SteveGuo1726/coralnpu-gesture/gesture_project/docs/artifacts/zcu104_viewer_rotate180_inverted_2026-09-12.png

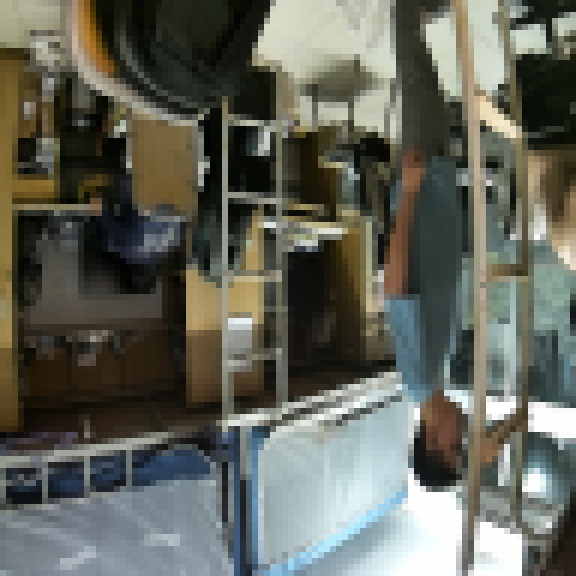
gesture_project/docs/artifacts/zcu104_viewer_rotate180_inverted_2026-09-12.png
