SteveGuo1726/coralnpu-gesture/gesture_project/reports/mobilenet_v2_a050_96_imagenet_frozen_finetune_hagrid6_sample_hotspots.md

# 硬件热点摘要

- 模型：`/home/steveguo/coralnpu-gesture/gesture_project/models/mobilenet_v2_a050_96_imagenet_frozen_finetune_hagrid6_sample/model_int8.tflite`
- 统计层数：`52`
- 总 MAC：`17,605,440`
- 估算 reference cycles：`513,626,762`
- 估算 optimized cycles：`195,936,724`
- 模型级估算加速：`2.62x`

## 按算子类别汇总

| 类别 | 层数 | 总 MAC | MAC 占比 | 优化后周期 | 周期占比 | 估算加速 |
| --- | ---: | ---: | ---: | ---: | ---: | ---: |
| conv2d_1x1 | 34 | 14,552,064 | 82.66% | 191,648,905 | 97.81% | 2.06x |
| depthwise_conv2d | 17 | 2,058,048 | 11.69% | 3,709,522 | 1.89% | 28.89x |
| conv2d_3x3 | 1 | 995,328 | 5.65% | 578,297 | 0.30% | 21.41x |

## 优化后周期热点层

| 排名 | 层 index | 类别 | 形状 | MAC 占比 | 优化后周期占比 | 估算加速 |
| --- | ---: | --- | --- | ---: | ---: | ---: |
| 1 | 67 | conv2d_1x1 | `1x3x3x160 -> 1x1 -> 1x3x3x1280` | 10.47% | 12.39% | 2.06x |
| 2 | 5 | conv2d_1x1 | `1x48x48x8 -> 1x1 -> 1x48x48x48` | 5.03% | 5.95% | 2.06x |
| 3 | 9 | conv2d_1x1 | `1x24x24x16 -> 1x1 -> 1x24x24x96` | 5.03% | 5.95% | 2.06x |
| 4 | 11 | conv2d_1x1 | `1x24x24x96 -> 1x1 -> 1x24x24x16` | 5.03% | 5.95% | 2.06x |
| 5 | 13 | conv2d_1x1 | `1x24x24x16 -> 1x1 -> 1x24x24x96` | 5.03% | 5.95% | 2.06x |
| 6 | 66 | conv2d_1x1 | `1x3x3x480 -> 1x1 -> 1x3x3x160` | 3.93% | 4.65% | 2.06x |
| 7 | 44 | conv2d_1x1 | `1x6x6x48 -> 1x1 -> 1x6x6x288` | 2.83% | 3.35% | 2.06x |
| 8 | 46 | conv2d_1x1 | `1x6x6x288 -> 1x1 -> 1x6x6x48` | 2.83% | 3.35% | 2.06x |
| 9 | 48 | conv2d_1x1 | `1x6x6x48 -> 1x1 -> 1x6x6x288` | 2.83% | 3.35% | 2.06x |
| 10 | 50 | conv2d_1x1 | `1x6x6x288 -> 1x1 -> 1x6x6x48` | 2.83% | 3.35% | 2.06x |
