SteveGuo1726/coralnpu-gesture/gesture_project/reports/static_cnn_regularized_3x3_i96_e70_hagrid6_sample_hotspots.md

# 硬件热点摘要

- 模型：`/home/steveguo/coralnpu-gesture/gesture_project/models/static_cnn_regularized_3x3_i96_e70_hagrid6_sample/model_int8.tflite`
- 统计层数：`7`
- 总 MAC：`89,800,704`
- 估算 reference cycles：`1,130,091,475`
- 估算 optimized cycles：`63,313,052`
- 模型级估算加速：`17.85x`

## 按算子类别汇总

| 类别 | 层数 | 总 MAC | MAC 占比 | 优化后周期 | 周期占比 | 估算加速 |
| --- | ---: | ---: | ---: | ---: | ---: | ---: |
| conv2d_3x3 | 6 | 88,915,968 | 99.01% | 51,661,187 | 81.60% | 21.41x |
| conv2d_1x1 | 1 | 884,736 | 0.99% | 11,651,865 | 18.40% | 2.06x |

## 优化后周期热点层

| 排名 | 层 index | 类别 | 形状 | MAC 占比 | 优化后周期占比 | 估算加速 |
| --- | ---: | --- | --- | ---: | ---: | ---: |
| 1 | 1 | conv2d_3x3 | `1x96x96x16 -> 3x3 -> 1x96x96x16` | 23.65% | 19.49% | 21.41x |
| 2 | 4 | conv2d_3x3 | `1x48x48x32 -> 3x3 -> 1x48x48x32` | 23.65% | 19.49% | 21.41x |
| 3 | 7 | conv2d_3x3 | `1x24x24x64 -> 3x3 -> 1x24x24x64` | 23.65% | 19.49% | 21.41x |
| 4 | 9 | conv2d_1x1 | `1x12x12x64 -> 1x1 -> 1x12x12x96` | 0.99% | 18.40% | 2.06x |
| 5 | 3 | conv2d_3x3 | `1x48x48x16 -> 3x3 -> 1x48x48x32` | 11.82% | 9.74% | 21.41x |
| 6 | 6 | conv2d_3x3 | `1x24x24x32 -> 3x3 -> 1x24x24x64` | 11.82% | 9.74% | 21.41x |
| 7 | 0 | conv2d_3x3 | `1x96x96x3 -> 3x3 -> 1x96x96x16` | 4.43% | 3.65% | 21.41x |
