SteveGuo1726/coralnpu-gesture/gesture_project/docs/会话交接_最高优先级_2026-07-11.md

# 会话交接 最高优先级 2026-07-11

## 编号与阅读规则

本文中所有带日期的一级章节均为历史交接记录，按时间倒序排列：最新记录在最前面且编号最大，最早记录在最下面且编号为 1。当前共有 156 条带日期记录，因此记录编号严格为第 156 号至第 1 号。文档规则、当前结论和执行入口等非时间章节不参与这组编号。阅读时先看最前面的最大编号记录，再按需要向下追溯。

## 156 2026-09-12 全局重规划；阶段 A 用数据推翻两个假设：**模型是被"训练几何"毁掉的**，类目不需要合并

**用户要求**：先不连板子，重新规划全局，重点推进模型与硬件。列出四个致命问题
（手必须占满画面 / 类间区分度低 / 没有无手势与置信度 / CPU 解码拖慢帧率），并给出三条硬约束
（往 3×3 深度卷积试但以上板为准；硬件要针对 ZCU104 重构并冲顶刊、改动必须有数据；
数据集必须重选；**≥3 min 的硬件仿真不允许**）。

**产出**：`docs/全局重规划_2026-09-12.md`（决策文档）+ 阶段 A 的实测数据 + 新评测工具。

### 1. ★ 新工具：`algorithms/static_cnn/eval_int8_deployment.py`

一个工具两种模式，刻意让 PC 侧预处理与板上**同约定**（输入按 `q = u - 128` 构造，
与 `gestureflow_hp0_rgb_loader.sv` 一致；输入张量就是 int8[1,96,96,3]，导出时确认过）：

- `crops` —— 在训练分布（手部裁剪 test 划分）上评，得到可与论文对账的数字；
- `frames` —— **在一帧里取窗口，窗口大小使"手占模型输入 h"**，模拟部署几何。

环境：`~/gfeval/venv`。**坑**：tflite-runtime 2.14 与 numpy 2.x 不兼容（`_ARRAY_API not found`），
必须钉 `numpy<2`。

### 2. ★ A2：训练分布基线 = **99.00%**（test 200/类，n=3600，12 秒跑完）

与模型自称的 98.88% 一致 ⇒ **说明工具链和板上那份是同一个模型**，后面的数字可信。
混淆矩阵很干净：最大的非对角项只有 8/50（palm→four），镜像对
（peace/peace_inverted、stop/stop_inverted、two_up/two_up_inverted）**没有突出**。

### 3. ★★ A3：几何扫描 —— 这是本轮最重要的结果

| 手占模型输入 h | top-1 |
|---|---|
| 1.00（贴紧手） | **93.44%** |
| 0.50 | **46.67%** |
| 0.25 | **6.78%** |
| 0.12 | 7.56% |
| 0.06 | 7.44% |

而从 36,000 个标注统计出：**HaGRID 全帧里"手长边/图像短边"中位数 = 15%**（p5=7%, p95=34%）。
⇒ **HaGRID 真实工作点就是整帧（手占 15%），而我们的模型只见过"手占 100%"的输入。**
在部署几何上它低于瞎猜（5.6%）。

**失败方向是"塌向 call"**：h=0.25 时 `call` 独占 56%、h=0.06 时 68%，
peace/peace_inverted/rock/stop/three/four 全 0%。**用户在相机上看到的"没手势也报 call"，
根因就是几何**，不是缺 no_gesture 类。

**注意一个测量陷阱**：384p 帧只有 384×512、手约 100 px，h≤0.25 时所需窗口已超过整帧，
所以 0.25/0.12/0.06 三档其实测的是同一个"整帧"几何，**不要当成三条独立数据**。
要测更小的 h 必须用 1080p 原帧（未下载）。

### 4. 两个被数据推翻/修订的判断（写下来免得再犯）

1. **P2"合并镜像对类目"——否定。** 训练几何下镜像对不是主要误差来源。
   "分不清"是几何退化的一部分，合并类目救不了。**不改类目。**
2. **"提高输入分辨率让手占更多像素"——上一轮我说错了。** 缩放到固定输入尺寸后，
   手占多少像素只取决于手占画面的比例，与源分辨率无关。分辨率只在"先裁 ROI 再缩放"时才吃红利。
   ★但**输入尺寸本身是独立自由度**：手占 15% 时，96² 输入里手只有 14 px，可能不足以区分
   `three`/`three2`。所以阶段 B 要搜 {96,128,160,192}——这是**由数据倒推出来的**搜索空间。

### 5. 现行模型的算力现状（用于选新骨干）

现行是纯 4×4 稠密栈：`16/16/32/32/48/48/64(1x1) + GAP + FC18`，**约 1.11×10⁸ MAC/帧**
（4×4 核、没有 3×3、没有深度卷积）。MobileNetV3-Small@96² 约 1.1×10⁷（**便宜 10×**）。
⇒ 换骨干是本轮最大的一根杠杆；但 **DW 是带宽受限不是 MAC 受限**，
所以"权重常驻 + 层间融合"（原 H1/H3）从锦上添花变成必须做。

### 6. 已提交的新工具与报告

- 工具：`gesture_project/algorithms/static_cnn/eval_int8_deployment.py`
- 报告：`gesture_project/reports/2026-09-12_A2_crops_test200/`、
  `2026-09-12_A3_geometry_h{1.00,0.50,0.25,0.12,0.06}/`（各含 `confusion.csv`、
  `predictions.csv`、`summary.json`，predictions 里带 `p_max/margin/entropy`，供 A4 扫阈值）

### 7. 下一轮入口

按 `docs/全局重规划_2026-09-12.md` §5 执行：**B2 先跑 96² 的 MobileNet 两个点，
验证"改训练几何能把 6.78% 拉回 90%+"**；同时并行 A4（挖 no_gesture + 拒识基线）
与 C0（周期级代价模型，先于 RTL）。

## 155 2026-09-12 导出 HaGRID-18 参照图（每类一张，供人工对照测试）

**用户要求**：给出 18 类里每类一张数据集图片，用来参照着测板子。

**做法（可复现）**：
- 源 = `datasets/processed/hagrid_v1_500k_384p_targethand_subject_split_20260815/test/<class>/`，
  每类取**文件最大**的一张（先按 `sort | head -1` 取到过 53×55 的缩略图，
  改成 `ls -S | head -1` 后每张都是 134×237 ~ 384×486，做参照才有意义）。
- 原始整帧从 `datasets/raw/hagrid_v1_500k_384p/hagrid-sample-500k-384p.zip` 里按**同一个 UUID**
  取出（裁剪文件保留了原 UUID，所以能一一对应）。
- **用 test 划分**：模型训练时没见过，既能当参照也能当一次诚实的小样本检验。
- 产物放在**仓库外**（`.workbuddy/samples/`，避免把数据集图片提交进公开仓库）：
  `crop/`（裁剪原图）、`input96/`（96×96，**训练同款预处理**）、`display/`（放大到 640 便于屏幕展示）、
  `scene/`（原始整帧）、两张带标签总览图、`labels.txt`、`README.md`。

**两个顺带确认的事实**（以后别再猜）：
1. **模型真正训练的输入是手部裁剪，不是整帧**：`dataset_info.json` 里
   `image_mode = target_hand_crop`、`crop_context = 0.25`。这正是"取景是精度最大杠杆"的根据
   （#153）：真实相机要复现的就是这种"手占满画面"的构图。
2. **类序已在 `models/…_student_4x4_rvv_distill_20260827/labels.txt` 与
   `dataset_info.json` 双重确认**，与板上 `gf_npu_class_name()` 完全一致（1..18 = call …
   two_up_inverted）。
3. `input96/` 逐像素校验过 = `crop → resize((96,96), BILINEAR)`（Pillow 12.3），
   与训练脚本一致；板上的面积平均是它的近似。

**下一步可选（未做）**：给一块"离线分类"入口（读一张 96×96 文件 → 直接出类别），
可以**把模型与相机/光照/构图解耦**地验证一遍 18 类，比对着屏幕拍更干净。

## 154 2026-09-12 监视器颜色错（蓝衣变橙）——根因是 BMP 的通道序，而测试与提取工具犯了同一个错

**用户反馈**：网页上实时显示的画面对不上——**蓝色的衣服被显示成黄色**；
但我从板上单张提取的图像没问题。⇒ 同一份数据、两个消费者、结论相反。

### 1. 复现（先复现再改代码）

把抓回来的那帧**交换 R 与 B** 后重新渲染：**蓝色球衣正好变成橙黄**，木柜变蓝、
皮肤变灰白。与用户描述完全一致 ⇒ 确诊是 **R/B 对调**，不是白平衡、不是 ISP、
不是"颜色偏差"，而是一个确定性的格式错误。这也是为什么之前测的颜色均值看不出问题：
**通道均值在 R↔B 对调下几乎不变**（蓝衣 (50,80,190)→(190,80,50)，均值只挪几个数）。

### 2. 根因

**BMP 24bpp `BI_RGB` 规定像素字节序是 `B,G,R`**（小端 `0x00RRGGBB` 的低字节是蓝），
而管线里是 `R,G,B`。`gf_view.c` 的 `send_bmp_body()` 直接把 RGB 字节写出去了 ⇒
**任何按规范实现的读图器（也就是所有真浏览器）都会把红蓝对调**。

### 3. 为什么整整一轮都没发现（这是本轮最值得记的部分）

三条同时成立，缺一条都不会漏这么久：

1. **传输测试和被测代码用了同一个错误假设。** `t_view.c` 用自己发布的图样逐字节比对
   响应 —— 那是对**传输完整性**的真实断言，但它**无论按哪种约定发出都会通过**，
   因为比较的两端都按同一个约定。**"字节有没有原样到达" ≠ "这些字节按这个格式读有没有意义"。**
2. **我的提取工具犯了与写端同样的错。** 那个用来把帧抓下来肉眼检查的 BMP 读取器
   **把文件当 RGB 读**（`r[i],r[i+1],r[i+2] → R,G,B`），于是每一次"我看过画面了、
   颜色正常"都是**无效证据** —— 它复核的是自己的假设。
3. **唯一会暴露它的消费者一直没被打开过。** 只有真浏览器按规范读；之前那轮明确记着
   "真机浏览器从未打开过"（#152 §7）。用户第一次打开，问题立刻现形。

### 4. 修法

1. `serve_bmp()` 在**自己那份私有拷贝**上原地交换通道（`bgr_swap_in_place()`），
   再交给 `send_bmp_body()` ⇒ 已发布的缓冲和采集路径一行没动。
2. `t_view.c` 新增 **`check_colour_order()`**：发布纯红/绿/蓝/白四色，断言存下来必须是
   `00 00 FF` / `00 FF 00` / `FF 00 00` / `FF FF FF`。**这条断言在坏的版本上必然失败** ——
   它测的是**约定**而不是一致性。
3. `check_bmp()` 改成"期望值按 R,G,B 写、比对时按 B,G,R 读"，两个序在代码里都点名，
   免得后人"顺手简化"回去。

### 5. 验证

- `tests/run.sh`：`t_geom` PASS、`t_view` PASS **0 failures**、`-Wall -Wextra` 无警告；
  新增四色断言全部 OK，原有 BMP 逐像素比对改为 BGR 比对后仍然全对。
- `06_install_app.sh` 全量重编 → `05_verify_image.sh` **RESULT: PASS**；
  `11_net_put.sh` 投放 gf_camera + view.html，两侧 md5 一致；板上重启后重新抓帧核对。

### 6. 可推广的规矩

**凡是把数据交给某种格式，就要显式断言那个格式的约定，不能拿"我们的字节没坏"
顶替"我们的字节按这个格式读是对的"。** 同族的坑：`#12`（数 `b'\r'` 不等于数 CR 字节）、
`#8`（死分支里的探针字符串不是探针）。详见 `plnx/PITFALLS.md #25`。

## 153 2026-09-12 监视器三问：去掉表决、查清"没手势→call"、查清"颜色偏差"；发现数码变焦=居中裁剪（取景才是精度的最大杠杆）

**用户提问（三条，逐条查证）**：① 没手势时为什么识别成 call；② 怎么能用"统计帧数量"
决定当前手势，我只要当前帧的结果；③ 颜色偏差很大，是不是广角视角的问题。

三条里 **②是设计错误（我错）、①是模型能力边界（要解释清楚）、③查证后不是我们的问题
（但查出了取景这个真问题）**。

### 1. ② 多数表决：错在设计，不是因为"不好看"

`gf_camera.c` 原来对最近 5 帧做**多数表决**，页面大字显示的是表决结果（`smooth`），
单帧结果只在小字里。已**整段删除**（含 `-m` 选项、`history[]`、`MAX_VOTE_WINDOW`）：

- **它把要测的东西藏起来了。** 监视器的职责是显示模型行为，不是让它好看。
  "模型 80% 对、在这几种情形下错"经过表决会变成一个小一点的数字，而**错在哪**被抹掉。
- **它让画面和标签对不上。** 表决结果最多滞后手势 4 帧，屏幕上的人和旁边的类别不是同一时刻的。
- **逐帧抖动是测量结果，不是噪声。** 帧间翻转本身就是"这一帧判错了"的直接证据。

现在：`gf_camera` 每帧打印本帧类别；`gf_view` 的 `gf_view_frame` 只剩 `cls`（无
`smooth/votes/window`）；页面大字就是本帧类别，真值对照只有**逐帧准确率**一个口径
（点一个手势当真实值，从下一帧起每帧计一次分）。`t_view.c` 里加了一条**反向断言**：
`/stats` 里再出现 `votes` 或 `smooth` 就算失败 —— 防止它被改回来。

### 2. ① "没手势 → call"：**闭集 + 取景**，不是链路故障

两个独立原因，都不是 bug：

1. **18 类闭集分类器没有"无手势"这一类。** 没有手时它**仍然必须**输出一个 argmax。
   落在 `call` 上是因为该类训练样本最杂（各种"手靠近头/耳"的场景），特征流形最宽，
   最容易被外来输入命中。要压制它只能：加"无手势"类重训 / 前置手部检测 /
   **把输入做成模型见过的样子**（见第 4 条）。
2. **当前取景里根本没有手。** 抓了一帧原图看（`scene.bmp` → PNG），画面内容**是
   三米外的室友坐在书桌前**，整个视野里没有手。实测 10 秒通道均值只漂 ±5/255，
   AWB 没有乱跑。**"没手势"在这个机位上字面上就是"画面里没有手"。**

`gf_npu` 的硬件只暴露 `GF_POST_CLASS_REG` 的 **argmax（5 bit）**，FC 输出张量不落 DDR
（`run_gap_fc()` 里 `GF_STORE_CONTROL = 0`），**所以拿不到任何置信度/softmax**。
⇒ 现在**不可能**做"低置信 → 显示无手势"的软门限；要么改 RTL 把 FC 输出存出来，
要么加检测前置。页面上如实写了这条边界，没有假装有置信度。

### 3. ③ 颜色：**我们的链路是对的，可以证伪**

用户说"颜色偏差很大"，所以先证伪自己的解码链路，再看相机：

- **BMP 通道序正确**：`jpeg_to_rgb()` 用 `JCS_RGB`，`send_bmp_body()` 原样按
  `R,G,B` 写 24bpp `BI_RGB`；我用自己的 BMP 解析器读回来渲染，**肤色/木色/灰衣都正常**，
  不是 `BGR` 交换（交换会让肤色变蓝，肉眼一眼可辨）。
- **96×96 与全景同源**：页面里"模型输入"和"全景"是同一个 `rgb_frame` 的两次采样，
  两张图的通道均值一致（R 104.5 / G 104.2 / B 95.8 vs R 105.1 / G 104.9 / B 96.5）。
- **相机侧逐项实测**（`v4l2-ctl -c` 改一项、抓一帧、比通道均值）：
  | 设置 | R | G | B | R−B |
  |---|---|---|---|---|
  | 默认（AWB 开, saturation 16） | 109.5 | 110.8 | 100.9 | +8.6 |
  | saturation=30 | 108.6 | 110.8 | 92.9 | +15.7 |
  | AWB off, 6500K | 111.2 | 111.6 | 78.4 | +32.8 |
  | AWB off, 3000K | 48.3 | 112.9 | 121.8 | −73.4 |
  ⇒ **默认 AWB 是所有设置里最平衡的**（R−B 只有 +8.6），手动 WB 两个方向都会更糟。
  控件全部等于出厂默认值（brightness 0/contrast 10/saturation 16/gamma 220/sharpness 16）。
  10 秒内通道均值漂移 ≤5/255 ⇒ **不是 AWB 乱跑**。
- **结论**：偏色来自相机 ISP 在室内混合光下的固有表现（广角镜头还有色阴影），
  **不是软件引入的**；而且**只有 8 个可调控件，没有色彩矩阵可动**。
  真要改观只能换光照/换镜头，或在软件里做白平衡——后者属于给模型喂"训练分布外"的颜色，
  需要单独验证，不要顺手加。

### 4. ★ 数码变焦 = 居中裁剪（实测）；**取景是这里精度的最大杠杆**

顺着"是不是广角视角的问题"查下去，查到了真问题：**摄像头是 See3CAM_CU30，1x 时视野
覆盖整个宿舍，手在画面里只有几个百分点**；而 HaGRID（以及这个模型的训练集）里
**手就是主体、占满画面**。缩到 96×96 后，手只有约 15×15 像素 —— 模型没见过这种输入。

该相机暴露 `zoom_absolute`（100..800，即 1x..8x）。**实测它是真正的居中裁剪**：

- 同机位、静止画面（固定配置连续两帧 MAD 只有 1.79，说明画面确实静止），
  把 zoom=400 的帧与 zoom=100 帧的各种"中心裁剪"比对，**最佳匹配恰好是 f=4.0**；
- 再做二维搜索找裁剪原点，**最佳原点 (238,180)，理论中心是 (240,180)** ⇒ 就是居中；
- 残差偏大（MAD≈40）是因为**AE/AWB 会重新测光**：做逐通道 gain+offset 最小二乘拟合后，
  gain=1.31/1.40/1.50、offset≈+27，残差从 ~51 降到 ~20/255（剩下的是 JPEG 重编码与插值）。
  这也顺带说明**变焦后颜色/亮度会变**，这正是"颜色看起来不一样"的另一半原因。

⇒ 所以**不要**用"把 640×480 的中间挖出来再放大"来替代变焦（软件裁剪丢细节，
还要多花 CPU）；相机 ISP 是**先裁传感器再缩放**，同一块区域拿到的 JPEG 比特多得多，
而且测光对象变成手本身。证据图：`zoom_proof.png`（左 1x / 中 4x / 右 = 1x 的中心 1/4，中≈右）。

### 5. 代码：`--zoom` 与 `--crop`

- `--zoom N`（100..800）：`VIDIOC_S_CTRL` 设 `V4L2_CID_ZOOM_ABSOLUTE`，设完**读回**再报；
  相机不支持时**明确警告并继续**（静默不设会让"模型看到的取景"悄悄变掉）。
- `--crop F`（F≥1）：软件居中裁剪，与 `--zoom` 叠加。`crop_window()` 负责算中心窗口并
  **钳位**（窗口不小于 96×96，且不越出帧）；放在**下采样之前**（事后裁 96×96 没有意义）。
- `resize_rgb96()` 签名改为 `(src, sw, dst, rot, crop_x, crop_y, crop_w, crop_h)`
  —— 去掉了不再使用的 `sh`（窗口的行数由 `crop_y+crop_h` 决定），否则 `-Wextra` 报警。
- **场景流改为发布"裁剪后的窗口"**（`gf_view_publish(..., scene_stride)`），
  于是页面上"模型看到的范围"**永远等于**NPU 实际吃的那块区域，不可能与 96×96 漂移。
  行是带 stride 的（窗口是大帧里的一片），`publish_chan()` 按行拷。
- 启动时打印一行说明当前取景；窗口小于 2 倍模型输入时**主动提示会变软**。

### 6. 测试同步（都跑过了，`tests/run.sh` PASS 0 failures）

- `t_geom.c`：调用点全部改到新签名；**新增 crop 覆盖** —— 用"源图编码自身坐标"的 192×192，
  验证 2x 居中窗口读出来正好是 `R=48+ox, G=48+oy`（**裁剪原点取成左上角就会失败**）；
  另加 `crop_window()` 的 1.0/2.0/4.0 中心偏移与两处钳位（32x 与 64×64 源）。
- `t_view.c`：`gf_view_frame` 去掉 vote 字段；场景流改为**真的用 stride 发布**
  （640×480 帧里取 (160,120) 起 320×240 的窗口），BMP 逐像素 76800 个全对；
  `/stats` 断言换成 `cls/cls_name/zoom/crop/hist`，并**反断言** `votes|smooth` 不存在。
- 无警告通过（`-Wall -Wextra`）。

### 7. 现场注意（会误导后来人）

- **用 `v4l2-ctl -c` 改相机控件，在别人 streaming 时也生效，而且会一直留着。**
  本轮为了做对照把 `zoom_absolute` 改到 400，**必须记得改回 100**，否则下一轮会以为
  "取景本来就是这样的"。排查取景问题时先 `v4l2-ctl -d /dev/video0 -l` 看一遍当前值。
- 相机全部控件都还是出厂默认；`zoom_absolute` 当前 = **100**。

### 8. 下一轮

1. **把相机对准自己，把手放在画面中央，用 `--zoom 300`~`400` 跑一轮真值标注**，
   拿到第一份**有真值的逐帧准确率**（这是判断模型好坏的唯一依据）。
2. 拿同一批帧在 PC 侧跑一次前向，**核对 PC 与板子的类别是否一致** ——
   这是"输入无误"的最后一环（目前只证明了 PL 对参考图 bit-exact）。
3. 固化进镜像（已改源码；`06_install_app.sh` → `04_make_sd.sh`）。
4. 大创口径：无手势类 / 手部检测前置、≤5ms 差距、功耗数据。

## 152 2026-09-12 相机朝向修正（倒装 → 已转正）；新增浏览器实时监视器（含"不拖慢识别"的契约与验证）

**用户要求**：确认相机朝向，并做一个"能实时回传画面 + 模型结果 + 状态 + 指标"的
软件或网页，**但不能占用识别处理的时间，以免成绩被拖慢**。

### 1. 相机朝向 → `--rotate D`（运行期参数）；**当前 = 0**

过程值得记：先按用户确认"是反的"实现了 `--rotate 180`，取回画面验证**确实正了**；
随后**用户把相机物理转正了**，于是 180 又把画面转反 —— 改成不加 `--rotate` 后取回画面
确认朝上（天花板灯在上、地面物件在下）。

**结论：加不加取决于当前物理安装，不要照抄历史命令行。** 它是运行期参数，
改它不需要重编、不需要写卡；文档里已改成"当前留空"并写清如何自查
（`--save-ppm` 存一帧回来看）。

模型在正立手势图上训练，倒过来的手对它是**另一个手势**，所以必须**在喂给 NPU 之前**转正
（只转预览没用）。实现在 `resize_rgb96(src, sw, sh, dst, rot)` 的**采样循环内部**：
旋转是 96×96 输出格的一个置换，每个输出格仍然平均同一个源盒，只是写到别处 ——
**精确、且不增加任何额外遍历**。`rot_cell()` 的期望值在测试里是**独立推导**的
（"顺时针转 D 度把输入 (x,y) 送到输出 (h-1-y,x)"），不是复述实现。

### 2. 监视器：`gf_camera --view 8080`

新增 `linux/gf_view.c` / `gf_view.h`（HTTP + BMP + 兴趣门控）与 `linux/view.html`（页面）。
浏览器里能看到：**NPU 实际吃的那张 96×96**、可选的原分辨率全景、当前类别（平滑 + 单帧 + 票数）、
**耗时分解（解码/缩放/NPU）**、18 类累计分布、错误计数、滚动日志，以及
**真值标注 → 实测准确率**（点一个手势当真值，从下一帧开始计分，分"稳定帧"与"全部帧"两个口径）。

### 3. 不拖慢识别的三条硬约束（这是本轮的重点）

1. **没人问就不拷贝。** 每个流记录"最后一次被请求的时刻"；超过 2 秒没人请求，
   `gf_view_publish()` 直接返回 —— **没有浏览器连着时，每帧只做一次 64 位读 + 两次比较。**
2. **socket 全在后台线程。** 采集线程一行网络代码都没有 ⇒ 客户端卡住/链路饱和/笔记本睡眠，
   最坏只是**预览掉帧**，不可能给流水线加一毫秒。
3. **旋转交给浏览器**（全景用 CSS `rotate()`）—— 只有 96×96 必须由板子转。

**主机实测**（`linux/tests/run.sh`，x86）：无人关注 **37 ns/帧**（一帧 27.3 ms 的 0.00014%）、
有人在看预览 **553 ns**（0.0020%）、同时拷全景 **78 µs 但限速 5 次/秒**。
"无人关注 = 37 ns"是**确定性**验证的，不是估的：让窗口过期 → 发布一个不同的图样 →
读回流，必须仍是旧图样（说明那次发布被丢弃）。

### 4. 新增主机侧测试 `linux/tests/`（约 5 秒，不需要板子/PL/权重头）

- **`t_geom.c`**：把真的 `gf_camera.c` 拉进来（`#define main` 改名让位），
  验四种旋转 × **全部 9216 个输出像素**、`rot180` = 纯反转、`rot90+rot270` = 恒等、640×480 几何。
- **`t_view.c`**：HTTP 端到端 —— 路由、首帧前的 503、**两个流 BMP 逐像素精确**（含自下而上行序）、
  `/stats` 字段、以及上面那条兴趣门控。

**测试当场抓出三个真问题**：`Connection: close` 只写在头上而没真的关连接；
`serve_stats` 一个未用变量；以及最值得记的一条 —— **是测试自己错了**：
它用有符号 `char` 解码小端字段，把 640 读成 −128。**字节转储显示服务端完全正确**
（`80 02 00 00`），是读的一方错了。见 `PITFALLS.md #20`。

### 5. 网络：硬件是好的，只缺一根网线

`macb ff0e0000.ethernet` + `PHY [TI DP83867]` 都正常，`eth0` 只报 `NO-CARRIER`。
接路由器就走 `ip link set eth0 up; udhcpc -i eth0`；网线直连笔记本就两端配静态地址
（板 `192.168.77.2/24`，PC `192.168.77.1/24`）。**没有网线时页面用不了**，
此时仍可用 stdout 指标 + `--save-ppm` 按需取图（见 `docs/ZCU104_实时监视器_2026-09-12.md` §6）。

### 6. 工具链改动

- `10_push_app.sh` 改为清单驱动，**新增 `page` 目标**：只推 `view.html`（14 KB，**约 2 秒**）。
  改 UI 不再需要重编 —— 页面在文件系统上（`/usr/share/gf/view.html`），不编进二进制。
- `05_verify_image.sh`：`[4]` 加 3 条 `gf_view.c`/`gf_camera.c` 旋转文案的探针；
  `[2b]` 加 `/usr/share/gf/view.html` 存在性；`[5]` 反向命中率加 `gf_camera:gf_view.c` 一组。
- `gf-npu_1.0.bb`：`SRC_URI` 加 `gf_view.c`/`gf_view.h`/`view.html`，
  `GF_CFLAGS` 加 **`-pthread`**，`do_install` 装页面到 `${datadir}/gf/`，`FILES` 加 `${datadir}/gf`。
- `Makefile`：加 `gf_view.o` 与 `-pthread`。

### 7. 状态与入口

- 源码、recipe、脚本、测试、文档已改完；`06_install_app.sh` 全量重编**进行中**（后台）。
- **待验证**：板上 aarch64 的实际编译/运行、板上三遍对照（有/无 `--view`、有人在看）的增量开销、
  真机浏览器打开一次。前两项的判据见 `docs/ZCU104_实时监视器_2026-09-12.md` §4.3。
- 页面侧已知的良性行为：每个流**第一次**请求返回 503（那次请求就是"登记兴趣"），
  第二次拿到帧；页面的 `onerror` 重试覆盖了这半秒。

---

## 151 2026-09-12 把内存映射问题从"试"变成"证"：内核源码级定论 + 驱动改到与映射无关 + 打通免拔卡迭代

**用户明确要求：不要再"写卡→发现 bug→再写卡"，先把资料查清、代码验对，再谈写卡。
本轮就是照这个做的。核心成果是三条：**

1. **映射属性不再是猜测，是从内核源码推出来的定论**（`arch/arm64/mm/mmu.c`）。
2. **驱动改成对两种映射都成立** —— 于是**当前这张卡（挖洞版 DTB）就能跑通**，
   不需要为了它搬 10 MB 的 `image.ub`、更不需要重写卡。
3. **打通免拔卡迭代通道**：改一行驱动 → 1 分钟上板验证（`09`/`10`）。

### 1. 内核源码级定论（`PITFALLS.md #14b`）

`arch/arm64/mm/mmu.c::phys_mem_access_prot()` 的真实实现（本工程 6.1.30 实测读取）：

```c
if (!pfn_is_map_memory(pfn))        return pgprot_noncached(vma_prot);    /* MT_DEVICE_nGnRnE */
else if (file->f_flags & O_SYNC)    return pgprot_writecombine(vma_prot); /* MT_NORMAL_NC     */
return vma_prot;                                                          /* Normal, CACHED   */
```

`pfn_is_map_memory()` → `memblock_is_map_memory()` → **范围必须在 memory 节点里且不带
`MEMBLOCK_NOMAP`**。于是三种 DTS 写法各有确定后果：

| DTS 写法 | `pfn_is_map_memory` | `/dev/mem` 给出的属性 | 驱动的 memset/memcpy |
|---|---|---|---|
| `no-map`（初版） | false | Device-nGnRnE | **崩** |
| memory 挖洞（#150 的修法） | false | Device-nGnRnE | **崩** |
| **纯 `reserved-memory`，无 no-map（现在）** | true | **MT_NORMAL_NC** | ok（仍需屏障） |

**#150 的"挖洞"只是换了一个坑**：单字 `devmem` 能过，驱动的 128-bit STP / `DC ZVA`
一上去就 fault。这条链条现在有源码依据，不再是推断。

### 2. 两个真实缺陷（都在写卡前修掉）

- **`PITFALLS.md #16`：驱动一个内存屏障都没有。** MT_NORMAL_NC 是**弱序**的，
  CPU 可以把"写缓冲区"重排到"写 `GF_CONTROL` 门铃"之后 —— PL 就会读到半写好的数据，
  **表现为结果错而不是崩**。已在 3 个门铃前 + `wait_layer_done()` 成功路径加 `dsb sy`。
  对照取证：裸机那份唯一一条 `dsb sy` 在 `store_probe()` 里，**不在握手上**；它没出事是
  因为它把缓冲区映射成了 Device（顺序规则更强）。**"裸机能跑"不能推 Linux。**
- **`PITFALLS.md #15`：不让正确性依赖内存属性。** 把 scratch 区域的 `memset`/`memcpy`/
  `memcmp` 换成 32 位 `volatile` 访问的 `gf_zero`/`gf_copy`/`gf_diff`。
  32 位访问在两种映射下都合法（Device 只限制"最大宽度"，字节访问本来就合法）。
  代价每帧几微秒。**收益：驱动不再依赖设备树对不对。**

顺带修了 `gf_camera.c` 两个越界：`-m` 未夹取会踩穿 `history[32]`；MJPEG 解码缓冲区按
"请求尺寸"分配而按"JPEG 实际尺寸"写入（堆溢出）。另外 `v4l2_grab` 原来 DQBUF 后立刻
QBUF，缓冲区会在我们读它的时候被驱动覆写（撕裂帧），已改为处理完再归还。

### 3. 新增的离线防线：`05_verify_image.sh [7]`

rootfs 校验只能证明"二进制是这份源码"，**不能**证明"软件与设备树说的是同一件事"。
新增 `[7]` 段按上面那条判定链逐条核对：memory 覆盖、无 no-map、DT 节点 == `gf_npu.h`
常量、`gf_npu.c` 带 `O_SYNC`、`image.ub` 内嵌 DTB == `system.dtb`。
**这五条里任意一条不过，都不用上板 —— 板上表现为没有内核日志的 SIGBUS。**

同时修掉 `06_install_app.sh` 结尾的 cwd 缺陷（`cd $PLNX` 之后 `dirname $0` 变成 `.`，
校验脚本报 "No such file or directory"）。

### 4. 免拔卡迭代通道（`PITFALLS.md #17`）

板子在跑 Linux、rootfs 可写、`python3` 有 `base64/zlib/hashlib/struct`。所以：

- **`09_board_put.sh`**：base64 走串口 → 板上 `python3` 解码 → **两侧 md5 + 长度双向核对**，
  失败重试 3 次。实测 200 KB 随机数据**逐字节一致**，速率 **11.3 KiB/s**（正好 115200 线速，
  说明无损；tty 发送缓冲天然充当流控，不需要 sleep 调速）。
- **`10_push_app.sh`**：debugfs 从 `rootfs.ext4` 取出二进制 → 先跑 `05` 确认"镜像==源码"
  → 串口送进 `/tmp` → 板上 `install` 到 `/usr/bin` → 双向核对 md5。

**526 KB ≈ 1 分钟。** 需要写卡的只剩 rootfs 之外的东西（设备树/内核/`boot.scr`/`BOOT.BIN`），
以及最终固化一版交差用的完整镜像。

### 5. 本轮踩到并记录的新坑

- **`grep -q` + `pipefail`**：`grep -q` 命中即退出，写管道的一端可能吃 `SIGPIPE`，
  于是**传输明明成功也被判成失败**；而那次失败还把回显丢进了 `/dev/null`，完全无法诊断。
  结论：捕获到变量再匹配，别用 `| grep -q` 判成功。
- **串口传输前必须 `stty -echo`**，否则板子回显每个字节，既慢又可能把两侧缓冲堵死。

### 6. 当前状态与入口

- 源码已改：`gf_npu.c`（屏障 + mapping-agnostic + `GF_DBG`）、`gf_npu.h`（把说错机制的
  注释换成内核源码依据）、`gf_camera.c`（三处越界/撕裂）、`05`/`06`/新增 `09`/`10`。
- `petalinux-build` 全量重建，`RESULT: PASS` 且新增的 `[7]` 段 **5/5 OK**。

### 7. ★ 实测结果：**NPU 在板上跑通了**（`gf_npu_probe` → `RESULT: PASS`）

用 `10_push_app.sh` 把两个二进制送进正在运行的板子（**没碰 SD 卡**，两侧 md5 双向核对
一致），然后在**当前这张卡**上跑：

```
gf_npu: PL id ok (MAGIC 0x47464E50, VERSION 0x00050001); scratch 0x70000000 + 16 MiB
gf_npu: staged weights + activations, 599040 bytes used of 16 MiB
class = 1 (dislike), expected 1
  --- golden content checks (bit-exact memcmp) ---
    conv0 MATCH / pool1 MATCH / conv2 MATCH / pool2 MATCH / conv4 MATCH / pool3 MATCH
    6/6 matched
  --- hardware FNV registers ---
    hw FNV conv0 87061606 (= 0x05307466 ✅)   hw FNV pool1 2116512891 (= 0x7E276C7B ✅)
    gap FNV 4043941806 (= 0xF109A7AE ✅)      fc FNV 585444829 (= 0x22E52DDD ✅)
  PL compute  17.03 ms        CPU overhead  1.99 ms   (裸机 10.04 ms)
RESULT: PASS
```

**注意这是在"挖洞版 DTB / Device-nGnRnE 映射"下跑通的** —— 直接证明"让驱动与映射解耦"
（§16）是对的：`gf_zero(16777216)` 的 32 位访问全程没崩，`[8]→[9]` 标记完整。

**顺带解释了历史悬案**：CPU 开销从裸机的 10.04 ms 降到 1.99 ms，因为 `run_frame` 里
每帧不再清零中间张量（原先的 memset 才是那 8 ms 的来源）。

### 8. ⚠️ 摄像头一开就暴露的老 bug：golden 检查被无条件套用在任意输入上

`gf_camera -s 640x480` 正常协商到 **MJPEG 640x480 / 4 buffers / streaming**，但第一帧就报：

```
gf_npu: FAIL stage 0x4103 observed 0x9AD0E9B4
```

`0x9AD0E9B4` 是散列样貌 —— 是 **FNV 值**，不是状态位域。审计整条 `run_frame` 后找到
**三处同类问题**（一次性审完，不是一个个试）：

| 位置 | 检查 | 为什么在摄像头帧上必然假失败 |
|---|---|---|
| `0x4103` | `hash != GF_FULL_OUTPUT_FNV1A` | 它是**参考图**产生的 FNV，不是网络的属性 |
| `0x4105` | `hash != GF_BODY2_OUTPUT_FNV1A` | 同上 |
| `0x4133` | `gap_fnv`/`fc_fnv`/`post_class` 对比 `GF_POST_*_EXPECTED_*` | 同属输入相关量 |

**修法**：这三类**输入相关**的 golden 比较全部改为只在 `stats != NULL`（= 参考图验证路径）
时执行 —— 与既有约定一致（`verify_tensor` 本来就是这么做的）。**输入无关**的检查保留为
无条件：fault 位、DMA/store 字节数，外加**一条新的、对任意输入都成立的检查**：
类别必须落在 `0..GF_POST_FC_OUTPUTS-1`。这样实时路径依然在自我验证，而不是"什么都不查"。

同时修 `gf_npu_selftest(NULL)`：它按定义跑的就是参考图，所以现在**总是自带一个 stats**，
否则 `gf_camera --selftest` 会静默跳过整条 FNV 链。契约已写进 `gf_npu.h`。

**为什么直到今天才暴露**：裸机从来没有摄像头。这正是"没在真实路径上跑过 = 没跑通"
的又一例 —— 而且这次是**功能性 bug**（假失败），不是崩溃，光看代码不容易起疑。

### 9. ★ 摄像头闭环也已跑通（150 帧无失败，类别随场景变化）

修掉 §8 的 golden 检查后重跑，`gf_camera -s 640x480 -n 150 --save-ppm`：

```
gf_camera: using MJPEG 640x480 (bytesperline 0, sizeimage 614400)
gf_camera: streaming, 4 buffers
frame   0  call       frame  20  mute      frame  60  dislike     frame 149  dislike
单帧 raw 分布: {call:50, mute:9, three:3, peace:3, dislike:80, like:5}
每帧 26.7–29.8 ms（均值 29.3）=> 34.1 fps 上限
```

**类别确实随场景在变** —— 模型在响应输入，不是恒输出一个常数。

**libjpeg 修复当场生效**（`PITFALLS #19`）——同一次运行里出现了坏帧，但程序**跳过并继续**：

```
Premature end of JPEG file
gf_camera: JPEG decode error: Not a JPEG file: starts with 0x3d 0x3d
gf_camera: JPEG decode failed, skipping frame
... 继续跑完 150 帧
```

**取回了喂给模型的那一帧**（`--save-ppm` 现在存自动曝光稳定后的最后一帧，见 `PITFALLS #19`）：

```
亮度 min=1 max=254 mean=96.8   非零像素 96.9%   R=100.8 G=98.1 B=83.7
gz 20703 → raw 27661 字节，两侧 md5 MATCH
```

曝光正常、动态范围用满、不是黑屏也不是垃圾。图已存为
`gesture_project/docs/artifacts/zcu104_camera_96x96_settled_2026-09-12.png`
（6 倍放大便于肉眼查看）+ 原始 `.ppm`。

**⇒ 待用户确认的一件事**：那张 96×96 里能看到人、手臂、背景和上方光源，
但**画面方向看起来是倒的**（人脸像是上下颠倒）。模型是在**正向**手势图上训练的，
若相机是倒装的，等价于把输入上下翻转 ⇒ 类别会乱。**请确认相机朝向**；
若确实倒装，物理转正，或给 `gf_camera` 加一个 `--rotate 180`（几行代码 + 一轮免拔卡投放）。

### 10. 本轮最终状态

- 代码：`gf_npu.c`（屏障 + mapping-agnostic + golden 检查 gating）、`gf_camera.c`
  （越界/撕裂 + libjpeg setjmp + save-ppm 取稳定帧）、`gf_npu.h`（机制注释 + 契约）、
  `05`（`[7]` DT 一致性）、`06`（cwd 修复）、新增 `09_board_put.sh` / `10_push_app.sh`。
- **板上已验证**：`gf_npu_probe` → `RESULT: PASS`（6/6 bit-exact + 4 个 FNV 全对）；
  `gf_camera` 150 帧闭环无失败、类别随场景变化。
- **SD 卡一次都没动**（这一版二进制只在板上，镜像里仍是旧版 —— 要固化需跑
  `06` + `04`）。
- 待办：
  1. 确认相机朝向，必要时加 `--rotate`；
  2. 做**有意识的手势**（如张开手掌/握拳/比耶）测真实准确率；
  3. 把这一版**固化进镜像**（写卡）；
  4. 闭环数据补进大创验收材料。

---

## 150 2026-09-12 🎯 首次 Linux 上板：板子起来了，但 `no-map` 内存 bug 拦在最后一道门

**这是核心叙事「ZCU104 实时摄像头手势识别」第一次真正在 Linux 下上板。结果：大半程通过，卡在 NPU scratch 缓冲区的 `no-map` 设备树 bug 上。**

### 1. 打通了什么（都是首次、真实硬件）

| 环节 | 结果 |
|---|---|
| SD 卡启动 Linux | ✅ `Linux gflinux 6.1.30-xilinx-v2023.2 aarch64`，登录 `root` 无密码 |
| 串口控制台 | ✅ FT4232H 经 usbipd 透传，**控制台在 `/dev/ttyUSB1`**（不是 ttyUSB0），`08_console.sh` 可用 |
| USB3 摄像头 | ✅ `ID 2560:c130 e-con Systems See3CAM_CU30`，`/dev/video0`/`video1` 已枚举 |
| NPU 二进制 | ✅ `gf_npu_probe`/`gf_camera`/`v4l2-ctl` 在位，大小与 `05` 校验一致 |
| **NPU PL** | ✅ `busybox devmem 0xa0000000` = `0x47464E50` **"GFNP"** —— PL 已配置、NPU 在响应 |
| **NPU scratch** | ❌ `devmem 0x70000000` **挂死 CPU**（rcu stall）；`gf_npu_probe` SIGBUS |

### 2. 根因（已定位，`PITFALLS.md #14`）

`system-user.dtsi` 用 **`no-map` reserved-memory** 预留 0x70000000。注释声称
"no-map == memblock_remove ⇒ 不再是 RAM"，**这是误解**。实际 `no-map` 调
`memblock_mark_nomap()`：这段**仍是 RAM**（`pfn_valid` 为真），只是从**线性映射**里摘掉。
于是 `/dev/mem` 按可缓存 RAM 映射它，却没有线性映射兜底 → 一访问就挂死/SIGBUS。

裸机（JTAG）没踩到是因为扁平映射没有 no-map 这回事。**Linux 这条路径此前从未真跑过。**

### 3. 修复（已写入并开始重建）

把 `no-map` 换成 **memory 节点挖洞**（0x70000000 不再属于系统 RAM ⇒ `/dev/mem`
按 `pgprot_noncached` 非缓存映射 —— 正好符合 HP0 非相干"两侧都不用 flush"的原意）：

```dts
memory@0 {
    device_type = "memory";
    reg = <0x0 0x00000000 0x0 0x70000000>,
          <0x0 0x71000000 0x0 0x0EF00000>;
};
```

状态：`plnx/system-user.dtsi` 已改、已部署到工程、`petalinux-build` 后台重建中（task 7ySlml）。

### 4. 深一层的教训

- 之前所有"Linux 侧已就绪"的结论，都建立在**裸机 JTAG 结果**（36.96 FPS）上，不是 SD 启动的 Linux 路径。第一次真跑 `gf_npu_probe` 就崩。
- 文档里 `no-map` 的注释**主动断言了错误机制**，不实跑发现不了。
- **"没在真实目标、真实启动方式下跑过" = "没跑通"。** 一切以实板为准。

### 5. 下一步（重建完成后）

1. `petalinux-build` 完成 → 验证新 `system.dtb` 有挖洞（两段 memory、无 no-map）
2. 重新打包 + 写卡（板子当前因 devmem 挂死，需**断电重启**；SD 卡要插回读卡器）
3. 重跑 `sudo gf_npu_probe`（应 `RESULT: PASS`）→ `sudo gf_camera -s 640x480`

---

## 149 2026-09-12 SD 卡接入打通（usbipd）；修掉 `sudo` 重置 `$HOME` 导致的四脚本缺陷

**状态：写卡条件已全部就绪，只等用户执行一条 `sudo` 命令。卡已在 WSL 里可见为 `/dev/sde`。**

### 1. SD 通路：结论与事实

`wsl --mount` **走不通**（微软文档明写不支持 USB/闪存盘/读卡器；报
`Wsl/Service/AttachDisk/MountDisk/0x8007000f` = Win32 `ERROR_INVALID_DRIVE`，
脱机后错误变为 `.../HCS/0x8007000f`，仍失败）。改走 **usbipd USB 透传**，成功。

| 项 | 值 |
|---|---|
| 卡 | **Disk 2**，`Generic MassStorageClass`，**28.9 GB**，USB，**可移动** |
| 官方套装 16 GB 卡 | 卷标 `PYNQ`，FAT32 引导分区约 120 MB（其余是 Windows 读不了的 ext4，**卡没坏**）—— 保留不动 |
| 本次使用 | 另一张 **32 GB U1**（U1 ≥10 MB/s，写 431 MB ≈ 45 s，够用且富余） |
| WSL 内核 | 6.18.33.2，`vhci-hcd.ko`/`usbip-core.ko`/`usb-storage.ko`/`uas.ko` **全部存在** |
| 透传后在 WSL | `sde 28.9G disk` + `sde1 28.8G part vfat`（现存的 FAT32 分区，**未挂载**） |
| 卡上分区表指纹（写前基线） | `PARTUUID f52e5d69-01` |

**透传步骤**（已在用户机器上实测成功）：
`sudo modprobe vhci-hcd` → `sudo modprobe usb-storage` → `lsblk` 出现 `sde`。

### 2. ⚠️ 本轮修掉的真实缺陷：`sudo` 把 `$HOME` 重置为 `/root`

**症状**：`sudo bash 04_make_sd.sh /dev/sde` → `ERROR: missing /root/gf_linux_ws/.../BOOT.BIN`。
镜像一直都在 `~/gf_linux_ws/...`，脚本却去 `/root` 找。

**根因**：这些脚本需要 root（parted/mkfs/dd/mount），但工程树在**调用者**家目录下，
而 `04_make_sd.sh` 第 30 行是 `PROJ="${PROJ:-$HOME/gf_linux_ws/gf_linux}"`。

**同一根因有四个实例**，且最危险的不是 `04`：

| 脚本 | 受影响路径 | 失败时表现为 |
|---|---|---|
| `04_make_sd.sh` | `$HOME/gf_linux_ws/gf_linux` | `missing /root/.../BOOT.BIN` |
| `05_verify_image.sh` | `$HOME/coralnpu-gesture`、`$HOME/gf_linux_ws/...` | **`RESULT: FAIL`** —— 会伪装成"镜像过期" |
| `06_install_app.sh` | `$HOME/coralnpu-gesture`、`$HOME/petalinux/2023.2` | `找不到源码目录` |
| `07_make_sd_image.sh` | `$HOME/gf_linux_ws/gf_linux` | `缺少 /root/.../BOOT.BIN` |

**为什么 `05` 最危险**：`04` 的 **GATE 0 会调用它**。在 sudo 下门禁自身失效，
而且报的是**内容**失败 —— 读起来像"你的镜像旧了"，而不是"我找错目录了"。
**这类误报会把人引向完全错误的方向（重编镜像）。**

**次生危害（同一根因，更隐蔽）**：`05` 的临时目录原是 `$HOME/gf_linux_ws/_imgverify`。
被 `04` 以 root 调用时，root 会在用户家目录里建该目录并拥有解出来的 ELF；
之后**非 sudo** 运行就写不进去 → `debugfs dump` 失败 → **所有探针报 FAIL**，
一个彻底虚假的失败，成因只是文件属主。

**修复（同一次提交）**：
1. 四个脚本都在前导段之后解析调用者的家目录，并 `export HOME`
   （顺序：`$GF_HOME` 显式覆盖 → `SUDO_USER` 的家目录 → `$HOME`）。
2. `05` 的临时目录改为 `TMP="$(mktemp -d)"` + `trap 'rm -rf "$TMP"' EXIT` ——
   无论谁跑都不留残留。
3. `04` 定位姊妹脚本从 `dirname "$0"` 改为
   `HERE="$(cd "$(dirname "$0")" && pwd)"`（`$0` 无目录成分时会失效；`07` 本来就是这么写的）。
4. `04`/`07` 的"镜像缺失"报错补上可执行提示（含 `GF_HOME=` / `PROJ=` 用法）。
5. 清理了历史遗留的 `~/gf_linux_ws/_imgverify`。

全套记录在 **`plnx/PITFALLS.md` #11**。

### 3. 这次是怎么验证的（方法本身值得复用）

**不需要提权就能复现 sudo 环境**：

```bash
env HOME=/root SUDO_USER=steveguo bash 04_make_sd.sh <device>
```

伪造 `HOME` + `SUDO_USER` 就足以走完整条解析路径。本轮实测结果：
- 解析块 → `HOME -> /home/steveguo`（不是 `/root`）✅
- `05` 在该环境下跑 → **`RESULT: PASS`**，指纹不变 ✅
- **反证**：把解析块删掉 → 精确重现 `ERROR: missing /root/gf_linux_ws/.../BOOT.BIN` ✅
  （不做反证就等于没证明修复起了作用）
- `04` 全流程（root 检查打桩、喂 `ABORT`）→ 走到擦盘警告后正确中止，退出码 2，
  **前后分区表指纹 `f52e5d69-01` 完全一致 ⇒ 卡未被触碰** ✅

**四个脚本**：CRLF=0、loneCR=0、`bash -n` 全过。
**写卡所需工具全部在位**：`parted` / `partprobe` / `wipefs` / `mkfs.vfat` / `mkfs.ext4` /
`e2fsck` / `resize2fs` / `dd` / `mount` / `blkid` / `losetup` / `truncate`（以及 `05` 用的
`debugfs` / `file` / `strings` / `readelf`）。
**卡未被挂载**（`/proc/mounts` 里那次 `sde` 命中是 `nsdelegate`，误报）。

### 4. 两个假警报（记下来免得下次又当成故障）

- **`CR bytes = 1`**：不是真的裸 CR。f-string 里的 `b'\\r'` 是**反斜杠+r 两个可打印字符**，
  数到的是 `06` 里那个**故意写的** `$'\r'` 门禁文本。真实检查用
  `d.count(b'\r\n')` 与 `d.count(b'\r')-d.count(b'\r\n')`。详见 `PITFALLS.md` #12。
- **`grep sde /proc/mounts` 命中 1 次**：匹配到 `nsdelegate`，与卡无关。

### 5. ✅ 写卡成功（2026-09-12 13:01）

```bash
sudo bash ~/coralnpu-gesture/gesture_project/innovation_npu/board_zcu104/plnx/04_make_sd.sh /dev/sde
```

| 项 | 结果 |
|---|---|
| GATE 0 | `pre-flight OK: the image matches the current sources` |
| manifest | `gf-npu` / `libjpeg62` / `usbutils` / `v4l-utils` 全在 |
| p1 FAT32 1 GiB | `BOOT.BIN` 21.07 M、`image.ub` 9.97 M、`boot.scr`、`system.bit` 19.31 M、`system.dtb` |
| p2 ext4 27.8 GiB | `dd` 431 MB @ **17.9 MB/s**（24.1 s）→ `resize2fs` 至 29 200 384 个 1K 块 |
| **md5 对账** | `gf_npu_probe` **2ed2ef05ab52e145**…、`gf_camera` **bb04ced68ea693e9**… **与 `05` 的 `[6]` 段一致** ✅ |

**卡上跑的就是校验过的二进制。可以上板。**

### 6. 写卡输出里的两条疑点，均已查实（一条是我代码的误报）

**(a) `MISS /usr/bin/lsusb` —— 误报，卡没问题。**
`lsusb` 是 **绝对符号链接**：`/usr/bin/lsusb -> /usr/bin/lsusb.usbutils`
（Yocto `update-alternatives` 的标准布局；真身 301 312 B，inode 1608）。
`04_make_sd.sh` 用 `[ -e "$ROOTMNT/usr/bin/lsusb" ]` 判断，而 `test -e` 会**跟随**这个链接、
并按**宿主机**的 `/` 去解析目标 ⇒ 永远 MISS。
已修成"在挂载树内部解析目标"（区分绝对/相对；且**悬空链接必须判 MISS**，
所以不能简单换成 `[ -L ]`）。四种情形都做了单测。
`05_verify_image.sh` 不受影响（它查 `debugfs` inode，不跟随链接）。
**已顺带补上 `05` 的 `[2b]` 段**：写卡前就确认上板操作卡里的每个命令
（`gf_npu_probe`/`gf_camera`/`v4l2-ctl`/`lsusb`/`usb-devices` + `/lib/modules`）确实存在。
记入 `PITFALLS.md #13`。

**(b) `system.bit` 单独放在 p1 —— PL 其实由 `BOOT.BIN` 里的 bitstream 配置。**
打包命令是 `petalinux-package --boot --fsbl ... --fpga images/linux/system.bit --u-boot ...`，
**bitstream 已烘进 `BOOT.BIN`**，由 FSBL 上电配置 PL。
**`boot.scr` 里没有 `fpga load`** —— 它只 `fatload image.ub` 然后 `bootm`。
证据：`BOOT.BIN` 21 073 168 = `system.bit` 19 311 211 + 1 761 957（FSBL/PMUFW/ATF/U-Boot）；
抽 6 段 `system.bit` 的 64 字节窗口，有 3 段**原样**出现在 `BOOT.BIN` 中。
⇒ **若哪天把 `--fpga` 从打包命令里去掉，板子仍会正常启动 Linux，但 PL 从未被配置**，
NPU 寄存器全死、`gf_npu_probe` 失败且原因不明显。已记入 `PITFALLS.md #7`。

### 7. 上板（下一步，用户执行）

```powershell
usbipd detach --busid <BUSID>      # 先把卡还给 Windows，再拔卡插到板子 J100
```
1. 卡插 **J100**，**SW6 [4:1] = OFF, OFF, OFF, ON**（SD1；⚠️ **ON=0**）
2. 串口 FT4232H **ch0 @ 115200 8N1**
3. 上电，按计划 P3–P5：

```bash
lsusb                        # 摄像头枚举了吗
v4l2-ctl --list-devices
sudo gf_npu_probe            # ★ 必须 RESULT: PASS —— 这是整条链路的门禁
sudo gf_camera -s 640x480
```

**在 `gf_npu_probe` PASS 之前，`gf_camera` 报的任何类别都不算数。**
**放弃线：P5 两小时内不 PASS 就停**，不要在 NPU 未验证时去调摄像头。

---

## 148 2026-09-12 ZCU104 上板推进计划（含离线预检）；`.workbuddy/` 移出仓库

**阅读顺序：本节是"可以动手写卡了"的入口。执行照 `docs/ZCU104_上板推进计划_2026-09-12.md`（以那份为准），本文只记结论与两条纠正。**

### 1. 本轮完成的事

**(a) `.workbuddy/` 移出仓库。** 用户指出这是**本机**的工作区状态（agent 记忆/续接缓存），
不该两端互相同步。已：`.gitignore` 加 `.workbuddy/` → `git rm -r --cached` → 提交推送。
**磁盘文件两端都保留了**（提交前先备份到仓库外，合并后再恢复，并逐个 md5 校验）。
**项目正式日志就是本文档**（编号章节，倒序，每轮在顶部追加）。

**(b) 完成一次**离线**上板预检，把能提前查的全查完。**

**(c) 产出 `docs/ZCU104_上板推进计划_2026-09-12.md`** —— 分步、带判据、带失败分支、
带时间盒与放弃线。它取代速查卡成为执行依据。

### 2. 预检结果（**全部为本次实测**）

| 检查 | 结果 |
|---|---|
| 镜像产物 | `BOOT.BIN` 21.1 M(01:18) / `image.ub` 9.97 M(00:46) / `rootfs.ext4` 431 M(01:18) / **`boot.scr` 存在**(3474 B) |
| 内容校验 | `05_verify_image.sh` = **`RESULT: PASS`**；指纹 `gf_npu_probe md5=2ed2ef05ab52e145`、`gf_camera md5=bb04ced68ea693e9` |
| **设备树（新增检查）** | 用 `dumpimage` 从 **`image.ub`(FIT)** 里提取内嵌 DTB，与 `system.dtb` **md5 完全一致**：`3a15a61b5e8a4e15fd9e38f4ce039ccb` |
| `npu-buffers@70000000` | 存在，16 MB，**`no-map`** ✅ |
| `bootargs` | 含 **`clk_ignore_unused`** ✅，`root=/dev/mmcblk0p2` |
| NPU 控制口 | `gestureflow_layer_chain_dmp_hp0_axil@a0000000`（1 MB，clk `0x47`）✅ |
| USB | `usb@ff9d0000`→`usb@fe200000`，**`dr_mode="host"`、`maximum-speed="super-speed"`** ✅ |
| 板级 | `compatible = xlnx,zynqmp-zcu104-revC` ✅（`MACHINE_NAME` 生效） |

**为什么要查 `image.ub` 内嵌 DTB**：`system.dtb` 在 `BOOT.BIN` 里，但内核实际是**用 `image.ub`
里那份 DTB 启动的**。两者不一致时板子会带着没被检查过的 DTB 启动，而这个问题在串口上极难看出来。

### 3. 两条必须纠正的记录

**(a) ⚠️ 板上命令缺 `sudo`。** `gf_npu_probe` / `gf_camera` 都要 `open("/dev/mem", O_RDWR)`
（`gf_npu.c`），不带 `sudo` 直接报 `open /dev/mem failed ... (needs root)`。
速查卡与计划里已全部补上。

**(b) ⚠️ `BUILD_RC=0` ≠ 镜像被重新生成。** 我此前记的"10:15 重编、镜像 ~10:17 重新生成"
**是错的**。实测：`06_install_app.sh` 确实 10:15:55 跑、10:17:39 结束、`BUILD_RC=0`，
但构建摘要是 **`Attempted 4854 tasks of which 4835 didn't need to be rerun`**，
且 `BOOT.BIN`/`rootfs.ext4` 时间戳**仍是 01:18**。
**这不是故障**：源码自 01:15 未变，重编产物逐字节相同 ⇒ 下游镜像任务被 bitbake 正确跳过。
⇒ **判据永远是 `05_verify_image.sh` 的 `RESULT: PASS`，不是构建返回码。**（对应 `IDENTITY.md` D6）

### 4. 程序接口（从源码确认）

```
gf_npu_probe [--bench N] [--ppm out.ppm]
gf_camera    [--list] [-s WxH] [-n N] [--save-ppm P]      ← 都要 sudo
```

### 5. 下一步（唯一路径）

```
P1  你：lsblk 找卡 → sudo 04_make_sd.sh /dev/sdX     （脚本内置 GATE 0，不 PASS 拒绝写卡）
P2  你：插 J100、SW6[4:1]=OFF,OFF,OFF,ON（ON=0!）、串口 FT4232H ch0 @115200 8N1、上电
P3  你：uname -a / lsusb / ls /dev/video* / dmesg|grep -i usb      → V1
P4  你：v4l2-ctl --list-formats-ext                                → V2
P5  你：sudo gf_npu_probe        ★ 必须 RESULT: PASS ← 整条链路的门禁   → V3
P6  你：sudo gf_npu_probe --bench 200   → PL 与 CPU 侧开销，对比裸机 17.02/10.04 ms → V4
P7  你：sudo gf_camera -s 640x480 [-n 100] [--save-ppm ...]        → V5（第一次真正闭环）
P8  我：归档 + 定下一轮优先级
```

**放弃线**：**P5 两小时内不 PASS 就停**。不要在 P5 未通过时去调摄像头 ——
那样得到的类别数字无意义，且会把一个问题变成两个纠缠的问题。

**恢复手段**：板子不会坏。SW6 拨回 QSPI32（`ON,ON,OFF,ON`）能起出厂镜像，
可用于区分"板子问题"与"卡/镜像问题"。

### 6. 上板之后的优先级（已重排）

1. **DMP A/B 对照**（同 DSP 预算下 DMP vs 朴素 INT8）——项目自己的创新性门禁要求，
   现在只有单元对账，**不足以支撑论文主张**
2. **功耗数据**（申请书要求 ≤100 mW，当前**零数据**）
3. 去 CPU 侧开销（若 P6 确认仍在 10 ms 量级）
4. PL 提频 ~137 MHz（`WNS +2.751 ns @100 MHz` 有余量）
5. 官方 CoralNPU 模拟器上的同模型 baseline（申请书 §5.3.3 要求对比原生；硬件对照不可行）

### 7. ⚠️ 计划初稿的一处真实漏洞：WSL 看不到 SD 卡（已修正）

初版 P1 直接让用户 `lsblk` 找卡 —— **这是错的**。
**实测：WSL2 默认不透传 USB/块设备。** WSL 内 `lsblk` 只有虚拟盘：
`sda 356.9M` / `sdb 159.4M` / `sdc 3G (swap)` / `sdd 1T (/mnt/wslg/distro)`，**没有 SD 卡**。

**⚠️⚠️ 后续实测推翻了"可以用 `wsl --mount`"这个判断 —— 它对读卡器根本不可用。**

**微软官方文档原文**（`learn.microsoft.com/windows/wsl/wsl2-mount-disk`）：
> *The `wsl --mount` command does **not** currently support USB/flash drives/SD card readers.*

**实测吻合**：管理员权限下执行 `wsl --mount \\.\PHYSICALDRIVE2 --bare` **两次都失败**：
```
Wsl/Service/AttachDisk/MountDisk/0x8007000f            ← 第一次
Wsl/Service/AttachDisk/MountDisk/HCS/0x8007000f        ← 脱机后重试
```
`0x8007000f` = Win32 **ERROR_INVALID_DRIVE**（"系统找不到指定的驱动器"）。
社区报告一致：**配读卡器是长期未修的已知问题**，不是操作错。
（还确认了另一件事：`wsl --mount` **必须管理员** —— 非提权会报
`WSL_E_ELEVATION_NEEDED_TO_MOUNT_DISK`。）

**⇒ 正确路径改为 USB 透传（usbipd）**，这也是微软文档在 `--mount` 不适用时指向的方案。
**本机条件已核实具备**：`winget` 可用；WSL 内核 6.18.33.2 里
**`vhci-hcd.ko` / `usbip-core.ko` / `usb-storage.ko` / `uas.ko` 全部存在**
（`.../kernel/drivers/usb/{usbip,storage}/`）。
流程：`winget install -e --id dorssel.usbipd-win` → `usbipd list` 取 BUSID →
`usbipd bind/attach --wsl --busid X` → WSL 里 `sudo modprobe vhci-hcd usb-storage`
→ `lsblk` 应出现约 28.9 G 的盘 → `04_make_sd.sh /dev/sdX` → `usbipd detach`。
**注意**：`attach` 后卡会从 Windows 资源管理器消失，这是正常的。

**⚠️ 必须管理员权限**：从非提权会话跑会直接报
```
WSL2: Error: 0x80040315
      Wsl/Service/AttachDisk/MountDisk/WSL_E_ELEVATION_NEEDED_TO_MOUNT_DISK
```
（这一条已实测，所以是确定结论，不是推测。）

**当前盘位**：用户实机 `Get-Disk` 显示
`0 WD PC SN560 953.9GB NVMe` / `1 Samsung 990 EVO Plus 931.5GB NVMe` /
**`2 Generic MassStorageClass 28.9GB USB`** ⇒ **卡 = `\\.\PHYSICALDRIVE2`**。

**备选方案 B —— `07_make_sd_image.sh` 已写好**（WSL 里造 `.img`，Windows 用 Rufus/Etcher 写卡）。
**设计上刻意不重写分区逻辑**：造稀疏文件 → `losetup -Pf` → **直接调 `04_make_sd.sh`**，
两条路共用同一段代码。
**已离线验证**（无 root 实测）：`truncate` 稀疏文件 ✅；**`04` 那三条 `parted` 命令在文件上
产出完全符合设计的分区表** ✅（p1 `1G` Id`c` FAT32-LBA，p2 `1020M` Id`83` Linux）；
`mke2fs -E offset` ✅（261120 个 4K 块，`dumpe2fs` 回读 clean）；loop 命名分支
`/dev/loop0 → loop0p1/p2` ✅。
**未验证（诚实说明）**：`losetup -Pf` 全流程需 root，我无法执行，**没有端到端跑过**。
另有一条实测小坑：`mkfs.vfat --offset` 的**单位是扇区不是字节**（07 用 loop 设备，不受影响）。

### 8. SD 卡的事实核对（实测）

- **官方套装 16 GB 卡**：Windows 里是 `G:`、可移动、卷标 **`PYNQ`**、FAT32，
  内容 `BOOT.BIN`(1.7 MB)/`image.ub`(23 MB)/`boot.py`/`boot.scr`/`REVISION`。
  **"只显示 ~120 MB"是正常的** —— 那是 FAT32 引导分区；剩下 ~15 GB 是 **ext4 根分区，
  Windows 读不了所以不显示**。
  **好消息**：这张卡能跑 PYNQ ⇒ **卡、读卡器、板子 SD 通路三者都正常**。
- **32 GB U1 卡**：**完全够**。U1 = 持续写 ≥10 MB/s，431 MB rootfs ≈ 45 秒写完；
  Linux 启动对 U1 无压力。容量远超需求。
- **决定：用 32 GB 那张**；PYNQ 卡留着不动（保留可用 PYNQ 环境 + 作为链路对照物）。
- **备选环境备注（不进本次关键路径）**：PYNQ 有 Python/Jupyter，且 `pynq.Overlay`
  可**运行时下载 bitstream**，迭代很香；但它的 DTB 是通用板级 ——
  **无 `npu-buffers` 预留段、无 `clk_ignore_unused`**，`CONFIG_DEVMEM` 也不确定，
  换过去等于把已校验的环境变量全部重开。**本次不换。**

---

## 147 2026-09-12 项目审计与再评估：对齐大创申请书的验收物，并修掉上一轮引入的缺陷

**阅读顺序：本节是一次"停下来重新校准"的记录，不是新的功能推进。先读本节的 §2（申请书 vs 实际交付的差距表）与 §4（优先级重排），再回到 146 号看 Linux 侧已做到哪一步。配套文档：`docs/项目审计与再评估_2026-09-12.md`。**

### 1. 为什么要停下来

用户指出上一轮工作的**方法论和细节把控有问题**，要求停止推进、做彻底的自我审计。
审计中发现的最重要一件事：**我此前从未读过本项目的《大学生创新训练项目申请书》**
（`24348025_面向手势识别的RISC-V+NPU设计.pdf`），而它定义了全部验收指标与 deadline。
因此我之前的"计划"（烧 SD 卡上板）根本没有对准验收物。

### 2. 申请书承诺 vs 实际交付（**本节最该看的一张表**）

| 申请书承诺 | 实际 | 判定 |
|---|---|---|
| 基于 Coral NPU 开源 IP **二次开发** | 完全独立自研 RTL；`coralnpu/` 只读、仅思想借鉴 | ❌ 路线不一致 |
| 3×3 卷积并行 MAC 阵列（16/32 路） | DMP MAC 阵列（16 out × 8 in），但主线是 **4×4** | ⚠️ 部分 |
| **LSTM 专用处理子模块** | **完全未做** | ❌ |
| **动态手势 ≥92%** | **完全未做** | ❌ |
| 静态手势 ≥95% | **98.88%**（HaGRID-18，85311 张测试） | ✅ |
| **单帧延迟 ≤5 ms** | 27.06 ms（ZCU104，含 CPU 侧 10.04 ms） | ❌ 差 5.4× |
| **功耗 ≤100 mW** | **无任何数据** | ❌ |
| Zynq-7020 上板 | 已跑通（`0x600D600D`，41.9 FPS），另做了 ZCU104 | ✅ |
| 72 小时稳定性 | 未做 | ❌ |
| 静态 5 万帧 / 动态 1000 组 | 静态 85311 张够；动态 0 组 | ⚠️ 半 |
| **学术论文初稿** | **未写** | ❌ |
| 时序分析报告 / 功能仿真报告 / 架构说明书 | 素材齐备，**未成文** | ⚠️ |

**申请书进度表**：上板测试阶段 = **2026 年 10 月前**；成果凝练（论文/报告）= 2026 年 11 月前。

### 3. 当前最要命的一条

**项目自己的核心叙事「ZCU104 上实时摄像头手势识别」，在硬件上一次都没跑过。**
`gf_npu_probe` / `gf_camera` 已在 rootfs 内并通过静态校验（`05_verify_image.sh` = `RESULT: PASS`），
但从未在板上执行。**没有上板实测，上面任何缺口都补不上，论文也没有数据。**
好消息：它不依赖任何研发，只差写卡（sudo）+ 板子时间 + 上板调试。

### 4. 优先级重排（到 2026-10）

- **P0 上板打通**：写卡 → SW6=SD1 → `gf_npu_probe`（必须 PASS）→ `--bench 200`（拿 Linux 侧 CPU 开销）
  → `gf_camera`（项目第一次真正闭环）。**在 probe PASS 之前，camera 的类别一律不算数。**
- **P1 论文地基（当前完全缺失）**：
  ① **DMP A/B 对照**（同 DSP 预算下 DMP vs 朴素 INT8）——项目自己的创新性门禁要求
  "同硬件/同模型/同精度/同输入的可复现实测对照"，现在只有单元对账，**不足以支撑论文主张**；
  ② **官方 CoralNPU 模拟器上的同模型 baseline**（硬件对照不可行，见 2026-08-04 可行性评估；
  模拟器对照可行且已有先例）。
- **P2 成本可控的指标缺口**：功耗（Vivado `report_power` 估算 + 板级实测，**唯一零成本高价值项**）、
  PL 提频 100→~137 MHz（`WNS +2.751 ns` 有余量）、去除 CPU 侧 10 ms（上板即得）。
- **P3 待拍板**：动态手势 / LSTM —— 做最小演示（PS 侧时序融合 + 已有
  `gestureflow_temporal_accumulator.sv`）还是向导师申请变更 scope。
- **P4**：72h 稳定性挂机（要提前启动）、三份报告成文、论文初稿。

**关于 ≤5 ms 的诚实结论**：去掉 CPU 侧 10 ms（≈18 ms）+ 提频到 137 MHz（≈13.4 ms）后仍 >5 ms。
**在"单帧串行 + 16-lane"的当前架构下 5 ms 达不到**，需要加宽阵列 + 真实重叠。
⇒ 应如实报告差距并给出路径，**不要改口径或改测法去凑指标**。

### 5. 本轮修掉的缺陷（上一轮我自己引入、且已推送到公开仓库）

| 缺陷 | 真相 | 修法 |
|---|---|---|
| 04/05/06 里三个 "CRLF 自愈守卫" | **含裸控制字节；且 04/05 里先 `tr -d` 删光 CR 再匹配 CR ⇒ 恒不触发，是死代码**；06 的行为还和前两个不一致 | **整体删除**；3 个脚本复验 **CRLF=0 / loneCR=0** |
| 换行没有策略 | `core.autocrlf=false` 且**无 `.gitattributes`** ⇒ 换行取决于谁用什么工具写的；而仓库在 git 层面本来就是 **1181/1181 全 LF** | 新增仓库根 **`.gitattributes`**，把会被执行的文本钉成 LF（**根因修复**，不引发大面积重归一化） |
| 投放缺少换行门禁 | 潜规则：混进 CR 后症状离原因很远 | `06_install_app.sh` 增加**投放前 CR 检查**（拦截，不自愈） |
| `sync_repo.sh status` 误导 | 它硬编码 `/mnt/c/...` 与 `/home/...`，**只能在 WSL 内运行**；从 Windows 侧跑会把两端都报成"(不是 git 仓库)"，而我当时没去查 $R/$W 就绕开它手敲 git | 增加前置检查：跑错侧立刻退出并打印正确用法 |

**回归验证**：删除守卫后重跑 `05_verify_image.sh` 仍 `RESULT: PASS`
（`gf_npu_probe md5=2ed2ef05ab52e145` / `gf_camera md5=bb04ced68ea693e9` / `gf_npu.c md5=65976d8f94d320d3`）
⇒ 反证守卫确实从未起作用。

### 6. 本轮确立的作业纪律

已写入 `~/.workbuddy/IDENTITY.md`（持久身份文件，本轮首次建立并告知用户）：
身份为"本项目硬件负责人"，含 D1–D11 十一条**来自真实失败**的纪律，
其中最关键的四条：
**D1 先取证后动手**（判断前必须跑过能推翻它的检查）；
**D2 断言必须被工件支持**（说"已修复"要附字节级证据）；
**D3 修根因不打补丁**；**D4 先读定义性文档再执行计划**。

### 7. 下一步

**P0 只差一次 sudo 写卡 + 板子时间**（写卡命令见 146 号 §5）。
其余按 §4 的 P1→P4 推进，但 **P3（动态手势/LSTM）需要用户与导师拍板**，
`≤5 ms` 与论文投递目标的口径也需要拍板。

---

## 146 2026-09-12 PetaLinux 构建打通（含完整可烧录镜像）；Linux 用户态 NPU 驱动与 USB3 摄像头链路落地

**阅读顺序：先读本节拿到「Linux 侧已经做到哪一步」与「上板第一步做什么」；第 145 号仍是对 ZCU104 现状与 PetaLinux 环境坑最完整的记录，本节的 §2 是它的补充与更正。**

### 1. 本轮真正完成的是什么

**（a）PetaLinux 2023.2 构建首次成功，产出完整可烧录镜像。**

`BUILD_RC=0`，`images/linux/` 下：

| 文件 | 大小 | 说明 |
|---|---|---|
| `BOOT.BIN` | 21.1 MB | FSBL + PMUFW + ATF + `system.bit` + `system.dtb` + U-Boot |
| `image.ub` | 9.97 MB | kernel + DTB + rootfs（FIT） |
| `rootfs.ext4` | 430 MB | ext4 rootfs（已含下列组件） |
| `system.dtb` | 45 KB | 含 `reserved-memory` 与 USB host 配置 |
| `rootfs.tar.gz` | 71 MB | 备用 |

rootfs 内已确认包含：**`gf-npu 1.0`（本轮新增）**、`v4l-utils 1.23.0`（`v4l2-ctl`）、
`usbutils 014`（`lsusb`）、`libjpeg62 2.1.5.1`（MJPEG 解码）、`libv4l 1.23.0`。

**（b）Linux 用户态 NPU 驱动 + USB3 摄像头链路，全部代码就位并已过静态校验。**

新增 `board_zcu104/linux/`：
- `gf_npu.{h,c}` —— 裸机驱动的用户态移植。寄存器协议、权重灌入、21 tile 调度、逐层校验**全部照搬**，
  只换访存方式（`/dev/mem` mmap）与计时源。
- `gf_npu_probe.c` —— **移植验证的唯一判据**：参考图自检 + benchmark。
- `gf_camera.c` —— V4L2 抓帧 → RGB → 面积平均缩放到 96×96 → 送 NPU → 类别（含多数投票平滑）。
- `Makefile` —— SDK 或显式 `CROSS_COMPILE` 交叉编译。

新增 `board_zcu104/yocto/gf-npu/gf-npu_1.0.bb`：把两个二进制**直接打进 rootfs**，
板上 `/usr/bin/gf_npu_probe`、`/usr/bin/gf_camera` 开箱可用，**不需要装 SDK**。
18 个权重头文件从 `board_7020/software/` 原样拷入 recipe 的 `files/`，量化模型保持**单一真源**。

**（c）设备树新增 NPU 缓冲区预留段。**

`plnx/system-user.dtsi` → `reserved-memory { npu-buffers@70000000 { reg = <0x0 0x70000000 0x0 0x1000000>; no-map; } }`

### 2. 关键发现（每条都注明了取证方式）

- **【纠正 145 号的空白】DWC3 必须留在 DUAL_ROLE，host-only 会让 vmlinux 链接失败。**
  这是本轮构建唯一一次真失败，且是配置写错：
  ```
  drivers/usb/dwc3/core.o: undefined reference to `dwc3_gadget_exit_hibernation'
  ```
  Xilinx 内核 `core.c:2104`（`dwc3_remove`）与 `core.c:2399`（`dwc3_suspend`）**无守卫**地调用 gadget
  专有函数（两处都在 `#ifdef CONFIG_PM_SLEEP` 内），而定义在 gadget 专有文件
  `drivers/usb/dwc3/gadget_hibernation.c:399`。host-only 时该文件不编译 → 符号未定义。
  `Kconfig` 里 `USB_DWC3_HOST` 的 help 本身就写着 *"the gadget feature will be regressed"*。
  **正解：保持 defconfig 默认 `CONFIG_USB_DWC3_DUAL_ROLE=y`，host 行为由设备树给。**

- **【把 145 号的推断变成实测铁证】USB3 Host 确实来自官方板级 DTSI。**
  反编译 `system.dtb` 后可直接看到源头：
  ```dts
  /* zcu104-revc.dtsi:458 —— 随 MACHINE_NAME=zcu104-revc 自动引入 */
  &dwc3_0 { dr_mode = "host"; snps,usb3_lpm_capable; maximum-speed = "super-speed"; };
  &usb0   { phys = <&psgtr 2 PHY_TYPE_USB3 0 2>; };   /* PS-GTR Lane2, ref clk2 */
  ```

- **【必须记住的正确性细节】输入的 −128 重定心是 PL 做的，驱动只写原始 uint8。**
  `rtl/gestureflow_hp0_rgb_loader.sv:5,58-60`：
  ```verilog
  // pixels. RGB is recentered to q=u-128 before it reaches the convolution.
  assign pixel_rgb[0] = {~byte_fifo[7], byte_fifo[6:0]};   // = XOR 0x80 = u-128
  ```
  ⇒ **软件绝不能自己减 128**。这一条搞错会导致整网结果全错，而且在板上表现为「能跑但类别乱」。

- **【预处理链的精确形态】** `algorithms/static_cnn/train_static_cnn.py:1041` 是
  `Image.open(p).convert("RGB").resize((96,96), Image.BILINEAR)` —— **直接拉伸、不裁剪、不保长宽比**；
  且 PIL 的 BILINEAR 缩小是**抗锯齿**的（滤波器 support 按抽取比放大）。
  ⇒ 驱动用**面积平均**（box）近似，比朴素双线性/最近邻都更贴近。最近邻会造成严重混叠。

- **访存方案与缓存一致性**：寄存器 `0xA0000000`（1 MB）+ 缓冲区 `0x70000000`（16 MB）都走 `/dev/mem`。
  `no-map` 是关键：不加就还是 System RAM、`devmem_is_allowed()` 会拦掉；加了则被 `memblock_remove`
  摘出 RAM 映射 → 可 map 且内核不会占用。两段都是**非缓存** ⇒
  **整条 HP0 非相干链路上不需要任何 cache flush/invalidate**。

- **【省下一次 25 分钟重编的教训】kernel config fragment 是按内容校验和的，连只加注释都会触发内核重编。**
  已实测的事实因此写进 `plnx/PITFALLS.md` 而**不写进 `kernel_uvc.cfg`**：
  `CONFIG_DEVMEM=y` 已开、`# CONFIG_STRICT_DEVMEM is not set`、`CONFIG_UIO_PDRV_GENIRQ=m` 可用、
  `clk_ignore_unused` 已在 bootargs、`root=/dev/mmcblk0p2` 已是默认、`v4l2-ctl`/`lsusb` 已在 rootfs。
  **这些都不需要"修"。**

- **【方法论教训，第 2/3/4 次同类失误】** 本轮 4 次构建失败里有 **3 次是我按直觉或照抄教程写配置**、
  没先查生成逻辑或符号归属：`CONFIG_YOCTO_PARALLEL_MAKE` 填 `-j8`（要纯数字 `8`）、
  `package-management` 当包启用（实为 Image Feature）、`CONFIG_USB_DWC3_HOST=y`（应保持 DUAL_ROLE）。
  以后动任何 Kconfig 符号前：① grep 生成逻辑或源码消费点；② 确认它是 recipe / image feature /
  kernel config 中的哪一类。

### 3. 已通过的验证（上板前的静态门禁）

- **V0 设备树**：`npu-buffers@70000000` 存在且 `no-map`；`bootargs` 含 `clk_ignore_unused` 且末尾 `rw`；
  `dr_mode="host"` 回归无损；`memory@0` 为 `0x0–0x7FF00000`，与预留段无冲突。
- **V0b 代码**：用 WSL 本机 gcc 做**真实编译+链接**，三个 `.c` 无错误无警告，两个二进制无未定义符号。
- **V0c rootfs**：用 `debugfs` 从 `rootfs.ext4` 里取出二进制 ——
  `ELF 64-bit LSB pie executable, ARM aarch64`；`NEEDED` 为 `libjpeg.so.62` / `libc.so.6` /
  `ld-linux-aarch64.so.1`，**三者都在 rootfs 里存在**。

### 4. 仍未证明的事（诚实清单，不要当成已完成）

- **V1–V6 全部未上板验证**（本轮作业时板子已关机）。
- 摄像头具体支持哪些格式/分辨率未知，需 `gf_camera --list` 或 `v4l2-ctl` 实测。
- `/dev/mem` 是否真被拦、PL 时钟（`clk_pl_0`）是否真被内核关掉，只有上板才知道。
- **中间阶段的校验强度已经补强（比裸机版更强）**：裸机驱动只在 conv0、conv1/pool1、GAP/FC
  三处做内容比对，中间 6 个阶段**只查 DMA 写入字节数**。
  本轮发现**每个阶段的 golden 张量都在头文件里导出了**，于是用户态版本改为
  **逐字节 `memcmp`**，并用程序实证确定了 golden 与阶段的对应关系（计算每个数组的 FNV1A 去匹配宏）：
  ```
  conv0  147456  gf_body2_layer_input   05307466 = GF_FULL_OUTPUT_FNV1A
  pool1   36864  gf_pool_output         33B1A130 = GF_POOL_OUTPUT_FNV1A
  conv2   73728  gf_conv2b_layer_input  90D6DF2F = GF_CONV2A_OUTPUT_FNV1A
  pool2   18432  gf_pool2_output        8439E9C9 = GF_POOL2_OUTPUT_FNV1A
  conv4   27648  gf_conv3b_layer_input  591D321E = GF_CONV3A_OUTPUT_FNV1A
  pool3    6912  gf_pool3_output        D10D7766 = GF_POOL3_OUTPUT_FNV1A
  ```
  顺带纠正一个易误读点：**融合池化的层，硬件 `GF_OUTPUT_FNV1A` 报的不是存进 DDR 的池化张量**。
  conv1 跑完后它读 `GF_BODY2_OUTPUT_FNV1A = GF_POOL_INPUT_FNV1A = 0x7E276C7B`，
  是**池化前**卷积输出的 FNV；而 `gf_pool_output` 是 `0x33B1A130`。
  ⇒ 裸机版那处检查实际在查 MAC 输出流；**池化结果由新的 memcmp 负责验证**。

  content 校验**只在 `stats != NULL` 时执行**（`gf_npu_probe`），
  实时摄像头循环走快速路径 —— 否则每帧对非缓存内存做 ~0.6 MB 的 memcmp+FNV1A
  会反过来污染 V4 要测的 CPU 侧开销。校验耗时单独记入 `cpu_checks_ms` 并从报告里扣除，
  保证与裸机 10.04 ms 同口径。目前**唯一没有 golden 的是 head1x1 的 12×12×64 输出**，
  那里只留软件 FNV 基线。

### 5. 下一步（按顺序，不跳步）

1. **写 SD 卡**（需 sudo，让用户执行）：
   ```bash
   lsblk -o NAME,SIZE,RM,TYPE,MOUNTPOINT,MODEL
   sudo bash ~/coralnpu-gesture/gesture_project/innovation_npu/board_zcu104/plnx/04_make_sd.sh /dev/sdX
   ```
   脚本会先校验 rootfs 的 manifest 里有 `gf-npu`（否则拒绝烧录）、分区、写 rootfs、**`resize2fs` 撑满分区**
   （不做这一步 430 MB 之外全废）、写后 `debugfs` 复核 `/usr/bin/gf_npu_probe`。
2. **SW6 [4:1] = OFF, OFF, OFF, ON**（SD1；UG1267 Table 2-4，注意 **ON=0 / OFF=1**），插卡，上电。
   串口 = FT4232H channel 0，115200 8N1。
3. 板上依次执行：
   ```
   lsusb                          # 摄像头枚举了吗
   v4l2-ctl --list-devices
   gf_npu_probe                   # 必须 RESULT: PASS —— 在此之前摄像头结果一律不算数
   gf_npu_probe --bench 200       # 报 PL cycles 与 CPU 侧新开销，与裸机 17.02/10.04 ms 对比
   gf_camera -s 640x480
   ```
4. 之后才是优化：双缓冲流水（预留段已按 16 MB 留足）、PL 提频（WNS +2.751 ns @100 MHz
   ⇒ 理论 ≥137 MHz）。

### 6. 相关文档

- `docs/ZCU104_Linux侧NPU与摄像头_设计与实施_2026-09-12.md` —— 地址映射、寄存器协议、
  预处理链、验证阶梯、未决问题的完整设计文档。
- `board_zcu104/plnx/PITFALLS.md` —— 7 个实际踩到的 PetaLinux 坑（症状/原因/修复），
  以及"本来就对、不要修"的清单。
- `board_zcu104/plnx/04_make_sd.sh` —— SD 卡制作（含写后校验）。
- 提交：`8da4f64`（10 文件 / 2585 行）。

---

## 145 2026-09-12 ZCU104 平台打通：整网实板 36.96 FPS；PetaLinux 走 ZCU104 原生流程；两端仓库同步建立

**阅读顺序：先读本节获得 ZCU104 现状与 PetaLinux 侧的关键坑；再读第 144 号确认 7020 稳定基线（41.9 FPS）依旧是不可回退的金标准；ZCU104 的移植取证与风险清单见 `ZCU104_上板前审查与修订方案_2026-09-11.md`。**

### 1. 本轮真正完成的是什么

- **ZCU104 整网跑通**：`FINAL_RESULT = 0x600D600D`，`GESTUREFLOW_HAGRID18_DMP_ZCU104_BOARD_PASS`，
  `PROBE[10..26]` 非零说明各层 FNV 校验都实际执行。RTL 语义与 7020 完全一致（原样移植）。
- **实测性能**（`PROBE[130]`/`[133]`）：整帧 `2,705,924 ticks @100MHz = 27.06 ms → 36.96 FPS`；
  PL 纯计算 `1,702,205 cyc @100MHz = 17.02 ms`；**CPU 侧开销 10.04 ms（占 37%）**；权重装载 0.49 ms。
- **软件可移植性修复**：`gestureflow_hagrid18_dmp_main.c` 里注册的
  `XIL_EXCEPTION_ID_DATA_ABORT_INT` / `_PREFETCH_ABORT_INT` 只存在于 standalone `xil_exception.h`
  的 **AArch32 分支**，A53 编译直接报未声明。已用 `#if defined(__aarch64__)` 换成
  `XIL_EXCEPTION_ID_SYNC_INT` + `SERROR_ABORT_INT`，**7020 路径语义不变**（同一份源码两端都用）。
- **PetaLinux 2023.2 从零建到可构建**：走 **ZCU104 原生流程**（见 §2），主机依赖全绿，
  工程 `~/gf_linux_ws/gf_linux` 配置完成，`petalinux-build` 已启动。
- **两端仓库同步链路建立**：Windows 工作区成为同一仓库的克隆；`sync_repo.sh` 固化双向流程。

### 2. 根因定位 / 关键发现

- **ZCU104 的 USB3 摄像头不需要手改设备树**。依据 AMD 官方 ZCU104 教程
  （`Vitis-Tutorials → Vitis_Platform_Creation/Getting_Started/02-Edge-AI-ZCU104/step2.md`），
  只要 `petalinux-config` 里 `DTG Settings → MACHINE_NAME = zcu104-revc`，就会引入官方板级 DTS
  `zynqmp-zcu104-revC.dts`，其中已经是 `&dwc3_0 { dr_mode = "host"; maximum-speed = "super-speed"; }`
  和 `&usb0 { phys = <&psgtr 2 PHY_TYPE_USB3 0 2>; }`（与板卡预设的 `GT Lane2` 一致）。
  已在本机验证生效：生成的 machine conf 里 `YAML_DT_BOARD_FLAGS = "{BOARD zcu104-revc}"`。
- **`en_US.UTF-8` locale 是 PetaLinux 的硬性要求，不是可选优化**。PetaLinux 在
  `tools/xsct/bin/rdiArgs.sh:37` **硬编码** `export LC_ALL="en_US.UTF-8"`。缺失连锁引发两个致命故障：
  ① XSCT 的 C++ 工具 `locale::facet::_S_create_c_locale name not valid` + `Aborted (core dumped)`
  → `gen-machineconf` 挂 → 工程配置失败；② `/bin/sh` 的 setlocale 警告写进 stderr，而 BitBake
  用 `stderr=STDOUT` 合并后**只解析第一行**（`poky/meta/lib/oe/utils.py:430`），于是报
  `ERROR: Can't get compiler version from gcc  --version output` 并秒退——**极易误判成 gcc 有问题**。
- **`CONFIG_YOCTO_PARALLEL_MAKE` 要填纯数字**。`gen_plnx_machine.py` 自己会拼 `"-j %s"`，
  填 `-j8` 会生成 `PARALLEL_MAKE = "-j -j8"`，Poky 解析时 `int("-j8")` 直接抛
  `ValueError`。Kconfig 提示里显示的 `[-j8]` 只是回显当前值，**不是格式要求**。
- **`package-management` 是 Image Feature，不是 recipe**。AMD 教程那份清单把 image features 和
  真实包混在一起；写进 `meta-user/conf/user-rootfsconfig` 会被当包塞进 `IMAGE_INSTALL`，
  构建报 `ERROR: Nothing RPROVIDES 'package-management'`。正确符号是
  `CONFIG_imagefeature-package-management`，且**不能**放进 `user-rootfsconfig`。
- **ZynqMP 上 `psu_init` 之后必须补 `rst -processor`**。否则 A53 的 L2 仍被 PMU 按在复位，
  `dow` 直接报 `APU L2 cache is held in reset`。**Zynq-7000 没有这一步**，所以 7020 流程不含它。
- **Vitis 的 `app build` 在 xsct 批处理里会无限挂起**（无输出、无进程、无报错）。
  改走 7020 验证过的做法：直接 `aarch64-none-elf-gcc` 编译，配合 `app create` 生成的 `lscript.ld`
  （aarch64 不需要 `Xilinx.spec`）。

### 3. 已经实际跑通的验证

- 综合/实现/bitstream（日志落 Windows 侧）：
  `synth_design completed successfully` → `write_bitstream completed successfully`
  → `ZCU104_GF_BITSTREAM_PASS`；ZCU104 时序 **WNS +2.751ns / WHS +0.009ns @100MHz，0 失败端点**。
- 裸机 ELF 编译通过（`aarch64-none-elf-gcc`，text 214077 / data 2176 / bss 469959）。
- 实板：`GESTUREFLOW_HAGRID18_DMP_RST_PROCESSOR=ok`、
  `GESTUREFLOW_HAGRID18_DMP_FINAL_RESULT = 0x600D600D`、
  `GESTUREFLOW_HAGRID18_DMP_ZCU104_BOARD_PASS`。
- PetaLinux 主机环境检查全绿（`/bin/sh→bash`、i386、UG1144 依赖包、`en_US.UTF-8`）。

### 4. 资源 / 时序对比（ZCU104 Routed，含 PS + 2×SmartConnect + reset）

| 项 | ZCU104 用量 | 可用 | 占比 | 对比 7020 |
|---|---|---|---|---|
| LUT | 31,921 | 230,400 | **13.85%** | 7020 用 32,879/53,200（61.8%） |
| FF | 50,681 | 460,800 | 11.0% | 7020 50,566/106,400（47.5%） |
| DSP | 134 | 1,728 | 7.75% | 7020 **139/220（63.2%）** |
| RAMB36 | 95 | 624 | 15.2% | 7020 95/140（67.9%） |
| **URAM** | **0** | **96** | **0%** | 7020 没有 URAM |

- **纯 GestureFlow IP 单看只用 LUT 7.49%**（`gf_ooc_util.rpt`）。
- 结论：**约 90% 逻辑、92% DSP、100% URAM 空闲**，第 3 章 §4 的"加宽阵列/加 reduce 后端/
  真正 relay 驻留"在 ZCU104 上有充分余量。
- 时序：`WNS +2.751ns @100MHz`，10ns 周期下理论 **≥137 MHz 仍可收敛**，是阶段 1 提频的直接依据。

### 5. 关键坑 / 注意事项

- **ZCU104 端到端 36.96 FPS 暂时低于 7020 的 41.9 FPS，瓶颈不在 PL**：
  PL 部分 17.02ms @100MHz（7020 换算约 20.85ms，ZCU104 更快），
  但 **CPU 侧 10.04ms** 拖累整体。**根因高度指向 `main.c` 里的
  `Xil_SetTlbAttributes(<buf>, DEVICE_MEMORY)`**：它把全部工作缓冲设成 Device 内存
  （非缓存 + 强序），A53 每次访问都走最慢路径。
  ⇒ **改成 Normal cacheable + 精确 flush/invalidate 是下一步最大的性能杠杆**，
  优先级高于提频。注意 7020 上是 A9，同一写法代价不同，不能直接照搬结论。
- **口径纪律（沿用第 144 号）**：36.96 FPS 同样是 **DDR 模拟帧**口径，不是真实摄像头帧率。
- **WSL 上跑 PetaLinux 务必把工程与大数据放在 ext4**：`/mnt/c`、`/mnt/e` 是 9p，
  实测仅约 30 MB/s，且安装程序会把 3 GB 包反复读好几遍。
- **Windows 端无法推送**（无 SSH 密钥、无 credential helper），只能 HTTPS 拉取；
  推送必须走 Ubuntu/WSL（SSH 可用）。remote 因此故意分开 fetch/push URL。

### 6. 下一步操作入口

1. **等 `petalinux-build` 完成** → `petalinux-package --boot` 出 BOOT.BIN / image.ub / rootfs.ext4。
2. 写 SD 卡（`board_zcu104/plnx/04_make_sd.sh`，会先要求确认设备名），
   SW6 拨 **SD1 = `OFF, OFF, OFF, ON`**（UG1267 极性：`ON=0`、`OFF=1`），上电。
3. Linux 起来后先验 USB3 摄像头出 `/dev/video0`（`lsusb` + `v4l2-ctl --list-formats-ext`）。
4. 用户态 NPU 驱动：`/dev/mem` 映射 `0xA0000000`；**HP0 非相干** ⇒ 缓冲需 non-cacheable
   （设备树 `reserved-memory` + UIO 映射）或显式 cache 维护。
5. 之后再回到提频与吞吐扩展：先消掉那 10 ms CPU 开销，再按《推进计划》阶段 1 提频。

---

## 144 2026-09-02 80MHz 稳定代：requant 时间复用 1→4，实板 41.9 FPS；权重 DMA 重叠实验已隔离回退

**阅读顺序：先读本节；再读第 143 号 80MHz 基线；再读 `innovation_npu/rtl/gestureflow_layer_chain_dmp_hp0_axil.sv` 中 `REQUANT_PARALLEL_LANES`。**

### 1. 本轮真正完成的是什么

- 将 `gestureflow_layer_chain_dmp_hp0_axil.sv` 的 `REQUANT_PARALLEL_LANES` 从 `1` 提升为 `4`：每 16 路输出向量的重定标尾端从串行 16 拍缩到 4 拍，只增加少量 DSP，避免把 16 路变量移位 fanout 全部压到 80MHz 关键路径上。
- 修复 DMP 顶层回归脚本 `run_gestureflow_layer_chain_dmp_body2_axil.sh` 缺少 `gestureflow_stream_pool2x2.sv` 的编译清单问题，回归可直接复现。
- Vivado 2023.2 重新生成 bitstream/XSA 并实板验证：`FINAL_RESULT=0x600D600D`，所有层 FNV 与 TFLite golden 一致。

### 2. 根因定位/关键发现

- requant 1→4 后，DMP body2 顶层 Verilator 回归通过：`quant_fnv1a=7e276c7b cycles=371479`，数值位精确。
- 实板端到端：`frame_ticks=0x007965C6`（约 41.90 FPS），`weight_ticks=0x000302E2`，`pl_cycles=0x001972D6`（1,667,798 cycles @80MHz ≈ 20.85ms）。
- 尝试把“下一 tile 权重 DMA + bias/requant 参数 bank 写入”与当前层 store 尾段重叠，以消除串行权重装载；但遇到上一层的 `done`/`STORE_STATUS` 残留导致提前进入 proof 的竞态。为不破坏稳定代，软件主程序已回退到原同步调度，重叠实验的 RTL 能力保留但暂不接入主线。

### 3. 已经实际跑通的回归

- `bash innovation_npu/tests/run_gestureflow_layer_chain_dmp_body2_axil.sh` → `GESTUREFLOW_LAYER_CHAIN_DMP_BODY2_AXIL_PASS quant_fnv1a=7e276c7b cycles=371479`
- Vivado 80MHz 构建：`GESTUREFLOW_HAGRID18_DMP_7020_BITSTREAM_PASS`，时序 `WNS=+0.365ns / WHS=+0.022ns`，0 failed endpoints。
- 实板：`GESTUREFLOW_HAGRID18_DMP_BOARD_PASS`，`PROBE[130]=0x007965C6`、`PROBE[133]=0x001972D6`。

### 4. 资源/时序变化

- 对比上一稳定版：DSP `127→139`，LUT `30927→32879`，FF `50284→50566`，BRAM `95 RAMB36 + 7 RAMB18` 基本不变。
- 80MHz 时序仍收敛，`WNS +0.365ns`，不临违例。

### 5. 关键坑/注意事项

- requant 并行度不是越大越好：4 lane 是 80MHz 下的工程折中；若改 8/16 必须重新综合看 `wdata/requant_multiplier` 高扇出与 DSP 输入流水。
- 软件权重重叠的下一次入口：先修“启动后先确认 `running` 已置位、再等 `done`”，并把 `STORE_STATUS` 的 busy/done 一起纳入完成条件，避免旧层状态残留。

### 6. 下一步操作入口

- 需要更高 FPS 时，优先继续做“权重 DMA + param bank 的尾部重叠”，但必须先过 Verilator 顶层回归并新增一个软件状态机回归；再综合、再实板。

## 143 2026-09-02 多窗口流水二次尝试（含 busy 计数器修复）仍遇行边界偏差，已回退；保 80MHz 基线

**阅读顺序：先读本节获得多窗口第二次尝试的新发现；再读第 142 号第一次根因；再读第 141 号逐层画像。**

### 1. 本轮真正完成的是什么

- 第二次实现多窗口流水，并在第 142 号两个根因基础上补上第三个确定性根因：**单 `busy` 标志会被上一窗口 retire 提前清零**，改为 2bit `windows_active` 计数器（start+1、result 写出-1，`busy = windows_active != 0`），并去掉与“hold-valid 直到 ready”握手冲突的 protocol_error 检查。
- 修完三处后，pointwise 与 spatial full-layer 均在**第一行最后一列**（pointwise y=0 x=11、spatial y=0 x=95）出现 probe 偏差，其余列正确；说明仍有一个与“行边界/窗口切换”相关的第四处根因未定位。
- 为保住已验证的 80MHz 上板状态，本轮改动再次 `git checkout` 回退，工作树干净。

### 2. 根因定位/关键发现

- debug dump 显示 `retire_id` 正确交替、`accum[0]/accum[1]` 与 `activation_sum[0]/[1]` 双缓冲值在重叠期间符合预期，MAC tile 侧基本正确；问题高度怀疑在 conv 引擎 `held_window/held_row/held_column` 与行缓冲 `window_valid/window_ready` 在行边界处的交互。
- 第四处根因排查入口：把 `spatial_window_ready` 是否还需要保留 `!output_valid` 单独做对比实验；并重点 dump 行边界处 `held_row/held_column` 与实际 `output_row/output_column` 是否错位。

### 3. 已经实际跑通的回归

- 回退后 `run_gestureflow_conv4x4_cin_same_stream_dmp_full_layer.sh` → `PASS outputs=9216 raw_fnv1a=8f1602ce cycles=387375`，80MHz 基线无损。

### 4. 资源/时序变化

- 无（已回退）。

### 5. 关键坑/注意事项

- 多窗口流水必须把 `busy` 改成 active-window 计数，不能用单标志；`retire_id` 在 result 挂起时会被下一窗口覆盖的问题仅在 requant 慢于 MAC 时暴露，仿真里 `result_ready=1` 不覆盖该场景，需专门构造慢 requant 测试。

### 6. 下一步操作入口

1. 用最小点积 testbench，把 `spatial_window_ready` 分别按“去掉 !busy、保留 !output_valid”与“两者都去掉”做 A/B，定位第四处根因。
2. 行边界处逐拍 dump `window_valid / spatial_window_ready / held_row / held_column / output_row / output_column`，确认是否错位。
3. 多窗口一旦修通，预期 conv full-layer 387K → ~300K 以下，端到端约 +10~13%。

## 142 2026-09-02 多窗口流水尝试（已回退）：定位到 held_window 覆盖 + retire 竞态两个根因

## 142 2026-09-02 多窗口流水尝试（已回退）：定位到 held_window 覆盖 + retire 竞态两个根因

**阅读顺序：先读本节了解多窗口流水为何暂回退及下一步怎么改对；再读第 141 号逐层画像；再读第 140 号 80MHz 上板基线。**

### 1. 本轮真正完成的是什么

- 尝试把 MAC tile 改成“多窗口流水”：`accum/activation_sum/active_output_lanes` 双缓冲，1bit window-id 随流水传播，放宽 `start_ready/mac_ready` 以消除每窗口约 8 cycle 的 drain。
- 定位到两个确定性根因并修复后仍有一个未收敛的 hang/mismatch，为保住已验证的 80MHz 上板状态，本轮改动已 `git checkout` 回退，工作树干净，80MHz 位流/软件仍可复现。

### 2. 根因定位/关键发现

- **根因 1（已修）**：conv 引擎的 `held_window` 是单缓冲。放宽 `spatial_window_ready` 后，下一窗口会在 `mac_active==1` 时就把 `held_window` 覆盖，而当前窗口的 tap/ic_group 还在从 `held_window` 取激活，直接算错。修法是让 hold 仍要求 `!mac_active`，只把 `busy/output_valid` 从 ready 中拿掉。
- **根因 2（已修）**：retire 输出必须门控 `!result_valid`，否则两窗口背靠背 retire 时，慢 requant 会覆盖尚未消费的 `result_psum`；同时 retire_valid 不能无条件下清，要在结果真正写出的那一拍清。
- **剩余问题（未收敛）**：out32 全层仿真出现 probe 巨大偏差、full-layer 仿真疑似握手死锁（watchdog 超时）。尚未定位到第三处根因。

### 3. 已经实际跑通的回归

- 回退后 `run_gestureflow_conv4x4_cin_same_stream_dmp_full_layer.sh` → `PASS outputs=9216 raw_fnv1a=8f1602ce cycles=387375`，确认 80MHz 基线功能无损。

### 4. 资源/时序变化

- 无（已回退）。

### 5. 关键坑/注意事项

- 多窗口流水的正确改法不是“放宽所有 ready”，而是：conv 引擎侧 hold 受 `!mac_active` 约束（保护 held_window/held_pixel），MAC 侧 retire 输出用 `!result_valid` 门控并正确保持 retire_valid。两者缺一不可。
- 下一步重新做时，建议先用一个“每窗口只有 1 个 group 的点积 tile”做最小复现，逐拍追 window-id/retire_id 与 accum 双缓冲的时序，再上 spatial 全层。

### 6. 下一步操作入口

1. 以最小点积 testbench 复现多窗口死锁，逐拍 dump window-id、retire_valid、result_valid、accum 两路的值定位第三处根因。
2. 修好后先过 conv full-layer（387K cycles 应显著降到 ~300K 以下）再上板。
3. 若多窗口风险仍高，退而做低风险的 `REQUANT_PARALLEL_LANES 1→4`（修 head 658% 开销，约 1%）。

## 141 2026-09-02 80MHz 逐层 PL cycle 实测：总开销 1.6x，定位 drain/requant/head 三个优化点

## 141 2026-09-02 80MHz 逐层 PL cycle 实测：总开销 1.6x，定位 drain/requant/head 三个优化点

**阅读顺序：先读本节获得逐层性能画像与下一轮优化目标；再读第 140 号确认 80MHz 上板基线。**

### 1. 本轮真正完成的是什么

- 给 16-lane DMP board driver 增加逐层 PL cycle 遥测，写入 `PROBE[10..26]`（提交 `0ffd71f`），80MHz 实板逐层实测如下（`PROBE[133]` 总和 1,858,032）：
  - conv0=304,693；conv1+pool1=459,594；conv2a=155,451+155,450；conv2b+pool2=189,438+189,475；conv3a=57,607+57,604+57,607；conv3b+pool3=66,352+66,354+66,362；head1x1=6,548×4；gap_fc=5,853。

### 2. 根因定位/关键发现

- 以 8 输入 lane 引擎的 group-walk 为理想基线（taps×groups×windows），总理想约 1,164,672 cycles，实测 1,858,032，**总开销约 1.6 倍**。
- 逐层相对开销：head 658%（requant 时间复用 PARALLEL_LANES=1 导致点积层 16 cycle/result 成为瓶颈）；conv0 107%、conv2a 111%、conv1 56%、conv3a 56%；conv2b/conv3b 仅 20~28%。
- 规律：每组窗口 MAC group 数越少（conv0 16、conv2a/conv1 32），固定开销占比越高；大层（conv2b 64、conv3b 96）被摊薄。固定开销主要是 MAC tile 每窗口 drain（约 8 级流水）+ 窗口握手 + 输入 loader/line-window 建立。
- 全网络约 31,680 个窗口，按每窗口 drain 8 cycle 估算，纯 drain 约 253K cycles（13.6%）。

### 3. 已经实际跑通的回归与板级验证

- `build_software_hagrid18_dmp_from_wsl.sh` → ELF 通过；`run_board_hagrid18_dmp_from_wsl.sh` → 80MHz `BOARD_PASS`、`FINAL_RESULT=0x600D600D`、`PROBE[133]=0x001C55F0`。

### 4. 性能换算

- 80MHz 端到端 38.1 FPS（record 140）；PL 纯计算 1,858,032 cycles @80MHz ≈ 23.23ms。

### 5. 关键坑/注意事项

- 逐层 cycle 遥测的 PROBE 索引为 10..26，不要与既有 0..3/130..133 冲突。

### 6. 下一步操作入口（按收益排序）

1. **多窗口流水（最大头，约 13%）**：给 MAC tile 的 accumulator/activation_sum 做双缓冲（ping-pong），允许上一窗口尾段 retire 的同时下一窗口的 s0/s1 进入，消除每窗口 8 cycle drain。
2. **requant 并行度 1→4（低风险）**：把 `REQUANT_PARALLEL_LANES` 从 1 提到 4，点积 head 从 658% 开销拉回接近理想，多约 3 个 DSP。
3. 复查 conv2a（111%）为何比同 group 数的 conv1（56%）高：怀疑 2-tile 输入重复读 + 更小窗口数摊薄了 line-buffer 建立开销。

## 140 2026-09-01 80MHz 实板上板通过：端到端 38.1 FPS，比 60MHz 基线 +27%

## 140 2026-09-01 80MHz 实板上板通过：端到端 38.1 FPS，比 60MHz 基线 +27%

**阅读顺序：先读本节获得 80MHz 实板结论；再读第 138/139 号了解 80MHz 时序收敛与布线拥塞；再读第 136 号确认 60MHz 上板基线。**

### 1. 本轮真正完成的是什么

- 80MHz 实板整网单图 `GESTUREFLOW_HAGRID18_DMP_BOARD_PASS`，`FINAL_RESULT = 0x600D600D`，所有层 FNV/class 校验通过。
- 板级探针：`PROBE[130]=0x008568F3`（frame ticks 8,747,251）、`PROBE[133]=0x001C560F`（PL cycles 1,857,039）、`PROBE[131/132]=0x0002FD2A`（权重 DMA ticks）。

### 2. 根因定位/关键发现（本轮最重要）

- 之前 70/80MHz 首次上板 `0xBAD0BAD0 / 0x4D01 / WEIGHT_DMA_STATUS=0x4` 不是时序问题，而是**软硬件 lane 宽度不匹配**：构建回退到 `OUT_LANES=16`，但 `gestureflow_hagrid18_dmp_main.c` 仍是 32-lane 版调度，对 conv2a/conv2b/conv3a/conv3b/head 以 `tile_lanes=32` 发起权重 DMA，而 DMP 权重 loader 的 `MAX_OUTPUT_LANES=16`，触发 `cfg_outputs > MAX_OUTPUT_LANES` 的配置 fault。
- 修复：把 board driver 恢复为 6c189e8 的 16-lane 调度（`git checkout 6c189e8 -- .../gestureflow_hagrid18_dmp_main.c`，提交 `36f776e`）。

### 3. 已经实际跑通的回归与板级验证

- `run_build_gestureflow_hagrid18_dmp_7020_from_wsl.sh` → 80MHz `BITSTREAM_PASS`，WNS=+0.249 / WHS=+0.045、0 failed nets。
- `run_board_hagrid18_dmp_from_wsl.sh` → `BOARD_PASS`，`FINAL_RESULT=0x600D600D`。

### 4. 性能换算（GTC=333MHz，record 136 同口径）

- 60MHz 基线：frame 11,155,189 ticks ≈ 33.5ms ≈ 29.9 FPS；PL cycles 1,803,429。
- 70MHz：frame 10,342,110 ticks ≈ 31.0ms ≈ 32.2 FPS；PL cycles 1,844,752。
- **80MHz：frame 8,747,251 ticks ≈ 26.24ms ≈ 38.1 FPS；PL cycles 1,857,039 @80MHz ≈ 23.21ms。**
- 结论：80MHz 相对 60MHz 基线端到端 +27%，相对 70MHz +18%。

### 5. 关键坑/注意事项

- 构建频率与 board driver 的 lane 宽度必须严格一致：改 `CONFIG.OUT_LANES` 时，必须同步切换对应的 16-lane / 32-lane `main.c`，否则权重 DMA 会在 `0x4D01` fault，且该 fault 与频率无关、极容易误判成时序问题。
- 80MHz 已实板稳定 PASS（WNS=+0.249 / WHS=+0.045），保留 `gestureflow_hagrid18_dmp_7020_70MHz_boardpass.bit` 作为 70MHz 备份。

### 6. 下一步操作入口

1. 若继续冲更高频率，按第 139 号做 pblock 地板规划，整体降跨芯片布线后再试 90/100MHz。
2. 端到端仍有约 3ms 非 PL 开销（权重 DMA 同步装载 + PS 配置 + 输入搬运），恢复权重 DMA/计算乒乓重叠可再压掉这部分。
3. 已具备“一张测试图模拟摄像头输入”的完整单图链路，接下来可接摄像头做连续帧率/功耗实测。

## 139 2026-09-01 80MHz 再收敛并做 fanout 治理：确认频率墙是布线拥塞，不是逻辑深度

## 139 2026-09-01 80MHz 再收敛并做 fanout 治理：确认频率墙是布线拥塞，不是逻辑深度

**阅读顺序：先读本节了解 80MHz 布线拥塞结论；再读第 138 号确认 80MHz 首次收敛；再读第 137 号了解 layer_mode 根因。**

### 1. 本轮真正完成的是什么

- 对 AXI-Lite 配置寄存器 `awaddr/wdata/wstrb`、MAC tile 流水 valid 信号（`s0/s1/product/pair/quad/oct/retire_valid`）、line-window `stage_valid/input_accept` 统一加 `(* max_fanout = 32 *)`，让综合按物理区域复制这些高 fanout 控制寄存器，缩短控制网布线。
- 80MHz 下两轮再综合/布线均 `BITSTREAM_PASS`，最终 WNS=+0.249ns、WHS=+0.045ns、0 失败端点、0 未布线 net（hold 从首次 80MHz 的 +0.023ns 提升到 +0.045ns）。

### 2. 根因定位/关键发现

- 连续三轮 80MHz 的最差 setup 路径分别是：`wdata_reg[8]→bias_bank`、`product_valid→pair_sum/CE`、`tensor32_loader.bytes_remaining[6]→next_addr/CE`。三者共同特征：数据路径 11.8ns 左右、**96%+ 都是布线、0 级逻辑**。
- 结论：80MHz 的瓶颈是整片布线拥塞/高 fanout 控制网，不是加法器或 DSP 逻辑深度。继续单点 `max_fanout` 只是“打地鼠”，修一条冒一条；真正往 90/100MHz 冲需要从结构上减布线，而不是继续逐个复制寄存器。

### 3. 已经实际跑通的回归与构建

- `run_gestureflow_layer_chain_hp0_postprocess_hagrid18.sh` → `PASS bursts=72 cycles=4101`（max_fanout 为综合属性，功能不变）。
- `run_build_gestureflow_hagrid18_dmp_7020_from_wsl.sh` → 80MHz `BITSTREAM_PASS`，WNS=0.249 / WHS=0.045。

### 4. 资源/时序变化

- 80MHz（fanout 治理后）：WNS=+0.249ns、WHS=+0.045ns；对比首次 80MHz WNS=+0.347/WHS=+0.023。hold 更稳，setup 略收窄但仍正裕量。

### 5. 关键坑/注意事项

- `max_fanout` 会复制寄存器（增加少量 FF），对路由拥塞是双刃剑：它能缩短单条高 fanout 网，但复制出的 FF 也要占 slice。80MHz 下净效果是 hold 变好、setup 略变差。
- 不要再逐条追 max_fanout。下一步要么上板确认 80MHz 实际可用，要么做 floorplan/pblock 或精简 loader 数量来整体降布线。

### 6. 下一步操作入口

1. 板子接上后先烧 80MHz 实板（`run_board_hagrid18_dmp_from_wsl.sh`），读 `PROBE[130]/[133]` 拿真实 FPS。
2. 冲更高频率优先做 **pblock 地板规划**（把 MAC tile 的 128 个 DSP 锁在一个 DSP 柱区域、line window 锁在 BRAM 柱、5 个 AXI loader 集中到 HP0 侧），整体减跨芯片布线。
3. 或评估把 rgb/tensor/tensor32/tensor48 四个 loader 统一成一个参数化 loader，减少 AXI master 数量以降低 SmartConnect 侧拥塞。

## 138 2026-09-01 OUT_LANES=16 升 80MHz 时序收敛（WNS=0.347 / WHS=0.023），bit/xsa/platform/elf 已重建

## 138 2026-09-01 OUT_LANES=16 升 80MHz 时序收敛（WNS=0.347 / WHS=0.023），bit/xsa/platform/elf 已重建

**阅读顺序：先读本节了解 80MHz 收敛结论；再读第 137 号了解 layer_mode 关键路径根因；再读第 136 号确认 60MHz 上板基线。**

### 1. 本轮真正完成的是什么

- 把 DMP 整网从 60MHz 升到 80MHz 并一次性综合/布线/出位流成功：`GESTUREFLOW_HAGRID18_DMP_7020_BITSTREAM_PASS`。
- 关键手段：新增 [`gestureflow_hagrid18_dmp_7020_timing.xdc`](../innovation_npu/board_7020/gestureflow_hagrid18_dmp_7020_timing.xdc)，对 `layer_mode` 这个准静态 AXI-Lite 配置寄存器 `set_false_path`（第 137 号已定位：它是 60MHz 最差 setup 路径，15 级组合逻辑、83% 布线）。
- 同时把整网配置从失败的 32 输出流式版回退到已验证的 `OUT_LANES=16 / ENABLE_STREAM_STORE=0`，并把 `PCW_FPGA0_PERIPHERAL_FREQMHZ` 从 60 改到 80。
- 重建了 bit、XSA、Vitis 平台、ARM ELF（四件套均为 20:10–20:12 产物）。

### 2. 根因定位/关键发现

- 去掉 layer_mode 后，80MHz 的新最差 setup 路径变成 `wdata_reg[8]/C`：数据路径 11.817ns，其中 **96.8% 是布线、0 级逻辑**。`wdata_reg` 同样是 AXI-Lite 写数据寄存器，属于准静态配置寄存器，说明 7020 上限制升频的是一族“配置寄存器长线 fanout”路径，而不是 MAC/requant 计算路径。
- 本轮 80MHz 已正裕量：WNS=+0.347ns、WHS=+0.023ns、0 条失败端点、0 条未布线 net。对比 60MHz 的 WNS=+2.063/WHS=+0.022。

### 3. 已经实际跑通的回归与构建

- `bash innovation_npu/board_7020/run_build_gestureflow_hagrid18_dmp_7020_from_wsl.sh` → `BITSTREAM_PASS`（80MHz，WNS=0.347/WHS=0.023）。
- `bash innovation_npu/board_7020/run_create_hagrid18_dmp_platform_from_wsl.sh` → `PLATFORM_PASS`。
- `bash innovation_npu/board_7020/build_software_hagrid18_dmp_from_wsl.sh` → ELF `gestureflow_hagrid18_dmp.elf`（text/data/bss 679661）。

### 4. 资源/时序变化

- 80MHz：WNS=+0.347ns、WHS=+0.023ns；未重测资源（本设计为 16 输出，预期与 60MHz 版同量级：DSP 127、RAMB36 95）。
- 预期性能：PL 总周期仍约 1.80M，@80MHz ≈ 22.5ms，PL 侧约 44 FPS；端到端约 35–40 FPS（仍需实板探针确认 frame_ticks）。

### 5. 关键坑/注意事项

- 之前多次 Vivado 构建残留了 4 个孤儿 `vivado.exe` 进程（共约 6GB 内存），会把旧 32 输出的 congestion 日志污染到新构建日志里。重新构建前必须 `taskkill /F /IM vivado.exe` 清理干净再启动，否则无法判断是旧进程还是新进程的输出。
- 80MHz 裕量偏紧（尤其 WHS=0.023ns），上板若出现偶发错帧，优先怀疑 hold，可回退 70/75MHz 验证。

### 6. 下一步操作入口

1. 实板烧录：`bash innovation_npu/board_7020/run_board_hagrid18_dmp_from_wsl.sh`（本轮 hw_server 3121 未通，板上未跑）。
2. 实板通过后，用 `PROBE[130]`（frame ticks）与 `PROBE[133]`（PL cycles）换算真实端到端 FPS。
3. 若 80MHz 实板不稳，降 70/75MHz；若稳，再考虑对 `wdata_reg` 等其余准静态配置寄存器一并 false-path 继续冲更高频率。

## 137 2026-09-01 对标 MDPI DMP 论文后的定位：OUT_LANES=32 超 7020 容量；MAC retire 拆流水已提交

## 137 2026-09-01 对标 MDPI DMP 论文后的定位：OUT_LANES=32 超 7020 容量；MAC retire 拆流水已提交

**阅读顺序：先读本节获得本轮对论文、资源瓶颈与关键路径的重新定位；再读第 136 号确认当前可上板基线；再读第 133 号非 DMP 整网基线。**

### 1. 本轮真正完成的是什么

- 通读并对照了用户指定的 MDPI 论文《An Energy-Efficient FPGA-Based CNN Accelerator with Dual-Multiply Packing and Ping-Pong Buffering for Real-Time Object Detection》（Electronics 2026, 15(11), 2442，DOI 10.3390/electronics15112442）。
- 提交 `48eb1a5 perf(dmp): split 3-term retire into 2 pipelined 32-bit adds; truncate product to 32 bits`，改动 [`gestureflow_mac_tile_dmp.sv`](../innovation_npu/rtl/gestureflow_mac_tile_dmp.sv)：
  - 原 retire 一次性计算 `accum + oct_contrib - activation_sum<<7` 的三项 32bit 加法，拆成 stage6 `accum += oct_contrib` 与 stage7 `result = accum - activation_sum<<7` 两级两项加法；stage6 同时去掉了按 output-lane 的 clock-enable 保护（`oct_contrib_ext` 已对无效 lane 清零，因此等价），减少控制集数量。
  - 把 `product_comb/product_pipe` 从 43bit 截断到真正有用的 32bit（两个 16bit DMP 部分积），缩短 DSP 输出到加法树的最宽布线。
- 提交 `6ec0207 fix: add gestureflow_stream_pool2x2 to DMP full-net package_ip sources`，补齐 `build_gestureflow_hagrid18_dmp_7020.tcl` 里缺失的流式池化源文件（否则当前 HEAD 综合会报缺模块）。

### 2. 根因定位/关键发现

#### 2.1 论文到底给了什么、没给什么

- 论文 DMP 本质就是子字打包：一个 DSP48E1 的 A 端口放 `{A, 8'b0, B}`（两个权重中间隔 8 个 0），B 端口放一个共享激活，一个 25×18 乘法同时得到 `A*C`（高 16bit）与 `B*C`（低 16bit）。这与本项目 DMP 完全同构；本项目用 `w+128 / a+128` 的无符号偏移把有符号 INT8 变成无符号子字，比论文的裸 `{A,0,B}` 对 signed weight 更稳。
- 论文另外两个卖点：多级流水加法树 + 全局 ping-pong 缓冲把权重/特征 DMA 与计算重叠；以及 MQDA（在 Add/Cat 节点对齐不同量化域）。我们的 MAC 加法树已流水，软件也已做权重乒乓预取，MQDA 只对 YOLO 的残差/拼接有意义，我们的固定小 CNN 用不到。
- 关键差异：论文跑在 Zynq-7100 @200MHz，752 个 DSP 只占 37%，资源余量巨大；我们是 Zynq-7020（220 DSP、53K LUT），不能照搬其规模，只能借鉴其“流水加法树 + 搬运/计算重叠”思路。

#### 2.2 OUT_LANES=32 整网为何布不通（本轮最硬的结论）

- 实测 OUT_LANES=32 + 流式池化的整网综合/布局结果：DSP 211/220（95.91%）、Slice 13192/13300（99.19%）、LUT 71.10%、FF 55.72%、RAMB36 91。route 阶段 congestion 导致 `Failed Nets=94812`，WHS=-0.215，无法出位流。
- 通过 60MHz OUT_LANES=16 的 DRC 日志确认：`pair_sum_low/high_pipe_reg` 被 Vivado 自动映射成 DSP48E1（用 post-adder 做 17bit 加法）。OUT_LANES=32 时 pair_sum 两级共吃掉 64 个 DSP，加上 128 个 product DSP 即 192，再加 requant/GAP-FC/FNV 等约 19 个 = 211。
- 但把 pair_sum 从 DSP 挪回 LUT carry-chain 并不救得了 32 输出：会新增约 272 个 CARRY4 slice，而当前 slice 只剩约 108 个空位，直接溢出。因此 **OUT_LANES=32 整网 DMP 在 7020 上是硬超容，不是改一两个关键路径能救回的**，后续不要再盲目重试 32 输出整网。

#### 2.3 真正的频率瓶颈（纠正第 136 号的关键路径判断）

- OUT_LANES=16 @60MHz 已上板 PASS，WNS=+2.063ns。但其最差 setup 路径**不是 MAC/requant/GAP-FC**，而是 `layer_mode_reg[2] → ... → axi_smc/.../cmd_fifo/mesg_reg/CE`：15 级组合逻辑、13.86ns 中 11.56ns（83%）是布线延时。`layer_mode`（3bit，每层只写一次）在顶层做模式选择 mux，fanout=67，一直组合连通到 loader 的 `m_axi_rready` 再进 SmartConnect。
- 因此升频 80MHz 的首要对象是这条“准静态 layer_mode → AXI 握手”的控制路径：要么把模式选择输出打寄存器，要么对这条路径加 multicycle/false-path（layer_mode 在一次 layer 执行期间不变）。

### 3. 已经实际跑通的回归

- `run_gestureflow_conv4x4_cin_same_stream_dmp_out32.sh` → `PASS outputs=2304 raw_fnv1a=07e1a22d`。
- `run_gestureflow_conv4x4_cin_same_stream_dmp_pointwise_out32.sh` → `PASS outputs=144 raw_fnv1a=32ebe166`。
- `run_gestureflow_layer_chain_hp0_postprocess_hagrid18_out32.sh` → `PASS bursts=72 cycles=4101 gap=64 fc=18 class=0`。
- `run_gestureflow_layer_chain_hp0_postprocess_hagrid18.sh`（OUT_LANES=16）→ `PASS bursts=72 cycles=4101`。
- `run_gestureflow_conv4x4_cin_same_stream_dmp_full_layer.sh` → `PASS outputs=9216 raw_fnv1a=8f1602ce cycles=387375`。

### 4. 资源/时序变化

- 本轮仅改 RTL，未重新综合（避免空耗 Vivado 时间）。retire 拆流水在功能上等价、理论上把 retire 关键路径从三项加法降到两项加法，并减少 32 个 per-lane clock-enable 控制集。

### 5. 关键坑/注意事项

- 当前 HEAD 的 TCL 若不补 `gestureflow_stream_pool2x2.sv` 会直接综合失败（缺模块），已由 `6ec0207` 修复。
- 不要用第 136 号的“6.13 倍”去推算 FPS 突破：那是拿旧的非 DMP（10.96M cycles）对比，真实非 DMP@80MHz 约 2.27M cycles，与 DMP OUT_LANES=16@60MHz（1.80M cycles）基本打平，DMP 的价值是资源（DSP 127 vs 191、BRAM 95 vs 127）而不是自动翻倍。

### 6. 下一步操作入口

1. 突破点在 **OUT_LANES=16 升 80MHz**：先解决 `layer_mode → AXI` 控制路径（打寄存器或 multicycle/false-path），预期 1.80M cycles / 80MHz ≈ 22.5ms，端到端约 35-44 FPS。
2. 恢复权重 DMA 与计算乒乓重叠（软件已有 `preload_*`，但 conv0 首载与 GAP/FC 装载仍是串行）。
3. OUT_LANES=24 可作为折中研究点，但 16/48 层不是 24 的倍数，16 输出对 16/32/48/64 通道网络反而零浪费，不建议轻易切换。

## 136 2026-09-01 DMP 8-lane 整网集成上板通过：40/60MHz 均 PASS，60MHz 约 30 FPS

**阅读顺序：先读本节了解 DMP 整网最终结论；再读第 135 号了解 DMP 权重 DMA loader；再读第 133 号了解非 DMP 整网基线。**

### 1. 本轮真正完成的是什么

- 新增整网 DMP 顶层 [`gestureflow_layer_chain_dmp_hp0_axil.sv`](../innovation_npu/rtl/gestureflow_layer_chain_dmp_hp0_axil.sv)：在复用 RGB/DDR loader、output bank、requant、GAP/FC 尾链的前提下，把卷积引擎换成 8 输入 lane 的 DMP 引擎。
- 关键架构决策：DMP 整网物理输出宽取 `OUT_LANES=16`（8 个输出 pair），而不是照搬非 DMP 的 `OUT_LANES=32`。
  - 同一时钟每周期仍退役 128 个 INT8 乘积（16 输出 × 8 输入），与非 DMP 的 32×4 等价。
  - 但 DSP 从 128 降到 64，且 output bank 宽度从 256bit 降到 128bit，整网 RAMB36 从 127 降到 95。
- 新增 DMP 权重导出 [`export_hagrid18_all_layers_dmp.sh`](../innovation_npu/tools/export_hagrid18_all_layers_dmp.sh) 与 7 层 DMP C 头；修正 [`export_dmp_conv_layer.py`](../innovation_npu/tools/export_dmp_conv_layer.py) 两个关键点：pointwise 只导出 1 tap，权重数组加 64 字节对齐。
- 新增 DMP 整网软件 [`gestureflow_hagrid18_dmp_main.c`](../innovation_npu/board_7020/software/gestureflow_hagrid18_dmp_main.c) 与完整构建/平台/烧板脚本（`build_gestureflow_hagrid18_dmp_7020.tcl`、`run_build_*`、`run_create_*`、`build_software_*`、`run_board_*`）。

### 2. 根因定位/关键发现

- 先前 4-lane DMP 兼容替换的资源阻塞根因不是 DMP 本身，而是把 `OUT_LANES` 留在 32 导致 weight bank 宽度 192bit 且 output bank 宽度 256bit 同时膨胀。改用 16 输出后：weight bank 8×3=24 个 RAMB36，output bank 减半到 56 个 RAMB36，整网 BRAM 反而大幅下降。
- DMP 权重 DMA loader 要求源地址 8 字节对齐。第一版 DMP C 头只保证 4 字节对齐，实板在 conv0 权重装载处报 `0x4D01` fault；给权重数组加 `__attribute__((aligned(64)))` 后解决。
- 顶层 aclk 的 `FREQ_HZ 80000000` 与 40MHz PS 时钟在 `validate_bd_design` 冲突；整网首版统一回到无 FREQ_HZ 的 40MHz 基线。

### 3. 已经实际跑通的回归与板级验证

- `bash innovation_npu/tests/run_gestureflow_conv4x4_cin_same_stream_dmp_out32.sh` → `PASS outputs=2304 raw_fnv1a=07e1a22d`（32 输出空间卷积引擎）。
- `bash innovation_npu/tests/run_gestureflow_conv4x4_cin_same_stream_dmp_pointwise_out32.sh` → `PASS outputs=144 raw_fnv1a=32ebe166`（48→32 点积 tile）。
- `bash innovation_npu/tests/run_gestureflow_layer_chain_dmp_body2_axil.sh` → `PASS quant_fnv1a=7e276c7b cycles=417565`（16 输出整网 body2 顶层）。
- Vivado 综合/布线/位流：40MHz 与 60MHz 均 `GESTUREFLOW_HAGRID18_DMP_7020_BITSTREAM_PASS`，DRC 0 error。
  - 40MHz：WNS=+9.187ns。
  - 60MHz：WNS=+2.063ns、WHS=+0.022ns，所有用户时序约束满足。
- 实板整网单图：40MHz 与 60MHz 均 `GESTUREFLOW_HAGRID18_DMP_FINAL_RESULT = 0x600D600D`，`BOARD_PASS`。
- 板级探针（60MHz）：`PROBE[130]=0x00AA36F5`（frame ticks 11,155,189）、`PROBE[131/132]=0x0003BE12`（权重 DMA ticks）、`PROBE[133]=0x001B8CA5`（PL 总周期 1,803,429）。

### 4. 资源/时序变化

- 资源（DMP 整网，xc7z020）：LUT 29,608；FF 48,828；RAMB36 95；RAMB18 7；DSP 127。
- 对照非 DMP 整网（第 133 号）：LUT 36,562；FF 53,808；RAMB36 127；RAMB18 26；DSP 191。
- PL 总周期 1,787,620 对照非 DMP 10,961,334，约 6.13 倍减少。
- 60MHz 下 WNS=+2.063ns，说明关键路径约 14.6ns，仍有少量升频余量（80MHz 需继续缩短关键路径）。

### 5. 关键坑/注意事项

- DMP 整网用 `OUT_LANES=16` 而非 32，这是决定能否放进 7020 的架构关键；后续不要随意改回 32。
- 软件 tile 调度随 16 输出改变：conv2a/conv2b 各 2 tile，conv3a/conv3b 各 3 tile，head 1x1 共 4 tile。
- 本轮为“同步装载权重 + 计算”的保守调度，权重 DMA 约 1ms，未与计算重叠；下一步可恢复权重预取重叠继续压端到端时间。
- DMP 权重 C 头必须保留 `__attribute__((aligned(64)))`，否则权重 DMA loader 报 fault。

### 6. 下一步操作入口

1. 端到端换算（GTC=333MHz）：40MHz 约 48.7ms / 20.5 FPS；60MHz 约 33.5ms / 29.9 FPS。当前 60MHz 单图整网基线约 30 FPS。
2. 优先恢复权重 DMA 与计算的乒乓重叠，消除同步装载的串行开销。
3. 升频到 50/60MHz 再综合（当前 WNS 有裕度），目标继续提高 FPS。
4. 若继续冲 80MHz，重点缩短 requant/GAP-FC/line-window 关键路径。

## 135 2026-09-01 DMP 权重 DMA loader 完成并通过独立回归

**阅读顺序：先读本节了解整网 DMP 集成新增的关键模块；再读第 134 号了解 4-lane compat 资源阻塞；再读第 132 号了解 DMP 80MHz 单层。**

### 1. 本轮真正完成的是什么

- 新增 [`gestureflow_hp0_weight_dma_loader_dmp.sv`](../innovation_npu/rtl/gestureflow_hp0_weight_dma_loader_dmp.sv)：从 DDR 连续读取 6 个 32bit word，组装成 DMP 需要的 192bit weight-bank word。
- 坐标输出从 `weight_write_oc` 改为 `weight_write_pair`，自动按 `OUT_LANES/2` 计算 pair 数。
- 新增回归 [`tb_gestureflow_hp0_weight_dma_loader_dmp.sv`](../innovation_npu/tests/tb_gestureflow_hp0_weight_dma_loader_dmp.sv) 与 [`run_gestureflow_hp0_weight_dma_loader_dmp.sh`](../innovation_npu/tests/run_gestureflow_hp0_weight_dma_loader_dmp.sh)。

### 2. 根因定位/关键发现

- 原 4-lane loader 是“每 32bit word 一次 bank 写”；DMP loader 必须“每 6 个 32bit word 才提交一次 192bit bank 写”。
- 需要区分 `word_fire`（消费 DDR word）和 `pack_write_valid`（提交 DMP pack），坐标只在 pack 提交时推进。
- 内部 `byte_count/4` 期望值改为 `pairs * taps * groups * 6`。

### 3. 已经实际跑通的回归

- `bash innovation_npu/tests/run_gestureflow_hp0_weight_dma_loader_dmp.sh`
- 输出：`GESTUREFLOW_WEIGHT_DMA_LOADER_PASS writes=64 bytes=1536`

### 4. 资源/时序变化

- 本轮仅 Verilator 行为验证，未做综合/布线。
- 新增模块使用类似原 loader 的 FIFO/控制结构，主要增量是 192bit pack accumulator 和 3bit pack counter。

### 5. 关键坑/注意事项

- DMP loader 的 `outputs_per_tile` 仍然表示输出 lane 数；硬件内部右移一位得到 pair 数。
- `byte_count` 必须与 6-word pack 格式匹配，否则 VALIDATE 会报 fault。

### 6. 下一步操作入口

1. 把 DMP loader 接入 DMP body2 顶层或新整网 DMP layer_chain。
2. 替换现有 `gestureflow_hp0_weight_dma_loader` 实例和软件 DMA 权重数组。
3. 生成全部 7 层 DMP 权重 C 头，继续整网集成。

## 134 2026-09-01 整网 4-lane DMP 兼容替换尝试：资源阻塞定位，主链已回退

**阅读顺序：先读本节了解为什么整网 DMP 还没有完成；再读第 133 号确认非 DMP 整网板级基线；再读第 132 号确认 DMP 80MHz 单层已上板。**

### 1. 本轮真正完成的是什么

- 尝试实现“兼容旧 4-lane 权重接口”的 DMP MAC tile，目的是不改 HaGRID18 软件就把整网所有卷积换成 DMP 硬件。
- 先通过 Verilator 验证：用该兼容 DMP tile 替换 `gestureflow_conv4x4_cin_same_stream` 后，原有 body2 full-layer 回归通过，`quant_fnv1a=893afa60`。
- 尝试重建 HaGRID18 整网位流，但在 placement 阶段失败，根因是 slice 容量不足。

### 2. 根因定位/关键发现

- 整网 4-lane DMP 兼容实现会新增双 bank 权重和、product_count、DMP 乘积/加树寄存器和相关控制集。
- Vivado placement 报告：
  - `unplaced instances require 9635 slices`
  - `available slices 9040`
  - `Flip flops: 57748`
  - `Control sets: 1133`
- 兼容 DMP 比现有非 DMP 整网多了约 5000 个 FF 和更多控制集，导致 7020 无法在 `OUT_LANES=32` 的 HaGRID18 主链中直接放下。
- 把 product 寄存器从 43bit 缩到 32bit、权重和标为 distributed RAM 后，资源报告仍没有本质改善，说明瓶颈不在单点位宽，而是整网 32 输出 DMP 的寄存器总量。

### 3. 已经实际跑通的回归

- `bash innovation_npu/tests/run_gestureflow_conv4x4_cin_full_layer.sh` 在临时兼容 DMP 替换下通过。
- 该临时替换已回退，当前工作区干净，主链保持原非 DMP 状态。

### 4. 资源/时序变化

- 临时兼容 DMP 的 placement 失败，未生成最终位流；没有可用资源/时序签核。
- 已确认直接 4-lane 兼容替换不是正确的整网集成路线。

### 5. 关键坑/注意事项

- 不要继续在 `OUT_LANES=32` 整网上强行塞 4-lane DMP compat；必须从软件/权重格式一起改，走 8-lane DMP 或降低物理输出并行度。
- 兼容 DMP 虽然功能正确，但资源代价不成立，不要作为论文路线。

### 6. 下一步操作入口

1. 走真正的 8-lane DMP 整网集成，而不是 4-lane compat。
2. 修改 `gestureflow_layer_chain_hp0_axil` 的 conv 数据通路和权重 DMA loader，配套更新 `gestureflow_hagrid18_main.c` 与权重导出工具。
3. 先在 Verilator 中完成全部 7 层 DMP 整网 FNV 对账。
4. 再重建 HaGRID18 DMP 位流和 ELF，烧板比较整网周期/FPS。

## 133 2026-09-01 HaGRID18 整网单图实板复验通过：FINAL_RESULT=0x600D600D

**阅读顺序：先读本节确认整网板级结果；再读第 132 号了解 DMP 80MHz 单层；再读第 131 号了解 DMP 首板。**

### 1. 本轮真正完成的是什么

- 直接运行现有 HaGRID18 整网板级入口 [`run_board_hagrid18_from_wsl.sh`](../innovation_npu/board_7020/run_board_hagrid18_from_wsl.sh)，用单张模拟摄像头 RGB 图驱动完整静态手势识别算法。
- 推理链覆盖：`RGB(96×96×3) → conv0 → body conv → pool → conv2a/2b → pool2 → conv3a/3b → pool3 → head1x1 → GAP → FC(18) → class`。
- 每层输出均有 FNV 校验，最终 `FINAL_RESULT=0x600D600D`，分类和 FC 结果一致。

### 2. 根因定位/关键发现

- 现有 HaGRID18 软件已经是“单张输入图、自动跑完整网络”的板级形态；从板测角度看不需要用户逐层调度，PS 侧按 descriptor/doorbell 顺序下发，PL 侧完成逐层计算和 DDR 数据搬运。
- 实板探针 `PROBE[130]=0x00A741B6`、`PROBE[133]=0x0022B033` 提供整网耗时/周期观测；后续做 DMP 整网替换时应以这两个探针为基线比较。

### 3. 已经实际跑通的板级验证

- `bash innovation_npu/board_7020/run_board_hagrid18_from_wsl.sh`
- 输出：
  - `GESTUREFLOW_HAGRID18_FINAL_RESULT = 0x600D600D`
  - `GESTUREFLOW_HAGRID18_PROBE[00] = 0x600D600D`
  - `GESTUREFLOW_HAGRID18_PROBE[130] = 0x00A741B6`
  - `GESTUREFLOW_HAGRID18_PROBE[131] = 0x0001F7EE`
  - `GESTUREFLOW_HAGRID18_PROBE[132] = 0x0001F7EE`
  - `GESTUREFLOW_HAGRID18_PROBE[133] = 0x0022B033`
  - `GESTUREFLOW_HAGRID18_BOARD_PASS`

### 4. 资源/时序变化

- 本轮未修改 RTL/软件，未重新综合布线；直接使用当前 HaGRID18 板级产物。
- 当前整网主线仍是非 DMP MAC 主链；DMP 80MHz 独立 body2 层已在第 132 号记录验证通过。

### 5. 关键坑/注意事项

- 整网板测和 DMP 独立层板测是两个不同工程：
  - HaGRID18 整网：`gestureflow_hagrid18_7020_v1`
  - DMP body2 独立：`gestureflow_body2_dmp_7020_v1`
- 下一步若替换整网 MAC，必须同步更新权重导出格式和 PS 软件，不能只换 RTL。

### 6. 下一步操作入口

1. 以当前 HaGRID18 整网 `PROBE[130]/[133]` 为基线，建立整网 FPS 比较表。
2. 把 DMP 8-lane 引擎接入 `gestureflow_layer_chain_hp0_axil`，先替换 body 层，再做全链 Verilator FNV 对账。
3. 全链仿真通过后，重建 HaGRID18 DMP 位流和 ELF，烧板复验 `FINAL_RESULT=0x600D600D`，并比较整网周期。
4. 最终目标：单张图输入、整网 DMP 自动跑完，实板周期和 FPS 明显优于当前非 DMP 基线。

## 132 2026-09-01 DMP body2 升频 80MHz：时序闭合 + 实板再次通过

**阅读顺序：先读本节确认 80MHz DMP 已经上板通过；再读第 131 号了解 25MHz 首板结果；再读 [DMP 设计文档](GestureFlow_DMP双乘打包_质的飞跃_2026-09-01.md)。**

### 1. 本轮真正完成的是什么

- 把独立 DMP body2 工程从 25MHz 升到 **80MHz**。
- 修改 [`gestureflow_mac_tile_dmp.sv`](../innovation_npu/rtl/gestureflow_mac_tile_dmp.sv)：把共享激活修正项 `activation_sum` 从“当拍 8 输入加法 + 32 bit 累加”拆成一级流水——先寄存 8-lane 激活分组和，再更新 32 bit 累加器，切断 `held_window → activation_sum` 的 23 级 carry-chain 关键路径。
- 修改 DMP 顶层 `FREQ_HZ` 为 80MHz，构建脚本默认 FCLK=80MHz，并支持 `GESTUREFLOW_BODY2_DMP_FCLK_MHZ` 覆盖。
- 80MHz 时序闭合后，用新位流和新 XSA 再次烧板，结果仍为 `0x600D600D`。

### 2. 根因定位/关键发现

- 第一次 80MHz 布线时序 `WNS=-0.040ns、3 个 setup 违例`，最差路径是 `held_window_reg[8][12][1]/C → mac_tile/activation_sum_reg[24]/D`，Data Path Delay 12.390ns，23 级 logic。
- 根因是 DMP 的共享修正项 `activation_sum` 在同一拍完成“8 个有符号激活求和 + 32 bit 累加”，与窗口寄存器直接组合，形成长 carry chain。
- 把 `activation_group_sum` 后移一级并寄存后，功能不变；80MHz 时序从 `-0.040ns` 改善到 **`+0.844ns`**，0 setup 违例、0 hold 违例。
- Verilator 回归证明该流水改动没有破坏数值：DMP MAC、out16、full-layer 全部通过。

### 3. 已经实际跑通的回归

- `bash innovation_npu/tests/run_gestureflow_mac_tile_dmp.sh` 通过。
- `bash innovation_npu/tests/run_gestureflow_mac_tile_dmp_out16.sh` 通过。
- `bash innovation_npu/tests/run_gestureflow_conv4x4_cin_same_stream_dmp_full_layer.sh` 通过，`raw_fnv1a=8f1602ce`。
- 80MHz Vivado 构建：`GESTUREFLOW_BODY2_DMP_7020_BITSTREAM_PASS`
  - 时序：`All user specified timing constraints are met.`
  - Setup: 0 failing endpoints，Worst Slack **+0.844ns**
  - Hold: 0 failing endpoints，Worst Slack **+0.060ns**
- 80MHz 实板：`GESTUREFLOW_BODY2_DMP_BOARD_PASS`
  - `FINAL_RESULT=0x600D600D`
  - `PROBE[08]=0x7E276C7B`
  - `PROBE[05]=0x0005C92D`（约 379,? cycles，具体为 0x5C92D）

### 4. 资源/时序变化

- 时序：25MHz 时 setup slack 20.672ns；80MHz 优化后 setup slack **+0.844ns**。
- 资源变化：增加少量 `activation_group_sum` 流水寄存器，没有增加 DSP/BRAM 类别。
- 仍有 Vivado `MREG=0` 的 DSP 流水化建议警告，当前不影响 80MHz 闭合，但更高频率或全链集成前需要继续处理。

### 5. 关键坑/注意事项

- DMP 的 `activation_sum` 不能为了省一拍而和窗口选择逻辑直接组合，否则在 80MHz 会成为第一关键路径。
- 流水化 `activation_sum` 后，累加更新相对 mac 组晚一拍，但最终结果退休前仍包含所有组；不要误以为必须与 mac_valid 同拍累加。
- 烧板时 XSA/bit 与 ELF 必须来自同一工程；80MHz 位流使用新的 `ps7_init.tcl`，不能用旧的 25MHz XSA。

### 6. 下一步操作入口

1. 在 80MHz DMP 独立层链基础上，继续测量纯 PL 周期和端到端墙钟，做单层吞吐对比。
2. 处理 DSP `MREG/PREG` 流水化警告，为 100MHz 或全链集成创造更大裕度。
3. 导出并上板验证 conv2a/conv2b/conv3a/conv3b/head1x1 DMP 层。
4. 覆盖 conv0 的 3→16 输入补零路径。
5. 接入主 `gestureflow_layer_chain_hp0_axil`，完成整网 DMP 上板。

## 131 2026-09-01 DMP body2 实板验证通过：FINAL_RESULT=0x600D600D，hash=0x7E276C7B

**阅读顺序：先读本节确认 DMP 已经真实上板；再读第 130 号了解整层行为验证；再读 [DMP 设计文档](GestureFlow_DMP双乘打包_质的飞跃_2026-09-01.md)。**

### 1. 本轮真正完成的是什么

- 新增独立板级 DMP 层链 [`gestureflow_body2_dmp_hp0_axil.sv`](../innovation_npu/rtl/gestureflow_body2_dmp_hp0_axil.sv)：把 DMP 8-lane 流引擎接到 HP0 DDR 读取和 requant 输出，AXI-Lite 负责 6×32 bit DMP 权重字装配。
- 新增软件 [`gestureflow_body2_dmp_main.c`](../innovation_npu/board_7020/software/gestureflow_body2_dmp_main.c)：从 `gestureflow_chain_body_data.h` 取真实 body2 输入/requant/FNV，从 `gestureflow_dmp_body2_layer.h` 取 DMP 打包权重与折叠 bias。
- 新增 DMP 专用 Vivado 构建、软件编译和 XSCT 烧板脚本，形成可复现的独立板级验证链。
- **实板验证通过**：`FINAL_RESULT=0x600D600D`，`PROBE[08]=0x7E276C7B`，`PROBE[05]=0x0005C87F`（约 379007 cycles）。

### 2. 根因定位/关键发现

- 第一次上板失败（`FINAL_RESULT=0xBAD0BAD0`，hash 错误）不是 RTL 或 Vivado 时序问题，而是软件错误地 include 了旧 body2 头文件 `gestureflow_real_conv4x4_body2_layer.h`。该头文件 FNV 为 `0x893AFA60`，与当前 DMP body2 golden 的 `0x7E276C7B` 不是同一层数据。
- 当前 body2 正确头文件是 [`gestureflow_chain_body_data.h`](../innovation_npu/board_7020/software/gestureflow_chain_body_data.h)，其 `GF_BODY2_RAW_FNV1A=0x8F1602CE`、`GF_BODY2_OUTPUT_FNV1A=0x7E276C7B`，与 DMP full-layer golden 完全一致。
- 另一次失败来自 DMP 权重 C 头文件用了旧 `int8_unsigned` 二补码实现；重新用修正后的 `export_dmp_conv_layer.py` 导出后才正确。

### 3. 已经实际跑通的板级/构建验证

- Vivado 构建：`GESTUREFLOW_BODY2_DMP_7020_BITSTREAM_PASS`
  - 项目：`E:\coralnpu_vivado\projects\gestureflow_body2_dmp_7020_v1`
  - 位流：`logs/gestureflow_body2_dmp_7020.bit`
  - XSA：`logs/gestureflow_body2_dmp_7020.xsa`
- 时序：25 MHz，`All user specified timing constraints are met.`
  - Setup: 0 failing endpoints，Worst Slack **20.672 ns**
  - Hold: 0 failing endpoints，Worst Slack **0.039 ns**
- 软件 ELF：`vitis/axi_gpio/Debug/gestureflow_body2_dmp.elf`
- 实板：`GESTUREFLOW_BODY2_DMP_BOARD_PASS`
  - `FINAL_RESULT=0x600D600D`
  - `PROBE[08]=0x7E276C7B`
  - `PROBE[05]=0x0005C87F`

### 4. 资源/时序变化

- 本轮为独立 DMP body2 单层工程，仅使用 25 MHz 先保证功能正确。DMP 合成成功，DSP 乘法器报告大量 `MREG=0` 建议流水化警告，但不影响当前功能。
- 后续要上 80 MHz 时，必须优先处理 DSP `MREG`/`PREG` 流水化警告，并把 DMP 加树和权重 bank 读口作为关键路径评估。

### 5. 关键坑/注意事项

- 板级软件不能混用旧 `gestureflow_real_conv4x4_body2_layer.h` 和当前 `gestureflow_chain_body_data.h`；两者虽然都是 body 层，但对应不同导出批次，FNV 不同。
- DMP 权重 C 头文件必须使用修复后的 `export_dmp_conv_layer.py` 重新生成，否则 `int8_unsigned` 错误会导致实板 hash 全错。
- 烧板脚本用 hw_server 端口 `3121`，不是旧脚本里的 `3334`。

### 6. 下一步操作入口

1. 在 DMP body2 独立工程上逐步升频，先补 DSP `MREG/PREG` 流水，再试 40/50/80 MHz。
2. 导出 conv2a/conv2b/conv3a/conv3b/head1x1 的 DMP C 头，并逐步做独立层实板对账。
3. 覆盖 conv0 3→16 的输入通道补零路径。
4. 把 DMP 引擎接入主 layer_chain，替换当前非 DMP MAC tile，完成整网上板。

## 130 2026-09-01 DMP 真实 body2 整层对账通过：96×96×16 全向量 FNV + 探针匹配

**阅读顺序：先读本节确认 DMP 已通过真实模型整层行为验证；再读第 129 号了解 DMP 软件导出工具；再读 [DMP 设计文档](GestureFlow_DMP双乘打包_质的飞跃_2026-09-01.md)。**

### 1. 本轮真正完成的是什么

- 新增 [`export_dmp_conv_golden.py`](../innovation_npu/tools/export_dmp_conv_golden.py)：从真实 TFLite 层导出 DMP 整层 golden，包括真实 layer input、DMP-packed weights、folded bias、raw FNV 和 7 个探针向量。
- 生成 [`generated_gestureflow_dmp_body2_golden.svh`](../innovation_npu/tests/generated_gestureflow_dmp_body2_golden.svh)：真实 body2 层 `16×96×96 → 16×96×96`。
- 新增 DMP 全层回归 [`tb_gestureflow_conv4x4_cin_same_stream_dmp_full_layer.sv`](../innovation_npu/tests/tb_gestureflow_conv4x4_cin_same_stream_dmp_full_layer.sv) 与 [`run_gestureflow_conv4x4_cin_same_stream_dmp_full_layer.sh`](../innovation_npu/tests/run_gestureflow_conv4x4_cin_same_stream_dmp_full_layer.sh)。
- 补齐两个针对性回归：16 输出 lane DMP MAC（`out16`）和 16 输入通道、4×4、两 group 的小尺寸流引擎（`k4_c16`），用于隔离宽输出/双 group 问题。

### 2. 根因定位/关键发现

- 第一版全层 DMP 失败，`output(0,0,oc0)=got -50390 expected 2090`。逐层定位后确认**不是 RTL 错误**，而是 Python 导出工具的符号偏移写错：`int8_unsigned` 原先用 `np.uint8(np.int8(value))` 做二补码重解释，但 RTL 实际执行的是 `w + 128`（即 `w XOR 0x80` 的数值语义）。例如 `-6` 应为 `122(0x7A)`，旧工具却输出 `250(0xFA)`。
- 修复工具后，DMP 权重 product 与 TFLite raw 完全一致，说明硬件端 DMP 打包、高低 16 bit 分离、三级加树、激活共享修正和 bias 折叠均已正确。
- 新增的 `k4_c16` 小尺寸回归证明 `INPUT_GROUPS=2`、`KERNEL_SIZE=4` 不是失败根因；`out16` 回归证明 `OUT_LANES=16` 的 pair 寻址也正确。

### 3. 已经实际跑通的回归

- `bash innovation_npu/tests/run_gestureflow_conv4x4_cin_same_stream_dmp_full_layer.sh`
- 输出：
  - `GESTUREFLOW_CONV4X4_CIN_SAME_STREAM_DMP_FULL_LAYER_PASS outputs=9216 probes=7 raw_fnv1a=8f1602ce`
  - `GESTUREFLOW_CONV4X4_CIN_SAME_STREAM_DMP_FULL_LAYER_CYCLES=378159`
- `bash innovation_npu/tests/run_gestureflow_mac_tile_dmp_out16.sh` 通过。
- `bash innovation_npu/tests/run_gestureflow_conv4x4_cin_same_stream_dmp_k4_c16.sh` 通过。
- `python3 innovation_npu/tools/export_dmp_conv_golden.py ... --conv-index 1 --tag body2 ...` 生成成功，`raw_fnv=0x8F1602CE`。

### 4. 资源/时序变化

- 本轮只做 Verilator 行为验证和 Python golden 生成，**尚未做 Vivado 综合、OOC 或整网布线**。
- 行为级周期数：DMP body2 单层 `378159 cycles`；与现有非 DMP 引擎相比，DMP 8 lane 路径的输入通道时间步减半，后续可进一步对比 OOC/布线后的实际周期。

### 5. 关键坑/注意事项

- 任何“INT8 无符号偏移”实现都必须统一为数值 `value + 128`，不能用 `np.uint8(np.int8(value))` 做二补码重解释；RTL 的 `activation ^ 8'h80` 与 Python 的 `value + 128` 才是同一语义。
- `export_dmp_conv_golden.py` 目前只支持真实输入通道能被 8 整除的层；conv0（3 通道）还需先补零到 8 通道并屏蔽高位 lane。
- 生成文件 `generated_gestureflow_dmp_body2_golden.svh` 较大（约 1.5 MB），必须随仓库提交，否则 DMP 全层回归无法复现。

### 6. 下一步操作入口

1. 把 conv0 的 3→16 层补零到 8 输入 lane，生成 DMP golden 并做首层全层对账。
2. 导出 conv2a/conv2b/conv3a/conv3b/head1x1 的 DMP golden，逐步覆盖整网 7 层。
3. 新增 DMP 专用 weight DMA loader，把 6×32 bit 打包字写进 192 bit weight bank。
4. 在完整层链中替换 DMP 引擎前，先对 DMP weight bank 与流引擎做 OOC 综合/时序评估。

## 129 2026-09-01 DMP 软件数据链路闭环：权重导出/bias 折叠工具 + pointwise 路径回归

**阅读顺序：先读本节确认 DMP 已具备可复现的软件数据链路；再读第 128 号了解 8-lane 空间流引擎；再读 [DMP 设计文档](GestureFlow_DMP双乘打包_质的飞跃_2026-09-01.md)。**

### 1. 本轮真正完成的是什么

- 新增 DMP 权重导出与 bias 折叠工具 [`export_dmp_conv_layer.py`](../innovation_npu/tools/export_dmp_conv_layer.py)。
- 工具从 TFLite `CONV_2D` 提取权重/bias，自动把真实输入通道补到 8 的倍数，按“两个输出通道一组”打包为 24 bit DSP A 操作数，并把 `-(input_zp + 128)*sum(w) - 16384*N` 折叠进 INT32 bias。
- 输出 C 头文件和 SVH 头文件，分别给出 `gf_dmp_*_weights_dma` 与 `gf_dmp_*_folded_bias`，可直接供后续 DMP 层链软件/DMA 使用。
- 新增 pointwise 回归 [`tb_gestureflow_conv4x4_cin_same_stream_dmp_pointwise.sv`](../innovation_npu/tests/tb_gestureflow_conv4x4_cin_same_stream_dmp_pointwise.sv) 与 [`run_gestureflow_conv4x4_cin_same_stream_dmp_pointwise.sh`](../innovation_npu/tests/run_gestureflow_conv4x4_cin_same_stream_dmp_pointwise.sh)：4×4×8 输入、4 输出通道、1×1 路径，对全部 16 个输出位置做逐点比较。

### 2. 根因定位/关键发现

- 现网卷积引擎的数据输入是量化值 `q`，不是 `q - input_zp`。因此 DMP 的 bias 折叠不能只扣 `128*sum(w)`，必须扣 `(input_zp + 128)*sum(w)`；工具内部用随机数据显式证明该恒等式后才会写文件。
- DMP 权重 bank 是 192 bit 字，导出工具把 8 个 24 bit 分量按连续 bit 打包进 6 个 32 bit DMA word；这里必须处理 24 bit 跨 32 bit 字边界，否则后续 DMA 写口会错位。
- 1×1 pointwise 在 DMP 流引擎中仍使用 `tap=0`，而不是旧主链中心 tap=5；导出工具和引擎已统一为 `tap=0`，后续接层链时必须保持这个约定。
- conv0 真实输入只有 3 通道，工具会补到 8 通道；DMP 引擎的 `input_lane_enable` 低 3 bit 有效，新增的 padding 权重为零，因此不改变数学结果。

### 3. 已经实际跑通的回归

- `bash innovation_npu/tests/run_gestureflow_conv4x4_cin_same_stream_dmp_pointwise.sh`
- 输出：`GESTUREFLOW_CONV4X4_CIN_SAME_STREAM_DMP_POINTWISE_PASS outputs=16`
- 工具在真实 18 类学生模型 conv0 上运行：
  - `DMP export PASS conv_index=0 oc=16 taps=16 cin=3 padded_cin=8 pairs=8 words=768 input_zp=-128`
  - C/SVH 生成成功，随机数据 DMP 恒等式校验通过。

### 4. 资源/时序变化

- 本轮只做 Verilator 行为验证和 Python 数据生成，**尚未做 Vivado 综合、OOC 或整网布线**。
- 导出工具不改变 RTL 资源；DMP 权重 bank 的 192 bit 字宽已在第 128 号记录中说明，仍需后续 OOC 单独评估。

### 5. 关键坑/注意事项

- `export_dmp_conv_layer.py` 只负责权重/bias 数据链，不会自动替换当前主链；主链软件仍使用旧的 4-lane 权重格式。
- 后续接入层链时，`weight_write_data` 的 6 个 32 bit word 顺序必须与工具输出的低地址在前顺序完全一致，否则权重 bank 内容会整体错位。
- 当前 DMP 引擎参数要求 `INPUT_CHANNELS` 为 8 的倍数、`OUT_LANES` 为偶数；conv0 等非 8 通道层必须由工具补零并通过 `input_lane_enable` 屏蔽。

### 6. 下一步操作入口

1. 用工具导出 7 个卷积层的 DMP 权重/bias，检查每个层的 `N` 与 bias 折叠范围。
2. 把 DMP 权重 bank 读写口接到现有 `gestureflow_hp0_weight_dma_loader.sv` 或新增 DMP 专用 DMA loader，先做 Verilator 单层对账。
3. 对 DMP 流引擎 + 192 bit 权重 bank 做独立 OOC 综合/时序评估。
4. 再决定是否把 DMP 引擎替换进 `gestureflow_layer_chain_hp0_axil.sv` 并整网布线/上板。

## 128 2026-09-01 DMP 8 输入 lane 流式卷积引擎落地：完整 SAME 卷积逐点对账

**阅读顺序：先读本节确认 DMP 已从独立 MAC 推进到流式卷积；再读第 127 号了解 DMP 打包数学与核心验证；再读 [DMP 设计文档](GestureFlow_DMP双乘打包_质的飞跃_2026-09-01.md)。**

### 1. 本轮真正完成的是什么

- 新增 [`gestureflow_conv4x4_cin_same_stream_dmp.sv`](../innovation_npu/rtl/gestureflow_conv4x4_cin_same_stream_dmp.sv)：8 输入 lane 的 `4x4 SAME` 流式卷积引擎，复用现有行缓存/滑窗，但 MAC 后端换成 DMP tile，`ic_group` 步长从 4 改为 8。
- 该引擎同时保留 `pointwise_mode` 的 1×1 路径，因此后续可同时服务空间卷积与 pointwise 卷积。
- 新增 [`tb_gestureflow_conv4x4_cin_same_stream_dmp.sv`](../innovation_npu/tests/tb_gestureflow_conv4x4_cin_same_stream_dmp.sv) 与 [`run_gestureflow_conv4x4_cin_same_stream_dmp.sh`](../innovation_npu/tests/run_gestureflow_conv4x4_cin_same_stream_dmp.sh)：使用 5×5×8 输入、4 输出通道、3×3 SAME 卷积，对全部 25 个输出位置的全部 4 个通道做逐点比较。

### 2. 根因定位/关键发现

- DMP 集成到流式卷积时不需要改变行缓存/滑窗时序，只改变 `tile_activation` 的 8 lane 取数索引和 `ic_group` 的 8 通道步长。
- 当前 `gestureflow_mac_tile_dmp.sv` 的加树固定按 8 输入 lane 设计（`8→4→2→1`），因此 DMP 流引擎必须使用 8 输入 lane；4 lane 变体不能直接复用当前 DMP tile。
- 参考模型直接计算 `window_value * weight + bias`，而 DUT 使用折叠后的 `bias'` 和共享激活修正，最终对账通过说明“打包乘积 + bias 折叠 + 激活修正”这一整条数学链在流式场景中仍保持位精确。

### 3. 已经实际跑通的回归

- `bash innovation_npu/tests/run_gestureflow_conv4x4_cin_same_stream_dmp.sh`
- 输出：`GESTUREFLOW_CONV4X4_CIN_SAME_STREAM_DMP_PASS outputs=25`
- `output_count=25`，`frame_input_done_seen=1`，`protocol_error=0`，全部输出向量无逐点差异。

### 4. 资源/时序变化

- 本轮只做 Verilator 行为验证，**尚未做 Vivado 综合、OOC 或整网布线**。
- 预期吞吐收益：同等 DSP 数量下，输入通道时间步减半；`32 输出 × 8 输入` 每拍 256 个逻辑乘积，比 `32 输出 × 4 输入` 的 128 个逻辑乘积翻倍。
- 新增 BRAM 字宽：DMP 权重 bank 每个 pair/tap/ic_group 存 `8×24 bit`，相比原 `4×8 bit` 更宽；需要在整网集成前单独评估 BRAM 资源占用与布局压力。

### 5. 关键坑/注意事项

- `gestureflow_conv4x4_cin_same_stream_dmp.sv` 是独立研究模块，**尚未接入主链**，不影响当前 80MHz 实板主线。
- DMP 权重格式与现有主链不同：一个写端口写的是两个输出通道在 8 个输入 lane 上的 24 bit 打包字；必须配套修改导出工具。
- `INPUT_CHANNELS` 必须能被 8 整除，`OUT_LANES` 必须为偶数；当前 DMP tile 只针对 8 输入 lane 实现。

### 6. 下一步操作入口

1. 给 DMP 流引擎增加 pointwise 小尺寸回归，证明 1×1 路径在 8 lane 下同样对账。
2. 修改权重导出工具，输出 DMP 打包字与折叠后的 `bias'`，并生成 8-lane golden。
3. 对 DMP 流引擎做独立 OOC 综合/时序评估，重点看 192 bit 权重 bank 读口与 25×18 DSP 路径在 80MHz 下的时序。
4. 只有 OOC 时序干净后，才把 DMP 引擎替换进 `gestureflow_layer_chain_hp0_axil.sv` 并做整网布线/上板。
5. 继续叠加激活稀疏门控/事件驱动，形成“双乘 + 稀疏”的复合创新点。

## 127 2026-09-01 DMP 双乘打包 MAC 核心落地：每个 DSP48E1 每拍完成两个 INT8 乘积

**阅读顺序：先读本节确认 DMP 核心已完成位精确验证；再读 [DMP 设计文档](GestureFlow_DMP双乘打包_质的飞跃_2026-09-01.md) 理解数学与架构收益；再读第 126 号了解 80MHz/100MHz 频率边界。**

### 1. 本轮真正完成的是什么

- 新增独立 DMP 计算核心 [`gestureflow_mac_tile_dmp.sv`](../innovation_npu/rtl/gestureflow_mac_tile_dmp.sv)：两个输出通道的偏移权重按 **16 bit 间距**打包进 DSP48E1 的 25 bit A 端口，一个偏移激活放入 18 bit B 端口，单拍得到一个低 16 bit 乘积和一个高 16 bit 乘积。
- 硬件内部完成：`a' = a XOR 0x80`、`w' = w + 128` 的符号偏移；高低 16 bit 分离；`8→4→2→1` 三级注册加树；每输出通道独立 INT32 累加；结果退休时统一减去共享修正项 `128 * sum(a)`。
- 每通道权重修正 `-128*sum(w)` 和常数项 `-16384*N` 被设计为在导出工具中折叠进 `bias'`，因此 DMP 路径不会增加每输出通道的独立修正硬件。
- 新增回归 [`tb_gestureflow_mac_tile_dmp.sv`](../innovation_npu/tests/tb_gestureflow_mac_tile_dmp.sv) 与 [`run_gestureflow_mac_tile_dmp.sh`](../innovation_npu/tests/run_gestureflow_mac_tile_dmp.sh)：用 64 bit 朴素有符号 INT8 参考模型证明 4 输出通道、8 输入 lane、3 tap、2 ic group 全组合下 DMP 硬件结果**位精确一致**。

### 2. 根因定位/关键发现

- DMP 打包的关键不是 8 bit 间距，而是 **16 bit 间距**：无符号 8×8 乘积最大为 `0xFE01`，恰好小于 `2^16`，所以两个积在 32 bit 结果中不会发生进位串扰。若用 8 bit 间距会必然串扰。
- 有符号卷积展开后出现三个修正项，其中两个只依赖权重、可折叠进 `bias'`；只剩 `-128*sum(a)` 是所有输出通道共享的单一值，只需一个额外 INT32 累加器，不会随输出并行度增加而放大。
- 资源收益不是“增加 DSP”，而是**同数量 DSP 的 MAC 吞吐翻倍**：同样 128 个 DSP 可从 `32 输出×4 输入`（128 乘积/拍）升级为 `32 输出×8 输入`（256 乘积/拍）；或在同样吞吐下把 MAC DSP 减半。
- 关键实现坑：`activation_sum` 不能在一个 `for` 循环里用多个 nonblocking 对同一寄存器累加，否则只剩最后一次赋值；改为先组合逻辑求 `activation_group_sum`，再在每个被接受组做一次寄存器累加。
- 关键实现坑：最终组到达累加级时，`accum` 的 nonblocking 更新和 `result_psum` 计算发生在同一拍，`result_psum` 必须显式加当前组的 `oct_contrib_ext`，不能只读旧 `accum`。

### 3. 已经实际跑通的回归

- `bash innovation_npu/tests/run_gestureflow_mac_tile_dmp.sh`
- 输出：`GESTUREFLOW_MAC_TILE_DMP_PASS psum=223,-590,178,16`
- 参考模型与 DUT 四个输出通道全部一致，`result_lane_enable=1111`，`protocol_error=0`。

### 4. 资源/时序变化

- 本轮只做 Verilator 行为验证，**尚未做 Vivado 综合、OOC 或整网布线**。
- 预期 DSP 效率：每个 25×18 DSP 槽位由 1 个 INT8 乘积提升为 2 个；MAC 阵列 DSP 需求在同等输出/输入通道吞吐下减半。
- 下一步整网集成前必须先对 DMP 核心单独做 OOC 时序评估，确认 25×18 打包乘加和三级加树在 80MHz 下不产生新关键路径。

### 5. 关键坑/注意事项

- 权重存储格式发生变化：每个 `weight_write_data` 是 `INPUT_LANES×24` bit 的打包字，其中每个 24 bit 分量为 `{w_odd_offset[7:0], 8'b0, w_even_offset[7:0]}`；这不是当前 `gestureflow_mac_tile.sv` 的 `INPUT_LANES×8` 逐 lane 格式。
- 导出工具必须同时生成：打包权重、折叠后的 `bias'`；否则硬件结果与 TFLite golden 不对齐。
- `gestureflow_mac_tile_dmp.sv` 是独立研究核心，尚未替换主链中的 `gestureflow_mac_tile.sv`，当前主线上板链路不受影响。

### 6. 下一步操作入口

1. 对 DMP 核心做独立 OOC 综合/时序评估，确认 `25×18` 打包乘 + 三级加树在 80MHz 目标下无违例。
2. 修改权重导出工具：按“两个输出通道一组”输出 DMP 打包字，并生成折叠后的 `bias'`。
3. 新建 `gestureflow_conv4x4_cin_same_stream_dmp.sv`：输入 lane 从 4 扩到 8，`ic_group` 步长 4→8，替换 `gestureflow_mac_tile.sv` 为 DMP 版本。
4. 先跑 DMP 卷积整层 FNV/golden 对账，再考虑顶层 `layer_chain` 替换与整网布线。
5. 后续把 DMP 与激活稀疏门控、事件驱动组合，形成“稀疏 + 双乘”的复合论文创新点。

## 126 2026-08-31 参数 bank 乒乓（bias/requant 配置与计算重叠）+ 100MHz 可行性结论

**阅读顺序：先读本节了解参数乒乓与频率上限结论；再读第 125 号了解时序收敛；再读第 124 号了解权重乒乓。**

### 1. 本轮真正完成的是什么

- 实现**参数 bank 乒乓**：把 bias/requant 的 AXI-Lite 配置写也重叠到上一层的计算期间，与权重乒乓形成完整的"权重+参数"预载。
- 硬件 [`gestureflow_layer_chain_hp0_axil.sv`](../innovation_npu/rtl/gestureflow_layer_chain_hp0_axil.sv)：BDATA/RQMULT/RQSHIFT 改为只写 `bias_bank/requant_*_bank[param_bank_select]`（不再写 active 寄存器），CONTROL 启动时把 active `bias/requant_multiplier/requant_right_shift` 从该 bank 一次性装载；放开 BIDX/BDATA/RQIDX/RQMULT/RQSHIFT/PARAM_BANK_SELECT 的 `running` 门控。
- 软件 [`gestureflow_hagrid18_main.c`](../innovation_npu/board_7020/software/gestureflow_hagrid18_main.c)：把 tile 配置拆成 `config_tile_control`（LAYER_MODE/QCFG/OUTPUT_LANE_MASK，launch 前串行，未 banked）和 `config_tile_params`（bias/requant，上一 tile 计算期间写 bank）。
- 实板验证：`FINAL_RESULT=0x600D600D`，`PROBE[130]=0x00A139C4`（约 31.70ms / 31.55 FPS）。

### 2. 根因定位/关键发现

- 第一次参数乒乓板测失败（STATUS=0x06，仅 `fault` 无 protocol/quant）：我把 `config_conv_tile` 整体移到计算期间，但它内部写 `LAYER_MODE/QCFG/OUTPUT_LANE_MASK` 仍被 `!running` 门控，触发非法写。修复：**未 banked 的全局控制字（mode/零点/掩码）必须 idle 时写，只有已 banked 的 bias/requant 才能重叠**。
- **100MHz 不可行**：OOC 快速综合（周期 10.0ns）结果 `WNS=-0.987ns、55 个违例端点、TNS=-40.3ns`，最差路径为 `dma_pixels_reg → store/FSM_onehot_state_reg/CE`（控制路径）。综合 WNS 已为负，布线后只会更差，故 80MHz 是本设计的实际频率上限。90MHz 也需把关键路径缩短约 1.3ns，属于结构性大改。
- 参数乒乓的端到端增益较小：bias/requant 配置约 160 次 AXI-Lite 写/ tile，重叠后省约 0.3~0.7ms，但单次 `frame_ticks` 波动约 ±0.8ms，增益被波动掩盖。

### 3. 已经实际跑通的回归

- `bash innovation_npu/tests/run_gestureflow_layer_chain_hp0_postprocess_hagrid18_out32.sh` 通过（mode-4 回归，`gap=64 fc=18 class=0`）。
- `bash innovation_npu/board_7020/build_software_hagrid18_from_wsl.sh` 编译通过。
- 80MHz 整网布线时序签核：`Setup 0 Failing, WNS +0.132ns`；`Hold 0 Failing, +0.011ns`。
- 实板：`FINAL_RESULT=0x600D600D`。

### 4. 资源/时序变化

- 时序：WNS +0.069ns → **+0.132ns**（本版布线略好，仍收敛）。Hold +0.011ns。
- 资源：active bias/requant 在 CONTROL 启动时的一次性装载是 32 个 2 选 1 mux + 寄存器，无 DSP/BRAM 增量。

### 5. 关键坑/注意事项

- 参数乒乓只重叠 **bias/requant 的 banked 写**；`LAYER_MODE/QCFG/OUTPUT_LANE_MASK` 未 banked、受 `!running` 门控，必须 launch 前串行写。
- `PARAM_BANK_SELECT` 现可在 running 期间写；`load_gap_fc_descriptor` 的 FC bias/requant 仍走同一 banked 路径，靠 CONTROL 启动时的装载读回，功能正确。
- 100MHz 不要继续硬冲；若要升频，需先对控制路径（`dma_pixels → store FSM`）和其余 54 个违例端点做结构化拆分，成本远高于收益。

### 6. 下一步操作入口

- 频率已到 80MHz 实际上限，FPS 提升改从两条路走：
  1. **减少 PL 周期**：尾部 relay（去层间 DDR 往返）、8 输入 lane MAC（需先释放 DSP）。
  2. **减少软件开销**：把 bias/requant 也改成 DMA 搬运（把 160 次 AXI-Lite 写降为 1 次 DMA），或把多组描述符预写进 descriptor 队列一次 doorbell 下发。
- 长期突破：事件驱动推理 / 渐进推理（帧间差值门控跳过静止帧），这是论文级的大增益方向。

## 125 2026-08-31 修复合两条临界时序路径，80MHz 完全收敛（WNS +0.069ns）

**阅读顺序：先读本节确认 80MHz 时序已彻底收敛；再读第 124 号了解 -0.004ns 违例；再读第 121 号 5.6 节了解频率路线。**

### 1. 本轮真正完成的是什么

- 修复第 124 号遗留的时序违例，把 80MHz 从 WNS -0.004ns 拉到 **+0.069ns、0 违例端点**。
- 改动一：`gestureflow_requant_relu.sv` 把 `round_saturate` 拆成两级流水——先寄存 `rounding_divide_by_pot` 结果（stage 3a），下一拍再做"加零点 + 饱和"（stage 3b）。原路径 `right_shift → case 移位 → +零点 → 饱和 → out_data` 被切成两段。
- 改动二：`gestureflow_hp0_gap_fc.sv` 把 FC 乘法拆成"选通寄存 + 乘法"——新增 `FC_MUL3` 状态，先在 FC_MUL 寄存 `fc_sum[fc_index]`/`fc_multiplier[fc_index]` 选通结果，FC_MUL2 做 32×32 DSP 乘法，FC_MUL3 做 high_mul。把 18 选 1 的 `fc_index` 多路选择器移出乘法 setup 路径。

### 2. 根因定位/关键发现

- 拆完 requant 后，时序报告里新的最差路径变成 postprocess 的 `fc_index_reg → fc_product_reg`（gap_fc 的 FC requant 乘法，-0.032ns）。说明 80MHz 下不止一条近临界路径，逐条优化是"修一条冒一条"。
- 两条路径的共性：都是"索引选通（mux）→ 32×32 乘法/移位"的长组合链。修法是同一种：**把选通结果先寄存一拍，让 mux 的扇出/选择逻辑不再与 DSP/移位级联在同一条 setup 路径上**。

### 3. 已经实际跑通的回归

- `bash innovation_npu/tests/run_gestureflow_conv4x4_cin_full_layer_hagrid18.sh` 通过：`quant_fnv1a=7e276c7b`（requant 拆流水后 FNV 不变）。
- `bash innovation_npu/tests/run_gestureflow_hp0_gap_fc_hagrid18_real.sh` 通过：`gap=f109a7ae fc=22e52ddd class=1`（gap_fc 拆流水后 FNV 不变）。
- 80MHz 整网重新综合布线成功，时序签核：`Setup: 0 Failing, Worst Slack +0.069ns`；`Hold: 0 Failing, Worst Slack +0.008ns`。
- 实板：`bash innovation_npu/board_7020/run_board_hagrid18_from_wsl.sh` 通过，`FINAL_RESULT=0x600D600D`。

### 4. 资源/时序变化

- 时序：WNS **-0.004ns → +0.069ns**，完全收敛（较第 120 号 +0.063ns 还略好）。Hold 裕度 +0.008ns（正，但偏小，后续留意）。
- 资源：requant 增加约 141 个 FF（shifted 值 + 控制位），gap_fc 增加两个 32 位寄存 + 一个状态，DSP/BRAM 不变。
- 性能：`PROBE[130]=0x009CF98B`（10,283,403 tick，约 30.85ms / **32.4 FPS**），`PROBE[133]=0x0022B056`（2,267,222 cycles）。较第 124 号 31.57 FPS 略有提升，含单次测量波动；时序修复本身不改变计算量，FPS 提升主要仍是 ping-pong 的收益。

### 5. 关键坑/注意事项

- 80MHz 下近临界路径不止一条，且布线摆幅可达 ±0.1ns。后续冲 90~100MHz 前，务必先用 OOC 综合看裕度，不要直接整网布线硬冲。
- Hold 裕度 +0.008ns 偏小（正常应 >0.02ns），当前收敛但靠近边界；升频或改布局后要重点复查 hold。
- 拆流水会让 PL 周期数略增（本轮 +37 cycles），换来的是可收敛的 setup 裕度，属于正确取舍。

### 6. 下一步操作入口

- 80MHz 已完全收敛，可把精力转回性能/结构：按第 121 号继续做"参数 bank 乒乓"（PARAM_BANK_SELECT）把 bias/requant 写也重叠掉，进一步压端到端。
- 若继续冲频，先用 OOC 估 90/100MHz 的 WNS，针对新的最差路径做结构优化后再整网布线。
- 之后推进：尾部 relay、输出 bank 瘦身、双模 MAC、8 lane、事件驱动/渐进推理。

## 124 2026-08-31 权重 ping-pong 软件调度完成并真实上板，30.59→31.57 FPS

**阅读顺序：先读本节确认 ping-pong 已端到端跑通并有真实 FPS 提升；再读第 123 号了解层链门控放开；再读第 122 号了解 MAC 双 bank 使能。**

### 1. 本轮真正完成的是什么

- 完成 [`innovation_npu/board_7020/software/gestureflow_hagrid18_main.c`](../innovation_npu/board_7020/software/gestureflow_hagrid18_main.c) 的权重 ping-pong 软件调度：把 `load_conv_tile/run_layer` 拆成"配置-only + 权重 DMA + launch + 等待"，逐层交替 `WEIGHT_BANK_SELECT`/`WEIGHT_READ_BANK_SELECT`，在每层计算期间预载下一层权重到相反 bank（尾部重叠）。
- 80MHz 整网重新综合布线并真实上板验证：`FINAL_RESULT=0x600D600D`，全网络逐层 FNV 通过。
- 实板性能：`PROBE[130]=0x00A1122D`（10,556,973 tick，约 31.67ms / **31.57 FPS**），对比第 120 号基线 30.59 FPS，提升约 **3.2%**。`PROBE[133]=0x00228AF3`（2,263,283 cycles），PL 纯计算基本不变，说明提升全部来自权重装载与计算重叠。

### 2. 根因定位/关键发现（本轮踩了两个坑）

- **坑 1：写 bank 竞态**。最初在层运行期间（`running=1`）写 `WEIGHT_BANK_SELECT`，但该寄存器仍被 `running` 门控，导致写被拒绝、`weight_bank_select` 停留在 0，下一层权重 DMA 错误写进"正在读的 bank 0"，触发 MAC `protocol_error`（板测 STATUS=0x46）。修复：把"切写 bank"提前到 `launch` 之前（空闲时），不改 RTL、无需重新综合。
- **坑 2：输入读完竞态**。最初 `wait_input_loaded()` 用 `!dma_busy`，`launch` 后输入 loader 的 busy 尚未拉高前，第一拍轮询会误判"已读完"，导致权重 DMA 提前抢 AR。修复：改等 `dma_done`（reset 后为 0、输入读完才拉高），消除竞态。

### 3. 已经实际跑通的回归

- `bash innovation_npu/board_7020/build_software_hagrid18_from_wsl.sh` 通过（ELF 630797 字节，仅未使用函数/变量警告）。
- 80MHz 整网：`GESTUREFLOW_HAGRID18_FCLK_MHZ=80 bash innovation_npu/board_7020/run_build_gestureflow_hagrid18_hf_7020_from_wsl.sh` 成功生成 bit/XSA。
- 实板：`bash innovation_npu/board_7020/run_board_hagrid18_from_wsl.sh` 通过，`GESTUREFLOW_HAGRID18_FINAL_RESULT = 0x600D600D`。

### 4. 资源/时序变化

- 资源（gestureflow_0 实例）：LUT≈29,026（Logic）+ 5,148（LUTRAM）、FF≈？、DSP 与上一版基本一致（本次 MAC/层链改动不在数据通路上，资源无实质变化）。
- **时序出现 1 条临界 setup 违例**：`WNS=-0.004ns`，失败路径在 `requant/result_right_shift_chunk_reg → out_data_reg`（即 `rounding_divide_by_pot` 显式 case 选择 + 饱和）。该路径与本次改动无关，是第 120 号 +0.063ns 同一路径的布线波动（0.067ns 摆幅）。**实板仍通过**（-4ps 属临界、实际正常），但严格讲未收敛。

### 5. 关键坑/注意事项

- ping-pong 只重叠了**权重 DMA**；bias/requant 的 AXI-Lite 写仍串行（BDATA/RQMULT/RQSHIFT 被 `!running` 门控，且 requant 参数是每输出向量捕获，不能中途覆盖）。若要再省，需做参数 bank 乒乓 + requant 参数改"层开始一次性捕获"。
- 切 `WEIGHT_BANK_SELECT` 必须空闲时做（或被门控拒绝）；`WEIGHT_READ_BANK_SELECT` 始终在 launch 前（空闲）写，安全。
- 时序 -0.004ns 需在下一轮处理，不能长期留在临界违例状态。

### 6. 下一步操作入口

- 先处理时序裕度：优化 requant 的 `rounding_divide_by_pot` 关键路径（进一步拆流水或优化 case 选择），目标把 80MHz WNS 拉回 >+0.1ns，为后续 90~100MHz 留裕度。
- 再做参数 bank 乒乓（PARAM_BANK_SELECT），把 bias/requant 写也重叠掉，进一步压缩端到端。
- 之后按第 121 号继续：尾部 relay、输出 bank 瘦身、双模 MAC、8 lane、再上频、事件驱动/渐进推理。

## 123 2026-08-31 层链权重 DMA 门控放开（尾部重叠使能，硬件侧完成）

**阅读顺序：先读本节确认端到端 ping-pong 的硬件使能已全部完成；再读第 122 号了解 MAC 层 ping-pong 使能；再读第 121 号 5.1 节了解整体路线。**

### 1. 本轮真正完成的是什么

- 修改 [`innovation_npu/rtl/gestureflow_layer_chain_hp0_axil.sv`](../innovation_npu/rtl/gestureflow_layer_chain_hp0_axil.sv) 的权重 DMA 寄存器门控，使下一层权重描述符可以在当前层运行期间预写、并在"输入读完"后立即启动权重 DMA（尾部重叠）。
- 本轮只改层链门控，**未改软件 main.c / 未整网布线 / 未上板**；现有 80MHz 位流行为不变。

### 2. 根因定位/关键发现

- 原先 `WEIGHT_DMA_SOURCE/BYTES/CFG/CONTROL` 都被 `running || dma_busy || weight_dma_busy || store_busy || hash_active` 门控，导致权重装载只能在本层完全结束后串行进行。
- 修正语义：
  - 描述符寄存器（SOURCE/BYTES/CFG）只在 `weight_dma_busy` 时禁止写（避免改动正在搬运的描述符），其余时刻可随时预写。
  - 启动位（CONTROL 写 2）只在 `dma_busy || weight_dma_busy` 时禁止：**输入 loader 仍占用 AR 通道时不许启动（`dma_busy`），输入读完即可启动**，即使输出 store 仍在写、层仍 `running`、hash 仍在算。
- 关键依据：权重 DMA 用 AXI 的 AR/R（读）通道，输出 store 用 AW/W/B（写）通道，互不冲突；`hash_active` 是输出 FNV 计算，与权重写无关。所以尾部重叠窗口（输入已读完、输出仍在写回）里，权重 DMA 与 store 可并发。

### 3. 已经实际跑通的回归

- `bash innovation_npu/tests/run_gestureflow_layer_chain_hp0_postprocess_hagrid18_out32.sh` 通过：`GESTUREFLOW_LAYER_CHAIN_HP0_POSTPROCESS_HAGRID18_PASS bursts=72 cycles=4083 gap=64 fc=18 class=0`，确认门控放松向后兼容。

### 4. 资源/时序变化

- 无综合。本轮只改 AXI-Lite 寄存器写使能的条件（去掉了几个 fault 判断项），不引入新数据通路，无资源/时序影响。

### 5. 关键坑/注意事项

- 至此 ping-pong 的**硬件使能已完整**：第 122 号解锁了 MAC 双 bank 并发写，本轮解锁了层链尾部重叠启动。但**软件仍是串行调度**，所以端到端 ping-pong 尚未激活，FPS 尚未变化。
- 软件激活时必须同时处理三件事（缺一不可）：
  1. **权重 bank 乒乓**：`WEIGHT_BANK_SELECT(0x0fc)` 与 `WEIGHT_READ_BANK_SELECT(0x15c)` 逐层交替；
  2. **参数 bank 乒乓**：bias/requant 的 `PARAM_BANK_SELECT(0x150)` 也要交替——requant 参数是"每输出向量"被捕获的，不能在计算中途覆盖，必须双 buffer；
  3. **尾部重叠时序**：本层 `run_layer` 启动后不等待，立即预写下一层描述符并启动其权重 DMA，再等本层 done，最后切 bank 启动下一层。
- 软件改动需要整网布线 + 实板验证（`FINAL_RESULT=0x600D600D` 且 FPS 提升），不能只看编译通过。

### 6. 下一步操作入口

1. 改 `innovation_npu/board_7020/software/gestureflow_hagrid18_main.c`：把 `load_conv_tile/weight_dma_load/run_layer` 拆成"预写描述符 + 启动 DMA"与"启动层 + 等待"，实现逐层 bank 乒乓与尾部重叠。
2. 整网布线 + 编译软件 + 实板测 FPS（预期较 30.59 FPS 有 10%~15% 级提升，抵消权重串行装载）。
3. 之后按第 121 号继续：尾部 relay、输出 bank 瘦身、双模 MAC、8 lane、再上频、事件驱动/渐进推理。

## 122 2026-08-31 MAC 权重 ping-pong 预载能力解锁（硬件使能 + Verilator 验证）

**阅读顺序：先读本节确认权重 ping-pong 的 MAC 层硬件使能已完成并验证；再读第 121 号的静态/动态统一架构规划（其 5.1 节是 ping-pong 的完整路线）；再读第 120 号入门指南。**

### 1. 本轮真正完成的是什么

- 修改 [`innovation_npu/rtl/gestureflow_mac_tile.sv`](../innovation_npu/rtl/gestureflow_mac_tile.sv)：解锁权重 bank 的 ping-pong 预载——计算时允许向"非当前读 bank"写权重，仍禁止写"正在读的 bank"。
- 新增回归 [`innovation_npu/tests/tb_gestureflow_mac_tile_pingpong.sv`](../innovation_npu/tests/tb_gestureflow_mac_tile_pingpong.sv) 与 [`run_gestureflow_mac_tile_pingpong.sh`](../innovation_npu/tests/run_gestureflow_mac_tile_pingpong.sh)。
- 本轮只改 MAC tile + 新增测试，**未改层链/软件/bitstream**，80MHz 上板基线不受影响。

### 2. 根因定位/关键发现

- MAC tile 原先有两个"计算时禁写权重"的硬约束：(a) 权重 bank 的 `write_enable = weight_write_valid && !busy && (oc==..)`；(b) 顶层 `if (weight_write_valid && busy) protocol_error<=1`。这两处把"计算期间写权重"一律判非法。
- 本轮的语义修正：**只有当写目标 bank 等于当前读 bank 时才禁止**。即
  `write_enable = weight_write_valid && (oc==..) && (!busy || (weight_bank_select != read_bank_select))`，协议违例同理只针对 `weight_bank_select == read_bank_select`。
- 权重 bank 物理上就是双 bank（地址最高位 `weight_bank_select`/`read_bank_select` 选 bank），每 bank 是独立写口 + 读口的简单双口 BRAM，因此"写 B bank + 读 A bank"可同一拍进行，互不干扰。
- 验证坑：ping-pong 测试最初 FAIL 是 **testbench 权重值超出 signed int8 范围被截断**（`w_b` 里 `oc*200+..` 对 oc=1 达 224，`[7:0]` 截成 -32 等），不是硬件错。修正权重到 int8 范围后通过。硬件行为（bank A 结果不被并发写污染、bank B 新权重可被后续任务读回）均正确。

### 3. 已经实际跑通的回归

- `bash innovation_npu/tests/run_gestureflow_mac_tile_pingpong.sh` 通过：`GESTUREFLOW_MAC_TILE_PINGPONG_PASS`。覆盖"计算读 bank A 的同时写 bank B"、bank A 结果不变、随后读 bank B 得到新权重。
- `bash innovation_npu/tests/run_gestureflow_mac_tile.sh` 仍通过：`GESTUREFLOW_MAC_TILE_PASS psum=72,95,118,141`，确认 MAC 改动向后兼容（weight_bank_select == read_bank_select 时行为不变）。

### 4. 资源/时序变化

- 无综合。write_enable 只新增 1 位 XOR 比较（`weight_bank_select != read_bank_select`）+ 若干 LUT，不在乘法/加法数据通路上，对 80MHz 关键路径无实质影响。具体待接入整网时以 OOC 为准。

### 5. 关键坑/注意事项

- 本轮只解锁了 **MAC 层** ping-pong；层链仍以 `running` 门控 `weight_dma_start`，所以端到端预载尚未激活。
- 激活端到端 ping-pong 的剩余两块，务必一起做，缺一不可：
  1. 层链放开 `WEIGHT_DMA_SOURCE/BYTES/CFG/CONTROL` 对 `running` 的门控；
  2. **修复 M_AXI AR 通道仲裁**：当前 AR 优先级是 `weight_dma_busy > 输入 loader`，且各输入 loader 的 `arready` 直接接 `m_axi_arready`（未按 weight_dma_busy 门控）。若直接放开门控，weight DMA 抢走 AR 时输入 loader 会误判"请求已受理"，导致输入读取丢拍。必须给输入 loader 的 arready 加上"weight_dma 不占用 AR 时才有效"的门控，或引入真正的 AR 仲裁器。
  3. 软件调度采用"尾部重叠"：本层输入读完、输出仍在写回 DDR 时启动下一层权重预载（此时 AR 空闲）。

### 6. 下一步操作入口

- 按第 121 号 5.1 节继续：先做"层链 AR 仲裁修复 + weight_dma 门控放开"，用 Verilator 层链回归验证 AR 不会被抢占丢拍；再做软件尾部重叠调度；最后整网布线 + 实板测 FPS。
- 之后依次推进：尾部 relay、输出 bank 瘦身、双模 MAC 释放 DSP、8 lane、再上频、事件驱动/渐进推理。

## 121 2026-08-31 静态/动态统一架构规划 + 时序积累引擎落地

**阅读顺序：先读本节了解本轮"静态+动态兼容架构"的决策与新增硬件；再读新规划文档 [GestureFlow_静态动态统一硬件架构_2026-08-31.md](./GestureFlow_静态动态统一硬件架构_2026-08-31.md)；再读第 120 号确认上一轮的入门指南与 80MHz 现状。**

### 1. 本轮真正完成的是什么

- 新增规划文档 [`docs/GestureFlow_静态动态统一硬件架构_2026-08-31.md`](./GestureFlow_静态动态统一硬件架构_2026-08-31.md)，回答：静态算法是什么、时序积累放 PS 还是 PL、静态+动态兼容架构、极致性能路线。
- 新增 RTL [`innovation_npu/rtl/gestureflow_temporal_accumulator.sv`](../innovation_npu/rtl/gestureflow_temporal_accumulator.sv)：零 MAC 的片上时序规约引擎，累计 `sum / max / 首帧 / 末帧`，序列结束输出 `[sum, max, delta]` 与 `frame_count`。
- 新增回归 [`innovation_npu/tests/tb_gestureflow_temporal_accumulator.sv`](../innovation_npu/tests/tb_gestureflow_temporal_accumulator.sv) 与 [`run_gestureflow_temporal_accumulator.sh`](../innovation_npu/tests/run_gestureflow_temporal_accumulator.sh)。
- 本轮只新增文件，**未改动既有 RTL/软件/bitstream**，80MHz 上板基线不受影响。

### 2. 根因定位/关键发现

- 动态模型（`algorithms/temporal_cnn/gesture_temporal_model.py`）的真实结构是：逐帧空间骨干（3×3/4×4/4×4 + 1×1 嵌入）→ 逐帧 GAP → `temporal_shift`（零 MAC 跨帧搬通道）→ `temporal_summary(mean/max/delta)` → 1×1 融合 → FC。**时序部分是零 MAC 规约 + 极小稠密（约 3 万 MAC/序列、几百字节/序列）**，比单帧空间 CNN 小 3~4 个数量级。
- **决策：时序积累默认放 PS(ARM)**（数据仅 8×96=768 字节、算量 3 万 MAC，ARM 微秒级完成；灵活易改）。PL 侧另备时序积累引擎，用于极高帧率或避免逐帧唤醒 PS。
- 静态算法确认：18 类 HaGRID 蒸馏学生模型，`4×4/4×4/4×4(通道 16/32/48) + 1×1 head(48→64) + GAP + FC`，int8 98.88%。
- 时序积累引擎的 mean 不在此模块做除法（`÷帧数`），而是折叠进下游 fusion 的 requant multiplier，与静态 GAP 的整数 Mean 缩放同一技巧，避免硬件除法器。

### 3. 已经实际跑通的回归

- `bash innovation_npu/tests/run_gestureflow_temporal_accumulator.sh` 通过：`TEMPORAL_ACCUMULATOR_PASS frames=4`，`sum/max/delta/frame_count` 全对。测试数据 4 帧 × 4 通道，覆盖正/负 int8、max 跨帧、delta 为负的情况。

### 4. 资源/时序变化

- 无综合。时序积累引擎是纯寄存器 + 比较器 + 加法器：CHANNELS=96 时约数千寄存器（FF 用量个位数百分比），**0 DSP、0 BRAM**，不在关键路径上，不影响 80MHz 收敛。具体资源待接入整网时以 OOC/综合为准。

### 5. 关键坑/注意事项

- 时序积累引擎的 `out_sum/out_max/out_delta` 必须在 `done` 脉冲同拍读取；`done` 只持续一拍。
- 均值 `÷帧数` 折叠进 fusion multiplier，而不是在累加器里做除法；若帧数非 2 的幂，multiplier 里要含精确的倒数缩放。
- `temporal_shift`（跨帧搬通道组）尚未在本引擎实现，规划默认由 PS 在送入 summary 前完成，或后续在 PL 加一个 3 帧环形缓冲。
- 新模块与静态 gap_fc 并行，不共用权重 bank；接入动态时需在顶层增加"尾部二选一"（静态 FC/argmax vs 动态时序积累）。

### 6. 下一步操作入口

- 静态极致性能（优先）：按规划文档第 5.1 节做"权重 ping-pong 预载"——先放开 MAC 权重写使能（`!busy || weight_bank_select != read_bank_select`），再解决 M_AXI AR 通道在 `running` 时的仲裁（优先"尾部重叠"：卷积算完、写回仍进行时启动下一层权重预载）。
- 其次：尾部链路 relay、输出 bank 瘦身、双模 MAC 释放 DSP、8 lane、再上频。
- 动态接入：先拿 IPN/EgoGesture 训练时序模型，再把空间骨干与静态对齐、导出 int8，逐帧调用现有加速器 + 本时序引擎或 PS 时序融合。

## 120 2026-08-31 编写《从零入门完全指南》并收口 80MHz 实板现状

**阅读顺序：先读本节确认"面向零基础接手的教学文档"已经落盘，并核对当前 80MHz 真实状态；再读本文档顶部第 119 号确认三十二路宽输出的上板基线；教学文档是 [GestureFlow-NPU_从零入门完全指南_2026-08-31.md](./GestureFlow-NPU_从零入门完全指南_2026-08-31.md)。**

### 1. 本轮真正完成的是什么

- 新增教学文档 [`docs/GestureFlow-NPU_从零入门完全指南_2026-08-31.md`](./GestureFlow-NPU_从零入门完全指南_2026-08-31.md)，共 1355 行、9 章，目标是让**完全零基础的大一学生**从零读懂并接管整个项目。它覆盖：零基础名词（FPGA/时钟/流水线/DSP/BRAM/AXI/量化）、项目全景、18 类手势算法详解（训练/蒸馏/量化/零点折叠/权重打包）、硬件逐模块逐行讲解（MAC 阵列 5 级流水、requant 3 级流水、GAP/FC、权重 DMA、顶层寄存器映射与 layer_mode）、软件驱动逐函数讲解、完整运行流程、如何修改、创新突破路线图、术语与命令速查。
- 在交接文档顶部新增本节（第 120 号），并把记录总数从 119 更新为 120。
- 本轮是**文档与现状收口**，没有改动 RTL、软件或 bitstream；核心代码与第 119 号及之前记录的 80MHz 状态一致。

### 2. 根因定位/关键发现

- 重新核对当前**真实算法结构**：当前部署主线不是早期 6 类 hybrid344（3×3/4×4/4×4/1×1, 通道 16/48/80），而是 **18 类 HaGRID 蒸馏学生模型**：`models/hagrid_v1_500k_384p_targethand_student_4x4_rvv_distill_20260827/`，INT8 测试准确率 **98.88%**（85,311 张测试图，`tflite_eval.json`）。
- 该学生模型真实结构（`train_static_cnn.py` 的 `regularized_plain` + `body_kernel_schedule=4,4,4` + `stage_channels=16,32,48` + `head_kernel_size=1` + `head_channels=64`）为：输入 96×96×3 → 3 个 stage（每 stage 两个 4×4 卷积 + BN + ReLU + 2×2 MaxPool）→ 1×1 head(48→64)+ReLU → GAP(64) → FC(18)。即 **7 卷积（6 个 4×4 + 1 个 1×1）+ 3 MaxPool + GAP + FC**。
- 硬件 `gestureflow_hp0_gap_fc.sv` 在 18 类构建里实例化为 `CHANNELS=64, CLASSES=18, ELEMENTS=144, FC_GROUPS=16`；layer_mode 映射为 mode0=RGB(3)、mode1=16ch、mode2=32ch、mode3=48ch、mode5=48ch pointwise、mode4=GAP/FC。
- 核对 QCFG 寄存器 `0x00038080`：`input_zero_point=0x80(-128)`、`output_zero_point=0x80(-128)`、`requant_enable[16]=1`、`relu_enable[17]=1`，确认本项目是对称 int8（零点 -128）。

### 3. 已经实际跑通的回归

- 本轮只做文档，未重跑 Verilator/Vivado。当前 80MHz 状态以实板时序报告为准（见第 4 节），功能正确性沿用第 119 号及之前的 `FINAL_RESULT=0x600D600D` 闭环。
- 常用回归入口（教学文档 5.3 节有完整列表）：`bash innovation_npu/tests/run_gestureflow_hp0_gap_fc_hagrid18_real.sh`、`bash innovation_npu/tests/run_gestureflow_conv4x4_cin_full_layer_hagrid18.sh`、`bash innovation_npu/tests/run_gestureflow_layer_chain_hp0_postprocess_hagrid18_out32.sh`、`bash innovation_npu/tests/run_gestureflow_hp0_weight_dma_loader_32.sh`。

### 4. 资源/时序变化

- 本轮无综合，资源/时序无变化。当前 80MHz 实板状态（从最新报告核对）：
  - 时序：`WNS=+0.063ns`、`WHS=+0.020ns`，0 违例端点（`axi_gpio.runs/impl_1/system_wrapper_timing_summary_routed.rpt`）。
  - 资源（`logs/gestureflow_hagrid18_7020_utilization_impl.rpt`，gestureflow_0 实例）：LUT=34,627、FF=51,477、RAMB36=127、RAMB18=26、DSP=191。其中 stream(MAC)=160 DSP、postprocess(gap_fc)=17 DSP、output_bank=112 RAMB36 是三大占用源。
  - 性能（第 119 号后的 80MHz 上板）：端到端约 32.69ms / 30.59 FPS，PL 纯计算 2,263,828 cycles @80MHz ≈ 28.30ms。

### 5. 关键坑/注意事项

- 教学文档里 `innovation_npu/README.md` 部分内容偏旧（仍描述 16 输出通道/25MHz/6 类旧主线），本文已明确"以教学文档和交接记录为准"，后续接手时优先看新教学文档。
- 文档中"30.59 FPS"是**整网测试图片基准**（内置确定性测试图），不是摄像头实时帧率；摄像头未采购，不能写成摄像头帧率。
- `coralnpu/` 只读红线、WSL 调 Windows 工具必须先 `cd /mnt/e`、权重 DMA 前必须 `Xil_DCacheFlushRange` 等固定规则，教学文档第 5.8 节已集中列出。

### 6. 下一步操作入口

- 新手入门：先读 [`GestureFlow-NPU_从零入门完全指南_2026-08-31.md`](./GestureFlow-NPU_从零入门完全指南_2026-08-31.md) 第 0~2 章建立概念，再读第 3~4 章对应代码，最后按第 5 章跑一遍完整流程。
- 继续创新突破：按教学文档第 7.3 节，优先做"权重 ping-pong 预载（软件调度，利用已加的 `WEIGHT_READ_BANK_SELECT`）"和"层间激活 relay 扩展"，不要继续无脑整网布线冲 100MHz（DSP 只剩 29 个，先用 OOC 估时序）。

## 119 2026-08-30 三十二路宽输出完成协议修复并真实整网上板，16.576 FPS

**阅读顺序：先读本节确认三十二路已经完成新硬件、新软件和实板闭环；再读第 118 号了解此前三十二路为什么不能上板；再读第 115 号对照十六路 13.23 FPS 基线。**

### 1. 本轮真正解决的问题

- 发现 [`innovation_npu/rtl/gestureflow_hp0_weight_dma_loader.sv`](../innovation_npu/rtl/gestureflow_hp0_weight_dma_loader.sv) 的输出通道计数原来固定为四位，并且完成字节数校验固定按十六路计算。三十二路权重搬运即使描述符传入更宽字节数，也会把输出通道坐标截断到 `0..15`。
- 将权重搬运器的输出通道计数、输出端口宽度和计数回卷改为参数化，并新增运行时 `outputs_per_tile`。现在同一个宽硬件同时支持十六路兼容 tile 和三十二路完整 tile；字节数校验按实际 tile 宽度计算，不需要用无效权重填充。
- [`innovation_npu/rtl/gestureflow_layer_chain_hp0_axil.sv`](../innovation_npu/rtl/gestureflow_layer_chain_hp0_axil.sv) 同步扩大权重搬运输出坐标，新增 `WEIGHT_DMA_CFG[21:16]` 作为本次 tile 的输出通道数，并保持 AXI-Lite 直接写权重的旧回退路径。
- [`innovation_npu/board_7020/software/gestureflow_hagrid18_main.c`](../innovation_npu/board_7020/software/gestureflow_hagrid18_main.c) 已从十六路分块切换为真实三十二路调度：`32->32` 层由两个 tile 合并为一个，`48->48` 层由三个 tile 减为两个，`48->64` 头部由四个 tile 减为两个；最后一个非整三十二路 tile 使用实际有效字节和通道掩码。
- 修复 [`innovation_npu/board_7020/run_create_hagrid18_platform_from_wsl.sh`](../innovation_npu/board_7020/run_create_hagrid18_platform_from_wsl.sh) 和 [`innovation_npu/board_7020/run_board_hagrid18_from_wsl.sh`](../innovation_npu/board_7020/run_board_hagrid18_from_wsl.sh)：调用 Windows 工具前先切换到 `/mnt/e`，避免 `cmd.exe` 继承 WSL UNC 当前目录而产生误导性警告。

### 2. 行为级验证

- `bash innovation_npu/tests/run_gestureflow_hp0_weight_dma_loader.sh` 通过：十六路运行时宽度，`writes=128 bytes=512`。
- `bash innovation_npu/tests/run_gestureflow_hp0_weight_dma_loader_32.sh` 通过：三十二路运行时宽度，`writes=256 bytes=1024`，完整输出通道坐标逐字匹配；新增回归脚本为 [`innovation_npu/tests/run_gestureflow_hp0_weight_dma_loader_32.sh`](../innovation_npu/tests/run_gestureflow_hp0_weight_dma_loader_32.sh)。
- `bash innovation_npu/tests/run_gestureflow_layer_chain_hp0_postprocess_hagrid18_out32.sh` 通过：`bursts=72 cycles=2880 gap=64 fc=18 class=0`。
- `bash innovation_npu/tests/run_gestureflow_conv4x4_cin_full_layer_hagrid18.sh` 通过：`outputs=9216 probes=7 quant_fnv1a=7e276c7b cycles=663861`。
- Windows 端软件重新编译通过，三十二路程序 `gestureflow_hagrid18.elf` 大小为 `630397` 字节。编译器仍报告若干历史未使用统计变量警告，但没有错误，未用 `-Wno-error` 掩盖任何错误。

### 3. 新版 Vivado 实现签核

- 工程：`E:\coralnpu_vivado\projects\gestureflow_hagrid18_7020_v1`，目标器件 `xc7z020clg400-2`，时钟 `40MHz`。
- 本轮由新的 `system_gestureflow_0_21` 重新综合、布局布线，未复用旧的宽核位流。路由完成后未布线网络为 `0`，比特流生成成功，硬件平台生成成功。
- 最终实现报告 [`gestureflow_hagrid18_7020_timing_impl.rpt`](../../mnt/e/coralnpu_vivado/projects/gestureflow_hagrid18_7020_v1/logs/gestureflow_hagrid18_7020_timing_impl.rpt) 的签核值：`WNS=+4.820ns`、`TNS=0`、`WHS=+0.064ns`、`THS=0`，报告明确写明所有用户约束满足。
- 最终实现资源：`LUT=35764`、`FF=53472`、`RAMB36=127`、`RAMB18=26`、`DSP=191`。资源报告位于 `E:\coralnpu_vivado\projects\gestureflow_hagrid18_7020_v1\logs\gestureflow_hagrid18_7020_utilization_impl.rpt`。
- 新比特流：`E:\coralnpu_vivado\projects\gestureflow_hagrid18_7020_v1\logs\gestureflow_hagrid18_7020.bit`，约 `3.86 MiB`；新硬件平台：同目录下的 `gestureflow_hagrid18_7020.xsa`，约 `1.62 MiB`。平台和比特流均由本轮实现生成。

### 4. 三十二路真实实板结果

- 严格使用本轮新生成的 `gestureflow_hagrid18_7020.bit`、新 `gestureflow_hagrid18_7020.xsa`、新编译 `gestureflow_hagrid18.elf`，通过 `bash innovation_npu/board_7020/run_board_hagrid18_from_wsl.sh` 烧录并运行。
- 实板结果：`GESTUREFLOW_HAGRID18_FINAL_RESULT = 0x600D600D`、`GESTUREFLOW_HAGRID18_BOARD_PASS`；GAP FNV、FC FNV、分类结果均通过，分类类别为 `1`。
- `PROBE[130]=0x0132D86B`，即 `20,109,419` 个三分之一纳秒计时刻度，约 `60.328ms/frame`，端到端 `16.576 FPS`。
- `PROBE[131]=0x0007AE06`，权重配置和权重 DMA 合计约 `1.510ms`；`PROBE[132]=0x000379EF`，纯 WEIGHT_DMA busy 约 `0.683ms`。
- `PROBE[133]=0x0021DE3F`，即 `2,219,583` 个 `40MHz` 时钟周期，PL 纯计算约 `55.490ms`。
- 对比第 115 号十六路真实基线 `13.23 FPS / 75.57ms / PL 69.20ms`，本轮三十二路实际整网达到约 `16.576 FPS / 60.328ms / PL 55.490ms`；端到端提升约 `25.3%`，PL 计算时间减少约 `19.7%`。这不是仿真估算，而是同一开发板的真实运行数据。

### 5. 本轮边界和后续注意事项

- 当前三十二路已经是可综合、可布局布线、可烧录、可运行的真实版本，但 `DSP=191/220`，只剩 `29` 个 DSP，不应继续盲目增加乘法阵列；下一步应优先降低 `RAMB36=127` 的输出 bank 代价、重叠下一层权重搬运、减少 DDR 往返。
- 当前实板输入仍是程序内置的确定性测试图片，不是摄像头实时帧；因此 `16.576 FPS` 是整网测试图片基准，不应表述为摄像头帧率。
- 当前 `gestureflow_hagrid18_main.c` 仍在一次运行中保留多组历史周期数组，部分数组只是兼容诊断用途；修改统计代码前必须先保持板级协议和 FNV 对账不变。
- 下一次做三十二路或更宽版本时，`WEIGHT_DMA_CFG` 必须同时下发 `taps`、`groups` 和 `outputs_per_tile`；权重源地址必须八字节对齐，导出数组必须保持至少六十四字节对齐，WEIGHT_DMA 发起前必须刷新数据缓存。
- Vivado/Vitis/XSCT 必须在 Windows 本地 `E:` 路径执行，不能从 `\\wsl.localhost\Ubuntu-22.04\...` UNC 路径启动。WSL 调用前先执行 `cd /mnt/e`，再用 `cmd.exe /d /s /c "pushd E:\\... && call E:\\Xilinx\\..."`。
- 本轮的三十二路新硬件和软件已验证，但尚未提交 Git；收口时只提交本轮相关 RTL、测试、板级脚本、软件和本节交接记录，不要把其他历史未跟踪目录整体加入。

## 118 2026-08-30 现状审计收口，三十二路仍是实验分支，未启动新的综合

**阅读顺序：先读本节确认本轮真实边界；再读第 117 号了解三十二字节写回协议；再读第 115 号确认唯一可信的十八类实板十三点二三帧每秒基线。**

### 1. 本轮没有改变主线硬件

- 本轮先核对了项目提交历史、工作区差异、核心 RTL 和官方仓库状态，没有把工作区的三十二路实验误当成新的板级版本。
- `/home/steveguo/coralnpu-gesture/coralnpu` 仍是 Google CoralNPU 官方只读参考仓库，`git status --short` 为空。本项目自研硬件仍只位于 `innovation_npu/rtl/`，不得把它表述为官方 RTL。
- 工作区存在大量历史未提交修改，不能整体清理或回退。当前主线判断以已提交的 `a4b3bf0`（十八类、十六输出通道、四十兆赫兹、十三点二三帧每秒实板版本）为板级基线；三十二路相关文件仍属于未完成实验改动。

### 2. 当前硬件的真实结构

当前 `innovation_npu/rtl/gestureflow_layer_chain_hp0_axil.sv` 是项目自研分层加速器顶层，不是 CoralNPU 完整处理器。数据流为：

```text
Zynq PS
  ├─ AXI-Lite：层尺寸、地址、量化参数、权重装载、启动与状态
  └─ AXI HP0：从 DDR 读取输入/权重，并写回量化后的输出
        ↓
  RGB 或多通道张量加载器
        ↓
  gestureflow_same4x4_cin_window
        ├─ 每通道行延迟存储
        ├─ KERNEL_SIZE=3/4 的滑动窗口
        └─ 边界由输入零点填充
        ↓
  gestureflow_mac_tile
        ├─ OUT_LANES 个输出通道的独立权重 bank
        ├─ 每拍四个输入通道 INT8 乘法
        ├─ 乘积寄存、两级加法树
        ├─ INT32 部分和在 tile 内驻留到全部输入组完成
        └─ 一次输出一个完整输出通道向量
        ↓
  gestureflow_requant_relu
        ├─ INT32×INT32 定点高位乘法
        ├─ TFLite 舍入右移
        ├─ 输出零点、ReLU、INT8 饱和
        └─ 当前默认使用窄通道时间复用，避免宽变量移位网络
        ↓
  输出 bank / 池化 / relay（按层模式选择）
        ↓
  tensor writer 或 GAP/FC 尾部
        ├─ GAP(64)
        ├─ FC(18)
        └─ 片上 FNV、最大类别和状态回报
```

### 3. 已验证与未验证必须分开

**可以依赖的板级结果：**

- 十八类 HaGRID 学生模型已经在 Zynq-7020 实板运行：整帧约 `75.57 ms`，`13.23 FPS`，PL 计算约 `69.20 ms`，权重装载约 `1.459 ms`，最终结果 `FINAL_RESULT=0x600D600D`，各层 FNV/GAP/FC 与 TFLite golden 一致。
- 该板级版本是十六路输出、四十兆赫兹版本；它不是三十二路实验版本。

**当前工作区三十二路实验结果：**

- `OUT_LANES=32` 的 MAC/卷积路径已经有行为级证据：`GESTUREFLOW_CONV4X4_CIN32_ALL32_REAL_PASS`，输出 `2304` 个，哈希 `2015d083`。
- 十八类完整四乘四卷积层行为回归通过：`quant_fnv1a=7e276c7b`，`663861` 周期。它不是布局布线结果，也不是新比特流或板级帧率。
- 三十二字节写回和三十二路顶层后处理行为回归通过：`bursts=72`、`cycles=2880`、`gap=64`、`fc=18`。
- 当前已知三十二路 OOC 结果为 `LUT=35984`、`FF=51035`、`RAMB36=127`、`RAMB18=26`、`DSP=191`，目标 `80 MHz` 时 `WNS=-0.814 ns`、`TNS=-208.308 ns`。因此它不能进入完整综合、布局布线或上板流程。
- 本轮再次运行旧六类 `run_gestureflow_head1x1_gap_fc_real.sh` 时得到 `class=3` 而非该旧测试期望值；这是当前脏工作区的兼容测试失败，不能用它覆盖十八类主线的通过记录。恢复旧测试必须先统一其输入、参数、golden 与当前工作区生成文件。

### 4. 本轮改动尝试及明确结论

- 曾尝试把量化器的运行时变量右移改写成显式移位选择。它在卷积回归中不暴露问题，但在头部到 GAP/FC 的分类回归中产生 `class=3`，因此已经撤回，不得当作已完成优化。
- 曾尝试给 MAC 最终结果增加一拍提交级。数值回归通过，但完整卷积层从此前 `663861` 周期增加到 `673077` 周期，属于性能倒退，已经撤回。
- 当前没有接受任何新的高频结论，没有新的 Vivado 综合、布局布线、比特流、XSA 或板测结果。

### 5. 下一步固定入口

1. 不再继续扩大三十二路阵列。先以 `requant` 的真实实现报告和三十二路 OOC 违例路径为依据，设计不改变输出协议、且不增加尾部周期的流水切分。
2. 量化器改动必须先通过独立边界/随机定点对账，再通过十八类头部、完整卷积层、GAP/FC 和顶层后处理回归；旧六类兼容测试需另行修复或隔离。
3. 只有上述行为回归全绿后，才运行一次三十二路 OOC 综合；只有 OOC `WNS>0` 才启动完整 Vivado 综合、布局布线和位流生成。
4. 未获得新的布局布线和实板结果前，继续使用十六路 `13.23 FPS` 作为唯一可靠性能数字；三十二路只能称为“行为级实验分支”。

## 117 2026-08-30 写回协议边界验证完成，主线回归通过，旧链路回归仍需隔离

**阅读顺序：先读本节；再读第 116 号了解三十二路写回器的结构改动；再读第 115 号了解当前十八类实板基线。**

1. **新增边界修复。**
   - [`innovation_npu/rtl/gestureflow_hp0_tensor_writer.sv`](../innovation_npu/rtl/gestureflow_hp0_tensor_writer.sv) 的 `valid_vector_bytes` 已从五位扩为六位，支持明确下发 `32`，不再依赖零值代表完整三十二字节向量。
   - [`innovation_npu/rtl/gestureflow_layer_chain_hp0_axil.sv`](../innovation_npu/rtl/gestureflow_layer_chain_hp0_axil.sv) 的写回寄存器、描述符寄存器及读回扩展同步为六位；旧十六路软件写入的 `8`、`16` 语义保持不变。

2. **本轮真实验证结论。**
   - 十六字节写回、边界突发、带步长写回、池化带步长写回均通过。
   - 三十二字节写回使用显式 `valid_vector_bytes=32`，3 个向量按 12 个六十四位数据拍写出，全部 32 个通道逐拍匹配，通过：`GESTUREFLOW_HP0_TENSOR_WRITER_32B_PASS vectors=3 beats=12`。
   - 三十二路顶层后处理无位宽截断警告并通过：`bursts=72 cycles=2880 gap=64 fc=18`。
   - 十八类整层仍通过：`quant_fnv1a=7e276c7b cycles=663861`；头部片上中继通过：`pixels=144`；十八类 GAP/FC 通过：`gap=f109a7ae fc=22e52ddd class=1`。

3. **必须区分的失败项。**
   - 历史测试 [`innovation_npu/tests/tb_gestureflow_layer_chain_hp0_axil.sv`](../innovation_npu/tests/tb_gestureflow_layer_chain_hp0_axil.sv) 重新运行时在第一层旧哈希检查失败，实际为 `1b5f5092`，期望为 `05307466`。失败发生在片外写回核对之前，不能归因于本轮三十二字节写回改动；该测试仍混用旧链路生成数据和当前工作区数据，暂不列入十八类主线绿灯。
   - 这项失败不能被 `-Wno-fatal` 或“编译成功”掩盖。后续若恢复它，必须先统一测试台输入、权重、量化参数和当前生成文件，再重新做逐层对账。

4. **版本与官方仓库状态。**
   - 本轮代码检查点为 `dfd193e`，只提交了本轮明确验证的 RTL、测试台和交接记录；其余历史工作区改动仍未被覆盖。
   - `/home/steveguo/coralnpu-gesture/coralnpu` 当前仍为官方只读参考仓库，`git status --short` 为空；任何后续 CoralNPU 工具链操作必须在独立工作树执行。

5. **下一步固定入口。**
   - 先建立当前十八类模型的三十二路完整输出描述符回归，覆盖 `Cout=32` 的完整张量地址布局和三十二字节写回，不直接改板级软件。
   - 随后再把 `gestureflow_hagrid18_main.c` 的输出 tile 调度参数化为十六/三十二路两种模式，并用 Python golden 对每层结果核对。
   - 只有软件、描述符、写回和旧十六路回退都稳定后，才启动一次三十二路 OOC 综合和时序评估；当前仍没有三十二路新比特流或板级 FPS 结果。

## 116 2026-08-30 三十二路输出写回参数化完成，快速行为回归全通过，尚未综合上板

**阅读顺序：先读本节；再读第 115 号了解当前十八类板级基线和权重装载优化；需要了解三十二路计算改动时再读第 114 号以下相关记录。**

1. **本次实际修改。**
   - 修改 [`innovation_npu/rtl/gestureflow_hp0_tensor_writer.sv`](../innovation_npu/rtl/gestureflow_hp0_tensor_writer.sv)：写回器不再把向量拍数固定为两个，而是由 `VECTOR_BYTES` 推导每向量的六十四位数据拍数。十六字节向量仍为两拍，三十二字节向量为四拍；突发长度、读缓存索引、地址步长、`WLAST` 和尾部字节使能均按参数计算。
   - 修改 [`innovation_npu/rtl/gestureflow_layer_chain_hp0_axil.sv`](../innovation_npu/rtl/gestureflow_layer_chain_hp0_axil.sv)：写回器使用 `VECTOR_BYTES=OUT_LANES`，写回读取数据保持 `OUT_LANES*8` 位；片上中继和哈希兼容路径仍显式取低十六路，避免把两种接口混为一谈。
   - 修复四个核心测试台的 `read_bank_select` 未连接问题，并将旧的十八类头部输入分组从错误的二十组改为四十八通道对应的十二组：`tb_gestureflow_conv1x1_cin_stream.sv`、`tb_gestureflow_conv3x3_cin_same_stream.sv`、`tb_gestureflow_head1x1_tile_real.sv`、`tb_gestureflow_head1x1_gap_fc_real.sv`。
   - 新增 [`innovation_npu/tests/tb_gestureflow_hp0_tensor_writer_32b.sv`](../innovation_npu/tests/tb_gestureflow_hp0_tensor_writer_32b.sv) 和对应运行脚本，逐拍核对三十二通道向量的全部数据。

2. **已实际运行的验证。**
   - `run_gestureflow_conv1x1_cin_stream.sh`：四个输出通过。
   - `run_gestureflow_conv3x3_cin_same_stream.sh`：四个输出通过。
   - `run_gestureflow_head1x1_tile_hagrid18_real.sh`：144 个空间输出、7 个探针通过，`hash=a47fe7f7`。
   - `run_gestureflow_conv4x4_cin32_all32_real.sh`：2304 个输出、7 个探针通过，`hash=2015d083`。
   - `run_gestureflow_hp0_tensor_writer.sh`：十六字节兼容写回通过，5 个向量、1 个突发、80 字节。
   - `run_gestureflow_hp0_tensor_writer_32b.sh`：三十二字节写回通过，3 个向量、12 个六十四位数据拍。
   - `run_gestureflow_layer_chain_hp0_postprocess_hagrid18_out32.sh`：三十二路顶层无位宽截断警告并通过，`bursts=72 cycles=2880 gap=64 fc=18`。
   - `run_gestureflow_conv4x4_cin_full_layer_hagrid18.sh`：十八类整层仍通过，`quant_fnv1a=7e276c7b cycles=663861`。
   - `run_gestureflow_head1x1_gap_relay_real.sh`：头部到片上 GAP 中继通过，`pixels=144`。
   - `run_gestureflow_hp0_gap_fc_hagrid18_real.sh`：后处理仍通过，`gap=f109a7ae fc=22e52ddd class=1`。

3. **当前结论和边界。**
   - 三十二路计算结果到三十二字节 AXI 写回的 RTL 接口已经有行为级证据，不再存在原先的隐式低十六路截断。
   - 现有 [`gestureflow_hagrid18_main.c`](../innovation_npu/board_7020/software/gestureflow_hagrid18_main.c) 仍按十六路输出 tile、十六字节有效写回和旧的逐 tile 地址布局运行；因此三十二路尚未接入完整十八类软件调度，也没有新的综合、布局布线、比特流或板级 FPS 结果。
   - 三十二路写回器的测试不是三十二路整网性能证明。进入 Vivado 前必须先明确三十二路输出张量的存储布局、剩余输出通道的写回地址、`STORE_BYTES`/`STORE_VALID_BYTES` 和池化路径协议，再做软件与 RTL 的联合回归。

4. **下一步固定入口。**
   - 先增加一个短的三十二路描述符/写回联合回归，验证一层 `Cout=32` 的整块输出不丢通道，并与 Python 导出的逐字节 golden 对账。
   - 再将软件的 `first_oc += 16` 分支改为参数化的十六/三十二路两种调度，保持十六路板级回退路径不变；改动后必须重新跑整网快速回归。
   - 只有上述协议稳定后，才做一次 `OUT_LANES=32` 的有目标 OOC 综合/时序评估，再决定是否生成新比特流。不得把第 115 号的旧 `13.23 FPS` 或旧时序结果当作本轮结果。

## 115 2026-08-29 权重装载改为导出期打包 + WEIGHT_DMA 直读 .rodata，实板 13.23 FPS（较 release 基线再提速 17.5%）

**阅读顺序：先读本节；再读第 114 号了解 release 模式 11.26 FPS 基线。**

1. **这次真正完成的是什么。**
   - 根因：release 基线中 `weight_ticks=14.82 ms`，但 RTL `WEIGHT_DMA_STATUS` 实测 busy 仅约 0.69 ms；其余约 13.9 ms 是 ARM 在 uncached DDR 上逐 word 打包 23757 次权重。
   - 将权重打包从运行时移到导出期：`export_real_conv4x4_full_layer.py` 生成 `gf_*_weights_dma`（`oc -> tap -> 4-lane group`，每 word 为 4 个 int8 little-endian），所有数组加 `__attribute__((aligned(64)))` 以满足 HP0 8-byte 对齐要求。
   - `gestureflow_hagrid18_main.c` 删除 `gf_weight_dma_buf` 运行时打包循环，`weight_dma_load(src, words, taps, groups)` 直接以 packed .rodata 指针发起 WEIGHT_DMA，并在发起前 `Xil_DCacheFlushRange`。
   - 1×1 head 特殊处理：RTL pointwise 后端只读 tap 0，因此导出工具把 1×1 嵌入中心 tap 坍缩到 tap 0，C 驱动仍用 `taps=1, groups=12` 的单 tap descriptor，保持与原基线完全一致。

2. **实板成绩（release 模式，`FINAL_RESULT=0x600D600D`）。**
   - `PROBE[130] frame_ticks = 25,188,412`，按 XTime 1/3 ns tick 折算 `75.57 ms / 13.23 FPS`。
   - `PROBE[131] weight_ticks = 486,480`（含 bias/requant 寄存器配置与 DMA 等待）= `1.459 ms`。
   - `PROBE[132] weight_dma_ticks = 229,275`（纯 WEIGHT_DMA busy）= `0.688 ms`。
   - `PROBE[133] pl_cycles = 2,767,871`，@40MHz = `69.20 ms`；PS 侧剩余软件开销约 `6.37 ms`。
   - 对比第 114 号 release 11.26 FPS：`+17.5%`（1.175×），权重装载 14.82 ms → 1.459 ms。

3. **修改文件与已跑通的命令。**
   - `innovation_npu/tools/export_real_conv4x4_full_layer.py`：新增 `c_array_aligned`；所有 `gf_*_weights_dma` 对齐 64；pointwise 输出 center-tap-only。
   - `innovation_npu/board_7020/software/gestureflow_hagrid18_main.c`：`weight_dma_load` 化，删 `gf_weight_dma_buf`，首层/head/中间层全部直读 packed dma。
   - `innovation_npu/board_7020/software/gestureflow_real_*.h`、`gestureflow_chain_body_data.h`：重新导出，含 aligned `gf_*_weights_dma`。
   - 命令：`bash innovation_npu/tools/export_hagrid18_all_layers.sh` → `HAGRID18_ALL_LAYERS_EXPORT_PASS`；`bash innovation_npu/board_7020/build_software_hagrid18_from_wsl.sh` → ELF `a51b9`；`timeout 240s bash innovation_npu/board_7020/run_board_hagrid18_from_wsl.sh` → `GESTUREFLOW_HAGRID18_BOARD_PASS`。

4. **关键坑/注意事项（务必记住）。**
   - `static const uint32_t` 数组默认只 4-byte 对齐，HP0 AXI 会因地址非 8-byte 对齐报 WEIGHT_DMA fault（`STATUS=0x4`）。必须给导出的 packed 数组加 `aligned(64)`。
   - 1×1 head 的 dma 数组不能按 16-tap 传给 `load_conv_tile`：RTL pointwise_mode 把 `mac_tap` 固定为 0，16-tap 写法会让 tap 0 全零、GAP/FC FNV 错（`POST_FC_FNV` 偏离 golden）。必须坍缩 center tap 到 tap 0 并用 `taps=1`。
   - `.rodata` 可能被 D-cache 缓存；PL 发起 WEIGHT_DMA 前必须 `Xil_DCacheFlushRange(src, bytes)`，否则可能读到旧 cache 内容。

5. **下一步操作入口（固定顺序）。**
   - 单层权重驻留 + 双 bank ping-pong 预载（RTL，隐藏剩余 0.688 ms 纯 DMA busy，并为摄像头多帧场景去除重复装载）。
   - 接 OV5640 摄像头（DVP + VDMA + SCCB），把 `gf_rgb` 从固定 golden 改为实时帧。
   - 若先做时钟 40MHz→更高，需重跑 Vivado 时序并确认 WNS>0。

## 114 2026-08-28 18 类算法加 release 模式实板 11.26 FPS（跳过 proof 的 DDR 逐字节回读校验，提速 21%）

**阅读顺序：先读本节；再读第 113 号了解 18 类整网上板的 9.32 FPS 基线。**

1. **这次真正完成的是什么。**
   - `gestureflow_hagrid18_main.c` 加 `GF_FAST_RELEASE` 宏：release 模式下 `verify_full_tensor` 直接返回 1，跳过 proof 模式的 DDR 逐字节回读 + 软件 FNV 校验（PL 内部 `GF_OUTPUT_FNV1A` 寄存器校验保留，正确性仍逐层闭环）。
   - `build_software_hagrid18_from_wsl.sh` 加 `-DGF_FAST_RELEASE=1`。

2. **实板成绩（对比第 113 号）。**
   - proof 版：frame 107.34 ms / 9.32 FPS（PS 软件开销约 23.3 ms）。
   - release 版：frame 88.81 ms / **11.26 FPS**，`FINAL_RESULT=0x600D600D` 复现。PS 软件开销降到 4.79 ms，权重装载 14.82 ms、PL 纯计算 69.20 ms 不变。
   - 提速 1.21×。DDR 逐字节回读校验（约 320 KB 输出张量遍历）在 ARM 上确实占了约 18 ms，是 proof 模式的隐性开销。

3. **关键坑/注意事项。**
   - release 模式只跳过"软件 DDR 回读校验"，不能跳过 PL 内部 `GF_OUTPUT_FNV1A` 寄存器的逐层校验，否则失去逐层数值闭环。
   - 权重装载 14.82 ms（13.8%）和 PL 纯计算 69.20 ms（64.5%）仍是两大头；下一步优先做单层权重驻留 + 双 bank ping-pong 预载（隐藏 14.82 ms）。

4. **下一步操作入口。**
   - 单层权重驻留 + 双 bank ping-pong 预载（权重装载与计算重叠，预期 11.26 → 12+ FPS）。
   - 接 OV5640 摄像头（DVP 接口，需新增 VDMA + DVP 采集 + SCCB 初始化，工程量大，是"实时摄像头识别"的最后一步）。
   - 结果已提交 git；确认 `git -C coralnpu status --short` 干净。

## 113 2026-08-28 18 类手势识别算法实板跑通：FINAL_RESULT=0x600D600D，端到端 9.32 FPS（较 6 类提速 3.5 倍）

**阅读顺序：先读本节；再读第 112 号了解尾部参数化；再读 [GestureFlow 18类学生模型硬件契合度与创新方向 2026-08-28](GestureFlow_18类学生模型硬件契合度与创新方向_2026-08-28.md)。**

1. **这次真正完成的是什么（18 类整网上板，里程碑）。**
   - RTL 顶层：wide loader 从 40/80 改为 32/48（`tensor32_loader`/`tensor48_loader`），`MAX_INPUT_CHANNELS=48`，`input_group_count` 12/8/4/1；FC 参数 bank 从 16 扩到 18 宽，WCTRL 字段布局改为 oc=[4:0]/tap=[8:5]/ic_group=[13:9]（18 类 class 需 5 bit）；`hp0_gap_fc` 实例化 `CHANNELS=64, CLASSES=18, FC_GROUPS=16`。
   - 软件：`gestureflow_hagrid18_main.c` 完整驱动 18 类 7 卷积 + 3 pool + GAP(64) + FC(18)，逐层 FNV 对账；`export_hagrid18_all_layers.sh` 导出全部 golden。
   - Vivado：`build_gestureflow_hagrid18_7020.tcl`（MAX_INPUT_CHANNELS=48 + postprocess），40MHz，WNS=+1.175ns、WHS=+0.023ns、0 违例。

2. **实板最终成绩（真实运行，不是仿真）。**
   - `GESTUREFLOW_HAGRID18_FINAL_RESULT = 0x600D600D`，`GESTUREFLOW_HAGRID18_BOARD_PASS`。所有层 FNV 与 TFLite golden 全匹配（含 GAP=0xF109A7AE、FC=0x22E52DDD、class=1）。
   - 性能：端到端 **9.32 FPS**（frame 35,781,379 ticks ≈ 107.34 ms），PL 纯计算 2,767,875 cycles ≈ 69.20 ms @40MHz，权重装载 4,944,604 ticks ≈ 14.83 ms（占 13.8%）。
   - 对比 6 类 hybrid344 基线（2.62 FPS、权重 91.74ms）：**提速 3.5 倍**，权重装载降 84%。

3. **资源（18 类 NPU IP，`gestureflow_0`）。**
   - LUT 25,931（Logic 25,359）、FF 42,994、RAMB36 71、RAMB18 23、DSP 123。
   - 对比 6 类 wide80（LUT≈32K、RAMB36≈99、DSP 125）：RAMB36 省 28 个（48<80 通道的直接收益）。

4. **关键坑/注意事项（务必记住）。**
   - **pool 融合写回的 store_bytes 必须是 pool 后的 tile 字节**（pool2=24×24×16=9216，pool3=12×12×16=2304），不是卷积输出 tile 字节。写错会触发 `store_fault`（writer 的 `byte_count != pooled_vector_count * valid_bytes` 检查）。
   - `PROBE_BASE` 必须用 `0xFFFF0000`（不是 0x43C40000），与 XSCT 读取地址一致。
   - 顶层 FC 参数 bank 从 16 扩到 18 后，stream 引擎连接必须显式 `bias[15:0]`/`weight_write_oc[3:0]`（conv 只 16 lane），FC 用全 18 宽。
   - 实板诊断优先读 `STORE_STATUS`/`WEIGHT_DMA_STATUS`/`STATUS`（bit7=protocol_error||quant_fault, bit6=frame_input_done），不要只盯着 LAYER_MODE 残留值。

5. **下一步操作入口。**
   - 已达成"18 类算法上板真实运行"的目标，FPS 9.32 且权重装载占比仅 13.8%。
   - 后续创新方向（见契合度文档）：单层权重驻留 + 双 bank ping-pong 预载（进一步压权重装载 14.83ms）；摄像头实时数据流入；事件驱动推理。
   - 结果已提交 git；确认 `git -C coralnpu status --short` 干净。

## 112 2026-08-28 把硬件尾部参数化到 N 类：FC 分类器与 GAP/FC 后处理从 6 类/112 通道固化解耦，18 类 head/FC/GAP 全部 Verilator 回归通过

**阅读顺序：先读本节；再读第 111 号了解 18 类学生验收；再读 [GestureFlow 18类学生模型硬件契合度与创新方向 2026-08-28](GestureFlow_18类学生模型硬件契合度与创新方向_2026-08-28.md)。**

1. **这次真正完成的是什么（RTL 参数化 + 导出工具参数化 + 三组新回归）。**
   - `gestureflow_fc_classifier.sv`：`GAP_LANES`/`CLASSES`/`FC_GROUPS` 已是参数，`argmax6` 改为参数化 `argmax_n`，所有 class/group/index 位宽从硬编码 `[2:0]`/`[4:0]`/`[6:0]` 改为 `$clog2(...)`。
   - `gestureflow_hp0_gap_fc.sv`：新增 `CHANNELS`/`CLASSES`/`ELEMENTS`/`FC_GROUPS` 参数（原硬编码 112→6），`argmax6`→`argmax_n`，`gap_values_done`/`fc_values_done` 位宽改为 `$clog2(N+1)`。
   - `export_real_gap_fc.py`：GAP 通道数、FC 类别数、GAP elements 全部从模型 tensor 自动推断，不再硬编码 112/6/144；`GF_POST_*` 宏也参数化。

2. **已经实际跑通的回归（全绿，含向后兼容）。**
   - 6 类旧回归不变：`fc_classifier_real`（fc=dde32561 class=0）、`hp0_gap_fc_real`（gap=abbc5831 fc=dde32561 class=0）、`head1x1_gap_fc_real`（fc=dde32561 class=0）、`head1x1_tile_real`。
   - 新增 18 类回归：
     - `fc_classifier_hagrid18_real`：64→18 FC，`fc=22e52ddd class=1`。
     - `hp0_gap_fc_hagrid18_real`：12×12×64 → GAP(64) → FC(18)，`gap=f109a7ae fc=22e52ddd class=1`，cycles=1898（6 类 112 通道是 2906，减少 35%）。
     - `head1x1_tile_hagrid18_real`：48→64 head 第一个 16-lane tile，outputs=144 probes=7 hash=a47fe7f7。

3. **关键坑/注意事项（务必记住）。**
   - SystemVerilog 对 packed 数组 `[17:0][31:0]` 的聚合赋值 `'{a,b,...}` 会把第一个字面量赋给最高索引，导致 class 顺序整体反转；必须逐元素赋值 `fc_bias[0]=...; fc_bias[1]=...;`。
   - `$clog2(N)'(N)` 在 N 是 2 的幂时溢出（`$clog2(64)=6`，6 bit 表示不了 64），"已完成计数"输出要用 `$clog2(N+1)` 位宽；边界比较用 `int'(x) < N` 最稳。
   - 18 类模型 head 是 48 输入通道 = 12 组，`conv1x1_cin_stream` 的 `input_group_count` 必须传 12，不能沿用 6 类 head 的 20。
   - 导出工具用系统 `python3`（有 `tflite_runtime`），不是 venv（venv 只有 tensorflow，没有 tflite_runtime）。

4. **下一步操作入口。**
   - 剩余两个大工程（见契合度文档第 5 节）：输入通道宽度 32/48 参数化（当前 loader 只有 16/40/80），以及全模型权重驻留（92.9 KiB → 片上 BRAM，消除 91.74ms 权重装载）。
   - 先做输入通道 32/48：18 类模型 conv3/4/5 需要 32/48 输入通道，这是整网上板的前提；再验证 18 类整网逐层 FNV 与 TFLite golden 全匹配。
   - 之后做权重驻留，量化消除 91.74ms 装载的实际收益。

## 111 2026-08-28 18 类蒸馏学生训练完成并通过验收：浮点 98.88% / INT8 98.88%（84,354/85,311），全面超越 6 类主线

**阅读顺序：先读本节；再读第 110 号了解教师与学生启动；再读第 109 号了解方向纠正；配套硬件契合度见 [GestureFlow 18类学生模型硬件契合度与创新方向 2026-08-28](GestureFlow_18类学生模型硬件契合度与创新方向_2026-08-28.md)。**

1. **这次真正完成的是什么。**
   - 18 类 HaGRID 蒸馏学生训练完成（`regularized_plain`，4×4/4×4/4×4 通道 16/32/48 + 1×1 head 64，蒸馏自 MobileNetV3Large 教师 α=0.35 温度 3.0）。
   - 产物目录 `models/hagrid_v1_500k_384p_targethand_student_4x4_rvv_distill_20260827/`：`model.keras`（490,275 B）、`model_int8.tflite`（109,552 B）、`history.csv`、`labels.txt`、`keras_eval.json`、`tflite_eval.json`。

2. **最终验收结果（独立测试，唯一判定依据）。**
   - **浮点独立测试 84,356/85,311 = 98.8806%**；**全 INT8 独立测试 84,354/85,311 = 98.8782%**（`builtin_ref` 与 `builtin` 两种 resolver 一致，量化掉点仅 2 张）。
   - 训练最佳验证第 99 轮 `98.6583%`，末轮（第 114 轮）训练/验证 `97.3433% / 98.6342%`。验证 > 训练正是蒸馏 + MixUp + 标签平滑的正常现象。
   - 逐类准确率全部 ≥ 97.6%（最低 `peace` 97.71%、`three` 97.66%），无塌陷类。最易混淆对 `call→like` 66 张、`three→four` 46 张，符合手势语义相近的预期。
   - 对比：6 类原图主线 hybrid344 为 INT8 87.82%（1976/2250），18 类学生 INT8 98.88% 在更难的 18 类任务上大幅领先，且 MAC 少 41%、权重少 61%。

3. **训练中断的事实与处置。**
   - 训练进程以 EXIT_CODE=137（SIGKILL）结束，`dmesg` 确认是 OOM killer 杀死（python anon-rss 约 7.2GB，系统 11GB + 3GB swap）。不是正常早停，缺 `training_summary.json`。
   - 但 `ModelCheckpoint(save_best_only=True)` 已保存第 99 轮最佳权重到 `model.keras`（时间戳 15:25，早于 history.csv 末轮 17:23），验收用的是该 best checkpoint，结果有效。

4. **关键坑/注意事项。**
   - 学生模型 `model.keras` 含训练期 `RandomTranslation/RandomRotation/RandomZoom/RandomContrast` 增强层和 BN 层，量化脚本 `quantize_tflite.py` 能直接产出全 INT8 模型（109,552 B），但后续板端导出前仍需确认 BN 已折进卷积、增强层已剥离（这是下一轮导 golden 的入口）。
   - `builtin_ref` 逐张推理 85,311 张约需 38 分钟以上，必须用 `builtin` + `--batch_size 64` 重跑（约 73 秒）；不要再用默认 `builtin_ref` 评估大测试集。

5. **下一步操作入口（固定顺序）。**
   - 把 18 类模型逐层导出成板端 golden（`export_real_conv4x4_full_layer.py --model`、`export_real_gap_fc.py --model`），先 Verilator 回归确认 4×4/1×1/GAP/FC 四条路径都对。
   - 做 RTL 三处参数化（不碰 coralnpu）：输入通道宽度补 32/48、FC 6→18 类、GAP 112→64 通道。
   - 再做全模型权重驻留（92.9 KiB → 片上 BRAM），量化消除 91.74 ms 权重装载的实际收益。
   - 结果写记录并提交 git；确认 `git -C coralnpu status --short` 干净。

## 110 2026-08-28 教师训练完成（浮点独立测试 99.48%），18 类蒸馏学生训练已启动并持续运行

**阅读顺序：先读本节；再读第 109 号了解方向纠正与脚本；再读第 36/35 号了解 18 类训练原始参数。**

1. **教师训练已完成并安全落盘（不在 /tmp）。**
   - 教师模型目录：`models/hagrid_v1_500k_384p_targethand_mnv3large_teacher_20260827/`（持久目录，非 /tmp，不会被系统清理）。
   - `model.keras` SHA-256 = `9bc7bcc3addff0f1d2eae4b5da1a8c74d7f850d849643d3a7f0245cfb197bb15`；`labels.txt` = `6794f4b5f4094b98c301b82abe18634a6b29151dabf54f8103613f7bd40a453b`；`training_summary.json` = `df6ba575fa686f80e99b80f877e810278a9dfb0e96d4fe48d1ec58c34e280438`。
   - 18 类顺序：`call, dislike, fist, four, like, mute, ok, one, palm, peace, peace_inverted, rock, stop, stop_inverted, three, three2, two_up, two_up_inverted`。
   - **浮点独立测试 84,871/85,311 = 99.4842%**（`test_inference.accuracy`），`test_metrics.compile_metrics = 99.4854%`；最佳验证第 12 轮 `99.4597%`，末轮训练/验证 `98.6437% / 99.4597%`，实际跑了 16 轮（早停/最佳权重恢复）。精度远超"90% 以上"这一目标。

2. **学生蒸馏训练已启动并持续运行。**
   - tmux 会话 `hagrid18_student`，日志 `/tmp/train_hagrid18_student.log`。
   - 输出目录：`models/hagrid_v1_500k_384p_targethand_student_4x4_rvv_distill_20260827/`（持久目录）。
   - 已确认：数据 357,740 / 66,261 / 85,311（18 类）；教师加载成功（`temperature=3.0 alpha=0.35`）；进入 Epoch 1/120，5590 steps/epoch、约 80 ms/step（单 epoch 约 7.5 分钟 + 验证），`distill_loss`/`supervised_loss` 均下降。
   - 学生结构（已验证）：`conv1_4x4_a/b(16) → conv2_4x4_a/b(32) → conv3_4x4_a/b(48) → conv_head_1x1(64) → GAP → FC(18)`，总参数 95,954。

3. **下一步操作入口（训练结束后）。**
   - 用 `models/hagrid_v1_500k_384p_targethand_student_4x4_rvv_distill_20260827/training_summary.json` 与 `history.csv` 核对训练结果（关注独立测试准确率，而非仅验证准确率）。
   - 折叠部署（`export_repvgg_deploy.py`，本次学生是 `regularized_plain` 非 RepVGG，需先确认折叠脚本是否适用；若不适用直接量化原模型）、INT8 量化、全 INT8 独立测试评估。
   - 判定门槛以独立测试准确率为准；结果写记录 111 并提交 git；确认 `git -C coralnpu status --short` 干净。

## 109 2026-08-27 纠正上一轮方向错误：真正"训练一半没训完、蒸馏、教师 90%+"的是 18 类 HaGRID 蒸馏学生，已重建教师并启动恢复训练

**阅读顺序：先读本节；再读第 36/35 号确认 18 类训练原始参数；再读第 38 号确认"第 22 轮中断"的事实；第 108 号关于"主线是 hybrid344 蒸馏训练"的表述已被本节纠正。**

1. **上一轮方向错了，必须纠正。**
   - 上一轮把"当前主线"写成 6 类 `repvgg_hybrid344_..._noidentity_..._hagrid6_20260812` 并启动了一个 6 类 identity 训练（数据 `hagrid_sample_static_6cls`，10,500/2,250/2,250），这与用户记忆的模型完全不符。
   - 用户明确指认的模型特征是：**18 类、蒸馏训练、训练到一半没训完、教师精度 90% 以上、验证集准确率高于训练集**。这些特征精确对应第 36/35 号记录里的 18 类 HaGRID 目标手裁切蒸馏学生，而不是 6 类 hybrid344。
   - 第 108 号里"主线是 hybrid344 蒸馏训练（3×3 teacher）"这一句是错的：6 类 hybrid344 主线是原图六类（`hagrid_sample_static_6cls`），且第 29 号已记录其蒸馏候选 `distill3x3a35t2` 为 87.64%、低于主线 87.82% 被淘汰，因此主线本身不是蒸馏得到的。真正"蒸馏、训练一半"的对象是 18 类学生。

2. **真实目标模型（第 35/36/38 号）。**
   - 数据集：`datasets/processed/hagrid_v1_500k_384p_targethand_subject_split_20260815`，18 类目标手裁切、按 `user_id` 隔离，train 357,740 / val 66,261 / test 85,311（数据完好，仍在磁盘）。
   - 教师：ImageNet 预训练 MobileNetV3Large，浮点独立测试 **84,940/85,311 = 99.5651%**（远超 90%）。
   - 学生：96×96、18 类、普通卷积 4x4/4x4/4x4、通道 16/32/48、1×1 head 64，AdamW、lr 8e-4、余弦调度、MixUp 0.1/0.5、标签平滑 0.05、中等增强、蒸馏 α=0.35、温度 3.0、不缓存验证图。**训练在第 22 轮被人工中断**。
   - "验证集准确率高于训练集"是蒸馏 + MixUp + 标签平滑的正常现象：训练标签被 MixUp 混合、被标签平滑软化，训练集 acc 被压低；验证集用干净 one-hot，故验证 acc 可高于训练 acc。这不是数据不健康。

3. **资产丢失与恢复决策。**
   - 教师模型 `/tmp/hagrid_v1_500k_384p_targethand_mnv3large_teacher_20260815/model.keras` 与学生 checkpoint `/tmp/hagrid_v1_500k_384p_targethand_student_4x4_rvv_distill_20260815_nocache/` 均已因 `/tmp` 清理而丢失；已全盘搜索 `/tmp`、`/home`、`/mnt` 与 git 历史，无备份。
   - 恢复路径唯一：**重新训练教师 → 重新训练蒸馏学生**。数据、教师脚本、学生脚本均完好。

4. **已固化的可复现脚本。**
   - `algorithms/scripts/run_train_hagrid18_teacher.sh`：重建 18 类 MobileNetV3Large 教师（96×96、batch 128、冻结 3 轮 + 全骨干微调 20 轮、AdamW、wd 3e-4、标签平滑 0.05、中等增强、MixUp），输出 `models/hagrid_v1_500k_384p_targethand_mnv3large_teacher_20260827/`。
   - `algorithms/scripts/run_train_hagrid18_student_distill.sh`：重建 18 类蒸馏学生（`regularized_plain`、`body_kernel_schedule=4,4,4`、`stage_channels=16,32,48`、`head_channels=64`、`head_kernel_size=1`、lr 8e-4、MixUp 0.1/0.5、标签平滑 0.05、中等增强、蒸馏 α=0.35 温度 3.0），输出 `models/hagrid_v1_500k_384p_targethand_student_4x4_rvv_distill_20260827/`，依赖教师 `model.keras` 与 `labels.txt`。

5. **本轮已实际执行。**
   - 停止上一轮错误的 6 类 identity 训练进程（PID 66080/66081）。
   - 验证 GPU 可用（RTX 4060 Laptop，8GB）、ImageNet MobileNetV3Large 权重可下载、18 类数据集 357,740/66,261/85,311 完好。
   - 教师训练单步实测约 35 ms/step（batch 128），约 2 分钟/epoch，冻结 3 + 微调 20 共 23 轮约 45 分钟 + 验证。
   - 已用 `tmux` 会话 `hagrid18_teacher` 后台启动教师训练，日志 `/tmp/train_hagrid18_teacher.log`。

6. **下一步操作入口（固定顺序）。**
   - 监控教师训练至完成（`model.keras` + `labels.txt` 落盘，`training_summary.json` 记录 test accuracy）。
   - 教师完成后运行 `algorithms/scripts/run_train_hagrid18_student_distill.sh`（`tmux` 后台，日志 `/tmp/train_hagrid18_student.log`）。
   - 学生完成后做折叠部署、INT8 量化、全 INT8 独立测试评估，以独立测试准确率为唯一判定依据。
   - 结果写记录并提交 git；确认 `git -C coralnpu status --short` 干净。

## 108 2026-08-27 重新核对真实算法结构并单独归纳全景文档：静态主线是 hybrid344(3x3/4x4/4x4/1x1) 蒸馏训练，1×1 点积是最该补的硬件路径

**阅读顺序：先读本节；再读独立全景文档 [GestureFlow 算法与软硬件协同全景 2026-08-27](/home/steveguo/coralnpu-gesture/gesture_project/docs/GestureFlow_算法与软硬件协同全景_2026-08-27.md)；再按需回看第 97/104/106/107 号。**

1. **纠正一次错位。**
   - 之前把"当前板端 headers 的 golden 来源"（`static_cnn_4x4_w125`，全 4×4，INT8 83.47%，conv0 FNV=0xF49B1B48 与板端 `GF_FULL_OUTPUT_FNV1A` 一致）误当成了算法主线。
   - 真实静态硬件协同图像主线是 `repvgg_hybrid344_c16_48_80_h112_noidentity_pairedseed20260811_hagrid6_20260812`，部署结构 **3×3/4×4/4×4/1×1**，通道 16/48/80/112，**蒸馏训练**（3×3 teacher），**INT8 87.82%（1976/2250）**，训练在第 108 轮被人工停止（best 在第 82 轮），即"精度高但未训练完"的模型。
   - 更高精度图像参考线仍是 `repvgg_3x3_i96_hagrid6_tuned_20260731`，浮点 89.47%、INT8 89.02%（全 3×3，16/32/64/96）。

2. **动态算法确认。**
   - `algorithms/temporal_cnn/gesture_temporal_model.py`：`spatial 3x3/4x4 + spatial_embedding 1x1(96) + temporal_shift(零MAC) + per_frame GAP + summary(mean/max/delta)×3 + temporal_fusion 1x1(288→96) + Dense(96→14)`。时序靠 shift+summary，无大卷积堆叠、无循环状态。

3. **结论：最值得补的是稳定的 1×1 点积硬件路径，而非继续发散空间卷积核。**
   - 静态主线尾部 `conv6 1×1 80→112` 与动态 `embedding 1×1`、`fusion 1×1`、FC 都是点积。
   - 当前 1×1 复用 4×4 空间引擎的 `pointwise_mode`，1-tap 跑在 16-tap 窗口上，浪费 15/16 周期。
   - 方向：统一"空间 + 点积/归约"双模后端，独立 1×1 点积 tile（output_lane × input_group 直接 INT8 MAC 累加，不做滑窗/行缓存），与 `fc_classifier`/`hp0_gap_fc` 的 4-lane 归约统一。

4. **全景文档已落地并给出链接。**
   - 新增 `docs/GestureFlow_算法与软硬件协同全景_2026-08-27.md`：含算法结构、逐层 FNV golden、数据集分层、算法↔硬件映射表、1×1 缺口、论文级协同命题、下一步入口。

5. **下一步操作入口。**
   - 把主线 hybrid344 逐层导出成板端 golden（换 `export_real_conv4x4_full_layer.py --model`，先 Verilator 回归）。
   - `gestureflow_mac_tile` 加 3×3/4×4 tap 稀疏跳过，量化 3×3 层周期收益。
   - 立项独立 1×1 点积 tile + 统一归约后端，先 RTL 后综合看 DSP/BRAM 预算。

## 107 2026-08-27 GAP_MUL 再拆一级（零点和减法与 DSP48 分离），FCLK 32.727→40MHz，实板 FAST 约 4.83 FPS

**阅读顺序：先读本节；再读第 106 号理解主 requant 流水化；再读 `E:\coralnpu_vivado\projects\gestureflow_wide80_7020_v1\logs\gestureflow_wide80_7020_timing_impl.rpt`。** 这轮把 32.727MHz 下的最差路径（GAP 的 `gap_sum - zp*144` 减法与 high_mul 级联）再拆一级，把 FCLK 推到 40MHz 并实板复现。

1. **这次真正完成的是什么。**
   - RTL：`gestureflow_hp0_gap_fc.sv` 新增 `GAP_ADJ` 状态，把 `gap_sum[gap_index] - zp*144`（32 位减法）与 `high_mul`（DSP48 级联）拆成两级；`LOAD→GAP_ADJ→GAP_MUL→GAP_QUANT`。
   - 构建：FCLK `32.727272→40`（PS7 量化到精确 40MHz），RTL `FREQ_HZ 40000000`。

2. **资源/时序变化（40MHz，wide80+postprocess，全量 place/route）。**
   - 时序：WNS=+1.557ns、WHS=+0.021ns、0 违例；最差路径回到 `requant` 的 `chunk_mul_comb`（high_mul 的 64-bit `product+nudge` 加法，39 逻辑级，23.1ns），上限约 43MHz。
   - 资源与第 106 号持平（LUT≈32K、RAMB36≈99、DSP 125）。

3. **已经实际跑通的回归（全绿）。**
   - `axil_microkernel`、`conv4x4_cin_full_layer`、`layer_chain_hp0_axil/relay/postprocess`、`hp0_gap_fc_real`、`head1x1_gap_fc_real`、`fc_classifier_real`、`weight_residency`、`elab_no_relay` 全部 PASS。

4. **实板结果（最终成绩）。**
   - `GESTUREFLOW_LAYER_CHAIN_HP0_FINAL_RESULT = 0x600D600D`；FNV golden 匹配。
   - PROOF 模式：frame `0x06B1725F≈112.3M` ticks（32.727MHz 时 124.5M）。
   - 部署 FAST 模式：frame `0x041D8216≈69.0M` ticks（约 4.83 FPS，32.727MHz 时 76.8M/4.34 FPS）；weight `0x00534962≈5.46M`。

5. **关键坑/注意事项。**
   - 40MHz 下最差路径已回到 requant 的 high_mul（64-bit `product+nudge` 在 CARRY4 而非 DSP48 后加器），继续提频需把该 64-bit 加法也流水化或强制映射到 DSP48 后加器。
   - 改 FCLK 后必须同步改 `FREQ_HZ` 为 PS7 实际量化值（`{40}` 恰好精确 40MHz）。

6. **下一步操作入口。**
   - 频率已接近 43MHz 上限，单靠提频边际收益变小；下一步主攻 record 104 的 output_bank ring 化（K 行片上接力），消中间层 DDR 往返并给权重 SRAM 扩容铺路。
   - 板级软件改 `-DGF_FAST_RELEASE=1` 出部署 bit/ELF，实测部署端到端 FPS。

## 106 2026-08-27 主 requant 两级流水化：关键路径 29.7ns→24.4ns，FCLK 30→32.727MHz，实板复现 PASS，FAST 约 4.34 FPS

**阅读顺序：先读本节；再读第 105 号理解 30MHz 基线；再读 `E:\coralnpu_vivado\projects\gestureflow_wide80_7020_v1\logs\gestureflow_wide80_7020_timing_impl.rpt`。** 这轮把 30MHz 下真正的最差路径（主 requant 的 32x32 requantize）拆成两级流水，把 FCLK 再推到 32.727MHz 并实板复现。

1. **这次真正完成的是什么。**
   - RTL：重写 `gestureflow_requant_relu.sv`，把每 lane 的 requantize 拆成两级：stage1 寄存 `saturating_rounding_doubling_high_mul`（DSP48 级联），stage2 做 `rounding_divide_by_pot`+zero-point+saturate（CARRY4）。
   - 关键坑（已钉死）：把 high_mul 放进 `always_ff` 的 for 循环里按 `chunk_mul_result[lane_off]<=func(...)` 写 packed 数组，Verilator 会把 lane0 误编译成 0，导致 -128 饱和（正是 record 95 提过的"packed 数组变量索引写回"陷阱）。修复方式是让 high_mul 全部在 `always_comb`（`chunk_mul_comb`）里算好再寄存，避免 always_ff 内的 packed 元素函数写回。
   - 构建：FCLK `25→30→33`（PS7 实际量化到 32.727272MHz），RTL `FREQ_HZ 32727272`。

2. **资源/时序变化（32.727MHz，wide80+postprocess，全量 place/route）。**
   - 时序：WNS=+6.140ns、WHS=+0.025ns、0 违例；最差路径 24.4ns（原 29.7ns），逻辑级 56→39，上限约 41MHz。
   - 资源与第 105 号基本持平：LUT≈32K、RAMB36≈99、DSP 125（requant 仍 4-lane 时间复用，不新增 DSP 阵列）。

3. **已经实际跑通的回归（全绿）。**
   - `axil_microkernel`、`conv4x4_cin_full_layer`、`conv4x4_rgb_full_layer`、`layer_chain_hp0_axil/relay/pool_relay/postprocess/descriptor`、`hp0_gap_fc_real`、`head1x1_gap_fc_real`、`fc_classifier_real`、`weight_residency`、`elab_no_relay` 全部 PASS。

4. **实板结果（最终成绩）。**
   - `GESTUREFLOW_LAYER_CHAIN_HP0_FINAL_RESULT = 0x600D600D`；FNV golden 匹配。
   - PROOF 模式：frame `0x076C6F2B≈124.5M` ticks（30MHz 时 133.5M）；weight `0x00A7C758≈11.0M`。
   - 部署 FAST 模式：frame `0x049288E1≈76.8M` ticks（约 4.34 FPS，30MHz 时 81.5M/4.09 FPS）；weight `0x005D2876≈6.1M`。

5. **关键坑/注意事项。**
   - `always_ff` 内不要对 packed 数组元素做带变量的函数写回；requant 的 high_mul 必须在 always_comb 完成。
   - 改 `PCW_FPGA0_PERIPHERAL_FREQMHZ` 后 FCLK 会被 PS7 量化（33→32.727272），`FREQ_HZ` 必须写实际值，否则 BD validate 报 FREQ_HZ 不匹配。
   - requant 两级流水每向量多 1 拍（约 +1 cycle/vector），换来 ~9% 提频，净收益为正。

6. **下一步操作入口。**
   - 若再提频，先看 routed 最差路径是否仍是 requant 的 stage2（28 CARRY4 的 rounding_divide_by_pot），可再拆一级；否则把 output_bank ring 化（第 104 号）给权重 SRAM 扩容铺路。
   - 板级软件改 `-DGF_FAST_RELEASE=1` 出部署 bit/ELF，实测部署端到端 FPS。

## 105 2026-08-27 place/route 重新打通并实板验证：单 output_bank 释放 BRAM→权重 bank 回 BRAM，30MHz + FC 流水化 + 权重 DMA，端到端提速约 28.5%

**阅读顺序：先读本节；再读第 104 号理解资源总闸；再读 `E:\coralnpu_vivado\projects\gestureflow_wide80_7020_v1\logs\gestureflow_wide80_7020_timing_impl.rpt` 与 `gestureflow_wide80_7020_utilization_impl.rpt`。** 这一轮把第 104 号钉死的总闸真正落地，重新生成 bit/XSA/ELF 并下板，`FINAL_RESULT=0x600D600D` 复现通过，且端到端提速约 28.5%。

1. **这次真正完成的是什么（RTL + 板级软件 + 实板）。**
   - RTL：`gestureflow_layer_chain_hp0_axil.sv` 新增 `ENABLE_RELAY` 参数并参数化 relay/pool-relay 与第二输出 bank；板级构建 `ENABLE_RELAY=0` 时只实例化单个 2 端口 output_bank（56 RAMB36，而非 112）。
   - RTL：`gestureflow_hp0_gap_fc.sv` 把 FC requantize 拆成 `FC_MUL`（high_mul 寄存）+ `FC_QUANT`（round_div_pot/saturate），与 GAP 拆分对齐，砍掉 56 级组合链。
   - RTL 修复（record 102 遗留的 stale 接口）：`gestureflow_axil_microkernel.sv`、`gestureflow_conv4x4_rgb_same_layer.sv`、`gestureflow_body2_hp0_axil.sv` 恢复 2 端口 output_bank 接口/位宽。
   - 板级软件：`gestureflow_layer_chain_hp0_main.c` 把逐字 AXI-Lite 权重写改为 `WEIGHT_DMA` PL 突发装载（约 52K 字 → 26 次 DMA），并把已证伪的权重内容指纹改为唯一 doorbell key，消掉 DDR 逐字节 FNV 扫描。
   - 构建：`build_*.tcl` / `ooc_*.tcl` 加 `ENABLE_RELAY=0`、FCLK 25→30MHz、RTL `FREQ_HZ 30000000`。

2. **资源/时序变化（30MHz，wide80+postprocess）。**
   - 综合层次化：总 LUT `57385→32021`（<53200，60.2%），RAMB36 `130→99`（<140），DSP 125，FF 54188。
   - 根因验证：`output_weight_banks[0..15].weight_bank` 从 LUTRAM 11264（LUT-RAM 退化）回到 16 个 RAMB36；`mac_tile` LUT 17766→4543；`same_window.line_delay[0]` 1280 LUTRAM → BRAM。
   - place 成功（此前 `9403 slice required, 7452 available` 失败）；route 成功；WNS=+2.996ns、WHS=+0.043ns（30MHz，0 违例）。

3. **已经实际跑通的回归（全绿）。**
   - 全部 relay/store/descriptor/postprocess/head/gap/fc 主线回归 PASS；新增 `run_gestureflow_elab_no_relay.sh`（`GESTUREFLOW_ELAB_NO_RELAY_PASS`）覆盖 ENABLE_RELAY=0 单 bank 构建。

4. **实板结果（最终成绩）。**
   - `GESTUREFLOW_LAYER_CHAIN_HP0_FINAL_RESULT = 0x600D600D`；head/GAP/FC FNV `0x53C6484E/0xABBC5831/0xDDE32561` golden 匹配。
   - PROBE 计时（XTime，CPU 666.67MHz 全局定时器 1/2）：frame `0x07F44C77≈133.5M` ticks；weight `0x00BA1B39≈12.2M` ticks；pl_cycles `0x0043B487≈4.43M`。
   - 相对第 99 号基线（25MHz，frame≈186.56M，weight≈38.08M）：frame 提速约 28.5%，weight 约 68%。
   - 部署路径（`-DGF_FAST_RELEASE=1`，跳过 proof 层的 conv1_b/conv2b/conv3b 对比）同样 `FINAL_RESULT=0x600D600D`：frame `0x04DB4E50≈81.5M` ticks（约 4.1 FPS），weight `0x005D9B32≈6.1M` ticks。

5. **关键坑/注意事项。**
   - 改 FCLK 后必须同步改顶层 `FREQ_HZ`，否则 `validate_bd_design` 报 `FREQ_HZ does not match`。
   - `weight_dma_loader` 要求 `byte_count>>2 == 16*taps*groups`，且 source 8 字节对齐；部分 oc tile（如 conv2a/2b 末 tile 8 通道）必须补零到 16 oc，RGB 3 通道必须补第 4 通道为 0。
   - FC_MUL/FC_QUANT 拆分后 FC_QUANT 非末拍必须 `state<=FC_MUL`，否则只算 class0、其余复用 stale `fc_mul_result`。
   - `weight_fingerprint_tile` 内容 FNV 是每帧纯开销（驻留容量不可行），已改为唯一 domain key；不能退化为常量 key，否则同 key 连续 tile 会假命中跳权重。

6. **下一步操作入口。**
   - 短期：板级软件改用 `-DGF_FAST_RELEASE=1` 部署路径再测端到端 FPS（跳过 proof 层的 conv1_b/conv2b/conv3b 对比）。
   - 中期：把 output_bank 进一步 ring 化（第 104 号），释放更多 BRAM 给权重 SRAM 扩容，为真正跨帧常驻铺路。
   - 中期：FC_QUANT 的 38 级 CARRY4（round_div_pot）可再拆流水，把 30MHz 继续推向 33MHz。

## 104 2026-08-27 用层次化综合报告钉死最终资源账：output_bank 全帧 114 RAMB36 是总闸，ring 化可同时释放 BRAM 和 LUT-RAM

**阅读顺序：先读本节；再读 `E:\coralnpu_vivado\projects\gestureflow_wide80_7020_v1\logs\gestureflow_hier_util2.rpt`；再读第 103 号。** 这轮把每个模块的 LUT/BRAM/LUTRAM 精确到实例，找到了唯一的总闸。

1. **精确资源账（gestureflow IP，depth 8 层次化）。**
   - `output_bank`：`bank0` RAMB36=56、`bank1` RAMB36=56，合计约 112 RAMB36（2×16384×128bit 全帧）。
   - `stream.mac_tile`：`LUTRAM=11264`（16 个权重 bank，每个 1024×32bit=4KB，因 BRAM 已满被退化成分布式 RAM）。
   - `same_window.line_window.line_delay[0]`：`LUTRAM=1280`（首行缓存）；`line_delay[1/2]` 各 RAMB36=9。
   - `postprocess` 合计 13715 LUT（含 `hp0_tensor_loader` 3544 LUT，是第二大户）。
   - `tensor80_loader` LUTRAM=440、`tensor40_loader` LUTRAM=220。

2. **唯一总闸（真正的突破点）。**
   - `output_bank` 的全帧双 bank（约 112 RAMB36）吃掉了 130/140 的绝大部分 BRAM，把 16 个权重 bank 挤成 LUT-RAM（11264 LUT），又把总 LUT 顶到 57385。
   - 因此它不是“改小某个数”能解决，而是必须把 `output_bank` 从全帧双 bank 改成 **K 行 ring**：
     - output_bank：约 112 RAMB36 → 约 6 RAMB36（释放约 106）。
     - 权重 bank：0 BRAM → 约 16 RAMB36（释放 11264 LUT-RAM）。
     - 净效果：`BRAM 130 - 106 + 16 ≈ 40`，`LUT 57385 - 11264 ≈ 46121 < 53200`，place 通过。

3. **为什么之前会误判。**
   - 第 103 号曾把 13336 LUT-RAM 主因归于 80 通道行缓存，实际层次化报告显示主因是 `mac_tile` 的权重 bank（11264），行缓存只占 1280。这是本轮用 depth 8 报告纠正的关键点。

4. **下一步操作入口（唯一主线）。**
   - 把 `output_bank` 从“全帧写完后读”改成“生产者写行、消费者读窗”的 K 行 ring，producer/consumer 背压握手；`writer`、`relay_loader`、`pool_relay_loader` 都要改成流式消费。
   - 这是约 2~3 个模块的数据通路重写，完成后再把权重 bank 的 `ram_style="block"` 真正生效（BRAM 有余量后会自动映射）。

## 103 2026-08-27 已读综合报告：BRAM 已达标，LUT 超用来自 13336 LUT-RAM（RAMD64E 为主）和 809 控制集

## 103 2026-08-27 已读综合报告：BRAM 已达标，LUT 超用来自 13336 LUT-RAM（RAMD64E 为主）和 809 控制集

**阅读顺序：先读本节；再读第 102 号理解 2 端口改造；再读 `E:\coralnpu_vivado\projects\gestureflow_wide80_7020_v1\axi_gpio.runs\system_gestureflow_0_18_synth_1\system_gestureflow_0_18_utilization_synth.rpt`。** 这轮读了最新综合报告，把 LUT 超用的来源量化出来。

1. **资源现状（gestureflow IP 单独综合）。**
   - `RAMB36 = 130/140`（BRAM 已达标，第 102 号改造生效）。
   - `Slice LUTs = 47587/53200`（89.45%），其中 `LUT as Memory = 13336`（分布式 RAM）。
   - `Slice Registers = 53931`。
   - `DSP = 125/220`。

2. **LUT 超用的真实来源。**
   - 分布式 RAM 原语：`RAMD64E = 11264`，`RAMS64E = 1280`，合计约 12544 个，正好对应 13336 LUT-RAM。
   - 顶层全系统总 LUT 约 `57385`（IP 47587 + 系统 BD/smartconnect 约 10K），超过 53200。
   - place 报 `809` 个控制集，导致 FF 无法在 slice 里密集打包（需 9403 slice，仅 7452 可用）。注意“combined LUT 50721”其实已低于 53200，真正卡的是控制集导致的 slice 打包效率。

3. **关键判断。**
   - 13336 LUT-RAM 大概率来自 80 通道行缓存/窗口缓存：浅而宽（约 128 深 x 640 位）的内存即使标了 `ram_style="block"`，Vivado 也会退化为分布式 RAM（RAMD64E），这是 wide80 主路径 LUT 超用的主因。
   - relay 特性（双 bank + relay/pool loader）叠加 wide80 + postprocess，是 7020 资源紧张的结构性原因；第 102 号只解决了 BRAM，LUT 还需继续收。

4. **下一步操作入口（按收益排序）。**
   - 先降控制集（809）：统一复位/使能，把大量小状态机的 CE/复位合并，这能直接减少 slice 数量，比纯砍 LUT 更有效。
   - 再降 LUT-RAM：把 80 通道行缓存从“宽 640 位”改为“按通道拆成 80 个窄 BRAM”或更深的存储布局，使 Vivado 真正推断 BRAM，释放约 13K LUT；代价是可能多占 BRAM，需与 130/140 的余量一起权衡。

## 102 2026-08-26 output_bank 三端口改双端口已完成并全回归通过，BRAM 超用解除，但暴露出 LUT/控制集超用

## 102 2026-08-26 output_bank 三端口改双端口已完成并全回归通过，BRAM 超用解除，但暴露出 LUT/控制集超用

**阅读顺序：先读本节；再读第 101 号理解方案；再读第 100 号理解原始超用。** 这次把第 101 号的降资源方案真正落地了，功能全绿，资源从 BRAM 超用转为 LUT 超用。

1. **这次真正完成的是什么。**
   - `gestureflow_output_bank.sv` 改为单 bank 双端口（1 写 1 读），并保留 slice 分段（4 个 4096 深 slice）以兼容 Vivado。
   - `gestureflow_output_bank_pool_relay_loader.sv` 从“两个同时读口读左右两列”改为“单读口顺序读 4 个像素”（READ_TL/TR/BL/BR/PUSH）。
   - 顶层 `gestureflow_layer_chain_hp0_axil.sv` 实例化两个双端口 `bank0/bank1`，按 `output_write_bank_select` 与 `relay_read_bank_select` 路由读写。

2. **已经实际跑通的回归（全绿）。**
   - `run_gestureflow_layer_chain_relay_axil.sh`：`RELAY_AXIL_PASS layer0=f49b1b48 layer1=893afa60 pixels=9216`
   - `run_gestureflow_layer_chain_pool_relay_conv2a_axil.sh`：`POOL_RELAY_CONV2A_AXIL_PASS body=893afa60 conv2a_tile0=db73532c pixels=2304`
   - `run_gestureflow_layer_chain_hp0_postprocess.sh`、`layer_chain_descriptor_axil`、`layer_chain_hp0_axil`、`hp0_tensor_writer` 均 PASS。
   - 修复过程中发现顺序读池化第一版把 `pending_output_data` 与 FIFO 写同拍非阻塞，导致 hash 错；改为直接把 `max4_vectors(...)` 写入 FIFO 后通过。

3. **资源变化（全量 place）。**
   - `RAMB36` 超用已解除（不再报 224>140）。
   - 新阻塞：`LUTs 50721(combined) 57385(total) > 53200`，且 `809` 个控制集导致 slice 打包失败（需 9403 slice，仅 7452 可用）。FF 56238 未超，但控制集过多无法打包满 slice。

4. **关键坑/注意事项。**
   - 三端口 RAM 是 BRAM 超用主因，已确认；但 wide80+postprocess 配置本身 LUT 与控制集仍然超，这是下一步要收的资源项，不再被 BRAM 掩盖。

5. **下一步操作入口。**
   - 优先降控制集：减少低扇出使能/复位组合、合并小状态机、把组合 mux 收敛到寄存边界。
   - 若 LUT 仍超，考虑 80 通道 loader/行缓存的时间复用或分 bank，以及 postprocess 与主后端的资源共享。

## 101 2026-08-26 已精确定位 output_bank 的 3 端口 RAM 是 BRAM/LUT 超用根因，并给出精确降资源方案

**阅读顺序：先读本节；再读第 100 号理解资源超用；再读 `docs/权重驻留的架构真相_2026-08-26.md`。** 这次没盲目改，先把超用的精确机制和最小改动边界钉死。

1. **根因（已从 RTL 钉死）。**
   - 第 95 号把 `gestureflow_output_bank.sv` 改成“每个 slice 同时有 write + read + relay_read 三个端口”。Vivado 对 3 端口 RAM 无法直接推断为 block RAM，导致要么复制 BRAM、要么膨胀为 LUT-RAM，这就是 224 RAMB36 和 54515 LUT 同时超用的直接原因。
   - 真正需要 2 个同时读口的只有 `gestureflow_output_bank_pool_relay_loader`：它读 2×2 池化窗口的左右两列（ISSUE_TOP/CAPTURE_BOTTOM 各同时读 `addr` 与 `addr+1`）。

2. **最小降资源方案（下一步直接照做）。**
   - `gestureflow_output_bank` 改成单 bank、双端口（1 写 + 1 读），并保留 slice 分段以满足 Vivado（这是 git HEAD 的原始 25 行版 + 分段版合并）。
   - 顶层 `gestureflow_layer_chain_hp0_axil.sv` 实例化两个 `gestureflow_output_bank`（bank0/bank1），按 `output_write_bank_select` 和 `relay_read_bank_select` 路由读写；去掉 `.BANKS/.read_bank/.relay_read_*`。
   - `gestureflow_output_bank_pool_relay_loader` 从“两个同时读口读左右两列”改为“单读口顺序读 4 个像素”（top-left/top-right/bottom-left/bottom-right 各一拍），用 4 个寄存器缓存后做 max4。池化只占极小数据量，多几拍不影响吞吐。

3. **为什么这样做能达标。**
   - 把 3 端口 slice 换成 2 端口后，RAM 恢复为真实 BRAM 模板，RAMB36 会从 224 明显下降；同时消除 3 端口 LUT-RAM 膨胀，LUT 从 54515 下降。
   - 与第 100 号的 GAP requant 流水化叠加，才能在不超资源前提下重跑 place/route，量化 WNS 收益并尝试提频。

4. **本次未完成的原因（诚实记录）。**
   - 我已把 2 端口分段 `output_bank` 写出来，但顶层 2 bank 路由和 pool loader 顺序化会牵动 relay/pool relay 两条已验证链，剩余上下文不足以安全完成并逐条回归，故先把树恢复到可编译的 3 端口版，未留下半成品。

5. **下一步操作入口。**
   - 按上面第 2 条三处修改执行，先跑 `run_gestureflow_layer_chain_relay_axil.sh` 和 `run_gestureflow_layer_chain_pool_relay_conv2a_axil.sh` 确认 relay/pool relay 仍 golden，再跑全量实现看 RAMB36/LUT 是否降到 140/53200 以内。

## 100 2026-08-26 关键时序已定位并流水化 GAP requant，但全量实现被 BRAM/LUT 超用卡死

**阅读顺序：先读本节；再读第 95 号理解 `output_bank` 分段化；再读 `docs/权重驻留的架构真相_2026-08-26.md`。** 这次做了一处能提频的流水化，并暴露出一个会让后续任何新 bitstream 都下不了板的资源超用问题。

1. **这次真正完成的是什么。**
   - 修改 `gesture_project/innovation_npu/rtl/gestureflow_hp0_gap_fc.sv`：把 GAP requant 拆成 `GAP_MUL`（`high_mul` 寄存）和 `GAP_QUANT`（`round_div_pot + saturate` 寄存）两级，砍掉 38 个 CARRY4 加 4 个 DSP48 的长组合链。
   - 功能回归通过，golden 不变：
     - `GESTUREFLOW_HP0_GAP_FC_REAL_PASS cycles=2788 gap=abbc5831 fc=dde32561 class=0`
     - `GESTUREFLOW_LAYER_CHAIN_HP0_POSTPROCESS_PASS bursts=126 cycles=2788 progress=00001b81`

2. **根因定位/关键发现（阻塞项）。**
   - 跑全量 `build_gestureflow_wide80_7020.tcl` 时，在 `place_design` 前 DRC 直接失败：
     - `RAMB36/FIFO`：需要 224，器件只有 140（超 84）。
     - `RAMB18+RAMB36/FIFO`：需要 464，只有 280。
     - `Slice LUTs`：需要 54515，只有 53200（超 1315）。
   - 说明当前 RTL（第 95 号把 `output_bank` 改成双读口分段 BRAM 后）在 7020 上**根本放不下**，现有板上的 bit 是分段之前的旧版本，不是当前源码能复现的。

3. **已经实际跑通的回归。**
   - 见第 1 条两条 golden 回归；时序收益无法通过本次全量实现量化，因为资源超用先于 place 报错。

4. **资源/时序变化。**
   - 功能上 `cycles` 从 2676 增到 2788（+112 周期，正好是 112 通道各多一拍 GAP_MUL），25MHz 下仅约 +4.5us，换取关键路径拆分，方向正确。

5. **关键坑/注意事项。**
   - `output_bank` 全帧双 bank + 双读口是当前 BRAM 超用的主因，必须按架构路线 B2 改成 K 行 ring，否则任何后续实现都无法 place。
   - 第 95 号“OOC 综合通过”只代表 synthesis 过，不代表 place/route 过；DRC 资源门禁在 place 前就会拦下。

6. **下一步操作入口（最高优先级）。**
   - 先把 `output_bank` 从 `2x16384x128bit 双读口` 降为短生命周期 ring/line-buffer，把 RAMB36 压到 140 以内、LUT 压到 53200 以内。
   - 资源达标后再重新全量实现，才能量化 GAP requant 流水化带来的 WNS 提升，并尝试把 25MHz 提到 30-33MHz。

## 99 2026-08-26 板测流程已实跑通过（修复 hw_server 端口），并定位到“权重驻留不可行”的架构真相

**阅读顺序：先读本节；再读 `docs/板测流程复现与修复日志_2026-08-26.md` 看实板结果；再读 `docs/权重驻留的架构真相_2026-08-26.md` 看被文档带偏的 B1 判断。** 这次把“从 WSL 探板 -> 烧 bit -> 下载 ELF -> 轮询结果”整条链路真跑了一遍，并纠正了一个关键架构误判。

1. **这次真正完成的是什么。**
   - 修复 `gesture_project/innovation_npu/board_7020/run_board_wide80_postprocess_from_wsl.sh`：发现 `hw_server` 实际监听 `TCP:127.0.0.1:3121`，而脚本默认连 `3334`，已显式传入 `GESTUREFLOW_HW_SERVER_URL=tcp:127.0.0.1:3121`。
   - 新增只读探板脚本 `gesture_project/innovation_npu/board_7020/board_status.sh` 和 `scripts/probe_hw_targets.tcl`。
   - 新增 `docs/板测流程复现与修复日志_2026-08-26.md` 和 `docs/权重驻留的架构真相_2026-08-26.md`。

2. **实板结果。**
   - `FINAL_RESULT = 0x600D600D`，head/GAP/FC FNV 分别 `0x53C6484E/0xABBC5831/0xDDE32561`，`FULL_NETWORK_BOARD_PASS`。
   - 性能计数器：整帧约 186.56M ticks（约 560ms），权重/量化装载约 38.08M ticks（约 114ms），PL 周期 4,452,959。

3. **根因定位/关键发现（重要，纠正 B1）。**
   - 16×4 MAC tile 的权重 SRAM 只有 `2 bank x 16KB = 32KB`；整网有效权重约 200KB，最大单层 conv3b 约 100KB。因此“权重跨帧常驻”在当前硬件容量下根本不可能，原 B1 的 `2.62→3.42 FPS` 判断被文档带偏。
   - 当前板级软件的 `weight_prepare/commit` 指纹驻留实际是空转：硬件 `weight_resident_key` 只有单槽位，且软件未使用双 weight bank，导致每层必 miss，从未命中。

4. **纠正后的下一步操作入口。**
   - 短期：把板级权重装载从 `Xil_Out32(WCTRL/WDATA)` 逐字写改成 `WEIGHT_DMA` PL 突发装载，先消掉约 114ms 的 AXI-Lite 开销。
   - 中期：把 relay/output bank 从全帧 bank 改成 K 行 ring 释放 BRAM，再把 BRAM 还给权重 SRAM 扩容，才具备真正跨帧常驻的前提。

## 98 2026-08-26 补上权重驻留协议的硬门禁回归，并固化为架构级突破路线文档

**阅读顺序：先读本节；再读 `docs/GestureFlow架构级突破路线_2026-08-26.md` 理解 B1/B2/B3 三条主线和 WRSF 统一命题；再读第 97 号理解尾部融合后端。** 这次不是加功能，而是把最大单点瓶颈（每帧 91.74ms 权重重装）对应的硬件门禁用一条独立回归钉死。

1. **这次真正完成的是什么。**
   - 新增 `gesture_project/innovation_npu/tests/tb_gestureflow_weight_residency.sv` 与 `run_gestureflow_weight_residency.sh`：验证 `WEIGHT_KEY -> cold miss -> WEIGHT_COMMIT -> warm hit -> 命中后 WDATA 被拒绝` 的驻留协议。
   - 新增 `gesture_project/docs/GestureFlow架构级突破路线_2026-08-26.md`：把当前架构的三个真瓶颈（B1 权重重装、B2 全帧 bank/层间 DDR、B3 尾部割裂）固化为统一架构命题 WRSF（权重常驻 + 行缓存接力 + 融合尾部），并给出物理摆放岛、资源预算、落地顺序和板上验收链。

2. **根因定位/关键发现。**
   - 当前硬件其实已有 `weight_keyed_mode/weight_resident_valid/weight_key_hit` 和 `WEIGHT_KEY/HIT/MISS/BYTES/COMMIT`，但缺一条独立回归证明“命中后权重写被拒绝、命中计数只增一、未命中计数不再增加”。
   - 这次回归确认：cold miss 后 `miss_count=1`，commit 后 `resident_valid=1` 且 resident key 正确，再次写同 key 后 `hit_count=1`、`miss_count` 仍为 1，且命中后写 `WDATA` 会触发 fault。这正对应 B1 的硬件门禁。

3. **已经实际跑通的回归。**
   - `bash gesture_project/innovation_npu/tests/run_gestureflow_weight_residency.sh`
     - `GESTUREFLOW_WEIGHT_RESIDENCY_PASS miss=1 hit=1 resident=cafe1234`

4. **资源/时序变化。**
   - 本次只新增 testbench 和文档，未改 RTL，无综合，无板级资源/时序变化。

5. **关键坑/注意事项。**
   - 用小尺寸实例（`OUTPUT_ADDR_W=3`）复用顶层时，顶层 14 位内部 bank 连线会在小实例边界截断，产生 `WIDTHTRUNC/WIDTHEXPAND` 告警；与第 82 号 descriptor 回归一致，需用 `-Wno-WIDTHTRUNC -Wno-WIDTHEXPAND` 局部屏蔽，生产 96x96 实例不屏蔽。

6. **下一步操作入口。**
   - 把权重驻留从“寄存器协议回归”推进到“连续两帧整网回归”：cold frame 经 `WEIGHT_DMA` 装权重并 commit，warm frame 只写 key 不写权重，断言第二帧 `weight_write_count` 增量 0、两帧 FNV 相同。
   - 然后按架构文档顺序落地：顶层 `mode6` 融合尾部 -> relay ring 化 -> 生成 bitstream/XSA/ELF -> 7020 实板连续帧验收。

## 97 2026-08-26 归约/分类后端打通：新增可复用 `fc_classifier`，并完成真实 7 tile 的 `head1x1 -> GAP -> FC` 全片上尾部链

**阅读顺序：先读本节；再读第 96 号理解 `head_tile_gap_accumulator` 修正；再读 `docs/7020阶段_GestureFlow设计复盘与突破路线_2026-08-25.md` 第 7.6/7.7 节归约/分类后端路线；最后看 `gesture_project/innovation_npu/tests/run_gestureflow_head1x1_gap_fc_real.sh`。** 这次不是继续加 MAC，而是把 `head1x1 -> GAP -> FC` 这条最值钱的尾部链从"每层回 DDR"推进为"全片上、逐 tile GAP、最终 FC"，并用真实 golden 整链验收。

1. **这次真正完成的是什么。**
   - 新增 `gesture_project/innovation_npu/rtl/gestureflow_fc_classifier.sv`：可复用 112→6 INT8 全连接分类器。它把 `gestureflow_hp0_gap_fc.sv` 里已经 golden 验证过的 FC 部分抽成独立后端：folded bias + 4-lane 时间复用 MAC + LiteRT requantize + FNV + argmax，输入改为小写口（gap value write port），不再依赖 DDR loader。
   - 新增 `gesture_project/innovation_npu/tests/tb_gestureflow_fc_classifier_real.sv` 与 `run_gestureflow_fc_classifier_real.sh`：用真实 112 维 GAP golden + `fc.mem` 权重验证分类器，`fc=0xDDE32561 class=0`。
   - 新增 `gesture_project/innovation_npu/tests/tb_gestureflow_head1x1_gap_fc_real.sv` 与 `run_gestureflow_head1x1_gap_fc_real.sh`：真实整链回归。7 个 head_1x1 tile 由 `conv1x1_cin_stream` 产生、`requant_relu` 量化、`head_tile_gap_accumulator` 逐 tile 累加成 112 维 GAP，再喂给 `fc_classifier`，全程不写 12x12x112 中间张量回 DDR，最终 `fc=0xDDE32561 class=0`。

2. **根因定位/关键发现。**
   - `fc_classifier` 初版在 reset 里用 for 循环对 unpacked 数组做非阻塞清零，触发 Verilator `BLKLOOPINIT` 错误；同时若干参数宽度比较触发 `WIDTHEXPAND` 被当作 error。修法是去掉对 `gap_value`/`fc_weight` 存储数组的 reset 清零（它们使用前必被写口显式填满，与 `gestureflow_hp0_gap_fc.sv` 对 `fc_weight` 的处理一致），并对所有 `CLASSES/FC_GROUPS/GAP_LANES` 比较加显式位宽 cast。
   - 逐 tile 重放 `conv1x1_cin_stream` 时，`frame_start` 会正确复位内部 active/pending/mac_active/行列指针，因此 7 个 tile 可以在同一实例上顺序重放，无需额外复位。
   - `head_tile_gap_accumulator` 的 `gap_valid/gap_data` 已改为 sticky 寄存器输出，跨 tile 复用安全；每次 `start` 会复位累加器状态，逐个 tile 累加后写入 `fc_classifier` 的 gap buffer。

3. **已经实际跑通的回归。**
   - `bash gesture_project/innovation_npu/tests/run_gestureflow_fc_classifier_real.sh`
     - `GESTUREFLOW_FC_CLASSIFIER_REAL_PASS fc=dde32561 class=0`
   - `bash gesture_project/innovation_npu/tests/run_gestureflow_head1x1_gap_fc_real.sh`
     - `GESTUREFLOW_HEAD1X1_GAP_FC_REAL_PASS fc=dde32561 class=0`
   - 第 96 号记录中的两条回归仍为绿：
     - `GESTUREFLOW_HEAD_TILE_GAP_ACCUMULATOR_PASS pixels=4`
     - `GESTUREFLOW_HEAD1X1_GAP_RELAY_REAL_PASS pixels=144`

4. **资源/时序变化。**
   - 本次新增 `gestureflow_fc_classifier.sv` 和两个 testbench，未改顶层 `gestureflow_layer_chain_hp0_axil.sv`，未做 Vivado 综合，因此无板级资源/时序变化。
   - `fc_classifier` 复用现有 4-lane 时间复用 MAC 思路：FC 累加仅需少量乘法/加法，无新增大 DSP 阵列；112 个 GAP 值和 672 个 FC 权重为 FF/BRAM 级存储成本。

5. **关键坑/注意事项。**
   - Verilator 对 unpacked 数组在 for 循环里的非阻塞清零不支持（`BLKLOOPINIT`）；这类存储数组要么不改写，要么用 packed 数组，要么用显式逐项寄存器。
   - 参数宽度比较要显式 cast（`3'(CLASSES)`、`5'(FC_GROUPS)`、`7'(GAP_LANES)`），否则 `WIDTHEXPAND` 会被当作 error 中断。
   - `gf_head1x1_weights` 已包含完整 112 输出通道（`[112][16][80]`），不是只有首 tile；完整尾部链可直接用该 svh 跑 7 tile。

6. **下一步操作入口。**
   - 把 `gestureflow_head_tile_gap_accumulator` + `gestureflow_fc_classifier` 接入顶层 `gestureflow_layer_chain_hp0_axil.sv`，新增 `layer_mode=6`：`head1x1 -> GAP -> FC` 片上尾部链。顶层复用一个 `conv1x1_cin_stream` 主后端跑 7 tile，逐 tile 累加 GAP，最后调用 `fc_classifier`；PS 不再为尾部写回/回读 12x12x112 中间张量。
   - 之后再向前延伸到 `pool3 -> head1x1` relay，即可把 `pool3 -> head1x1 -> GAP -> FC` 整条尾部全部片上化，直接服务第 95 号记录里"最值钱"的 relay 目标。

## 96 2026-08-26 `head_tile_gap_accumulator` 完成并修正，`head1x1 -> GAP` 片上接力已用真实 golden 打通首个 tile

**阅读顺序：先读本节；再读第 95 号理解 `output_bank` 的 BRAM 压力和 relay 方向；再读 `docs/7020阶段_GestureFlow设计复盘与突破路线_2026-08-25.md` 第 7.6/7.7 节理解归约/分类后端路线；最后看 `gesture_project/innovation_npu/tests/run_gestureflow_head1x1_gap_relay_real.sh`。** 这次不是改卷积主后端，而是把已经在做的"tile 级 GAP 累加器"从半成品修到可用，并用真实 head1x1 首 tile 数据打通 `head1x1 -> GAP` 的片上接力证明。

1. **这次真正完成的是什么。**
   - 修复并完成 `gesture_project/innovation_npu/rtl/gestureflow_head_tile_gap_accumulator.sv`：tile 级 16-lane GAP 累加器，直接消费量化后的 head_1x1 tile 流，片上输出 16 个 GAP 值，不写 12x12x16 中间张量回 DDR。
   - 修复 `gesture_project/innovation_npu/tests/tb_gestureflow_head_tile_gap_accumulator.sv` 的两处 Verilator WIDTHTRUNC 宽度告警（`pixel_count`、`pixel_data` 赋值显式定宽）。
   - 新增 `gesture_project/innovation_npu/tests/run_gestureflow_head_tile_gap_accumulator.sh`。
   - 新增 `gesture_project/innovation_npu/tests/tb_gestureflow_head1x1_gap_relay_real.sv` 与 `gesture_project/innovation_npu/tests/run_gestureflow_head1x1_gap_relay_real.sh`：真实 head1x1 首 tile 的 `conv1x1_cin_stream -> requant_relu -> head_tile_gap_accumulator` 片上链式回归。

2. **根因定位/关键发现。**
   - 原 `gestureflow_head_tile_gap_accumulator.sv` 的 `gap_valid`/`gap_data` 是组合输出，只在 `EMIT` 一拍有效；而 `done` 是寄存器脉冲，比 `gap_valid` 晚一拍。因此出现"done 已置位但 gap_valid 已掉、gap_data 已清零"的接口错位，链式下游无法在 done 后稳定采样结果。
   - 修法：把 `gap_valid`/`gap_data` 改为寄存器输出，在 `EMIT` 一拍与 `done` 对齐打出并保持稳定（sticky），直到下一次 start/clear；`always_comb` 只保留 `gap_bias_correction`。
   - GAP 数值公式与已经 golden 验证的 `gestureflow_hp0_gap_fc.sv` 完全一致：`requantize(sum - input_zp * 144, mult, shift, output_zp)`。首 tile 16 个 GAP 值与 `export_real_gap_fc.py` 生成的 `gf_post_gap_golden[0:15]` 精确匹配。

3. **已经实际跑通的回归。**
   - `bash gesture_project/innovation_npu/tests/run_gestureflow_head_tile_gap_accumulator.sh`
     - `GESTUREFLOW_HEAD_TILE_GAP_ACCUMULATOR_PASS pixels=4`
   - `bash gesture_project/innovation_npu/tests/run_gestureflow_head1x1_gap_relay_real.sh`
     - `GESTUREFLOW_HEAD1X1_GAP_RELAY_REAL_PASS pixels=144`
   - 已重跑确认既有主线未被打坏：`run_gestureflow_layer_chain_relay_axil.sh`、`run_gestureflow_layer_chain_pool_relay_conv2a_axil.sh`、`run_gestureflow_head1x1_tile_real.sh`、`run_gestureflow_hp0_gap_fc_real.sh`、`run_gestureflow_axil_microkernel.sh`、`run_gestureflow_conv4x4_cin_full_layer.sh`、`run_gestureflow_conv3x3_cin_same_stream.sh`、`run_gestureflow_layer_chain_hp0_postprocess.sh`、`run_gestureflow_layer_chain_hp0_axil.sh`、`run_gestureflow_layer_chain_descriptor_axil.sh`、`run_gestureflow_layer_chain_head1x1_axil.sh` 均 PASS。

4. **资源/时序变化。**
   - 本次只新增独立 RTL 模块和 testbench，未改顶层 `gestureflow_layer_chain_hp0_axil.sv`，未做 Vivado 综合，因此无板级资源/时序变化。
   - `gestureflow_head_tile_gap_accumulator` 自身资源极小：16 个 INT32 累加 + 少量状态机控制，无新增 DSP 阵列；量化参数寄存器为 FF 级成本。

5. **关键坑/注意事项。**
   - `done` 与 `valid` 必须是同拍对齐的寄存器输出；不要把组合 `valid` 和寄存器 `done` 混用，否则下游在 `done` 后采样不到结果。
   - `head_tile_gap_accumulator` 的 `pixels_seen` 在累加完成时会把 `pixel_index` 归零，因此不能在 `done` 后用 `pixels_seen` 校验总数；应校验 `gap_valid` 和 `gap_data` 本身。

6. **下一步操作入口。**
   - 把 `head_tile_gap_accumulator` 接入顶层 `gestureflow_layer_chain_hp0_axil.sv`，新增 `layer_mode=6`：`head1x1 -> GAP -> FC` 片上尾部链，复用现有 `mode 5` pointwise 主后端 + 7 个 tile 的 GAP 累加，112 维 GAP 全部在片上累积后直接进入 FC，不再写 12x12x112 中间张量回 DDR。
   - 这一步落地后可把 `pool3 -> head1x1 -> GAP -> FC` 整条尾部做成 relay 链，直接服务第 95 号记录里"最值钱的 pool3 -> head1x1 接力"目标。

## 95 2026-08-26 `output_bank` 已改成可综合的分段 BRAM 结构，7020 OOC 综合重新打通，但 BRAM 成为下一阶段最高压力项

**阅读顺序：先读本节；再读第 94 号理解为什么要做 `body -> pool -> conv2a` 片上接力；再看 `E:\\coralnpu_vivado\\projects\\gestureflow_wide80_ooc_7020\\logs\\` 下这次新的 OOC 报告。** 这次不是新增算法功能，而是收掉一个会直接挡住后续综合/上板的真实硬件问题。

1. **根因不是新 pool relay 写错，而是旧 `output_bank` 的数组表达方式让 Vivado 直接拒绝综合。**  
   真实现象发生在：  
   - `bash gesture_project/innovation_npu/board_7020/run_ooc_gestureflow_wide80_synth_7020_from_wsl.sh`  
   第一次失败时，Vivado 在 `gesture_project/innovation_npu/rtl/gestureflow_output_bank.sv` 上报：  
   - `size of variable 'storage' is too large to handle`  
   也就是原来把整个 `2 bank x 16384 x 128bit` 当成一个大数组来描述，Verilator 可以跑，但 7020 的 Vivado OOC 综合不接受。

2. **这次已经实际修改的 RTL。**  
   修改文件：  
   - `gesture_project/innovation_npu/rtl/gestureflow_output_bank.sv`  
   新结构不是功能回退，而是把原来的大 bank 明确拆成：  
   - `gestureflow_output_bank_slice`  
   - 每个 slice 是 `4096 x 128bit`  
   - 顶层 `gestureflow_output_bank` 再按 `bank + slice` 做读写选择与返回数据 mux  
   这个改法的目的很明确：  
   - 保持现有双 bank、双读口语义不变；  
   - 让 Vivado 明确把它识别为 BRAM 模板，而不是超大变量。  
   这次 OOC 日志已经明确出现：  
   - `gestureflow_output_bank_slice:/storage_reg was recognized as a true dual port RAM template`

3. **改完后已经重新通过的行为回归。**  
   不是只改完就去跑综合，而是先重新验证功能：  
   - `bash gesture_project/innovation_npu/tests/run_gestureflow_layer_chain_pool_relay_conv2a_axil.sh`  
     - 输出：`GESTUREFLOW_LAYER_CHAIN_POOL_RELAY_CONV2A_AXIL_PASS body=893afa60 conv2a_tile0=db73532c pixels=2304`  
   - `bash gesture_project/innovation_npu/tests/run_gestureflow_layer_chain_relay_axil.sh`  
     - 输出：`GESTUREFLOW_LAYER_CHAIN_RELAY_AXIL_PASS layer0=f49b1b48 layer1=893afa60 pixels=9216`  
   所以这次分段 BRAM 化没有把：  
   - 原来的 `conv1 -> body` 直通打坏；  
   - 新的 `body -> pool -> conv2a(tile0)` 直通打坏。

4. **这次 7020 OOC 综合已经真正重新打通。**  
   实际重新执行：  
   - `bash gesture_project/innovation_npu/board_7020/run_ooc_gestureflow_wide80_synth_7020_from_wsl.sh`  
   最终输出：  
   - `GESTUREFLOW_WIDE80_OOC_PASS`  
   新报告产物路径：  
   - `E:\\coralnpu_vivado\\projects\\gestureflow_wide80_ooc_7020\\logs\\gestureflow_wide80_ooc_utilization.rpt`  
   - `E:\\coralnpu_vivado\\projects\\gestureflow_wide80_ooc_7020\\logs\\gestureflow_wide80_ooc_timing.rpt`  
   - `E:\\coralnpu_vivado\\projects\\gestureflow_wide80_ooc_7020\\logs\\gestureflow_wide80_ooc_drc.rpt`  
   - `E:\\coralnpu_vivado\\projects\\gestureflow_wide80_ooc_7020\\logs\\gestureflow_wide80_ooc_synth.dcp`

5. **这次必须记住的真实资源/时序结论。**  
   从这次新的 OOC 报告直接读取：  
   - 顶层 `gestureflow_layer_chain_hp0_axil`  
     - `Total LUTs = 39,585`  
     - `FFs = 43,808`  
     - `RAMB36 = 224`  
     - `RAMB18 = 16`  
     - `DSP Blocks = 107`  
   - 时序报告  
     - `Worst Setup Slack = 16.478ns @ 40ns period`  
     - `Worst Hold Slack = 0.206ns`  
   这说明两件事：  
   - **好消息**：分段 BRAM 化之后，OOC 综合和当前 `25MHz` 目标时序本身是站得住的；  
   - **坏消息**：当前这种“全帧双 bank + 双读口 + 128bit 全向量保存”会把 BRAM 压得非常高，已经成为继续做更深片上 relay 前的第一资源压力项。  
   也就是说，下一阶段最该反思的不是 DSP，而是 **如何降低 activation bank 的 BRAM 占用**。

6. **这次新增的操作注意事项。**  
   `run_ooc_gestureflow_wide80_synth_7020_from_wsl.sh` 这次虽然最终跑通，但开头仍会打印一段 Windows `UNC` 当前目录警告。  
   当前判断：  
   - 这是 `cmd.exe` 从 WSL 启动时的入口提示；  
   - 不影响后续 `pushd E:\\...` 之后真正进入 Windows 工程目录执行 Vivado；  
   - 但后续如果要继续减少这种干扰，优先考虑把 `cmd.exe /c` 外层调用改成更彻底的 Windows 侧固定起始目录方式，而不是忽略它。

7. **下一步的最优先判断。**  
   现在不该直接继续把 bank 做得更大、更宽。  
   当前最高优先级应该变成：  
   - 研究如何把 `output_bank` 从“全帧全保留”进一步缩成更短生命周期的 tile/ring 结构；  
   - 或者先把最值钱的 `pool3 -> head1x1` 接力做成更小工作集的 bank；  
   - 总之要在继续增加层间片上直通收益的同时，把 BRAM 占用从当前这种高水位压下来。  
   这一步的核心结论就是：**片上直通方向是对的，但 bank 组织必须继续进化，不能停留在粗粒度全帧缓存。**

## 94 2026-08-26 `body -> pool -> conv2a(tile0)` 片上输入接力已打通，池化后输入不再从 DDR 读回

**阅读顺序：先读本节；再读第 93 号理解第一版 `conv1 -> body` bank 直通；再读 `gesture_project/innovation_npu/tests/run_gestureflow_layer_chain_pool_relay_conv2a_axil.sh`。** 这次不是继续放大计算阵列，而是把现有 `2x2 maxpool` 直接嵌进 bank 读侧，让下一层卷积直接吃片上池化结果。

1. **这次新增的是“池化后输入接力”，不是把旧 writer 的 pooling 模式换个名字。**  
   新增 / 修改文件：  
   - `gesture_project/innovation_npu/rtl/gestureflow_output_bank_pool_relay_loader.sv`  
   - `gesture_project/innovation_npu/rtl/gestureflow_layer_chain_hp0_axil.sv`  
   - `gesture_project/innovation_npu/tests/tb_gestureflow_layer_chain_pool_relay_conv2a_axil.sv`  
   - `gesture_project/innovation_npu/tests/run_gestureflow_layer_chain_pool_relay_conv2a_axil.sh`  
   - 以及所有显式列出 RTL 源文件的已有回归 / 7020 构建脚本  
   `gestureflow_output_bank_pool_relay_loader.sv` 做的事情是：  
   - 从 `output_bank` 两个独立读口同时取 `2x2` 池化窗口的上排 / 下排；  
   - 在片上做 `16 lane INT8 maxpool`；  
   - 把池化后的 `48x48x16` 张量直接重放成下一层输入流。  
   顶层 `gestureflow_layer_chain_hp0_axil.sv` 新增了 `RELAY_CONTROL` 的 bit3：  
   - bit0：启用 relay 输入  
   - bit1：从哪个 bank 读  
   - bit2：当前层输出写到哪个 bank  
   - bit3：relay 输入阶段是否先做 `2x2 pooling`  
   也就是这次已经从“直接读 bank”推进到了“读 bank 后直接变成下一层需要的 pooled tensor”。

2. **这次最关键的设计细节是：pool relay 只在自己真正忙的时候占用 bank 读口。**  
   修改点在 `gesture_project/innovation_npu/rtl/gestureflow_layer_chain_hp0_axil.sv`：  
   - 新增 `relay_pool_bank_owner = relay_pool_busy`；  
   - 只有当 `relay_pool_loader` 正在工作时，`output_bank.read` / `output_bank.relay_read` 两个读口才切给它；  
   - `relay_pool_busy` 结束后，读口自动还给原来的 `store` 或普通 relay 路径。  
   这里必须记住：如果直接按 `relay_pool_mode` 常态占有读口，会把后面的写回阶段挡住，这个坑这次已经主动绕开。

3. **这次回归验证的不是“功能像是对了”，而是“conv2a 输入真的没再走 HP0”。**  
   新回归：  
   - `bash gesture_project/innovation_npu/tests/run_gestureflow_layer_chain_pool_relay_conv2a_axil.sh`  
   输出：`GESTUREFLOW_LAYER_CHAIN_POOL_RELAY_CONV2A_AXIL_PASS body=893afa60 conv2a_tile0=db73532c pixels=2304`  
   这条回归做了三段真实链路：  
   - `conv1`：只写 bank0，不写 DDR；  
   - `body`：从 bank0 读、写 bank1，不走 DDR；  
   - `conv2a tile0`：从 bank1 直接读取 pooled 输入，同时把自己的 tile0 结果正常写 DDR。  
   回归额外硬检查：  
   - 第三段 `conv2a tile0` 输入期间，如果出现任何 `m_axi_arvalid/m_axi_rvalid`，立即报错；  
   - 最终 `tile0` 的 FNV 哈希必须等于 `0xdb73532c`；  
   - 写回到 DDR 的 `48x48x16` tile0 每个字节都逐点对账 `generated_gestureflow_real_conv4x4_conv2a_layer.svh`。  
   这说明这次不是“池化先存 DDR 然后再装作 relay”，而是真正把输入回读砍掉了。

4. **这次同步确认没有把旧主线改坏。**  
   重新实际跑通：  
   - `bash gesture_project/innovation_npu/tests/run_gestureflow_layer_chain_relay_axil.sh`  
     - 输出：`GESTUREFLOW_LAYER_CHAIN_RELAY_AXIL_PASS layer0=f49b1b48 layer1=893afa60 pixels=9216`  
   - `bash gesture_project/innovation_npu/tests/run_gestureflow_layer_chain_descriptor_axil.sh`  
     - 输出：`GESTUREFLOW_TOP_DESCRIPTOR_CONTEXT_PASS issued=2 completed=2 write_beats=32`  
   - `bash gesture_project/innovation_npu/tests/run_gestureflow_layer_chain_hp0_axil.sh`  
     - 输出：`GESTUREFLOW_LAYER_CHAIN_HP0_CONV2B_AXIL_PASS layer0_cycles=260750 layer1_cycles=703247 pool_cycles=691727 conv2a=df95d5cf conv2b=94c745e4`  
   也就是说：  
   - 原有 `conv1 -> body` 直接 relay 还活着；  
   - 描述符门铃链没有被 `RELAY_CONTROL` 新 bit 搞坏；  
   - 原来的 DDR 写回 / pool 写回主线也仍然是绿的。

5. **这次的结构判断，后面不要忘。**  
   对当前 7020 主线，这一步比“继续加更多 MAC”更值钱，因为它第一次把“片上池化结果就是下一层输入”做成了真实运行态。  
   紧接着最值得接的两条线是：  
   - `pool3 -> head1x1`：把尾部 `1x1` 头部输入也改成 bank relay；  
   - `conv2a -> conv2b`：评估 40 通道链路是否值得做 bank 化或更细粒度 tile handoff。  
   当前最不该做的事仍然是：在还没把高频中间张量搬运压下去之前，就盲目继续放大主 MAC 阵列。

## 93 2026-08-25 片上 `relay bank` 第一版已打通，`conv1 -> body` 不再走中间 DDR 往返

**阅读顺序：先读本节；再读第 92 号理解为什么 writer/bank 先要稳；再读 `gesture_project/innovation_npu/tests/run_gestureflow_layer_chain_relay_axil.sh`。** 这次改动的核心不是继续加大 MAC，而是把第一层输出保存在片上的双 bank 里，让第二层直接从 bank 读，不再先写 DDR 再从 DDR 读回。

1. **这次真正新增的是 `relay bank` 的第一版运行态，而不是把旧 writer 改名。**  
   新增 / 修改文件：  
   - `gesture_project/innovation_npu/rtl/gestureflow_output_bank.sv`  
   - `gesture_project/innovation_npu/rtl/gestureflow_output_bank_relay_loader.sv`  
   - `gesture_project/innovation_npu/rtl/gestureflow_layer_chain_hp0_axil.sv`  
   - `gesture_project/innovation_npu/tests/tb_gestureflow_layer_chain_relay_axil.sv`  
   - `gesture_project/innovation_npu/tests/run_gestureflow_layer_chain_relay_axil.sh`  
   `output_bank` 现在支持双 bank，并增加了独立 `relay` 读口；`layer_chain` 里新增 `RELAY_CONTROL`，用于控制：  
   - bit0：是否启用 relay 模式  
   - bit1：第二层从哪个 bank 读  
   - bit2：当前层输出写到哪个 bank  
   这样第一层可以写 bank0，第二层可以读 bank0、写 bank1，避免中间激活被覆盖。

2. **这次回归验证的是“真直通”，不是只看 hash。**  
   新回归：  
   - `bash gesture_project/innovation_npu/tests/run_gestureflow_layer_chain_relay_axil.sh`  
   输出：`GESTUREFLOW_LAYER_CHAIN_RELAY_AXIL_PASS layer0=f49b1b48 layer1=893afa60 pixels=9216`  
   这条回归额外检查了：  
   - 第二层运行期间 `m_axi_arvalid / m_axi_rvalid / m_axi_awvalid / m_axi_wvalid / m_axi_bready` 都不能再冒出来；  
   - 也就是第二层确实没有再走 HP0 中间 DDR 往返。  
   这里要记住：relay 不是提前结束，真正完成仍然要等输出写回和哈希 drain 完成，所以前面一版把 `relay_done` 当整层结束信号是错的，已经收掉。

3. **这次的结构判断。**  
   这版 relay 的价值在于它已经把“层间搬运”从外部 DDR 转到片上 bank。对当前 7020 主线，下一步更有价值的是：  
   - 把 relay 继续扩成 `pool -> head1x1`、`conv -> pool` 这种高频链路；  
   - 再根据真实瓶颈决定是否把 bank 继续做成更细的局部接力，而不是盲目扩大 MAC。  
   这条线比继续做只增吞吐不减搬运的改动更符合当前阶段的收益。

## 92 2026-08-25 `HP0 writer` 连续写回突发从 4 向量扩大到 8 向量，主线快速回归与 40 通道 handoff 已重新通过

**阅读顺序：先读本节；再读第 91 号了解 `requant` 窄并行化为什么成立；再读 `gesture_project/docs/7020阶段_GestureFlow设计复盘与突破路线_2026-08-25.md` 新增的第 14 节。** 本节改动都在项目自研目录 `gesture_project/innovation_npu/`，不是 Google 官方只读仓库 `coralnpu/`。

1. **这轮收的是真实写回吞吐，不是单纯“改一点 testbench”。**  
   修改文件：  
   - `gesture_project/innovation_npu/rtl/gestureflow_hp0_tensor_writer.sv`  
   当前 `writer` 原来在连续 `16B vector` 写回模式下，固定一次只打 `4` 个向量，也就是 `8 beat` 一个 AXI burst。  
   这次把它改成参数化的：  
   - 新增 `MAX_BURST_VECTORS` 参数，默认从 `4` 提到 `8`；  
   - 连续写回模式下允许一次发 `8 vector = 16 beat`；  
   - 同时把 `burst_vectors / burst_beats / burst_read_index / burst_beat_index` 的位宽都改成按参数推导；  
   - 相关比较、索引和地址推进全部改成严格同宽写法，避免 Verilator 宽度告警和后续综合歧义。  
   这一步的目的很明确：减少 AW/B 往返和突发头开销，让“已经在片上的向量写回 DDR”更接近真实带宽上限。

2. **这次还顺手收掉了一个之前容易误导后续对话的测试不一致。**  
   修改文件：  
   - `gesture_project/innovation_npu/tests/tb_gestureflow_layer_chain_hp0_axil.sv`  
   这条“真实两层 HP0 handoff”回归本来要跑到 `conv2a/conv2b`，也就是实际 `40` 输入通道的链路；  
   但 testbench 实例此前仍按默认 `MAX_INPUT_CHANNELS=16`、`ENABLE_WIDE_MODES=0` 建顶层。  
   这会让 testbench 声称自己在测 `40` 通道链路，但实例配置却不是那条链。  
   现在已明确改成：  
   - `.MAX_INPUT_CHANNELS(40)`  
   - `.ENABLE_WIDE_MODES(1'b1)`  
   所以后续如果再看这条回归，要记住：它现在才真正对应 `conv2a/conv2b` 这条 40 通道 handoff 主线。

3. **这次同步修改并重新通过的回归。**  
   直接相关的 writer 回归：  
   - `bash gesture_project/innovation_npu/tests/run_gestureflow_hp0_tensor_writer.sh`  
     - 输出：`GESTUREFLOW_HP0_TENSOR_WRITER_PASS vectors=5 bytes=80 bursts=1`  
     - 对比原先 `5` 个向量需要 `2` 个 burst，现在已经收敛成 `1` 个 burst。  
   - `bash gesture_project/innovation_npu/tests/run_gestureflow_hp0_tensor_writer_boundary.sh`  
     - 输出：`GESTUREFLOW_HP0_TENSOR_WRITER_BOUNDARY_PASS bursts=2 beats=10`  
     - 说明这次扩大 burst 深度后，`4KB` 边界切分仍正确，没有越界拼成非法 AXI burst。  
   相关主线回归：  
   - `bash gesture_project/innovation_npu/tests/run_gestureflow_layer_chain_descriptor_axil.sh`  
     - 输出：`GESTUREFLOW_TOP_DESCRIPTOR_CONTEXT_PASS issued=2 completed=2 write_beats=32`  
   - `bash gesture_project/innovation_npu/tests/run_gestureflow_layer_chain_hp0_axil.sh`  
     - 输出：`GESTUREFLOW_LAYER_CHAIN_HP0_CONV2B_AXIL_PASS layer0_cycles=260750 layer1_cycles=703247 pool_cycles=691727 conv2a=df95d5cf conv2b=94c745e4`  
   - `bash gesture_project/innovation_npu/tests/run_gestureflow_layer_chain_head1x1_axil.sh`  
     - 输出：`GESTUREFLOW_LAYER_CHAIN_HEAD1X1_AXIL_PASS hash=00004802 tile_bytes=2304 full_stride=112`  
   - `bash gesture_project/innovation_npu/tests/run_gestureflow_layer_chain_hp0_postprocess.sh`  
     - 输出：`GESTUREFLOW_LAYER_CHAIN_HP0_POSTPROCESS_PASS bursts=126 cycles=2676 progress=00001b81`

4. **这轮新增的结构判断。**  
   `HP0 writer` 的这次改动之所以值得保留，不只是因为“小测试过了”，而是因为它符合当前 7020 主线的总体原则：  
   - 不增加主计算阵列；  
   - 不额外占大块 BRAM；  
   - 不把长组合逻辑塞回主 MAC 路径；  
   - 但能真实减少 layer handoff 时的外部写事务数量。  
   对当前项目，这比“再盲目加宽一条计算通路”更符合 CoralNPU 值得借鉴的地方：  
   **优先把系统级搬运和执行解耦做好，再把资源投向真正有复用收益的数据流结构。**

## 91 2026-08-25 `gestureflow_requant_relu.sv` 的 4 路时间复用版已修正，快速回归重新全绿

**阅读顺序：先读本节；再读第 90 号了解为什么先收 `postprocess` 真正关键路径；再读 `gesture_project/docs/7020阶段_GestureFlow设计复盘与突破路线_2026-08-25.md` 新增的第 13 节。** 本节所有动作都在项目自研目录 `gesture_project/innovation_npu/`，不是 Google 官方只读仓库 `coralnpu/`。

1. **这次真正收掉的阻塞点是什么。**  
   第 90 号记录之后，`gesture_project/innovation_npu/rtl/gestureflow_requant_relu.sv` 被改成了 `PARALLEL_LANES = 4` 的时间复用版，目的是把原来 `16 lane` 全并行的 `32x32 requant` 缩窄，好给 7020 后续更有价值的结构留出 DSP 和布线余量。  
   但第一版时间复用写法有行为错误，已经实测出现：  
   - `run_gestureflow_axil_microkernel.sh` 报 `requant lane 0 got=-128 expected=-123`  
   - `run_gestureflow_conv4x4_cin_full_layer.sh` 报 `got=-128 expected=-124`  
   - `run_gestureflow_head1x1_tile_real.sh` 报 `got=-128 expected=-115`  
   - `run_gestureflow_layer_chain_head1x1_axil.sh` 报 tile hash mismatch  
   当时的错误现象不是随机，而是大量落到 `-128` 饱和边界。

2. **根因已经通过隔离仿真钉死，不是顶层误接。**  
   这次先把 `gestureflow_requant_relu.sv` 单独拎出来喂真实 fixture，确认：  
   - 同一组输入下，模块内部 `requantize_lane()` 函数返回值本身是对的，`lane0` 应为 `-123`；  
   - 但旧时间复用实现写回 `out_data[lane_index]` 后，真实输出却变成了错值。  
   也就是说，问题不在 LiteRT 数值公式，不在 `multiplier/right_shift/zero_point` 本身，而在**时间复用实现里对 packed 数组做变量索引写回**这一层。这个坑如果不明确记住，后面继续做更深流水或更窄并行时还会重踩。

3. **已经实际修改的 RTL 与修法。**  
   修改文件：  
   - `gesture_project/innovation_npu/rtl/gestureflow_requant_relu.sv`  
   这次没有把 `4 lane` 时间复用直接回退掉，而是把有风险的写法换成更稳的结构：  
   - `pending_psum / pending_multiplier / pending_right_shift / pending_lane_enable` 从 packed 数组改成 unpacked 数组寄存；  
   - 先在 `chunk_data_comb` 里只计算当前 `4 lane chunk` 的结果；  
   - 再用**常量 lane 位置**回写 `out_data[lane]`，不再依赖旧的 packed 变量索引写法；  
   - `config_error` 仍保持 sticky 语义。  
   这一步保住了“4 路时间复用节省资源”的方向，同时把当前已证实会出错的写法清掉。

4. **这次已经实际跑通的快速回归。**  
   先做隔离模块校验：  
   - 自建单模块 Verilator 隔离用例输出：`isolated out0=-123 out1=-128 out2=-128 out3=-128`  
   再压项目主线回归：  
   - `bash gesture_project/innovation_npu/tests/run_gestureflow_axil_microkernel.sh`  
     - 输出：`GESTUREFLOW_AXIL_MICROKERNEL_DMA_PASS full_cycles=263 dma_cycles=263 rgb_cycles=23 carry_cycles=8 lane0=-2147483648 lane15=13263`  
   - `bash gesture_project/innovation_npu/tests/run_gestureflow_conv4x4_cin_full_layer.sh`  
     - 输出：`GESTUREFLOW_CONV4X4_CIN_FULL_LAYER_PASS outputs=9216 probes=7 quant_fnv1a=893afa60`  
     - 周期：`GESTUREFLOW_CONV4X4_CIN_FULL_LAYER_CYCLES=663860`  
   - `bash gesture_project/innovation_npu/tests/run_gestureflow_head1x1_tile_real.sh`  
     - 输出：`GESTUREFLOW_HEAD1X1_TILE_REAL_PASS outputs=144 probes=7 hash=02be4ffb`  
   - `bash gesture_project/innovation_npu/tests/run_gestureflow_layer_chain_head1x1_axil.sh`  
     - 输出：`GESTUREFLOW_LAYER_CHAIN_HEAD1X1_AXIL_PASS hash=00004802 tile_bytes=2304 full_stride=112`  
   - `bash gesture_project/innovation_npu/tests/run_gestureflow_layer_chain_hp0_postprocess.sh`  
     - 输出：`GESTUREFLOW_LAYER_CHAIN_HP0_POSTPROCESS_PASS bursts=126 cycles=2676 progress=00001b81`  
   - `bash gesture_project/innovation_npu/tests/run_gestureflow_conv3x3_cin_same_stream.sh`  
     - 输出：`GESTUREFLOW_CONV3X3_CIN_SAME_STREAM_PASS outputs=4`  
   - `bash gesture_project/innovation_npu/tests/run_gestureflow_hp0_gap_fc_real.sh`  
     - 输出：`GESTUREFLOW_HP0_GAP_FC_REAL_PASS cycles=2676 gap=abbc5831 fc=dde32561 class=0`

5. **这次最重要的新判断。**  
   `conv4x4` 全层周期从此前正确基线的 `663856` 变成 `663860`，只增加了 `4` 个周期。这个结果很关键：  
   - 说明 `requant` 改成 `4 lane` 时间复用后，并没有把整层主吞吐拉垮；  
   - 额外代价主要出现在向量尾部 drain，而不是每个输出都被 requant 卡住；  
   - 也就证明当前“先把非主瓶颈的后处理从盲目宽并行改成窄并行”这条方向是成立的。  
   后续如果继续做 `relay bank / 权重生命周期 / spatial + reduce 双模`，可以优先从这类**不压主吞吐、却能回收 DSP 和路由压力**的结构入手。

## 90 2026-08-25 基于全量 RTL 审计与 routed 报告确认关键路径后，先收掉 postprocess 哈希长路径

**阅读顺序：先读本节；再读第 89 号确认 `wide80 + postprocess` 当前板级 PASS 基线；再读 `gesture_project/docs/7020阶段_GestureFlow设计复盘与突破路线_2026-08-25.md` 中新增的“晚间全量审计”结论。** 本节所有改动都在项目自研目录 `gesture_project/innovation_npu/`，不是 Google 官方只读仓库 `coralnpu/`。

1. **这轮不是拍脑袋“继续修 requant”，而是先用真实实现报告把最差路径钉死。**  
   重新检查 `E:\\coralnpu_vivado\\projects\\gestureflow_wide80_7020_v1\\axi_gpio.runs\\impl_1\\system_wrapper_timing_summary_routed.rpt` 后，当前 routed `WNS = +0.564ns` 的最差 setup 路径不在主 `MAC tile`，而在：  
   - `system_i/gestureflow_0/inst/gen_postprocess.postprocess/gap_index_reg[*]`  
   - 到 `gap_hash_work_reg[*]` 的 `postprocess` GAP 哈希路径。  
   报告明确显示这条路径串了 `requantize + fnv_step`，逻辑层级高达 `62~64`，并跨过 `4` 个 `DSP48E1`。所以当前若还把精力放在“主卷积是不是唯一关键路径”上，就是判断失真。

2. **已经实际修改的 RTL。**  
   修改文件：  
   - `gesture_project/innovation_npu/rtl/gestureflow_hp0_gap_fc.sv`  
   这次做的是结构性拆分，不是表面语法修补：  
   - 把原来单状态 `GAP` 改成 `GAP_QUANT -> GAP_HASH` 两段；  
   - 量化结果先落到 `gap_quantized_pending` / `gap_value[]`，下一拍再做 `fnv_step`；  
   - `FC` 路径继续保留独立 `FC_QUANT -> FC_HASH` 两段，不再让量化和哈希混在同一拍。  
   目标很明确：先把当前真实最差路径上的“量化 + 乘法哈希”长组合链拆掉，再考虑下一批资源/时序重构。

3. **这轮已经实际重新跑通的两条回归。**  
   - `bash gesture_project/innovation_npu/tests/run_gestureflow_hp0_gap_fc_real.sh`  
     输出：`GESTUREFLOW_HP0_GAP_FC_REAL_PASS cycles=2676 gap=abbc5831 fc=dde32561 class=0`  
   - `bash gesture_project/innovation_npu/tests/run_gestureflow_layer_chain_hp0_postprocess.sh`  
     输出：`GESTUREFLOW_LAYER_CHAIN_HP0_POSTPROCESS_PASS bursts=126 cycles=2676 progress=00001b81`  
   说明这次结构拆分没有改坏：  
   - `GAP FNV = 0xABBC5831`  
   - `FC FNV = 0xDDE32561`  
   - 顶层 `postprocess` 流水和进度寄存器仍然闭环。  
   与第 89 号记录相比，`postprocess` 周期从 `2564` 增到 `2676`，正好对应这次为了收时序额外插入的状态拍数；这是可接受的结构换时序，不是性能意外退化。

4. **这轮全量审计后新增的高优先级判断，后面不要忘。**  
   - 当前 `7020` 主线真正最值得做的，不是继续无序扩 MAC，而是先把**浪费 DSP 但并不在吞吐瓶颈上的并行后处理**收紧。  
   - 特别是 `gestureflow_requant_relu.sv` 当前按 `16 lane` 全并行做 `32x32` requant，但主卷积后端对单个输出向量的产生间隔远大于 `1` 拍；这意味着后续很可能可以把 requant 改成更窄、更深流水的时间复用结构，用节省下来的 DSP/时序余量换真正有收益的 relay / prefetch / 双模计算改造。  
   - 下一批优先重构对象应按顺序考虑：  
     1. `gestureflow_requant_relu.sv` 的并行度与流水深度重构；  
     2. `gestureflow_layer_chain_hp0_axil.sv` 的顶层拆责；  
     3. relay bank / 层间直通；  
     4. `weight residency` 从 key 雏形升级到真实生命周期控制。

## 89 2026-08-25 `wide80 + postprocess` 新实现完成、平台与软件重建完成、7020 实板整网 PASS

**阅读顺序：先读本节；再读第 88 号确认共享 `1x1 pointwise` 已并回主后端；再读 `gesture_project/docs/7020阶段_GestureFlow设计复盘与突破路线_2026-08-25.md` 对照当前 7020 主线结构。** 本节所有工程动作都发生在项目自研目录 `gesture_project/innovation_npu/` 及 Windows 工程 `E:\\coralnpu_vivado\\projects\\gestureflow_wide80_7020_v1`，不是 Google 官方只读仓库 `coralnpu/`。

1. **这轮真实完成的不是“又一次构建尝试”，而是完整的新实现到实板闭环。**  
   先用 `gesture_project/innovation_npu/board_7020/run_build_gestureflow_wide80_7020_from_wsl.sh` 驱动 `wide80` 工程继续实现，再用项目侧状态探针脚本确认当前 Vivado 工程内真实状态：  
   - `impl_1` 先后经过 `place_design 50%`、`route_design 75%`，最终达到 `write_bitstream Complete!`；  
   - `system_gestureflow_0_16_synth_1`、`system_axi_smc_12_synth_1`、`synth_1` 全部 `PROGRESS=100%`；  
   - `report_ip_status` 明确显示当前工程里的 `system_gestureflow_0_16` 与 `system_axi_smc_12` 都是 `Up-to-date`。  
   这一步已经证明前面担心的“顶层没有真正吃到新 IP”在当前这轮实现里已经被收掉，不能再把早先 `impl_1/runme.log` 里混杂的旧 `0_14/10` 片段当成这轮失败结论。

2. **这轮必须记住的关键坑：`impl_1` 真跑成了，但默认日志命名没有自动跟上。**  
   当前 `gesture_project/innovation_npu/board_7020/build_gestureflow_wide80_7020.tcl` 是在 `build_gestureflow_layer_chain_hp0_7020.tcl` 基础上做字符串替换得到的，结果是：  
   - 新的 `axi_gpio.runs/impl_1/system_wrapper.bit`、`system_wrapper_routed.dcp` 确实更新到了 `2026-08-25 23:21`；  
   - 但 `logs/gestureflow_wide80_7020.bit`、`logs/gestureflow_wide80_postprocess_7020.bit` 等文件名不会自动跟着这次新 `impl_1` 时间戳刷新；  
   - 旧日志目录里保留的是本轮之前的旧版本时间戳，容易误判成“实现没有吃到新结果”。  
   这次是项目侧手动把以下新产物同步到正式命名后，后续链路才继续跑通：  
   - `axi_gpio.runs/impl_1/system_wrapper.bit -> logs/gestureflow_wide80_postprocess_7020.bit`  
   - `axi_gpio.runs/impl_1/system_wrapper_routed.dcp -> logs/gestureflow_wide80_postprocess_7020_routed.dcp`  
   - 再执行 `gesture_project/innovation_npu/board_7020/run_export_wide80_postprocess_xsa_from_wsl.sh` 导出新的 `logs/gestureflow_wide80_postprocess_7020.xsa`。  
   后续如果重新构建 `wide80`，不要只看 `logs/*.bit` 的旧时间戳；要先核对 `impl_1` 的真实状态和 `system_wrapper.bit/routed.dcp` 的时间戳。

3. **当前这版 7020 新实现的资源和时序边界已经落地。**  
   直接从 `E:\\coralnpu_vivado\\projects\\gestureflow_wide80_7020_v1\\axi_gpio.runs\\impl_1` 当前新报告读取：  
   - `system_wrapper_utilization_placed.rpt`：  
     - `Slice LUTs = 39,271 / 53,200 = 73.82%`  
     - `Slice Registers = 52,388 / 106,400 = 49.24%`  
     - `Block RAM Tile = 107 / 140 = 76.43%`  
     - `DSP48E1 = 180 / 220 = 81.82%`  
   - `system_wrapper_timing_summary_routed.rpt`：  
     - `Setup WNS = +0.564 ns, TNS = 0`  
     - `Hold WHS = +0.040 ns, THS = 0`  
   - `runme.log` 末尾：  
     - `DRC finished with 0 Errors, 340 Warnings`  
     - 主要告警类型是 `DRC DPOP-2`，指向 `requant` 和少量 loader/store 乘法路径没有打开更深 DSP 流水寄存。  
   当前结论很明确：这版已经能在 7020 上稳定过实现并上板，但资源已接近高水位，特别是 `DSP=81.82%`、`BRAM=76.43%`、`WNS=+0.564ns`，后续任何继续扩张硬件结构的动作都必须先考虑 DSP/BRAM 和时序余量，不能再默认“还有很多富余”。

4. **新的 `bit/xsa/elf` 已经成组生成并用于实板。**  
   本轮实际使用的三件产物是：  
   - `E:\\coralnpu_vivado\\projects\\gestureflow_wide80_7020_v1\\logs\\gestureflow_wide80_postprocess_7020.bit`  
     - 时间：`2026-08-25 23:22:40`  
     - `SHA-256 = 878d0d00a1cd0275f9e859cc3ddb3a926ff5b5612130c3a52c227c4ca81b44f6`  
   - `E:\\coralnpu_vivado\\projects\\gestureflow_wide80_7020_v1\\logs\\gestureflow_wide80_postprocess_7020.xsa`  
     - 时间：`2026-08-25 23:23:14`  
     - `SHA-256 = f5bcf386c513df7239b3af544ac6113b7e75304bb255f2e1e43b0021968cc5bf`  
   - `E:\\coralnpu_vivado\\projects\\gestureflow_wide80_7020_v1\\vitis\\axi_gpio_80cin_postprocess\\Debug\\gestureflow_layer_chain_hp0_80cin_postprocess.elf`  
     - 时间：`2026-08-25 23:24:15`  
     - `SHA-256 = 635071a023d0e43fb542ca4ac20bee495df353175e7f9e73b364a52935f08af5`  
     - `arm-none-eabi-size`：`text=902373 data=1144 bss=709264 dec=1612781 hex=189bed`

5. **平台、软件、实板三条链都已实际重新跑通。**  
   实际执行过：  
   - `bash gesture_project/innovation_npu/board_7020/run_create_wide80_postprocess_platform_from_wsl.sh`  
     - 输出：`GESTUREFLOW_WIDE80_POSTPROCESS_PLATFORM_PASS`  
   - `bash gesture_project/innovation_npu/board_7020/build_software_wide80_postprocess_from_wsl.sh`  
     - 重新生成当前 `80Cin + postprocess` ELF  
   - `bash gesture_project/innovation_npu/board_7020/run_board_wide80_postprocess_from_wsl.sh`  
     - 真实烧录新 `bit`、加载新 `xsa`、下载新 `elf` 到 7020 实板执行。  
   这次不是只做平台/软件编译，也不是只停留在 `impl_1` 完成。

6. **当前 7020 实板整网已经 PASS，并且探针链条是完整的。**  
   本轮板测最终输出：  
   - `GESTUREFLOW_LAYER_CHAIN_HP0_FINAL_RESULT = 0x600D600D`  
   - `GESTUREFLOW_LAYER_CHAIN_HP0_FULL_NETWORK_BOARD_PASS`  
   关键探针结果包括：  
   - `PROBE[08] = 0xF49B1B48`：`conv1_a` 完整输出 FNV  
   - `PROBE[22] = 0x6518BC59`：`pool1` 完整输出 FNV  
   - `PROBE[32] = 0xDF95D5CF`：`conv2_a` 完整输出 FNV  
   - `PROBE[42] = 0x94C745E4`：`conv2_b` 完整输出 FNV  
   - `PROBE[52] = 0x1770E9FB`：`pool2` 完整输出 FNV  
   - `PROBE[68] = 0x26B89256`：`conv3_a` 完整输出 FNV  
   - `PROBE[84] = 0xEA998550`：`conv3_b` 完整输出 FNV  
   - `PROBE[100] = 0x8EF3B2CB`：`pool3` 完整输出 FNV  
   - `PROBE[122] = 0x53C6484E`：`head_1x1` / 尾部整合后的关键输出 FNV  
   - `PROBE[124] = 0xABBC5831`：GAP FNV  
   - `PROBE[125] = 0xDDE32561`：FC FNV  
   - `PROBE[126] = 0x00001B80`、`PROBE[127] = 0x00001B81`：postprocess 进度  
   这说明当前 `shared 3x3/4x4/1x1 backend + 80Cin body + postprocess` 这条 7020 主线已经形成真实可复现板级闭环。

7. **下一次继续时的操作入口已经很明确。**  
   当前若只是复现这次通过结果，优先顺序应固定为：  
   - 先检查 `E:\\coralnpu_vivado\\projects\\gestureflow_wide80_7020_v1\\axi_gpio.runs\\impl_1` 是否已有新的 `system_wrapper.bit`、`system_wrapper_routed.dcp`；  
   - 若重新实现完成但 `logs/gestureflow_wide80_postprocess_7020.*` 没更新，先手动同步 `bit/routed.dcp`，再执行 `run_export_wide80_postprocess_xsa_from_wsl.sh`；  
   - 再执行 `run_create_wide80_postprocess_platform_from_wsl.sh`；  
   - 再执行 `build_software_wide80_postprocess_from_wsl.sh`；  
   - 最后执行 `run_board_wide80_postprocess_from_wsl.sh`。  
   当前不要再回到 40-Cin、旧 `wide80` 旧时间戳产物，或把 `logs/gestureflow_wide80_7020.*` 和 `logs/gestureflow_wide80_postprocess_7020.*` 混着用。

## 88 2026-08-25 共享空间后端已并入 `1x1 pointwise` 运行态，顶层 `head_1x1` 新模式和 ARM 软件编译一起打通

**阅读顺序：先读本节；再读第 87 号确认独立 `1x1` 原型与真实 tile 回归已通过；再读 `gesture_project/docs/7020阶段_GestureFlow设计复盘与突破路线_2026-08-25.md` 中关于“双模 MAC 主后端”的判断。** 本节全部变更都在项目自研目录 `gesture_project/innovation_npu/` 和 `gesture_project/innovation_npu/board_7020/software/`，不是 Google 官方 `coralnpu/`。

1. **这轮解决的不是“再加一个 `1x1` 模块”，而是把 `1x1` 真正并回共享主后端。**  
   修改 `gesture_project/innovation_npu/rtl/gestureflow_conv4x4_cin_same_stream.sv`，新增运行态 `pointwise_mode`：  
   - 空间 `3x3/4x4` 仍走原 `same_window` 行缓存/滑窗路径；  
   - `1x1` 时绕开滑窗，仅本地保持一个像素向量；  
   - 仍复用同一套 `gestureflow_mac_tile.sv`；  
   - `mac_tap` 固定为 `tap0`，只遍历 `Cin group`；  
   - INT32 部分和仍留在原共享 tile 内，没有复制第二套 MAC 阵列。  
   这一步的目标就是避免在 7020 上为了 `head_1x1` 再并一整套后端，造成 DSP/BRAM 资源和布局布线压力双重上升。

2. **顶层已经给 `head_1x1` 分出真实新模式。**  
   修改 `gesture_project/innovation_npu/rtl/gestureflow_layer_chain_hp0_axil.sv`：  
   - 新增 `wide80_mode = (layer_mode == 3 || layer_mode == 5)`；  
   - 新增 `pointwise_mode = (layer_mode == 5)`；  
   - `layer_mode == 5` 复用现有 `80` 通道 HP0 loader；  
   - 共享 stream 实例在 `mode 5` 下进入点积语义；  
   - `selected_pixel` 改成显式逐 lane 赋值，避免 80 通道版本再依赖 Verilator 的静默零扩展。  
   这样当前顶层的 `head_1x1` 已经不再伪装成旧 `mode 3` 空间卷积。

3. **真实 `head_1x1` 顶层回归已经通过。**  
   新增：  
   - `gesture_project/innovation_npu/tests/tb_gestureflow_layer_chain_head1x1_axil.sv`  
   - `gesture_project/innovation_npu/tests/run_gestureflow_layer_chain_head1x1_axil.sh`  
   实际执行：  
   - `bash gesture_project/innovation_npu/tests/run_gestureflow_layer_chain_head1x1_axil.sh`  
   输出：  
   - `GESTUREFLOW_LAYER_CHAIN_HEAD1X1_AXIL_PASS hash=00004802 tile_bytes=2304 full_stride=112`  
   这条回归验证的是：  
   - HP0 从真实 `pool3` 张量读入；  
   - 共享主后端以 `mode 5` 运行真实 `head_1x1`；  
   - writer 以 `stride=112`、`valid_bytes=16` 把 tile0 稀疏写回 DDR；  
   - 每个像素 `lane0..15` 与真实 golden 完全一致，`lane16..111` 没被误覆盖。  
   注意这里终端打印里的 `hash=00004802` 是脚本最后复用 `value` 变量打印了 `STORE_STATUS`，不是 `OUTPUT_FNV1A`；真正检查过的 `OUTPUT_FNV1A` 已与 testbench 内部计算的 tile FNV 一致。

4. **旧主线没有被这轮改坏，已重新压过四条回归。**  
   这轮在修改共享主后端和顶层后，重新实际跑过：  
   - `bash gesture_project/innovation_npu/tests/run_gestureflow_conv3x3_cin_same_stream.sh`  
     输出：`GESTUREFLOW_CONV3X3_CIN_SAME_STREAM_PASS outputs=4`  
   - `bash gesture_project/innovation_npu/tests/run_gestureflow_head1x1_tile_real.sh`  
     输出：`GESTUREFLOW_HEAD1X1_TILE_REAL_PASS outputs=144 probes=7 hash=02be4ffb`  
   - `bash gesture_project/innovation_npu/tests/run_gestureflow_conv4x4_cin_full_layer.sh`  
     输出：`GESTUREFLOW_CONV4X4_CIN_FULL_LAYER_PASS outputs=9216 probes=7 quant_fnv1a=893afa60`  
     并保持：`GESTUREFLOW_CONV4X4_CIN_FULL_LAYER_CYCLES=663856`  
   - `bash gesture_project/innovation_npu/tests/run_gestureflow_layer_chain_hp0_postprocess.sh`  
     输出：`GESTUREFLOW_LAYER_CHAIN_HP0_POSTPROCESS_PASS bursts=126 cycles=2564 progress=00001b81`  
   这说明当前共享 `3x3/4x4/1x1` 路线至少在行为级上已经形成稳定收敛，不是“新功能通了但老主线坏了”。

5. **板级 ARM 软件也已经按新语义编译通过。**  
   修改 `gesture_project/innovation_npu/board_7020/software/gestureflow_layer_chain_hp0_main.c`：  
   - `load_head1x1_tile()` 改为写 `GF_LAYER_MODE = 5`；  
   - 不再把 `head_1x1` 的 `112` 路权重按旧 `16 tap` 全部灌进去；  
   - 明确把旧导出数据里的“中心 tap” `GF_HEAD1X1_EMBEDDED_CENTER_TAP = 5` 映射到共享 `pointwise` 语义的 `tap0`；  
   - `run_layer()` 中 `head_1x1` 调用改成 `mode = 5`。  
   实际执行：  
   - `bash gesture_project/innovation_npu/board_7020/build_software_layer_chain_hp0_7020_from_wsl.sh`  
   编译成功，生成：  
   - `E:\coralnpu_vivado\projects\gestureflow_layer_chain_hp0_7020_v1\vitis\axi_gpio\Debug\gestureflow_layer_chain_hp0.elf`  
   `arm-none-eabi-size` 输出：  
   - `text=762321 data=1144 bss=709264 dec=1472729 hex=1678d9`  
   当前只出现两条旧的 `unused variable` warning（`conv2b_hash`、`conv3b_hash`），没有因为本轮 `mode 5` 和权重装载语义而编译失败。

6. **这轮必须记住的两个具体细节。**  
   - `STORE_STATUS[31:3]` 在当前 writer 语义里表示**字节数**，不是 beat 数；本轮第一次顶层回归就是因为把 `2304` 字节误按 `288` beat 去判断而假失败。  
   - 从 WSL 调 `cmd.exe` 编译 Windows 侧 Vitis 时，仍可能先出现 `UNC path` 警告；只要后续脚本已经切换到 `E:\...` 本地路径并继续完成 `arm-none-eabi-gcc`，这个警告当前可以视作非阻塞现象，但不能让 Vivado/Vitis/XSCT 直接以 `\\wsl.localhost\...` 为工作目录。

7. **当前阶段结论。**  
   现在 `GestureFlow-NPU` 在 7020 主线上已经不只是“有独立 `1x1` 原型”，而是：  
   - 共享空间主后端已支持运行态 `1x1 pointwise`；  
   - 顶层 `head_1x1` 已有真实新模式 `layer_mode = 5`；  
   - 软件权重装载语义已跟着切到新模式；  
   - 新旧主线回归和 ARM 交叉编译都已经实际通过。  
   所以下一步不该再回头复制第二套 `1x1` 后端，而应继续沿共享主后端推进：一是把 `mode 5` 接到真实 7020 bit/XSA/ELF 板测；二是评估是否把动态模型里的 `spatial_embedding_1x1` / `temporal_fusion_1x1` 也统一收编到这条共享点积路径。

## 87 2026-08-25 当前算法主线与动态路线对齐后，`1x1` 点积硬件路径已补出并通过真实层回归

**阅读顺序：先读本节；再读第 86 号确认 `3x3/4x4` 共形化已经通过；然后回看 `gesture_project/docs/7020阶段_GestureFlow设计复盘与突破路线_2026-08-25.md` 中关于“双模 MAC”和 temporal 后端的规划。**

1. **这轮不是盲目加模块，而是先重新核对了当前真实算法结构。** 静态硬件协同图像主线仍然是 `gesture_project/models/repvgg_hybrid344_c16_48_80_h112_noidentity_pairedseed20260811_hagrid6_20260812`，部署结构是 `3x3 / 4x4 / 4x4 / 1x1`；更高精度图像参考线仍是 `gesture_project/models/repvgg_3x3_i96_hagrid6_tuned_20260731`，`INT8=89.47%`。动态算法代码 `gesture_project/algorithms/temporal_cnn/gesture_temporal_model.py` 也已经确认：其时序混合主线不是大卷积堆叠，而是 `spatial 3x3/4x4 + spatial embedding 1x1 + temporal shift + summary(mean/max/delta) + temporal fusion 1x1`。因此下一步最有价值的硬件补齐不是再发散空间卷积核，而是补一条稳定的 `1x1` 点积硬件路径。

2. **本轮新增的项目自研 RTL。** 新增 `gesture_project/innovation_npu/rtl/gestureflow_conv1x1_cin_stream.sv`：  
   - 不用行缓存和滑窗；  
   - 每个像素向量本地保持；  
   - 复用现有 `gestureflow_mac_tile.sv`，固定 `mac_tap=0`；  
   - 按四通道组遍历 `Cin`，INT32 部分和仍留在 tile 内；  
   - 直接服务静态 `head_1x1`、动态 `spatial_embedding_1x1`、动态 `temporal_fusion_1x1` 这三类需求。

3. **本轮新增并通过的两条回归。**  
   - `bash gesture_project/innovation_npu/tests/run_gestureflow_conv1x1_cin_stream.sh`  
     输出：`GESTUREFLOW_CONV1X1_CIN_STREAM_PASS outputs=4`。  
     说明：基础 `1x1` 点积流的坐标、group 遍历、bias 累加和结果输出已经闭环。  
   - `bash gesture_project/innovation_npu/tests/run_gestureflow_head1x1_tile_real.sh`  
     输出：`GESTUREFLOW_HEAD1X1_TILE_REAL_PASS outputs=144 probes=7 hash=02be4ffb`。  
     说明：当前静态主线真实 `head_1x1` 的前 `16` 个输出通道已经能通过新 `1x1` 硬件路径逐点对账，不再只是合成 toy case。

4. **这轮踩过并已经收掉的两个具体坑。**  
   - 小回归第一次失败不是 RTL 主体坏，而是 testbench 的 `bias` 初始化写法不严，导致期望里把偏置算进去了、驱动里却没真正稳定装进去；现已修正。  
   - 真实 `head_1x1` 数据最初来自旧 `4x4` 物理形态：导出脚本把 `1x1` 权重嵌在 `4x4` 的中心 tap。新点积流天然只需要一组 tap，因此 testbench 里必须把真实权重从旧中心 tap 映射到新 `tap0` 语义，否则会把“旧物理布局”和“新点积路径”混成一件事。现已按板级软件 `load_head1x1_tile()` 的权重地址语义完成映射。

5. **当前阶段结论。** 现在 `GestureFlow-NPU` 的算子覆盖已经从“可验证的 `3x3/4x4` 空间卷积流”扩展到“可验证的 `1x1` 点积流”。这正好对应当前项目最重要的两条算法事实：  
   - 静态主线的最后一层不是可忽略细节，而是正式 `1x1` 头；  
   - 动态路线若继续按当前 `temporal_cnn` 方向推进，其新增硬件主需求不是再堆时序卷积，而是稳定复用这条 `1x1 + reduce/summary` 路径。  
   所以后续顶层硬件演化的优先级应明确改成：先让 `layer_chain` 能在真实网络里调用这条 `1x1` 硬件路径，再考虑把 temporal 的 summary/reduce 后端并进来。

## 86 2026-08-25 GestureFlow 空间卷积主后端已完成 `3x3/4x4` 共形化第一步并通过三条回归

**阅读顺序：先读本节；再读第 85 号确认这轮结构路线为什么这样收敛；再读 `gesture_project/docs/7020阶段_GestureFlow设计复盘与突破路线_2026-08-25.md` 对照当前模块级规划。** 本节全部改动均位于项目自研目录 `gesture_project/innovation_npu/`，不是 Google 官方 `coralnpu/`。

1. **这轮改动的真实目标。** 不是再做一条新的 `3x3` 小核，也不是复制第二套卷积后端，而是在保持当前 `7020` 物理 `16 tap` 滑窗、既有 BRAM 形态和 `gestureflow_mac_tile.sv` 不变的前提下，让当前空间卷积主体从“只支持 `4x4`”推进到“同一后端兼容 `3x3/4x4`”。这样后续才能真正承接当前图像主线 `3x3 / 4x4 / 4x4 / 1x1`，而不是继续被纯 `4x4` 结构绑死。

2. **本轮实际 RTL 变更。**  
   - `gesture_project/innovation_npu/rtl/gestureflow_same4x4_cin_window.sv`：新增 `KERNEL_SIZE` 参数，只允许 `3` 或 `4`；物理窗口总线仍固定为 `16 tap`，`3x3` 时只让 `tap[0..8]` 有效，`tap[9..15]` 由 padding 填充。  
   - `gesture_project/innovation_npu/rtl/gestureflow_conv4x4_cin_same_stream.sv`：新增 `KERNEL_SIZE` 参数和 `ACTIVE_TAPS`，`3x3` 只 issue `9 tap`，`4x4` 继续 issue `16 tap`，没有复制新的 MAC 阵列。  
   - `gesture_project/innovation_npu/tests/tb_gestureflow_conv3x3_cin_same_stream.sv` 与 `run_gestureflow_conv3x3_cin_same_stream.sh`：新增短回归，专门验证 `3x3` 模式不会错误消费物理 `tap[9..15]`。  
   - `gesture_project/innovation_npu/tests/tb_gestureflow_conv4x4_cin_full_layer.sv`：补齐 `image_width/image_height/weight_bank_select` 等新接口，确保老的真实二层回归继续代表当前主线。

3. **这轮实际跑过并通过的三条回归。**  
   - `bash gesture_project/innovation_npu/tests/run_gestureflow_conv3x3_cin_same_stream.sh`  
     输出：`GESTUREFLOW_CONV3X3_CIN_SAME_STREAM_PASS outputs=4`  
     说明：`3x3` 路径在固定 `16 tap` 物理形态下可以正确只消费前 `9 tap`。  
   - `bash gesture_project/innovation_npu/tests/run_gestureflow_conv4x4_cin_full_layer.sh`  
     输出：`GESTUREFLOW_CONV4X4_CIN_FULL_LAYER_PASS outputs=9216 probes=7 quant_fnv1a=893afa60`  
     并给出：`GESTUREFLOW_CONV4X4_CIN_FULL_LAYER_CYCLES=663856`  
     说明：这轮参数化没有破坏已有 `4x4` 真实二层基线。  
   - `bash gesture_project/innovation_npu/tests/run_gestureflow_layer_chain_hp0_postprocess.sh`  
     输出：`GESTUREFLOW_LAYER_CHAIN_HP0_POSTPROCESS_PASS bursts=126 cycles=2564 progress=00001b81`  
     说明：这轮改动继续没有破坏当前共享顶层 `HP0 + postprocess` 路径。

4. **两处本轮踩过的真实问题，后面不要重复。**  
   - 新增 `3x3` 测试第一次失败不是 RTL 主体坏了，而是测试自己把 `padding_value` 设成 0，却又期望每个位置输出 `36`；现已改为“边界也填 1”的裁剪验证形式，并显式毒化 `tap[9..15]` 的权重。  
   - `frame_input_done` 是脉冲，不是常高状态；短回归必须像真实层回归一样锁存 `*_done_seen`，不能在结尾直接读最终电平。

5. **当前结论。** 这一步已经把“统一 `3x3/4x4` 空间引擎”从路线文档里的规划推进成了真实通过回归的 RTL 基础。下一步不该回头再做零散小 patch，而应沿着第 85 号和路线文档继续推进两件事：  
   - 先把 `gestureflow_conv4x4_cin_same_stream.sv` 继续演化成 `3x3/4x4` 稳定共形的空间引擎，并补一条更接近真实主线的 `hybrid344` 模块级回归；  
   - 再把 `gestureflow_mac_tile.sv` 往“空间卷积 / `1x1` 点积双模”方向推进，使当前 `hybrid344` 的尾部 `1x1` 不再只能依赖后处理特化路径。

6. **一个本轮新暴露但暂不直接改的顶层告警。** 运行 `run_gestureflow_layer_chain_hp0_postprocess.sh` 时，Verilator 继续对 `gesture_project/innovation_npu/rtl/gestureflow_layer_chain_hp0_axil.sv` 第 `278/280` 行给出 `WIDTHEXPAND` 告警：`selected_pixel` 是 `MAX_INPUT_CHANNELS=80` 宽，而 `tensor_pixel`/`tensor40_pixel` 分别只有 `16/40` 通道。这次顶层回归已经通过，说明现有零扩展语义与当前功能一致；但后续如果继续拆顶层职责，优先把这里改成显式逐 lane 赋值，避免后面再把“静默零扩展”误当成新逻辑行为。

## 85 2026-08-25 CoralNPU 参照关系与 GestureFlow 下一阶段模块级路线已重写

**阅读顺序：先读本节；再读 `gesture_project/docs/7020阶段_GestureFlow设计复盘与突破路线_2026-08-25.md`；然后回看第 84 号确认当前已通过的 7020 板级基线。** 本节只记录本轮重新校正后的事实和后续执行边界。

1. **官方与项目侧边界再次固定。** `/home/steveguo/coralnpu-gesture/coralnpu` 是 Google 官方只读参考仓库，后续所有“官方”表述只能指向这里；`gesture_project/innovation_npu/` 是项目自研 `GestureFlow-NPU`，绝不能再把项目自研 RTL、脚本或实验分支误写成 Google 官方实现。

2. **这次重新核对后的官方 CoralNPU 准确判断。** 以只读源码 `coralnpu/hdl/chisel/src/coralnpu/Parameters.scala`、`coralnpu/hdl/verilog/rvv/inc/rvv_backend_define.svh`、`coralnpu/hdl/verilog/rvv/design/RvvCore.sv`、`coralnpu/hdl/verilog/rvv/design/Zvt/*.sv` 和 `coralnpu/sw/opt/litert-micro/{conv,depthwise_conv}.cc` 为准：当前公开代码的默认主链是 `RVV 128-bit + 32 个 VRF + 2 路向量 MUL/MAC`，不是现成完整矩阵 NPU；`ZVT/VME` 相关 RTL 确实存在，但 `RvvCore.sv` 里 `VME LSU interfaces` 仍被 tie-off，不能写成系统级已经完全打通。官方软件优化主链对标准卷积明显偏 `4x4`，对 `depthwise` 的成熟优化则偏 `3x3`。

3. **当前 7020 自研主线的真实结构重新归纳。** 目前板测通过的是项目自研 `GestureFlow-NPU`：`gestureflow_layer_chain_hp0_axil.sv` 负责顶层控制、descriptor 和 HP0 仲裁；`gestureflow_conv4x4_cin_same_stream.sv` 负责 same-padding 空间卷积滑窗；`gestureflow_mac_tile.sv` 是 `16 输出 x 4 输入` 的 INT8 乘加 tile，INT32 部分和留在片上；`gestureflow_hp0_gap_fc.sv` 负责板上 GAP/FC。它已经实板闭环到整网，但当前仍然主要是“空间卷积单主后端 + 尾部后处理器”，不是最终最优结构。

4. **新的下一阶段路线已经写入专门文档。** 本轮重写的 `gesture_project/docs/7020阶段_GestureFlow设计复盘与突破路线_2026-08-25.md` 把后续路线固定为五个模块级突破点：  
   - `gestureflow_mac_tile.sv` 升级为统一空间/点积双模计算集群；  
   - `gestureflow_conv4x4_cin_same_stream.sv` 演化为统一 `3x3/4x4` 空间引擎；  
   - `gestureflow_layer_chain_hp0_axil.sv` 中的 `weight key/hit/miss` 雏形升级为真正的权重生命周期管理器；  
   - writer/output bank 升级为 relay bank，减少尾部层间 DDR 往返；  
   - loader 侧引入 tile-valid/ROI 门控，并把 `gestureflow_hp0_gap_fc.sv` 演化成通用 reduce/FC/MLP/temporal 后端。  
   后续如果没有先读这份文档，就不要开始新一轮结构修改。

5. **算法与硬件的当前正式对应关系。** 当前最适合作为硬件协同图像主线的是 `gesture_project/models/repvgg_hybrid344_c16_48_80_h112_noidentity_pairedseed20260811_hagrid6_20260812`，其 `INT8` 完整测试为 `87.82%`，结构正好是 `3x3 / 4x4 / 4x4 / 1x1`；更高精度图像参考线仍是 `gesture_project/models/repvgg_3x3_i96_hagrid6_tuned_20260731`，`INT8 = 89.02%`，说明首层和整体空间表达不能简单被纯 `4x4` 替代。当前已完成蒸馏学生 `...distill3x3a35t2...` 为 `87.64%`，没有替代主线；交接文档里提过的 18 类 HaGRID 中断学生训练目录本轮在当前环境已不存在，后续不能假定 `/tmp/...distill...` 仍可直接恢复，必须以已保留脚本参数和正式模型目录为准。

## 84 2026-08-25 80-Cin `conv3_b` 到整网后处理完成新版本实板验收

**阅读顺序：先读本节；再读第 83 号了解 80-Cin 完整实现的资源门禁；再读第 82 号了解 40-Cin descriptor 版本的实板回退线。** 本节全部内容属于项目自研 `gesture_project/innovation_npu/` 和独立 Windows 工程，不是 Google 官方 CoralNPU RTL。`/home/steveguo/coralnpu-gesture/coralnpu` 本轮保持只读且工作区干净。

1. **确定性问题和 RTL 修复。** `gesture_project/innovation_npu/rtl/gestureflow_layer_chain_hp0_axil.sv` 原来的共享 HP0 读仲裁只转发 RGB、16-Cin、40-Cin 和 80-Cin 张量读取，没有转发 `layer_mode == 4` 的 GAP/FC 后处理读请求。后处理已经启动但读请求没有到达 HP0，因此状态停在 `LOAD`，`POST_PROGRESS=0x4`，`busy=1`，GAP/FC 完成数为 0。本轮在约 292 行加入项目自研的 mode4 仲裁分支，完整转发 `post_araddr/post_arid/post_arlen/post_arsize/post_arburst/post_arlock/post_arcache/post_arprot/post_arqos/post_arregion/post_arvalid/post_rready`，没有修改官方仓库。

2. **行为仿真实际通过。** 先运行独立真实模型回归：
   `timeout 180s bash gesture_project/innovation_npu/tests/run_gestureflow_hp0_gap_fc_real.sh`
   输出 `GESTUREFLOW_HP0_GAP_FC_REAL_PASS cycles=2564 gap=abbc5831 fc=dde32561 class=0`。再运行完整顶层共享 HP0 回归：
   `timeout 180s bash gesture_project/innovation_npu/tests/run_gestureflow_layer_chain_hp0_postprocess.sh`
   输出 `GESTUREFLOW_LAYER_CHAIN_HP0_POSTPROCESS_PASS bursts=126 cycles=2564 progress=00001b81`。后者覆盖真实顶层仲裁、144 个输入像素、112 个 GAP 通道和 6 个 FC 类别，不是只实例化后处理模块的孤立测试。

3. **新版本 Vivado 实现已经完成。** 独立 Windows 工程为 `E:\coralnpu_vivado\projects\gestureflow_wide80_7020_v1`，本轮确认的项目实例为 `system_gestureflow_0_15`，共享互连为 `system_axi_smc_11`；不得误用之前失败尝试中的 `system_gestureflow_0_14` 或 `system_axi_smc_10`。本轮 routed checkpoint 为 `E:\coralnpu_vivado\projects\gestureflow_wide80_7020_v1\logs\gestureflow_wide80_postprocess_7020_routed.dcp`。Vivado 2023.2 日志明确出现 `Bitgen Completed Successfully` 和 `write_bitstream completed successfully`，不是仅有文件名的假完成。

4. **资源、时序和 DRC 结果。** 报告路径为 `E:\coralnpu_vivado\projects\gestureflow_wide80_7020_v1\logs\gestureflow_wide80_postprocess_7020_{utilization_routed,timing_routed,drc}.rpt`。`xc7z020clg400-2` 实现资源为 `LUT=38,206`、`FF=51,679`、`RAMB36=107`、`RAMB18=0`、`DSP48E1=180`；25 MHz、40 ns 时钟下 `WNS=+0.165 ns`、`WHS=+0.036 ns`、TNS/THS 均为 0，报告明确写有 `All user specified timing constraints are met`。布线阶段 failed/unrouted/partially routed nets 均为 0，验证完成；DRC 为 0 errors，另有 340 条 DSP 输入/MREG/PREG 未完全流水化的建议性 warning。当前不要在没有实测收益证据前贸然重构这些 DSP 流水线。

5. **bit/XSA 成组关系已经核对。** 当前 bit 为 `E:\coralnpu_vivado\projects\gestureflow_wide80_7020_v1\logs\gestureflow_wide80_postprocess_7020.bit`，SHA-256 为 `a1222a12f6bb494218746e5d7ba27955d0f88ef6a0c4acd2cc5bb3e1929da563`；当前 XSA 为同目录下的 `gestureflow_wide80_postprocess_7020.xsa`，SHA-256 为 `ab99504703464a8e01aac34957a9af7d87ee0ddaf26c6bcde7dfc08eba601363`；XSA 内嵌 bit 的 SHA-256 与外部 bit 完全相同。当前 routed DCP 的 SHA-256 为 `8c3b407acb4f064ac80143b18c09999cbfa2b237f88630785e26d744d7ae0c71`。XSA 内含 `system.hwh` 和 `system_axi_smc_11.hwh`，时间均为本轮导出时间，确认不是旧硬件平台。

6. **软件平台和真实板测。** 已从最终 XSA 重新生成 standalone 平台，命令为 `timeout 180s bash gesture_project/innovation_npu/board_7020/run_create_wide80_postprocess_platform_from_wsl.sh`，输出 `GESTUREFLOW_WIDE80_POSTPROCESS_PLATFORM_PASS`。随后运行 `timeout 180s bash gesture_project/innovation_npu/board_7020/build_software_wide80_postprocess_from_wsl.sh`，编译参数明确为 `-DGF_FAST_RELEASE=0`，生成真实完整网络 ELF：
   `E:\coralnpu_vivado\projects\gestureflow_wide80_7020_v1\vitis\axi_gpio_80cin_postprocess\Debug\gestureflow_layer_chain_hp0_80cin_postprocess.elf`
   ELF SHA-256 为 `4f136451edc5f109b8f868bfd690c63e3703327192ffbebde33edb70f6bbd1dc`，`text=902413/data=1144/bss=709264`。通过 Windows `hw_server` 的 `tcp:127.0.0.1:3334`，使用 `run_board_wide80_postprocess_from_wsl.sh` 实际下载本节 bit、XSA 和 ELF 后，输出 `GESTUREFLOW_LAYER_CHAIN_HP0_FULL_NETWORK_BOARD_PASS`。

7. **本次整网板测金标准。** 实板关键结果为：`FINAL_RESULT=0x600D600D`；`conv3_b FNV=0xEA998550`；`pool3 FNV=0x8EF3B2CB`；`head FNV=0x53C6484E`；`GAP FNV=0xABBC5831`；`FC FNV=0xDDE32561`；类别为 0；`POST_PROGRESS=0x00001B81`（完成）；`POST_CYCLES=0x0000129E`；`DMA_STATUS=0x0001F802`，无 fault。完整原始板测日志为 `/tmp/gestureflow_wide80_postprocess_board_20260825.log`，编译日志为 `/tmp/gestureflow_wide80_postprocess_compile_20260825.log`。

8. **当前结论和下一步边界。** 现在可以正式称为“项目自研 GestureFlow-NPU 80-Cin 版本在 Zynq-7020 上完成整网静态模型板级闭环”，不能称为 Google 官方 CoralNPU RTL 在 7020 上运行，也不能把它描述成完整 CoralNPU 标量/RVV/VME 实现。下一步优先做两件事：第一，保留本节 bit/XSA/ELF/日志作为最新可回退组；第二，在不破坏本节功能基线的前提下，测量和优化权重 tile 边界、后处理路径及 DDR 读写开销。任何后续 RTL 改动都必须先跑顶层行为回归，再综合、布局布线、bit/XSA、重新编译软件并实板验收；没有实际运行结果不能只更新文档就结束。

9. **操作注意事项。** Vivado、Vitis、XSCT 只能使用 Windows 本地 `E:\Xilinx\...` 和 `E:\coralnpu_vivado\...` 路径；WSL 调用 Windows 工具时即使先出现 `UNC paths are not supported`，也必须确认脚本已经 `pushd E:\...` 后再判断结果。不得让 Windows 工具直接打开 `\\wsl.localhost\Ubuntu-22.04\...`。每次后续板测必须检查 bit/XSA/ELF 的时间戳和 SHA-256，确认使用同一版本；不得下载旧 `0_14`/`0_10` 或 40-Cin 回退版本来冒充本节结果。

## 83 2026-08-23 80-Cin `conv3_b` 资源门禁完成，完整布局暂未形成新 bitstream

**阅读顺序：先读本节，再读第 82 号的 `conv2_b -> pool2 -> conv3_a` 实板通过结论。** 本节新增脚本位于 `gesture_project/innovation_npu/board_7020/`，均为项目自研；官方只读目录 `coralnpu/` 没有修改。

1. **执行目的。** 当前 40-Cin `wide40_mode2fix` 位流已经实板跑到 `conv3_a`。为判断后续真实 `conv3_b (24x24x80 -> 24x24x80)` 是否能在 ZYNQ-7020 上继续，新增 `ooc_gestureflow_wide80_synth_7020.tcl` 和 `run_ooc_gestureflow_wide80_synth_7020_from_wsl.sh`，只对项目自研 `gestureflow_layer_chain_hp0_axil` 使用 `MAX_INPUT_CHANNELS=80` 做 Vivado 2023.2 OOC 综合、利用率、时序和 DRC 报告；当前 40-Cin 工程和已验收 bit/XSA 未被覆盖。

2. **OOC 实际结果。** Windows Vivado 实际完成并输出 `GESTUREFLOW_WIDE80_OOC_PASS`。报告目录为 `E:\coralnpu_vivado\projects\gestureflow_wide80_ooc_7020\logs`，资源为 `LUT=22,940`、`FF=37,971`、`RAMB36=107`、`RAMB18=0`、`DSP48E1=155`。25 MHz OOC 时序为 `WNS=+17.208 ns`、`WHS=+0.240 ns`、TNS/THS 均为 0；OOC DRC 为 262 条建议性 warning，0 error，主要是 DSP 输入/MREG/PREG 未完全流水化和 OOC PS7 提示，不可把 warning 数写成 DRC 失败。综合 checkpoint 为 `gestureflow_wide80_ooc_synth.dcp`。

3. **资源判断。** 7020 可用资源为 DSP=220、RAMB36=140，因此 80-Cin OOC 版本的 DSP 约占 70.5%，RAMB36 约占 76.4%，LUT 约占 24.0%，FF 约占 17.0%，资源上有机会进入整工程；但输出缓存自身占 `64 RAMB36`，三行 80-Cin 滑窗占 `27 RAMB36`，这是布局布线和 BRAM 余量的主要风险。当前只能说“可进入完整实现门禁”，不能说“80-Cin 已经能上板”。

4. **完整实现尝试及边界。** 新增 `build_gestureflow_wide80_7020.tcl` 和 `run_build_gestureflow_wide80_7020_from_wsl.sh`，复制到独立 Windows 工程 `E:\coralnpu_vivado\projects\gestureflow_wide80_7020_v1`，通过已审计的 BD/HP0 工程流程，仅把 `MAX_INPUT_CHANNELS` 改为 80。实际执行 180 秒有界构建：BD 生成成功，`system_gestureflow_0_13_synth_1`、`system_axi_smc_9_synth_1` 和顶层 `synth_1` 均成功，随后进入 `impl_1`；到边界没有新 `.bit/.xsa`、实现 utilization 或实现 timing 报告。WSL 超时后残留的 Vivado 进程已全部清理，当前不能记录为布局布线通过。主日志为 `/tmp/gestureflow_wide80_full_build_20260823.log`，顶层实现日志入口为 `E:\coralnpu_vivado\projects\gestureflow_wide80_7020_v1\axi_gpio.runs\impl_1\runme.log`。

5. **下一步执行门禁。** 不要直接将 OOC 设计烧板，也不要回退 40-Cin 已通过版本。下一次先检查 `gestureflow_wide80_7020_v1` 是否存在可恢复的 `impl_1` checkpoint，优先从综合 DCP 进入受控 placement/route，并设置单实例 Vivado 和明确时间界限；若布局失败，先根据 BRAM 资源和拥塞报告做“输出 bank 分片/80-Cin 两组 40 通道窗口复用”的结构化优化，再综合验证。只有新 80-Cin bit/XSA 生成后，才为 `conv3_b` 补真实权重、量化参数和 golden 对账，重新编译 ARM descriptor 程序并下板。

6. **环境纪律。** Windows 工具仍只能读 `E:\Xilinx\Vivado\2023.2`、`E:\Xilinx\Vitis\2023.2` 和本地 `E:\coralnpu_vivado\...`；WSL 不能把 `\\wsl.localhost\...` UNC 路径直接传给 Vivado/XSCT。每次长任务都必须保留 `/tmp` 日志并清理残留 Vivado；`hw_server` 可保留用于板测，但不能把后台 Vivado 留到下一轮。

## 82 2026-08-23 7020 descriptor 主线实板推进到 `conv2_b -> pool2 -> conv3_a`

**阅读顺序：必须先读本节，再读第 81 号了解 40 通道 AXI 分派修复，再读第 80 号了解 descriptor 独立工程和 bit/XSA 配套。** 本节所有新增内容均位于项目自研目录 `gesture_project/innovation_npu/`，不是 Google CoralNPU 官方实现；`/home/steveguo/coralnpu-gesture/coralnpu` 本轮没有修改，仍是只读参考仓库。

1. **当前设计目标已经固定。** 7020 主线不是把完整 CoralNPU 标量前端、RVV 前端或 VME 原样塞入 FPGA，也不是 ARM 逐像素卷积外设。目标是“PS 只在层/tile 边界提交描述符和装载一次权重，PL 通过 HP0 从 DDR 批量读取激活，片上 SAME 4x4 滑窗和行/窗口缓存驱动一个 16 输出 x 4 输入的 INT8 MAC tile，跨输入通道组在片上保持 INT32 部分和，完成 requant/ReLU 后以 AXI4 burst 写回 DDR”。当前实现是面向项目手势模型的 CoralNPU 思路裁剪版：保留可编程 descriptor、片上数据复用、权重驻留、整数 MAC 和统一 DDR 数据流；不把自研模块表述为 Google 官方 RTL。

2. **本轮实际扩展。** `gesture_project/innovation_npu/board_7020/software/gestureflow_descriptor_replay_main.c` 新增真实 `conv2_b -> pool2 -> conv3_a`：`conv2_b` 的 48x48x40 输出先由 PL writer 以 `store_control=3` 做 2x2 maxpool，生成 24x24x40 `pool2`；随后加载真实 `conv3_a` 的 80 输出通道权重，使用 5 个 16-lane tile 完成 24x24x40 -> 24x24x80。每个任务仍由 descriptor doorbell 启动，ARM 不执行乘加、不复制中间激活、不逐窗口发命令；当前因为 descriptor 权重元数据还未实现 DDR 自动装载，权重在 tile 边界通过兼容寄存器写入，这是当前性能优化的下一处明确瓶颈，不能把它说成最终零开销方案。

3. **真实板测结果。** 使用修复版 `mode2fix` bit/XSA 和新编译 ELF，在 ZYNQ-7020 实板重新烧录运行，输出 `GESTUREFLOW_DESCRIPTOR_REPLAY_FINAL_RESULT = 0x600D600D`、`GESTUREFLOW_DESCRIPTOR_REPLAY_BOARD_PASS`。全量结果为：`conv1_a FNV=0xF49B1B48`、`pool1 FNV=0x6518BC59`、`conv2_a FNV=0xDF95D5CF`、`conv2_b FNV=0x94C745E4`、`pool2 FNV=0x1770E9FB`、`conv3_a FNV=0x26B89256`。其中 `conv2_b` 与 `gf_pool2_input`、`pool2` 与 `gf_conv3a_layer_input`、`conv3_a` 与 `gf_conv3b_layer_input` 均做了完整逐字节对账，不是只比几个探针点。

4. **板级周期和故障证据。** 本次 `PROBE[31..39]` 是三个 `pool2` tile：周期分别 `0x6291A=403738`、`0x62911=403729`、`0x626DA=403066`，writer status 分别 `0x00012002`、`0x00012002`、`0x00009002`，对应 16、16、8 个输出通道且无 fault。`PROBE[40]=0x1770E9FB`。`PROBE[41..55]` 是五个 `conv3_a` tile：周期分别 `0x1AB78=109432`、`0x1AB7D=109437`、`0x1AB77=109431`、`0x1AB7F=109439`、`0x1AB7F=109439`，writer status 全部 `0x00012002`，`PROBE[56]=0x26B89256`。完整原始日志为 `/tmp/gestureflow_descriptor_conv3a_board_20260823.log`，交叉编译日志为 `/tmp/gestureflow_descriptor_conv3a_compile_20260823.log`。

5. **配套产物哈希。** 实际下板 bitstream 为 `E:\coralnpu_vivado\projects\gestureflow_layer_chain_descriptor_hp0_7020_v1\logs\gestureflow_layer_chain_descriptor_hp0_7020_wide40_mode2fix.bit`，SHA-256 为 `9ee99df28eaf00871aa112022afe02ba15a44f9b735ce7dfdb68421861a24d45`；XSA 为同目录下的 `gestureflow_layer_chain_descriptor_hp0_7020_wide40_mode2fix.xsa`，SHA-256 为 `0ae60126a014bef85f6ac8cca0a1bff4c39794b96d7edb206a3ba4ce8eaac35b`，XSA 内嵌 bit 与外部 bit 哈希一致；本轮 ELF `...\vitis\axi_gpio\Debug\gestureflow_descriptor_replay.elf` SHA-256 为 `fb8c5b919c3fce9dc09c2556588e2ba16a991a6b729f8bccf3351d99ef9e8adf`，大小 `1,043,036` 字节。

6. **当前硬件资源和边界。** 使用的 `wide40_mode2fix` 实现仍为 `DSP48E1=155`、`RAMB36E1=76`、`RAMB18E1=19`、`FDRE=23,401`，`WNS=+12.290 ns`、`WHS=+0.051 ns`、DRC=0，布线未完成网络为 0。当前 bitstream 的 `MAX_INPUT_CHANNELS=40`，因此已经覆盖到 `conv3_a`，但还不能声称支持后面的 80 输入通道 `conv3_b`。下一道硬门禁是：在不破坏当前 40 通道回退 bit 的前提下评估 80 通道输入缓存的 BRAM/时序代价；优先考虑 40+40 通道分段、片上 INT32 累加不写回的实现，只有综合和全量数值闭环后才采用，禁止回退为 ARM 分通道卷积。

7. **下一步执行顺序。** 先保留本节 bit/XSA/ELF 和板测日志作为回退组；然后针对 `conv3_b (24x24x80 -> 24x24x80)` 设计硬件可行的 80-Cin 数据路径，重点解决两组 40-Cin 的窗口缓存、跨组 INT32 累加、权重驻留和 HP0 读取，不先做无关的小测试。第一版候选必须完成 RTL 真实张量仿真、OOC/顶层资源与时序报告，再重新生成 bit/XSA、编译软件并实板验收 `GF_CONV3B_OUTPUT_FNV1A`；通过后继续 `pool3 -> conv_head_1x1 -> GAP -> class`，最终以整网类别、PL 周期、DDR 读写量和帧率作为结论。

8. **环境和操作硬门禁。** Vivado/Vitis/XSCT 只能使用 Windows 本地 `E:\Xilinx\Vivado\2023.2`、`E:\Xilinx\Vitis\2023.2` 和 `E:\coralnpu_vivado\...` 路径；不能把 `\\wsl.localhost\...` UNC 路径直接交给 Windows 工具。WSL 脚本必须先把 Tcl 复制到 `E:\coralnpu_vivado\...\project_local_gestureflow`，再调用 `E:\Xilinx\Vitis\2023.2\bin\xsct.bat`。每次硬件或软件修改后都必须实际编译并下板，Vivado 长任务设置有界时间并保留日志；下一次接手先检查本节记录、bit/XSA/ELF 哈希、`hw_server` 和 Windows 是否有残留 Vivado 进程。

## 81 2026-08-23 descriptor 主线实板推进到真实 conv1_a -> conv1_b -> pool1 -> conv2_a

**阅读顺序：必须首先阅读本节；再读第 80 号了解 descriptor 工程的 bit/XSA 配套关系；再读第 78 号了解 descriptor 如何接入真实 layer-chain 顶层。** 本节新增的软件、脚本和结果属于项目自研 `gesture_project/innovation_npu/`，不是 Google CoralNPU 官方 RTL。`/home/steveguo/coralnpu-gesture/coralnpu` 本轮没有修改，仍是只读官方参考仓库。

1. **本轮目标和实际完成范围。** 当前 7020 主线继续遵守“PS/ARM 只提交层级描述符，PL 自主读取 DDR、滑窗、MAC、量化、池化和写回”的设计目标，禁止退回 ARM 逐像素、逐窗口或逐权重控制。descriptor 软件已从真实 `conv1_a -> conv1_b` 扩展为：第一批一次 doorbell 完成 `RGB 96x96x3 -> conv1_a 96x96x16 -> conv1_b 96x96x16 -> pool1 48x48x16`；随后按输出通道 tile 提交三次 descriptor，完成真实 `conv2_a 48x48x16 -> 48x48x40`。PS 只在层/tile 边界装载权重、偏置、量化参数和地址，不参与卷积计算，也不复制中间激活。

2. **真实数据验收。** 输入和权重来自 `gesture_project/models/static_cnn_4x4_w125_h112_nomixup_hagrid6_20260811/model_int8.tflite` 导出的项目数据头文件。板上结果通过以下检查：`conv1_a` 完整输出 FNV 为 `0xF49B1B48`；`conv1_b -> pool1` 的完整输出 FNV 为 `0x6518BC59`，并与 `gestureflow_real_conv4x4_conv2a_layer.h` 中的 `gf_conv2a_layer_input` 逐字节一致；三组 `conv2_a` tile 全部写回后，完整 48x48x40 输出 FNV 为 `0xDF95D5CF`，并与 `gestureflow_real_conv4x4_conv2b_layer.h` 中的下一层输入逐字节一致。板测最终输出 `GESTUREFLOW_DESCRIPTOR_REPLAY_BOARD_PASS`，`FINAL_RESULT=0x600D600D`。

3. **板级周期和 fault 证据。** `conv1_a` descriptor cycles 为 `0x000493DB`；`pool1` descriptor cycles 为 `0x000B16A8`；`conv2_a` 三个 tile cycles 分别为 `214753`、`214753`、`212445`。对应探针为 `PROBE[11]=214753`、`PROBE[14]=214753`、`PROBE[17]=212445`，三组 writer status 分别为 `0x00048002`、`0x00048002`、`0x00024002`，均为 done 且 fault=0；最终完整 FNV 在 `PROBE[20]=0xDF95D5CF`。本轮重新实际烧录并运行，没有只停留在软件编译或仿真。

4. **本轮修改文件。** `gesture_project/innovation_npu/board_7020/software/gestureflow_descriptor_replay_main.c` 新增 pool1 descriptor、40 输出通道的三 tile 权重装载、NHWC stride-40 写回、完整 FNV/逐字节对账；`gesture_project/innovation_npu/board_7020/build_software_descriptor_replay_from_wsl.sh` 新增池化、conv2_a、conv2_b 数据头复制；`gesture_project/innovation_npu/board_7020/scripts/run_gestureflow_descriptor_replay_xsct.tcl` 将板级探针读取范围扩展到 `PROBE[20]`。本轮没有修改 RTL，因此继续使用上一轮已实现的 25 MHz 版本。

5. **配套产物和日志必须成组使用。** 实际板测使用的 bitstream 是 `E:\coralnpu_vivado\projects\gestureflow_layer_chain_descriptor_hp0_7020_v1\logs\gestureflow_layer_chain_descriptor_hp0_7020.bit`，SHA-256 `22d96c196d7180abe600a4c7b77c67fc102e8243eeb316bc77b9fa79ff625bac`；XSA 是同目录下的 `gestureflow_layer_chain_descriptor_hp0_7020.xsa`，SHA-256 `bb21f791b9d38416e935d3027eb947e2119c501421f94746e14782a005352234`；本轮 ELF 为 `...\vitis\axi_gpio\Debug\gestureflow_descriptor_replay.elf`，SHA-256 `bac4cd6a4824be755a400cc503bd11668f165577d194cc8df1f6ec0312259741`。编译日志为 `/tmp/gestureflow_descriptor_conv2a_compile_20260823.log`，最终板测日志为 `/tmp/gestureflow_descriptor_conv2a_board_verified_20260823.log`。记录 80 中不同的 bit/XSA 哈希字段属于过渡元数据，后续以本节实际成组哈希为准，禁止混用。

6. **资源和硬件边界。** 本轮没有重新综合，仍使用当前 descriptor 裁剪版实现资源：`LUT=19,855`、`FF=16,835`、`RAMB36=70`、`RAMB18=16`、`DSP=153`，25 MHz `WNS=+12.598 ns`、`WHS=+0.044 ns`，DRC=0。`conv2_a` 的 40 输出通道通过同一 16x4 INT8 MAC tile 分三次驻留权重完成，未复制 DSP，也没有把 INT32 部分和写回 DDR。当前 descriptor 版本的输入读取宽度仍为 16 通道，不能伪装支持 `conv2_b` 的 40 通道输入。

7. **下一步硬门禁。** 下一步不是再做重复回放，而是扩展 descriptor/后端以支持真实 `conv2_b 48x48x40 -> 48x48x40`：必须先解决 40 通道输入读取和 10 个四通道组在片上连续累加的问题，再决定是否把 `pool2` 融合到 writer；不能通过 ARM 预先复制或软件计算规避硬件限制。改 RTL 前先保存本节 bit/XSA/ELF 回退副本；改动后依次执行有界 RTL 回归、Vivado 完整综合/布局布线/DRC/bit/XSA、软件重新编译和真实板测，验收完整 `conv2_b` FNV、下一层输入逐字节一致、每 tile cycles、DDR bytes 和 fault 状态。Vivado/Vitis/XSCT 仍只能使用 `E:\...` Windows 本地路径，禁止把 `\\wsl.localhost\...` UNC 路径直接交给 Windows 工具。

## 80 2026-08-23 descriptor 独立工程完成新 XSA、descriptor ELF 编译并实板双任务 PASS

**阅读顺序：必须首先阅读本节；再读第 79 号理解 descriptor 实现为何使用 placed checkpoint；随后阅读第 78 号和第 77 号理解 descriptor doorbell 的 RTL 边界。** 本节的 bitstream、XSA、软件和板测脚本均属于项目自研 `gesture_project/innovation_npu/`，不是 Google CoralNPU 官方 RTL。`/home/steveguo/coralnpu-gesture/coralnpu` 仍是 Google 上游只读参考仓库，本轮没有修改它。

1. **新硬件平台已经真实导出。** 独立 Vivado 工程是 `E:\coralnpu_vivado\projects\gestureflow_layer_chain_descriptor_hp0_7020_v1`，不是旧的 `gestureflow_layer_chain_hp0_7020_v1` writer-burst 工程。当前 descriptor bitstream 为 `E:\coralnpu_vivado\projects\gestureflow_layer_chain_descriptor_hp0_7020_v1\logs\gestureflow_layer_chain_descriptor_hp0_7020.bit`，大小 `4,045,674` 字节，SHA-256 为 `7d169b416aaa40d76b7b42650bc8d92e2c58da22550fb42533411b5673d09d03`。当前 XSA 为 `E:\coralnpu_vivado\projects\gestureflow_layer_chain_descriptor_hp0_7020_v1\logs\gestureflow_layer_chain_descriptor_hp0_7020.xsa`，大小 `1,663,598` 字节，SHA-256 为 `41c1b6fabd76e4b6ac71c83549addaae7a13418599a692d46d57a0dd0d74385d`。XSA 内部包含 `gestureflow_layer_chain_descriptor_hp0_7020.bit`、当前 `system.hwh`、`system_axi_smc_3.hwh` 和 Zynq-7020 PS 初始化文件；XSA 内 `system.hwh` 的 SHA-256 为 `e3a60614ab205de990f9e2e1dec35ee0ae39983bc40da3e666246b0ddbd0f038`，与当前 descriptor 工程的 `axi_gpio.srcs\sources_1\bd\system\hw_handoff\system.hwh` 一致。

2. **XSA 导出过程和超时边界。** `gesture_project/innovation_npu/board_7020/export_layer_chain_hp0_xsa.tcl` 已固定工程根路径为 descriptor 工程，并在 `impl_1` stale 时回退到 `axi_gpio.runs\impl_1\system_wrapper_placed.dcp`；它不会读取旧工程 checkpoint。路由重试日志为 `/tmp/gestureflow_descriptor_xsa_export_20260823.log`：180 秒边界内曾停止在 route 的 `Phase 4.2`，之后由已完成的受控 route/bitstream 状态导出了 XSA，Vivado 日志在 `project_local_gestureflow\vivado.log` 明确记录 `Successfully created Hardware Platform`。不能将第一次 180 秒未完成 route 写成失败的硬件设计，也不能把后来的 XSA 误写成旧 writer-burst XSA。

3. **软件平台和实际编译结果。** 新增 `gesture_project/innovation_npu/board_7020/create_descriptor_platform_from_xsa.tcl`，目标平台目录为 `E:\coralnpu_vivado\projects\gestureflow_layer_chain_descriptor_hp0_7020_v1\vitis\gestureflow_descriptor_platform`，其硬件参数头文件中的 `XPAR_GESTUREFLOW_0_BASEADDR` 为 `0x43C00000`。Vitis 2023.2 在本机生成 standalone BSP 时，先出现缺少通用 standalone 头文件，补齐后 Windows `make` 又出现 `0xc0000005` 崩溃，因此不能称为“完整新 BSP 自动生成成功”。实际编译采用可审计的兼容路径：使用新 XSA 生成的 descriptor `xparameters.h` 和平台 include，链接同一 Zynq PS 配置下已存在的通用 `libxil.a`；descriptor 没有自定义 Vitis 驱动，只调用 `Xil_In32/Xil_Out32`、cache 和串口接口。`gesture_project/innovation_npu/board_7020/build_software_descriptor_replay_from_wsl.sh` 已固定该路径。重新编译日志为 `/tmp/gestureflow_descriptor_arm_compile_20260823.log`，ELF 为 `E:\coralnpu_vivado\projects\gestureflow_layer_chain_descriptor_hp0_7020_v1\vitis\axi_gpio\Debug\gestureflow_descriptor_replay.elf`，SHA-256 为 `c4dfec2135c20106117fd301f56153047b662b6833b6c9c6ed35228372a280a9`，大小统计为 `text=56,293 / data=1,144 / bss=345,168`。

4. **真实板测结果。** 新增 `gesture_project/innovation_npu/board_7020/run_board_descriptor_replay_from_wsl.sh`，固定把 `run_gestureflow_descriptor_replay_xsct.tcl` 复制到 descriptor 工程的 Windows 本地 `project_local_gestureflow`，再调用 `E:\Xilinx\Vitis\2023.2\bin\xsct.bat`。本轮先启动 `E:\Xilinx\Vivado\2023.2\bin\hw_server.bat`，确认 `hw_server.exe` 存在且 `127.0.0.1:3334` 可达；随后实际烧录当前 descriptor bitstream、加载当前 descriptor XSA 和新编译 ELF。板测日志为 `/tmp/gestureflow_descriptor_board_20260823.log`，在约 12 秒内通过：`GESTUREFLOW_DESCRIPTOR_REPLAY_FINAL_RESULT = 0x600D600D`、`PROBE[01]=2`（已发出两个 descriptor）、`PROBE[02]=2`（已完成两个 descriptor）、`PROBE[03]=0xF49B1B48`、`PROBE[04]=0xF49B1B48`（两份真实输出 FNV 完全一致）、`PROBE[05]=0x000493DB`（总 IP cycles）、`PROBE[06]=0x00036002`、`PROBE[07]=0x00120002`、`PROBE[08]=0x42`、`PROBE[09]=2`，最终打印 `GESTUREFLOW_DESCRIPTOR_REPLAY_BOARD_PASS`。这证明当前 descriptor doorbell、两次 HP0 读取、MAC、requant、DDR 写回以及完成计数在新 bit/XSA 配套下可实板运行；它仍是两任务 descriptor 回放基线，不能写成完整手势网络或摄像头帧率。

5. **下一步硬门禁。** 不要再回到旧 writer-burst 路径，也不要把“两次相同首层 descriptor”夸大成通用整网调度。下一步应在保持当前 bit/XSA/ELF 回退副本的前提下，将 descriptor 表扩展为真实 `conv1_a` 多 tile 或下一层真实 `conv1_b` 的批量任务，使用完整输出 FNV 和 `DESC_ISSUED/DESC_COMPLETED` 对账；每次扩展仍须先做有界 RTL 回归，再重新生成 descriptor bit/XSA、重新编译 ELF、实板验证，并记录每个 descriptor 的 cycles、DDR 地址、输出 FNV 和 fault 状态。Windows 工具必须继续使用 `E:\...` 本地路径，禁止让 Vivado/Vitis/XSCT 直接打开 `\\wsl.localhost\...` UNC 路径。

## 79 2026-08-21 descriptor 独立工程首次综合已启动，真实两任务板测 ELF 已就绪，但没有新 bitstream 或板测结论

**阅读顺序：必须先读本节；再读第 78 号了解 descriptor RTL 的接入和有界顶层回归；再读第 77 号确认 7020 不加入完整 CoralNPU 标量前端的硬门禁。** 本节所有修改仅位于 `gesture_project/innovation_npu/`，均为项目自研，不是 Google CoralNPU 官方 RTL。`/home/steveguo/coralnpu-gesture/coralnpu` 仍是只读 Google 参考目录，禁止修改、暂存或把下述工作表述为官方实现。

1. **隔离构建路径已经纠正。** 文件 `gesture_project/innovation_npu/board_7020/run_build_layer_chain_hp0_7020_from_wsl.sh` 原本虽然复制到了 `E:\coralnpu_vivado\projects\gestureflow_layer_chain_descriptor_hp0_7020_v1`，却错误地在旧 writer-burst 工程路径调用 Vivado；现已改为只在新目录的 `project_local_gestureflow` 执行。旧的已签核 writer-burst bit/XSA 未改动，也绝不能被用作 descriptor 版本的证据。
2. **一次有界实现已实际执行，但在 180 秒限制内没有生成新产物。** 运行命令为 `timeout 180s bash gesture_project/innovation_npu/board_7020/run_build_layer_chain_hp0_7020_from_wsl.sh > /tmp/gestureflow_descriptor_vivado_isolated_20260821.log 2>&1`。前段先物理复制模板，随后 `21:39:54` 在新目录启动 IP OOC 和顶层综合。`E:\coralnpu_vivado\projects\gestureflow_layer_chain_descriptor_hp0_7020_v1\axi_gpio.runs\system_gestureflow_0_3_synth_1\runme.log` 已确认是项目自研 GestureFlow IP 的本轮日志，显示 DSP 映射报告中存在 `gestureflow_mac_tile`，不是旧 Google 标量核；但在限时到达前尚未完成顶层 `synth_1`，更未创建 `impl_1/runme.log`、新的 `.bit`、新的 `.xsa`、新的 utilization/timing report。外层 WSL timeout 后发现两个 Windows `vivado.exe` 子进程未自动退出，已按精确 PID 与子树结束；继续前必须先确认没有 `vivado.exe` 残留，禁止并行重启 Vivado。
3. **本轮仿真证据已重新执行。** `bash gesture_project/innovation_npu/tests/run_gestureflow_descriptor_doorbell.sh` 输出 `GESTUREFLOW_DESCRIPTOR_DOORBELL_PASS issued=2 completed=2`；`bash gesture_project/innovation_npu/tests/run_gestureflow_layer_chain_descriptor_axil.sh` 输出 `GESTUREFLOW_TOP_DESCRIPTOR_PASS issued=2 completed=2 write_beats=32`。后者通过真实顶层的 AXI-Lite descriptor staging、HP0 RGB loader、既有 4x4 MAC/requant、output bank 和 HP0 burst writer；它是 4x2 有界控制/数据路径回归，不能代替 96x96 真模型板测。
4. **真实首层 descriptor 板测程序已新增并已交叉编译。** 新文件 `gesture_project/innovation_npu/board_7020/software/gestureflow_descriptor_replay_main.c` 以及 `build_software_descriptor_replay_from_wsl.sh`、`scripts/run_gestureflow_descriptor_replay_xsct.tcl` 均带项目自研标记。程序将真实 `gestureflow_real_conv4x4_full_layer.h` 中的 96x96 RGB 复制到显式 DDR 缓冲，兼容 ABI 一次性写入真实首层 16-lane 4x4 INT8 weight/bias/requant，然后提交两条完全相同的真实首层 descriptor 和一次 `DESC_CONTROL=2` doorbell。它不在运行期间写第二次 `CONTROL.start`；验收要求为 `DESC_ISSUED=2`、`DESC_COMPLETED=2`、无 DMA/store/fault、两块 DDR 输出均为真实 TFLite golden `GF_FULL_OUTPUT_FNV1A=0xF49B1B48`。ARM 编译日志为 `/tmp/gestureflow_descriptor_arm_compile_20260821.log`，已生成 `E:\coralnpu_vivado\projects\gestureflow_layer_chain_descriptor_hp0_7020_v1\vitis\axi_gpio\Debug\gestureflow_descriptor_replay.elf`，首轮规模 `text=56277, data=1144, bss=345168`；这只是 ELF 编译通过，不是下板结果。
5. **下一步不可跳过的操作顺序。** 首先等待或重新以单实例方式完成独立工程的 implementation，并只验收新目录 `logs/gestureflow_layer_chain_descriptor_hp0_7020.{bit,xsa,utilization_impl.rpt,timing_impl.rpt}` 的本轮时间戳、DRC=0、资源和 25 MHz WNS/WHS。然后用新 XSA 更新/确认 descriptor 项目的 standalone BSP，再重新编译第 4 条 ELF，最后复制 `run_gestureflow_descriptor_replay_xsct.tcl` 到 Windows 本地 E: 路径并运行。只有 XSCT 输出 `GESTUREFLOW_DESCRIPTOR_REPLAY_BOARD_PASS`、两个输出 FNV 和 descriptor counter 都通过后，才能把 descriptor 调度称为“实板通过”；下一阶段才是 `conv2_a` 的真实多 tile descriptor 和权重/量化元数据 DMA。

## 78 2026-08-21 descriptor 已接入真实 7020 layer-chain 顶层并通过两任务有界回归，Vivado 增量工程已隔离

**阅读顺序：必须先读本节；再读第 77 号了解 7020 不含标量前端的硬门禁；再读第 76 号了解权重 DMA 的模块级已验证范围。** 本节所有 RTL、测试和 Windows 工程改动均属于 `gesture_project/innovation_npu/` 项目自研，不是 Google CoralNPU 官方 RTL。`/home/steveguo/coralnpu-gesture/coralnpu` 保持只读、工作区干净，HEAD 为 `7318dfc2a94c0ac081bbe1787414391aa3cd5052`，不得修改。

1. **descriptor 已接入真实层链，而非仅独立玩具模块。** `gesture_project/innovation_npu/rtl/gestureflow_layer_chain_hp0_axil.sv` 新增 4-entry 项目自研 descriptor staging bank 和 `DESC_LOAD -> DESC_START -> DESC_WAIT` 状态机。PS 通过新增寄存器 `0x100..0x144` 写入 layer mode、宽高、输入 DMA 地址/字节/像素数、输出 writer 地址/字节/stride、量化配置、lane mask 和 descriptor count；仅写一次 `DESC_CONTROL.doorbell` 后，PL 将 descriptor 依次装入现有的 `layer_mode/DMA/store/QCFG` 锁存区，启动已有 reader/MAC/requant/writer 后端。它不会加入 RISC-V、官方标量前端、RVV 或 VME。
2. **完成判断已按真实后端门控。** descriptor 不会在“发射任务”时误报完成：它只能在实际 `store_done` 或 `post_done` 后将 `desc_completed` 加一并进入下一条；`protocol_error/quant_fault/dma_fault/store_fault` 会终止队列。普通卷积 descriptor 强制启用 store，避免无 writer completion event 时错误推进。旧 `CONTROL.start`/AXI-Lite 寄存器 ABI 仍保留为 debug 回退，但 descriptor active 时禁止旧 start 干扰。
3. **两条 descriptor 的真实顶层有界回归已 PASS。** 新增 `gesture_project/innovation_npu/tests/tb_gestureflow_layer_chain_descriptor_axil.sv` 和 `run_gestureflow_layer_chain_descriptor_axil.sh`。测试在真实 `gestureflow_layer_chain_hp0_axil` 顶层内配置已有权重 bank，写两条不同的输入/输出 descriptor，只写一次 doorbell，并由真实 HP0 RGB loader、4x4 MAC/requant、output bank 和 burst writer 完成两次任务。实际输出为 `GESTUREFLOW_TOP_DESCRIPTOR_PASS issued=2 completed=2 write_beats=32`，日志 `/tmp/gestureflow_top_descriptor_20260821.log`。这里的 32 个 64-bit writer beat 对应两条 8-vector job，各自采用既有 4-vector burst；验证重点是 PL 自动重放第二条，不是 toy counter。生产尺寸顶层 lint 也通过，日志 `/tmp/gestureflow_descriptor_top_lint_final_20260821.log`。
4. **未完成范围必须诚实保留。** 该回归使用 4x2 零权重的控制测试，不能替代真实 96x96 模型的 FNV/class golden；descriptor 当前也只接管输入/输出/层配置，不包含 bias/requant 元数据从 DDR 的自动搬运，且不会自动调用 weight DMA。权重 DMA 独立模块仍是第 76 号的 `writes=128 bytes=512` PASS；要形成真实连续帧路线，下一步需将模型导出器生成 per-tile weight/bias/requant descriptor，按模型切换一次由 PL DMA 载入，再运行真实多 tile 两帧。
5. **Vivado 状态和操作纪律。** 本轮实际启动 Windows Vivado，新的 descriptor IP synthesis run `system_gestureflow_0_5_synth_1` 已输出 `synth_design completed successfully`、`0 errors / 0 critical warnings`，日志为 `E:\coralnpu_vivado\projects\gestureflow_layer_chain_hp0_7020_v1\axi_gpio.runs\system_gestureflow_0_5_synth_1\runme.log`。但旧共享工程仍保留了此前脱离 WSL timeout 的 Vivado 子进程；重置 run 后出现 `*** Halting run - EA reset detected ***`，两次有界构建都没有形成可确认属于 descriptor RTL 的新 implementation report/XSA/bit。已按三分钟上限停止并终止残留 `vivado.exe` 进程；日志是 `/tmp/gestureflow_descriptor_vivado_build_20260821.log`、`/tmp/gestureflow_descriptor_vivado_build_retry_20260821.log` 和 `E:\...\axi_gpio.runs\impl_1\runme.log`。不得将旧 `writer_burst.bit` 或旧资源报告写成 descriptor 版本，更不得下载它做 descriptor 验证。
6. **隔离修复已完成，下一次构建入口已改变。** `gesture_project/innovation_npu/board_7020/run_build_layer_chain_hp0_7020_from_wsl.sh` 现在构建到新的 Windows 目录 `E:\coralnpu_vivado\projects\gestureflow_layer_chain_descriptor_hp0_7020_v1`，从已验证 HP0 工程模板复制，旧 `gestureflow_layer_chain_hp0_7020_v1` writer-burst 工程和 bit/XSA 不再被 reset。Tcl 也改为输出专用 `gestureflow_layer_chain_descriptor_hp0_7020_{utilization_impl,timing_impl}.rpt`、`.xsa` 和 `.bit`。Windows Vivado/Vitis/XSCT 必须在 `E:` 本地路径运行，绝不能 source `\\wsl.localhost`；构建一次最多 180 秒，若超时必须查看新目录的 `impl_1/runme.log`，不可重启平行构建。
7. **下一步固定顺序。** 先在全新的 descriptor 工程执行一次 Vivado implementation，验收：专用 report/XSA/bit 均为本次时间戳、DRC errors=0、25 MHz WNS/WHS 满足、资源仍低于 7020 门限。随后才修改 ARM 软件增加 descriptor 寄存器写入，先板测两条真实小任务，再导出真实 layer/tile descriptor 并用完整静态手势模型做多 tile/两帧 final FNV/class 对账。未满足这些条件前，不能烧录新 RTL，也不能宣称已减掉真实模型 PS 调度开销。

## 77 2026-08-21 固定 7020 不含标量前端边界，descriptor/doorbell 控制器模块级 PASS

**阅读顺序：必须先读本节；再读第 76 号了解权重 DDR 读取器的实际验证范围；再读《[CoralNPU与轻量NPU微架构协同优化要求_2026-08-21.md](CoralNPU与轻量NPU微架构协同优化要求_2026-08-21.md)》了解官方参考、7020 自研和未来平台三条路线的严格边界。** 本节所有新增 RTL 都属于 `gesture_project/innovation_npu/` 项目自研，不是 Google CoralNPU 官方 RTL；`/home/steveguo/coralnpu-gesture/coralnpu` 仍为只读的 Google 官方参考仓库，HEAD 为干净的 `7318dfc2a94c0ac081bbe1787414391aa3cd5052`，绝对不能修改。

1. **用户再次明确并已写成硬门禁。** Zynq-7020 资源不足以放入完整 CoralNPU 标量前端，更不能加入完整 `RVV + ROB/retire + VME` 前端。7020 唯一有效的架构是：`PS/ARM 写 layer/frame descriptor + doorbell -> PL 自主 descriptor queue/调度器 -> HP0 AXI + 本地权重/激活 bank -> 复用 16x4 INT8 MAC + INT32 部分和 -> 量化/池化/后处理`。PS 只能进行模型切换、帧缓冲、描述符提交、启动和结果读取，严禁回到逐窗口、逐像素、逐权重的 AXI-Lite 控制。现有 AXI-Lite 逐项配置只保留 debug/回退 ABI。
2. **完整研究要求已新增。** `gesture_project/docs/CoralNPU与轻量NPU微架构协同优化要求_2026-08-21.md` 已明确官方 `scalar/RVV/VRF/scoreboard/LSU/MAC/ZVT/TCM/AXI` 的真实模块入口、三条路线、7020 可借鉴和不可塞入的部分、轻量 NPU 对照、创新候选、验证闸门和自检清单。文档中的官方源码链接只供阅读，不能在官方目录修改文件；项目自研描述不得称为 Google 官方实现。
3. **新建最小 descriptor/doorbell 控制器。** `gesture_project/innovation_npu/rtl/gestureflow_descriptor_doorbell.sv` 是一个 4-entry、固定字段、AXI-Lite 可配置的项目自研控制器：PS 预写输入/输出/权重地址、空间尺寸、Cin/Cout 与 flags，写一次 `CONTROL.doorbell` 后，PL 连续发射 descriptor；每条 descriptor 被后端接收后，控制器必须等待 `backend_done/backend_fault`，才递增 completed 或开始下一条。它输出 `busy/done/fault/issued/completed`，有意不包含 RISC-V 指令、取指、解码、ROB、RVV 或 VME，是未来层链自主调度的最小控制骨架，不得误写为 CoralNPU 标量核心。
4. **真实有界模块级验证已通过。** 新增 `gesture_project/innovation_npu/tests/tb_gestureflow_descriptor_doorbell.sv` 和 `run_gestureflow_descriptor_doorbell.sh`；实际执行日志为 `/tmp/gestureflow_descriptor_doorbell_20260821.log`，包含 `GESTUREFLOW_DESCRIPTOR_DOORBELL_PASS issued=2 completed=2`。该测试先写两条不同 descriptor，再一次 doorbell，逐项输出两个 input/output/weight 地址，并对每条 descriptor 模拟延迟的 `backend_done`，证明连续发射、后端完成门控和完成计数；同时 `verilator --lint-only --timing --sv` 已通过。权重读取器回归也再次实际通过，日志 `/tmp/gestureflow_descriptor_stage_weight_dma_20260821.log`，输出 `GESTUREFLOW_WEIGHT_DMA_LOADER_PASS writes=128 bytes=512`。
5. **严格未完成项。** descriptor 控制器当前未接入 `gestureflow_layer_chain_hp0_axil.sv`，尚未与 `gestureflow_hp0_weight_dma_loader.sv` 或 MAC/backend handshake 联动，未进行顶层动态回归，未 Vivado 综合/布局布线，未生成 bit/XSA，也未下板。它不能用旧 writer-burst bit 验证，不能用本节模块级 PASS 宣称“PL 已完成整网自主调度”。在接入以前，旧实板 baseline 仍只有第 74 号 writer-burst bit/XSA 和 `FINAL_RESULT=0x600D600D`。
6. **下一步顺序不得跳过。** 先把该控制器作为独立子模块接入现有 layer-chain 顶层，但仅将 descriptor 的输入/输出/权重地址、尺寸和配置路由到已有寄存器锁存区；新增 `backend_start/backend_done/backend_fault` 握手，不改 MAC 算术和旧 debug ABI。然后写 30 秒以内的 top-level 定向 testbench，覆盖两描述符、权重 DMA 忙冲突、后端 fault、abort/reset 和连续两帧；动态通过后才更新 Windows Vivado Tcl 文件清单，运行有界综合并记录 LUT/BRAM/DSP/WNS。任何新 RTL 未完成这组闸门前不得烧录。

## 76 2026-08-21 完成权重 DDR 描述符读取器模块级 PASS，顶层接入完成 lint 但尚未完成全层仿真和上板

**阅读顺序：必须先读本节；再读第 75 号了解权重生命周期硬门禁和过渡 key 协议；再读第 74 号确认仍有效的旧 writer-burst 实板基线。** 本节所有 RTL 均是 `gesture_project/innovation_npu/` 下的项目自研实现，不是 Google CoralNPU 官方 RTL；`/home/steveguo/coralnpu-gesture/coralnpu` 仍保持只读，不能修改。

1. **新增模块。** `gesture_project/innovation_npu/rtl/gestureflow_hp0_weight_dma_loader.sv` 实现了第一版 descriptor-driven 权重读取器：从 DDR 连续 64-bit AXI 读突发进入 16-beat 环形缓存，再拆成 32-bit 权重字，以 `输出通道 -> 4x4 tap -> 4 输入通道组` 坐标逐周期输出到现有权重 bank 写协议。它支持 4 KB 边界限制、AXI 响应/ID/最后拍检查、读字节计数和本地写字计数，PS 不参与逐权重写入。
2. **模块级真实仿真。** `gesture_project/innovation_npu/tests/tb_gestureflow_hp0_weight_dma_loader.sv` 和 `run_gestureflow_hp0_weight_dma_loader.sh` 已实际运行通过，日志为 `/tmp/gestureflow_weight_dma_loader_20260821.log`，输出 `GESTUREFLOW_WEIGHT_DMA_LOADER_PASS writes=128 bytes=512`。测试逐字校验了 128 个权重字、字节数以及输出通道/tap/输入组坐标；这是当前新 DMA 路径的有效证据。
3. **顶层接入。** `gestureflow_layer_chain_hp0_axil.sv` 已接入该读取器，并在共享 HP0 读口上设置“权重 DMA 忙时独占读请求”的选择逻辑；DMA 写数据与旧 PS 写数据共用一个统一写口。新增寄存器为 `0x0e0 WEIGHT_DMA_SOURCE`、`0x0e4 WEIGHT_DMA_BYTES`、`0x0e8 WEIGHT_DMA_CFG`、`0x0ec WEIGHT_DMA_CONTROL`、`0x0f0 WEIGHT_DMA_STATUS`、`0x0f4 WEIGHT_DMA_BYTES_READ`、`0x0f8 WEIGHT_DMA_WRITE_COUNT`。旧 AXI-Lite 路径保持可用。
4. **顶层静态检查已完成。** 使用项目要求的 `VERILATOR_ROOT` 环境运行顶层自研 RTL lint，退出码为 0，日志为 `/tmp/gestureflow_weight_dma_top_lint_20260821.log`。Vivado Tcl 的源文件清单也已加入 `gestureflow_hp0_weight_dma_loader.sv`，后续重新生成 IP 时不会漏文件。
5. **顶层动态验证尚未完成。** 旧的 `tb_gestureflow_layer_chain_hp0_axil.sv` 已重新编译包含新模块，但首次编译在 150 秒窗口内只完成 C++ 构建；随后直接运行已生成二进制 90 秒仍无 PASS/FAIL，按门禁停止。日志分别为 `/tmp/gestureflow_weight_dma_top_regress_20260821.log` 和 `/tmp/gestureflow_weight_dma_top_sim_20260821.log`。不能把该顶层回归称为通过，也不能因为模块级 PASS 就宣称整网 DMA 已验证。
6. **当前功能边界。** 该第一版 DMA 目前只搬运权重数据，bias/requant 元数据的 DDR 描述符搬运、双 tile 预取、权重 DMA 与 MAC 计算的真正重叠、模型完整多 tile 连续帧以及顶层 AXI 读仲裁的动态覆盖仍未完成。当前也没有重新综合、布局布线、生成 bit/XSA 或下板；不得使用本版 RTL 生成物进行板测，不得覆盖第 74 号已签核 bit/XSA。
7. **下一步。** 不再重复运行无界全层 testbench；先写一个小型顶层 DMA descriptor testbench，只验证寄存器启动、HP0 读请求独占、权重写口坐标、完成/错误状态和旧路径隔离。之后加入 bias/requant 元数据描述符，再做 Vivado 有界综合，记录资源/WNS；只有综合和局部仿真通过后，才编译 ARM descriptor 程序并在 7020 上做单层多 tile 双帧，最后再接整网。性能主线仍是“模型加载一次、PL 自主 tile 调度、连续帧只提交 doorbell”，不是继续增加 PS 写寄存器次数。

## 75 2026-08-21 将“权重搬运不是事后补丁”固化为主线硬门禁，并完成驻留协议的 RTL/软件有界验证

**阅读顺序：必须先读本节；再读第 74 号了解已实板通过的 writer-burst 基线；再读《[7020帧率优化完整方案与可行性评估_2026-08-21.md](7020帧率优化完整方案与可行性评估_2026-08-21.md)》第 1.4、阶段 C 和阶段 D。** 本节新增的 RTL 和软件全部属于 `gesture_project/innovation_npu/` 下的项目自研实现，并保留 `PROJECT_LOCAL_SELF_RESEARCH_NOT_GOOGLE_OFFICIAL` 标记；`/home/steveguo/coralnpu-gesture/coralnpu` 仍为 Google 官方只读参考仓库，绝对不能修改。

1. **设计要求已重新收紧。** 不能再把“每帧由 PS 通过 AXI-Lite 逐项写权重、逐 tile 启动”当作最终软硬件协同方案。最终主线必须是：模型切换时将权重和量化元数据放入 DDR/本地权重存储一次；PS 只提交帧描述符和 doorbell；PL 自主读取描述符、按 tile 顺序突发搬入本地权重 bank、执行输入行缓存/卷积/累加/量化/池化，并通过 ping-pong 缓冲向下一层交接。连续帧必须证明权重不重装、没有旧 tile 污染，并分别报告 DDR 字节、AXI burst、MAC 空闲周期、片上命中率、PL 周期和端到端墙钟。
2. **本轮先落地可观测的过渡协议。** 在 `gesture_project/innovation_npu/rtl/gestureflow_layer_chain_hp0_axil.sv` 增加项目自研寄存器：`0x0c0 WEIGHT_KEY`、`0x0c4 WEIGHT_RESIDENT_KEY`、`0x0c8 WEIGHT_WRITE_COUNT`、`0x0cc WEIGHT_HIT_COUNT`、`0x0d0 WEIGHT_BYTES`、`0x0d4 WEIGHT_STATUS`、`0x0d8 WEIGHT_COMMIT`、`0x0dc WEIGHT_MISS_COUNT`。写入 key 后，相同 bank 内容命中时禁止再次写 `WCTRL/WDATA/BIDX/RQ*`；未命中时必须写完并 commit；运行期间写权重或在未 commit 状态启动会置 fault。旧软件从不写 `WEIGHT_KEY` 时仍保持旧 ABI 行为，便于回退。
3. **软件已接入，但不能夸大收益。** `gesture_project/innovation_npu/board_7020/software/gestureflow_layer_chain_hp0_main.c` 为每个输出 tile 形成包含权重、bias、requant、输出 tile 身份和 lane mask 的 FNV 指纹，并调用 `weight_prepare()`/`weight_commit()`。该指纹目前在 ARM 侧按 tile 计算，属于一致性和协议验证路径；7020 只有一个物理 16 输出 bank，因此它还不能缓存完整网络的所有 tile，也不能宣称已经完成跨帧完整模型权重驻留。真正的性能版本必须改成 DDR 中的权重描述符和 PL 自主 DMA，不能把运行时 FNV 扫描保留在摄像头发布路径。
4. **已执行的验证。** 按既有环境方式运行顶层自研 RTL `verilator --lint-only --timing --sv`，结果退出码为 0，日志为 `/tmp/gestureflow_weight_residency_lint_20260821.log`。Windows 侧 Vitis 交叉编译实际完成，日志为 `/tmp/gestureflow_weight_residency_software_build_20260821.log`，ELF 规模为 `text=762389, data=1144, bss=709264`。之前直接运行完整顶层 Verilator 回归在 45 秒有界窗口内只完成了 C++ 编译、未到仿真 PASS，日志为 `/tmp/gestureflow_weight_residency_axil_regress_20260821.log`，不得称为回归通过。第一次 lint 因未设置 `VERILATOR_ROOT` 找不到 `verilated_std.sv`，属于工具环境错误，修正环境变量后已通过。
5. **当前明确禁止的操作。** 本版 RTL 尚未在 Windows Vivado 中重新综合、尚未完成布局布线、尚未生成新 bit/XSA、尚未下板；不得使用本版软件配旧 bit 做“新协议板测”，也不得把第 74 号的旧 `FINAL_RESULT=0x600D600D` 归因到本轮。不得把单 bank 的 key 命中统计描述成完整网络的 cache hit；必须先实现 PL 权重 DMA/descriptor，至少完成一层多 tile 连续两帧，再扩展到整网。
6. **下一步唯一主线。** 新增权重 AXI 读通道/描述符：descriptor 给出权重 DDR 基址、字节数、输出 tile、模型版本和校验值；PL 以不跨 4 KB 边界的 AXI burst 读入本地 bank， bias/requant 同步进入本地元数据 bank；计算 tile N 时预取 N+1，保留 AXI-Lite 作为 debug 回退。先做单层 3 个 tile 的行为仿真和 DDR 字节/突发计数，再做 Vivado 有界综合与板级双帧，最后才接入整网和摄像头。任何阶段若没有最终 FNV、class、fault、weight write/hit/miss 和周期证据，不得标记为完成。

## 74 2026-08-21 writer burst 新 bit 已实板通过，并完成端到端性能计数

**阅读顺序：必须先读本节；再读第 73 号了解新 bit 的构建、逐层周期和收益归因；再读《[7020帧率优化完整方案与可行性评估_2026-08-21.md](7020帧率优化完整方案与可行性评估_2026-08-21.md)》了解后续路线。** 本节和第 73 号涉及的 RTL、软件与脚本都属于 `gesture_project/innovation_npu/` 项目自研内容，不是 Google CoralNPU 官方实现。`/home/steveguo/coralnpu-gesture/coralnpu` 仍为 Google 官方只读参考仓库，HEAD 为干净的 `7318dfc2a94c0ac081bbe1787414391aa3cd5052`，不得修改。

1. **端到端计数已实际下板。** 在不改变 RTL 和寄存器 ABI 的前提下，`gesture_project/innovation_npu/board_7020/software/gestureflow_layer_chain_hp0_main.c` 新增 `XTime` 计数：整帧、输入准备、权重/量化参数 AXI-Lite 装载和 PL 周期总和分别写入 `PROBE[130..133]`；XSCT 读取窗口已扩展到 134 项。重新编译日志为 `/tmp/gestureflow_timing_instrumented_software_build_20260821.log`，最终板测日志为 `/tmp/gestureflow_timing_probes_board_20260821.log`。
2. **性能计数结果。** 新 writer-burst bit/XSA 下再次输出 `FINAL_RESULT=0x600D600D`、三个 FNV 完全匹配、class=0、DMA/store 无 fault。`PROBE[130]=0x0793BA6F=127,122,031` global timer ticks（从启动到最终分类完成）；`PROBE[131]=0x0006B625=439,845` ticks 输入复制与 cache flush；`PROBE[132]=0x01D2A1F1=30,581,233` ticks 权重和量化参数装载；`PROBE[133]=0x0048975C=4,757,340` PL 周期总和。逐层 `PROBE` 之和为 `4,757,296`，差异为计数边界/寄存器读回的几十个时钟，属于正常测量开销。
3. **按当前约 333.333 MHz global timer 的折算。** 整帧约 `381.37 ms`，输入准备约 `1.32 ms`，权重装载约 `91.74 ms`，PL 计算约 `14.27 ms`（PL 自身为 25 MHz，纯 PL 链按 4,757,296 cycles 折算仍为 `190.29 ms`；两者不是同一个时钟域口径）。整帧墙钟明显高于 PL 周期，原因包括 PS 启动、AXI-Lite 权重写入、轮询、DDR hash 回读和软件校验；当前不能把 `5.255 FPS` 纯 PL 上限当成摄像头端到端 FPS。
4. **路线判断。** 权重装载约占 ARM global-timer 观测窗口的 `24.06%`，且每帧重复发生；因此下一步最高收益方向是“模型切换时一次装载、连续帧只写输入/描述符”，具体为权重跨帧驻留、descriptor/doorbell、自主 tile 顺序和 ping-pong activation。不能先复制第二个完整 MAC tile，因为当前资源为 `177/220 DSP`、`99/140 BRAM tile`，且放置后 slice site 已接近饱和。
5. **本轮文件和复现入口。** 性能计数代码位于 `gesture_project/innovation_npu/board_7020/software/gestureflow_layer_chain_hp0_main.c`；XSCT 读取扩展位于 `gesture_project/innovation_npu/board_7020/scripts/run_gestureflow_layer_chain_hp0_xsct.tcl`；writer-burst 固定产物入口是 `gesture_project/innovation_npu/board_7020/run_board_layer_chain_hp0_writer_burst_from_wsl.sh`。仍必须使用 `E:\coralnpu_vivado` 本地路径和 `pushd E:`，不得让 Vivado/Vitis/XSCT source WSL UNC 路径；超过约 3 分钟的命令使用 `timeout` 并保留日志。

## 73 2026-08-21 writer burst 新 bit 已实板通过，整网周期降至 4,757,296

**阅读顺序：必须先读本节；再读第 72 号了解 banked loader 的 Vivado 修复和构建过程；再读《[7020帧率优化完整方案与可行性评估_2026-08-21.md](7020帧率优化完整方案与可行性评估_2026-08-21.md)》了解优化边界。** 本节和第 72 号涉及的 RTL、软件与脚本都属于 `gesture_project/innovation_npu/` 项目自研内容，不是 Google CoralNPU 官方实现。`/home/steveguo/coralnpu-gesture/coralnpu` 仍为 Google 官方只读参考仓库，HEAD 为干净的 `7318dfc2a94c0ac081bbe1787414391aa3cd5052`，不得修改。

1. **新 bit/XSA 已完成真实构建并独立归档。** Windows Vivado 的 `impl_1` 后续完成了 `route_design` 和 `write_bitstream`，日志位于 `E:\coralnpu_vivado\projects\gestureflow_layer_chain_hp0_7020_v1\axi_gpio.runs\impl_1\runme.log`。新产物已归档为：`E:\coralnpu_vivado\projects\gestureflow_layer_chain_hp0_7020_v1\logs\gestureflow_layer_chain_hp0_7020_writer_burst.bit` 和 `E:\coralnpu_vivado\projects\gestureflow_layer_chain_hp0_7020_v1\logs\gestureflow_layer_chain_hp0_7020_writer_burst.xsa`。SHA-256 分别为 `47d42e3169169c8e11121f85c02a55ea8b328d59005112dbfebad413f307f984` 和 `8acd7e41efc72a6d5407e7b2d0cdad35cd9328b1f2806b615afab7c162ee8010`；旧回退 bit/XSA 未覆盖。
2. **实现后资源及时序。** `system_wrapper_utilization_placed.rpt` 显示 `34,584 Slice LUT (65.01%)`、`47,742 FF (44.87%)`、`99 BRAM tile`（`91 RAMB36E1 + 16 RAMB18E1`，`70.71%`）和 `177 DSP48E1 (80.45%)`。`system_wrapper_timing_summary_routed.rpt` 显示 25 MHz `WNS=+0.324 ns`、`WHS=+0.040 ns`，TNS/THS 均为 0，所有用户时序约束满足。DRC 为 0 error、0 critical warning；仍有 `DPOP-2 MREG=0` 的量化乘法器流水建议，后续需单独评估。
3. **新 bit 实板结果。** 使用新 bit、新 XSA 和重新编译的 ARM ELF，运行 `bash gesture_project/innovation_npu/board_7020/run_board_layer_chain_hp0_writer_burst_from_wsl.sh`，日志为 `/tmp/gestureflow_writer_burst_board_20260821.log`。输出 `GESTUREFLOW_LAYER_CHAIN_HP0_FULL_NETWORK_BOARD_PASS`，`FINAL_RESULT=0x600D600D`；`head FNV=0x53C6484E`、`GAP FNV=0xABBC5831`、`FC FNV=0xDDE32561`、`class=0`，各 DMA/store 状态均为 done 且无 fault。ARM 软件编译日志为 `/tmp/gestureflow_writer_burst_software_build_20260821.log`，ELF 为 `text=760825, data=1144, bss=709264`。
4. **逐层周期。** 新板测 `PROBE` 解析为：首层 `300010`；pool1 路径 `726700`；conv2_a 三块 `214751,214752,212447`，合计 `641950`；conv2_b+pool2 三块 `403749,403751,403176`，合计 `1210676`；conv3_a 五块 `109432,109433,109440,109433,109432`，合计 `547170`；conv3_b+pool3 五块 `193957,193956,193962,193956,193955`，合计 `969786`；head1x1 七块合计 `356233`；GAP+FC `4771`。纯 PL 总周期为 `4,757,296`，25 MHz 下 `190.29184 ms`，周期折算 `5.255 FPS`。旧回退 bit 实测为 `5,316,780 cycles / 212.6712 ms / 4.702 FPS`，本版下降 `559,484 cycles`、`10.523%`。
5. **收益归因必须分开。** 本版同时包含 RGB 首层由 4 组改为 1 组的确定性修复和 writer 连续 burst。首层从旧 `857578` 降到新 `300010`，主要收益来自消除 RGB 无效输入组；该修复理论节省 `442368 cycles`。writer burst 的 RTL 定向回归已通过，但当前没有同一 RTL、仅关闭 `contiguous_burst` 的对照 bit，因此不能把总周期下降全部归功于 burst，也不能把 AXI 事务减少直接等价为同等比例 FPS 提升。
6. **下一步。** 新版本可作为 writer burst 的实板验证基线，但资源已接近 7020 边界：`177/220 DSP`、`99/140 BRAM tile`，slice 占用 `65.01%` 且放置后的 slice site 接近饱和，不能复制完整 MAC tile。下一优先级是生成 burst 开关 A/B、统计 AXI AW/B 事务和各层周期；随后评估量化乘法器 MREG/PREG、权重跨帧驻留、descriptor/doorbell 和 `conv3_b -> pool3 -> head -> GAP` 片上行接力。每个新版本都必须重新编译、重新下板、读取完整 `PROBE` 和最终 FNV。
7. **操作细节。** Vivado/Vitis/XSCT 仍只能在 Windows 本地 `E:` 工程运行，脚本必须 `pushd E:`，不能让工具 source `\\wsl.localhost\...` UNC 路径。本轮新增 `gesture_project/innovation_npu/board_7020/run_board_layer_chain_hp0_writer_burst_from_wsl.sh`，显式选择归档的 writer-burst bit/XSA；通用脚本也支持 `GESTUREFLOW_BIT_PATH_WIN` 和 `GESTUREFLOW_XSA_PATH_WIN`。后续不能只看 `axi_gpio.runs\impl_1\system_wrapper.bit`，必须核对归档产物 SHA-256。超过约 3 分钟的 Vivado 命令继续使用 `timeout` 并保存 `/tmp/` 日志。

## 72 2026-08-21 writer 连续突发已完成有界验证，banked loader 已修复为 Vivado 可综合写法，但新 bit 尚未生成

**阅读顺序：必须先读本节；再读第 71 号记录了解 RGB 输入组修复和旧回退 bit；再读《[7020帧率优化完整方案与可行性评估_2026-08-21.md](7020帧率优化完整方案与可行性评估_2026-08-21.md)》了解阶段路线。** 本节全部 RTL 均是 `gesture_project/innovation_npu/` 下的项目自研内容，带有 `PROJECT_LOCAL_SELF_RESEARCH_NOT_GOOGLE_OFFICIAL` 标识；`/home/steveguo/coralnpu-gesture/coralnpu` 仍为 Google 官方只读参考仓库，HEAD 为干净的 `7318dfc2a94c0ac081bbe1787414391aa3cd5052`，绝对不能修改。

1. **writer 连续突发已经落地并通过定向回归。** `gesture_project/innovation_npu/rtl/gestureflow_hp0_tensor_writer.sv` 现在仅在非池化、`VECTOR_BYTES=16`、有效 stride 和有效字节均为 16 的连续输出模式下，将最多 4 个 16-byte 输出向量收集为一次 AXI burst；一个事务最多 8 个 64-bit beat。40/80 通道 tile 的跨像素 NHWC stride、8-byte 尾块和 2x2 pooling 继续使用原有逐向量事务，不会把不连续数据错误拼成长突发。一次 burst 结束后仍只等待一个 B response，`vectors_written` 和 `bytes_written` 按完整向量数和字节数累计。
2. **writer 验证证据。** `timeout 90s bash gesture_project/innovation_npu/tests/run_gestureflow_hp0_tensor_writer.sh` 输出 `GESTUREFLOW_HP0_TENSOR_WRITER_PASS vectors=5 bytes=80`；`run_gestureflow_hp0_tensor_writer_strided.sh` 输出 `GESTUREFLOW_HP0_TENSOR_WRITER_STRIDED_PASS vectors=5 stride=40 valid_bytes=8`；`run_gestureflow_hp0_tensor_writer_pool_strided.sh` 输出 `GESTUREFLOW_HP0_TENSOR_WRITER_POOL_STRIDED_PASS outputs=2 stride=40 tail_bytes=8`；新增 `run_gestureflow_hp0_tensor_writer_boundary.sh` 输出 `GESTUREFLOW_HP0_TENSOR_WRITER_BOUNDARY_PASS bursts=2 beats=10`，起始地址 `0x00100fe0` 时实际拆成 4 beat 与 6 beat，证明不跨 4 KB 边界。完整汇总日志为 `/tmp/gestureflow_writer_burst_regressions_final_20260821.log`，边界日志为 `/tmp/gestureflow_writer_boundary_20260821.log`。
3. **banked loader 已针对 Vivado 综合器修复。** `gesture_project/innovation_npu/rtl/gestureflow_hp0_tensor_loader_banked.sv` 原先的指针函数使用 `while` 环回，Vivado 2023.2 在 `system_gestureflow_0_3_synth_1` 中报 `loop condition does not converge after 2000 iterations`。由于 FIFO 深度约束为 2 的幂，现已改为定宽加法截断实现环回；生成块读取也改为常量 beat/byte 索引，避免 Vivado 无法解析动态函数索引。修复后 `run_gestureflow_hp0_tensor_loader_banked.sh` 的 16/40/80 通道验证全部通过，分别输出 48、120、240 bytes 的完整像素检查 PASS；日志为 `/tmp/gestureflow_hp0_tensor_loader_banked_after_vivado_fix_20260821.log`。
4. **RTL 门禁状态。** 顶层 Verilator lint 已通过，日志为 `/tmp/gestureflow_layer_chain_hp0_axil_lint_banked_20260821.log`；writer 四项定向回归通过。顶层多层行为回归曾因原测试仍期望旧版本 `0x00040003` 而没有完成；断言已同步到 RTL 当前版本 `0x00040004`，但该 testbench 包含大量全层周期和寄存器装载，当前没有把未输出最终 PASS 的运行称为成功，也没有继续无界等待。
5. **Vivado 真实结果。** 首次 writer 版本构建因为 banked loader 的 `while` 和动态索引在自研 IP 综合失败；修复后重新执行 `timeout 180s bash gesture_project/innovation_npu/board_7020/run_build_layer_chain_hp0_7020_from_wsl.sh`，日志为 `/tmp/gestureflow_layer_chain_hp0_7020_writer_burst_vivado_retry_20260821.log`。本次 `system_gestureflow_0_4_synth_1` 自研 IP 综合和顶层 `synth_1` 均成功，综合报告仍显示 `177 DSP48E1`、`91 RAMB36E1`、`16 RAMB18E1`，没有增加第二个 MAC tile；但 `impl_1` 在 180 秒窗口内没有完成 `route_design/write_bitstream`，没有新的 routed timing/utilization、bitstream 或 XSA。不得把这次综合成功写成上板版本，也不得使用它重新下板。
6. **当前有效回退产物和下一步。** 当前仍只能使用已签核旧 bit `E:\coralnpu_vivado\projects\gestureflow_layer_chain_hp0_7020_v1\logs\gestureflow_layer_chain_hp0_7020.bit`（SHA-256 `5ff1b01c9b5e0fa6aceb43e4088cb60855a644e60b5119808ac205122696f92a`）和旧 XSA（SHA-256 `b2e73debe537bab0cf14960231a69d9236bf64a4b08f73ac994fff6678e338b1`）。下一次先确认没有 Vivado 残留，再在 Windows 本地 `E:` 工程检查 `axi_gpio.runs/impl_1/runme.log` 和新的实现状态；若要取得 writer 优化实测，必须重新完成 implementation、bitgen、XSA、软件配套编译和实板 `FINAL_RESULT=0x600D600D`、FNV、各层 cycle 验收。所有 Vivado/XSCT 操作继续使用 `pushd E:`，不得直接 source WSL UNC 路径。

## 71 2026-08-21 帧率优化方案落地，首层修复已综合但新 bit 构建超过有界窗口

**阅读顺序：必须先读本节；再读 第 70 号记录了解快速发布模式实板 PASS 和首层修复；再读《[7020帧率优化完整方案与可行性评估_2026-08-21.md](7020帧率优化完整方案与可行性评估_2026-08-21.md)》了解完整优化路线。** 本节所有 RTL 修改仍在 `gesture_project/innovation_npu/`，属于项目自研；`/home/steveguo/coralnpu-gesture/coralnpu` 是 Google 官方只读参考，绝对不能修改。

1. **已形成详细帧率优化方案。** 新文档覆盖当前真实 7020 基线、确定性浪费、MAC/loader/writer/PS 控制瓶颈、阶段 A 至 E 的实施顺序、资源和时序预算、模型 A/B 规则、片上层间接力方向以及每次验证的闸门。核心路线是：先消除无效计算和重复证明，再改 banked loader FIFO、突发 writer、跨帧权重驻留、descriptor/doorbell 控制，最后做后层片上接力；不能在 `177/220 DSP` 和 `WNS=+0.140 ns` 基线上直接复制第二个完整 tile。
2. **首层无效输入组修复已在自研 RTL 中完成。** `gesture_project/innovation_npu/rtl/gestureflow_layer_chain_hp0_axil.sv` 现在对 RGB 使用 1 个四通道组，对 16/40/80 通道模式保持 4/10/20 组。理论节省为 `442,368 cycles`，但必须等待新 bit 实测，不得将 `5.129 FPS` 理论值写成板测结果。`gesture_project/innovation_npu/rtl/gestureflow_conv4x4_cin_stream.sv` 也加入了 `16'(IMAGE_WIDTH)` 显式端口转换。
3. **有界回归仍然通过。** `timeout 30s bash gesture_project/innovation_npu/tests/run_gestureflow_conv4x4_cin_stream.sh` 输出 `GESTUREFLOW_CONV4X4_CIN_STREAM_PASS psum=135`；MAC tile、pool writer、真实 GAP/FC 回归分别保持 `GESTUREFLOW_MAC_TILE_PASS`、`GESTUREFLOW_HP0_TENSOR_WRITER_POOL_STRIDED_PASS` 和 `GESTUREFLOW_HP0_GAP_FC_REAL_PASS cycles=2564 gap=abbc5831 fc=dde32561 class=0`。快速软件编译退出码为 0，日志 `/tmp/gestureflow_fast_release_compile_20260821.log`。
4. **Vivado 构建状态必须如实记录。** 使用 `timeout 180s bash gesture_project/innovation_npu/board_7020/run_build_layer_chain_hp0_7020_from_wsl.sh`，日志 `/tmp/gestureflow_layer_chain_hp0_7020_input_group1_vivado_20260821.log`。BD 重新生成成功，自研 IP `system_gestureflow_0_2_synth_1` 综合完成，`0 errors / 0 critical warnings`，综合资源初步为 `177 DSP / 91 RAMB36 / 16 RAMB18 / 45,843 FF`。顶层 `synth_1` 也完成，但 `impl_1` 在 180 秒窗口内未完成；随后已停止残留 Vivado 进程。Windows 详细日志位于 `E:\coralnpu_vivado\projects\gestureflow_layer_chain_hp0_7020_v1\axi_gpio.runs\impl_1\runme.log`。新 `impl_1/system_wrapper.bit`、新 routed XSA、布局布线时序报告均未生成；`reset_run impl_1` 删除了工作路径的旧 bit，但已核对的回退产物仍在 `logs\gestureflow_layer_chain_hp0_7020.bit`（SHA-256 `5ff1b01c9b5e0fa6aceb43e4088cb60855a644e60b5119808ac205122696f92a`）和 `logs\gestureflow_layer_chain_hp0_7020.xsa`（SHA-256 `b2e73debe537bab0cf14960231a69d9236bf64a4b08f73ac994fff6678e338b1`）。
5. **下一次恢复操作。** 先确认没有 Vivado 残留进程，再在 Windows 本地工程 `E:\coralnpu_vivado\projects\gestureflow_layer_chain_hp0_7020_v1` 检查 `impl_1/runme.log`、`.Vivado_Implementation.queue.rst` 和回退 bit 时间戳。不要重复启动多个 Vivado。XSCT 脚本 `gesture_project/innovation_npu/board_7020/scripts/run_gestureflow_layer_chain_hp0_xsct.tcl` 已加入回退逻辑：优先使用 `impl_1/system_wrapper.bit`，不存在时自动使用已核对的 `logs\gestureflow_layer_chain_hp0_7020.bit`，并打印实际选择路径。若重新构建，仍需用有界命令并把完整输出保存到新的 `/tmp/` 日志；只有新 bit/XSA 和 `route_design/write_bitstream` 完成后才重新编译 ELF、启动 `hw_server`、下板读取全部 `PROBE`。首要比较 `PROBE[5]` 是否由旧 `857,578` 下降，以及最终 `0x600D600D`、三个 FNV、class、DMA fault 是否全部保持。
6. **不可误读的边界。** 第 70 号记录中的 `4.702 FPS` 是快速发布旧 bit 的真实 PL 周期折算；本节首层组数修复的 `5.129 FPS` 只是周期模型。banked FIFO、long burst writer、descriptor、自主多层执行、片上后层接力、50 MHz 和摄像头实时链路当前都没有完成，不能提前写成已实现。

## 70 2026-08-21 快速发布模式实板通过，完成首层无效输入组定位并形成7020帧率优化路线

**阅读顺序：必须先读本节；再读 第 69 号记录了解完整 4×4 模型整网实板基线；随后阅读《[7020帧率优化完整方案与可行性评估_2026-08-21.md](7020帧率优化完整方案与可行性评估_2026-08-21.md)》了解瓶颈拆分、资源预算、阶段路线和验证闸门。** 本节新增修改全部位于 `gesture_project/innovation_npu/`，是项目自研 RTL/软件，不是 Google CoralNPU 官方代码。`/home/steveguo/coralnpu-gesture/coralnpu` 继续只读，绝对不能修改。

1. **快速发布模式已经真实上板通过。** 运行 `bash gesture_project/innovation_npu/board_7020/run_board_layer_chain_hp0_7020_from_wsl.sh`，Windows `hw_server` 监听 `tcp:127.0.0.1:3334` 后，7020 实板返回 `GESTUREFLOW_LAYER_CHAIN_HP0_FINAL_RESULT = 0x600D600D` 和 `GESTUREFLOW_LAYER_CHAIN_HP0_FULL_NETWORK_BOARD_PASS`。head/GAP/FC FNV 仍为 `0x53C6484E`、`0xABBC5831`、`0xDDE32561`，class 为 0。该结果证明跳过三次普通证明回放不会改变发布模型结果。
2. **快速发布路径的真实周期。** 实板 `PROBE` 记录为：`conv1_a=857,578`、`conv1_b+pool1=726,914`、`conv2_a=642,322`、`conv2_b+pool2=1,211,061`、`conv3_a=547,572`、`conv3_b+pool3=970,133`、`head1x1=356,435`、`GAP+FC=4,765`，总计 `5,316,780 cycles`。25 MHz 下为 `212.6712 ms`，纯 PL 周期理论上限为 `4.702 FPS`。这不是摄像头端到端 FPS，PS 控制、权重和输入搬运仍需独立测量。
3. **已修复一个确定的 RTL 浪费。** 在 `gesture_project/innovation_npu/rtl/gestureflow_layer_chain_hp0_axil.sv` 中，RGB 首层原来错误使用 4 个四通道输入组；RGB 实际只有 3 个有效通道，第四 lane 已由 `input_lane_enable=4'b0111` 屏蔽，因此已改为 1 组。16/40/80 通道模式保持 4/10/20 组。理论节省为 `(4-1)*16*9216=442,368 cycles`，修复后理论总周期约 `4,874,412`、25 MHz 约 `5.129 FPS`，尚未生成包含该修复的新 bit，不能把理论数称为实测数。
4. **已修复独立通道流回归的宽度告警。** `gesture_project/innovation_npu/rtl/gestureflow_conv4x4_cin_stream.sv` 将 `IMAGE_WIDTH` 显式转换为 16 位连接到 `frame_width`。`timeout 30s bash gesture_project/innovation_npu/tests/run_gestureflow_conv4x4_cin_stream.sh` 已输出 `GESTUREFLOW_CONV4X4_CIN_STREAM_PASS psum=135`。
5. **本轮有界回归和编译结果。** MAC tile 输出 `GESTUREFLOW_MAC_TILE_PASS psum=72,95,118,141`；pool writer 输出 `GESTUREFLOW_HP0_TENSOR_WRITER_POOL_STRIDED_PASS outputs=2 stride=40 tail_bytes=8`；真实 GAP/FC 输出 `GESTUREFLOW_HP0_GAP_FC_REAL_PASS cycles=2564 gap=abbc5831 fc=dde32561 class=0`；快速软件构建退出码为 0，ELF text/data/bss 为 `760825/1144/709264`。编译日志为 `/tmp/gestureflow_fast_release_compile_20260821.log`。
6. **当前硬件优化判断。** 当前实现资源是 `34,054 LUT / 48,236 FF / 91 RAMB36+16 RAMB18 / 177 DSP`，25 MHz `WNS=+0.140 ns`、`WHS=+0.011 ns`，不能在未优化时序和资源前提下直接复制第二个 16×4 tile。首要路线是 banked loader FIFO、突发 writer、权重跨帧驻留和 descriptor/doorbell 控制，随后做后层片上接力；详细方案见上一条引用文档。不得把多 outstanding AXI、长 burst、片上跨层接力、50 MHz 和摄像头实时链路写成已经完成。
7. **下一步精确动作。** 先使用 `gesture_project/innovation_npu/board_7020/run_build_layer_chain_hp0_7020_from_wsl.sh` 将当前 RTL 复制到 `E:\coralnpu_vivado\projects\gestureflow_layer_chain_hp0_7020_v1\gestureflow_src`，运行 Vivado 2023.2 构建，使用 `timeout 180s` 并保存构建日志；只有确认新 `route_design`、`write_bitstream`、XSA 和资源/时序报告都完成，才能重新编译 ELF 和下板。下一版板测必须重新比较 `PROBE[5]`、所有层周期、最终 FNV 和资源，不得用旧 bit 的周期证明首层修复收益。
8. **环境与安全规则。** WSL 到 Windows 盘当前可写，但 `cmd.exe` 会显示 UNC 当前目录警告；Vivado/XSCT 必须在脚本中 `pushd E:` 后使用本地 Windows 路径。板测需要先启动 `E:\Xilinx\Vivado\2023.2\bin\hw_server.bat -s tcp::3334 -lprotocol`，连接失败只能记录为服务阻塞，不能称为模型或硬件失败。所有超过约 3 分钟的命令必须有界停止并记录日志路径。

## 69 2026-08-20 7020 新 bit 实板整网 PASS，完成第一版真实性能基线

**阅读顺序：必须先读本节；再读 第 68 号记录 了解本次 argmax 修复前的定位过程和新 bit 生成证据；再读 第 67 号记录 了解首次整网失败；随后按 第 66 号记录、第 65 号记录 至 第 63 号记录 追溯真实模型后处理与卷积主链。** 本节全部结论来自正点原子 Zynq-7020 实板输出，不得把旧失败结果继续当作当前状态。`gesture_project/innovation_npu/` 是项目自研 RTL；`/home/steveguo/coralnpu-gesture/coralnpu` 仍是 Google 上游只读参考，绝不可修改。

1. **已完成真实整网板级验收。** 2026-08-20 使用本节对应的新 bitstream 在 `XC7Z020CLG400-2` 实板运行真实模型 `gesture_project/models/static_cnn_4x4_w125_h112_nomixup_hagrid6_20260811/model_int8.tflite`，完整路径为 `RGB -> conv1_a -> conv1_b -> pool1 -> conv2_a -> conv2_b -> pool2 -> conv3_a -> conv3_b -> pool3 -> conv_head_1x1 -> GAP -> FC -> class`。板测日志是 `/tmp/gestureflow_layer_chain_hp0_7020_full_network_board_20260820.log`，第二次重复运行也在约 15 秒内完成并返回 0。最终输出为 `GESTUREFLOW_LAYER_CHAIN_HP0_FINAL_RESULT = 0x600D600D` 和 `GESTUREFLOW_LAYER_CHAIN_HP0_FULL_NETWORK_BOARD_PASS`。
2. **整网正确性证据。** `PROBE[122]=0x53C6484E`（真实 head tensor27）、`PROBE[124]=0xABBC5831`（真实 GAP tensor28）、`PROBE[125]=0xDDE32561`（真实 FC tensor29）、`PROBE[126]` 的低三位为 `0`（类别 0），`PROBE[128]=0x00000002`（顶层 done，无 fault），`PROBE[129]=0x0001F802`（GAP/FC 读取 `0x3F00=16128` bytes 完成、无 DMA fault）。本次 `POST_DEBUG_GAP_SUM0=0xFFFFB800`、`POST_DEBUG_GAP_SUM6=0xFFFFB803`、`POST_DEBUG_FC0..5=[0,0,-11,-9,-5,-7]` 与真实模型导出及有界 Verilator 回归完全一致。
3. **根因修复记录。** 上一次新 bit 的 head/GAP/FC FNV 都正确，但 `POST_CLASS=4` 导致软件返回 `0xBAD0BAD0`。已在 `gesture_project/innovation_npu/rtl/gestureflow_hp0_gap_fc.sv` 的 `argmax6` 中把每次比较显式写成 `$signed(values[i]) > best_value`，并保持严格大于以保证相同最大值时选择最低类别索引；不能通过放宽软件验收条件掩盖该问题。修复后的真实后处理回归仍输出 `cycles=2564 gap=abbc5831 fc=dde32561 class=0`，随后新 RTL 完成综合、布局、布线、bitgen 和实板 PASS。
4. **当前正式 bit/XSA 与实现资源。** 当前 bit 为 `E:\\coralnpu_vivado\\projects\\gestureflow_layer_chain_hp0_7020_v1\\axi_gpio.runs\\impl_1\\system_wrapper.bit`，2026-08-20 15:46:06 生成，SHA-256 `5ff1b01c9b5e0fa6aceb43e4088cb60855a644e60b5119808ac205122696f92a`。当前 XSA 为 `logs\\gestureflow_layer_chain_hp0_7020.xsa`，15:46:48 生成，SHA-256 `b2e73debe537bab0cf14960231a69d9236bf64a4b08f73ac994fff6678e338b1`。实现资源为 `34,054 LUT`（`33,594 Logic LUT`）、`48,236 FF`、`91 RAMB36 + 16 RAMB18`、`177 DSP`；25 MHz routed timing 为 setup `WNS=+0.140 ns`、hold `WHS=+0.011 ns`，0 failing endpoint，Vivado 报告 `All user specified timing constraints are met`。新 bit 比 第 68 号记录 多少量 LUT/FF，属于显式 argmax 逻辑的代价，仍可稳定布局布线。
5. **实际 PL 周期基线。** 从板上 `PROBE` 的各 tile cycles 汇总，25 MHz 下每周期 40 ns：`conv1_a=857,580`（34.303 ms）、`conv1_b=858,240`（34.330 ms）、`pool1=726,916`（29.077 ms）、`conv2_a=642,316`（25.693 ms）、`conv2_b=1,307,814`（52.313 ms）、`pool2=1,211,055`（48.442 ms）、`conv3_a=547,562`（21.902 ms）、`conv3_b=1,011,169`（40.447 ms）、`pool3=970,129`（38.805 ms）、`conv_head_1x1=356,441`（14.258 ms）、`GAP+FC=4,768`（0.191 ms）。所有 PL start-to-done 周期总计 `8,493,990`，约 `339.760 ms`，按纯 IP 周期上限折算约 `2.943 FPS`；这不是端到端摄像头 FPS，尚未扣除或单独测量 PS 写描述符、装权重、层间软件控制和 cache 操作时间。后续性能优化必须先保留此逐层周期表，优化后逐项比较，不能只比较最终类别。
6. **下一步固定方向。** 第一版“真实模型整网可在 7020 PL 上运行”的基线已经完成。下一步不再继续重复烧录同一版，而是基于该 bit/ELF 做 PS 控制开销与 DDR 流量测量，优先消除每个 tile 的 AXI-Lite 权重下发和层间软件等待；随后再做不改变 FNV 的 PL 数据流优化。任何 RTL 修改必须重新进行有界真实模型回归、Vivado 综合/布局/布线/bitgen 和实板整网 PASS；任何优化都必须同时记录 LUT/FF/BRAM/DSP/WNS/WHS、各层 cycles、总 cycles、最终 q29 FNV 和 class。用户要求单次长任务超过约三分钟必须报告日志位置并停止无界等待。

## 68 2026-08-20 GAP/FC 诊断版已完成新 bitstream，当前 WSL 会话受 Windows 盘只读阻塞，待一次真实下板验收

**阅读顺序：必须先读本节；再读 第 67 号记录 了解上次实板失败及诊断设计的原因；再读 第 66 号记录 理解真实 TFLite GAP/FC 的精确量化规则；最后读 第 65 号记录 至 第 63 号记录 追溯已实板通过的全部卷积和 pooling 主链。** 本节及以下 `gesture_project/innovation_npu/` 文件均为项目自研，具有 `PROJECT_LOCAL_SELF_RESEARCH_NOT_GOOGLE_OFFICIAL` 标记；`/home/steveguo/coralnpu-gesture/coralnpu` 是 Google 上游只读参考，绝不可修改、提交或称作本项目 RTL。

1. **新实现已经实际完成，不得重复综合。** Windows 本地工程 `E:\\coralnpu_vivado\\projects\\gestureflow_layer_chain_hp0_7020_v1` 的 `impl_1` 已在 2026-08-20 10:33:54 完成 `write_bitstream completed successfully`，新 bit 为 `axi_gpio.runs\\impl_1\\system_wrapper.bit`，SHA-256 为 `ddd4156a6ce74322367657803b44694576c85d0bf4982316feb7c4af58b9d959`。对应 routed XSA 于 11:22:10 导出到 `logs\\gestureflow_layer_chain_hp0_7020.xsa`，SHA-256 为 `28cc26012d8c275e719b7732e959679db952d3ec6809b81ea179bf482eaa69eb`。这版包含 `gestureflow_hp0_gap_fc.sv` 的显式 INT8 乘积扩展和 mode 4 的 GAP/FC 调试寄存器，不能再下载 2026-08-19 的旧 bit。
2. **实现资源与时序证据。** `logs\\gestureflow_layer_chain_hp0_7020_utilization_impl.rpt` 报告 routed 全系统为 `33,293 LUT`（其中 `32,833 Logic LUT`）、`48,223 FF`、`91 RAMB36 + 16 RAMB18`、`177 DSP48E1`；器件为 `XC7Z020CLG400-2`。25 MHz（40 ns）下 setup `WNS=+0.520 ns`、hold `WHS=+0.020 ns`，0 failing endpoint，约束满足。最慢路径在 postprocess GAP sum 到 FNV hash，数据路径 `38.775 ns`、71 logic levels；此余量可以上板验收，但后续性能优化必须优先拆分该路径，不能直接提高时钟。
3. **软件配套关系已逐字节核对。** Windows 工程中 `vitis\\axi_gpio\\src\\gestureflow_layer_chain_hp0_main.c` 与工作区 `gesture_project/innovation_npu/board_7020/software/gestureflow_layer_chain_hp0_main.c` 的 SHA-256 均为 `0551a913ec822f2d7ba7bd8795b48020fcfdd3ba57fe8350223466e8c59ab8e4`；`gestureflow_real_gap_fc.h` 两端 SHA-256 均为 `a6193c3e4b93c8c62c79f5ad2e1b9fc2cd66e05efdce73f063753694beaa05a7`。现有 `vitis\\axi_gpio\\Debug\\gestureflow_layer_chain_hp0.elf` 时间为 10:19:12、大小 `1,317,180` bytes、SHA-256 `5ca1521e0e12c29aaeedd9c2da2cef4c06bbee6aad740124df147d52a888982d`，故它与当前软件源配套；新增诊断只在 XSCT 脚本中读取寄存器，不要求重编译 ELF。
4. **本轮真实功能回归。** 已重新执行 `timeout 180s bash gesture_project/innovation_npu/tests/run_gestureflow_hp0_gap_fc_real.sh`，5.2 秒内通过。测试从实际模型 `gesture_project/models/static_cnn_4x4_w125_h112_nomixup_hagrid6_20260811/model_int8.tflite` 导出真实 `12x12x112` head tensor，并覆盖 HP0 loader、144 个像素的 112-channel INT32 GAP 累加、精确 TFLite fixed-point mean、`6x112` FC、requant 和 argmax；输出 `GESTUREFLOW_HP0_GAP_FC_REAL_PASS cycles=2564 gap=abbc5831 fc=dde32561 class=0`。这不是整网 RTL 仿真，也不能替代下板，但证明新乘积位宽修复不会破坏模型计算。
5. **实板诊断基准与脚本。** `gesture_project/innovation_npu/board_7020/scripts/run_gestureflow_layer_chain_hp0_xsct.tcl` 现已在单次失败时自动输出 `GESTUREFLOW_POSTPROCESS_DIAGNOSTICS_BEGIN/END`，读取 DMA、GAP、FC、class、progress、两个 GAP sum 和六个 FC q29 寄存器。真实模型期望值为：`POST_DEBUG_GAP_SUM0=0xFFFFB800 (-18432)`、`POST_DEBUG_GAP_SUM6=0xFFFFB803 (-18429)`；GAP FNV `0xABBC5831`、FC FNV `0xDDE32561`，q29 为 `[0, 0, -11, -9, -5, -7]`，class `0`。这样若失败，可直接区分 HP0 tensor 数据/loader 问题、GAP 累加问题或 FC MAC 问题，禁止仅因 class 为 0 判 PASS。
6. **当前会话的唯一外部阻塞与恢复后精确动作。** 2026-08-20 当前 WSL 会话把 `C:`、`D:`、`E:` 都挂载为只读 `9p`（`/mnt/e` 为 `ro`），`touch /mnt/e/...` 和同步脚本均报 `Read-only file system`；同时 `cmd.exe` 报 `WSL ... UtilBindVsockAnyPort:309: socket failed 1`，所以当前会话无法调用 Windows Vivado/XSCT 或下载 JTAG。不是 RTL、ELF、bit 或板卡判失败，绝不可拿旧 bit/ELF伪造板测。Windows 盘恢复可写且 `cmd.exe` 可用后，只执行一次：`timeout 180s bash gesture_project/innovation_npu/board_7020/run_board_layer_chain_hp0_7020_from_wsl.sh`。该命令会复制最新 XSCT 脚本到 `E:` 本地路径，下载上述新 bit、加载已核对 ELF，并读取 `PROBE[0..129]`；只接受 `FINAL_RESULT=0x600D600D`、`PROBE[122]=0x53C6484E`、`PROBE[124]=0xABBC5831`、`PROBE[125]=0xDDE32561`、`PROBE[126]` low 3 bits 为 `0`、无 DMA fault。超过 180 秒必须停止并保留终端日志，不能无提示等待。

## 67 2026-08-19 整网首次实板验收已定位至 PL 后处理，诊断版实现进行中，禁止下载旧 bitstream

**阅读顺序：必须先读本节；再读 第 66 号记录 了解精确 GAP/FC 的设计、量化规则和原本验收条件；随后读 第 65 号记录 至 第 63 号记录 追溯已经实板通过的卷积主链。** 所有本节文件均属于 `gesture_project/innovation_npu/` 的项目自研 RTL，并带 `PROJECT_LOCAL_SELF_RESEARCH_NOT_GOOGLE_OFFICIAL` 标识。`/home/steveguo/coralnpu-gesture/coralnpu` 仍是 Google 上游只读参考，绝不可修改、纳入项目提交，或将本节工作称为官方 CoralNPU RTL。

1. **已完成且必须如实表述的实板结果。** 2026-08-19 以 routed/bitgen 成功的时分复用 FC 版本在 正点原子 Zynq-7020 实板实际下载、运行整条静态六类模型路径。实测只用约 15 秒完成，没有超时。`RGB -> conv1_a -> conv1_b -> pool1 -> conv2_a -> conv2_b -> pool2 -> conv3_a -> conv3_b -> pool3 -> head 1x1` 的既有全 tensor 结果仍全部通过：`PROBE[100]=0x8EF3B2CB`（pool3）、`PROBE[122]=0x53C6484E`（head q27）。但新 mode 4 的 PL GAP/FC 未通过，最终为 `0xBAD0BAD0`，失败码 `PROBE[2]=0x4133`；`POST_GAP_FNV=0x55EFA285` 而非期望 `0xABBC5831`，`POST_FC_FNV=0xA701CF6F` 而非期望 `0xDDE32561`。`POST_CLASS` 低三位仍为 class `0`，但这不能替代 q28/q29 精确对齐，**当前不得称为整网实板 PASS**。完整日志：`/tmp/gestureflow_layer_chain_hp0_gapfc_board_20260819.log`。
2. **排除项。** 失败后以非破坏性 XSCT 读取 `gesture_project/innovation_npu/board_7020/scripts/read_gestureflow_post_regs_xsct.tcl`：`DMA_SOURCE=0x001E00C0`、`DMA_BYTES=0x3F00=16128`、`POST_GAP_MULT=0x453A4BCE=1161448398`、`POST_GAP_SHIFT=1`、`POST_QCFG=0x00FA8080` 均与真实模型导出器一致；`DMA_STATUS=0x0001F802` 表示完整 16128-byte HP0 read 已完成且无 AXI fault。故不是 descriptor 未写入、DMA 长度错误、AXI fault 或此前卷积输出 FNV 错误。相同脚本还从 DDR `0x001E00C0` 抽读了 head 首向量，后续排查必须区分 XSCT/CPU 地址视图与 PL HP0 消费视图，不能仅凭一次 JTAG `mrd` 认定张量已损坏。
3. **本轮已提交前的 RTL 诊断与有界回归。** `gestureflow_hp0_gap_fc.sv` 的 GAP 零点修正已改为显式 `sign_extend_int8(gap_input_zero_point) * 32'sd144`，消除 packed signed 表达式在 FPGA 综合中的歧义；mode 4 新增只读寄存器 `0x0a0=POST_DEBUG_GAP_SUM0` 与 `0x0a4=POST_DEBUG_GAP_SUM6`，分别输出本地 32-bit 累加器 channel 0/6。`read_gestureflow_post_regs_xsct.tcl` 会在下次板测读出两者。真实行为回归 `timeout 180s bash gesture_project/innovation_npu/tests/run_gestureflow_hp0_gap_fc_real.sh` 已通过，结果仍是 `head=0x53C6484E gap=0xABBC5831 fc=0xDDE32561 class=0`，并新增了首个 112-byte loader vector 对真实 `head.mem[0..111]` 的逐字节断言。该断言通过，证明仿真没有通过内部数据旁路；但这仍不能代替新 bitstream 的实板读数。
4. **实现与等待纪律。** 本轮曾先从旧 routed DCP 成功导出本地报告/XSA，旧时分复用版资源为 `32,784 Logic LUT`、`48,235 FF`、`91 RAMB36 + 16 RAMB18`、`177 DSP`，25MHz 路由 `WNS=+0.825ns`、`WHS=+0.054ns`，无 critical warning/error。路径是 `E:\coralnpu_vivado\projects\gestureflow_layer_chain_hp0_7020_v1\logs\gestureflow_layer_chain_hp0_7020_{utilization_impl,timing_impl}.rpt`。新增脚本 `board_7020/export_routed_layer_chain_hp0_7020.tcl` 能从 routed DCP 导出对应报告和 XSA，必须先复制到 Windows `E:` 本地工程执行，绝不能让 Vivado source `\\wsl.localhost\...`。为实现本节诊断 RTL 已启动新的 `system_gestureflow_0_13` rebuild；总控日志为 `/tmp/gestureflow_layer_chain_hp0_7020_gapdebug_vivado_20260819.log`，详细 IP 日志为 `E:\coralnpu_vivado\projects\gestureflow_layer_chain_hp0_7020_v1\axi_gpio.runs\system_gestureflow_0_13_synth_1\runme.log`。用户要求超过约三分钟不得无提示等待，因此本轮已停止等待；该构建脚本会 `reset_run impl_1`，旧 `impl_1/system_wrapper.bit` 已被删除。**在确认新 `route_design completed successfully`、`write_bitstream completed successfully`、新 bitstream/XSA 时间戳后，才能重新下载；不得下载旧产物或重复启动 Vivado。**
5. **固定下一步。** 先检查上述新 run 是否完成；若已完成，执行新的 routed report/XSA 导出，重新编译 ELF（`build_software_layer_chain_hp0_7020_from_wsl.sh`），再运行 `run_board_layer_chain_hp0_7020_from_wsl.sh`，读取 `PROBE[123..129]` 与 `POST_DEBUG_GAP_SUM0/6`。若 q28 仍为全 `-128`，用这两个累加器与行为参考值比较后，只在已经证实的 loader/accumulator 边界修复；不能放宽 FNV 验收、把 GAP/FC 回退到 ARM，或因 predicted class 恰好为 0 就宣称成功。最终仅接受 `FINAL_RESULT=0x600D600D`、head `0x53C6484E`、GAP `0xABBC5831`、FC `0xDDE32561`、class `0`、无 fault，以及本节精确记录的 bitstream/ELF/资源/时序证据。

## 66 2026-08-19 真实 GAP 与 FC 已接入项目 RTL，待完成最终实现和实板整网验收

**阅读顺序：必须首先阅读本节；然后读 第 65 号记录，了解已实板通过至 head 1x1 的卷积主线。** 本节所有文件均位于 `gesture_project/innovation_npu/`，均是带 `PROJECT_LOCAL_SELF_RESEARCH_NOT_GOOGLE_OFFICIAL` 标记的项目自研设计。`/home/steveguo/coralnpu-gesture/coralnpu` 是固定于 `7318dfc2a94c0ac081bbe1787414391aa3cd5052` 的 Google 上游只读参考，未修改；不得将本节模块称作官方 CoralNPU RTL。

1. **当前准确完成范围。** 在已实板通过的 `RGB -> conv1_a -> conv1_b -> pool1 -> conv2_a -> conv2_b -> pool2 -> conv3_a -> conv3_b -> pool3 -> head 1x1` 后，项目新增了 `gesture_project/innovation_npu/rtl/gestureflow_hp0_gap_fc.sv`。该模块经 HP0 从 DDR 读取真实 head tensor27（`12x12x112` INT8），在 PL 内保留 112 个 INT32 和，不写 GAP/FC 部分和到 DDR；之后使用单个四路 INT8 MAC 依次完成 6 个输出类别的 112 元点积、真实 per-channel requant、FNV 与 argmax。ARM 仅写入 FC 权重、folded bias、定点 multiplier/shift 和启动描述符，**不计算 GAP、FC 或类别**。
2. **精确量化规则已根据实际 LiteRT 源码和当前模型验证。** 新导出器 `gesture_project/innovation_npu/tools/export_real_gap_fc.py` 从 `gesture_project/models/static_cnn_4x4_w125_h112_nomixup_hagrid6_20260811/model_int8.tflite` 提取 tensor27、tensor28、tensor29、FC 参数和量化信息。GAP 严格按 LiteRT `reference_ops::QuantizedMeanOrSum`：先对原 INT8 值累加 144 次，再减 `zero_point*144`，把 `input_scale/output_scale` 的 Q31 multiplier 以整数除法吸收 `1/144`，最后 `MultiplyByQuantizedMultiplier`、加 output zero point、饱和。当前常数是 gap multiplier `1161448398`、right shift `1`，不能替换为浮点平均或简单 round；此前浮点近似在 6 个通道上最大产生 6 级误差。导出自校验通过：head `FNV=0x53C6484E`、GAP q28 `FNV=0xABBC5831`、FC q29 `FNV=0xDDE32561`、argmax class `0`。
3. **有界真实 RTL 回归已通过。** `timeout 180s bash gesture_project/innovation_npu/tests/run_gestureflow_hp0_gap_fc_real.sh` 会实时导出当前模型的 q27/FC memory，再通过 AXI burst responder 喂入项目 RTL；最新输出是 `GESTUREFLOW_HP0_GAP_FC_REAL_PASS cycles=2564 gap=abbc5831 fc=dde32561 class=0`。该结果覆盖真实 `12x12x112` DDR 字节读取、144 次全通道累加、精确 GAP 量化、全部 672 个 FC 权重、6 个 q29 输出和 argmax。另一个 `run_gestureflow_hp0_gap_fc.sh` 覆盖零值边界与 AXI backpressure，输出 `GESTUREFLOW_HP0_GAP_FC_PASS cycles=2564`。两者均有 180 秒硬超时，未运行长时间全网 RTL 仿真。
4. **硬件接口与软件更新。** `gesture_project/innovation_npu/rtl/gestureflow_layer_chain_hp0_axil.sv` 已将 layer mode 扩展为 `4`（postprocess），新增 AXI-Lite 寄存器 `0x080..0x09c`：GAP multiplier/shift、三组 zero point、GAP FNV、FC FNV、class/progress、post cycles。IP version 更新为 `0x00040004`。`gesture_project/innovation_npu/board_7020/software/gestureflow_layer_chain_hp0_main.c` 在 head `FNV=0x53C6484E` 后装载 `gestureflow_real_gap_fc.h` 的 FC descriptor，发 mode 4 并验证 `q28/q29/class`。所有地址宏均使用 `*_REG`，golden 宏使用 `*_EXPECTED_*`，已修复一次二者重名导致寄存器地址可能被 header 宏覆盖的风险。Windows 同步清单位于 `board_7020/run_build_layer_chain_hp0_7020_from_wsl.sh`，已包含新 RTL；软件脚本已显式复制新 header。任何进一步改名都必须同时检查这两个路径。
5. **资源边界和当前未完成状态，严禁夸大。** 第一版并行 6 类 FC 的 synthesis 使用 `197/220 DSP=89.55%`、`36,037 LUT as Logic=67.74%`、`99/140 BRAM tiles=70.71%`，DSP 余量不足，已拒绝进入最终 bitstream。当前 RTL 已改为 FC 类别时分复用，真实功能回归仍是完全一致的 `q28/q29/class`，cycle 从 `2419` 增至 `2564`，额外 145 cycles 在该 postprocess 尾部可接受；该版本的最终 resource、placement、route、bitgen 和实板尚**未**完成，不能写成“整网实板 PASS”。两次完整 Vivado 调用均以外层 `timeout 180s` 限制，第一次在 `synth_design completed successfully` 后停止，记录的高 DSP 数字只属于旧并行版；第二次时分版在截止前尚未写出新的 utilization report。日志分别是 `/tmp/gestureflow_layer_chain_hp0_7020_gapfc_vivado_20260819.log` 与 `/tmp/gestureflow_layer_chain_hp0_7020_gapfc_tdm_vivado_20260819.log`。当前可用的已烧录 bitstream 仍只保证至 第 65 号记录 的 head 1x1，绝不可用旧 bitstream 下载新 ELF。
6. **下一次的固定操作顺序，不得跳步。** 先确认没有遗留 Windows Vivado 子进程，再允许一次足够完成的 `bash gesture_project/innovation_npu/board_7020/run_build_layer_chain_hp0_7020_from_wsl.sh`，只接受 `Bitgen Completed Successfully`、新的 XSA 和 25MHz 实现 utilization/timing；确认 DSP 显著低于旧 `197/220` 且 WNS/WHS 都为正后，运行 `bash gesture_project/innovation_npu/board_7020/build_software_layer_chain_hp0_7020_from_wsl.sh`，Windows 启动 `E:\Xilinx\Vivado\2023.2\bin\hw_server.bat -s tcp::3334 -lprotocol`，最后执行 `timeout 180s bash gesture_project/innovation_npu/board_7020/run_board_layer_chain_hp0_7020_from_wsl.sh`。只接受 `FINAL_RESULT=0x600D600D`、`PROBE[122]=0x53C6484E`、新 probe 的 GAP `0xABBC5831`、FC `0xDDE32561`、class `0` 与无 AXI fault；随后记录全网络各层周期和总 PL time。Vivado/Vitis/XSCT 必须只在 `E:` 本地路径运行，不能让其直接打开 `\\wsl.localhost\...`；`cmd.exe` 启动时的 UNC current-directory 提示无害，脚本中的 `pushd E:\...` 不能删。

## 65 2026-08-19 7020 实板完成真实 1x1 head 卷积闭环

**阅读顺序：必须首先阅读本节；再读 第 64 号记录 的 pool3 融合，随后读 第 63 号记录 的 80-channel mode 3 设计。任何更早章节只作历史追溯，不能覆盖本节。** 当前硬件主线是项目自研 `gesture_project/innovation_npu/` 的 GestureFlow-NPU；`/home/steveguo/coralnpu-gesture/coralnpu` 是 Google 上游只读参考仓库，HEAD 固定为干净的 `7318dfc2a94c0ac081bbe1787414391aa3cd5052`，绝不可修改或把以下项目成果称为官方 CoralNPU。

1. **本轮真实范围。** 已在 正点原子 Zynq-7020（`XC7Z020CLG400-2`）实板上将同一真实量化模型 `gesture_project/models/static_cnn_4x4_w125_h112_nomixup_hagrid6_20260811/model_int8.tflite` 推进至 `RGB -> conv1_a -> conv1_b -> pool1 -> conv2_a -> conv2_b -> pool2 -> conv3_a -> conv3_b -> pool3 -> head 1x1`。head 是模型最后一个卷积：真实 `12x12x80 -> 12x12x112`、INT8、TFLite tensor27；其 input quant 为 `(0.11632942408323288, -128)`，output quant 为 `(0.24601411819458008, -128)`。此项证明的是完整真实 head output tensor，不是局部 sample、CPU 卷积或预置数据。
2. **1x1 到现有硬件的精确映射。** 先通过实际 TFLite op metadata 复核：该层权重形状为 `112x1x1x80`，而项目当前 stream 是 SAME 4x4。在当前窗口生成器的真实时序下，tap `(1,1)` 恰为 output coordinate 的输入像素。`gesture_project/innovation_npu/tools/export_real_conv4x4_full_layer.py` 已扩展为仅对真实 1x1 层生成等价硬件权重：每个原 1x1 coefficient 放入 resident 4x4 bank 的 `(1,1)`，其余 15 tap 明确写零；folded-bias、INT32 raw accumulator 和 TFLite per-channel requant 都在导出阶段对整个 tensor 再计算并逐点匹配 TFLite，错误即中止导出。该映射没有更改 MAC RTL，也没有假设卷积对齐。
3. **实际硬件执行。** 导出命令使用 `--conv-index 6 --tag head1x1`，生成 `gesture_project/innovation_npu/board_7020/software/gestureflow_real_conv4x4_head1x1_layer.h` 和 `gesture_project/innovation_npu/tests/generated_gestureflow_real_conv4x4_head1x1_layer.svh`，其全 tensor golden FNV-1a 为 `0x53C6484E`。板端 `gestureflow_layer_chain_hp0_main.c` 在启动前将融合 pool3 DDR tensor 与真实 head input 完整逐字节比较；随后通过既有 mode 3 80-channel reader、20 个 Cin group 的 local INT32 accumulator 和同一 `16 output x 4 input` DSP tile，依次运行 7 个输出 tile（OC `0..15` 至 `96..111`），以 112-byte/pixel NHWC stride 写出 `12*12*112=16,128` bytes。ARM 只在 tile 边界装入权重/bias/requant，**不做 head 卷积或 INT32 外存合并**。
4. **2026-08-19 实板验收。** 最新日志为 `/tmp/gestureflow_layer_chain_hp0_7020_head1x1_board_20260819.log`。XSCT 输出 `GESTUREFLOW_LAYER_CHAIN_HP0_FINAL_RESULT = 0x600D600D` 与 `GESTUREFLOW_LAYER_CHAIN_HP0_HEAD1X1_BOARD_PASS`。`PROBE[100]=0x8EF3B2CB` 保持真实 pool3 FNV；**`PROBE[122]=0x53C6484E`** 精确等于真实 head TFLite golden。七个 tile 的 cycles/FNV/writer status 分别为：`[101]=50919, [102]=0x02BE4FFB, [103]=0x00004802`；`[104]=50926, [105]=0x7ABC287A, [106]=0x00004802`；`[107]=50926, [108]=0x4B2335C2, [109]=0x00004802`；`[110]=50919, [111]=0x7C373887, [112]=0x00004802`；`[113]=50926, [114]=0x4AFE54A5, [115]=0x00004802`；`[116]=50921, [117]=0x84C5F725, [118]=0x00004802`；`[119]=50919, [120]=0xAA85D3D6, [121]=0x00004802`。所有 tile 都完成、无 fault、各写 `2,304` bytes；总计 `356,456` IP cycles，约 `14.2582ms @25MHz`，对应 `1,290,240` 个真实 INT8 MAC。只能将此表述为该 head 层 IP start-to-done，不能宣传为端到端 FPS。
5. **当前未完成项与固定下一步。** 至此卷积和三处 pooling 均已由 PL 完成真实模型的全 tensor 验收，剩余实际模型计算是 `12x12x112 -> 112` 的 global average pool（TFLite tensor28）以及 `112 -> 6` fully connected/class（tensor29）。当前禁止将这两个算子静默放到 ARM 并称为 FPGA 整网部署。下一步应设计并验证项目本地的 postprocess datapath：对每个 16-channel head tile 在片内或 writer 端累计 144 个 INT8 值、按 TFLite 平均/量化规则产生 GAP vector，再在同一 DSP tile 或小型 dot-product mode 中做 6x112 INT8 FC、per-channel requant 和 argmax；必须先从 TFLite 导出 q28/q29 golden，定向仿真、完整实现（若 RTL 改）、实板 full q28/q29/class 对账后才可写“整网完成”。保持 `timeout 180s` 仿真上限、Windows `E:` 本地路径、每次改动后下板、更新文档并显式 Git 提交的纪律。

## 64 2026-08-19 7020 实板完成真实 `conv3_b + pool3` 融合闭环

**阅读顺序：必须首先阅读本节；再读第 63 号记录的 80 输入 `conv3_b` 硬件扩展；再读第 62 号和第 61 号记录追溯前层。更早章节不能覆盖本节。** 当前唯一硬件主线仍是项目自研 `gesture_project/innovation_npu/` 下的 GestureFlow-NPU；`/home/steveguo/coralnpu-gesture/coralnpu` 是固定干净 HEAD `7318dfc2a94c0ac081bbe1787414391aa3cd5052` 的 Google 上游只读参考，绝不可修改或将本节成果称为 Google 官方实现。

1. **本轮真实范围。** 已在 正点原子 Zynq-7020（`XC7Z020CLG400-2`）实板上将真实 INT8 模型 `gesture_project/models/static_cnn_4x4_w125_h112_nomixup_hagrid6_20260811/model_int8.tflite` 连续部署推进到：`RGB -> conv1_a -> conv1_b -> pool1 -> conv2_a -> conv2_b -> pool2 -> conv3_a -> conv3_b -> pool3`。`pool3` 是真实模型第三个 MAX_POOL_2D，规格 `24x24x80 -> 12x12x80`、NHWC INT8，输入输出量化同为 `(scale=0.11632942408323288, zero_point=-128)`；不是 ARM 池化或预装结果。
2. **真实融合数据流。** 先以普通 writer 完整运行 `conv3_b`，严格验证 `gf_conv3b` 的 `46,080` bytes 与由真实 TFLite 导出的 `gf_pool3_input` 逐字节相等。随后为建立部署路径，ARM 重载同一五个 16-output tile 的常驻参数并重启该层；80 输入通道的 20 组 INT32 MAC 累加仍停留在单一物理 `16x4` DSP tile 内，requant/ReLU 后的 16-byte vectors 不落地为 `conv3_b` DDR tensor，而是直接由 `gestureflow_hp0_tensor_writer.sv` 从 local output bank 四读 `2x2` vector、逐 lane signed INT8 max，再经 HP0 写入 `12x12x80` pool3 tensor。因而正式融合路径避免了中间 `46,080` bytes 的写回和下一层重读；前一次普通 conv3_b 仅为本次严谨的 layer-handoff 证明，不属于部署性能口径。
3. **真实模型数据与板端软件。** 使用 `gesture_project/innovation_npu/tools/export_real_maxpool2d.py --pool-index 2 --prefix GF_POOL3 --include-input` 导出 `gesture_project/innovation_npu/board_7020/software/gestureflow_real_maxpool2d_pool3.h` 和 `gesture_project/innovation_npu/tests/generated_gestureflow_real_maxpool2d_pool3.svh`。导出器已通过量化一致性检查，真实 input FNV-1a `0xEA998550` 与 conv3_b output 完全一致，真实 pool3 output FNV-1a 是 `0x8EF3B2CB`、总长度 `11,520` bytes。`gesture_project/innovation_npu/board_7020/software/gestureflow_layer_chain_hp0_main.c` 新增 layer handoff compare、五 tile 融合运行、DDR FNV 和 probe `85..100`；没有修改 RTL，所以使用 第 63 号记录 已完成 route/bitgen 的同一 bitstream。定向 writer 行为回归 `timeout 180s bash gesture_project/innovation_npu/tests/run_gestureflow_hp0_tensor_writer_pool_strided.sh` 已通过；重新编译后的 ELF 为 `text=742,213, data=1,144, bss=693,136, total=1,436,493` bytes。
4. **2026-08-19 实板验收。** 最新日志是 `/tmp/gestureflow_layer_chain_hp0_7020_pool3_board_20260819.log`。XSCT 输出 `GESTUREFLOW_LAYER_CHAIN_HP0_FINAL_RESULT = 0x600D600D` 和 `GESTUREFLOW_LAYER_CHAIN_HP0_POOL3_BOARD_PASS`；`PROBE[84]=0xEA998550` 保持 conv3_b full-tensor golden，**`PROBE[100]=0x8EF3B2CB`** 精确匹配 pool3 full-tensor golden。五个融合 tile 的 cycles/FNV/writer status 是：`[85]=194025, [86]=0xA6508984, [87]=0x00004802`；`[88]=194025, [89]=0x18DB514D, [90]=0x00004802`；`[91]=194028, [92]=0x080B5D5B, [93]=0x00004802`；`[94]=194025, [95]=0xDE45ED93, [96]=0x00004802`；`[97]=194028, [98]=0x5FE7FA11, [99]=0x00004802`。每个 writer 均 done、无 fault、写入 `2,304` bytes，五 tile 共 `11,520` bytes。总计 `970,131` IP cycles，约 `38.8052ms @25MHz`。该时间包含重算 conv3_b 并在 PL 内融合 pool3，但只覆盖此 IP start-to-done，不能写作整网帧率。
5. **下一步与操作纪律。** 本轮代码已不含 RTL 变更，故未重复无意义的 Vivado implementation；复用了 第 63 号记录 已签核的 routed bitstream（全系统 `21,118 LUT / 36,712 FF / 91 RAMB36 + 16 RAMB18 / 152 DSP`，25MHz `WNS=+12.620ns, WHS=+0.012ns`）。下一个真实模型算子是 `12x12x80 -> 12x12x112` 的 1x1 head convolution，然后是 GAP 与 class。不得将 1x1 错当 4x4；应先解析真实 tensor、明确当前 SAME-4x4 window 的中心 tap 对齐并用定向行为验证，再考虑在同一 16x4 tile 上把 1x1 权重零扩展到 4x4 resident bank，或实现专用 1x1 直通模式。两种方案均不得复制 MAC 阵列或写回 INT32 partial sum；一旦修改 RTL，必须按“定向 `timeout 180s` 回归 -> Windows 完整 Vivado implementation/bitgen/XSA -> 实板 full FNV -> 文档及显式 Git 提交”闭环。Windows 工具必须使用 `E:` 本地路径，不能将 UNC `\\wsl.localhost\...` 交给 Vivado/Vitis/XSCT。

## 63 2026-08-19 7020 实板完成真实 `conv3_b` 80 输入、80 输出闭环

**阅读顺序：必须首先阅读本节；再读第 62 号记录理解已验证的 `conv3_a` 40 输入路径；随后读第 61 号记录的 `conv2_b+pool2` 融合路径。更早章节仅供追溯，不能覆盖本节的范围与数据。** 当前唯一硬件主线是项目自研 `gesture_project/innovation_npu/` 下的 GestureFlow-NPU。`/home/steveguo/coralnpu-gesture/coralnpu` 仍是 Google 上游只读参考仓库，固定干净 HEAD `7318dfc2a94c0ac081bbe1787414391aa3cd5052`，本节中所有 RTL、软件、约束和板测结论均为本项目自研，绝不可称为 Google 官方 CoralNPU RTL。

1. **本轮真实完成范围。** 已在已连接的 正点原子 Zynq-7020（`XC7Z020CLG400-2`）上，将真实 INT8 模型 `gesture_project/models/static_cnn_4x4_w125_h112_nomixup_hagrid6_20260811/model_int8.tflite` 的连续路径扩展为：`RGB -> conv1_a -> conv1_b -> pool1 -> conv2_a -> conv2_b -> pool2 -> conv3_a -> conv3_b`。新完成的 `conv3_b` 是模型第六个卷积算子，规格为真实 `24x24x80 -> 24x24x80`、4x4 SAME、NHWC INT8，输入量化为 `(scale=0.04254094883799553, zero_point=-128)`，输出量化为 `(scale=0.11632942408323288, zero_point=-128)`。它不是预装中间张量、CPU 计算或局部 probe，而是从 PL 经 HP0 读取真实上一层 DDR 输出、计算并将全层结果写回 DDR。
2. **不可回退的数据流设计。** 物理计算阵列仍只有一个 `16 output lanes x 4 input lanes` 的 INT8 DSP MAC tile。`conv3_b` 的 80 个输入通道被该 tile 按 `20` 个四通道组逐组执行，全部 INT32 partial sum 始终留在同一片内 accumulator，直到第 20 组后才执行真实 TFLite per-channel requant/ReLU 并写出 INT8。因此本轮没有复制第二个 MAC tile，也没有将 80 通道拆为两段并在 DDR 合并 partial sum。新增的 `mode 3` 仅是 `80-byte` 原子 NHWC reader、640-bit 三行滚动窗口和 20 组 weight-bank 索引；五个 output-channel tile 依次覆盖 OC `0..15`、`16..31`、`32..47`、`48..63`、`64..79`，以 `80-byte/pixel` stride 写入同一 `46,080-byte` 结果 tensor。
3. **实现文件、准确改动与定向验证。** `gesture_project/innovation_npu/rtl/gestureflow_hp0_tensor_loader.sv` 将明确支持上限从 64 扩至 80 channel，仍只允许 8-byte 对齐；新增 `gesture_project/innovation_npu/tests/tb_gestureflow_hp0_tensor_loader_80.sv` 与 `run_gestureflow_hp0_tensor_loader_80.sh`，在 `timeout 180s` 内已通过 `GESTUREFLOW_HP0_TENSOR_LOADER_80_PASS bytes=240 pixels=3`，证明每个 80-byte pixel 经 10 个 AXI beat 完整收齐后才交给窗口。`gesture_project/innovation_npu/rtl/gestureflow_layer_chain_hp0_axil.sv` 新增 `mode 3`、80-channel reader/mux、`MAX_INPUT_CHANNELS=80`、20-group descriptor 和从 `WCTRL[11:8]` 扩到 `WCTRL[12:8]` 的 5-bit weight group index，并将 IP version 升为 `0x00040003`。完整顶层 Verilator lint 已无告警通过；没有运行无边界全网行为仿真。
4. **真实数据、PS 软件和严格验收。** 导出命令为 `python3 gesture_project/innovation_npu/tools/export_real_conv4x4_full_layer.py --model gesture_project/models/static_cnn_4x4_w125_h112_nomixup_hagrid6_20260811/model_int8.tflite --conv-index 5 --tag conv3b --c-out gesture_project/innovation_npu/board_7020/software/gestureflow_real_conv4x4_conv3b_layer.h --svh-out gesture_project/innovation_npu/tests/generated_gestureflow_real_conv4x4_conv3b_layer.svh`。导出器的真实 output FNV-1a 为 `0xEA998550`。`gesture_project/innovation_npu/board_7020/software/gestureflow_layer_chain_hp0_main.c` 先逐字节比较 `conv3_a` DDR output 与 `gf_conv3b_layer_input`，再对每个 tile 载入 16x16x20x4 常驻权重、bias、requant 参数，最后对整个 `24*24*80=46,080` byte buffer 计算独立 FNV。PS 仍只做层边界 descriptor/参数装入、层间 byte comparison 和 FNV，不做逐窗口卷积、pooling 或 partial-sum merge。
5. **2026-08-19 实板验收。** 最新可复现板测日志为 `/tmp/gestureflow_layer_chain_hp0_7020_conv3b_board_20260819.log`。同一 bitstream/ELF 已连续实跑两次，均输出 `GESTUREFLOW_LAYER_CHAIN_HP0_FINAL_RESULT = 0x600D600D` 与 `GESTUREFLOW_LAYER_CHAIN_HP0_CONV3B_BOARD_PASS`。关键全层证据为 `PROBE[68]=0x26B89256`（上一层 conv3_a golden）以及 **`PROBE[84]=0xEA998550`**（本层完整 DDR FNV，精确等于 TFLite golden）。五个 conv3_b tile 的 cycles/FNV/writer status 分别为：`[69]=202241, [70]=0xA6508984, [71]=0x00012002`；`[72]=202232, [73]=0x18DB514D, [74]=0x00012002`；`[75]=202232, [76]=0x080B5D5B, [77]=0x00012002`；`[78]=202232, [79]=0xDE45ED93, [80]=0x00012002`；`[81]=202236, [82]=0x5FE7FA11, [83]=0x00012002`。所有 writer status 都是 done、无 fault、写入 `9,216` bytes。五 tile 合计 `1,011,173` IP cycles，即约 `40.4469ms @25MHz`，对应 `58,982,400` 个真实 INT8 MAC。这个数字仅为此层 IP start-to-done，严禁写成整网 FPS、摄像头吞吐或端到端延迟。
6. **最终实现、资源和时序。** Windows Vivado 工程为 `E:\coralnpu_vivado\projects\gestureflow_layer_chain_hp0_7020_v1`。本轮完整执行了 package IP、synthesis、placement、route、DRC、bitgen 和 XSA export；bitstream 为 `axi_gpio.runs\impl_1\system_wrapper.bit`，时间戳 `2026-08-19 20:37:01`；匹配本轮硬件的 XSA 为 `logs\gestureflow_layer_chain_hp0_7020.xsa`，时间戳 `2026-08-19 20:37:34`。最终全系统 routed 利用率是 `21,118 Total LUTs`、`20,658 Logic LUTs`、`36,712 FFs`、`91 RAMB36E1 + 16 RAMB18E1`（约 `99/140` BRAM tiles）和 `152/220 DSP48E1`。25MHz 最终签核为 `WNS=+12.620ns, TNS=0, WHS=+0.012ns, THS=0`，`125,745` 个 setup/hold endpoints 无失败，所有用户时序约束满足。WHS 只有 0.012ns，后续改动必须重新完整实现；当前禁止仅为消除 DPOP/DPIP 建议在 MAC/requant 数据流中随意插寄存器，因为那会改变 valid/last 对齐并要求完整板级回归。
7. **固定操作与下一步边界。** Windows/WSL 的 UNC 提示仍可忽略，因为所有工具脚本会 `pushd E:` 到 Windows 本地路径。软件编译入口是 `timeout 180s bash gesture_project/innovation_npu/board_7020/build_software_layer_chain_hp0_7020_from_wsl.sh`；RTL 改动必须先做定向 `timeout 180s` 回归，再运行 `bash gesture_project/innovation_npu/board_7020/run_build_layer_chain_hp0_7020_from_wsl.sh`，等待 `Bitgen Completed Successfully` 和新的 XSA；实板入口是 `timeout 180s bash gesture_project/innovation_npu/board_7020/run_board_layer_chain_hp0_7020_from_wsl.sh`。下一层是 `pool3: 24x24x80 -> 12x12x80`，最短正确路径是从当前 local output bank 融合 2x2 max-pooling，避免先写出 46,080-byte conv3_b 再读回；但在宣称融合前，必须先完整运行普通 conv3_b、逐字节证明其输出等于真实 pool3 输入，然后进行融合 path 的 full FNV 板测。不得回到旧 3x3/7010 路线，不得复制 MAC、不得把 INT32 partial sum 写回 DDR，也不得修改或暂存 `coralnpu/`。

## 62 2026-08-19 7020 实板完成真实 `conv3_a` 40 输入、80 输出闭环

**阅读顺序：必须首先读本节；再读第 61 号记录的 `conv2_b+pool2` 融合路径；再读第 60 号和第 59 号记录。** 当前唯一推进主线是项目自研 `gesture_project/innovation_npu/` 的 GestureFlow-NPU。Google 上游参考限定在 `/home/steveguo/coralnpu-gesture/coralnpu`，其 HEAD 仍为干净的 `7318dfc2a94c0ac081bbe1787414391aa3cd5052`，绝不可修改，也不得将本节自研成果误称为官方 CoralNPU RTL。

1. **本轮真实范围。** 同一连接的 正点原子 Zynq-7020（`XC7Z020CLG400-2`）、同一个已在第 61 号记录完成 routed/bitgen 的 FPGA bitstream，已将真实模型 `gesture_project/models/static_cnn_4x4_w125_h112_nomixup_hagrid6_20260811/model_int8.tflite` 推进到 `RGB -> conv1_a -> conv1_b -> pool1 -> conv2_a -> conv2_b -> pool2 -> conv3_a`。`conv3_a` 为真实 4x4 SAME INT8 卷积，输入 `24x24x40`、输出 `24x24x80`，不是软件参考或预填结果。
2. **为什么本轮无需改变 FPGA RTL。** `conv3_a` 输入仍为 40 channel，当前已经实板验证的 `mode 2` HP0 tensor reader、40-wide vector rolling window 和 `10 x 4-lane` 跨 Cin local INT32 accumulator 可以原样复用。80 输出 channel 不复制 MAC：ARM 在层边界装入当前 16 个 output lane 的常驻 weights/bias/requant，PL 依次执行 OC `0..15`、`16..31`、`32..47`、`48..63`、`64..79` 五个 tile。每 tile 的 `24x24x16=9,216` bytes 用 `80-byte/pixel` NHWC stride 写入同一 `46,080`-byte DDR 输出；没有 ARM 逐窗口计算，也没有 DDR INT32 partial sum 合并。当前 output bank 只需保存 `24x24=576` 个 16-byte vector，容量充足。
3. **真实数据与完整层间检查。** 已以 `gesture_project/innovation_npu/tools/export_real_conv4x4_full_layer.py --conv-index 4 --tag conv3a` 导出真实数据到 `gesture_project/innovation_npu/board_7020/software/gestureflow_real_conv4x4_conv3a_layer.h` 和 `gesture_project/innovation_npu/tests/generated_gestureflow_real_conv4x4_conv3a_layer.svh`。导出器确认 input quant 为 `(0.04060335457324982, -128)`、output quant 为 `(0.04254094883799553, -128)`，并在导出时证明 folded-bias INT32 和 TFLite requant 逐点一致；真实 output FNV-1a 是 `0x26B89256`。板侧 `gestureflow_layer_chain_hp0_main.c` 在启动该层前对 `pool2` DDR buffer 与 `gf_conv3a_layer_input` 做完整 byte-by-byte 比较，再运行五个 tile，最后对完整 46,080 bytes 做独立 FNV，因此不是只看局部探针。
4. **实板验收。** 最新日志是 `/tmp/gestureflow_layer_chain_hp0_7020_conv3a_board_20260819.log`。XSCT 显示 `GESTUREFLOW_LAYER_CHAIN_HP0_FINAL_RESULT = 0x600D600D` 和 `GESTUREFLOW_LAYER_CHAIN_HP0_CONV3A_BOARD_PASS`。`PROBE[52]=0x1770E9FB` 仍精确保持 pool2 golden；`PROBE[68]=0x26B89256` 精确等于 conv3_a TFLite full-tensor golden。五个 tile 的 cycles/FNV/writer status 是：`[53]=109510, [54]=0xD22D1C73, [55]=0x00012002`；`[56]=109514, [57]=0x597D2B8F, [58]=0x00012002`；`[59]=109511, [60]=0x36733693, [61]=0x00012002`；`[62]=109510, [63]=0xBCAAF9FB, [64]=0x00012002`；`[65]=109510, [66]=0x10FE27C6, [67]=0x00012002`。每项 writer status 均为 done、无 fault、9,216 bytes。总计 `547,555` PL cycles，约 `21.902ms @25MHz`，对应真实 `24*24*40*80*16=29,491,200` 个 INT8 MAC；该时间仅为该层 IP start-to-done，不得描述为网络 FPS。
5. **本轮代码和可复现操作。** 主要更新是 `gesture_project/innovation_npu/board_7020/software/gestureflow_layer_chain_hp0_main.c` 的 `load_conv3a_tile()`、五 tile descriptor 和完整 FNV 验证；构建脚本 `gesture_project/innovation_npu/board_7020/build_software_layer_chain_hp0_7020_from_wsl.sh` 会将新的 header 复制到 Windows 本地 Vitis 工程；`scripts/run_gestureflow_layer_chain_hp0_xsct.tcl` 现在读取 `PROBE[0..68]`。本轮只改变 ARM 软件和真实模型资料，未改变 RTL，因此使用第 61 号记录已验证的 bitstream，重编译 ELF 后直接下板。最新 ELF 为 `text=545557, data=1144, bss=635536, total=1182237` bytes，仍能稳定由当前 DDR 裸机工程下载运行。
6. **下一硬边界，不能偷懒。** `conv3_b` 是 `24x24x80 -> 24x24x80`。它不同于 conv3_a：输入从 40 增至 80，现有 `MAX_INPUT_CHANNELS=40`、40-channel loader 和宽行缓存不能伪装支持。正确下一步是先导出真实 conv3_b golden，再评估将 reader/vector line buffer 从 40 扩到 80 是否仍满足 7020 BRAM 和时序，或采用每像素两段 40-channel gather 且在同一 20-group INT32 accumulator 里完成累加。不得直接复制 MAC tile、扩大到 80 宽 line BRAM 后不跑完整 Vivado，也不得把 80 channel 拆为 DDR partial sum。所有自研 RTL 仍须带 `PROJECT_LOCAL_SELF_RESEARCH_NOT_GOOGLE_OFFICIAL`，并按定向 `timeout 180s` 验证、完整实现、实板 full FNV 和显式 Git 提交收口。

## 61 2026-08-19 7020 实板完成真实 `conv2_b + pool2` 40 通道融合闭环

**阅读顺序：必须先读本节；再读第 60 号记录的 `conv2_b` 40 通道 HP0 基线；随后读第 59 号记录的向量化行缓存资源优化。更早章节仅用于追溯。** 主线仍是 `gesture_project/innovation_npu/` 下项目自研 GestureFlow-NPU。`/home/steveguo/coralnpu-gesture/coralnpu` 是 Google 上游只读参考，固定为干净提交 `7318dfc2a94c0ac081bbe1787414391aa3cd5052`；不得修改或将项目本地 RTL 称为官方实现。全部自研 RTL 保留 `PROJECT_LOCAL_SELF_RESEARCH_NOT_GOOGLE_OFFICIAL` 标识。

1. **本轮完成的真实模型范围。** 已在 正点原子 Zynq-7020（`XC7Z020CLG400-2`）实板上将同一 INT8 模型 `gesture_project/models/static_cnn_4x4_w125_h112_nomixup_hagrid6_20260811/model_int8.tflite` 推进至：`RGB -> conv1_a -> conv1_b -> pool1 -> conv2_a -> conv2_b -> pool2`。`pool2` 不是 ARM 软件池化，也不是先把中间特征搬回 CPU：同一 `16-output x 4-input-lane` DSP tile 再次执行真实 `conv2_b` 后，量化输出留在 local output bank，由 PL 的 writer 四读 `2x2` 窗口、逐 INT8 lane signed max、通过 HP0 写回 `24x24x40` NHWC tensor。PS 仍只做层边界描述符和常驻参数加载。
2. **先澄清正确的数据流。** 旧 writer 的池化输入是 local output bank，不能把 DDR 上的 `conv2_b` 直接假装成该接口。此次先完整运行普通 `conv2_b` 并把 `92,160` bytes 写入 DDR，ARM 逐字节比较该 DDR 数据与新导出的 TFLite `pool2` 输入 `gf_pool2_input`；确认整个 `conv2_b` 张量一致后，重新运行同一三个 output tile 并选择 writer pool mode。实际部署可只保留第二次的融合 `conv2_b+pool2`，省去普通 `conv2_b` 中间 DDR 写回；本轮前一次普通运行仅用于建立严格的层间正确性证据，不是最终性能路径。
3. **40 通道分片池化实现。** 修改 `gesture_project/innovation_npu/rtl/gestureflow_hp0_tensor_writer.sv`，解除旧版池化“必须连续 16-byte vector”限制。池化仍从 16-byte output bank vector 做四读，但可按运行时 `destination_stride_bytes=40` 写至更宽 NHWC tensor，并允许最后 tile 仅写 8 byte，依赖已有 AXI `WSTRB` 防止非有效 lane 覆盖。新增有界 testbench `gesture_project/innovation_npu/tests/tb_gestureflow_hp0_tensor_writer_pool_strided.sv` 及脚本 `run_gestureflow_hp0_tensor_writer_pool_strided.sh` 已通过：`GESTUREFLOW_HP0_TENSOR_WRITER_POOL_STRIDED_PASS outputs=2 stride=40 tail_bytes=8`。原连续 writer 与非池化 strided tail 回归也重新通过。这里没有新增 MAC、没有复制 line buffer、没有 DDR partial-sum merge。
4. **真实 TFLite 数据与软件。** `gesture_project/innovation_npu/tools/export_real_maxpool2d.py` 已泛化为可用 `--pool-index` 选择任意 `MAX_POOL_2D`，不会再把第一层池化错误套用到后续层。实际执行命令选择第 2 个池化（索引 1），导出 `gesture_project/innovation_npu/board_7020/software/gestureflow_real_maxpool2d_pool2.h` 和 `gesture_project/innovation_npu/tests/generated_gestureflow_real_maxpool2d_pool2.svh`：真实输入 `48x48x40`、输出 `24x24x40`、均为 INT8、量化 `(scale=0.04060335457324982, zero_point=-128)`，输入 FNV `0x94C745E4`，输出 FNV `0x1770E9FB`。板侧主程序 `gesture_project/innovation_npu/board_7020/software/gestureflow_layer_chain_hp0_main.c` 新增 pool2 DDR buffer、完整 byte-by-byte layer handoff 检查、三个 tile 运行和 probe `43..52`；构建脚本会复制新增 header 到 Windows 工程。最新 ELF 大小为 `text=469729, data=1144, bss=589456, total=1060329` bytes。
5. **2026-08-19 实板验收。** 最新日志 `/tmp/gestureflow_layer_chain_hp0_7020_pool2_board_20260819.log` 显示 `GESTUREFLOW_LAYER_CHAIN_HP0_FINAL_RESULT = 0x600D600D` 和 `GESTUREFLOW_LAYER_CHAIN_HP0_POOL2_BOARD_PASS`。普通 `conv2_b` 的完整 DDR FNV 仍是 `PROBE[42]=0x94C745E4`，通过随后的完整输入 byte comparison；融合 pool2 最终 `PROBE[52]=0x1770E9FB`，精确等于真实 TFLite golden。融合路径三个 tile 分别为：`PROBE[43]=403871 cycles, [44]=0x823B5281, [45]=0x00012002 (9,216 bytes)`；`[46]=403874, [47]=0x5E5BFA08, [48]=0x00012002 (9,216 bytes)`；`[49]=403299, [50]=0xF01FEA59, [51]=0x00009002 (4,608 bytes)`。writer 状态均 done、无 fault，完整输出长度为 `23,040` bytes。三个 tile 合计 `1,211,044` cycles，即约 `48.442ms @ 25MHz`。这只是 `conv2_b+pool2` IP start-to-done，不包含 descriptor/weight 配置、摄像头、后续层或整网帧率。
6. **本轮 Vivado 实现事实。** RTL 修改后已重新运行 Windows Vivado 2023.2 完整综合、placement、route、DRC、bitgen 和 XSA 导出，日志明确为 `0 Critical Warnings / 0 Errors`，bitstream 为 `E:\\coralnpu_vivado\\projects\\gestureflow_layer_chain_hp0_7020_v1\\axi_gpio.runs\\impl_1\\system_wrapper.bit`，XSA 为同工程 `logs\\gestureflow_layer_chain_hp0_7020.xsa`。最终 routed 全系统资源为 `17,956 Total LUTs`、`17,496 Logic LUTs`、`21,432 FFs`、`76 RAMB36E1 + 19 RAMB18E1`（约 `85.5/140` BRAM tiles）和 `151/220 DSP48E1`。25 MHz 时序为 `WNS=+12.303ns, TNS=0, WHS=+0.052ns, THS=0`，所有用户时序约束满足。DPOP/DPIP 仍是已知的 DSP pipeline 建议，不能在没有 valid/last/cycle 对齐设计和完整实板回归前仅为消告警插寄存器。
7. **下一步边界与操作纪律。** 后续真实 `conv3_a` 是 `24x24x40 -> 24x24x80` 的 4x4 SAME convolution，当前 IP 的最大输入 vector 为 40，故 reader 和滚动窗口可复用；但 80 个输出通道需五次复用同一 16-output tile，`24x24x80=46,080` bytes，仍必须先导出真实 golden、确认 weight bank/index 深度与 output-bank capacity，再改软件和 RTL。不要直接把 `MAX_INPUT_CHANNELS` 提到 80，因为该层输入是 40，不需要无意义增加 3 行缓存宽度；不要复制 MAC 阵列或回退 ARM 逐窗口。每次更改保持“定向 `timeout 180s` 行为回归 -> Windows 完整实现 -> 实板完整 DDR FNV -> 交接文档与显式 Git 提交”的顺序。

## 60 2026-08-19 7020 实板完成真实 `conv2_b` 40 通道 HP0 DDR 闭环

**阅读顺序：必须先读本节；再读 第 59 号记录 理解向量化行缓存如何释放 40 通道所需 BRAM；再读 第 58 号记录 的 `conv2_a` 基线。更早章节只用于追溯，不能覆盖本节的最新范围。** 当前主线是 `gesture_project/innovation_npu/` 内项目自研的 GestureFlow-NPU。`/home/steveguo/coralnpu-gesture/coralnpu` 是 Google 上游只读参考，已复核为干净的 `7318dfc2a94c0ac081bbe1787414391aa3cd5052`，绝不修改、暂存或将项目本地实现称为 Google 官方实现。全部自研 RTL 都必须保留 `PROJECT_LOCAL_SELF_RESEARCH_NOT_GOOGLE_OFFICIAL` 标识。

1. **本轮实际完成范围。** 已在已连接的 正点原子 Zynq-7020（`XC7Z020CLG400-2`）上，以同一个项目自研 bitstream 与同一个可复用 `16-output x 4-input-lane` INT8 DSP MAC tile，完成真实量化模型 `gesture_project/models/static_cnn_4x4_w125_h112_nomixup_hagrid6_20260811/model_int8.tflite` 的连续路径：`RGB -> conv1_a -> conv1_b -> pool1 -> conv2_a -> conv2_b`。这不是 toy 数据或预置中间张量：PL 通过 HP0 AXI 从 DDR 读取前层真实输出，使用 4x4 SAME 三行向量化滚动窗口、跨输入通道的片内 INT32 累加、TFLite per-channel requant/ReLU，并通过 HP0 AXI 写回下一层真实 INT8 张量。ARM PS 只在层边界配置 descriptor、权重、bias 和 requant 参数，**不执行逐窗口卷积，也不在 DDR 合并 partial sum**。
2. **`conv2_b` 的真实规格和硬件映射。** 输入与输出均为 `48 x 48 x 40` NHWC INT8，算子为 4x4 SAME convolution；该层输入/输出 zero-point 均为 `-128`。一像素 40 byte 由 `mode 2` 的 40-channel HP0 tensor loader 完整缓冲，并分为 `ceil(40/4)=10` 个四 lane MAC group，所有 group 的 INT32 部分和均留在同一物理 tile 内，只有第 10 组完成后才量化写回。40 个输出通道分三次复用同一 16 输出 tile：OC `0..15`、`16..31`、`32..39`，尾 tile 以 `OUTPUT_LANE_MASK=0x00ff` 写 8 个有效 byte；三次均以 40-byte/pixel NHWC stride 定位，故不存在第二 MAC 阵列和 tail 覆盖相邻像素。真实 TFLite golden 全张量 FNV-1a 为 `0x94C745E4`，输出总长度为 `92,160` bytes。
3. **代码、数据与有界验证。** 核心 RTL 为 `gesture_project/innovation_npu/rtl/gestureflow_layer_chain_hp0_axil.sv`、`gestureflow_hp0_tensor_loader.sv`、`gestureflow_conv4x4_cin_same_stream.sv`、`gestureflow_body2_hp0_axil.sv`；板侧软件为 `gesture_project/innovation_npu/board_7020/software/gestureflow_layer_chain_hp0_main.c`；真实层数据为 `gesture_project/innovation_npu/board_7020/software/gestureflow_real_conv4x4_conv2b_layer.h`，对应 SV 行为数据为 `gesture_project/innovation_npu/tests/generated_gestureflow_real_conv4x4_conv2b_layer.svh`。新增的 40-channel loader 定向回归 `timeout 180s bash gesture_project/innovation_npu/tests/run_gestureflow_hp0_tensor_loader_40.sh` 已通过：`GESTUREFLOW_HP0_TENSOR_LOADER_40_PASS bytes=120 pixels=3`。扩展后的全链 Verilator 回归因嵌入多层完整 golden 数组超过 180 秒上限，已按纪律停止，**不得声称该超长仿真通过**；本轮 `conv2_b` 的最终判据是完整 Vivado 实现和真实板的全 DDR FNV。
4. **实板验收结果。** 最新板测日志是 `/tmp/gestureflow_layer_chain_hp0_7020_board_20260819.log`，XSCT 最终输出 `GESTUREFLOW_LAYER_CHAIN_HP0_FINAL_RESULT = 0x600D600D` 与 `GESTUREFLOW_LAYER_CHAIN_HP0_CONV2B_BOARD_PASS`。前层 DDR FNV 分别为 conv1_a `0xF49B1B48`、conv1_b `0x893AFA60`、pool1 `0x6518BC59`、conv2_a `0xDF95D5CF`；`PROBE[42]=0x94C745E4` 精确等于 `conv2_b` 真实 golden。三个输出 tile 的 probe 分别是：`[33]=436704 cycles, [34]=0x823B5281, [35]=0x00048002 (36,864 bytes)`；`[36]=436711, [37]=0x5E5BFA08, [38]=0x00048002 (36,864 bytes)`；`[39]=434407, [40]=0xF01FEA59, [41]=0x00024002 (18,432 bytes)`。每个 writer 都是 done、无 fault，且字节计数与 16/16/8 输出通道 tile 一致。
5. **资源、时序和性能口径。** Windows Vivado 2023.2 工程 `E:\\coralnpu_vivado\\projects\\gestureflow_layer_chain_hp0_7020_v1` 已完成综合、placement、route、DRC 与 bitgen，均为 `0 errors / 0 critical warnings`。最终 bitstream 是 `axi_gpio.runs\\impl_1\\system_wrapper.bit`，导出的 XSA 为 `logs\\gestureflow_layer_chain_hp0_7020.xsa`。routed 全系统资源为 `17,975 LUT`（其中 logic LUT `17,515`）、`21,432 FF`、`76 RAMB36E1 + 19 RAMB18E1`，即约 `85.5/140` BRAM tiles、`151/220 DSP48E1`。25 MHz 下最终时序 `WNS=+11.659ns`、`TNS=0`、`WHS=+0.063ns`、`THS=0`。三个 `conv2_b` tile 合计 `1,307,822` 个 IP cycles，即约 `52.313ms`（分别约 `17.4682ms`、`17.4684ms`、`17.3763ms`）。该数只覆盖 IP start-to-done，**不包含**权重配置、PS descriptor、摄像头采集、后续层、分类或全帧 FPS，不能夸大为整网实时性能。
6. **可复现操作和 Windows/WSL 约束。** 软件编译入口为 `bash gesture_project/innovation_npu/board_7020/build_software_layer_chain_hp0_7020_from_wsl.sh`；板测入口为 `timeout 180s bash gesture_project/innovation_npu/board_7020/run_board_layer_chain_hp0_7020_from_wsl.sh`。若 RTL 有变动，先跑相应的定向、有 `timeout 180s` 的回归，再运行 `bash gesture_project/innovation_npu/board_7020/run_build_layer_chain_hp0_7020_from_wsl.sh`，等待 Windows `impl_1/runme.log` 明确出现 `Bitgen Completed Successfully`，之后才重新下板。Vivado/Vitis/XSCT 不接受 `\\wsl.localhost\\...` 路径，脚本必须先复制 Tcl、ELF 和源码到 `E:` 本地工程。`hw_server` 应在 Windows 侧运行 `E:\\Xilinx\\Vivado\\2023.2\\bin\\hw_server.bat -s tcp::3334 -lprotocol`，Windows XSCT 连 `tcp:127.0.0.1:3334`；WSL 不能探测该端口并不表示 JTAG 不可用，须以 Windows `tasklist` 或 XSCT 连接结果判断。
7. **下一步，不能夸大当前范围。** 目前尚未完成 `pool2 -> conv3_a -> conv3_b -> pool3 -> 1x1 head -> GAP -> class`、整网分类或摄像头实时接口。下一项直接复用现有 writer 的融合 `2x2` 池化模式，从同一 TFLite 模型导出 `pool2` 的 `24x24x40` 输入/输出 golden，先逐字节确认其输入就是 `conv2_b` 输出，再实际下板对完整 pool2 DDR FNV。随后再检查 `conv3_a` 的真实通道规格；若其输入通道超过 40，必须先做资源与架构评审，不能直接盲目增大 `MAX_INPUT_CHANNELS` 或复制阵列。

## 59 2026-08-17 7020 实板完成向量化行缓存的资源优化回归

**阅读顺序：必须先读本节，再读 第 58 号记录 的真实 `conv2_a` 板测基线。** 当前主线仍是 `gesture_project/innovation_npu/` 下项目自研 GestureFlow-NPU；`/home/steveguo/coralnpu-gesture/coralnpu` 是 Google 上游只读参考，本轮未修改。该优化不是改变模型、降低精度或复制 MAC，而是对已实板通过的空间数据复用硬件进行等价资源重构。

1. **发现的真实资源瓶颈。** 旧版 `gestureflow_same4x4_cin_window.sv` 为每一个输入通道例化一个 `gestureflow_line_window`，而每个 4x4 窗口又有三条独立 8-bit line-delay BRAM。综合层次报告证明，16 通道窗口前端单独消耗 `48 RAMB18`，这使直接扩展到模型 `conv2_b` 的 40 输入通道在 7020 上不可行。这里的瓶颈是按标量通道切分的存储组织，不是 16x4 INT8 DSP MAC tile。
2. **实施的等价优化。** 新增 `gesture_project/innovation_npu/rtl/gestureflow_line_delay_vector_bank.sv` 和 `gestureflow_line_window_vector.sv`。它们保持原先的同步 BRAM 一拍读时序、frame_start、滑窗背压和 4x4 产生顺序，但把同一个 NHWC 像素的所有通道打包为一个宽字，在每一条物理行缓存中存取一次。`gestureflow_same4x4_cin_window.sv` 现在只例化一个宽向量窗口，再按 `{tap, channel}` 位置无算术拆包给既有 MAC。因而三行滚动缓存、滑窗像素复用和 MAC 本地 INT32 累加语义完全不变，同时为 40 通道的下一层预留了 BRAM 空间。
3. **先行为、后实现、再实板的闭环。** 修改后先运行 `timeout 180s bash gesture_project/innovation_npu/tests/run_gestureflow_layer_chain_hp0_axil.sh`，得到 `GESTUREFLOW_LAYER_CHAIN_HP0_CONV2A_AXIL_PASS`，`layer0_cycles=719242`、`layer1_cycles=719559`、`pool_cycles=691911`、完整 conv2a FNV `df95d5cf`。随后重新执行 Windows Vivado 综合、布局、布线与 bitgen，结果为 `0 errors / 0 critical warnings`；最后以既有真实模型 ELF JTAG 下板，输出 `GESTUREFLOW_LAYER_CHAIN_HP0_FINAL_RESULT = 0x600D600D` 和 `GESTUREFLOW_LAYER_CHAIN_HP0_CONV2A_BOARD_PASS`。关键实板 hash 再次为 conv1_a `0xF49B1B48`、conv1_b `0x893AFA60`、pool1 `0x6518BC59`、完整 conv2_a `0xDF95D5CF`。这确认资源优化没有改变真实 TFLite 的任一已核对层。
4. **实现后真实资源和时序。** 2026-08-17 16:50 的 routed report（`E:\\coralnpu_vivado\\projects\\gestureflow_layer_chain_hp0_7020_v1\\logs\\gestureflow_layer_chain_hp0_7020_utilization_impl.rpt`）为 `15,578 Logic LUT`、`12,313 FF`、`70 RAMB36 + 16 RAMB18 = 78/140 BRAM tiles (55.71%)`、`150/220 DSP48E1 (68.18%)`。相对于 第 58 号记录 的 `96/140 (68.57%)`，在 DSP 不增加、功能和模型输出不变的条件下释放了 **18 BRAM tiles（12.86 个百分点）**。25 MHz routed 时序为 `WNS=+12.260ns`、`TNS=0`、`WHS=+0.033ns`、`THS=0`，仍完整闭合。该资源空间是后续支持 40-channel feature tensor 与跨通道累加的基础，不能再回退为每通道一个 line-window。
5. **下一步操作纪律。** `conv2_b` 的真实规格是 `48x48x40 -> 48x48x40`、4x4 SAME INT8。下一实现应将当前统一引擎的输入通道描述符、HP0 tensor reader、weight-bank 深度和 MAC group loop 扩展为最大 40 通道，保留 16-output x 4-input-lane tile 与跨 `ceil(40/4)=10` group 的片内 INT32 累加。不得通过三次 ARM 控制的窗口卷积或 DDR partial-sum 回写来伪造支持。完成后必须重新导出 `conv2_b` 真实 TFLite golden，执行有界行为回归、全实现与实板 hash 验证，并记录新增层的 HP0 字节数与周期。

## 58 2026-08-17 7020 实板完成真实 `conv1_a -> conv1_b -> pool1 -> conv2_a` HP0 DDR 基线

**阅读顺序：必须先读本节，再读 第 57 号记录 了解前三级已提交基线，再按编号向后阅读。** 当前板级唯一主线仍是 `gesture_project/innovation_npu/` 的项目自研 GestureFlow-NPU。`/home/steveguo/coralnpu-gesture/coralnpu` 是 Google 上游的只读参考仓库；本轮开始和结束均已核验其 HEAD 为 `7318dfc2a94c0ac081bbe1787414391aa3cd5052` 且工作树干净。不得修改、暂存、提交或将该目录与下述项目本地 RTL 混淆。所有新增或修改的自研文件均保留 `PROJECT_LOCAL_SELF_RESEARCH_NOT_GOOGLE_OFFICIAL` 标识。

1. **本轮实际完成的模型范围。** 已在已连接的正点原子 Zynq-7020（`XC7Z020CLG400-2`）上，以一个 bitstream、一个可复用 16-output x 4-input-lane INT8 DSP MAC tile，实际运行模型 `gesture_project/models/static_cnn_4x4_w125_h112_nomixup_hagrid6_20260811/model_int8.tflite` 的连续真实路径：`PS DDR RGB -> HP0 -> conv1_a (96x96x3 到 96x96x16) -> conv1_b (96x96x16 到 96x96x16) -> 片内融合 2x2 max pool (96x96x16 到 48x48x16) -> conv2_a (48x48x16 到 48x48x40) -> HP0 DDR`。ARM 只在层边界写入描述符、权重、bias 和 per-channel requant 参数；计算期间由 PL 自主取数、行缓存、INT32 跨输入通道累加、量化和写回，不是 ARM 逐窗口执行。
2. **`conv2_a` 的资源自适应执行。** 该层共有 40 个输出通道，同一物理 16-output MAC tile 依次执行 OC `0..15`、`16..31`、`32..39` 三次，不实例化第二套卷积阵列。前两次采用 16-byte vector 写回，第三次配置 `OUTPUT_LANE_MASK=0x00FF`、`STORE_VALID_BYTES=8`，只写有效的最后 8 个通道。三次写回共享 NHWC 每像素 `40-byte` stride，目的地址分别为 `conv2a_base+0`、`+16`、`+32`，因此不会覆盖相邻像素。运行时 AXI-Lite 层描述符新增：`0x068 JOB_WIDTH`、`0x06C JOB_HEIGHT`、`0x070 OUTPUT_LANE_MASK`、`0x074 STORE_STRIDE`、`0x078 STORE_VALID_BYTES`；IP 版本从 `0x00040001` 升至 `0x00040002`。动态 writer 使用行/列递增地址状态机，不引入运行时除法器。
3. **真实数据和两级正确性闭环。** `gesture_project/innovation_npu/tools/export_real_conv4x4_full_layer.py` 用 `Interpreter(..., experimental_preserve_all_tensors=True)` 导出 `conv2_a` 的真实输入、权重、bias、量化、golden 与 FNV，防止 TFLite tensor arena 复用覆盖中间数据。`conv2_a` 输入为 pool1 的 `48x48x16`（36,864 bytes，FNV `0x6518BC59`），输出为 `48x48x40`（92,160 bytes，FNV `0xDF95D5CF`），输入量化为 `scale=0.08830816298723221, zero_point=-128`，输出量化为 `scale=0.0736822858452797, zero_point=-128`。板上先独立确认 pool1 DDR 逐字节等于 `conv2_a` 导出的真实输入；随后三 tile 写入同一 `92,160`-byte DDR 张量后，ARM 在禁 DCache 情况下对完整张量计算 FNV，得到 `PROBE[32]=0xDF95D5CF`，精确等于 TFLite golden。它不是只比较 hash 的假输入路径，也不是只测最后八个 tail channel。
4. **有界行为回归先行。** 本轮 RTL 修改完成后已运行 `timeout 180s bash gesture_project/innovation_npu/tests/run_gestureflow_layer_chain_hp0_axil.sh`，输出 `GESTUREFLOW_LAYER_CHAIN_HP0_CONV2A_AXIL_PASS`，并逐字节验证 `conv1_a -> conv1_b -> pool1 -> conv2_a` 的完整 `92,160` bytes。回归统计为 `layer0_cycles=719242`、`layer1_cycles=719559`、`pool_cycles=691911`、`conv2a=df95d5cf`。writer 的连续 16-byte 模式与 40-byte-stride/8-byte-tail 模式也分别通过 `run_gestureflow_hp0_tensor_writer.sh` 和 `run_gestureflow_hp0_tensor_writer_strided.sh`。所有 RTL 仿真均须保留 `timeout 180s`，不得重启无上限全网周期级仿真。
5. **2026-08-17 实板验收结果。** Windows Vivado 2023.2 实现成功后，重新构建 DDR 裸机 ELF、JTAG 下载 bitstream 和 ELF，再由 XSCT 读取 33 个 probe。最终状态为 `GESTUREFLOW_LAYER_CHAIN_HP0_FINAL_RESULT = 0x600D600D`。前三级保持原正确性：conv1_a FNV `0xF49B1B48`、conv1_b FNV `0x893AFA60`、pool1 DDR FNV `0x6518BC59`。`conv2_a` tile0 探针为 cycles `PROBE[23]=0x00034758=214872`、PL hash `PROBE[24]=0xDB73532C`、writer status `PROBE[25]=0x00048002`；tile1 为 `PROBE[26]=0x00034756=214870`、`PROBE[27]=0x98AD5252`、`PROBE[28]=0x00048002`；tail tile 为 `PROBE[29]=0x00033E5C=212572`、`PROBE[30]=0x4EF650A1`、`PROBE[31]=0x00024002`。三个 writer 状态均为 done、无 fault，且写入字节数依次为 36,864、36,864、18,432。完整输出的独立 DDR FNV 为 `PROBE[32]=0xDF95D5CF`。板测脚本成功行已更正为 `GESTUREFLOW_LAYER_CHAIN_HP0_CONV2A_BOARD_PASS`。
6. **最新实现后资源、时序与性能口径。** Windows 工程 `E:\\coralnpu_vivado\\projects\\gestureflow_layer_chain_hp0_7020_v1` 在 `XC7Z020CLG400-2` 上完成综合、布局、布线、DRC 与 bitgen，均为 `0 errors / 0 critical warnings`，bitstream 为 `axi_gpio.runs\\impl_1\\system_wrapper.bit`。routed report（2026-08-17 16:36）为 `15,883 Logic LUT`（总 LUT 16,343）、`12,627 FF`、`64 RAMB36 + 64 RAMB18 = 96/140 BRAM tiles (68.57%)`、`150/220 DSP48E1 (68.18%)`。25 MHz (`40ns`) 下 routed `WNS=+11.950ns`、`TNS=0`、`WHS=+0.067ns`、`THS=0`。`conv2_a` 三 tile 合计 642,314 cycles，即 `25.693ms`；该层含 `48*48*16*16*40=23,592,960` 个真实 INT8 MAC，当前端到端 IP 周期口径约为 `36.73 MAC/cycle`、`918.3 MMAC/s`。这只表示该层从 start 到 done，不含 PS descriptor/weight 写入、摄像头、未来层和最终分类，不能写成整网 FPS。
7. **精确复现操作。** 先运行 `bash gesture_project/innovation_npu/board_7020/build_software_layer_chain_hp0_7020_from_wsl.sh`，再运行 `timeout 180s bash gesture_project/innovation_npu/board_7020/run_board_layer_chain_hp0_7020_from_wsl.sh`。若 RTL 被改动，先运行 `timeout 180s bash gesture_project/innovation_npu/tests/run_gestureflow_layer_chain_hp0_axil.sh`，再调用 `bash gesture_project/innovation_npu/board_7020/run_build_layer_chain_hp0_7020_from_wsl.sh`；不要在 `impl_1/runme.log` 未出现 `Bitgen Completed Successfully` 前重启 Vivado。Windows 工具仅接受 `E:` 本地路径，脚本会复制 Tcl/ELF 到 `E:\\coralnpu_vivado...`；不可把 `\\wsl.localhost\\...` 交给 Vivado/Vitis/XSCT。硬件服务器固定为 `E:\\Xilinx\\Vivado\\2023.2\\bin\\hw_server.bat -s tcp::3334 -lprotocol`，板测连接 `tcp:127.0.0.1:3334`。
8. **下一项明确边界。** `conv2_b` 是 `48x48x40 -> 48x48x40` 的真实 4x4 卷积，不能把现有固定 `CHANNELS=16` tensor loader 伪装成已支持 40 通道。下一步必须设计并验证以 16-channel group 顺序读取 NHWC 40-channel tensor、在同一输出 accumulator 中跨三个输入 group 累加的 reader/window 数据通路，然后接真实 `conv2_b` golden。保持一份物理 MAC tile、行缓存与 HP0 通路，不允许退回 ARM 逐窗口或预置中间输出。每步都必须先有界行为回归，再重新实现、烧板，并记录完整 DDR hash、cycle、读写字节、资源和时序。当前真实实板最高范围到 `conv2_a`，**尚未完成** `conv2_b`、pool2、conv3、head、GAP、FC/class、整网分类或摄像头实时接口。

## 57 2026-08-17 7020 实板完成真实 `conv1_a -> conv1_b -> pool1` HP0 DDR 基线

**阅读顺序：必须先读本节，再读 第 56 号记录 的两层卷积 DDR handoff 基线。** 当前唯一硬件主线是 `gesture_project/innovation_npu/` 中的项目自研 GestureFlow-NPU。`/home/steveguo/coralnpu-gesture/coralnpu` 仅为 Google 上游只读参考；本次再次核验其 HEAD 为 `7318dfc2a94c0ac081bbe1787414391aa3cd5052` 且工作树干净。不得修改、暂存、提交或将其与本项目 RTL 混淆。所有下述文件均为项目本地工作，带有 `PROJECT_LOCAL_SELF_RESEARCH_NOT_GOOGLE_OFFICIAL` 标识。

1. **本次实板闭环范围。** 已在连接的正点原子 Zynq-7020（`XC7Z020CLG400-2`）上，使用一个 bitstream、一个可复用 16-output x 4-input-lane INT8 MAC 核，实际运行模型 `gesture_project/models/static_cnn_4x4_w125_h112_nomixup_hagrid6_20260811/model_int8.tflite` 的连续真实路径：`PS DDR RGB -> HP0 read -> conv1_a (96x96x3 到 96x96x16) -> INT32 片内跨 Cin 累加 -> TFLite per-channel requant/ReLU -> output bank -> HP0 write activation_1 -> HP0 read activation_1 -> conv1_b (96x96x16 到 96x96x16) -> output bank -> HP0 write activation_2 -> writer 内融合的 2x2 stride-2 signed-INT8 max pool -> HP0 write pool1`。ARM 只在层边界配置描述符和常驻权重/量化参数；没有逐窗口控制、没有复制中间激活、没有并列复制第二个 MAC 核。
2. **真实池化正确性依据。** `gesture_project/innovation_npu/tools/export_real_maxpool2d.py` 使用 `experimental_preserve_all_tensors=True` 导出真实 TFLite 张量，已逐元素验证：输入为 `96x96x16`、`147456` bytes、FNV-1a `0x893AFA60`，输出为 `48x48x16`、`36864` bytes、FNV-1a `0x6518BC59`。输入输出量化均为 `(scale=0.08830816298723221, zero_point=-128)`，因此池化只可执行每个 INT8 lane 的 signed max，不能额外 requant。RTL 位于 `gesture_project/innovation_npu/rtl/gestureflow_hp0_tensor_writer.sv`：`STORE_CONTROL.bit0=store_enable`，`bit1=pool_2x2`；pool 模式针对每个输出 vector 读取 `(2r,2c)`、`(2r,2c+1)`、`(2r+1,2c)`、`(2r+1,2c+1)` 的四个片上 bank vector，逐 lane 求最大值后使用既有 AXI4 writer 写回。`gestureflow_layer_chain_hp0_axil.sv` 和 `gestureflow_full_layer_hp0_axil.sv` 将版本升级为 `0x00040001`。
3. **先仿真、后实板的有界验证。** 运行 `bash gesture_project/innovation_npu/tests/run_gestureflow_layer_chain_hp0_axil.sh` 已重新通过，输出 `GESTUREFLOW_LAYER_CHAIN_HP0_POOL_AXIL_PASS`，`layer0_cycles=719242`、`layer1_cycles=719559`、`pool_cycles=691911`、`hash0=f49b1b48`、`hash1=893afa60`、`pool=6518bc59`。该 Verilator 回归使用真实导出的权重、量化和 TFLite golden，脚本必须保留 `timeout 180s` 上限；不得以无上限全网 RTL 仿真替代它。
4. **2026-08-17 实板结果。** 重新编译 `gestureflow_layer_chain_hp0.elf`、JTAG 下载当前实现 bitstream 并通过 XSCT 实跑，得到 `GESTUREFLOW_LAYER_CHAIN_HP0_FINAL_RESULT = 0x600D600D` 和 `GESTUREFLOW_LAYER_CHAIN_HP0_POOL_BOARD_PASS`。关键探针：`[04]=0x00000002`、`[05]=0x000D15DB=857563`、`[08]=[11]=0xF49B1B48`，首层 HP0 读 `[09]=0x00036002`（27648 bytes）/写 `[10]=0x00120002`（147456 bytes）；第二层为 `[12]=0x000D1876=858230`、`[13]=[16]=0x893AFA60`、读 `[14]=0x00120002`、写 `[15]=0x00120002`；pool 为 `[19]=0x000B1779=726905`、输入 hash `[20]=0x893AFA60`、writer 状态 `[21]=0x00048002`（36864 bytes、done、无 fault）、ARM 对 pool1 DDR 的独立 FNV `[22]=0x6518BC59`。这证明实际 DDR byte layout 等于 TFLite pool1 golden，不是仅比较局部结果。
5. **本次真实故障与修复，必须记住。** 第一轮 pool 烧板时 `STORE_STATUS=0x4`，是 writer 的参数检查主动 fault，并非 RTL 算法或 AXI 故障。根因是 `gestureflow_layer_chain_hp0_main.c` 的 `run_layer()` 把同一个 `bytes` 同时写给 `GF_DMA_BYTES` 和 `GF_STORE_BYTES`；pool 读取 `147456` bytes 但应只写 `36864` bytes，导致非法配置。现已将接口改为独立 `bytes` 与 `store_bytes`，pool 调用明确为 `run_layer(1, activation_1, 147456, pool_1, 36864, 3)`。后续任何融合/缩放算子必须分别核对 DMA 输入字节数与 writer 输出字节数，不能复用单一参数。
6. **当前已实装资源和时序，不得沿用旧报告。** Windows Vivado 2023.2 工程 `E:\\coralnpu_vivado\\projects\\gestureflow_layer_chain_hp0_7020_v1` 的最新 placed/routed 报告为 `15670 LUT as Logic (29.45%)`、`12402 FF (11.66%)`、`64 RAMB36 + 64 RAMB18 = 96/140 BRAM tiles (68.57%)`、`151/220 DSP48E1 (68.64%)`。25MHz (`40ns`) 约束下，routed `WNS=+12.510ns`、`TNS=0`、`WHS=+0.036ns`、`THS=0`，所有用户约束满足。pool control 增加了 2 个 DSP 映射后的逻辑，但仍保有明确正时序裕量；当前硬边界仍优先是 BRAM 和 DSP，不能直接复制第二个完整核。
7. **当前性能口径。** 在 25MHz，实板 IP 内层周期为 conv1_a `34.303ms`、conv1_b `34.329ms`、pool1 writer `29.076ms`，合计 `2,442,698` cycles、约 `97.708ms`。前两层包含 `44,826,624` 个真实 INT8 MAC，但这个数值**不含**层配置、权重装载、未来后续层、摄像头采集及最终类别输出；pool1 周期也主要反映当前每 16-byte vector 的保守四读两拍写回实现。因此不得宣称它是完整网络 FPS、摄像头帧率、阵列峰值或最终性能。当前可用作后续 RTL 重构前后的真实、可复现 baseline。
8. **固定复现命令与 Windows/WSL 操作规则。** 软件构建：`bash gesture_project/innovation_npu/board_7020/build_software_layer_chain_hp0_7020_from_wsl.sh`；板测：`timeout 180s bash gesture_project/innovation_npu/board_7020/run_board_layer_chain_hp0_7020_from_wsl.sh`。如 XSCT 报 `connect` 失败，先在 Windows 本地启动 `E:\\Xilinx\\Vivado\\2023.2\\bin\\hw_server.bat -s tcp::3334 -lprotocol` 并确认 `netstat` 显示端口 `3334` listening，再运行板测。Vivado/Vitis/XSCT 不能执行 `\\wsl.localhost\\...` 路径，所有 Tcl/ELF 必须先复制到 `E:`；从 WSL 启动出现一次 UNC current-directory 警告是无害的。Tcl `format` 中带 `[]` 的文本必须使用花括号，例如 `{PROBE[%02d] = 0x%08X}`。
9. **下一项严格范围。** 已通过 `conv1_a -> conv1_b -> pool1`，尚未通过 `conv2_a (48x48x16 到 48x48x40)`、`conv2_b`、后续池化、head、GAP、class、整网分类或摄像头。下一步应保持现有两层加 pool hash 回归，在同一物理核上将 tensor loader、line-window、weight/parameter bank 从固定 `96x96/16-output` 改为 descriptor 驱动：支持 `48x48x16` 输入和 `40` 输出通道分 tile。必须先导出该真实层的权重、bias、per-channel requant 与 golden，再做有界行为回归、完整 Vivado 实现、实际烧板和 hash/字节数核验；不得回退为 ARM 逐窗口或把预制 activation 当成“整层已运行”。

## 56 2026-08-17 7020 实板完成单 bitstream 的真实两层 HP0 DDR 接续基线

**阅读顺序：必须先读本节；再读 第 55 号记录 了解首层单层写回基线，再读 第 54 号记录 了解第二层单层基线。更早的 7Z010、旧 3x3、RVV 和单窗口记录均不能指导当前实现。** 当前唯一板级主线是 `gesture_project/innovation_npu/` 内的项目自研 GestureFlow-NPU。`/home/steveguo/coralnpu-gesture/coralnpu` 是 Google 上游只读参考仓库，本次核验仍为提交 `7318dfc2a94c0ac081bbe1787414391aa3cd5052`、工作树干净；不得修改、暂存或提交该目录。下文所有新 RTL、软件、脚本均有 `PROJECT_LOCAL_SELF_RESEARCH_NOT_GOOGLE_OFFICIAL` 标识，不能表述为 Google 官方 RTL 或 Google 官方 FPGA 部署。

1. **本次完成的范围：同一个 bitstream、同一个物理 MAC 核完成两个真实 TFLite 卷积层的 PL-PL 接续。** 模型为 `gesture_project/models/static_cnn_4x4_w125_h112_nomixup_hagrid6_20260811/model_int8.tflite`。设备端一次运行的数据路径是 `PS DDR RGB -> HP0 AXI4 read -> layer-0 96x96x3 到 96x96x16 的真实 INT8 4x4 卷积 -> TFLite requant/ReLU -> PL writer 写入 activation_1 DDR -> 同一 IP 的 HP0 tensor loader 读取 activation_1 -> layer-1 96x96x16 到 96x96x16 的真实 INT8 4x4 卷积 -> TFLite requant/ReLU -> PL writer 写入 activation_2 DDR`。ARM 仅在两个层之间更换 layer descriptor、常驻权重、bias 与量化参数，**没有复制中间 activation**。这是 7020 上已完成的真实模型层间硬件 handoff，不是 toy MAC、不是 ARM 逐窗口外设控制、也不是并列复制两个完整加速器。
2. **统一可复用核心的实现。** `gesture_project/innovation_npu/rtl/gestureflow_layer_chain_hp0_axil.sv` 是新的项目本地 AXI-Lite/AXI4 顶层，寄存器 `0x064 LAYER_MODE` 选择输入路径：`0` 为 RGB 首层，启用 `input_lane_enable=4'b0111`；`1` 为 16-channel signed INT8 tensor 层，启用 `input_lane_enable=4'hf`。`gestureflow_conv4x4_cin_same_stream.sv` 因此新增输入 lane mask，保持一个 16-output x 4-input-lane DSP MAC tile，跨输入通道组的 INT32 partial sum 始终片内累加。首层输出 bank 写入 147456-byte DDR buffer 后即成为第二层的 source buffer，不实例化第二套 MAC、行缓存或输出 bank。`DMA_STATUS` 已固定为 `[31:3]=29-bit bytes_read, bit2=fault, bit1=done, bit0=busy`；最初的低 16-bit 截断已通过本次重新烧板修正。
3. **行为仿真先通过，且有界。** 运行 `bash gesture_project/innovation_npu/tests/run_gestureflow_layer_chain_hp0_axil.sh` 得到 `GESTUREFLOW_LAYER_CHAIN_HP0_AXIL_PASS`、`layer0_cycles=719242`、`layer1_cycles=719559`、`hash0=f49b1b48`、`hash1=893afa60`。该回归使用真实导出的首层和第二层权重/量化张量，逐字节确认 layer-0 writer 写入 `activation_1` DDR 的 147456 bytes 等于第二层 golden input，并限制为 `timeout 180s`；不得替换成无上限整网 RTL 仿真。
4. **2026-08-17 实板验收结果。** 更新了 `DMA_STATUS` 后，重新完成 Windows Vivado implementation、重新生成 bitstream、重新编译 ELF、JTAG 下载并实际运行。XSCT 输出 `GESTUREFLOW_LAYER_CHAIN_HP0_FINAL_RESULT = 0x600D600D` 和 `GESTUREFLOW_LAYER_CHAIN_HP0_BOARD_PASS`。关键 probes 为：`[04]=0x00000002`（layer-0 done/no-fault）、`[05]=0x000D15DC=857564` cycles、`[08]=0xF49B1B48`（layer-0 全量输出 hash）、`[09]=0x00036002`（layer-0 HP0 read 27648 bytes, done/no-fault）、`[10]=0x00120002`（layer-0 HP0 write 147456 bytes, done/no-fault）、`[11]=0xF49B1B48`（ARM 从 activation_1 DDR 独立计算的 hash）；`[12]=0x000D1879=858233` cycles、`[13]=0x893AFA60`（layer-1 输出 hash）、`[14]=0x00120002`（layer-1 HP0 read 147456 bytes）、`[15]=0x00120002`（layer-1 HP0 write 147456 bytes）、`[16]=0x893AFA60`（ARM 从 activation_2 DDR 独立 hash）。四个 DMA/write 状态均为 done、无 fault，两个 PL hash 与两个独立 DDR hash 均分别等于 TFLite golden。
5. **可报告的当前性能口径与限制。** 实板时钟为 25MHz；layer-0 的 `7,077,888` 个真实 INT8 MAC 用时 `857564/25MHz=34.303ms`，即 `8.254 MAC/cycle`、`206.34 MMAC/s`；layer-1 的 `37,748,736` 个真实 INT8 MAC 用时 `858233/25MHz=34.329ms`，即 `43.984 MAC/cycle`、`1.100 GMAC/s`。两层总计 `44,826,624` MAC、`1,715,797` PL cycles、`68.632ms`，为 `26.126 MAC/cycle`、`653.15 MMAC/s` 和约 `14.57` 组两层序列每秒。此数字仅计 IP 从 start 到 done，**不含** ARM 写权重/描述符、未来摄像头采集、后续 pooling/head/class 层；不得误写成完整分类网络 FPS、摄像头实时 FPS 或峰值阵列吞吐。
6. **本轮实现资源和时序。** Windows Vivado 2023.2 工程 `E:\\coralnpu_vivado\\projects\\gestureflow_layer_chain_hp0_7020_v1` 在 `XC7Z020CLG400-2` 完成综合、布局、布线、DRC 与 bitgen，均为 `0 errors / 0 critical warnings`。routed hierarchical report 为 `15478 LUT / 11916 FF / 64 RAMB36 + 64 RAMB18 / 149 DSP48E1`，折算 `96/140=68.57%` BRAM tiles、`149/220=67.73%` DSP、约 `29.09%` LUT、约 `11.20%` FF。25MHz routed timing 是 `WNS=+12.586ns`、`TNS=0`、`WHS=+0.021ns`、`THS=0`，所有用户时序约束满足。BRAM 与 DSP 已是进一步扩大单核并行度前的硬约束，后续性能优化应优先减少 output-bank 容量和提升输入/写回 burst 连续性，而不是复制第二个完整核。
7. **可复现文件和固定操作。** RTL 顶层为 `gesture_project/innovation_npu/rtl/gestureflow_layer_chain_hp0_axil.sv`；完整 ARM 程序为 `gesture_project/innovation_npu/board_7020/software/gestureflow_layer_chain_hp0_main.c`，第二层数据被刻意放在单独的 `gestureflow_chain_body_data.c/.h`，避免两层生成头文件的同名符号冲突。Windows 工程构建入口为 `bash gesture_project/innovation_npu/board_7020/run_build_layer_chain_hp0_7020_from_wsl.sh`，软件构建入口为 `bash gesture_project/innovation_npu/board_7020/build_software_layer_chain_hp0_7020_from_wsl.sh`，板测入口为 `bash gesture_project/innovation_npu/board_7020/run_board_layer_chain_hp0_7020_from_wsl.sh`。bitstream 位于 `E:\\coralnpu_vivado\\projects\\gestureflow_layer_chain_hp0_7020_v1\\axi_gpio.runs\\impl_1\\system_wrapper.bit`，XSA 位于 `...\\logs\\gestureflow_layer_chain_hp0_7020.xsa`，routed reports 位于 `...\\logs\\gestureflow_layer_chain_hp0_7020_{utilization,timing}_impl.rpt`。
8. **Windows/WSL 操作纪律。** Vivado、Vitis 和 XSCT 只能从 Windows 本地 `E:` 路径运行；不可向它们传入 `\\wsl.localhost\\Ubuntu-22.04\\...`。从 WSL 调用时脚本会先复制到 `E:`，再使用 `pushd E:\\coralnpu_vivado\\projects\\gestureflow_layer_chain_hp0_7020_v1\\project_local_gestureflow`，启动初期的一次 UNC current-directory 警告是无害的，不能把它当成构建失败。硬件服务器固定为 `E:\\Xilinx\\Vivado\\2023.2\\bin\\hw_server.bat -s tcp::3334 -lprotocol`，板测 XSCT 连接 `tcp:127.0.0.1:3334`。Tcl `format` 文本带方括号必须使用花括号，例如 `{PROBE[%02d] = 0x%08X}`，否则 `[` 会被解释为 Tcl 命令。Vivado 的外层 shell 可能早于 implementation 子进程返回；只能查看 `E:\\coralnpu_vivado\\projects\\gestureflow_layer_chain_hp0_7020_v1\\axi_gpio.runs\\impl_1\\runme.log` 或等待 `GESTUREFLOW_LAYER_CHAIN_HP0_7020_BITSTREAM_PASS`，不能重复启动 Vivado。
9. **下一步，严格限定。** 当前只完成完整网络前两层的真实 DDR handoff，并未完成 pooling、`conv_head_1x1`、GAP、class、摄像头接口或整网分类。下一项应在**不破坏本节两层 hash 回归和同核复用约束**的前提下，接入紧随 tensor 19 的真实模型算子；若为 pooling，应优先融合在 output-bank/write path 以避免完整 tensor 19 的额外 DDR 往返。每次 RTL 改动必须先跑第 3 条的有界回归，再重新生成 `E:` bitstream、重新烧板，并记录状态、周期、DMA 字节数、PL hash 与 DDR hash；禁止把实板通过的两层链退回为 ARM 准备中间张量的单层测试。
10. **2026-08-17 已确认下一算子的真实 golden，尚未接入 RTL。** 该模型的 `conv1_b` 后继是 TFLite `MAX_POOL_2D`，精确形状为 `96x96x16 -> 48x48x16`、kernel `2x2`、stride `2`。项目本地导出器 `gesture_project/innovation_npu/tools/export_real_maxpool2d.py` 使用 `experimental_preserve_all_tensors=True`，避免解释器 arena 覆盖中间 conv tensor；它已逐元素验证软件 `2x2` signed INT8 max 等于 TFLite tensor。运行 `python3 gesture_project/innovation_npu/tools/export_real_maxpool2d.py --model gesture_project/models/static_cnn_4x4_w125_h112_nomixup_hagrid6_20260811/model_int8.tflite --c-out gesture_project/innovation_npu/board_7020/software/gestureflow_real_maxpool2d.h --svh-out gesture_project/innovation_npu/tests/generated_gestureflow_real_maxpool2d.svh` 输出：输入 FNV-1a `0x893AFA60`（与本节第二层实板输出一致）、池化输出 `36864` bytes、FNV-1a `0x6518BC59`。输入与输出 quantization 均为 `(scale=0.08830816298723221, zero_point=-128)`，所以硬件池化仅执行每 lane max，不得额外 requant。后续 pool writer 必须输出上述 exact byte layout/hash，再接 `48x48x16 -> 48x48x40` 的真实第三卷积；不得仅凭局部 probe 宣称通过。

## 55 2026-08-16 7020 实板完成首层真实 INT8 激活 HP0 DDR 写回和独立回读核验

**阅读顺序：必须先读本节，再读 第 54 号记录 的第二层独立 HP0 基线与 第 53 号记录 的首层只读 HP0 基线。** 当前硬件主线均为 `gesture_project/innovation_npu/` 的项目自研 GestureFlow-NPU；`/home/steveguo/coralnpu-gesture/coralnpu` 仍固定为 Google 上游只读参考仓库（`7318dfc2a94c0ac081bbe1787414391aa3cd5052`），本轮未修改。以下新增逻辑带 `PROJECT_LOCAL_SELF_RESEARCH_NOT_GOOGLE_OFFICIAL` 标识，绝不能称作 Google 官方 RTL 或官方部署。

1. **首层已在真实 7020 实板完成“DDR 读取、真实卷积、DDR 写回、独立回读”闭环。** 首层仍是模型 `gesture_project/models/static_cnn_4x4_w125_h112_nomixup_hagrid6_20260811/model_int8.tflite` 的 `96x96x3 -> 96x96x16` INT8 `4x4` 卷积，共 `7,077,888` 个真实 MAC。新数据路径为 `PS DDR RGB -> HP0 AXI4 read -> 4x4 stream / 16-lane MAC / INT32 local accumulation / TFLite requant-ReLU -> on-chip output bank -> HP0 AXI4 write -> PS DDR activation buffer`。它不是逐窗口 ARM 外设控制；权重、bias 与量化参数仅在启动前配置，计算期间由 PL 自主执行。
2. **本次实板结果和两个相互独立的正确性证据。** XSCT 最终输出 `GESTUREFLOW_FULL_LAYER_HP0_BOARD_PASS`，`PROBE[00]=0x600D600D`、`PROBE[04]=0x00000002`（done、无 fault）、`PROBE[05]=0x000655DC=415196` PL cycles、`PROBE[06]=PROBE[07]=9216`、`PROBE[08]=0xF49B1B48`（PL 对全部 147456 个 TFLite INT8 输出的 FNV-1a）。更关键的是 `PROBE[15]=0x00120002`，即 AXI write done、无 fault、精确写出 `147456` bytes；`PROBE[16]=0x001100C0` 是 16-byte 对齐的 activation DDR buffer；ARM 在禁用 DCache 的条件下逐字节重新读回该 buffer 并计算独立 FNV-1a，`PROBE[17]=0xF49B1B48`。因此不仅卷积输出正确，也已证明真正写入 DDR 的 byte layout 与 TFLite `tensor 18` 完全一致。
3. **性能口径和范围。** 25MHz 下这次读、算、全量写回为 `415196/25MHz=16.608ms`，约 `60.21` 个“首层含写回”操作每秒、`17.05` 有效 MAC/cycle、`426.2 MMAC/s`。ARM global timer 为 `0x005AA0EE-0x0006268D=5,536,353` ticks；以 CPU/2 约 `333.333MHz` 换算约 `16.609ms`，与 PL 计数一致。相比只读版本 `221657` cycles，增加的是刻意的 `output_bank` 回读和 9216 次双拍 AXI write transaction；这不是阵列退化，也不能作为最终高性能写回实现。后续需把逐 16-byte burst 合并为多向量 burst/FIFO 流式写回，但必须保持这次 hash 判据。
4. **实装资源边界已经清楚，后续不得错误地并列复制核心。** Vivado 2023.2、`XC7Z020CLG400-2` 的 fully placed report 为 `13877 Slice LUT (26.08%) / 6662 FF / 64 RAMB36 + 25 RAMB18`（`76.5/140` BRAM tiles，`54.64%`）/ `149 DSP48E1 (67.73%)`。Routed timing summary 为 25MHz `WNS=+11.414ns`、`TNS=0`、`WHS=+0.012ns`、`THS=0`，全部用户约束满足；bitgen `0 errors / 0 critical warnings`。输出 bank 现在因真实被 writer 回读而推断为 BRAM，不能再沿用只读首层报告中的低 BRAM 数字。由于第二层独立核也需要约 `148 DSP / 64 RAMB18`，7020 **不能**把当前首层和第二层完整 IP 并列实例化；正确路线是一个可复用 MAC/BRAM 核按 layer descriptor 顺序执行，而不是两个硬件副本。
5. **源代码和可复现操作。** 新写回器是 `gesture_project/innovation_npu/rtl/gestureflow_hp0_tensor_writer.sv`，每个 `16-byte` NHWC feature vector 发一笔 2x64-bit AXI4 INCR burst，检查 `AW/W/WLAST/BID/BRESP`，错误或尺寸不符会 fault。它由 `rtl/gestureflow_full_layer_hp0_axil.sv` 的可选 `STORE_DESTINATION(0x054)`、`STORE_BYTES(0x058)`、`STORE_CONTROL(0x05c)` 控制，`STORE_STATUS(0x060)` 的 bit `[31:3]` 是写入字节数、bit2 fault、bit1 done、bit0 busy。未开启 store 时保留原有首层 HP0 行为和周期基线。真实 ARM 入口是 `board_7020/software/gestureflow_full_layer_hp0_main.c`；构建/下载入口仍为 `board_7020/build_software_full_layer_hp0_7020_from_wsl.sh` 与 `run_board_full_layer_hp0_7020_from_wsl.sh`。
6. **回归要求。** `bash gesture_project/innovation_npu/tests/run_gestureflow_hp0_tensor_writer.sh` 输出 `GESTUREFLOW_HP0_TENSOR_WRITER_PASS vectors=5 bytes=80`；`bash gesture_project/innovation_npu/tests/run_gestureflow_full_layer_hp0_axil.sh` 必须连续输出 `(a) GESTUREFLOW_FULL_LAYER_HP0_AXIL_PASS cycles=221576 hash=f49b1b48 bytes=27648` 和 `(b) GESTUREFLOW_FULL_LAYER_HP0_STORE_AXIL_PASS cycles=276874 hash=f49b1b48 bytes=147456`。第二项通过真实首层模型行为仿真，把 DDR 写回后的全部 byte 再计算 FNV，验证它与 TFLite 首层输出完全一致。脚本均有 `timeout 180s`；禁止换成无上限整网 RTL 仿真。
7. **Windows 构建/板级操作的最新状态。** `E:\coralnpu_vivado\projects\gestureflow_full_layer_hp0_7020_v1\axi_gpio.runs\impl_1\system_wrapper.bit` 已是带 read/write HP0 的实板通过 bitstream。自动构建外层命令曾在三分钟限制到达时中止，但 Vivado 已启动的 implementation 子进程继续完成，故其后处理没有自动覆盖 `logs\gestureflow_full_hp0_7020.xsa`；本次 XSCT 使用的旧 XSA 是安全的，因为 PS7 配置、AXI-Lite base `0x43C00000` 与地址映射未变，ARM 直接寄存器访问也不依赖新 driver。需要重新做完全可复现构建时，待已有 Vivado process 退出后再次运行 build script，使其完成 report/XSA 导出；不得误把旧 XSA 当作新版本资源报告。真正的 routed reports 此次位于 `axi_gpio.runs\impl_1\system_wrapper_{utilization_placed,timing_summary_routed}.rpt`。Windows Vivado/Vitis/XSCT 只允许运行 `E:` 本地文件；脚本内部已改用 `pushd E:\...`，但 `cmd.exe` 从 WSL 启动时仍会打印一次无害 UNC 当前目录警告，不能把它误判成编译或板测失败。
8. **下一步固定。** 现在已完成从首层产生的真实 `tensor 18` 写入 DDR，但尚未在**同一个可配置 IP/同一次设备运行**中由第二层读取，因为当前首层与 body-2 是两套单独 bitstream，不能同时放入 7020。下一实现要将现有首层 RGB ingress、`gestureflow_hp0_tensor_loader`、通用 `Cin` stream 和 writer 收敛为单一 descriptor-driven reusable core：layer-0 选择 RGB reader 和 `Cin=3`，写 activation buffer；layer-1 选择 signed tensor reader 和 `Cin=16`，从同一 buffer 读取，复用同一 MAC/weight bank，再写下一 buffer。先通过两个已固化的首层/第二层 hash，再增加 ARM 只发 layer descriptor 的顺序调度；不要先并列加 IP、增 PE、做摄像头或宣称整网。

## 54 2026-08-16 7020 实板完成真实 TFLite 第二卷积层 HP0 DDR 全图闭环

**阅读顺序：必须先读本节，再读 第 53 号记录 的已提交首层 HP0 基线，最后才按需追溯更早历史。** 当前唯一板级主线是 `gesture_project/innovation_npu/` 下的项目自研 GestureFlow-NPU。`/home/steveguo/coralnpu-gesture/coralnpu` 固定为 Google 上游只读参考仓库（提交 `7318dfc2a94c0ac081bbe1787414391aa3cd5052`），本轮未修改。下述 RTL、软件和脚本都含 `PROJECT_LOCAL_SELF_RESEARCH_NOT_GOOGLE_OFFICIAL` 标识，不能称作 Google 官方实现或官方部署。

1. **第二个真实模型层已完成综合、布局布线和实板验证。** 模型为 `gesture_project/models/static_cnn_4x4_w125_h112_nomixup_hagrid6_20260811/model_int8.tflite` 的第二个卷积层（TFLite `tensor 18 -> tensor 19`）：输入与输出均为 `96x96x16` signed INT8，卷积核为 `16 x 4x4x16`，使用真实权重、折叠 INT32 bias、真实每输出通道 requant 参数与 ReLU，总量 `37,748,736` 个 INT8 MAC。XSCT 实板输出 `GESTUREFLOW_BODY2_HP0_BOARD_PASS` 和 `GESTUREFLOW_BODY2_HP0_FINAL_RESULT=0x600D600D`，不是 toy 算术测试。
2. **实板核验数值。** `PROBE[00]=0x600D600D`；`PROBE[04]=0x00000002`（done，未见 controller fault）；`PROBE[05]=0x000A2479=664697` 个 PL 周期；`PROBE[06]=PROBE[07]=0x00002400=9216` 个输入像素/输出向量；`PROBE[08]=0x893AFA60`，与全部 `9216x16` 个真实 TFLite INT8 输出的 FNV-1a golden 完全一致；`PROBE[09]=0x00120002`（DMA done、无 fault、读取 `147456` bytes）；`PROBE[10]=0x001300C0`（对齐 DDR 源地址）。ARM 全局定时器由 `0x001038E6` 走到 `0x00977621`，差 `8,863,035` ticks。Zynq BSP 的 CPU 频率约 `666.667MHz` 且 global timer 为 CPU/2，因此 ARM 墙钟约 `26.589ms`，与 `664697/25MHz=26.588ms` 相互吻合。
3. **当前可报告的性能边界。** 第二层板侧有效为约 `56.79 MAC/cycle`、`1.420 GMAC/s`、`37.61 layer/s`（只针对这一层，25MHz）。该结果来自 `PS DDR -> HP0 AXI4 64-bit -> signed INT8 NHWC tensor loader -> 4 行 x 16 通道滑窗 -> 16 输出 lane x 4 输入 lane DSP MAC -> 片内 INT32 跨四个输入通道组累加 -> TFLite requant/ReLU -> FNV`。权重、bias 和量化参数在运行时常驻 IP；输入通过最大 16 beat、单 outstanding、4KB 边界保护的 AXI4 burst 读取。它消除了逐像素 PS 控制和所有中间 partial sum 的 DDR 写回。
4. **已经证明与尚未证明的范围必须分开写。** 首层和第二层均已使用真实模型、真实量化张量、HP0 DDR 数据与完整输出签名通过实板。但是第二层当前输入 `tensor 18` 仍是 ARM 在启动前从真实 TFLite 导出数组复制到 DDR 的，所以尚未证明“首层 PL 输出自动写入 DDR 后被第二层自动读取”、尚未有 PL pooling、尚未有整网分类、摄像头或硬件侧连续多层执行。任何报告不得把本节写成完整网络、实时摄像头或无 PS 中间激活准备。
5. **本轮项目源和可复现入口。** 关键新增 RTL 为 `gesture_project/innovation_npu/rtl/gestureflow_same4x4_cin_window.sv`（参数化 NHWC 多通道 SAME 4x4 真实三行缓存）、`gestureflow_conv4x4_cin_same_stream.sv`（16 tap x Cin/4 group 的片内 INT32 累加）、`gestureflow_hp0_tensor_loader.sv`（signed INT8 feature tensor 的 AXI4 HP0 reader）及 `gestureflow_body2_hp0_axil.sv`（AXI-Lite 配置、计数和 hash）。真实张量导出器 `tools/export_real_conv4x4_full_layer.py --conv-index 1` 生成 `board_7020/software/gestureflow_real_conv4x4_body2_layer.h` 与 `tests/generated_gestureflow_real_conv4x4_body2_layer.svh`；该导出器已核验 `--conv-index 0` 仍可逐字节再生原首层 C/SV artifacts。行为回归入口为 `tests/run_gestureflow_conv4x4_cin_full_layer.sh` 和 `tests/run_gestureflow_body2_hp0_axil.sh`，板级入口依次为 `board_7020/run_build_body2_hp0_7020_from_wsl.sh`、`build_software_body2_hp0_7020_from_wsl.sh`、`run_board_body2_hp0_7020_from_wsl.sh`。
6. **仿真已先于烧板通过，且均有运行上限。** `run_gestureflow_conv4x4_cin_full_layer.sh` 输出 `GESTUREFLOW_CONV4X4_CIN_FULL_LAYER_PASS outputs=9216 probes=7 quant_fnv1a=893afa60 cycles=663856`；`run_gestureflow_body2_hp0_axil.sh` 输出 `GESTUREFLOW_BODY2_HP0_AXIL_PASS cycles=664261 hash=893afa60 bytes=147456`。它们分别核对完整直连数据流以及 AXI-Lite + AXI4 HP0 DDR model 数据通路，均以 `timeout 180s` 保护。首层 HP0 全图回归仍需保留，输出应为 `GESTUREFLOW_FULL_LAYER_HP0_AXIL_PASS cycles=221576 hash=f49b1b48 bytes=27648`。
7. **已实现的 7020 硬件资源和时序。** Windows 工程 `E:\coralnpu_vivado\projects\gestureflow_body2_hp0_7020_v2` 的 Vivado 2023.2 routed report（器件 `XC7Z020CLG400-2`）为全系统 `13507 LUT / 10534 FF / 64 RAMB18 / 148 DSP48E1`；其中项目 IP 为 `12207 LUT / 9183 FF / 64 RAMB18 / 148 DSP48E1`。25MHz `clk_fpga_0` 的实现结果为 `WNS=+12.230ns`、`TNS=0`、`WHS=+0.053ns`、`THS=0`，所有用户时序约束满足。`requant` 占 `8697 LUT / 64 DSP`，`stream` 占 `2770 LUT / 64 RAMB18 / 80 DSP`；因此后续不能先无约束增加并行层，而要实施层间存储复用和 AXI write handoff 后再评估并行规模。
8. **Windows 工程与失败工程不能混淆。** 可用的 bitstream 是 `E:\coralnpu_vivado\projects\gestureflow_body2_hp0_7020_v2\axi_gpio.runs\impl_1\system_wrapper.bit`，对应 XSA 是 `...\logs\gestureflow_body2_hp0_7020.xsa`。`gestureflow_body2_hp0_7020_v1` 是失败工程，根因是从原始教程模板继承了旧 `CoreMini/FloatCore` synthesis run，Vivado 仍尝试综合 `fpnew_top.sv/FloatCore`；不得以该工程作为后续修改基底。`v2` 从已验证的首层 HP0 工程克隆，已检查生成的 `system.v`，项目 IP 的实际 `M_AXI` 连接经 SmartConnect 到 PS `S_AXI_HP0`；`M_AXI1` 的 dangling-interface warning 是模板残余，不能误判为有效 HP0 master 断线。
9. **下一项最高优先级是首层到第二层的真实 PL handoff。** 具体顺序固定为：首先给首层输出增加 AXI4 write master，按 16-byte 量化向量写入对齐的 DDR activation buffer；其次让现有第二层 `gestureflow_hp0_tensor_loader` 从该 buffer 读取；最后以第二层 `0x893AFA60` 全量 hash、DMA byte count 和 no-fault 状态在 Verilator 与实板同时验收。不能先更换模型、增加 PE 或宣称整网。该步骤完成才可消除 ARM 预装 `tensor 18`，建立真正的层间硬件数据交接；随后再做 pooling 和后续层顺序复用。
10. **操作纪律。** 任何 RTL 数值、AXI 或数据流改动都必须先跑第 6 条的有界回归，随后重建 Windows `E:` 本地工程并重新实板。Vivado/Vitis/XSCT 不允许直接运行 `\\wsl.localhost\...` 路径；从 WSL 调 XSCT 需在 `cmd.exe` 使用 `pushd E:\...\project_local_gestureflow`，不要用 `cd /d`。Windows 需以 `E:\Xilinx\Vivado\2023.2\bin\hw_server.bat -s tcp::3334 -lprotocol` 启动硬件服务器，XSCT 连接 `tcp:127.0.0.1:3334`。Tcl 的 `format` 文字含 `[`、`]` 时必须使用花括号，例如 `{PROBE[%02d] = 0x%08X}`。工作区还有算法、数据和其他板卡的未跟踪/未提交文件，当前硬件里程碑提交只能显式加入本节列出的 body-2 文件和本交接文档，禁止 `git add .`。

## 53 2026-08-16 7020 实板完成 HP0 DDR 到真实 TFLite 4x4 首层全图闭环

**阅读顺序：先读本节；再读 第 52 号记录 的 PIO 对照基线与 第 50 号记录 的量化 golden。不要依据更早的 7Z010、旧 3x3、RVV 或单窗口实验判断当前进度。** 当前唯一板级主线是项目自研 `gesture_project/innovation_npu/` 下的 GestureFlow-NPU。`/home/steveguo/coralnpu-gesture/coralnpu` 是提交 `7318dfc2a94c0ac081bbe1787414391aa3cd5052` 的 Google 上游**只读参考仓库**；本轮未修改它。所有下述新文件均带有 `PROJECT_LOCAL_SELF_RESEARCH_NOT_GOOGLE_OFFICIAL` 标识，不能称为 Google 官方 RTL。

1. **真实实板结果已经通过。** 在连接的正点原子 Zynq-7020 (`XC7Z020CLG400-2`)、Windows Vivado/Vitis 2023.2 与 JTAG 环境中，已重新生成、下载并运行 HP0 版 bitstream 和 Cortex-A9 ELF。XSCT 最终输出 `GESTUREFLOW_FULL_LAYER_HP0_BOARD_PASS`，板上 `FINAL_RESULT=0x600D600D`、`STATUS=0x00000002`（done，无 fault）、`CYCLES=0x000361D9=221657`、`INPUT_PIXELS=OUTPUT_VECTORS=0x2400=9216`、`OUTPUT_FNV1A=0xF49B1B48`。这是 147,456 个真实量化 INT8 输出的全量 FNV-1a golden，不是小算术测试、不是仅行为仿真。
2. 本次模型仍是 `gesture_project/models/static_cnn_4x4_w125_h112_nomixup_hagrid6_20260811/model_int8.tflite` 的**第一层**：`96x96x3 -> 96x96x16`、`16` 个 `4x4x3` INT8 核、INT32 bias/累加、TFLite per-channel requant 与 ReLU。它是完整静态手势网络中的真实首层，但当前结果**不是整网分类、不是摄像头已经接入、也不是已部署暂停中的 18 类训练模型**；后续描述必须守住这个范围。
3. 数据通路已从 PIO 基线实质前进为 `PS DDR -> PL HP0`。ARM 仅在启动前把一帧真实 RGB888 数据放在对齐 DDR 缓冲区，配置 768 个权重字、16 组 folded bias 和 16 组量化参数；`gestureflow_hp0_rgb_loader.sv` 通过真实 64-bit AXI4 读主口、最大 16 beat INCR burst 和一个 outstanding burst 从 `S_AXI_HP0` 读取 27,648 bytes，按 little-endian 展开 RGB，将 `u8` 摄像头值转换为模型 INT8 `q=u-128`，受后端 ready 反压后送入现有 SAME 4x4 流式卷积。板上 `DMA_STATUS=0x00036002` 表明 done、无 DMA fault、`bytes_read=((status>>3)&0xffff)=27648`，与 `96*96*3` 精确一致。此实现消除了 ARM 的 9,216 次运行期 AXI-Lite 像素写入，但 DDR 填充仍由 ARM 完成，尚未是摄像头 DMA。
4. 关键项目源文件是：RTL `gesture_project/innovation_npu/rtl/gestureflow_hp0_rgb_loader.sv` 与 `gestureflow_full_layer_hp0_axil.sv`；真实模型板端程序 `gesture_project/innovation_npu/board_7020/software/gestureflow_full_layer_hp0_main.c`；构建 Tcl `gesture_project/innovation_npu/board_7020/build_gestureflow_full_layer_hp0_7020.tcl`；板测 Tcl `gesture_project/innovation_npu/board_7020/scripts/run_gestureflow_full_layer_hp0_xsct.tcl`；稳定 Windows 运行入口 `gesture_project/innovation_npu/board_7020/run_board_full_layer_hp0_7020_from_wsl.sh`。导出的真实权重、量化参数与输入在 `gesture_project/innovation_npu/board_7020/software/gestureflow_real_conv4x4_full_layer.h`，其来源和再生成命令见 第 50 号记录。
5. 已完成三个有界行为回归，全部必须保留为后续 RTL 改动的最小门槛：(a) `bash gesture_project/innovation_npu/tests/run_gestureflow_hp0_rgb_loader.sh` 输出 `GESTUREFLOW_HP0_RGB_LOADER_PASS bytes=24 pixels=8`，覆盖 64-bit little-endian、跨 beat RGB、反压与 byte 计数；(b) `bash gesture_project/innovation_npu/tests/run_gestureflow_full_layer_hp0_axil.sh` 输出 `GESTUREFLOW_FULL_LAYER_HP0_AXIL_PASS cycles=221576 hash=f49b1b48 bytes=27648`，覆盖 AXI-Lite 配置、DDR AXI4 模型、全部 9,216 输入、卷积、量化及全量签名；(c) `bash gesture_project/innovation_npu/tests/run_gestureflow_full_layer_pio_axil.sh` 仍输出 `GESTUREFLOW_FULL_LAYER_PIO_AXIL_PASS cycles=222673 hash=f49b1b48`。三个脚本均设置有界执行，不得替换为无上限长仿真。
6. 当前 25MHz PL 性能必须按以下口径报告：该层有 `96*96*16*4*4*3=7,077,888` 个真实 INT8 MAC；`221657` 周期即 `8.866 ms/层`、`112.79 首层等效帧/秒`、`31.93` 有效 MAC/周期、`798.29 MMAC/s`。与真实实板 PIO 基线的 `264113` 周期相比，周期下降 `16.07%`。ARM `XTime` 探针从 `0x00068150` 至 `0x00339BB2`，差 `2,955,874` ticks；BSP 明确 CPU 为 `666,666,687Hz`、全局计时器为 CPU/2，故端到端测得 `8.868 ms`，与 PL 周期吻合。该改善来自 HP0 数据供给，**不能宣称为阵列峰值、整网 FPS 或摄像头吞吐**。
7. HP0 版完整 PS7+PL 已完成 Vivado 2023.2 implementation、bitstream 与 XSA。Windows 本地工程为 `E:\coralnpu_vivado\projects\gestureflow_full_layer_hp0_7020_v1`；bitstream 为 `axi_gpio.runs\impl_1\system_wrapper.bit`，XSA 为 `logs\gestureflow_full_hp0_7020.xsa`，报告为 `logs\gestureflow_full_hp0_7020_{utilization_impl,timing_impl}.rpt`。实现全系统资源为 `12727 LUT / 5511 FF / 25 RAMB18 / 148 DSP48E1`，25MHz `WNS=+12.314ns`、`TNS=0`、`WHS=+0.052ns`、`THS=0`；已验收 `REQP-1840=0`、bitstream 成功写出。仍有 68 个 `DPOP-2` 建议，来源是 `gestureflow_requant_relu.sv` 的 16 路 Q31 乘法未使用 DSP 内部 MREG/PREG；它不影响当前 25MHz 板测正确性，但在设计 bit-exact valid/last 对齐后必须先处理，不能据此声称已经适合 100MHz。
8. Windows/WSL 操作细节已修正，后续不得重复踩坑。Vivado、Vitis 和 XSCT Tcl 均必须先复制到 `E:` 工程，绝不把 `\\wsl.localhost\...` 交给它们。当前 Windows TCP 排除范围包含 `3121`，标准 `hw_server` 端口不可绑定；已实际使用 `E:\Xilinx\Vivado\2023.2\bin\hw_server.bat -s tcp::3334 -lprotocol`。XSCT 是 Windows 程序，所以应连接 `tcp:127.0.0.1:3334`，不能使用 WSL gateway。更关键的是，WSL 调用 Windows XSCT 时应在 `cmd.exe` 内用 `pushd E:\coralnpu_vivado\projects\gestureflow_full_layer_hp0_7020_v1\project_local_gestureflow`，不能沿用会间歇触发 TCF “找不到指定的类别”错误的 `cd /d` 包装；`run_board_full_layer_hp0_7020_from_wsl.sh` 已固化此方式。可先运行 `scripts/diagnose_gestureflow_xsct_tcf.tcl` 确认 `GESTUREFLOW_XSCT_TCF_CONNECT_PASS`。Tcl 的 `format` 中包含方括号时仍必须用花括号字符串，例如 `{PROBE[%02d] = 0x%08X}`。
9. 最近可复现操作顺序是：(a) `bash gesture_project/innovation_npu/board_7020/run_build_full_layer_hp0_7020_from_wsl.sh`，验收 `GESTUREFLOW_FULL_HP0_7020_BITSTREAM_PASS`、`REQP-1840=0` 和 implementation timing；(b) `bash gesture_project/innovation_npu/board_7020/build_software_full_layer_hp0_7020_from_wsl.sh`，生成 `gestureflow_full_layer_hp0.elf`；(c) Windows 启动 3334 `hw_server`；(d) `bash gesture_project/innovation_npu/board_7020/run_board_full_layer_hp0_7020_from_wsl.sh`，只接受本节第 1 条的 PASS、计数与 hash。任何涉及数值、AXI 或数据流的改变，都必须先运行第 5 条的 HP0 全图行为回归，再重建并实板回读，不能只看综合通过。
10. **下一阶段边界固定：**保留当前 HP0 首层作为已提交回退基线；先将后续真实层（pooling/第二卷积层）接入同一 DDR 描述符和片上数据流，或在不破坏 golden 的前提下把权重/量化配置改成可重用 layer descriptor，以减少 ARM 控制开销。不得退回 PIO 作为性能路线；不得先做无验证的高频、摄像头、整网或论文级稀疏优化；不得把当前首层 PASS 写成整网、实时摄像头或 Google CoralNPU 官方部署。

## 52 2026-08-16 7020 实板完成真实 TFLite 4x4 首层全图运行和性能基线

**阅读顺序：本节最高，然后读 第 51 号记录 的 PIO 控制器、第 50 号记录 的真实量化 golden；不要依据更早的单窗口、7Z010 或旧 3x3 历史记录判断当前能力。** 所有本节 RTL、软件与脚本均是 `gesture_project/innovation_npu/` 下带 `PROJECT_LOCAL_SELF_RESEARCH_NOT_GOOGLE_OFFICIAL` 标识的项目自研内容。`/home/steveguo/coralnpu-gesture/coralnpu` 仍为 Google 上游**只读参考**，本节未修改该目录。

1. 已在连接的 `XC7Z020CLG400-2` 实板通过真实模型第一层全图运行。硬件基准模型仍是旧六类 4x4 INT8 模型 `gesture_project/models/static_cnn_4x4_w125_h112_nomixup_hagrid6_20260811/model_int8.tflite` 的首个卷积层，形状为 `96x96x3 -> 96x96x16`，不是完整手势网络、不是摄像头实时通路，也不是暂停中的 18 类模型。2026-08-16 的 XSCT 实测结果为：`GESTUREFLOW_FULL_LAYER_PIO_FINAL_RESULT=0x600D600D`，`STATUS=0x00000002`（done 且无 fault），`CYCLES=0x000407B1=264113`，`INPUT_PIXELS=OUTPUT_VECTORS=0x2400=9216`，`OUTPUT_FNV1A=0xF49B1B48`。签名与 TFLite 全量 147,456 个 INT8 输出 golden 完全一致。
2. 实板构成是 `ARM AXI-Lite PIO -> 项目侧 SAME 4x4 三通道 BRAM 行缓存 -> 16x4 INT8 DSP MAC -> INT32 本地部分和 -> TFLite per-channel requant/ReLU -> 片上 output bank/FNV`。ARM 只在层开始前常驻写入 768 个权重字、16 个 folded bias 与 16 组量化参数，随后送入 9,216 个真实 camera-domain RGB 字；ARM 不逐窗口下发 MAC 命令。camera uint8 到模型 signed INT8 的 `u-128` 变换仍由 IP 的 bit7 翻转完成，SAME 边界仍填输入零点 `-128`。本 PIO 供数只是首版正确性基线，**不能称为 DMA、摄像头已接入或零 CPU 开销**。
3. 25MHz 下该全层端到端 PL 计数约为 `264113 / 25MHz = 10.565ms`，折合约 94.65 首层/秒；真实该层计算量是 `96*96*16*4*4*3=7,077,888` INT8 MAC，端到端有效约 26.80 MAC/周期、约 669.9 MMAC/s。此数包含 AXI-Lite PIO 的 pixel-ready 等待与当前“每空间窗口串行 16-tap 调度”空泡，**不是**64 MAC/周期阵列峰值。用于比较的纯 RTL 连续输入行为基线是 221,488 cycles；当前最短性能路径是 MM2S RGB ingress 和多窗口 FIFO/重叠调度，而不是用 PIO 结果虚报阵列性能。
4. 本轮可靠性修复已完成并且是可烧录前提。`gestureflow_line_window.sv`、`gestureflow_same4x4_rgb_window.sv`、`gestureflow_conv4x4_rgb_same_stream.sv` 与 `gestureflow_conv4x4_rgb_same_layer.sv` 的 BRAM 地址、使能或地址上游控制状态均已改为同步复位；SRAM payload 不复位、每帧仍用 frame-start 做逻辑状态清零。真实 96x96 golden 和 AXI-Lite 全层 Verilator 回归均重新通过。Windows Vivado 2023.2 的完整 PS7+PL 实现最终确认 `REQP-1840=0`，生成了当前已烧录的 `.bit` 与 `.xsa`。
5. 完整实现资源和时序来自 `E:\coralnpu_vivado\projects\gestureflow_full_layer_pio_7020_v1\logs\gestureflow_full_pio_7020_{utilization_impl,timing_impl}.rpt`：全系统 `11207 LUT / 4413 FF / 25 RAMB18 / 148 DSP48E1`；其中项目 IP `10802 LUT / 3914 FF / 25 RAMB18 / 148 DSP48E1`。教程板的 25MHz 时钟完成实现，`WNS=+11.701ns`、`WHS=+0.044ns`、TNS/THS 均为零。当前仍有 68 个 `DPOP-2` 建议，均指向 16 路 Q31 requant 的未寄存 DSP 乘法；这是后续 100MHz、功耗优化必须处理的事项，不影响本次 25MHz 正确性实板结论。
6. 新增可复现板侧资产为 `gesture_project/innovation_npu/board_7020/software/gestureflow_full_layer_pio_main.c`、`build_software_full_layer_pio_7020_from_wsl.sh`、`scripts/run_gestureflow_full_layer_pio_xsct.tcl` 与 `run_board_full_layer_pio_7020_from_wsl.sh`。固定顺序是：(a) 先运行 `bash gesture_project/innovation_npu/board_7020/run_build_full_layer_pio_7020_from_wsl.sh`，验收 Windows build log 中 `REQP-1840=0` 且 XSA/bit 更新；(b) `bash .../build_software_full_layer_pio_7020_from_wsl.sh`；(c) 在 Windows 以 `E:\Xilinx\Vivado\2023.2\bin\hw_server.bat -s tcp::3333` 启动服务器后运行 `bash .../run_board_full_layer_pio_7020_from_wsl.sh`。Vivado/Vitis/XSCT 必须使用 `E:` 本地工程，不能执行 UNC 路径。XSCT Tcl 的 `format` 字符串仍应使用花括号避免 `[]` 被当作命令。
7. 本轮唯一的软件判定错误已定位并修复：PIO `STATUS.bit5` 是正常的 FNV hash-active，`layer_fault` 是 bit6。首轮实板在 hash-active 时被 ARM 错误判为失败；只更正 `gestureflow_full_layer_pio_main.c` 的 bit 常数后重新编译、重新下板，得到上述 PASS。不要把首轮 `0xBAD0BAD0 / code 0x2102 / status 0x21` 归因为 RTL、量化或板卡错误。
8. 下一步不得回到小冒烟或重造单窗口。保留本提交为回退点，优先实现 `MM2S DMA/AXI4-Stream` 把 9,216 PIO 写替换为 DDR/camera ingress，并以同一个 `0xF49B1B48` golden、input/output count 和 PL cycle 计数复测；再实施 bit-exact requant 流水线以消除 DPOP-2、评估恢复 100MHz。随后扩大到 pooling/第二层和整网。每次 RTL 改动都需至少完成 Verilator、Vivado 或实板之一，涉及本层数值必须重跑真实全图 hash，不能只看一两个探针。

## 51 2026-08-16 全首层 AXI-Lite PIO 控制器已行为通过，首轮 bitstream 明确拒绝，待同步复位重建

**阅读顺序：本节最高，然后读 第 50 号记录 的真实全图 TFLite golden。** 新增项目侧控制器 `gesture_project/innovation_npu/rtl/gestureflow_full_layer_pio_axil.sv`，它把真实 `96x96x3 -> 96x96x16` 首层接到 PS AXI-Lite：PS 仅配置权重、folded bias、per-channel requant 和 camera RGB；PL 保持本地权重、内部 SAME 行缓存、INT32 累加、量化输出，并公开 RGB pixel count、output vector count、layer cycles、FNV-1a output hash、done/fault。此 PIO 版本是为尽快取得**全首层实板正确性/周期基线**，不是最终 DMA 或摄像头吞吐实现，不能把它称作零 CPU 开销或实时相机通路。

1. 控制器级全图回归为 `bash gesture_project/innovation_npu/tests/run_gestureflow_full_layer_pio_axil.sh`，使用 `tb_gestureflow_full_layer_pio_axil.sv` 通过 AXI-Lite 任务实际完成配置和 9,216 次 RGB 像素提交。2026-08-16 同步复位版本已实际 PASS：`GESTUREFLOW_FULL_LAYER_PIO_AXIL_PASS cycles=222673 hash=f49b1b48`，输入计数为 9,216 RGB 像素、输出计数为 9,216 个 16-lane vector。日志：`/tmp/gestureflow_full_layer_pio_axil_sync_reset_20260816.log`。该数包含 PIO 等待与 16-cycle hash 收尾，不能和直接流入口的 `221488` 直接当作纯 MAC 吞吐比较。
2. 资源/时序先后实际验证：独立 XC7Z020-1 完整 PIO controller 综合为 `10,975 LUT / 3,914 FF / 25 RAMB18E1 / 148 DSP48E1`。100 MHz 的组合 requant WNS=`-17.290ns`，不得使用；实际教程 PL 时钟 25 MHz 下 WNS=`+12.710ns`、TNS=0，报告 `E:\coralnpu_vivado\projects\gestureflow_npu_7020\build\xc7z020_full_layer_pio_axil\{utilization_synth.rpt,timing_synth.rpt}`。主导瓶颈是 `gestureflow_requant_relu.sv` 的 16 路 Q31 乘法和位移组合路径；后续要提频必须增加 valid/坐标对齐的寄存流水并重新跑全部 golden，不能只修改时钟约束。
3. 独立板级工程已创建在 `E:\coralnpu_vivado\projects\gestureflow_full_layer_pio_7020_v1`，构建入口 `bash gesture_project/innovation_npu/board_7020/run_build_full_layer_pio_7020_from_wsl.sh`，Tcl 为 `board_7020/build_gestureflow_full_layer_pio_7020.tcl`。第一轮完整 PS7+PL 实现曾生成 `.bit`，但**严禁烧录该 bitstream**：它报告 `REQP-1840`，原因是 PIO controller 的异步 reset 驱动 weight BRAM 地址/写使能；且 Tcl 在 bitstream 后错误地以字符串 `impl_1` 读取运行对象，造成 XSA 导出被跳过。它仅作为失败日志 `/tmp/gestureflow_full_layer_pio_7020_build_20260816.log` 记录，不是可部署产物。
4. 这两个问题已在源码修复：`gestureflow_full_layer_pio_axil.sv` 的控制寄存器改为**同步复位**，避免 RAMB 控制脚的异步复位；构建 Tcl 改为 `[get_runs impl_1]` 再检查/打开 run，允许后续 `write_hw_platform` 导出 XSA。修复后已重新跑过完整 controller Verilator PASS，但尚未重跑耗时约四分钟的整板 implementation。因此当前准确状态是：**全首层真实模型行为、AXI-Lite 控制路径和 25MHz 独立综合通过；修复后的板级 bitstream 与实板下载尚未完成。**
5. 后续固定动作：先用修复后的 Tcl 重建独立 bitstream；验收必须是 `REQP-1840=0`、实现 timing 全满足、XSA 存在。之后复制 `gestureflow_real_conv4x4_full_layer.h` 到该工程的 Vitis app，ARM 侧写入 768 weight words、16 folded biases、16 requant 参数、9,216 RGB pixel words，读取 `OUTPUT_FNV1A=0xF49B1B48`、output count=9216、cycle counter，并经 XSCT 下载到 7020。只有这一步实际 PASS 后，才写“完整第一层实板通过”；随后再实现 MM2S/S2MM DMA，绝不能让 PIO 版本成为最终性能结论。

## 50 2026-08-16 真实 96x96 首层全图 TFLite 行为闭环，零点折叠与 SAME 边界已核验

**本节优先级最高。** 先读本节，再读 第 49 号记录 的摄像头接口定义、第 48 号记录 的层内量化输出路径、第 47 号记录 的 BRAM 资源基线，最后才追溯更早章节。所有本节文件均为项目侧自研并有 `PROJECT_LOCAL_SELF_RESEARCH_NOT_GOOGLE_OFFICIAL` 标识；`/home/steveguo/coralnpu-gesture/coralnpu` 仍为只读 Google 参考，实查提交为 `7318dfc2a94c081bbe1787414391aa3cd5052`，本节没有修改它。

1. 当前实板硬件基准仍使用旧六类 `4x4` INT8 模型 `gesture_project/models/static_cnn_4x4_w125_h112_nomixup_hagrid6_20260811/model_int8.tflite` 的第一层，绝不是暂停中的 18 类训练模型，也不是全模型或摄像头已部署。该层真实形状是 `1x96x96x3 -> 1x96x96x16`，权重 `16x4x4x3`，输入量化 `scale=1.0, zero_point=-128`，输出量化 `scale=0.07831007242202759, zero_point=-128`。输出 147,456 个 INT8 值的 FNV-1a 签名是 `0xF49B1B48`；原始 INT32 张量的按 little-endian int32 字节签名是 `0xF0F6EBDD`。
2. 本轮新增导出器 `gesture_project/innovation_npu/tools/export_real_conv4x4_full_layer.py`，以及其版本控制的可复现产物 `gesture_project/innovation_npu/board_7020/software/gestureflow_real_conv4x4_full_layer.h` 与 `gesture_project/innovation_npu/tests/generated_gestureflow_real_conv4x4_full_layer.svh`。导出器使用 `tflite_runtime` 的模型真实第一个 `CONV_2D` 中间张量（tensor 18），生成全范围 camera `uint8 RGB` 负载、对应 signed `q=u-128`、16 组权重、原 bias、folded bias、16 组 per-channel Q31 multiplier/right shift，以及 7 组边界/内部空间探针。重新生成命令：

   ```bash
   python3 gesture_project/innovation_npu/tools/export_real_conv4x4_full_layer.py \
     --model gesture_project/models/static_cnn_4x4_w125_h112_nomixup_hagrid6_20260811/model_int8.tflite \
     --c-out gesture_project/innovation_npu/board_7020/software/gestureflow_real_conv4x4_full_layer.h \
     --svh-out gesture_project/innovation_npu/tests/generated_gestureflow_real_conv4x4_full_layer.svh
   ```

   该命令在输出前逐点证明 `sum((q-zp)*w)+b == sum(q*w)+(b-zp*sum(w))`。当前 folded bias 是 `[-10921,-138,8383,2543,-3443,2377,-11428,-5004,7108,-22618,1811,1126,11062,5781,-4285,7995]`。禁止在硬件里直接把 camera `uint8` 当 signed activation，也禁止沿用旧 probe 的“所有输入均为负数”构造数据证明摄像头正确。
3. 本轮发现并修复一个会使四条图像边界错误的量化细节。TFLite `SAME` 的 pad 是量化张量的 input zero point，而不是 byte/signed-value `0`。`gesture_project/innovation_npu/rtl/gestureflow_same4x4_rgb_window.sv` 现在显式接受 `padding_value`；`gesture_project/innovation_npu/rtl/gestureflow_conv4x4_rgb_same_stream.sv` 和 `gesture_project/innovation_npu/rtl/gestureflow_conv4x4_rgb_same_layer.sv` 向外暴露并传递 `input_zero_point`。真实首层必须驱动 RGB 三路均为 `-128`。旧小型算术回归仍传 `0`，这是其测试模型的零点，而非真实 camera 配置。后续 descriptor/CSR 必须将本字段写入硬件，不能把 `-128` 固化在不透明的 RTL 常数中。
4. 新增有界完整回归 `gesture_project/innovation_npu/tests/tb_gestureflow_conv4x4_rgb_full_layer.sv` 和入口 `bash gesture_project/innovation_npu/tests/run_gestureflow_conv4x4_rgb_full_layer.sh`。它先在每个 `output channel x tap` 写入真实 768 个权重，常驻计算完整帧；随后发送真实全范围 `96x96x3` 输入，检查所有 9,216 个空间输出、7 个位置的全部 16 lane，并对全部 147,456 个量化 bytes 做 FNV 对账。2026-08-16 实际输出为 `GESTUREFLOW_CONV4X4_RGB_FULL_LAYER_PASS outputs=9216 probes=7 quant_fnv1a=f49b1b48`，从 frame-start 至最后一个量化 vector 是 `221488` PL cycles。命令有 `timeout 180s`，本机 Verilator 5.018 实测约 5 秒；日志为 `/tmp/gestureflow_full_layer_verilator_20260816.log`。这证明项目 RTL 行为与该真实模型首层张量对齐，不是完整板级结果。
5. 已在 Windows Vivado 2023.2 对零点接口修改后的 `gesture_project/innovation_npu/vivado/gestureflow_conv4x4_rgb_same_stream_7020_top.sv` 重新实际综合。入口 `bash gesture_project/innovation_npu/vivado/run_synth_7020_same_stream_from_wsl.sh`，日志 `/tmp/gestureflow_same_stream_sync_bram_7020_synth_20260816_rerun.log`，报告 `E:\coralnpu_vivado\projects\gestureflow_npu_7020\build\xc7z020_conv4x4_rgb_same_stream\{utilization_synth.rpt,timing_synth.rpt}`。XC7Z020-1、100 MHz 结果为 **1,458 LUT / 2,357 FF / 25 RAMB18E1 / 80 DSP48E1，WNS=+3.030 ns，TNS=0，0 critical warning/error**。这是独立 `SAME + BRAM line cache + 16x4 MAC` 综合，不是带 PS/HP0/DMA 的完整 bitstream；不得把它和上一节 AXI microkernel 的实板资源混为一谈。
6. 现有可板测回退点没有更改：提交 `9872c4f` 的 `gestureflow_axil_microkernel.sv` 仍通过 `DDR -> HP0 -> activation BRAM -> 16x4 MAC -> requant -> output BRAM` 单个真实窗口，实板标志是 `GESTUREFLOW_FINAL_RESULT=0x600D600D`。本轮全图回归不能替代实板下载。下一步必须新建独立的 layer-level board IP，将 `gestureflow_conv4x4_rgb_same_layer.sv` 接入 MM2S 输入与 S2MM 输出，提供 start/done/fault、input zero point、weight/bias/requant 装载及 `pixel/window/MAC/DMA bytes/layer cycles` 计数器；**不要**把 96x96 全层硬塞进旧 256-word activation bank，也不要破坏旧 microkernel 的回退路径。
7. Windows/WSL 规则仍是最高优先级：Vivado/Vitis 必须在 `E:\...` 本地工程运行，不能传 `\\wsl.localhost\...`；所有脚本先复制自研源到 `E:`。板测 `hw_server` 使用 `E:\Xilinx\Vivado\2023.2\bin\hw_server.bat -s tcp::3333`，XSCT 使用 `connect -url tcp:127.0.0.1:3333`。任何需要超过三分钟的仿真必须停止或进入 `tmux`，并给出日志路径；本阶段整图行为回归已明确限制为 180 秒。

## 49 2026-08-16 摄像头 AXI4-Stream 输入边界已定义，首层零点折叠为必做项

新增 `gesture_project/innovation_npu/rtl/gestureflow_axi_stream_rgb_ingress.sv`，定义未来摄像头 RGB888 AXI4-Stream 到 GestureFlow `pixel_valid/pixel_ready` 的项目侧适配边界：`TUSER` 作为 SOF，首像素暂存一个周期后才发 `frame_start`，`TLAST` 与实际消费的像素对齐成 `line_end`，`TKEEP!=3'b111` 或一帧中重复 SOF 会置 protocol fault。该模块已 Verilator lint 通过，但尚未接入完整 layer/板级 camera IP，不能写成摄像头已跑通。

关键量化约束：当前真实首层 input zero-point 为 `-128`，camera uint8 `u` 必须转为 signed tensor `q=u-128`（硬件等价为 RGB byte 的 bit7 xor），而直接在 MAC 执行 `q-(-128)` 会产生 `0..255`，超过 INT8 lane。正确部署必须为每输出通道离线生成修正 bias `b_folded=b-original_zero_point*sum(weights)`，让硬件直接计算 `sum(q*w)+b_folded`；后续真实模型 exporter、权重/ bias DMA 和板测必须用此公式逐点验证，禁止直接把原 camera byte 或旧 probe 的负数构造样本当作摄像头正确性证据。

## 48 2026-08-16 连续首层已接入 requant 与空间 output-bank

新增 `gesture_project/innovation_npu/rtl/gestureflow_conv4x4_rgb_same_layer.sv`，将自研 RGB `SAME` 流、16x4 INT8 MAC、TFLite-style per-channel requant/ReLU 与 `gestureflow_output_bank` 串成一个层内数据流。output-bank 地址由完成 MAC 的 `output_row * IMAGE_WIDTH + output_column` 产生，raw result 被 requant 接收时同步锁存坐标，因此 quantized vector 写入时不会错位。该模块的输入是标准 ready/valid RGB 像素流，是后续摄像头 AXI4-Stream adapter 与 HP0 行条带 loader 的共同接入点，而不是 ARM 逐窗口控制接口。

实际回归入口 `bash gesture_project/innovation_npu/tests/run_gestureflow_conv4x4_rgb_same_layer.sh` 已通过，输出 `GESTUREFLOW_CONV4X4_RGB_SAME_LAYER_PASS writes=1`。该测试在 `1x1` SAME 边界加载完整 16 tap 权重，仅让 tap5/lane0 生效，驱动 RGB pixel=5；它检查 MAC、requant bypass、output-bank write valid、空间地址0、lane0=5 和 disabled lane=0。此项只证明层内时序/地址对齐，不可写成完整 `96x96`、真实 TFLite 全图、DDR writeback 或摄像头已完成。下一步：扩大成真实 96x96 全图 golden，再给该 `pixel_ready/pixel_valid` 端口接 AXI4-Stream 摄像头输入和 HP0 条带 DMA。

## 47 2026-08-16 同步 BRAM 四行窗口已验证，首层空间前端资源降至 1,453 LUT

**阅读顺序：先读本节，再读 第 46 号记录 的 SAME 语义基线与 第 45 号记录 的实板 HP0 基线。** 自研 RTL 仍仅在 `gesture_project/innovation_npu/`，`/home/steveguo/coralnpu-gesture/coralnpu` 仍为只读且本轮状态干净；不能把本节实现写成 Google 官方结构。

1. 已在 `gesture_project/innovation_npu/rtl/gestureflow_line_delay_bank.sv` 新增项目侧同步简单双口 INT8 line-delay BRAM，并重构 `gestureflow_line_window.sv`。每一像素在第 N 拍对三路历史行发出读地址；第 N+1 拍以该三路读数、寄存的当前像素、列坐标与行计数更新横向 4-tap history 并形成窗口。bank0 写当前像素，bank1/bank2 写前一拍读出的上一级历史值，因此每个输入像素仍只读取一次，旧循环 bank/modulo LUT mux 被完全删除。`pixel_ready` 是正式握手：当单窗口输出寄存器会被覆盖时，上游必须保持 pixel；现有 valid-only、RGB、Cin 及 SAME wrapper 都已接入这个握手，不能再绕过。
2. 本轮曾实际发现“BRAM 延后一拍但仍预取下一像素”会在下游 MAC busy 时覆盖未消费窗口，首个流式卷积 output1 因而数值错误。修复不是掩盖报错，而是用 `stage_will_emit_window` 在单输出寄存器没有容量时停止输入，并在 wrapper 端传递 `pixel_ready`。此实现包含一个安全的每窗口 bubble；当前 MAC 对一个 RGB 4x4 窗口本来需要 23 cycles，bubble 不处于当前算力瓶颈。若后续通过 window FIFO 消除它，必须添加 FIFO full/empty、坐标与 backpressure 的完整回归，禁止恢复不安全预取。
3. 已重新实际运行五项 Verilator 回归，均通过：`run_gestureflow_line_window.sh`（6 windows）、`run_gestureflow_conv4x4_stream.sh`、`run_gestureflow_conv4x4_rgb_stream.sh`、`run_gestureflow_conv4x4_cin_stream.sh`，以及完整 SAME 边界回归 `run_gestureflow_conv4x4_rgb_same_stream.sh`（`outputs=12`）。这些回归覆盖同步 BRAM 一拍延迟、窗口边界、正负 INT8、RGB lane3 mask、跨 Cin=8 与 MAC 回压。
4. 已再次通过 `bash gesture_project/innovation_npu/vivado/run_synth_7020_same_stream_from_wsl.sh` 执行实际 XC7Z020 100MHz 独立综合。日志为 `/tmp/gestureflow_same_stream_sync_bram_7020_synth_20260816.log`，报告在 `E:\coralnpu_vivado\projects\gestureflow_npu_7020\build\xc7z020_conv4x4_rgb_same_stream\`。最终结果为 **`1,453 LUT / 2,357 FF / 25 RAMB18E1 / 80 DSP48E1`，WNS=`+3.030ns`、TNS=0、0 warning/critical warning/error**。层次报告明确显示 `same_window=267 LUT/792 FF/9 RAMB18`，三路 RGB 中每一路的 3 个 `line_delay` bank 均映射一个 RAMB18。相对 第 46 号记录 的固定寄存器行缓存 `4,117 LUT / 9,475 FF / 16 RAMB18`，该路径减少 `2,664 LUT` 和 `7,118 FF`，增加 9 个 BRAM；这是已测综合数据，不是功耗估计。
5. 针对本轮提出的五项候选创新，当前准确状态如下：`(a)` 跨 Cin-group INT32 片上累加已经是 `gestureflow_mac_tile.sv` 的现有 `accum` 数据通路原则，但尚未完成多 group、动态位宽和整层 DDR 写回对比，不能声称“90%”；`(b)` 权重 BRAM 当前已同步提前一拍取数并与 MAC pipeline 重叠，但没有 DDR weight prefetch/计数器，不能声称“完全零等待/40-60%”；`(c)` 同步 BRAM 行缓存与一拍隐藏已完成本节的行为和综合验证，但尚有单窗口安全 bubble，不可称“零延迟”；`(d)` HP0 当前只支持安全固定最大 16-beat read burst，尚无自适应 burst；`(e)` weight BRAM 只在 read_enable 时读，尚未做可测的 BRAM clock-enable/power 对比。后续创新结论必须由 DDR bytes、MAC busy/idle、burst、周期和 Vivado power report 实测支撑。
6. 下一步固定：保留本同步 BRAM 提交为回退点；先在输出侧增加带空间坐标的 output-bank tile 写入和 DMA writeback 描述符，再将 HP0 固定 loader 扩展为输入四行条带装载。随后导出真实旧六类 4x4 模型首层完整 `96x96x16` raw/requant golden，执行行为、完整 Vivado、实板三重验证。训练继续暂停。

## 46 2026-08-16 真实 4x4 SAME RGB 连续空间调度 RTL 已逐点行为验证

**阅读顺序：先读本节，再读 第 45 号记录 的 HP0 实板基线；更早章节只用于追溯。** 当前自研主线仍严格限制在 `gesture_project/innovation_npu/`。`/home/steveguo/coralnpu-gesture/coralnpu` 是只读 Google 上游参考，本节任何 RTL 均有 `PROJECT_LOCAL_SELF_RESEARCH_NOT_GOOGLE_OFFICIAL` 标识，不得称为官方实现或修改官方目录。

1. 新增 `gesture_project/innovation_npu/rtl/gestureflow_same4x4_rgb_window.sv` 和 `gesture_project/innovation_npu/rtl/gestureflow_conv4x4_rgb_same_stream.sv`。它们首次将项目侧 4x4/RGB 参考从 **valid-only** 窗口扩展到 TFLite stride-1 `SAME` 语义：偶数 4x4 的填充固定为 top/left `1`、bottom/right `2`，因此输入 `HxW` 产生完整 `HxW` 空间坐标。首层三个通道各自使用四行循环行缓存，窗口只在 MAC 可接收时推进；MAC 运行的 23-cycle 期间，`window_ready` 会反压像素输入并保持窗口、坐标和行缓存状态，避免最常见的边界窗口丢失。
2. 为实现该语义，`gestureflow_line_window.sv` 增加了明确的 `window_ready` 回压端口：未被下游接收的窗口不再清除、不再取下一个像素。所有既有例化均明确连接 `1'b1`，所以原 valid-only 核的协议没有改变；`gestureflow_conv4x4_rgb_same_stream.sv` 是唯一使用真实回压的新集成核。`gestureflow_mac_tile.sv` 同时修复 `MAX_IC_GROUPS=1` 时 `$clog2(1)=0` 的零宽端口问题，防止首层单 RGB group 在 Verilator/Vivado 中形成非法 `[-1:0]` 向量。
3. 行为回归入口为 `bash gesture_project/innovation_npu/tests/run_gestureflow_conv4x4_rgb_same_stream.sh`，本轮已实际通过，输出 `GESTUREFLOW_CONV4X4_RGB_SAME_STREAM_PASS outputs=12`。testbench `tests/tb_gestureflow_conv4x4_rgb_same_stream.sv` 使用 `3x4` RGB 帧、每通道不同 INT8 像素、16 个 tap 的正负权重和不同 bias，对每一个 `output_row/output_column` 的全部 12 个 INT32 输出逐点比对软件 SAME 参考；这覆盖顶部、底部、左侧、右侧、RGB lane3 mask 与 MAC busy 回压。原有 `line_window`、单通道、RGB、Cin=8 流式回归和 HP0 microkernel 回归也在本轮重跑通过；后者仍输出 `GESTUREFLOW_AXIL_MICROKERNEL_DMA_PASS full_cycles=263 dma_cycles=263 rgb_cycles=23 carry_cycles=8`。
4. 本轮也实际完成独立 XC7Z020 综合，入口是 `bash gesture_project/innovation_npu/vivado/run_synth_7020_same_stream_from_wsl.sh`，日志 `/tmp/gestureflow_same_stream_bram_7020_synth_20260816.log`，报告与 DCP 位于 `E:\coralnpu_vivado\projects\gestureflow_npu_7020\build\xc7z020_conv4x4_rgb_same_stream\`。首次实现因循环 bank/modulo 索引产生 `16,596 LUT / 11,805 FF`，虽然 100MHz `WNS=+3.030ns`，资源不合格。随后把 `gestureflow_line_window.sv` 改为固定的三段行延迟链并去除循环 bank mux；行为回归未变，复综合降为 **`4,117 LUT / 9,475 FF / 80 DSP48E1 / 16 RAMB18E1`，100MHz `WNS=+3.030ns`、TNS=0、无 warning/critical warning/error**。该结果是独立综合，不是完整板级 bitstream 或实板结果。
5. 重要限制：尽管 `line_memory` 已添加 `ram_style="block"`，报告中 16 个 RAMB18E1 仍全部来自 16 个 weight bank，三路行缓存仍消耗约 7,910 FF，**不可声称行缓存已映射 BRAM**。根因是当前行缓存以异步读获得同周期竖向像素；下一次资源优化必须改为同步简单双口 BRAM、显式读取 latency/像素坐标/窗口 valid pipeline 对齐，并重新跑全部 golden。禁止只改 attribute 或为了 BRAM 推断打乱 SAME 坐标和 backpressure 协议。
6. 当前真实边界必须准确写为：**已完成 SAME 卷积空间控制和 MAC 行为闭环，并完成独立 XC7Z020 可综合资源/时序判定；尚未完成真实 96x96 首层的 HP0 行条带 DMA、output-bank 空间写入、AXI DDR writeback、TFLite 全图 golden、完整板级实现或实板下载。** 不能将此行为或综合回归写成完整首层上板。已实板通过的范围仍是上一节的“HP0->activation BRAM->一个真实 TFLite 4x4 首层窗口->requant/output BRAM”。
7. 下一步固定为将这个连续窗口前端接入真实 layer scheduler，而不是另造数据通路：先将行缓存重构为同步 BRAM 并证明资源映射，再把 HP0 loader 的 destination 扩展为四行输入条带，按 `output_row/output_column` 生成 output-bank tile 地址；每个 output tile 完成后新增 AXI writeback 到 DDR。需要先导出旧六类 4x4 模型首层完整 `96x96x16` 的 raw/requant golden，再完成 Verilator、Vivado 2023.2 实现、Zynq-7020 下载，之后才接 pooling/下一层。训练继续暂停。

## 45 2026-08-16 HP0 DDR burst loader 已在 Zynq-7020 实板与真实 4x4 TFLite 首层窗口共同通过

**阅读顺序：必须先读本节；再读 第 44 号记录 的真实 INT8 requant/output-BRAM 基线；更早章节仅用于追溯。** 当前硬件主线只能是项目自研 `gesture_project/innovation_npu/` 的 GestureFlow-NPU。`/home/steveguo/coralnpu-gesture/coralnpu` 仍是只读 Google 上游参考；本轮结束时已复核其提交固定为 `7318dfc2a94c0ac081bbe1787414391aa3cd5052` 且 `git -C coralnpu status --short` 无输出。下述 RTL、板级工程和测试结果均为项目侧工作，绝不可称为 Google 官方 RTL 或官方板级方案。

1. 本轮在 `gesture_project/innovation_npu/rtl/gestureflow_hp0_read_loader.sv` 增加受控的 DDR 到 activation-BRAM 读取前端。它不是通用 DMA，也不改变已经通过的 16x4 MAC、INT32 accumulation、TFLite per-channel requant/ReLU 和 output BRAM 语义。接口限定为 **一个 outstanding AXI4 INCR read burst**、64-bit beat、最多 16 beat/burst、AXI ID 固定为 0；一个 64-bit 返回 beat 在两个周期写为两个 32-bit activation word。loader 会限制 burst 不跨 4 KiB 边界，检查 source 8-byte alignment、RID、RRESP 和 RLAST；非法请求或响应会置 sticky fault，不允许静默装入错误数据。
2. `gestureflow_axil_microkernel.sv` 版本升为 `0x00010004`，将 loader 仲裁到既有 `activation_bank` 唯一写端。AXI-Lite stage write 与 DMA write 互斥：DMA busy 时禁止 `ACT_STAGE_DATA`、`CONTROL.start` 和新的 DMA 配置覆盖其写入；`CONTROL.clear` 同时取消 DMA。新寄存器为 `DMA_SOURCE_ADDR=0x064`、`DMA_WORD_COUNT=0x068`（1 至 256 个 32-bit word）、`DMA_STAGE_ADDR=0x06C`、`DMA_CONTROL=0x070`（bit0 start, bit1 clear）、`DMA_STATUS=0x074`（bit0 busy, bit1 done, bit2 fault）。DMA 完成后仍须使用既有 `CONTROL=0x2` 再 `CONTROL=0x5` 启动 staged MAC 任务；这是刻意保留的可验证边界，后续命令队列化时再消除 PS 的两次控制写。
3. 7020 Block Design 已按开发板教程和既有可运行 HP0 工程的实际连接方式修改，而非猜测直连：`gestureflow_0/M_AXI -> axi_smc/S00_AXI -> axi_smc/M00_AXI -> processing_system7_0/S_AXI_HP0`。PS7 配置明确为 `PCW_USE_S_AXI_HP0=1`、64-bit、ID width 6，并将 `FCLK_CLK0` 同时连接到 GestureFlow、SmartConnect 和 `S_AXI_HP0_ACLK`；`gestureflow_0/M_AXI` 地址空间显式映射到 `HP0_DDR_LOWOCM` 的 `0x00000000..0x3fffffff`。构建脚本为 `board_7020/build_gestureflow_axil_baseline_7020.tcl`，并继续遵守 Vivado 仅使用 `E:` 本地路径的规则，不能把 `\\wsl.localhost` 路径直接传给 Vivado/XSCT。
4. 行为回归 `bash gesture_project/innovation_npu/tests/run_gestureflow_axil_microkernel.sh` 已实际通过，日志为 `/tmp/gestureflow_hp0_verilator_20260816.log`。测试用 AXI memory model 返回 16 个 64-bit burst，向 activation BRAM 写入 256 个值为 `+2` 的 packed INT8 word；随后满载 `16 x 16 x 16 x 4` MAC tile 逐 lane 得 `2048 + lane`。同一回归仍同时覆盖旧满载 `263 cycles`、RGB `4x4x3` 的 `23 cycles`、真实 TFLite raw/quantized 16 lane、output BRAM 和跨 packed INT32 lane carry 禁回归，全部通过。
5. 已完成 Vivado 2023.2 综合、实现、bitstream/XSA 及**实板下载**。构建日志是 `/tmp/gestureflow_hp0_7020_build_20260816.log`；Windows 产物为 `E:\coralnpu_vivado\projects\gestureflow_axil_baseline_7020_v1\axi_gpio.runs\impl_1\system_wrapper.bit` 和 `logs\gestureflow_axil_7020.xsa`。完整实现资源为 `12,086 LUT as Logic / 53,200 (22.72%)`、`144 DSP48E1 / 220 (65.45%)`、`17 RAMB18E1 + 2 RAMB36E1 = 10.5 / 140 BRAM tile (7.50%)`；最终 setup `WNS=+11.252ns`、hold `WHS=+0.080ns`、TNS/THS 均为 0，所有用户时序约束满足。DPOP-1/2 仍提示 16-lane requant multiplier 未利用 MREG/PREG；当前 25 MHz 已闭合且数值正确，**禁止**只为消告警直接插寄存器，未来提频必须先设计 multiplier、shift、zero point、valid 与 output-BRAM address 的完整对齐流水并重复所有 golden 与实板测试。
6. 新 Cortex-A9 实板程序 `board_7020/software/gestureflow_axil_smoke_main.c` 将 256 个 `0x02020202` word 放在 64-byte aligned DDR buffer，并在 DMA 启动前调用 `Xil_DCacheFlushRange`。当前 baseline 为兼容 AXI-Lite 调试关闭了 D-cache，flush 仍保留为后续启用 cache 的必要非一致性 HP0 约束，绝不可删除。实板脚本 `board_7020/scripts/run_gestureflow_axil_baseline_xsct.tcl` 已打印 56 个 probe，最终日志 `/tmp/gestureflow_hp0_7020_board_20260816.log` 输出：`GESTUREFLOW_FINAL_RESULT=0x600D600D`、`VERSION=0x00010004`、`PROBE[52]=0x00000002`（DMA done, not busy, not fault）、`PROBE[53]=0x00000107`（DMA staged tile 的 263 compute cycles）、`PROBE[54]=0x00000800`（lane0=2048）、`PROBE[55]=0x0000080F`（lane15=2063）和 `GESTUREFLOW_AXIL_BOARD_PASS`。之后同一下载版本的真实 TFLite 首层 `raw INT32`、16 lane requant 和 output-BRAM probe `48..51` 仍精确通过，证明 DDR->HP0->BRAM->MAC->TFLite quant->output BRAM 没有破坏前一版真实模型链。
7. 当前准确边界：已真实验证的是旧六类 `static_cnn_4x4_w125_h112_nomixup_hagrid6_20260811/model_int8.tflite` 首层**一个**空间窗口与 DMA staging，不是完整 96x96 SAME 层、整网、18 类主模型或摄像头推理。下一步应以本 DMA 版提交为回退点，先实现真实 `4x4 SAME` 的连续空间窗口/行缓存与 output tile 地址调度；输出 tile 必须从 output BRAM ping-pong 写回 DDR，不能用 AXI-Lite 逐 lane 回读，更不能假称现有 valid-only line-window RTL 已支持 SAME padding。训练继续按用户要求暂停。

## 44 2026-08-16 真实 TFLite INT8 requant、ReLU 与 output BRAM 已在 Zynq-7020 实板通过

**阅读顺序：必须先读本节；再读 第 43 号记录 的 raw INT32 首层窗口基线；更早章节仅用于追溯。** 当前主线是项目自研 `gesture_project/innovation_npu/` 的 GestureFlow-NPU。`/home/steveguo/coralnpu-gesture/coralnpu` 是只读 Google 上游参考，本轮复核提交仍为 `7318dfc2a94c0ac081bbe1787414391aa3cd5052` 且工作区干净；下述模块和结论均为项目侧实现，绝不可称为 Google 官方 RTL。

1. 已在 MAC tile 后加入 `gesture_project/innovation_npu/rtl/gestureflow_requant_relu.sv`。它对每个输出通道执行与 TFLite `QuantizeMultiplier` 对应的 Q31 multiplier、`SaturatingRoundingDoublingHighMul`、负数向零截断、按 2 的幂舍入、output zero-point 与 fused ReLU。当前 descriptor 的硬件规格明确为常见卷积缩小比例，即每 lane 一个 `right_shift[0,31]`；遇到非法 shift 会置故障，禁止静默算错。该模块不是近似右移，也不是浮点后处理。
2. 真实参数由 `gesture_project/innovation_npu/tools/export_real_conv4x4_probe.py` 从 `static_cnn_4x4_w125_h112_nomixup_hagrid6_20260811/model_int8.tflite` 的第一层导出。导出器现在优先使用 TensorFlow `BUILTIN_REF`，当前 WSL 无 TensorFlow 时回退到 `tflite-runtime`；两者都以真实 TFLite tensor 读取 scale/zero-point。首层输入 `scale=1.0, zero_point=-128`，输出 `scale=0.07831007242202759, zero_point=-128`，权重按 16 个输出通道分别量化。生成头 `board_7020/software/gestureflow_real_conv4x4_probe.h` 固化了 16 个 raw golden、Q31 multiplier、right shift 和 INT8 golden，且生成器会先在软件端逐元素比对 TFLite tensor，不一致即退出。
3. 新增 `gesture_project/innovation_npu/rtl/gestureflow_output_bank.sv`，为 256 个地址、每地址 16 个 INT8 输出通道的 tile-local output bank。一个 MAC 任务完成后，requant vector 自动写入一个 output address，并使地址递增；`OUT_READ_CTRL/OUT_READ_DATA` 仅保留为板测调试窗口，正常层间路径将由该 bank 后续接 pooling/HP0 DMA，不能再把逐 lane AXI-Lite 回读当作正式数据流。`gestureflow_axil_microkernel.sv` 版本升为 `0x00010003`，新增 `RQIDX/RQMULT/RQSHIFT/RQCTRL`、`OUT_STAGE_ADDR/OUT_READ_CTRL/OUT_READ_DATA`、`QUANT_RESULT_IDX/QUANT_RESULT_DATA`。任务的 `done` 现在代表量化 vector 已被写入 output bank，而不是 raw accumulator 刚出现。
4. **已经实际完成 Verilator、完整 Vivado 和实板三重验证。** 行为回归命令 `bash gesture_project/innovation_npu/tests/run_gestureflow_axil_microkernel.sh` 覆盖：(a) 原满载 16,384 MAC `263 cycles`；(b) `4x4 x RGB` `23 cycles`；(c) 真实模型 16 条有正有负的 raw accumulator，全部通过 TFLite per-channel quant/ReLU；(d) output bank 的四个 32-bit 打包字；(e) 既有跨 packed-lane carry 回归 `8 cycles`。本轮调试曾发现两类真实错误并已写入回归：`QUANT_RESULT_IDX` 初版缺失写路径会重复读 lane0；负数 `RoundingDivideByPOT` 初版中有符号右移与无符号拼接相加会把负数误解为大正数。两者均不能回退。
5. **新 bitstream 已实板下载通过。** Windows 工程仍是 `E:\coralnpu_vivado\projects\gestureflow_axil_baseline_7020_v1`，构建日志为 `/tmp/gestureflow_quant_build_20260816.log`。实现资源为 `11235 LUT (21.12%)`、`3961 FF (3.72%)`、`17 RAMB18E1 + 2 RAMB36E1`（`10.5/140` BRAM tile，`7.50%`）、`144/220 DSP48E1 (65.45%)`；时序报告为 setup `WNS=+10.159ns`、hold `WHS=+0.045ns`、无 failing endpoint、无 Critical Warning。相对 raw baseline 的额外 64 个 DSP 是 16 路逐通道 Q31 multiplier 的真实实现代价。Vivado 仍提示未使用 DSP MREG/PREG；当前 25MHz 余量充足，后续提高频率必须先显式设计 multiplier pipeline 的 valid/data 对齐并重复软件 golden、行为、实现和实板回归，不能直接让工具插寄存器。
6. XSCT 实板脚本 `board_7020/scripts/run_gestureflow_axil_baseline_xsct.tcl` 最终输出 `GESTUREFLOW_AXIL_BOARD_PASS`、`GESTUREFLOW_FINAL_RESULT=0x600D600D`。`PROBE[08..23]` 是真实 raw INT32：`12945,40101,-27709,-25992,-7799,-26966,21056,-11847,-5999,-20715,13808,-15449,-10414,13976,-4778,13263`，全部精确对齐。`PROBE[32..47]` 是 TFLite INT8：`-123,-87,-128,-128,-128,-128,-121,-128,-128,-128,-76,-128,-128,-122,-128,-111`；`PROBE[48..51]` 是 output bank 的打包字：`0x8080A985,0x80878080,0x80B48080,0x91808680`，也已精确对齐。此结果证明首层一个真实窗口已经在 ARM -> BRAM staged -> 64 INT8 MAC/cycle -> INT32 accumulator -> per-channel TFLite requant/ReLU -> output BRAM 链路上实板闭环。
7. 当前不可夸大：这仍是旧六类 4x4 模型的一个首层窗口，不是 18 类主模型、不是整层、不是整网，也尚无 HP0/DDR DMA、连续滑窗、pooling、output bank ping-pong 或摄像头。**下一步固定为：**保留这一套 raw/quant/output-bank golden 不动，先给 output bank 接真实 4x4 首层的空间窗口连续调度与输出地址管理，再以 HP0 burst loader 取代 PS 的逐 word BRAM staging；随后接 pool 和下一卷积层的 Cin/output tile。训练继续保持暂停。

## 43 2026-08-16 真实 INT8 4x4 模型窗口在 Zynq-7020 精确对账通过

**阅读顺序：必须先读本节，再读 第 42 号记录 的可配置任务与 staging 基线；更早章节仅作历史追溯。** 当前唯一硬件主线是 `gesture_project/innovation_npu/` 下的项目自研 GestureFlow-NPU。`/home/steveguo/coralnpu-gesture/coralnpu` 是 Google 上游只读参考，已复核固定在 `7318dfc2a94c0ac081bbe1787414391aa3cd5052`，不得修改；本节的 RTL、导出器、板级软件与结论均不是 Google 官方成果。

1. 用于真实硬件数据通路验证的模型是 `gesture_project/models/static_cnn_4x4_w125_h112_nomixup_hagrid6_20260811/model_int8.tflite`。它是旧六类、4x4 普通卷积的可复现硬件基线，首层形状为 `1x96x96x3 -> 1x96x96x16`，权重为 `16x4x4x3`，并**不是**当前暂停训练的 18 类最终准确率主模型。导出器是 `gesture_project/innovation_npu/tools/export_real_conv4x4_probe.py`，生成的板级常量头为 `gesture_project/innovation_npu/board_7020/software/gestureflow_real_conv4x4_probe.h`。
2. TFLite 输入量化参数为 `scale=1.0, zero_point=-128`。因此 MAC 输入必须是 `input_q - input_zero_point`，不能把原始 INT8 张量直接送入阵列；导出器用确定性量化输入并在一个无边界效应的 4x4 窗口导出 768 个真实 INT8 权重、48 个零点修正后的 activation、16 个真实 INT32 bias 和 16 个 raw accumulator golden 值。`gestureflow_axil_smoke_main.c` 将这些数据装入现有权重 BRAM 和 activation BRAM，以 `JOB_CFG=0xFFFF070F` 触发真实 `4x4 x RGB` 任务，然后逐 lane 回读比较。
3. 此次真实权重板测暴露并修复了一个不能回退的 RTL 缺陷。`gestureflow_mac_tile.sv` 原本对 packed `16 x INT32` 数组执行整体 `result_psum <= accum + reduced_sum_extended`；这实际是 512-bit 加法，会把 lane N 的进位串到 lane N+1，导致如 lane3/lane4 在真实正负权重下出现 `+1` 污染。现在改为 `for` 循环中每 lane 独立 32-bit 加法，并在 `tb_gestureflow_axil_microkernel.sv` 加入 `INT32_MAX + 1` 只允许 lane0 环绕、lane1 必须保持零的回归。后续任何重构都不得恢复整体 packed-array 加法。
4. 修复后已实际完成 Verilator 回归、Vivado 2023.2 完整综合/布局布线/bitstream，以及 Zynq-7020 JTAG 实板下载。行为回归输出分别为满载 `263` cycles、RGB `23` cycles、进位回归 `8` cycles。实板脚本 `gesture_project/innovation_npu/board_7020/scripts/run_gestureflow_axil_baseline_xsct.tcl` 输出 `GESTUREFLOW_AXIL_BOARD_PASS` 和 `GESTUREFLOW_FINAL_RESULT = 0x600D600D`；真实模型 16 路 raw INT32 的读回与 golden 全部精确一致，例如 `12945, 40101, -27709, -25992, ... ,13263`。本次 bitstream 的实现日志为 `/tmp/gestureflow_realfix_7020_build_20260816.log`。
5. 当前已验证的范围是：真实 TFLite 权重、bias、零点修正 activation、4x4/RGB 尾 lane mask、BRAM staged 连续发射、64 INT8 MAC/cycle 阵列和 16 个相互独立的 INT32 累加器。**尚未实现** TFLite per-channel requant、输出 zero-point、ReLU/pooling、输出 BRAM、HP0/DDR DMA、整层或整网；禁止写成这些已完成。下一步优先级固定为：先在不破坏上述 raw 对账路径的前提下增加真实首层逐通道 requant/ReLU 和输出片上存储，再接整层窗口调度与 HP0 burst loader。训练继续暂停。

## 42 2026-08-16 可配置 4x4/RGB 任务已在 Zynq-7020 实板通过

**阅读顺序：必须首先读本节；随后读 第 41 号记录 的满载 staging 基线；更早章节只用于追溯。** 当前项目硬件主线是 `gesture_project/innovation_npu/` 的项目自研 GestureFlow-NPU。Google 官方参考仅限 `/home/steveguo/coralnpu-gesture/coralnpu`，已复核为只读固定提交 `7318dfc2a94c0ac081bbe1787414391aa3cd5052`；不可修改，也绝不能将以下成果称为 Google 官方实现。

1. `gestureflow_axil_microkernel.sv` 的 staged 执行已从固定 256 word 事务扩展为一个小型层任务描述符：`JOB_CFG (0x03c)` 的 `[3:0]` 是 `tap_count-1`、`[7:4]` 是 `Cin-group-count-1`、`[11:8]` 是最后一个 Cin-group 的有效输入 lane mask、`[31:16]` 是有效输出 lane mask。它保留先前 activation BRAM 的线性装载接口；硬件按照 descriptor 在运行中生成 tap/group、处理同步 BRAM 读延迟、生成 `mac_last`，并对最后通道组施加 mask。直接 AXI-Lite `ACTRL/ADATA` 通路仍只作为调试兼容接口。
2. Verilator 已同时覆盖满载和实际 RGB stem 形状。执行 `bash gesture_project/innovation_npu/tests/run_gestureflow_axil_microkernel.sh` 输出：`full_cycles=263`、`rgb_cycles=23`、`lane0=48`、`lane15=63`。RGB 用 `tap=16`、`Cin-group=1`、lane mask `0b0111`、16 输出 lane，所有权重/激活为 +1、bias 为 lane-id，因此正确结果严格为 `16 x 3 + lane = 48..63`。这不是图像分类准确率测试，而是对真实首层输入通道尾掩码、任务长度和流水线排空的数字电路验证。
3. 当前版本号为 `0x00010002`。已重新完成 Vivado 2023.2 的完整综合、实现、bitstream 和 XSA：`17 RAMB18E1 (6.07%)`、`80 DSP48E1 (36.36%)`、25MHz `WNS=+24.276ns`、`TNS=0`、`WHS=+0.065ns`，无 Critical Warning。bitstream/报告仍在 `E:\coralnpu_vivado\projects\gestureflow_axil_baseline_7020_v1` 的既有路径中。DPOP/DPIP 性能建议仍存在，尚未在没有 valid/last 重新对齐设计的情况下盲目增加寄存器。
4. **已重新实板下载和运行。** XSCT 输出 `GESTUREFLOW_AXIL_BOARD_PASS` 和 `FINAL_RESULT=0x600D600D`。探针 `PROBE[07]=0x107=263` 保存满载 16,384-MAC staging 测试周期；第二个 RGB 任务完成后 `PROBE[26]=0x17=23`，`PROBE[08..23]=0x30..0x3F`（十进制 48..63），`PROBE[24]=0xFFFF`，状态 `PROBE[25]=0x8`。这证明满载吞吐基线和实际第一层 `4x4 x RGB` 形状均在同一下载版本上通过。
5. **下一步不可跳过的工程边界：**先将 AXI-Lite 预装载前端替换为固定格式的命令 FIFO/HP0 AXI burst loader，DMA 的唯一写入目标就是当前 `activation_bank`，不能改变已经通过的 tile/staging/done 语义；然后用导出的真实模型 INT8 权重、activation、bias 做 4x4 首层逐输出点对账，并实现 per-channel requant/ReLU/pool。只有这几步通过后才谈完整层、整网和摄像头。训练继续暂停。

## 41 2026-08-16 Activation BRAM staging 已综合、布局布线并实板通过

**阅读顺序：必须首先阅读本节；随后读 第 40 号记录 的同步复位基线；再读 第 39 号记录 的首次 AXI-Lite 基线。** 当前硬件唯一主线仍是项目自研 `gesture_project/innovation_npu/`。`/home/steveguo/coralnpu-gesture/coralnpu` 是 Google 官方只读参考，不可修改；本节所述全部模块均为项目自研且带 `PROJECT_LOCAL_SELF_RESEARCH_NOT_GOOGLE_OFFICIAL` 标识。

1. 新增 `gesture_project/innovation_npu/rtl/gestureflow_activation_bank.sv`，是 256 x 32-bit 的单个 BRAM activation staging bank。PS 在运行前通过现有 AXI-Lite 的 `ACT_STAGE_ADDR (0x034)` 和 `ACT_STAGE_DATA (0x038)` 装载 256 个四路 INT8 activation word；`CONTROL=0x5`（bit0 start、bit2 staged mode）后，硬件自主按 `tap=address[7:4]`、`Cin-group=address[3:0]` 连续扫读、处理 BRAM 同步读延迟并向既有 16x4 MAC tile 发射。直接逐字 activation 模式 `ACTRL/ADATA` 仍保留为调试兼容路径，但不再是性能测量路径。
2. `bash gesture_project/innovation_npu/tests/run_gestureflow_axil_microkernel.sh` 已用 Verilator 通过：`GESTUREFLOW_AXIL_MICROKERNEL_STAGED_PASS cycles=263 lane0=1024 lane15=1039`。该测试以 `+1` 权重、`+1` 激活、lane-id bias 覆盖完整 `16 x 16 x 16 x 4 = 16,384` INT8 MAC，所有 lane 仍精确为 `1024..1039`；测试额外强制 `cycles < 1000`，避免后续改动意外退回 PS 运行期逐字供数。
3. Windows 本地工程 `E:\coralnpu_vivado\projects\gestureflow_axil_baseline_7020_v1` 已完整综合、布局布线并生成新 bitstream/XSA。实现资源为 `17 RAMB18E1 (6.07%)`、`80 DSP48E1 (36.36%)`；新增 activation bank 被报告确认映射为真实 `RAMB18E1`，不是 LUT RAM。系统时序为 `WNS=+21.232ns`、`TNS=0`、`WHS=+0.064ns`，无时序违例、无 Critical Warning。当前仍保留 DSP 输入流水建议；其处理必须先设计 valid/last 对齐流水，再做完整回归，不能为了消除告警直接插寄存器。
4. **已实际重新下板，非推算：**新版 Cortex-A9 ELF 与新版 bitstream 在连接的 Zynq-7020 上运行后输出 `GESTUREFLOW_AXIL_BOARD_PASS`、`FINAL_RESULT=0x600D600D`、`VERSION=0x00010001`、`STATUS=0x00000008`、16 路 `0x400..0x40F`、mask `0xFFFF`。板上 `CYCLES=0x107=263`，与行为仿真精确一致。对同一 `16,384` MAC，执行段时间为 `10.52us`，有效速率为约 `1.557 GMAC/s`，为 25MHz 下 64 MAC/cycle 理论 `1.6 GMAC/s` 的约 `97.3%`。这个数字仅表示**activation 已预装到 BRAM 后的 tile 执行段**，不能误写为包含 AXI-Lite 预装载、模型层、DDR 或摄像头的端到端帧率。
5. 下一阶段严格按接口演进而非重新造核：保留 `activation_bank` 和 MAC tile 不动，增加小型描述符/命令 FIFO 和 AXI master HP0 DMA，将 PS 的逐字 staging 写替换为 DDR burst 装载；再接真实模型 4x4/1x1 单层的权重、激活、bias、per-channel requant、ReLU/pool 逐点对账。此时禁止直接声称整网已部署或继续增加 DSP；训练继续暂停。

## 40 2026-08-16 同步复位加固版已重新实板通过，随后进入片上 activation staging

**阅读顺序：先读本节，再读下方 第 39 号记录 的首次板级基线；两节共同构成当前唯一可回退的 GestureFlow-NPU 硬件起点。** 训练仍按用户要求暂停。`/home/steveguo/coralnpu-gesture/coralnpu` 仍是 Google 官方只读参考，复核提交 `7318dfc2a94c0ac081bbe1787414391aa3cd5052` 且状态干净；下面的 RTL、工程和结果全部是 `gesture_project/innovation_npu/` 中带 `PROJECT_LOCAL_SELF_RESEARCH_NOT_GOOGLE_OFFICIAL` 标识的项目自研内容。

1. 已将 `gestureflow_mac_tile.sv` 与 `gestureflow_axil_microkernel.sv` 的控制状态从异步复位改为同步复位，权重 BRAM 保持无复位且仍要求在每次任务 `start` 前由软件或后续 DMA 完整装载。板级构建 Tcl 同时删除了从教程带入、但已无对应端口的 `Navigator.xdc`。这一修改消除了此前的无效 XDC Critical Warning 和 BRAM 控制 `REQP-1840` 风险。
2. 修改后的 Vivado 2023.2 完整实现和 bitstream 已实际完成，时序为 `WNS=+22.912ns`、`TNS=0`、`WHS=+0.082ns`，没有 setup 或 hold 违例。实现资源为 `3354 LUT (6.30%)`、`2939 FF (2.76%)`、`16 RAMB18E1 (5.71%)`、`80 DSP48E1 (36.36%)`。比首次报告多出的 16 个 DSP 已明确位于 `gestureflow_mac_tile` 内部，由当前工具对归约加法路径的映射产生，**不能在未做等价验证前把它写成性能提升或退化**；后续需要在保持数值和时序的前提下单独分析是否应约束加法树的 DSP 使用。
3. 新 bitstream 已在连接的 Zynq-7020 上重新下载，Cortex-A9 裸机程序重新编译、下载并完成回读：`GESTUREFLOW_FINAL_RESULT = 0x600D600D`、`STATUS=0x00000008`、`CYCLES=0x1A06=6662`、16 路结果为 `0x400..0x40F`、mask 为 `0xFFFF`，XSCT 最终打印 `GESTUREFLOW_AXIL_BOARD_PASS`。因此同步复位加固没有改变 MAC 功能或现有基线周期。
4. **下一项正在实施的结构性改造：**新增 activation BRAM staging。PS 在任务启动前将 `tap x Cin-group` 的 4 字节 activation 写入片上 BRAM；硬件 `start` 后连续读取并向既有 64-MAC/cycle tile 发射，避免当前运行期间每个输入组都受 PS/AXI-Lite 写操作间隙限制。该阶段先保持 16x4 阵列、16 个权重 bank、INT32 本地累加和已有结果寄存器语义不变，并分别做 Verilator、完整 Vivado 实现和实板回归；成功后再以相同 staging 边界替换前端为命令 FIFO/HP0 DMA，不能直接跳到整网或继续堆 DSP。

## 39 2026-08-16 GestureFlow-NPU 16x4 AXI-Lite 基线已在 Zynq-7020 实板通过

**阅读顺序：必须先读本节；再读紧随其后的 2026-08-15 GestureFlow 架构和训练状态；更早的 7Z010、旧 3x3、历史 RVV/Coral 板测只用于追溯，绝不能覆盖本节。** 当前唯一硬件主线是项目自研 `gesture_project/innovation_npu/`，不是完整 CoralNPU/RVV 上板，也不是 Google 官方实现。`/home/steveguo/coralnpu-gesture/coralnpu` 仍是只读上游参考仓库；本轮复核提交 `7318dfc2a94c0ac081bbe1787414391aa3cd5052`、工作区为空，绝不修改。

1. **实板已通过，不是仿真或仅综合。** 使用正点原子 Zynq-7020、Windows Vivado/Vitis 2023.2、JTAG 和 PS7 `M_AXI_GP0 -> AXI-Lite`，实际下载自研位流、初始化 DDR/PS7、下载 Cortex-A9 裸机 ELF 并读回板上探针。XSCT 最终输出 `GESTUREFLOW_AXIL_BOARD_PASS`，`FINAL_RESULT=0x600D600D`。板上读回：`MAGIC=0x47464E50`、`VERSION=0x00010000`、状态 `0x00000008`（done）、结果掩码 `0x0000FFFF`，16 条 INT32 结果依次为 `0x400..0x40F`，即 `1024..1039`，与软件期望逐条一致。
2. 该板测完成的是**真实 16 输出通道 x 4 输入通道、64 个 DSP48E1 的 INT8 MAC tile** 全事务：16 个输出通道、16 个 4x4 卷积 tap、16 个输入通道组、每组 4 个 INT8 输入。权重和激活均为 `+1`，每通道 bias 是 lane 编号，因此理论结果为 `16 x 16 x 4 + lane = 1024 + lane`；验证程序逐 lane 判定，不是只看一个签名。总 MAC 数为 `16 x 16 x 16 x 4 = 16,384`。
3. 真实板上 `CYCLES=0x1A06=6662` 个 `25MHz` PL 时钟，对应本次单 tile 约 `266.48us`、约 `61.5 MMAC/s` 有效 MAC 率。这**不是 NPU 计算阵列峰值，也不是模型帧率**：计数覆盖了 PS 通过 AXI-Lite 逐字写入 256 个 activation-group 时的空档。阵列在输入连续时仍是 `64 INT8 MAC/周期`，25MHz 理论为 `1.6 GMAC/s`；本次数据证明第一版瓶颈已经明确是 AXI-Lite 控制供数，下一阶段应进入片上命令 FIFO/BRAM staging 和 HP0 DMA，而不是先继续扩大 DSP 阵列。
4. 本次完整 PS7 实现真实资源：`4741 LUT (8.91%)`、`4983 FF (4.68%)`、`16 RAMB18E1 (5.71%)`、`64 DSP48E1 (29.09%)`。25MHz 实现 `WNS=+20.842ns`、`TNS=0`、无时序违例；NPU IP 本体为 `4336 LUT / 4484 FF / 16 RAMB18 / 64 DSP`。完整报告在 `E:\coralnpu_vivado\projects\gestureflow_axil_baseline_7020_v1\logs\gestureflow_axil_7020_{utilization_hier_impl,utilization_impl,timing_impl}.rpt`，bit 文件在 `...\axi_gpio.runs\impl_1\system_wrapper.bit`，XSA 在 `...\logs\gestureflow_axil_7020.xsa`。
5. 本轮项目侧关键源码和可复现入口：
   - RTL：`gesture_project/innovation_npu/rtl/gestureflow_axil_microkernel.sv`、`gestureflow_mac_tile.sv`、`gestureflow_weight_bank.sv`。`RESULT_IDX` 已更正为“写入 lane 索引、读取 result mask”，`RESULT_DATA` 读取所选 lane 的完整 INT32 部分和。
   - 快速行为验证：`bash gesture_project/innovation_npu/tests/run_gestureflow_axil_microkernel.sh`，已通过，输出 `GESTUREFLOW_AXIL_MICROKERNEL_PASS cycles=2053 lane0=1024 lane15=1039`。这不是板测替代品，而是上板前握手/寄存器语义回归。
   - 板级工程脚本和裸机程序：`gesture_project/innovation_npu/board_7020/build_gestureflow_axil_baseline_7020.tcl`、`run_build_7020_from_wsl.sh`、`software/gestureflow_axil_smoke_main.c`、`build_software_7020_from_wsl.sh`、`scripts/run_gestureflow_axil_baseline_xsct.tcl`、`run_board_7020_from_wsl.sh`。
6. **Windows/WSL 不能遗漏的操作细节。** Vivado 工程只能放在 Windows 路径 `E:\coralnpu_vivado\projects\gestureflow_axil_baseline_7020_v1`；不能直接让 Vivado 或 XSCT 执行 `\\wsl.localhost\...` 的 Tcl。脚本由 WSL 复制到 E: 后调用。当前 Windows 把端口 `3103-3202` 保留给系统，标准 `hw_server` 端口 `3121` 不可绑定；已实际以 `E:\Xilinx\Vivado\2023.2\bin\hw_server.bat -s tcp::3333` 启动，并在 XSCT 中连接 `tcp:127.0.0.1:3333`。后续不能改回 3121，除非先重新检查 `netsh interface ipv4 show excludedportrange protocol=tcp`。
7. **已发现但没有掩盖的实现告警。** 本版可正确上板，但 Vivado 显示两类要在 DMA 前收敛的工程问题：(a) 从教程复制的 `Navigator.xdc` 仍约束已删掉的 GPIO，引发两条无效对象 Critical Warning；下次重建脚本必须像旧成功脚本一样移除该 XDC；(b) `gestureflow_mac_tile.sv` 使用异步复位的寄存器直接驱动 BRAM 地址/使能，产生 `REQP-1840`，且推断 DSP 未启用 MREG/PREG 内部寄存器，产生 DPOP 建议。由于 reset 后重新加载全部权重，本轮板测正确，但这不是最终稳定形式。下一阶段改成“控制寄存器同步复位或不复位、BRAM 不复位、地址/enable 同步化”，并在不改变计算结果的前提下增加 DSP output pipeline，随后重跑 Verilator、完整实现和实板。
8. **下一步顺序不能跳。** (1) 固化当前 bit/ELF 为可回退基线并提交项目源码；(2) 移除教程残留约束，消除 BRAM 异步控制警告，保持同一实板 PASS；(3) 用 BRAM staging/命令 FIFO 将每个 `tap x Cin-group` 的 AXI-Lite 往返移出 busy 窗口，得到一次真实吞吐提升；(4) 接 HP0 AXI DMA、真实模型权重/激活、bias/per-channel requant/ReLU/pool 和真实层逐点对账；(5) 才评估增加阵列、数据流重组或论文级创新。训练依旧按用户要求暂停，不能在硬件推进期间自行重启。

## 38 2026-08-15 训练已人工暂停，GestureFlow-NPU 定位已固定

当前 HaGRID 18 类学生训练已按用户要求在第 22 轮中断，不能把中断轮作为有效结果；此前自动保存的最佳模型和 `history.csv` 均保留在 `/tmp/hagrid_v1_500k_384p_targethand_student_4x4_rvv_distill_20260815_nocache/`。继续训练前先检查该目录、训练日志和恢复参数，不能重新从头盲训。

自研 NPU 的首版定位是“PS 下发层描述符的可编程专用手势 NPU”，不是通用 RISC-V 核。详细路线见 [GestureFlow-NPU 总体定位与论文级路线 2026-08-15](GestureFlow-NPU_总体定位与论文级路线_2026-08-15.md)。首篇成果只主张混合行驻留/输出驻留数据流、融合量化后处理、描述符调度和真实模型设计空间评估；PE 重组和稀疏跳过必须由真实测量决定，不能提前写成已实现创新。

## 37 2026-08-15 GestureFlow-NPU 首个 XC7Z020 综合闭环

**阅读顺序：先读本节；再读第 36 号记录的训练和架构边界；只有需要追溯旧实验时才读更早
章节。** 本节只记录项目自研 `gesture_project/innovation_npu/` 的真实综合结果，不能
把它写成 Google CoralNPU 官方 RTL，也不能用此结果替代后续 AXI、DDR、摄像头或实板数据。

1. 新增权重存储模块 `gesture_project/innovation_npu/rtl/gestureflow_weight_bank.sv`。每个输出通道使用一个独立同步读、同步写的权重 bank；`gestureflow_mac_tile.sv` 实例化 16 个 bank。这保留了每周期同时读取 16 个输出通道、每通道 4 个 INT8 权重的带宽。权重 RAM 不做全量复位，控制/DMA 层必须在 `start_valid` 前加载本次任务用到的所有权重。
2. 已发现并修复一个实际资源问题：最初的二维可变索引权重数组在 Vivado 中被展开为 `131072` 个触发器和约 `38634` 个 LUT6，虽有 `64` 个 DSP48E1，却不可接受。拆分 bank 后，Vivado 明确报告每个 `weight_bank` 为 Block RAM；最终合成资源为 `4089 LUT`、`3329 FF`、`16 RAMB18E1`、`64 DSP48E1`。这对应 16KiB 权重 tile，不代表整层权重永久常驻。
3. 为闭合 100MHz 时序，MAC 把四路乘积归约改为“DSP 乘积寄存器 -> 两个二项和寄存器 -> 四项和寄存器 -> INT32 本地部分和”。它增加固定流水延迟，但满流水后仍接受每周期一个 4 输入通道组，未降低 `16 x 4 = 64` INT8 MAC/周期的阵列吞吐。最终 100MHz 综合为 `WNS=+1.722ns`、`TNS=0`，所有内部时序约束通过；该顶层没有外部 I/O delay，不能把该 WNS 直接当作系统实现 WNS。
4. 真实 Vivado 产物在 Windows 可访问路径 `E:\coralnpu_vivado\projects\gestureflow_npu_7020\build\xc7z020_mac_tile\`：`utilization_synth.rpt`、`timing_synth.rpt`、`gestureflow_mac_tile_synth.dcp`。工具是 Vivado 2023.2，器件 `xc7z020clg400-1`。项目脚本为 `gesture_project/innovation_npu/vivado/run_synth_7020_from_wsl.sh`；它先复制源码到 E:，再调用 Windows Vivado，禁止用 `\\wsl.localhost\...` 直接作为 Vivado 工程或 Tcl 路径。若上一次被中止，必须确认 Windows `vivado.exe` 已退出，避免 `.cache/wt/synthesis.wdf` 锁住构建目录。
5. 本次 RTL 实测回归命令均已通过：`bash gesture_project/innovation_npu/tests/run_gestureflow_mac_tile.sh` 输出 `GESTUREFLOW_MAC_TILE_PASS`；单通道流式 4x4 输出 `GESTUREFLOW_CONV4X4_STREAM_PASS`；RGB 首层输出 `GESTUREFLOW_CONV4X4_RGB_STREAM_PASS`。随后最高优先级代码工作是**带真实跨输入通道组的 4x4 流式 wrapper**，覆盖学生网络主干的 `Cin=16/32/48`，逐点对账后才接 per-channel requant、池化、AXI/DMA。

## 36 2026-08-15 当前执行入口：18 类训练与 GestureFlow-NPU 自研硬件并行

**阅读顺序：先读本节；再读下方第 35 号记录的完整数据集、教师和学生训练状态；只在
需要追溯旧实验时再读更早章节。** 本节覆盖下方所有“停止 HaGRID”“NUS 是唯一
主线”“当前部署网络固定为 3x3”的历史表述。那些章节是可追溯实验记录，不能
恢复为当前路线。

### 0.0.1 不可违反边界

1. `/home/steveguo/coralnpu-gesture/coralnpu` 是 Google 上游只读参考仓库，已复核提交为 `7318dfc2a94c0ac081bbe1787414391aa3cd5052`。绝不修改、重置、清理或把项目工作树改动称为官方代码。
2. 所有自研源码均位于 `gesture_project/...`。本轮新增 `gesture_project/innovation_npu/`，全部文件均含 `PROJECT_LOCAL_SELF_RESEARCH_NOT_GOOGLE_OFFICIAL` 标识；它是项目自研分支，不是 CoralNPU 官方扩展。
3. 每次代码、RTL、训练或脚本修改后必须实际运行相应测试、训练、仿真或板测。超过约三分钟的任务必须放入 `tmux` 并给出日志；禁止无上限整网 RTL 仿真。
4. 当前 MPACT 的计数只能写为行为模拟器内的相对计数，不能写成 RTL 周期、FPGA 周期、帧率、功耗或实板延迟。

### 0.0.2 当前训练任务，正在运行

1. 当前静态数据是 HaGRID-v1 来源的 384p、目标手裁切、按 `user_id` 隔离的 18 类目录 `gesture_project/datasets/processed/hagrid_v1_500k_384p_targethand_subject_split_20260815/`。数量为训练 `357,740`、验证 `66,261`、独立测试 `85,311`。旧六类子集不能用于当前准确率主结论。
2. 高精度教师是 `/tmp/hagrid_v1_500k_384p_targethand_mnv3large_teacher_20260815/model.keras` 的 ImageNet 预训练 MobileNetV3Large，浮点独立测试 `84,940/85,311 = 99.5651%`。教师的全 INT8 TFLite 大小约 `3.4MB`，含深度可分离卷积和 Hard-Swish；它只作精度上限与蒸馏教师，**没有**通过当前 CoralNPU/Micro RVV 整网部署。
3. 正在运行的学生进程是 `tmux` 会话 `hagrid_v1_targethand_student_4x4_rvv_distill_20260815_nocache`，日志为 `/tmp/hagrid_v1_500k_384p_targethand_student_4x4_rvv_distill_20260815_nocache_train.log`。训练脚本为 `gesture_project/algorithms/static_cnn/train_static_cnn.py`；实际参数为 96x96、18 类、普通卷积 `4x4/4x4/4x4`、通道 `16/32/48`、1x1 头部 `64`、AdamW、初始学习率 `0.0008`、余弦调度、MixUp `0.1/0.5`、标签平滑 `0.05`、中等增强、蒸馏权重 `0.35`、温度 `3.0`、不缓存全部验证图像。禁止改回会占约 6.8GiB 验证内存的 `--cache_mode eval`。
4. 学生训练完成后必须依次做：浮点独立测试、全 INT8 `builtin_ref` 独立测试、TFLite 算子画像、512KiB MPACT 模型缓冲检查、MPACT LiteRT Micro 参考与 RVV 卷积逐字节对账、带明确时间上限的行为计数记录。任一项未完成时不得宣称模型已经部署。

### 0.0.3 新增并已验证：GestureFlow-NPU v0 自研数据流硬件

1. 目标是为连续 RGB 手势推理减少逐窗口主机控制和 DDR 往返，不是复刻完整 CoralNPU，也不是回到 7Z010 的旧 3x3 外设路线。架构为：层级描述符/DMA、输入双缓冲 SRAM、`K` 行滚动窗口、输出通道权重 tile SRAM、INT8 MAC 阵列、INT32 本地部分和、融合 bias/requant/ReLU/pooling、输出双缓冲。规则空间卷积由该引擎执行；RVV/ZVT 方向保留给控制、不规则算子、全局归约和后续动态手势时序层。
2. 官方只读源码中已实际核对的借鉴点是：标量与 RVV 解耦、VRF/队列/LSU、可选 `ZVT_ON` 路径及其 `zvt -> zvt_ctrl -> zvt_pe_array + zvt_acc` 结构。默认 ZVT 宏定义含 `NUM_ACC=16`、`NUM_BLK=4`、INT8/INT16 乘法与 INT32 加法流水；其完整 tile 指令与访存路径仍不能当作项目已经验证的卷积后端。
3. 模型评估配置为 `gesture_project/innovation_npu/configs/gestureflow_npu_v0.json`，评估器为 `gesture_project/innovation_npu/tools/evaluate_gestureflow_design.py`。它用当前学生真实层形状 `96 -> 96 -> 48 -> 48 -> 24 -> 24 -> 12` 的六个 4x4 卷积与一个 1x1 头部计算。已运行结果：卷积总 MAC `137,281,536`；`gf64`（16 输出通道 x 4 输入通道 = 64 INT8 MAC/估计周期）为 `2,181,888` 个分析周期、阵列利用率 `98.31%`；`gf32` 为 `4,363,776`。这些不是 RTL/FPGA 周期。模型在“输出通道分块但无行复用”的明确基线相对下，估算 DDR `9,483,264B -> 1,145,344B`，即 `8.28x`。估算会根据每层在“空间条带优先/输出通道 tile 优先”间选择低流量方案，且仅要求 16KiB 权重 SRAM 容纳一个 tile，**不**假称整层权重常驻。
4. 三项 RTL/Verilator 实测均已通过：
   - `rtl/gestureflow_mac_tile.sv`：权重驻留、`OUT_LANES x INPUT_LANES` INT8 乘法、一周期一输入组、INT32 本地累加。运行 `bash gesture_project/innovation_npu/tests/run_gestureflow_mac_tile.sh`，输出 `GESTUREFLOW_MAC_TILE_PASS psum=72,95,118,141`。
   - `rtl/gestureflow_line_window.sv`：参数化 K 行循环行缓存。运行 `bash gesture_project/innovation_npu/tests/run_gestureflow_line_window.sh`，在 5x6 输入、4x4 窗口下输出 6 个窗口并逐元素通过，输出 `GESTUREFLOW_LINE_WINDOW_PASS windows=6`。
   - `rtl/gestureflow_conv4x4_stream.sv`：将上述两单元接成无 ARM 逐窗口控制的流式卷积，使用 `pixel_ready` 回压，窗口后自行完成 16 次 MAC。运行 `bash gesture_project/innovation_npu/tests/run_gestureflow_conv4x4_stream.sh`，对 5x6 输入、4 输出通道、6 个 4x4 输出逐元素 PASS，输出 `GESTUREFLOW_CONV4X4_STREAM_PASS outputs=6`。
   - `rtl/gestureflow_conv4x4_rgb_stream.sv`：当前学生首层的 RGB 适配验证。三条 RGB 输入分别进入四行缓存，接入 4-lane MAC 的 lane `0..2`，lane `3` 显式掩码。运行 `bash gesture_project/innovation_npu/tests/run_gestureflow_conv4x4_rgb_stream.sh`，对含正负 INT8 RGB 值的 5x6 输入、4 输出通道、6 个 4x4 输出逐元素 PASS，输出 `GESTUREFLOW_CONV4X4_RGB_STREAM_PASS outputs=6`。
5. 已知限制必须保留：当前 RGB wrapper 完成了首层 `Cin=3` 尾 lane 掩码验证，但尚未完成后续层的跨 `Cin` 分组、输出通道 tile 轮换、AXI/DMA、实际重定标/池化、96x96 全层或整网。因此目前可称“核心数据流 RTL 功能已开始并通过 RGB 首层微基准”，**不可**称“GestureFlow-NPU 已部署完整模型”或“已达实际帧率”。
6. 下一步严格顺序：先实现跨 `Cin` 的部分和与输出通道 tile 调度；加入与 TFLite INT8 完全一致的 per-channel requant/ReLU/pool；再接命令描述符、SRAM/DMA/AXI；每个阶段用导出模型真实权重和激活逐点对账，最后才做资源、时序、MPACT/FPGA 协同评估。

## 35 2026-08-15 当前唯一静态主线：HaGRID-v1 低分辨率全类别训练主体（历史快照）

本节覆盖下方所有关于“停止 HaGRID”“NUS 为当前主线”或“六类 HaGRID 为正式基准”的旧结论。后续对话必须先读本节，旧章节只保留为已完成实验的历史证据，不能据此恢复旧路线。

1. 当前静态手势训练主数据为 HaGRID-v1 的低分辨率 `hagrid-sample-500k-384p` 归档。它覆盖 18 个类别和该归档中的全部 509,323 张 RGB 图像，禁止再使用此前 `fist/like/ok/palm/peace/stop` 六类子集作为训练主数据、准确率主结论或模型选型依据。
2. 该归档是基于 HaGRID-v1 的公开 384p 重编码训练主体，而不是原始 552,992 张、1080p、约 716GB 的原始全量文件。公开来源没有提供可直接取得的“552,992 张完整 v1 的低分辨率官方包”；报告必须准确写为“HaGRID-v1 来源的 384p 509,323 张全类别训练主体”，不能虚称原始分辨率全量。
3. 本地原始压缩包为 `gesture_project/datasets/raw/hagrid_v1_500k_384p/hagrid-sample-500k-384p.zip`，文件大小为 13,418,776,353 字节，SHA-256 为 `461ad5746eb95c3605f4fa2ba7daa19e2fcd4d7d91d4d26c7c31dfe228feb68e`。已实际执行 `unzip -t`，结果无压缩错误。原始包、处理后的图片均被 `.gitignore` 忽略，不得提交。
4. 当前项目侧人物隔离目录是 `gesture_project/datasets/processed/hagrid_v1_500k_384p_subject_split_20260815/`，所有 18 类均存在于训练、验证和独立测试三部分。图像数分别为训练 357,748、验证 66,264、测试 85,311，总计 509,323；人物数分别为 22,366、4,792、4,794。同一 `user_id` 不跨集合，处理器是项目侧 `datasets/tools/extract_hagrid_subject_split.py`，不是上游官方脚本。
5. 归档包含的 18 类是：`call`、`dislike`、`fist`、`four`、`like`、`mute`、`ok`、`one`、`palm`、`peace`、`peace_inverted`、`rock`、`stop`、`stop_inverted`、`three`、`three2`、`two_up`、`two_up_inverted`。该包不含 `no_gesture`，当前模型必须称为 18 类模型，不能声称已具备无手势拒识；产品空闲态数据需后续独立补充。
6. 已启动并持续实际运行的完整集精度教师是 ImageNet 预训练 MobileNetV3Large，输入 96x96、批大小 128、冻结 3 轮后全骨干微调，使用 AdamW、权重衰减 0.0003、标签平滑 0.05、中等增强、MixUp。输出目录为 `/tmp/hagrid_v1_500k_384p_mnv3large_teacher_20260815/`。该模型仅用于确认完整数据的可学习上限及后续蒸馏，不是最终 CoralNPU 部署模型，因为其中含深度可分离卷积。
7. 完整集教师稳定后，必须训练普通 `CONV_2D` 为主的 18 类学生模型，保持 3x3 主干、1x1 分类头以及固定输入形状；先完成独立测试浮点、全整型、逐类混淆和算子统计，才允许进行设有时间上限的 CoralNPU 行为验证。禁止恢复小时级逐周期整网仿真。

## 34 2026-08-14 历史记录：曾暂停 HaGRID、改用 NUS-II

本节优先级最高，后续对话先读本节，再读下面按日期倒序排列的历史记录。当前只推进静态手势识别，动态训练暂停。

1. 用户已明确要求不要继续训练 HaGRID。HaGRID 及其手部裁切数据只能作为历史材料和旧实验回溯，不能再启动训练、不能再写成当前静态主数据集，也不能用旧随机切分准确率和新数据集比较。
2. 当前已实际取得并验证的替代数据集是 NUS Hand Posture Dataset II。官方入口是 `https://www.ece.nus.edu.sg/stfpage/elepv/NUS-HandSet/`，本地压缩包为 `gesture_project/datasets/raw/nus_hand_posture_ii/NUS-Hand-Posture-Dataset-II.zip`，已通过 `unzip -t` 完整性检查。
3. NUS 项目侧准备脚本是 `gesture_project/datasets/tools/prepare_nus_static_subject_split.py`，处理目录是 `gesture_project/datasets/processed/nus_hand_posture_ii_subject_split_20260814/`。当前生成训练 1400 张、验证 300 张、独立测试 300 张、人物干扰测试 750 张，10 类静态手势。
4. NUS 压缩包没有独立受试者身份清单。当前划分按每类排序文件每五张重建受试者编号，必须称为“项目侧受试者划分重建”，不能称为官方人物划分。这个限制必须在所有报告中保留。
5. 已实际训练 NUS ImageNet 预训练 MobileNetV2-0.35 教师：最高验证 79.33%，独立测试 64.00%，人物干扰测试 40.67%。已实际训练普通卷积 RepVGG 风格学生：最高验证 85.67%，独立测试浮点约 60.67%，全整型测试 62.33%（187/300），人物干扰整型测试 52.40%（393/750）。验证准确率不能替代独立测试准确率。
6. 学生部署结构是 96x96 输入、普通 `CONV_2D`、通道 24/48/96/96、主要 3x3 卷积、末端 1x1 分类头。整型模型包含 8 个 `CONV_2D`、3 个 `MAX_POOL_2D`、`MEAN`、`FULLY_CONNECTED` 和 `SOFTMAX`，估算乘加量 228,261,888；没有 `DEPTHWISE_CONV_2D`，适合作为后续 CoralNPU 普通卷积映射候选，但尚未完成 CoralNPU 整网行为运行。
7. 导出器 `gesture_project/algorithms/static_cnn/export_repvgg_deploy.py` 已修复第一层干通道与第一阶段入口通道混用的问题。修复后 300 张独立测试图导出前后预测一致率为 100%，最大绝对误差约 `1.37e-6`，不得回退这个修复。
8. 已复制并允许版本控制的候选模型目录是 `gesture_project/models/nus_hand_posture_ii_repvgg_3x3_distill_20260814/`。原始数据、处理图片和其他模型仍由 `gesture_project/.gitignore` 忽略。
9. 下一步只做静态：先对 NUS 学生模型做有时间上限的逐层输入量化和输出对账，再决定是否进行一次不改变部署算子集合的蒸馏训练；通过主机 Float/INT8 门槛后，才进行有明确超时的 CoralNPU 行为验证。不要恢复动态训练，不要启动无时间上限的整网逐周期仿真。

本节与 [静态手势数据集候选与主线判定_2026-08-14.md](/home/steveguo/coralnpu-gesture/gesture_project/docs/静态手势数据集候选与主线判定_2026-08-14.md) 必须保持一致；若历史章节出现 HaGRID、NUS 或动态训练的旧主线说法，以本节为准，并在继续工作时明确它是历史记录。

## 33 2026-08-14 最新执行结果：停止 HaGRID，改用替代静态数据筛选

1. 用户已明确要求暂停动态手势，且不要继续训练 HaGRID。上一轮启动的严格人物隔离 HaGRID 教师训练已经主动终止，输出只作为历史过程文件，不得继续等待、引用或升级为当前主线。HaGRID 官方仓库和样本仍可追溯，但本阶段不再使用它训练静态产品模型。
2. 当前实际筛选出的替代数据层次为：`Sign Language Digits` 作为原生静态、量化和 CoralNPU 算子回归集；`IPN Hand` 作为真实智能家居交互语义补充；`EgoGesture` 作为待申请的 VR 第一人称静态补充。NUS-II、ASL Alphabet、LeapGestRecog、UC2017 和第三方 VR-GD 目前都因原始发布、许可、人物划分或静态性核验不足，不能直接作为正式主线。
3. IPN 静态抽取脚本为 [prepare_ipn_static_frames.py](/home/steveguo/coralnpu-gesture/gesture_project/datasets/tools/prepare_ipn_static_frames.py)，是项目侧代码，不是 IPN 官方代码。它从官方训练/验证标注的完整视频中取中间帧，按完整视频目录固定留出测试，禁止同一视频跨集合。五类试验 `D0X/B0A/B0B/G01/G02` 的独立测试为 `68.62%`，逐类为 `96.36%/68.89%/36.76%/11.11%/14.81%`；点击类别不能单帧判定。收缩为 `D0X/B0A/B0B` 后独立测试为 `44.81%`，因此 IPN 目前只能是应用补充，不能包装成静态最终模型。
4. Sign Language Digits 目录为 `gesture_project/datasets/processed/sign_language_digits/`，共 10 类；项目侧普通 `RepVGG-3x3` 从零训练实际得到验证 `9.87%`、测试 `10.00%`，明确失败。相同数据的 ImageNet 预训练 `MobileNetV2-0.35` 教师实际得到验证 `79.61%`、测试 `80.00%`，说明数据可以学习，但小型普通卷积从零训练配方不够可靠。两项结果都不是智能家居产品准确率，不能和 IPN 或历史 HaGRID 数字混报。
5. 当前静态下一步：先以 Sign Language Digits 教师结果作为软件流程诊断，继续做其整型量化和算子统计；同时不恢复动态训练。若要形成真正产品主线，必须取得更符合场景的静态数据或由项目组采集跨人物、跨距离、跨背景、含无手势的真实家居静态数据。没有这一层，不能宣称“静态手势已经完成”。
6. 用户要求每次改动必须实际运行；本轮已实际执行：停止 HaGRID、抽取 IPN 五类和三类数据、运行两次 IPN 静态三点三训练、运行 Sign Language Digits 三点三训练、运行 Sign Language Digits 预训练教师训练、逐类混淆分析、`py_compile`、`git diff --check`。官方只读仓库 `/home/steveguo/coralnpu-gesture/coralnpu` 状态仍为空，不能修改。

## 32 2026-08-14 最新执行结果：暂停动态，静态数据主线重建

1. 用户已明确要求先完成静态手势识别，当前动态 IPN 训练已经停止，不得继续等待、续跑或把动态结果当作静态结果。本轮动态预训练上限实验在停止前只得到验证 `14.66%`，不作为模型结论。
2. 当前静态数据判定文档为[静态手势数据集候选与主线判定 2026-08-14](/home/steveguo/coralnpu-gesture/gesture_project/docs/静态手势数据集候选与主线判定_2026-08-14.md)，必须先读。它明确区分了已取得、已核验未取得和不推荐数据，不能把旧对话里的推荐当成已下载事实。
3. 当前静态公开主基准重新采用 HaGRID 样本的**人物隔离版本**，不再把旧的按图片随机切分目录当成严格泛化基准。新目录为 `gesture_project/datasets/processed/hagrid_subject_static_6cls_20260814/`，已经实际生成：训练 `15,000` 张、验证 `6,819` 张、测试 `6,623` 张，六类为 `fist/like/ok/palm/peace/stop`，三部分按 `user_id` 互不交叉。
4. 新数据生成脚本为[extract_hagrid_subject_split.py](/home/steveguo/coralnpu-gesture/gesture_project/datasets/tools/extract_hagrid_subject_split.py)，已实际运行并通过 `py_compile`。旧脚本 `extract_hagrid_sample_subset.py` 的随机图片切分保留为历史工具，不得用于新的准确率结论。
5. 已在新人物隔离基准上实际运行预训练 `MobileNetV2-0.35` 冻结骨干三轮，验证准确率 `25.38%`、测试准确率 `26.15%`。这是精度参考回归，不是最终硬件主线；旧随机切分高准确率与本结果不可直接比较。
6. 当前下一步只做静态：在同一人物隔离数据上训练普通 `3x3` 卷积硬件候选，并和预训练参考进行完整浮点、整型量化和算子统计比较；暂不启动动态训练、长时间 MPACT 或 RTL 仿真。`/home/steveguo/coralnpu-gesture/coralnpu` 仍为官方只读参考仓库，绝对不能修改。
7. 静态真实回归已继续完成：预训练 `MobileNetV2-0.35` 冻结骨干三轮得到验证 `25.38%`、测试 `26.15%`；项目侧普通三点三卷积 `RepVGG-3x3`（通道 `16/48/80`，五轮）最高验证 `19.33%`、测试 `18.57%`。这两项都只是严格人物隔离基准的短训练结果，不是最终准确率；它们说明后续应先训练可靠的静态教师，再做保持普通卷积部署形态的蒸馏或迁移，不能继续盲目堆硬件结构。

## 31 2026-08-14 最新执行结果：IPN 数据线读取与硬件协同时序模型训练入口

### 0.1 先读本节，再读下方数据集重选章节

1. 当前产品数据主线已经从 HAGRID 六类静态原图切换为：IPN Hand 智能家居连续 RGB、EgoGesture 第一人称 VR RGB-D，以及由这两条视频线抽取的静态命令子任务。HAGRID 只保留为历史回归，不得继续作为新产品训练主线；EgoGesture 尚未取得数据，不能声称已下载。
2. Google 官方只读参考目录仍是 `/home/steveguo/coralnpu-gesture/coralnpu`，不得修改。当前新增的模型、读取器、训练器和测试均位于 `gesture_project/algorithms/temporal_cnn/`，是项目侧创新工作，不是 CoralNPU 官方模型或官方实现。
3. 本轮已修复 `gesture_temporal_model.py` 的模型摘要错误：Keras 3 对 `TimeDistributed` 内部卷积层不稳定地提供 `.input`，摘要现在从已构建卷积核的第三维读取输入通道数。该修改已实际运行，不依赖内部输入张量。
4. 模型冒烟测试已实际通过：输入为 `2x8x96x96x3`，输出为 `2x14`；所有可训练参数均得到梯度；一次优化步骤确实改变权重；浮点 TFLite 转换成功，模型字节数 `506,588`；算子摘要确认空间结构为 `3x3、4x4、4x4、1x1`，时间融合为 `1x1`。这些是结构和转换结果，不是准确率。

### 0.2 当前项目侧模型、数据读取和训练配置

1. 模型文件为 [gesture_temporal_model.py](/home/steveguo/coralnpu-gesture/gesture_project/algorithms/temporal_cnn/gesture_temporal_model.py)，名称为 `gesture_temporal_shift_cnn`。默认输入是固定 `8` 帧、每帧 `96x96x3`，类别数 `14`；空间通道为 `16/48/80`，时间嵌入为 `96`。每帧共享二维卷积，经过零乘法时间移位，再做时间均值、最大值和首末帧有符号差分，最后用 `1x1` 时间融合和小型分类层输出类别。
2. 该结构的硬件协同意图是明确的：空间计算落在 CoralNPU 已有二维 INT8 卷积与 RVV 向量乘累加路径；时间移位只需片上数据移动；时间统计可以用向量归约；`288->96` 时间融合和末端分类层是后续矩阵/VME候选。它是项目创新候选，不能把“适合后续硬件”写成“已经完成硬件加速”。
3. 数据读取文件为 [ipn_hand_sequence.py](/home/steveguo/coralnpu-gesture/gesture_project/algorithms/temporal_cnn/ipn_hand_sequence.py)。它读取项目侧 `train.jsonl/val.jsonl`，按 IPN 官方帧命名 `目录名_六位帧号.jpg` 找图，训练随机取连续窗口，验证取中心窗口；默认窗口为 `8` 帧、步长 `2`。设置 `sequence_length=1` 即可建立静态稳定帧输入，不需要另造一套网络。
4. 训练入口为 [train_ipn_temporal.py](/home/steveguo/coralnpu-gesture/gesture_project/algorithms/temporal_cnn/train_ipn_temporal.py)。它保留 IPN 的 `14` 类，包括非手势；默认最多 `60` 轮、验证准确率早停耐心 `10`、AdamW 学习率 `3e-4`、权重衰减 `8e-4`，并按训练清单类别数量计算类别权重。它在输入目录不存在时主动报错，禁止静默退回 HAGRID。
5. 本轮训练入口的实际一轮集成测试已通过：使用临时生成的符合官方命名规则的 RGB 帧，完成 JSONL读取、窗口缩放、动态批处理、模型前向、反向、验证、最佳权重保存和训练摘要保存。测试只证明软件链路，不产生或宣称真实准确率。
6. 2026-08-14 已使用 `git -c http.proxy= -c https.proxy= clone --depth 1 https://github.com/GibranBenitez/IPN-hand.git gesture_project/datasets/raw/ipn_hand_annotations_direct` 实际取得上游标注仓库，并重新运行清单转换器。由于项目全局 Git 代理仍是 `http://127.0.0.1:7897` 且当前端口拒绝连接，普通 `git clone` 会失败；后续在本 WSL 环境下载 GitHub 内容时必须显式使用 `git -c http.proxy= -c https.proxy=`，或确认宿主桥接代理已恢复后再使用。`datasets/raw/` 与 `datasets/processed/` 当前按忽略规则不纳入项目提交。

### 0.3 当前真实阻塞与下一步

1. 本机当前没有 IPN Hand 的视频或拆帧目录；已生成但尚未进行帧存在性校验的项目清单位于被忽略的 `gesture_project/datasets/processed/ipn_hand_rgb14_manifest/`。当前上游标注统计为：训练 `4,039` 段/`588,281` 标注帧，验证 `1,480` 段/`212,183` 标注帧。不得把临时测试或旧 HAGRID 指标写成 IPN 结果。
2. 下一步先取得 IPN RGB 数据并放在被忽略的 `gesture_project/datasets/raw/ipn_hand/`，运行 [prepare_ipn_hand_manifests.py](/home/steveguo/coralnpu-gesture/gesture_project/datasets/tools/prepare_ipn_hand_manifests.py) 时必须带 `--frames_root`，让脚本逐条确认帧目录存在；之后先统计片段长度与类别分布，再启动有上限的真实训练。
3. 真实训练先跑动态 `8` 帧/步长 `2`，再跑静态 `1` 帧稳定帧对照；两者分别报告 Float、全整型量化、连续触发误报/漏报和端到端窗口延迟。只有主机端新模型通过准确率与量化门槛，才允许进行有 `120` 秒上限的 CoralNPU 行为验证，不启动小时级整网仿真。
4. 每次后续改动必须实际运行相应训练、导出、量化、行为验证或板测之一；本节的临时合成测试不能代替真实数据结果。每次结束前检查 `git diff --check`、`git -C coralnpu status --short` 和官方提交号，确认官方只读目录没有变化。

## 30 2026-08-14 最新唯一入口：暂停 HAGRID，重选面向智能家居和 VR 的数据

1. 用户已明确要求暂时放弃当前 HAGRID 六类静态原图主线。不要继续训练 HAGRID，不要继续运行此前未完成的四乘四辅助支路实验，也不要把 HAGRID 的准确率继续当作产品主线。HAGRID 及其手部裁切版本仅保留为历史复现材料。
2. 新任务拆成三个不能混写的基准：IPN Hand 负责智能家居连续 RGB 控制；EgoGesture 负责头戴第一人称 VR RGB-D 控制；静态命令从两条视频线的稳定帧建立与命令词表一致的子任务，并用独立留人的真实家居测试集做最终产品验证。
3. 已直接阅读并核验 EgoGesture 官方页面：50 名受试者、2,081 个 RGB-D 视频、24,161 个手势片段、83 类静态或动态手势、2,953,224 帧；头戴 Intel RealSense SR300，官方跨受试者训练/验证/测试片段数为 14,416/4,768/4,977。原始视频约 46GB，320x240 拆帧约 32GB；数据仅研究教育用途，需要签署协议后获取，当前不得声称已下载。
4. 已直接核验 IPN Hand 上游代码和标注入口：`https://github.com/GibranBenitez/IPN-hand`。其官方标注仓库提供 `classIndAll.txt`、`trainlistall.txt` 和 `vallistall.txt`，没有 `testlistall.txt`。实际下载并转换结果为 14 类、训练 4,039 段/588,281 标注帧、验证 1,480 段/212,183 标注帧；当前只取得标注，没有取得视频或帧数据，不得写成数据已完整下载。
5. 项目侧新增 [prepare_ipn_hand_manifests.py](/home/steveguo/coralnpu-gesture/gesture_project/datasets/tools/prepare_ipn_hand_manifests.py)，实际运行已通过。它只生成 `train.jsonl`、`val.jsonl`；只有用户准备好独立留人的四列标注文件后，才允许用 `--test_annotation` 生成 `test.jsonl`。不得把 IPN `val` 改名为 `test`，不得按视频片段随机拆分造成同一受试者或长视频泄漏。
6. 下一步只能按 [数据集重选与产品任务定义_2026-08-14.md](/home/steveguo/coralnpu-gesture/gesture_project/docs/数据集重选与产品任务定义_2026-08-14.md) 推进：先取得 IPN RGB 数据并验证帧目录，再建立固定窗口流式读取；先训练“二维逐帧卷积骨干 + 轻量时间头”的 14 类动态基线；EgoGesture 走独立协议和独立报告。MPACT 和 RTL 仿真必须等新模型完成主机 Float/INT8 验收后再做，不得长时间空跑。

## 29 2026-08-12 最新唯一执行入口：蒸馏完成、受控淘汰与下一项训练

### 0.1 必读顺序与不可违反边界

1. 先读本节的实测结论；再读紧随其后的“数据、模型与量化的实测归因”；只有需要追溯官方 RVV `4x4` 行为时，才读下方 `2026-08-11` 的官方行为核验。更早的 7020、VME、3x3 专用硬件记录只作历史证据，不能覆盖本节的模型搜索规则。
2. `/home/steveguo/coralnpu-gesture/coralnpu` 是 Google 上游只读参考仓库。本轮复核为提交 `7318dfc2a94c0ac081bbe1787414391aa3cd5052`，`git -C coralnpu status --short` 为空。所有训练、导出、量化和行为模拟改动均只能在 `gesture_project/...` 中进行，项目侧代码不得称为 Google 官方实现。
3. 正式排名只使用原图 HAGRID 六类数据集 `gesture_project/datasets/processed/hagrid_sample_static_6cls`，固定训练/验证/测试数量为 `10,500 / 2,250 / 2,250`，固定类别顺序为 `fist, like, ok, palm, peace, stop`。手部裁切数据属于“先检测或裁切再分类”的另一系统，禁止与本单图分类结果混排。
4. 现主线仍为 `gesture_project/models/repvgg_hybrid344_c16_48_80_h112_noidentity_pairedseed20260811_hagrid6_20260812`：部署卷积 `3x3 / 4x4 / 4x4 / 1x1`、通道 `16 / 48 / 80 / 112`、INT8 模型 `244,040` 字节、卷积 MAC `234,123,264`。原图完整测试为 Float `87.64% (1972/2250)`、INT8 `87.82% (1976/2250)`；新候选仅当完整 INT8 测试不低于 `87.82%` 才有资格替代它。

### 0.2 已完成：训练期知识蒸馏没有替代主线

1. 已完整执行的目录是 `gesture_project/models/repvgg_hybrid344_c16_48_80_h112_noidentity_distill3x3a35t2_pairedseed20260811_hagrid6_20260812`。它保持学生部署图、通道、MAC、量化代表集和随机种子不变；唯一训练变量是加载同类别顺序、同 `96x96x3` 输入的项目侧高精度 `3x3` RepVGG 教师，在训练期加入软分类分布蒸馏，权重 `alpha=0.35`、温度 `2.0`。教师不进入导出模型，因此不增加部署参数、算子、DDR 流量或 CoralNPU RVV 调度开销。
2. 已实际训练完整 `120` 轮，最佳验证为第 `103` 轮 `84.09%`；末轮训练/验证为 `98.73% / 83.73%`。训练准确率与验证准确率仍存在约 `15` 个百分点差距，证明蒸馏改善了部分验证上限，但没有消除该小型 `4x4` 学生的过拟合。
3. 已实际完成折叠部署导出、原图 `2,250` 张独立 Float 测试、固定 `300` 张训练图代表集全 INT8 量化、原图 `2,250` 张完整 INT8 测试和 TFLite 算子/MAC画像。结果为 Float `87.42% (1967/2250)`、INT8 `87.64% (1972/2250)`，INT8 模型仍为 `244,040` 字节、卷积 MAC 仍为 `234,123,264`。部署图仍为两层 `4x4` 主体卷积，输入通道按 4 对齐、输出通道按 16 对齐，硬件适配形状没有退化。
4. INT8 结果比现主线低 `0.18` 个百分点（少 `4` 张正确），因此该候选**明确不替代主线，且禁止运行整网 MPACT**。它只能作为“保持硬件代价不变时，当前蒸馏配方未达标”的已验收反例。不能把其较高训练期验证峰值或个别类别改善误写成整体准确率提升。
5. 本轮对训练器的项目侧修复已做实际训练回归：自定义蒸馏训练器使用 `tf.keras.utils.unpack_x_y_sample_weight` 兼容 Keras 3 数据结构，并为 `EarlyStopping(monitor="val_accuracy")` 显式指定 `mode="max"`。该逻辑只影响训练期，且均有 `PROJECT_LOCAL_MOD` 标记；部署模型是单独保存的学生模型。

### 0.3 下一项唯一实验与时间纪律

1. 历史目录 `gesture_project/models/repvgg_hybrid344_c16_48_80_h112_noidentity_mixup_pairedseed20260811_hagrid6_20260812` 只有中途中断的 `history.csv` 和训练态模型，缺失完整日志、训练摘要、折叠部署、Float/INT8测试与算子画像，**不是有效候选，也不能用于任何结论或复用其权重**。
2. 已完成本轮正式低强度 MixUp 目录 `gesture_project/models/repvgg_hybrid344_c16_48_80_h112_noidentity_mixup_a10p50_pairedseed20260811_hagrid6_20260812`。它与主线保持相同部署图、`16/48/80/112` 通道、`3x3/4x4/4x4/1x1` 核序列、`234,123,264` MAC、`244,040` 字节模型、优化器、学习率日程、light 增强、Dropout、权重衰减、标签平滑和量化代表集；唯一变量是每批概率 `0.50`、Beta 参数 `0.10` 的训练期图像/标签混合。
3. 为避免无效长训，在开始前定义了第 `35` 轮观察门槛：最佳验证准确率须达到 `80%` 才继续。实际第 `35` 轮最佳验证仅 `75.38%`，故按预设规则停止，而非让其无边界运行。自动保存的最佳验证权重已实际完成折叠部署、原图 `2,250` 张 Float、300 张代表集 INT8和原图 `2,250` 张 INT8验收：Float `81.60% (1836/2250)`、INT8 `81.29% (1829/2250)`。它比主线 INT8低 `6.53` 个百分点，明确淘汰，禁止运行 MPACT。MixUp虽然使 `like` 类达到 `93.33%`，却严重损伤 `fist`、`palm`、`stop`，因此不能以单类提升掩盖整体退化。
4. 下一步不能再次盲调全局增强、权重衰减、标签平滑、MixUp强度或通道数。应先清点项目内已有的“RepVGG identity 分支是否启用”实验与部署图：训练期 identity 分支可在导出时折叠进同一个空间卷积，若未经实测，它是唯一值得优先验证的结构变量，因为可能改善优化/泛化而不增加部署算子、MAC、模型大小或破坏当前 RVV `4x4` 形状。若已有完整验收结果，则直接复用结论，禁止重复训练。
5. 模型搜索阶段禁止无上限 MPACT 或 RTL 仿真；只有完整 INT8 测试达到 `87.82%`，才可执行一次 `timeout 120s` 上限的 Micro reference 与 RVV 对账。低于门槛立即淘汰。每次项目侧改动后必须实际运行训练、导出、推理、量化、仿真或板测之一。训练前确认没有并行GPU任务；训练期最大 `120` 轮且带验证早停，不得启动没有停止条件的长任务。每次结束后运行 `git diff --check`、`git -C coralnpu status --short` 和 `git -C coralnpu rev-parse HEAD`。

## 28 2026-08-12 最新唯一执行入口：数据、模型与量化的实测归因

### 0.1 先读结论，再继续训练

1. Google 上游只读参考仓库是 `/home/steveguo/coralnpu-gesture/coralnpu`。本次复核提交为 `7318dfc2a94c0ac081bbe1787414391aa3cd5052`，`git -C coralnpu status --short` 为空。不得修改该目录；训练脚本、模型和行为模拟工作树均是项目侧内容，不能称作 Google 原生实现。
2. 正式准确率只比较原图 HAGRID 六类数据集 `gesture_project/datasets/processed/hagrid_sample_static_6cls`：训练、验证、测试各为 `10,500 / 2,250 / 2,250` 张，类别顺序固定为 `fist, like, ok, palm, peace, stop`。手部裁切数据是另一条“检测或裁切后分类”链路，禁止混入此处单模型排名。
3. 数据集不是整体不可学习的根因。同一原图数据、同一测试划分上，非当前硬件结构约束的 3x3 RepVGG 已实测为 Float `89.47% (2013/2250)`、全 INT8 `89.02% (2003/2250)`。因此不能再以“数据本身不行”解释 4x4 硬件协同候选的较低成绩。
4. 现阶段最强的硬件协同候选仍是 `gesture_project/models/repvgg_hybrid344_c16_48_80_h112_noidentity_pairedseed20260811_hagrid6_20260812`：折叠部署卷积为 `3x3 / 4x4 / 4x4 / 1x1`，通道为 `16 / 48 / 80 / 112`，INT8 模型约 `244,040` 字节、卷积 MAC 为 `234,123,264`，原图测试为 Float `87.64% (1972/2250)`、INT8 `87.82% (1976/2250)`。这是当前硬件协同主线，替代门槛就是全 INT8 测试不低于 `87.82%`。
5. 量化不是当前主要瓶颈。上项 INT8 相对 Float 为 `+0.18` 个百分点；本次失败对照也只有 Float `84.84% (1909/2250)` 到 INT8 `84.31% (1897/2250)` 的 `-0.53` 个百分点变化。后续不能把训练泛化差错归因给 INT8。

### 0.2 本次受控反例，已经完整运行并明确淘汰

本次实际完成目录 `gesture_project/models/repvgg_hybrid344_c16_48_96_h112_mediumwd8e4_ls5e2_pairedseed20260812_hagrid6_20260812`，不是未验收草稿。训练命令使用：`16/48/96` 通道、`3x3/4x4/4x4/1x1`、每空间阶段一个 RepVGG 单元、禁用恒等分支、Dropout `0.30`、AdamW、权重衰减 `0.0008`、标签平滑 `0.05`、正确单位的 medium 增强（平移正负 `8%`、旋转正负 `12` 度、缩放 `-12%` 到 `+8%`、对比度 `0.15`）、早停耐心 `10`。这同时检验了“加大模型、加大正则、加大增强”的组合，不能误写成只检验某一个参数。

1. 实际训练在第 `43` 轮结束，最佳验证准确率为第 `33` 轮的 `80.80%`；末轮训练/验证为 `92.13% / 79.33%`。即使使用更强正则，后段仍出现训练继续升高而验证不再提升的过拟合；同时最佳验证也低于当前主线的训练期水平，说明该组合还引入了欠拟合或优化变慢。
2. 已实际导出折叠部署模型、跑完原图 `2,250` 张 Float 评估、用 `300` 张训练图代表集完成全 INT8 量化、跑完原图 `2,250` 张 INT8 评估并解析 TFLite 算子。折叠前后 Float 一致为 `84.84% (1909/2250)`，证明折叠逻辑无额外退化；INT8 为 `84.31% (1897/2250)`，低于主线 `3.51` 个百分点，故本候选明确淘汰，**禁止运行整网 MPACT**。
3. 解析的 INT8 模型卷积 MAC 为 `267,411,456`，也比现主线增加约 `14.2%`，却没有提高准确率。因此 `80 -> 96` 不能作为当前硬件协同路线的有效结构升级。

### 0.3 已完成的逐图错误归因与下一轮唯一变量

1. 已对当前 3x3 准确率参考模型与 `16/48/80` 硬件协同主线完整 INT8 预测逐图比对：前者错误 `247` 张，后者错误 `274` 张；共同错误 `160` 张，硬件协同模型独有错误 `114` 张，3x3 模型独有错误 `87` 张。共同错误多为原图复杂背景、模糊姿态和类别边界样本，不能用单一调参解决。
2. 硬件协同模型的额外混淆集中在局部手形相近类别，例如 `like -> fist`、`stop -> fist`、`ok -> like`、`palm -> ok`、`peace -> fist`。因此后续应优先以现实范围的几何与成像扰动提升局部手形泛化，而不是继续增加 4x4 通道数或叠加多种强正则。
3. 已完成“只改变 realistic 增强”的第二个受控反例。有效目录为 `gesture_project/models/repvgg_hybrid344_c16_48_80_h112_noidentity_realistic_pairedseed20260811_retry20260812`；它保持主线 `16/48/80/112`、`3x3/4x4/4x4/1x1`、Dropout `0.30`、权重衰减 `0.0002`、标签平滑 `0.02`、相同优化器/学习率/随机种子、无 MixUp 和相同部署 MAC，只将历史 light 增强替换为项目侧 realistic 增强：平移正负 `6%`、旋转正负 `8` 度、缩放 `-8%` 到 `+6%`、对比度 `0.10`。为避免无效长训，在第 `60` 轮观察上限人工停止，训练过程中持续保存的最佳验证检查点为 `82.00%`。折叠部署后已完整运行 Float、300 张代表集 INT8 量化、INT8 全测试集和算子画像：Float 与 INT8 均为 `85.47% (1923/2250)`，INT8 模型 `244,040` 字节，卷积 MAC `234,123,264`。它比 `16/48/96` 强正则反例高，但仍低于主线 `87.82%`，因此明确淘汰，禁止运行 MPACT。
4. 已完成“增加一个高分辨率局部 3x3 单元”的第三个受控反例。有效目录为 `gesture_project/models/repvgg_hybrid344_c16_48_80_h112_noidentity_stage1x2_pairedseed20260811_foreground20260812`：只把部署单元数由 `1/1/1/0` 改为 `2/1/1/0`，即在 `96x96、16` 通道阶段增加一个训练后折叠为普通 3x3 卷积的 RepVGG 单元；其余结构、通道、优化器、随机种子、轻增强、正则、标签平滑均保持主线一致。训练到第 `30` 轮的短观察上限后人为停止，最佳验证准确率仅 `77.11%`。已实际完成折叠 Float、300 张代表集 INT8、INT8 全测试集和算子画像：Float `82.00% (1845/2250)`、INT8 `81.78% (1840/2250)`、INT8 模型 `247,448` 字节、卷积 MAC `255,356,928`。实际 MAC 与预估的 `234,123,264 + 21,233,664` 一致；该改动既增加 `9.1%` 计算，又使 INT8 准确率比主线低 `6.04` 个百分点，明确淘汰，不运行 MPACT。
5. 现阶段可归因结论是：扩大增强、增加通道和直接增加局部卷积容量都没有解决硬件协同模型与 3x3 高准确率模型之间的差距；下一轮不得再次盲调旋转、平移、Dropout、权重衰减、标签平滑、通道或 RepVGG 单元数。下一条高价值路线应保持当前 `16/48/80`、`3x3/4x4/4x4/1x1` 的学生部署图完全不变，以已验收 3x3 RepVGG（Float `89.47%`、INT8 `89.02%`）为只读教师，在训练期添加软分类分布蒸馏损失。这样不增加部署算子、MAC、模型大小或 CoralNPU RVV 适配风险，目标是把教师对相似类别的区分信息迁移给 4x4 学生。实施前必须先完成：教师/学生输入和类别顺序对齐检查、一个固定批次的前向/反向蒸馏损失下降检查、未训练学生输出不变检查；之后才允许一次完整训练和同样的 Float/INT8 验收。
5. realistic 的第一次后台启动曾在第 0 轮前被 WSL 全局内存压力杀死，未产生训练历史且不属于训练结果。根因是闲置 Bazel Java 服务仍占约 `867MB`，同时系统 swap 已被大量占用；使用 `bazel --output_base=/tmp/bazel-coralnpu-gesture-3x3-batch shutdown` 释放后可用内存恢复约 `9.7GB`，前台重试训练正常完成至人工观察上限。后续启动 GPU 训练前应先关闭闲置 Bazel 服务、确认 `free -h`，避免把系统杀进程误写成算法失败。

### 0.4 时间纪律

1. 模型搜索阶段不运行没有时间上限的整网 MPACT 或 RTL 仿真。MPACT 是官方 Python 绑定 C++ 行为模拟器，适合 ELF、LiteRT Micro 与 RVV 行为一致性，不是 RTL 周期或 FPGA 性能估算器；只有候选通过主机侧 Float/INT8 门槛后，才允许进行一次 `timeout 120s` 的 Micro reference 与 RVV 对账。
2. 每次训练或代码修改后必须运行对应的训练、导出、推理、量化、仿真或板测之一，不能仅写文档。所有项目侧新增逻辑应保留 `PROJECT_LOCAL_MOD` 标识；对官方只读仓库只可读取、比较和引用。

## 27 2026-08-12 当前唯一执行入口：过拟合纠正、量化结论与受控训练

### 0.1 必须先区分的事实

1. Google 上游只读参考仓库仍是 `/home/steveguo/coralnpu-gesture/coralnpu`，本轮复核提交为 `7318dfc2a94c0ac081bbe1787414391aa3cd5052`，工作区为空。所有下述模型、脚本、训练记录均是项目侧 `gesture_project/...` 内容；不得修改、覆盖或将项目工作树改动称为上游实现。
2. 正式准确率比较仍只使用原图 HAGRID 六类数据集 `gesture_project/datasets/processed/hagrid_sample_static_6cls`，训练/验证/测试为 `10,500/2,250/2,250`，类别顺序为 `fist, like, ok, palm, peace, stop`。手部裁切数据是另一个“先检测再分类”系统，不得混入单图模型排名。
3. 当前最强硬件协同候选是 `gesture_project/models/repvgg_hybrid344_c16_48_80_h112_noidentity_pairedseed20260811_hagrid6_20260812`。其部署卷积固定为 `3x3 / 4x4 / 4x4 / 1x1`、通道固定为 `16 / 48 / 80 / 112`、卷积 MAC 为 `234,123,264`，保持了后两空间阶段对当前上游 RVV `4x4` 优化路径的满向量通道条件。部署态原图完整测试为 Float `87.64% (1972/2250)`、全 INT8 `87.82% (1976/2250)`，INT8 比 Float 高 `0.18` 个百分点。因此当前瓶颈是**训练泛化/过拟合，不是量化精度崩溃**。
4. 上项训练后段确有过拟合：第 82 轮出现最佳验证准确率约 `83.64%`，而第 107 轮训练准确率约 `99.05%`、验证准确率约 `83.78%`，继续训练不会提高已保存的最佳检查点。`model.keras` 是按验证准确率保存的最佳权重，不是被人工中止时的末轮权重。
5. 上项尚未取得整网 MPACT PASS：新模型的 TFLite Micro 参考整网运行已经构建并真实启动，但设置 `timeout 120s` 后未结束，故不得写成“MPACT 已通过”。旧 plain hybrid `16/48/80` 的 MPACT PASS 仍然有效，不能借用到本项 RepVGG 候选。

### 0.2 已排除的错误训练路径

1. `gesture_project/models/repvgg_hybrid344_c16_48_80_h112_noidentity_fullaug_pairedseed20260811_hagrid6_20260812` 是一次已停止的负面对照，不能部署或量化。其“full”配方中的 `RandomRotation(0.08)` 由 Keras 按完整一周的比例解释，实际是约正负 `28.8` 度，而不是正负 `0.08` 度；第 14 轮验证准确率仅 `33.38%`，同随机种子的轻增强对照第 14 轮为 `45.96%`。这说明对本原图手势任务，过强旋转会破坏有效手势外形，不能把这种训练当作泛化优化。
2. 项目训练脚本 `gesture_project/algorithms/static_cnn/train_static_cnn.py` 已新增 `realistic` 增强档位，并使用 `8.0 / 360.0` 明确表达约正负 `8` 度旋转；它与历史 `light/full` 分离，保证过去实验可复现。该修改已运行 `py_compile` 和 CPU 上实际模型前向，输出形状为 `(2, 6)`、两张图片 Softmax 概率和为 `2.0`。项目诊断脚本也补齐了 RepVGG 新增参数，三个候选均已实测两步反向传播损失下降、权重更新，不能把诊断脚本此前的参数遗漏误判为模型故障。

### 0.3 历史未完成 MixUp 记录与验收纪律

1. 这里记录的 `gesture_project/models/repvgg_hybrid344_c16_48_80_h112_noidentity_mixup_pairedseed20260811_hagrid6_20260812` 曾运行至中途，但缺失正式训练日志、训练摘要、部署导出、Float/INT8完整测试和算子画像；它不是已验收实验，也不得作为“MixUp 已验证”的证据。
2. 有效 MixUp 训练必须使用新目录，从主线初始化条件重新开始，完整保留命令、日志、摘要、部署模型、Float评估、INT8模型、INT8评估及算子画像。具体后续规则以本文件开头 `2026-08-12 最新唯一执行入口：蒸馏完成、受控淘汰与下一项训练` 为准。

## 26 2026-08-11 当前唯一执行入口：官方 4x4 行为核验、模型训练规则与在跑候选

### 0.1 必读顺序和不可违反的边界

1. 先读本节，再读下一节“原图 HAGRID 纯 4x4 候选的完整训练、INT8 验收与判定”，然后读“最优 RepVGG 的 MPACT 部署边界、全连接量化修复与时间纪律”。下方日期更早的 7020、FZ3A、VME、3x3 专用硬件记录是历史证据，不得反向替代本节的模型搜索规则。
2. `/home/steveguo/coralnpu-gesture/coralnpu` 是 Google 上游只读参考仓库。本轮复核提交为 `7318dfc2a94c0ac081bbe1787414391aa3cd5052`，`git -C coralnpu status --short` 为空。所有项目侧改动仅允许位于 `gesture_project/...`；工作树 `gesture_project/worktrees/coralnpu-upstream-sim` 中存在历史项目改动，不能称为上游代码，也不得清理或覆盖。
3. 正式准确率比较只使用原图 HAGRID 六类数据集 `gesture_project/datasets/processed/hagrid_sample_static_6cls`，训练、验证、测试集数量分别为 `10,500/2,250/2,250`。手部裁切数据和图像加关键点融合结果是独立系统，禁止和本表单图像模型混排。
4. 模型搜索不运行无上限整网仿真。MPACT 是官方 Python 绑定的 C++ 行为模拟器，其 `mcycle` 为模拟器行为计数，不是 RTL 或 FPGA 周期；整网 MPACT 必须有 `120` 秒上限。RTL 只可用于明确输入、黄金输出和周期上限的微基准。

### 0.2 本轮已完成的官方 4x4 行为核验

1. 在项目工作树 `/home/steveguo/coralnpu-gesture/gesture_project/worktrees/coralnpu-upstream-sim` 中，先核对 `tests/cocotb/tutorial/tfmicro/npusim_conv2d.py` 和 `sw/opt/litert-micro/conv.cc` 相对工作树基线均无项目差异，再执行 `bazel-bin/tests/cocotb/tutorial/tfmicro/npusim_conv2d`。该测试来自上游同路径，实际以随机 INT8 输入、权重和偏置分别运行 RVV 优化卷积与参考卷积，并逐元素断言相等；退出码为 `0`。
2. 五组真实 `4x4` 行为结果为：`16->1`：参考/优化计数 `33,909/7,087`；`16->16`：`479,578/73,196`；`16->16`、步长 2、输出 `8x8`：`2,635,827/310,468`；`48->5`：`1,939,296/285,615`；`21->16`：`110,577/41,443`。这些数值仅用于说明同一模拟器内的指令路径差异，不能写为时钟周期、帧率或 FPGA 性能。
3. 对只读上游 `coralnpu/sw/opt/litert-micro/conv.cc` 的 `ConvPrepare`、`ConvPerChannel` 和 `Conv_4x4_OCVectorized` 已逐行复核：`4x4`、输入通道为 4 的倍数、输出通道不超过 256 且重排缓冲成功时进入输出通道向量化主路径；该路径以 `e32,m4` 一次容纳最多 16 个 INT32 输出通道，按 4 个相邻空间位置展开，内层输入通道按 4 展开，用 `vwmacc` 宽化乘累加，随后在向量内完成重缩放、激活裁剪和 INT8 写回。RGB 首层因输入通道为 3，走 `input_depth <= 16` 的 4x4 小通道专用路径。官方硬件不是固定 4x4 阵列，4x4 是当前官方软件对 RVV 数据流的成熟特化。

### 0.3 已完成候选、淘汰结论与当前运行任务

1. 已完成项目候选 `gesture_project/models/static_cnn_hybrid344_w125_h112_nomixup_hagrid6_20260811`：主体核序列 `3x3, 4x4, 4x4`，通道 `16/40/80`，分类头 `112`，AdamW 学习率 `0.001`、5 轮预热加余弦退火、Dropout `0.30`、权重衰减 `0.0002`、标签平滑 `0.02`、轻度增强、无 MixUp、最大 140 轮并由验证集 20 轮无提升早停。实际训练 76 轮，最佳验证 `82.80%`（第 56 轮），原图逐图浮点测试 `84.18% (1894/2250)`，全 INT8 测试 `84.13% (1893/2250)`，INT8 模型 `219,504` 字节，总卷积 MAC `197,554,176`。它低于旧混合基线，故淘汰；量化差仅 `0.04` 个百分点，说明淘汰原因是模型泛化而非量化故障。
2. 已解析的纯 `4x4` 基线虽有 `99.41%` 卷积 MAC 进入 4x4 分流，但因 `40` 通道带来最终 8 通道尾块，只有 `58.12%` 卷积 MAC 同时满足“4x4、输入按 4、输出完整 16 通道、输出宽度按 4 展开”的满利用形状。故下一候选不能只把“4x4 比例”当作适配指标，必须同时避免输出向量尾块。
3. **当前最佳的硬件协同静态候选**为 `gesture_project/models/static_cnn_hybrid344_c16_48_80_h112_nomixup_hagrid6_20260811`：与 `16/40/80` 对照保持同配方、同随机种子、同训练上限，仅将主体通道改为 `16/48/80`。实际训练 107 轮，最佳验证 `83.96%`（第 87 轮），原图逐图浮点测试 `86.89% (1955/2250)`，全 INT8 测试 `87.07% (1959/2250)`，INT8 模型 `243,504` 字节，总卷积 MAC `234,123,264`。后两阶段四个 `4x4` 卷积的输入和输出通道均为 16 的倍数，特征图宽度为 `48/24/12`；实际 TFLite 解析确认 `88.68%` 的卷积 MAC 同时满足 `4x4`、输入按 4、完整 16 输出通道块与四空间点展开，显著高于旧混合基线的 `81.27%`。
4. 项目侧 `gesture_project/algorithms/static_cnn/train_static_cnn.py` 已新增显式 `--stage_channels`，带 `PROJECT_LOCAL_MOD` 注释，避免仅借助宽度倍率间接产生 `40` 等非满向量通道。其 `repvgg_4x4` 同样已接入该通道配置；对 `16/48/80/96` 的训练态 RepVGG 进行实际构图、导出和随机输入核对，训练态/折叠部署态最大输出差为 `4.2e-7`，部署态没有训练期的 `1x1` 分支、加法或批归一化。
5. 不可直接盲训当前完整 `repvgg_4x4`：实际导出并解析的 `16/48/80/96` 部署图含 11 个 `4x4` 卷积、`473,038,848` 次 MAC，满利用向量形状占 `98.50%`，但总计算量是已淘汰的 `16/40/80` 容量对照 `197,554,176` MAC 的约 `2.39` 倍，也仍是当前最佳 `16/48/80` 候选 `234,123,264` MAC 的约 `2.02` 倍。它证明折叠路径正确，却不满足同等效率下比较准确率的要求。下一项 RepVGG 探索必须先限制阶段单元数和尾部通道，令部署 MAC 保持在当前候选的可比范围，再启动完整训练。
6. **整网 MPACT 的正式判据和本轮结果：**固定样本为 `test/fist/00dd115d-7842-4865-a66d-00eb31425cef.jpg`，输入为同一模型的 INT8 量化字节。桌面 TFLite 与本工作树所用 TFLite Micro 参考实现存在个位舍入差异，不能把桌面输出直接作为 Micro/RVV 的逐字节黄金值。因此先以运行器中的 `--reference-conv --reference-post-ops` 获得同模型、同输入的 TFLite Micro 参考输出，再以默认 RVV 卷积、池化和全连接运行并比较。旧混合 `16/32/64`：参考/ RVV 行为计数 `1,322,929,779/353,804,883`，参考输出和 RVV 输出均为 `[-4,-108,-78,-109,-111,-103]`，`MISMATCH_COUNT=0`、`RESULT=PASS`。新 `16/48/80`：参考/RVV 行为计数 `2,096,243,561/375,292,986`，参考输出和 RVV 输出均为 `[112,-128,-127,-126,-117,-125]`，`MISMATCH_COUNT=0`、`RESULT=PASS`。两次均设置 `120` 秒外层上限并在上限内结束。计数仅反映同一 MPACT 行为模拟器内的相对执行量，不得写为 RTL 或 FPGA 周期。
7. 为完成上述可控对照，项目侧仅修改了工作树 `gesture_project/worktrees/coralnpu-upstream-sim/sw/utils/tflite_runner/tflite_runner.cc` 与项目脚本 `gesture_project/simulation/mpact/run_static_cnn_mpact.py`：增加 `use_rvv_conv` 运行时开关及 `--reference-conv` 参数，所有新增逻辑含 `PROJECT_LOCAL_MOD` 注释；它不改变模型、输入、官方只读仓库或默认 RVV 路径。已执行 Python 语法检查和 `//tests/npusim_examples:run_project_static_cnn` 的 RISC-V ELF 重建，均通过。

## 25 2026-08-11 最新：原图 HAGRID 纯 4x4 候选的完整训练、INT8 验收与判定

本节优先于下方全部历史训练记录。Google 官方只读参考仓库是 `/home/steveguo/coralnpu-gesture/coralnpu`，本轮核对提交为 `7318dfc2a94c0ac081bbe1787414391aa3cd5052`，`git status --short` 为空。以下所有训练、脚本和模型均是项目侧 `gesture_project` 内容，绝不能称为 Google 官方训练结果或官方模型。

### 0.1 数据和比较边界

1. 正式比较数据固定为 `gesture_project/datasets/processed/hagrid_sample_static_6cls`，即 HAGRID 六类静态手势的**原始图像**，类别为 `fist, like, ok, palm, peace, stop`，训练/验证/测试为 `10,500/2,250/2,250`。它保留实际背景、遮挡和拍摄变化，是可复现的正式准确率基准。
2. `hagrid_sample_static_6cls_handcrop_mp_20260731` 是通过 MediaPipe 检测手部后裁切的数据，只能用于“先检测/裁切、再分类”的独立系统实验，不得与本节原图单模型准确率放进同一排名表。
3. 当前最优可直接部署单图像模型仍为 `gesture_project/models/repvgg_3x3_i96_hagrid6_tuned_20260731/deploy/model_int8.tflite`，原图 HAGRID INT8 测试准确率 `89.02% (2003/2250)`。本节所有 `4x4` 结果均是硬件适配候选，尚未替代该准确率主线。

### 0.2 官方源码复核后的 4x4 约束

1. 结论来自只读源码 `coralnpu/sw/opt/litert-micro/conv.cc` 的 `ConvPrepare` 与 `ConvPerChannel`，不是项目旧文档：官方现状是 RVV 软件特化的 `4x4` 卷积内核，而不是硬件本体固定的 `4x4` 阵列。
2. 对 `4x4` 卷积，输入通道数不超过 16 有专用小通道路径；输入通道为 4 的倍数、输出通道不超过 256 且权重重排缓冲分配成功时，进入输出通道向量化路径。其他 `4x4` 条件还会落到通用重排实现。`3x3` 当前会回退至参考整数卷积。
3. 因此纯 `4x4` 候选使用通道序列 `3 -> 16 -> 40 -> 80`，随后为 `112` 通道的 `1x1` 分类头。实际生成 INT8 TFLite 已用 `gesture_project/algorithms/tools/profile_tflite_ops.py` 解析：六个主体卷积均为 `4x4`，形状依次为 `3->16`、`16->16`、`16->40`、`40->40`、`40->80`、`80->80`；首层走小通道特化，后五层满足输出通道向量化条件。总卷积 MAC 为 `217,165,824`，末端 `1x1` 头仅 `1,290,240`，约占 `0.59%`。

### 0.3 先前“早期不收敛”的纠正和可复现诊断

1. 先前纯 `4x4` 候选在第 3 至 6 轮接近六分类随机准确率时被中止，这一判断错误。已完成的混合 `3/4/4` 候选同样在前九轮约为 `16%` 至 `19%`，之后才正常提升，并最终取得原图测试 `85.11%`。
2. 新增并实际运行项目侧诊断 `gesture_project/algorithms/static_cnn/diagnose_static_cnn_convergence.py`，文件含 `PROJECT_LOCAL_MOD` 标记。它对同一固定原图 HAGRID 批次禁用增强和 MixUp，连续执行 10 次反向传播：
   - 混合 `3/4/4`：损失 `2.368101 -> 1.335639`，首层权重更新范数 `0.087369`；
   - 纯 `4/4/4`：损失 `2.414833 -> 1.393022`，首层权重更新范数 `0.117713`；
   - `3x3` RepVGG：损失 `2.161378 -> 0.562355`，首层权重更新范数 `0.077511`。
   这证明数据标签、输入范围、梯度链和优化器均正常，纯 `4x4` 必须经过完整早停训练后才能判定。

### 0.4 两组纯 4x4 训练的真实结果

1. **无 MixUp 的当前最佳纯 4x4 候选**：目录 `gesture_project/models/static_cnn_4x4_w125_h112_nomixup_hagrid6_20260811`；`96x96` 输入、通道 `16/40/80`、`112` 通道 `1x1` 头、`205,142` 参数、AdamW 学习率 `0.001`、5 轮预热加余弦退火、权重衰减 `0.0002`、Dropout `0.30`、标签平滑 `0.02`、轻度几何/对比度增强、无 MixUp。RTX 4060 上训练 68 轮，最佳验证准确率 `82.18%`（第 53 轮）；恢复最佳权重后原图逐图浮点测试 `83.38% (1876/2250)`，300 张训练图代表集转换的全 INT8 TFLite 为 `221,632` 字节，INT8 测试 `83.47% (1878/2250)`。量化差为 `+0.09` 个百分点，属于稳定量化。
2. **MixUp 对照**：目录 `gesture_project/models/static_cnn_4x4_w125_h112_mixup_hagrid6_20260811`；除标签平滑 `0.05`、`MixUp alpha=0.1`、概率 `0.5` 外与上项相同。训练 86 轮，验证峰值 `82.49%`（第 71 轮），但原图浮点测试仅 `82.89% (1865/2250)`，INT8 测试 `82.76% (1862/2250)`，模型同为 `221,632` 字节。故 MixUp 在此模型上未改善测试泛化，当前配方淘汰。
3. 纯 `4x4` 当前结论：无 MixUp 版本是唯一保留的纯 `4x4` 硬件适配基线；它高于“没有完成完整训练”的旧实验，但仍低于混合 `3/4/4` 的 `85.11%`，也低于 `3x3` RepVGG 的 `89.02%`。不得将其描述为最优准确率模型。

### 0.5 后续执行顺序

1. 保持 `3x3` RepVGG 为准确率主线，保持无 MixUp 纯 `4x4` 为官方软件路径利用率最高的基线；任何候选必须在同一原图测试集完成浮点逐图、INT8 逐图和实际 TFLite 算子解析三项验收。
2. 下一个 `4x4` 高价值实验应以混合 `3/4/4` 的 `85.11%` 为下限，探索受控的结构改进而非再盲扫正则化：优先保持首块 `3x3` 的局部空间归纳能力、后续 `4x4` 保持官方路径，并让通道继续满足 `4` 的倍数。每次仅改变一个变量，完整训练后再比较。
3. 不要在模型搜索阶段跑整网 MPACT。`4x4` 候选先用短层级行为回归核对官方 LiteRT Micro 路径；只有准确率和量化均超过候选门槛后，才进行一次有 120 秒时间上限的整网 MPACT 部署验证。

## 24 2026-08-11 最新：最优 RepVGG 的 MPACT 部署边界、全连接量化修复与时间纪律

本节覆盖下方所有将整网 MPACT 运行误解为日常快速回归的表述。Google 官方只读参考仓库仍是 `/home/steveguo/coralnpu-gesture/coralnpu`，本轮 `git status --short` 为空；本节所述的全部代码改动只在项目工作树 `/home/steveguo/coralnpu-gesture/gesture_project/worktrees/coralnpu-upstream-sim`，并由 `PROJECT_LOCAL_MOD` 注释标记，不能称为上游既有实现。

### 0.1 当前部署模型和数据集，禁止混写

1. **当前最适合直接部署的单图像静态手势模型**是 `gesture_project/models/repvgg_3x3_i96_hagrid6_tuned_20260731/deploy/model_int8.tflite`。其输入为 `1x96x96x3` 的 INT8，模型为 `283,744` 字节，包含 11 个普通 `3x3` 卷积、3 个最大池化、全局平均池化、全连接分类和 Softmax；原图测试集全 INT8 准确率为 `89.02% (2003/2250)`。
2. 训练/测试主数据是 `gesture_project/datasets/processed/hagrid_sample_static_6cls` 的 HAGRID 六类**原始图像**，不是只裁切手部的图像。类别为 `fist, like, ok, palm, peace, stop`，划分为训练 `10,500`、验证 `2,250`、测试 `2,250`。
3. `94.62%` 是图像 RepVGG 分支与 MediaPipe 手部关键点分支融合的系统结果，依赖独立的手部检测/关键点预处理，不能当作“可直接部署到单一 CoralNPU TFLite 模型”的准确率。MediaPipe 手部裁切数据位于 `hagrid_sample_static_6cls_handcrop_mp_20260731`，不得和原图单模型结果混写。
4. 固定检查样本为 `test/fist/00dd115d-7842-4865-a66d-00eb31425cef.jpg`。2026-08-11 用桌面 INT8 TFLite 实测输出 `q=[91,-126,-114,-124,-120,-119]`，预测 `fist` 正确。输入量化字节数为 `27,648`，临时输入仅存于 `/tmp/coralnpu-mpact-repvgg/`，不应提交。

### 0.2 MPACT 的正确用途和运行上限

1. MPACT 是官方 Python 绑定的 C++ 行为模拟器，适合验证 ELF、指令和 TFLite Micro 软件路径，**不是周期精确 RTL 仿真器**，其虚拟 `mcycle` 不得换算 FPGA 帧率。RTL Verilator/cocotb 才周期精确，但官方说明约 `15 kilocycles/s`，不得用于整网日常验证。
2. 当前 RepVGG 的 11 个 `3x3` 卷积在上游现有软件中均走通用整数卷积回退路径，而不是现有 `4x4` RVV 特化路径。因此单张整网 MPACT 会持续占满一个 CPU 核，已观察到超过两分钟仍未完成；它可用于有明确一次性价值的部署核验，但不能用于候选模型搜索、批量评估或无边界等待。
3. 从 2026-08-11 起执行纪律：整网 MPACT 默认最多 `120` 秒，超过上限必须主动停止并记录“未完成”，不得继续运行到小时级；日常迭代先用主机 TFLite 全测试集准确率、短 MPACT 算子/层级回归和 ELF 增量构建。任何计划启动整网 MPACT 前，必须写明固定样本、核对张量、成功判据和时间上限。

### 0.3 已确认并修复的 RVV 全连接缺陷

1. 模型末层分类形状是 `96 -> 6`：全局平均池化张量的零点为 `-128`，权重 `tensor 3` 为按六个输出类别分别量化的 INT8 权重，输出为 `tensor 41`。这不是单一量化比例的全连接层。
2. 工作树原 `sw/opt/litert-micro/fully_connected.cc` 无条件调用单比例的 `FullyConnected`。但 TFLite Micro 标准实现会在 `data.is_per_channel` 为真时调用 `FullyConnectedPerChannel`，分别使用六个量化乘数和移位。此前出现全类别近似同值输出的根因就是优化实现忽略该逐通道重缩放，而官方单测只覆盖深度 `16/64`、零点为零的单比例条件，未覆盖此模型条件。
3. 本轮项目侧修改只位于工作树的 `sw/opt/litert-micro/fully_connected.cc` 和 `.h`：新增 `FullyConnectedPerChannel`，复用既有 RVV `vwmacc` 向量乘累加，**仅**在累加后的定点重缩放阶段按输出通道选择 multiplier/shift；没有退回永久标量计算，也没有修改官方只读目录。
4. 新增短行为回归：`tests/npusim_examples/project_fully_connected_96x6.cc` 与 `run_project_fully_connected_96x6.py`。它明确标记 `PROJECT_LOCAL_MOD`，以真实部署形状 `96->6`、`input_offset=128`、逐通道量化乘数/移位比较 TFLite Micro 参考和 RVV 结果。2026-08-11 实测：`REFERENCE_Q=[-22,-23,-23,-24,-23,-24]`，`RVV_Q=[-22,-23,-23,-24,-23,-24]`，`MISMATCH_COUNT=0`；虚拟周期分别为 `5159/1468`。这证明修复后的关键分类算子正确，但不等于整网本轮已经完成。
5. 同轮已重建 `//sw/utils/tflite_runner:tflite_runner.elf` 成功。启动过一次真实单图整网 MPACT，但在 `2分25秒` 仍未输出时按本节时间上限主动终止，**本轮没有整网 PASS 结果，不能写成已完成全网 MPACT 回归**。下次若重新执行，基线 TFLite Micro 参考末端输出应为 `[87,-126,-114,-123,-119,-118]`；桌面 TFLite 与其存在前驱算子累积的个位舍入差异，最终类别均为 `fist`。

### 0.4 后续唯一正确的推进顺序

1. 以当前单图像 RepVGG 作为准确率主线，保持主机全测试集的 INT8 评估为准确率门槛；不因当前官方 `4x4` 特化而强行替换已验证准确率更高的 `3x3` 网络。
2. 对该 RepVGG 做 MPACT 时，优先增加有限时间的分层检查：真实末层逐通道全连接、单个卷积层或固定小特征块；每个都必须有 TFLite Micro 黄金数据和明确时间上限。只有在需要一次性确认 ELF 完整部署时才运行单张整网。
3. 下一次运行整网前，先检查该项目侧 RVV 全连接修复的真实模型输出。若要缩短整网 MPACT，正确方向是为真实 `3x3` 形状研发并验证专用 RVV/空间卷积内核或后续矩阵扩展映射，而不是让通用解释路径无限运行；不得回到 7Z010 的旧手写 MAC/Row Handoff 妥协线。
4. 推荐 MPACT 构建命令：`env -u HTTP_PROXY -u HTTPS_PROXY -u ALL_PROXY bazel --output_base=/tmp/bazel-coralnpu-mpact-project build --jobs=4 --local_resources=cpu=4 --local_resources=memory=6144 <target>`。新版 Bazel 的 `--local_resources` 必须分别传 `cpu=4` 和 `memory=6144`，不能写成一个逗号拼接参数；此前该错误已被修正。

## 23 2026-08-09 架构复核：7020 版裁剪 RVV 并非“只剩 MAC”

本节优先级最高，用于纠正对当前 ZYNQ-7020 位流的误解。当前实际上板的项目侧 IP 是 [coralnpu_rvv_accel_lane1_axil_wrapper.sv](/home/steveguo/coralnpu-gesture/gesture_project/board_validation/zynq7020_coralnpu_official/current/rtl/rvv_accel_lane1/coralnpu_rvv_accel_lane1_axil_wrapper.sv)，不是 Google 完整 `RvvCoreMiniAxi`，但也不是 ARM 窗口逐点调用的普通 MAC 外设。

1. **已保留并上板验证的 CoralNPU/RVV 路径**：`RvvCoreShim -> RvvCoreWrapper -> RvvCore(N=1)`、32 个向量寄存器、向量配置寄存器、向量解码/分派/预约站/重排序提交、向量整数 ALU、乘累加单元（`vmul.vx`/`vmacc.vx`）、向量寄存器文件、`vle32.v`/`vse32.v` 回写路径。PS 通过 AXI-Lite 命令邮箱下发一条向量指令，指令在 PL 内部完成解码、调度、VRF 读写、计算和提交；不是 PS 对每个乘法发一次外设命令。
2. **已保留并上板验证的外存路径**：自定义 `rvv_lsu_axi_bridge_unit_stride_e32.sv` 将 RVV 的 `vle32.v`/`vse32.v` 连到 AXI 主端口，经 Zynq HP0 访问 PS DDR。已实板证明 LSU -> AXI -> HP0 -> DDR 往返。当前只支持连续地址、`e32`、`VL=1/2` 的受控子集，不是完整通用 RVV LSU。
3. **已另行加入的真正卷积硬件**：[coralnpu_stage3b_tensor_engine.sv](/home/steveguo/coralnpu-gesture/gesture_project/board_validation/zynq7020_coralnpu_official/current/rtl/rvv_accel_lane1/coralnpu_stage3b_tensor_engine.sv) 固定实现模型 `conv3_3x3_b` 的 `24x24x64 -> 24x24x64` INT8 3x3 卷积，每个 MAC 状态并行计算 8 个输出通道 × 8 个输入通道，片上保留 INT32 部分和，完成 TFLite 定点 requant 和 2x2 maxpool。输入、权重、输出和 pool3 均为 BRAM，DMA 可与 DDR 批量搬运。该引擎已完整对账 `tensor25=36,864` 字节与 `tensor26=9,216` 字节，并实板生成正确类别。
4. **为了装入 7020 而裁掉的东西**：Google 原始四发射标量前端、取指、标量寄存器核、标量浮点、向量浮点/BF16、通用向量访存、第二 LSU、通用排列/归约单元、除法单元和 VME/ZVT tile 矩阵单元。`PROJECT_LOCAL_CONV_ACCEL_ONLY` 将排列/归约和除法请求明确回压，不会静默产生错结果。
5. **实际生效参数不可只看目录名**：`RvvCore(N=1)`、`ISSUE_LANE=1`、`NUM_LSU=1`、`NUM_MUL=1`、`NUM_ALU=1`、`NUM_VRF=32`、无浮点、无 VME；打包 Tcl 定义 `VLEN_64`。它不是完整官方 128 位 VLEN 基线；AXI/RVV 包装中 128 位线网仍作为固定传输宽度存在，不能误读为有效 `VLEN=128` 计算能力。`Rb4` 是历史名称，当前 `DISPATCH3` 分支实际定义 `ROB_DEPTH=8`。后续应以宏和综合报告为准，并清理此误导性名称。
6. **为何能装下**：2026-08-08 Vivado 2023.2 对 `xc7z020clg400-2` 完成综合、布局布线和位流生成：`LUT 34,570/53,200 (64.98%)`、`BRAM36 56/140 (40.00%)`、`DSP48E1 67/220 (30.45%)`、25MHz `WNS=12.365ns`、`WHS=0.036ns`，所有时序约束通过。这是删除通用标量前端/浮点/复杂执行单元、限制 LSU 访存形式、将主要 3x3 计算交给 64 个并行 INT8 乘法项的专用引擎的结果，不是把 416K LUT 的完整官方核装入 7020。
7. **当前真实性能边界**：已实板连通 `tensor24 -> 3x3 conv -> maxpool -> tensor26 -> RVV conv_head_1x1 -> GAP -> class` 的单样本运行时接力，并有 6 张真实样本的后段批量基线。但 `tensor26` 到 RVV 后段仍由 PS 做过渡搬运和指令发射，模型更早层也没有全部复制到 PL。不得宣称“整网完全由 FPGA 独立执行”。

这份文档是当前工作树的最高优先级入口。
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
