SteveGuo1726/coralnpu-gesture/gesture_project/docs/ZCU104_上板推进计划_2026-09-12.md

# ZCU104 上板推进计划（2026-09-12）

> **这份文档是什么**：把「ZCU104 实时摄像头 → NPU → 手势」这条链路真正跑通的分步执行计划。
> 每个阶段都有**动作 / 判据 / 失败分支**，判据不通过就不许进下一步。
>
> **与 `ZCU104_上板操作卡_2026-09-12.md` 的关系**：那份是速查卡，本文是完整计划，
> **以本文为准**。本文修正了速查卡的两处问题（板上命令缺 `sudo`、GATE 0 的成因描述过时）。
>
> **为什么要"认真严谨"**：板子上的时间是最贵的资源。上板一次要插卡、拨码、接串口、
> 上电、看日志；一旦某个前置条件是错的，浪费的不是 5 分钟而是一个下午。
> 所以**本计划把能离线验证的东西全部提前验证完**，把板上要做的事压到最少。

---

## 0. 完成定义（先说清楚"做到什么算成功"）

对照大创申请书 §5.3 的「验证与测试成果」，本次上板要拿到的是：

| 级别 | 内容 | 判据 |
|---|---|---|
| **必须** | NPU 在 Linux 用户态跑通 | `gf_npu_probe` 打印 **`RESULT: PASS`**，逐层 `memcmp` 全 `MATCH` |
| **必须** | 分离口径的性能数字 | `gf_npu_probe --bench 200` 报出 **PL 计算** 与 **CPU 侧开销**，与裸机 17.02 ms / 10.04 ms 对比 |
| **必须** | 端到端实时闭环 | `gf_camera` 连续打印类别，帧率达标 —— **这是项目第一次真正闭环** |
| **加分** | 摄像头/格式取证 | `v4l2-ctl --list-formats-ext` 输出，USB2/USB3 枚举记录 |

**明确不在本次范围内**（不要在上板时顺手做，会把变量搞混）：
提频、功耗测量、双缓冲流水、LSTM/动态手势。这些都在 P8 之后另开。

---

## 1. 前置状态：**已离线核实的事实**（本次实测，不是推断）

> 这一节的全部结论都在 2026-09-12 11:20 前后重新跑过，原始输出附在文末。

### 1.1 镜像产物 ✅

| 文件 | 大小 | 时间戳 |
|---|---|---|
| `BOOT.BIN` | 21,073,168 B | 09-12 01:18 |
| `image.ub` | 9,970,740 B | 09-12 00:46 |
| `rootfs.ext4` | 431,012,864 B | 09-12 01:18 |
| `system.dtb` | 45,122 B | 09-12 00:45 |
| `boot.scr` | 3,474 B | 09-12 00:22 |

`boot.scr` **存在**（U-Boot 靠它加载 `image.ub`，缺了就起不来）。

### 1.2 镜像内容校验 ✅ `RESULT: PASS`

- `[0] 时效性`：最新源码 `gf_camera.c` 01:15 → rootfs 01:18，**镜像不比源码旧** ✅
- `[1] manifest`：`gf-npu` / `libjpeg62` / `libv4l` / `v4l-utils` / `usbutils` 全在 ✅
- `[3] 属性`：两个二进制都是 `ARM aarch64`；`gf_camera` 链到 `libjpeg` ✅
- `[4] 内容比对`：17 条探针全 `OK` ✅
- `[6] 指纹`：`gf_npu_probe md5=2ed2ef05ab52e145`、`gf_camera md5=bb04ced68ea693e9`

### 1.3 设备树校验 ✅（**本次新增，之前没做过**）

**做法**：用 `dumpimage` 从 `image.ub` 这个 **FIT** 里把内嵌 DTB 提取出来，和
`system.dtb` 逐 md5 对比，再逐项检查关键节点。
**为什么要做**：`system.dtb` 在 `BOOT.BIN` 里，但内核实际是**用 `image.ub` 里那份 DTB 启动的**。
如果两者不一致，板子会带着一份我们没检查过的 DTB 启动 —— 而这个问题在串口上极难看出来。

| 检查项 | 结果 |
|---|---|
| `system.dtb` vs `image.ub` 内嵌 DTB | **md5 完全一致** `3a15a61b5e8a4e15fd9e38f4ce039ccb` ✅ |
| `npu-buffers@70000000` | 存在，`reg = <0 0x70000000 0 0x1000000>`（16 MB），**`no-map`** ✅ |
| `bootargs` | `earlycon console=ttyPS0,115200 clk_ignore_unused root=/dev/mmcblk0p2 ro rootwait rw` ✅ |
| NPU 控制口 | `gestureflow_layer_chain_dmp_hp0_axil@a0000000`，`reg` 1 MB，时钟 `0x47`(clk_pl_0) ✅ |
| USB Host | `usb@ff9d0000` → `usb@fe200000` (`snps,dwc3`)，**`dr_mode="host"`、`maximum-speed="super-speed"`** ✅ |
| 板级 compatible | `xlnx,zynqmp-zcu104-revC` ✅（说明 `MACHINE_NAME=zcu104-revc` 真的生效了） |
| `memory@0` | `0x0–0x7FF00000`（2032 MB）；预留段 0x70000000 **落在 RAM 范围内**，靠 `no-map` 被 `memblock_remove` 摘出 ✅ |

### 1.4 一条**必须纠正**的记录（关于"上次重编"）

我此前在日志里写过"10:15 跑了 `do_cleanall` + 全量重编，镜像在 ~10:17 重新生成"。
**这句话是错的**，实测：

- `06_install_app.sh` 确实在 **10:15:55** 跑过，`BUILD_RC=0`，**10:17:39 结束**；
- 但构建摘要写的是 **`Attempted 4854 tasks of which 4835 didn't need to be rerun`**
  —— **只重跑了约 19 个任务**；
- 而且 `images/linux/` 里的 `BOOT.BIN` / `rootfs.ext4` 时间戳**仍是 01:18**，
  **并没有被重新生成**。

**为什么这不是故障**：源码自 01:15 之后没有再改过，重编出来的是**逐字节相同**的二进制，
所以 bitbake 正确地跳过了下游的打包与镜像任务。**01:18 那份镜像就是对的**，
`05_verify_image.sh` 的 `PASS` 是它的证明（第 1.2 节）。

**要记住的教训**：`BUILD_RC=0` **不等于**"镜像被重新生成了"。
判据永远是 `05_verify_image.sh` 的 `RESULT: PASS`，不是构建日志的返回码 ——
这正是 `IDENTITY.md` D6 那条。**上板前不需要再重编**，现在这份就是正确的。

### 1.5 程序的实际接口（**本次从源码确认**）

```
gf_npu_probe [--bench N] [--ppm out.ppm]
gf_camera    [--list] [-s WxH] [-n N] [--save-ppm P]
```

⚠️ **两者都需要 root**：`gf_npu.c` 里 `open("/dev/mem", O_RDWR)`，
失败时打印 `open /dev/mem failed: ... (needs root; CONFIG_DEVMEM=y)`。
**速查卡里的板上命令漏了 `sudo`，本文已补上。**

### 1.6 SD 卡与 WSL 的事实核对（**2026-09-12 实测**）

**问题一：官方套装那张 16 GB 卡插上后只显示 ~120 MB，是不是坏了？**
**不是。** 实测该卡在 Windows 里是 `G:`，可移动，卷标 **`PYNQ`**，`文件系统名 : FAT`，
内容为 `BOOT.BIN`(1.7 MB) / `image.ub`(23 MB) / `boot.py` / `boot.scr` / `REVISION`。
**120 MB 就是它的 FAT32 引导分区**；剩下约 15 GB 是 **ext4 根分区，Windows 读不了，
所以不显示**。这正是 PYNQ 镜像的标准布局。

**顺带得到一条好消息**：这张卡能跑 PYNQ，说明**卡、读卡器、板子 SD 通路三者都是好的**。

**问题二：另一张 32 GB 卡是 U1 速度等级，够不够？**
**完全够，而且绰绰有余。**
- **速度**：U1 = 持续写 **≥10 MB/s**。我们的 `rootfs.ext4` 是 431 MB → 写卡约 **45 秒**。
  Linux 从 U1 卡启动、以及我们这种"启动后把模型全放进内存"的负载，对卡速毫无压力。
  （U3/A2 更快，但这里用不到。）
- **容量**：镜像占约 1 GB 引导 + 431 MB 根，剩余空间 `resize2fs` 撑满即可。32 GB 远超需求。

**建议：用那张 32 GB 的。** 16 GB 的 PYNQ 卡**留着不动** ——
既保留了一个可用的 PYNQ 环境（见下方备注），也是这套"卡/读卡器/板子"链路的对照物。

> **备注（备选环境，不在本次关键路径上）**：PYNQ 自带 Python + Jupyter，并且
> `pynq.Overlay` 可以**运行时下载 bitstream**，对快速迭代很有吸引力。
> 但它的设备树是通用板级 DTB —— **没有我们的 `npu-buffers` 预留段、没有 `clk_ignore_unused`**，
> 内核 `CONFIG_DEVMEM` 也不确定；换过去等于把已经校验过的环境变量全部重开一遍。
> **本次不换。** 如果后面发现 PetaLinux 侧有硬伤，再作为 B 计划评估。

**问题三：WSL 到底能不能写插进来的 SD 卡？**
**默认不能，而且 `wsl --mount` 这条路对读卡器是死的。**

- **默认不能**：WSL2 是轻量虚拟机，**不会自动把 USB / 块设备透传进来**。
  实测 WSL 内 `lsblk` 只有 `sda/sdb/sdc/sdd` 四块虚拟盘，**看不到 SD 卡**。
- **`wsl --mount` 不行 —— 这是微软官方文档写明的**：
  > *The `wsl --mount` command does not currently support USB/flash drives/SD card readers.*
  （`learn.microsoft.com/windows/wsl/wsl2-mount-disk`）

  实测吻合：管理员下执行 `wsl --mount \\.\PHYSICALDRIVE2 --bare` 两次都失败，
  报 **`Wsl/Service/AttachDisk/MountDisk/0x8007000f`**
  （`0x8007000f` = Win32 **ERROR_INVALID_DRIVE**，即"系统找不到指定的驱动器"）。
  把盘脱机后重试，错误变成 `.../HCS/0x8007000f`，**仍然失败**。
  社区报告一致：**配读卡器是长期未修的已知问题**，不是我们的操作错。

- **正确路径：USB 透传（usbipd）**，也是微软文档在 `--mount` 不支持时指向的方案。
  **本机条件已核实具备**：`winget` 可用（`C:\Users\SteveGuo\AppData\Local\Microsoft\WindowsApps\winget.exe`），
  且 WSL 内核 6.18.33.2 里 `vhci-hcd` / `usbip-core` / `usb-storage` / `uas` **全部存在**
  （`/lib/modules/6.18.33.2-microsoft-standard-WSL2/kernel/drivers/usb/usbip/`）。
  完整步骤见 **P1**。
- **如果 usbipd 也不顺**：备选方案 B（在 WSL 里造 `.img` + Windows 用 Rufus/Etcher 写）
  **脚本已就绪**（`07_make_sd_image.sh`），见 P1 末尾。它完全不需要卡被 WSL 看见。

---

## 2. 分工（谁做什么）

| 步骤 | 谁 | 为什么 |
|---|---|---|
| P0 离线预检 | **我** | 不需要板子和 root |
| P1 写 SD 卡 | **你**（需要 `sudo` + 读卡器） | 按约定：sudo 交给用户 |
| P2 插卡 / 拨码 / 上电 / 串口 | **你**（物理操作） | 我做不了 |
| P3–P7 板上命令 | **你**执行，**把输出贴回来** | 我离线分析 |
| P8 归档与下一轮 | **我** | 写文档、定优化 |

**给"贴回来"的协议**：贴**完整输出**，不要只贴结论行。尤其
`gf_npu_probe` 的全量输出（层表 + FNV 表）—— 失败时的偏移量与两侧 FNV 比一句 FAIL 有用得多。

---

## 3. 执行阶段

### P0 · 离线预检（**已完成，本文第 1 节就是结果**）

结论：**可以写卡**。无需任何操作。

---

### P0.5 · ★ 迭代期**不要**写卡：串口直接覆盖二进制（2026-09-12 新增）

**在往下走 P1 之前先读这条。** P1 是"把镜像固化进 SD 卡"，那是**交差/归档**用的。
如果此刻只是想验一版驱动改动，写卡是纯浪费：改一行代码 → 重写 431 MB rootfs →
拔插卡 → 15 分钟一轮。

板子已经在跑 Linux、根文件系统可写、`python3` 有 `base64/zlib/hashlib/struct`，
所以只推**那一个二进制**就行：

```bash
cd ~/coralnpu-gesture/gesture_project/innovation_npu/board_zcu104/plnx
TTY=/dev/ttyUSB1 bash 10_push_app.sh        # 或 probe / camera 只推一个
```

| 它做什么 | 校验 |
|---|---|
| `debugfs` 从 `rootfs.ext4` 取出刚编好的二进制 | 不需要 root |
| 先跑 `05_verify_image.sh` | **不 PASS 直接拒绝推送**（防止推上一版）|
| `09_board_put.sh` 串口 base64 + 板上 python3 解码 | **两侧 md5 + 长度双向核对**，重试 3 次 |
| 板上 `install` 到 `/usr/bin` | 回读 md5 与本地对账 |

**量级**：526 KB ≈ 1 分钟；实测 **11.3 KiB/s**，正好 115200 线速，无损。

**仍然必须回到写卡的只有**：设备树 / 内核 / `boot.scr` / `BOOT.BIN`（都在启动分区或
FIT 里，串口覆盖不了），以及**最终固化一版完整镜像**。
**⚠️ "板上跑通了" ≠ "镜像里有这一版"** —— `10_push_app.sh` 只改板上那份。

---

### P1 · 把 SD 卡接进 WSL，然后写卡 —— 你执行（需 sudo / 需管理员）

> **⚠️ 2026-09-12 更正：本节初版写错了。** 初版直接让你 `lsblk` 找卡 —— 但
> **WSL2 默认看不到任何插进来的 SD 卡**。实测 WSL 里 `lsblk` 只有虚拟盘：
> `sda 356.9M` / `sdb 159.4M` / `sdc 3G (swap)` / `sdd 1T (/mnt/wslg/distro)`。
> **必须先把卡"挂"进来**，否则 `04_make_sd.sh /dev/sdX` 根本找不到设备。

#### P1.1 找到卡的物理盘号（普通 PowerShell）

```powershell
Get-Disk | Select-Object Number,FriendlyName,@{n='GB';e={[math]::Round($_.Size/1GB,1)}},BusType,PartitionStyle
```

认准**容量对得上**（32 GB）且 `BusType = USB` 的那个，记下 `Number`（下文写作 **N**）。

> 也可以直接看「磁盘管理」：可移动的 32 GB 盘就是它。

#### P1.2 安装 usbipd（**管理员**，一次性）

```powershell
winget install -e --id dorssel.usbipd-win --accept-package-agreements --accept-source-agreements
```
装完**新开一个管理员终端**（要让 PATH 刷新）。

> usbipd 就是微软文档在 `--mount` 不适用时给出的那条路：把 USB 设备从 Windows
> "拔"下来，直接"插"进 WSL 的内核。

#### P1.3 找到读卡器的 BUSID

```powershell
usbipd list
```
认 **`Generic MassStorageClass`**（或 `USB Mass Storage Device`）那一行，记下首列的
**BUSID**（形如 `2-13`，下文写作 `<BUSID>`）。

#### P1.4 绑定 + 透传给 WSL（**管理员**）

```powershell
usbipd bind   --busid <BUSID>          # 一次性；状态应变成 Shared
usbipd attach --wsl --busid <BUSID>    # 真正交出去
```

> ⚠️ `attach` 之后，**Windows 资源管理器里这张卡会消失** —— 这是**正常的**，
> 设备已经进 WSL 了。要让 Windows 拿回来就 `usbipd detach --busid <BUSID>`。
> ⚠️ `attach` 期间 **WSL 实例必须保持运行**（可以只开一个 `wsl` 窗口占着）。

#### P1.5 在 WSL 里确认它出现了

```bash
sudo modprobe vhci-hcd        # USB/IP 虚拟主机控制器（首次需要）
sudo modprobe usb-storage     # 大容量存储驱动
lsblk -o NAME,SIZE,TYPE,MOUNTPOINT
```

**判据**：多出一块约 **28.9 G** 的盘，形如 `sde 28.9G disk`，且**没有挂载点**。

> **若 `lsusb` 能看到设备、但 `lsblk` 里没有盘** → 就是驱动模块没加载。
> 这正是社区报告里的经典坑，上面两条 `modprobe` 就是为它准备的。
> 本机已确认这几个模块**都存在**：`vhci-hcd.ko` / `usb-storage.ko` / `uas.ko`
> （`/lib/modules/6.18.33.2-microsoft-standard-WSL2/kernel/drivers/usb/{usbip,storage}/`）。

#### P1.6 写卡

```bash
sudo bash ~/coralnpu-gesture/gesture_project/innovation_npu/board_zcu104/plnx/04_make_sd.sh /dev/sde
```
（把 `/dev/sde` 换成 P1.5 里看到的设备名。**要是整盘名，不要带数字。**）

> **⚠️ 一个已修掉、但你要知道它长什么样的坑**（PITFALLS #11）：
> `sudo` 会把 `$HOME` 重置成 `/root`，而这些脚本原先用 `$HOME` 定位工程树，
> 于是会报 `missing /root/gf_linux_ws/.../BOOT.BIN` —— 镜像其实一直都在。
> 四个脚本（04/05/06/07）现在都会自动解析"调用 sudo 的那个用户"的家目录；
> 万一仍有偏差，显式覆盖即可：
> ```bash
> sudo GF_HOME=/home/steveguo bash <脚本> <参数>
> ```

脚本会依次：**自动跑 `05_verify_image.sh`（不 PASS 直接拒绝写卡）** → 校验 manifest 含 `gf-npu`
→ 让你把设备名**再手打一遍**确认 → 分区（p1 FAT32 1 GiB / p2 ext4 剩余）→ 写 rootfs
→ `resize2fs` 撑满 → 只读挂载复核、打印 `file` 与 **md5**。

**判据（三条都要）**
1. `usr/bin/gf_npu_probe`、`gf_camera`、`v4l2-ctl`、`lsusb` 四项全 `OK`；
2. `gf_camera` 显示 `ARM aarch64`；
3. 两个二进制的 md5 **等于** `2ed2ef05ab52e145` / `bb04ced68ea693e9`（与 `05` 的 `[6]` 段一致）。

#### P1.7 用完把设备还给 Windows

```powershell
usbipd detach --busid <BUSID>
```

> 之后卡会重新出现在 Windows 里（可能需要在磁盘管理里给它一个盘符）。

---

> **失败分支 / 备选方案 B —— 脚本已就绪：`07_make_sd_image.sh`**
>
> 什么时候用它：**usbipd 也走不通**时（读卡器被 Windows 独占、winget 装不上、
> 或 `attach` 后 WSL 里始终不出现 `/dev/sdX`）。
> **不要在 Windows 上硬凑** —— Windows 写不了 ext4。改走：
> **在 WSL 里生成一个可烧录的完整 `.img`，再用 Windows 的 Rufus / balenaEtcher 写卡。**
> 注意这一步需要先装一个写盘工具（本机 Rufus / balenaEtcher **都没装**）。
>
> ```bash
> cd ~/coralnpu-gesture/gesture_project/innovation_npu/board_zcu104/plnx
> sudo bash 07_make_sd_image.sh ~/gf_zcu104_sd.img 2048
> ```
>
> **它不重新实现分区逻辑**：造一个 2 GiB 稀疏文件 → `losetup -Pf` 接成 loop 设备
> → **直接调用已经验证过的 `04_make_sd.sh`**（分区表布局因此天然与写卡路径一致）
> → 卸载 → 打印 SHA256 与分区表。
> 所以在"写卡"和"造镜像"两条路上，分区/写盘/`resize2fs`/写后 md5 复核走的是**同一段代码**，
> 不会出现"镜像这条路没被测过"。
>
> **已离线验证的部分**（2026-09-12，无 root 实测）：
> - `truncate` 造稀疏文件 ✅
> - **`04` 里那三条 `parted` 命令在文件上产出完全符合设计的分区表** ✅
>   （实测：p1 `8192–2105343` = `1G`，Id `c` W95 FAT32(LBA)；p2 `2105344–4194303` = `1020M`，Id `83` Linux）
> - `mke2fs -E offset` 可用（261120 个 4K 块，`dumpe2fs` 回读确认 clean）✅
> - loop 设备命名分支正确：`/dev/loop0` → `loop0p1` / `loop0p2` ✅（`04` 里的 `[0-9]$` 正则正好命中）
> - 07 语法通过、无 CR 字节 ✅
>
> **未验证的部分（诚实说明）**：整条 `losetup -Pf` 全流程需要 root，我这边无法执行，
> 所以**没有端到端跑过一次**。第一次跑时如果报错，把输出贴回来。
>
> **刷盘小坑**：`.img` 在 WSL 里，Rufus 通过 `\\wsl.localhost\...` 访问有时不稳，
> **建议先 `cp` 到 `/mnt/c/Users/SteveGuo/` 再刷**。
>
> **最后手段**：找一台 Linux 机器（或 Live USB），把 `.img` 拷过去 `dd`。

---

### P2 · 插卡 / 拨码 / 上电（你执行）

1. 卡片插到 **J100**
2. **SW6 [4:1] = `OFF, OFF, OFF, ON`**（SD1）
   - ⚠️ 极性 **ON = 0，OFF = 1**。出厂默认是 QSPI32（`ON,ON,OFF,ON`），**必须改**
3. 串口：板载 FT4232H 的 **channel 0**，**115200 8N1**
   - Windows：设备管理器里找哪个 `COMx` 对应 channel 0
4. 上电

**判据**：串口出现 U-Boot 与内核启动日志，最终落到登录提示符（PetaLinux 默认 `root` / 无密码，若要求密码试 `root`）。

> **失败分支 A：串口完全无输出**
> ① 复查 SW6 极性（最容易错）；② 重插卡；③ 换一根 USB 线/另一个口；
> ④ 把 SW6 拨回 QSPI32（`ON,ON,OFF,ON`）上电 —— 若这样能起，说明**板子本身没问题**，
> 是卡或镜像的问题；⑤ 若 QSPI 也不起，才是板子/供电问题。
>
> **失败分支 B：卡在 `Starting kernel ...` 之后停住**
> 多半是 `image.ub` 加载失败或 DTB 不匹配。**注意：我们已经验证过 `image.ub` 内嵌 DTB 与
> `system.dtb` 一致**（§1.3），所以这一项可以排除，把串口完整输出贴回来。

---

### P3 · V1：确认系统起来了、摄像头被枚举（板上）

```bash
uname -a
cat /proc/cmdline                    # 应含 clk_ignore_unused 与 root=/dev/mmcblk0p2
lsusb
ls /dev/video*
dmesg | grep -i -E "usb|xhci|uvc|dwc3" | tail -30
```

**判据**
- `lsusb` 里能看到摄像头；
- `/dev/video0` 存在。

**若不是 `super-speed`（即退到 USB2）也算通过** —— 640×480 带宽足够，
**但要如实记下来**（USB3 需要 PS-GTR Lane2 协商成功）。

> **失败分支：`lsusb` 里没有摄像头**
> ① `dmesg | tail -40` 看有没有 USB 枚举动作；② 换 USB 线（很多「USB3 线」其实是 USB2 线）；
> ③ 换板子上的另一个 USB 口；④ 换一个有源 USB Hub 排除供电不足；
> ⑤ `lsusb` 有设备但**没有** `/dev/video0` → 记录 `lsusb` 的 VID:PID，
> 那是内核 UVC 匹配问题（内核里 `CONFIG_USB_VIDEO_CLASS=y` 已开）。
>
> **这一阶段失败不影响 P5**：NPU 自检不依赖摄像头。**可以先跳过摄像头去做 P5**，
> 把摄像头问题单独解决 —— 这样能把两个变量分开。

---

### P4 · V2：摄像头支持什么格式（板上）

```bash
v4l2-ctl --list-devices
v4l2-ctl -d /dev/video0 --list-formats-ext
```

**判据**：能列出格式（`MJPG` 和/或 `YUYV`）与分辨率。**把完整输出贴回来**——
`gf_camera -s` 选哪个分辨率取决于它。

> 建议优先用 **MJPG**（带宽小、帧率高；recipe 已开 `-DGF_HAVE_JPEG`）。

---

### P5 · V3：★ NPU 自检 —— **最关键的一步**

```bash
sudo gf_npu_probe
```

**必须看到 `RESULT: PASS`**，并且逐层内容校验全 `MATCH`：

```
gf_npu: PL id ok (MAGIC 0x47464E50, VERSION 0x00050001)
gf_npu: staged weights + activations, ... of 16 MiB
=== reference-image pass ===
class = 1 (...), expected 1
  --- golden content checks (bit-exact memcmp) ---
    conv0  MATCH / pool1 MATCH / conv2 MATCH / pool2 MATCH / conv4 MATCH / pool3 MATCH
    6/6 matched
  --- hardware FNV registers ---
RESULT: PASS
```

**这一条是整条链路的门禁。在它 PASS 之前，`gf_camera` 报的任何类别都不算数。**

> **失败分支 1：`open /dev/mem failed`**
> → 忘了 `sudo`。仍失败则 `ls -la /dev/mem`、`dmesg | grep -i devmem`。
> 设备树已确认 `no-map` 预留段存在，所以理论上 `STRICT_DEVMEM` 拦不住。
>
> **失败分支 2：`GF_MAGIC` 是 `0x00000000` 或 `0xFFFFFFFF`**
> → **PL 没有配置**（bitstream 没加载）或 **PL 时钟被关**。
> ① `cat /proc/cmdline` 确认 `clk_ignore_unused`（设备树已确认有，但看板子实际用的）；
> ② `dmesg | grep -i -E "fpga|zynqmp-fpga"` 看 FPGA manager 是否加载了 bitstream；
> ③ `cat /sys/class/fpga_manager/fpga0/state`（应为 `operating`）。
> **这是本项目最可能出问题的点**，因为 PL 无驱动、时钟是"防御性"保留的。
>
> **失败分支 3：`GF_VERSION` 不匹配**
> → bitstream 与驱动不是同一版。确认烧的是新镜像（`BOOT.BIN` 里带 `system.bit`，
> `system.bit` 时间戳 09-11 23:35）。
>
> **失败分支 4：某一层 `*** MISMATCH ***`**
> → **这是真正的信号**。记下程序打印的**首个差异字节偏移 + 实际值 + golden 值 + 两侧 FNV**，
> 连同层名和**完整输出**贴回来。**不要改任何东西再跑一遍** —— 那会掩盖问题。

---

### P6 · V4：性能与分离口径（板上）

```bash
sudo gf_npu_probe --bench 200
```

**判据**：报出 **PL 计算** 与 **CPU 侧开销** 两个数字。**必须贴回来**，与裸机对比：

| 口径 | 裸机（已知） | Linux（待测） | 意义 |
|---|---|---|---|
| PL 计算 | 17.02 ms @100 MHz | ? | RTL 未变，应接近 |
| CPU 侧开销 | 10.04 ms（占 37%） | ? | **Linux 换了普通非缓存 + `memcpy`，这里应显著下降** |

> **这是硬门禁要求的"分离报告 PL 与 PS 开销"**（`7020帧率优化 §1.4` 第 4 条）。
> 只报一个总帧率不算性能结论。
>
> **如果 CPU 侧没有下降**：说明 `/dev/mem` 拿到的不是非缓存映射，或拷贝路径没优化。
> 记下来，这是 P8 之后的第一优先级。

---

### P7 · V5：实时摄像头闭环（板上）

```bash
sudo gf_camera --list                      # 只列格式，先确认
sudo gf_camera -s 640x480 -n 100           # 先跑 100 帧
sudo gf_camera -s 640x480                  # 持续跑
sudo gf_camera -s 640x480 -n 50 --save-ppm /tmp/npu_in.ppm   # 存一帧 96×96 输入
```

**判据**：连续打印类别；帧率合理；`--save-ppm` 能存出 96×96 的图。

> **`--save-ppm` 那一步很重要**：它把**真正送进 NPU 的 96×96 图**存下来，
> 是唯一能验证「面积平均缩放」预处理是否正确的手段（对比原图看是否被拉伸/裁错）。
> 把 `/tmp/npu_in.ppm` 也带回来（转成 png 更好）。
>
> **失败分支：类别乱跳或全错**
> **先回去确认 P5 是 PASS**。P5 PASS 而 P7 乱 → 问题一定在预处理或颜色通道顺序，
> 用 `--save-ppm` 定位。**不要先怀疑 NPU。**

---

### P8 · 归档与下一轮（我做）

1. 把 P3–P7 的原始输出归档进 `docs/`
2. 更新交接文档顶部（**这是项目的正式日志**）
3. 按 P6 的结果决定下一优先级（见第 5 节）

---

## 4. 风险登记表（按可能性排序）

> **当前最先会遇到的风险**（2026-09-12 实测修订）：
> **① `wsl --mount` 对 SD 读卡器是死的**（微软官方文档明说不支持，实测 `0x8007000f`）
> ⇒ 改用 **usbipd**，见 P1。
> **② usbipd 也不通** ⇒ 走备选方案 B（`07_make_sd_image.sh` + Rufus），见 P1 末尾。

| # | 风险 | 可能性 | 预先准备的处置 |
|---|---|---|---|
| R0 | ~~WSL 看不到 SD 卡~~ **`wsl --mount` 不支持读卡器** | **已发生** | 官方文档明确；已实测 `0x8007000f`。**改用 usbipd（P1.2–P1.5）** |
| R0b | usbipd 装上后 `lsblk` 里没有盘（模块未加载） | 中 | `sudo modprobe vhci-hcd usb-storage`；模块已确认存在 |
| R0c | usbipd 也不通 | 低 | 备选方案 B：`07_make_sd_image.sh` + Rufus/Etcher |
| R1 | **SW6 极性搞错**（ON=0） | 高 | 已写死：`OFF,OFF,OFF,ON`；无输出时第一件事查它 |
| R2 | **PL 时钟被内核关掉**（`GF_MAGIC` 读不到） | 中 | 设备树已确认 `clk_ignore_unused`；失败时查 `fpga_manager/state` |
| R3 | 摄像头需要换线/换口才枚举 | 中 | P3 失败**不阻塞 P5**，分开处理 |
| R4 | 软件忘了 `sudo` | 中 | 本文所有板上命令已带 `sudo` |
| R5 | 摄像头不支持 640×480 MJPEG | 低 | P4 先取证，按支持的组合改 `-s` |
| R6 | `/dev/mem` 被额外拦 | 低 | 设备树 `no-map` 已确认；回退方案是 UIO |
| R7 | 读卡器写卡不稳定 | 低 | P1 的 md5 复核能立刻发现 |
| R8 | 串口 COM 口选错 | 低 | channel 0；Windows 逐个试 |

**恢复手段（万一要退回）**：
- **板子不会坏**。最坏情况只是卡上的内容不对，重烧即可。
- **可随时验证板子本身是好的**：SW6 拨回 **QSPI32（`ON,ON,OFF,ON`）** 上电，
  应能起出厂镜像。**这是"板子 vs 卡"的判据**。
- 镜像产物都在 WSL（`~/gf_linux_ws/gf_linux/images/linux/`），随时可重烧。

---

## 5. 时间盒

| 阶段 | 预算 | 备注 |
|---|---|---|
| P1 写卡 | 5–10 min | 大头是 `dd` 430 MB |
| P2 上电 | 3–5 min | |
| P3–P4 摄像头 | 10 min | 可跳过，不阻塞 P5 |
| **P5 NPU 自检** | **10–30 min** | **关键门**；如需调试，给到 1 h |
| P6 性能 | 10 min | |
| P7 实时 | 20 min | |
| **合计** | **约 1 h（预算 2 h）** | |

**放弃线（很重要）**：**如果 P5 在 2 小时内不能 PASS，就停下来。**
不要在 P5 未通过的情况下继续调摄像头 —— 那样得到的所有类别数字都是无意义的，
而且会把一个清晰的问题变成两个纠缠的问题。把 `gf_npu_probe` 的完整输出带回来，我们离线分析。

---

## 6. 上板之后做什么（不在本次范围，先说清楚方向）

按对「申请书验收」的价值排序：

| 优先 | 事项 | 依据 |
|---|---|---|
| 1 | **DMP A/B 对照**（同 DSP 预算下 DMP vs 朴素 INT8） | 项目自己的创新性门禁要求"同硬件/同模型/同精度/同输入的可复现实测对照"；现在只有单元对账，**不足以支撑论文主张** |
| 2 | **功耗数据** | 申请书要求 ≤100 mW；`report_power` 估算 + 板级实测。当前**零数据** |
| 3 | **去 CPU 侧开销** | P6 若确认仍在 10 ms 量级，这是最大单一杠杆 |
| 4 | **PL 提频到 ~137 MHz** | `WNS +2.751 ns @100 MHz`，有余量，改动小 |
| 5 | 官方 CoralNPU 模拟器上的同模型 baseline | 申请书 §5.3.3 要求"对比原生 CoralNPU"；硬件对照不可行（见 08-04 评估），模拟器对照可行 |
| — | 动态手势 / LSTM | **需要你和导师拍板口径**（见 §7） |

---

## 7. 需要你确认的三件事（不阻塞 P1）

1. **读卡器与卡**：卡容量 ≥ 1 GiB（p1 就占 1 GiB），卡里没有要保留的数据。
2. **串口怎么接**：用 Windows 的 `COMx` + 串口工具，还是直通进 WSL？
   （决定我怎么帮你解析日志）
3. **板材**：确认手边有摄像头与 USB 线；USB3 需要好线。

---

## 附 · 本次预检的原始输出（可复核）

<details>
<summary>设备树检查（dumpimage 从 image.ub 提取 + fdtdump）</summary>

```
=== DTB 一致性 ===
  system.dtb    = 3a15a61b5e8a4e15fd9e38f4ce039ccb
  image.ub 内嵌 = 3a15a61b5e8a4e15fd9e38f4ce039ccb
  => 完全一致

=== memory@0 ===
    memory@0 { device_type = "memory"; reg = <0x0 0x0 0x0 0x7ff00000>; }

=== npu-buffers ===
    npu-buffers@70000000 {
        reg = <0x0 0x70000000 0x0 0x1000000>;
        no-map;
        phandle = <0x87>;
    };

=== USB ===
    usb@ff9d0000 { compatible = "xlnx,zynqmp-dwc3"; phy-names = "usb3-phy"; }
      usb@fe200000 { compatible = "snps,dwc3"; dr_mode = "host"; maximum-speed = "super-speed"; }

=== NPU 节点 ===
    gestureflow_layer_chain_dmp_hp0_axil@a0000000 {
        compatible = "xlnx,gestureflow-layer-chain-dmp-hp0-axil-1.0";
        reg = <0x0 0xa0000000 0x0 0x100000>;
        clocks = <0x4 0x47>;
    };

=== 板级 ===
    compatible = "xlnx,zynqmp-zcu104-revC", "xlnx,zynqmp-zcu104", "xlnx,zynqmp";
    model = "ZynqMP ZCU104 RevC";
```

</details>

<details>
<summary>05_verify_image.sh（节选）</summary>

```
--- [0] 时效性 ---
  最新源码: 09-12 01:15  .../board_zcu104/linux/gf_camera.c
  rootfs  : 09-12 01:18  431012864 bytes
  [ OK ] 镜像不比源码旧
--- [1] rootfs.manifest ---
  [ OK ] gf-npu  cortexa72_cortexa53 1.0
  [ OK ] libjpeg62 / libv4l / v4l-utils / usbutils
--- [3] 二进制属性 ---
  [ OK ] gf_npu_probe 是 aarch64
  [ OK ] gf_camera 是 aarch64
  [ OK ] gf_camera 链到 libjpeg（-DGF_HAVE_JPEG 生效）
--- [4] 17 条探针全部 OK ---
--- [6] 指纹 ---
  gf_npu_probe   md5=2ed2ef05ab52e145
  gf_camera      md5=bb04ced68ea693e9
  gf_npu.c       md5=65976d8f94d320d3
 RESULT: PASS
```

</details>

<details>
<summary>构建日志（证明 §1.4 的判断）</summary>

```
==== 06_install_app.sh Sat Sep 12 10:15:55 CST 2026 ====
... Attempted 4854 tasks of which 4835 didn't need to be rerun and all succeeded.
[INFO] Successfully built project
Sat Sep 12 10:17:39 CST 2026
BUILD_RC=0

但：BOOT.BIN / rootfs.ext4 时间戳仍为 01:18（未被重新生成）
    （源码自 01:15 未变 ⇒ 重编产物逐字节相同 ⇒ 下游镜像任务被正确跳过）
```

</details>
