SteveGuo1726/coralnpu-gesture/gesture_project/docs/仓库共享版_活跃代码与文件说明.md

# 仓库共享版 活跃代码与文件说明

> ## ⚠️ 本文已过时（2026-09-12 标注）
>
> 本文停在 **2026-07-30 前后**。它列的"当前活跃算法代码 / 当前保留模型"
> （3×3 纯卷积、landmark MLP、mobilenet 对照、6 类）**都已被取代**：
> 当前是 **18 类 HaGRID 蒸馏学生模型 + 全 4×4 + DMP 8-lane 自研 NPU**。
>
> **当前主线请读**：
> - `docs/项目完整上下文_Windows工作区版_2026-09-12.md`
> - `docs/会话交接_最高优先级_2026-07-11.md` 的**编号章节**（147 号往下）
> - `docs/文档可信度地图_2026-09-12.md`
>
> 本文仅作历史清单保留。

这份文档只说明当前工作树里仍然活跃、仍然值得直接阅读的代码和结果文件。

`2026-07-30` 之后，大量旧 `3x3 / rowhandoff / 7Z010` 试验材料已经归档，不再在这里展开说明。

## 1. 当前最重要的文档入口

- [会话交接_最高优先级_2026-07-11.md](/home/steveguo/coralnpu-gesture/gesture_project/docs/会话交接_最高优先级_2026-07-11.md)
  作用：后续所有对话续接的第一入口。
- [CoralNPU官方仓库源码分析_当前准确判断_2026-07-30.md](/home/steveguo/coralnpu-gesture/gesture_project/docs/CoralNPU官方仓库源码分析_当前准确判断_2026-07-30.md)
  作用：统一官方源码结构判断，避免再被旧理解误导。
- [手势识别算法选择与未来硬件协同方案_2026-07-30.md](/home/steveguo/coralnpu-gesture/gesture_project/docs/手势识别算法选择与未来硬件协同方案_2026-07-30.md)
  作用：统一当前算法主线和未来硬件协同方向。
- [环境配置与运行注意事项_2026-07-30.md](/home/steveguo/coralnpu-gesture/gesture_project/docs/环境配置与运行注意事项_2026-07-30.md)
  作用：统一 WSL、Python、代理、Bazel 和 Windows/EDA 使用规则。
- [工程续接与文档规范_2026-07-30.md](/home/steveguo/coralnpu-gesture/gesture_project/docs/工程续接与文档规范_2026-07-30.md)
  作用：统一续接规范、文档写法和归档规则。

## 2. 当前活跃算法代码

### 2.1 纯卷积主线

- [algorithms/static_cnn/train_static_cnn.py](/home/steveguo/coralnpu-gesture/gesture_project/algorithms/static_cnn/train_static_cnn.py)
  作用：当前纯图像卷积基线训练入口。
- [algorithms/static_cnn/quantize_tflite.py](/home/steveguo/coralnpu-gesture/gesture_project/algorithms/static_cnn/quantize_tflite.py)
  作用：当前纯卷积模型 INT8 量化入口。

### 2.2 关键点与融合路线

- [algorithms/landmark_dynamic/extract_static_hand_landmarks.py](/home/steveguo/coralnpu-gesture/gesture_project/algorithms/landmark_dynamic/extract_static_hand_landmarks.py)
  作用：从图像数据集提取 `MediaPipe` 手部关键点。
- [algorithms/landmark_dynamic/train_static_landmark_mlp.py](/home/steveguo/coralnpu-gesture/gesture_project/algorithms/landmark_dynamic/train_static_landmark_mlp.py)
  作用：关键点静态分类模型训练入口。
- [algorithms/landmark_dynamic/evaluate_static_cnn_landmark_fusion.py](/home/steveguo/coralnpu-gesture/gesture_project/algorithms/landmark_dynamic/evaluate_static_cnn_landmark_fusion.py)
  作用：图像分支与关键点分支晚融合评估入口。

### 2.3 候选对照

- [algorithms/mobilenet_candidates/train_mobilenet_candidate.py](/home/steveguo/coralnpu-gesture/gesture_project/algorithms/mobilenet_candidates/train_mobilenet_candidate.py)
  作用：轻量卷积对照训练入口。
- [algorithms/tools/compare_model_candidates.py](/home/steveguo/coralnpu-gesture/gesture_project/algorithms/tools/compare_model_candidates.py)
  作用：统一候选模型结构对比。

### 2.4 通用评估与画像

- [algorithms/tools/evaluate_keras_classifier.py](/home/steveguo/coralnpu-gesture/gesture_project/algorithms/tools/evaluate_keras_classifier.py)
- [algorithms/tools/evaluate_tflite_classifier.py](/home/steveguo/coralnpu-gesture/gesture_project/algorithms/tools/evaluate_tflite_classifier.py)
- [algorithms/tools/profile_tflite_ops.py](/home/steveguo/coralnpu-gesture/gesture_project/algorithms/tools/profile_tflite_ops.py)
- [algorithms/tools/estimate_npu_cycles.py](/home/steveguo/coralnpu-gesture/gesture_project/algorithms/tools/estimate_npu_cycles.py)
- [algorithms/tools/estimate_candidate_cycles.py](/home/steveguo/coralnpu-gesture/gesture_project/algorithms/tools/estimate_candidate_cycles.py)
- [algorithms/tools/estimate_shape_report_cycles.py](/home/steveguo/coralnpu-gesture/gesture_project/algorithms/tools/estimate_shape_report_cycles.py)
- [algorithms/tools/summarize_candidate_hardware.py](/home/steveguo/coralnpu-gesture/gesture_project/algorithms/tools/summarize_candidate_hardware.py)
- [algorithms/tools/summarize_hardware_hotspots.py](/home/steveguo/coralnpu-gesture/gesture_project/algorithms/tools/summarize_hardware_hotspots.py)
- [algorithms/tools/static_cnn_shape_report.py](/home/steveguo/coralnpu-gesture/gesture_project/algorithms/tools/static_cnn_shape_report.py)

## 3. 当前保留模型

- `models/static_cnn_regularized_3x3_i96_e70_hagrid6_sample`
  当前纯卷积主线模型。
- `models/static_cnn_regularized_3x3_i96_e70_hagrid6_sample_wsl_retrain_20260707`
  当前纯卷积保底线的更稳复训版本。
- `models/landmark_static_mlp_mp21_full_20260728`
  当前关键点静态分类保留模型之一。
- `models/landmark_static_mlp_mp21_geom_20260728`
  当前关键点增强特征保留模型之一。
- `models/mobilenet_v2_a050_96_imagenet_frozen_finetune_hagrid6_sample`
  当前轻量网络对照模型。

## 4. 当前保留结果文件

### 4.1 当前最重要的算法证据

- [reports/formal_static_candidates_hardware_summary.md](/home/steveguo/coralnpu-gesture/gesture_project/reports/formal_static_candidates_hardware_summary.md)
- [reports/static_cnn_regularized_3x3_i96_e70_hagrid6_sample_wsl_retrain_20260707_keras_eval_20260728.json](/home/steveguo/coralnpu-gesture/gesture_project/reports/static_cnn_regularized_3x3_i96_e70_hagrid6_sample_wsl_retrain_20260707_keras_eval_20260728.json)
- [reports/static_cnn_landmark_geom_fusion_20260728_script.json](/home/steveguo/coralnpu-gesture/gesture_project/reports/static_cnn_landmark_geom_fusion_20260728_script.json)
- [reports/hagrid_sample_static_6cls_landmarks_mp21_20260728.json](/home/steveguo/coralnpu-gesture/gesture_project/reports/hagrid_sample_static_6cls_landmarks_mp21_20260728.json)

### 4.2 纯卷积部署导向判断

- [reports/static_cnn_regularized_3x3_i96_e70_hagrid6_sample_keras_eval.json](/home/steveguo/coralnpu-gesture/gesture_project/reports/static_cnn_regularized_3x3_i96_e70_hagrid6_sample_keras_eval.json)
- [reports/static_cnn_regularized_3x3_i96_e70_hagrid6_sample_tflite_eval.json](/home/steveguo/coralnpu-gesture/gesture_project/reports/static_cnn_regularized_3x3_i96_e70_hagrid6_sample_tflite_eval.json)
- [reports/static_cnn_regularized_3x3_i96_e70_hagrid6_sample_npucycles.json](/home/steveguo/coralnpu-gesture/gesture_project/reports/static_cnn_regularized_3x3_i96_e70_hagrid6_sample_npucycles.json)
- [reports/static_cnn_regularized_3x3_i96_e70_hagrid6_sample_hotspots.md](/home/steveguo/coralnpu-gesture/gesture_project/reports/static_cnn_regularized_3x3_i96_e70_hagrid6_sample_hotspots.md)

### 4.3 轻量网络对照判断

- [reports/mobilenet_v2_a050_96_imagenet_frozen_finetune_hagrid6_sample_keras_eval.json](/home/steveguo/coralnpu-gesture/gesture_project/reports/mobilenet_v2_a050_96_imagenet_frozen_finetune_hagrid6_sample_keras_eval.json)
- [reports/mobilenet_v2_a050_96_imagenet_frozen_finetune_hagrid6_sample_npucycles.json](/home/steveguo/coralnpu-gesture/gesture_project/reports/mobilenet_v2_a050_96_imagenet_frozen_finetune_hagrid6_sample_npucycles.json)
- [reports/mobilenet_v2_a050_96_imagenet_frozen_finetune_hagrid6_sample_hotspots.md](/home/steveguo/coralnpu-gesture/gesture_project/reports/mobilenet_v2_a050_96_imagenet_frozen_finetune_hagrid6_sample_hotspots.md)

## 5. 当前明确不在活跃区的内容

下面这些方向都已经不在当前工作树里直接展开：

- `7Z010` 板级试验
- `rowhandoff` 细节闭环
- `strategy8` 局部软件收敛
- `conv2_3x3_b` 控制器与状态机原型
- 大量旧 `RepVGG / residual / smoke` 试验模型

如果确实需要追溯，统一去：

- `/home/steveguo/beifen/coralnpu-gesture/2026-07-30_route_cleanup`
