SteveGuo1726/coralnpu-gesture/gesture_project/docs/工程文件索引.md

# 工程文件索引

> ## ⚠️ 本文已过时（2026-09-12 标注）
>
> 本文停在 **2026-07-30 前后**的 6 类 / 3×3 / landmark 时代，
> 它指向的"当前主线"（`static_cnn_regularized_3x3_i96_e70_hagrid6_sample`、
> landmark MLP、融合评估）**已经不是当前主线**。
>
> **当前主线请读**：
> - `docs/项目完整上下文_Windows工作区版_2026-09-12.md` —— 自包含现状全景
> - `docs/会话交接_最高优先级_2026-07-11.md` 的**编号章节**（147 号往下）
> - `docs/文档可信度地图_2026-09-12.md` —— 每份文档的时代与可信度判定
>
> 本文仅作历史索引保留。

这份索引只指向当前仍然有效、仍然建议直接阅读的文件。

`2026-07-30` 之后，旧的 `3x3 / rowhandoff / 7Z010` 主线材料已经整体归档到：

- `/home/steveguo/beifen/coralnpu-gesture/2026-07-30_route_cleanup`

如果后续必须追溯历史，请先完成当前入口文档阅读，再去归档目录回查。

## 1. 当前最高优先级阅读顺序

1. [会话交接_最高优先级_2026-07-11.md](/home/steveguo/coralnpu-gesture/gesture_project/docs/会话交接_最高优先级_2026-07-11.md)
2. [qwen分析复核与后续路线_2026-08-01.md](/home/steveguo/coralnpu-gesture/gesture_project/docs/qwen分析复核与后续路线_2026-08-01.md)
3. [CoralNPU官方仓库源码分析_当前准确判断_2026-07-30.md](/home/steveguo/coralnpu-gesture/gesture_project/docs/CoralNPU官方仓库源码分析_当前准确判断_2026-07-30.md)
4. [手势识别算法选择与未来硬件协同方案_2026-07-30.md](/home/steveguo/coralnpu-gesture/gesture_project/docs/手势识别算法选择与未来硬件协同方案_2026-07-30.md)
5. [环境配置与运行注意事项_2026-07-30.md](/home/steveguo/coralnpu-gesture/gesture_project/docs/环境配置与运行注意事项_2026-07-30.md)
6. [工程续接与文档规范_2026-07-30.md](/home/steveguo/coralnpu-gesture/gesture_project/docs/工程续接与文档规范_2026-07-30.md)

## 2. 当前保留的总览与说明文档

- [../README.md](/home/steveguo/coralnpu-gesture/gesture_project/README.md)
- [仓库共享版_活跃代码与文件说明.md](/home/steveguo/coralnpu-gesture/gesture_project/docs/仓库共享版_活跃代码与文件说明.md)
- [HaGRID18_Zynq7020_软硬件协同教程_2026-09-03.md](/home/steveguo/coralnpu-gesture/gesture_project/docs/HaGRID18_Zynq7020_软硬件协同教程_2026-09-03.md)
- [ZCU104_JTAG首次检测_2026-09-10.md](/home/steveguo/coralnpu-gesture/gesture_project/docs/ZCU104_JTAG首次检测_2026-09-10.md)
- [Bazel缓存与output_base规范.md](/home/steveguo/coralnpu-gesture/gesture_project/docs/Bazel缓存与output_base规范.md)
- [../qwen-analysis.md](/home/steveguo/coralnpu-gesture/qwen-analysis.md)
  - 第三方分析原稿，只用于对照，不能替代上面的项目复核文档。
  - 只读，不作为后续工程的唯一依据。

## 3. 当前保留的核心代码入口

### 算法训练与量化

- [algorithms/README.md](/home/steveguo/coralnpu-gesture/gesture_project/algorithms/README.md)
- [algorithms/static_cnn/train_static_cnn.py](/home/steveguo/coralnpu-gesture/gesture_project/algorithms/static_cnn/train_static_cnn.py)
- [algorithms/static_cnn/quantize_tflite.py](/home/steveguo/coralnpu-gesture/gesture_project/algorithms/static_cnn/quantize_tflite.py)
- [algorithms/landmark_dynamic/train_static_landmark_mlp.py](/home/steveguo/coralnpu-gesture/gesture_project/algorithms/landmark_dynamic/train_static_landmark_mlp.py)
- [algorithms/landmark_dynamic/evaluate_static_cnn_landmark_fusion.py](/home/steveguo/coralnpu-gesture/gesture_project/algorithms/landmark_dynamic/evaluate_static_cnn_landmark_fusion.py)
- [algorithms/mobilenet_candidates/train_mobilenet_candidate.py](/home/steveguo/coralnpu-gesture/gesture_project/algorithms/mobilenet_candidates/train_mobilenet_candidate.py)

### 通用评估与画像

- [algorithms/tools/evaluate_keras_classifier.py](/home/steveguo/coralnpu-gesture/gesture_project/algorithms/tools/evaluate_keras_classifier.py)
- [algorithms/tools/evaluate_tflite_classifier.py](/home/steveguo/coralnpu-gesture/gesture_project/algorithms/tools/evaluate_tflite_classifier.py)
- [algorithms/tools/profile_tflite_ops.py](/home/steveguo/coralnpu-gesture/gesture_project/algorithms/tools/profile_tflite_ops.py)
- [algorithms/tools/estimate_npu_cycles.py](/home/steveguo/coralnpu-gesture/gesture_project/algorithms/tools/estimate_npu_cycles.py)
- [algorithms/tools/compare_model_candidates.py](/home/steveguo/coralnpu-gesture/gesture_project/algorithms/tools/compare_model_candidates.py)
- [algorithms/tools/summarize_candidate_hardware.py](/home/steveguo/coralnpu-gesture/gesture_project/algorithms/tools/summarize_candidate_hardware.py)

## 4. 当前保留的关键结果文件

### 纯卷积保底线

- [../reports/static_cnn_regularized_3x3_i96_e70_hagrid6_sample_keras_eval.json](/home/steveguo/coralnpu-gesture/gesture_project/reports/static_cnn_regularized_3x3_i96_e70_hagrid6_sample_keras_eval.json)
- [../reports/static_cnn_regularized_3x3_i96_e70_hagrid6_sample_tflite_eval.json](/home/steveguo/coralnpu-gesture/gesture_project/reports/static_cnn_regularized_3x3_i96_e70_hagrid6_sample_tflite_eval.json)
- [../reports/static_cnn_regularized_3x3_i96_e70_hagrid6_sample_npucycles.json](/home/steveguo/coralnpu-gesture/gesture_project/reports/static_cnn_regularized_3x3_i96_e70_hagrid6_sample_npucycles.json)
- [../reports/static_cnn_regularized_3x3_i96_e70_hagrid6_sample_hotspots.md](/home/steveguo/coralnpu-gesture/gesture_project/reports/static_cnn_regularized_3x3_i96_e70_hagrid6_sample_hotspots.md)
- [../reports/static_cnn_regularized_3x3_i96_e70_hagrid6_sample_wsl_retrain_20260707_keras_eval_20260728.json](/home/steveguo/coralnpu-gesture/gesture_project/reports/static_cnn_regularized_3x3_i96_e70_hagrid6_sample_wsl_retrain_20260707_keras_eval_20260728.json)

### 关键点与融合路线

- [../reports/hagrid_sample_static_6cls_landmarks_mp21_20260728.json](/home/steveguo/coralnpu-gesture/gesture_project/reports/hagrid_sample_static_6cls_landmarks_mp21_20260728.json)
- [../reports/landmark_static_mlp_mp21_full_20260728_eval.json](/home/steveguo/coralnpu-gesture/gesture_project/reports/landmark_static_mlp_mp21_full_20260728_eval.json)
- [../reports/static_cnn_landmark_fusion_20260728.json](/home/steveguo/coralnpu-gesture/gesture_project/reports/static_cnn_landmark_fusion_20260728.json)
- [../reports/static_cnn_landmark_geom_fusion_20260728.json](/home/steveguo/coralnpu-gesture/gesture_project/reports/static_cnn_landmark_geom_fusion_20260728.json)
- [../reports/static_cnn_landmark_geom_fusion_20260728_script.json](/home/steveguo/coralnpu-gesture/gesture_project/reports/static_cnn_landmark_geom_fusion_20260728_script.json)

### 对照模型摘要

- [../reports/formal_static_candidates_hardware_summary.md](/home/steveguo/coralnpu-gesture/gesture_project/reports/formal_static_candidates_hardware_summary.md)
- [../reports/mobilenet_v2_a050_96_imagenet_frozen_finetune_hagrid6_sample_keras_eval.json](/home/steveguo/coralnpu-gesture/gesture_project/reports/mobilenet_v2_a050_96_imagenet_frozen_finetune_hagrid6_sample_keras_eval.json)
- [../reports/mobilenet_v2_a050_96_imagenet_frozen_finetune_hagrid6_sample_npucycles.json](/home/steveguo/coralnpu-gesture/gesture_project/reports/mobilenet_v2_a050_96_imagenet_frozen_finetune_hagrid6_sample_npucycles.json)

## 5. 已归档但仍可回查的区域

- `gesture_project/board_validation/zynqmini_7z010`
- `gesture_project/worktrees/coralnpu-3x3-conv`
- `gesture_project/docs/` 中旧阶段交接、阶段总结、`strategy8` 系列文档
- `gesture_project/algorithms/tools/` 中旧 `core_3x3 / rowhandoff / strategy8` 工具
- `gesture_project/reports/` 中旧 `core_3x3 / rowhandoff / board` 结果
- `gesture_project/models/` 中多数旧试验模型

这些都已经移到：

- `/home/steveguo/beifen/coralnpu-gesture/2026-07-30_route_cleanup`
