SteveGuo1726/coralnpu-gesture/gesture_project/docs/文档可信度地图_2026-09-12.md

# 文档可信度地图与全量审阅记录（2026-09-12）

> **为什么有这份文档**：用户指出"之前的文档可不止那个项目树，还有很多 md 文件"，
> 并且明确指出：**只有 `会话交接_最高优先级_2026-07-11.md` 是当前一直在记录的，
> 其他文档可能已经过时**。
>
> 我上一版审计（`项目审计与再评估_2026-09-12.md`）只读了 8 份文档就下了结论 ——
> 这是同一个毛病（拿局部当全部）。本文补齐这次**全量审阅**：
> 仓库里共 **56 个 `.md`**（不含只读的 `coralnpu/`），本文逐一判定其时代与可信度。

---

## 0. 判定规则（先立规矩，再逐条判）

### 0.1 三档可信度

| 档 | 含义 | 采信方式 |
|---|---|---|
| **A · 权威** | 编号章节形式的交接记录（146→147 号，倒序） | **直接采信**，冲突时以它为准 |
| **B · 当前有效** | 2026-09-01 之后的专题文档 | 采信，但需与 A 交叉核对 |
| **C · 历史/已过时** | 2026-08 及更早的路线、判断、清单类文档 | **只作背景，不得作为当前状态依据** |

### 0.2 ⚠️ 一个必须知道的陷阱：交接文档自己的尾部章节是**冻结**的

`会话交接_最高优先级_2026-07-11.md` 结构是：

```
第 1–93 行     147 号（最新）……倒序编号章节  ……第 5254 行  1 号（最早）
第 5255 行     ## 文档使用规则        ← 非编号，冻结
第 5266 行     ## 当前有效结论        ← 非编号，冻结   ★名字叫"当前"，实际停在 2026-08-02
第 5783 行     ## 下一轮执行入口      ← 非编号，冻结
第 5814 行     ## 固定工程规则        ← 非编号（规则本身仍然有效）
```

**我用它的内容反推了它的日期**：那三个章节里最新的事件是 **2026-08-02**，
最新出现的实验是 `vme_tile_roundtrip`、`MAC_VRF拓展`、`RepVGG+landmark 94.62%`。
它们**完全没有** DMP、HaGRID-18、98.88%、ZCU104、41.9 FPS、PetaLinux 这些
从 08-25 起就已成为主线的东西。

⇒ **`## 当前有效结论` 这个标题是误导性的。它是一份"2026-08-02 快照"，不是当前结论。**
只有**带编号的章节**才是当前在记录的。

**这是本次审阅最有价值的一条**：任何人（包括我）如果只读尾部"当前有效结论"，
会得到一份 6 周前的项目画像，且与真实主线完全不同。

---

## 1. 全量判定表（56 份，按可信度分档）

### A · 权威（1 份）

| 文档 | 说明 |
|---|---|
| `docs/会话交接_最高优先级_2026-07-11.md` | **唯一持续记录**。147 条编号章节倒序。**只读编号章节**；尾部三个非编号章节视为 08-02 快照。 |

### B · 当前有效（2026-09-01 之后）

| 文档 | 日期 | 与 A 是否一致 |
|---|---|---|
| `docs/项目完整上下文_Windows工作区版_2026-09-12.md` | 09-12 | ✅ 一致，目前**最完整的自包含上文** |
| `docs/ZCU104_Linux侧NPU与摄像头_设计与实施_2026-09-12.md` | 09-12 | ✅ 当前主线设计 |
| `docs/ZCU104_上板操作卡_2026-09-12.md` | 09-12 | ✅ 操作入口 |
| `docs/ZCU104_源码投放与镜像校验_2026-09-12.md` | 09-12 | ✅ 已按修正后的结论重写 |
| `docs/项目审计与再评估_2026-09-12.md` | 09-12 | ✅ 自我审计（本文是其补充） |
| `docs/ZCU104_下一代GestureFlow-NPU_推进计划_2026-09-11.md` | 09-11 | ✅ 路线计划 |
| `docs/ZCU104_上板前审查与修订方案_2026-09-11.md` | 09-11 | ✅ 取证方法论范本 |
| `docs/ZCU104_综合根因与上板成果_2026-09-11.md` | 09-11 | ✅ 综合根因（WSL 管道）+ 时序资源 |
| `docs/ZCU104_JTAG首次检测_2026-09-10.md` | 09-10 | ✅ |
| `docs/ZCU104_摄像头实时手势_实施计划_2026-09-11.md` | 09-11 | ⚠️ **已被 `ZCU104_Linux侧...` 取代**（该文自称的前身） |
| `board_zcu104/plnx/PITFALLS.md` | 09-12 | ✅ 实测踩坑 |
| `docs/HaGRID18_Zynq7020_软硬件协同教程_2026-09-03.md` | 09-03 | ✅ README 标注的"第一入口"（59 KB，未逐行读完） |
| `docs/GestureFlow_DMP双乘打包_质的飞跃_2026-09-01.md` | 09-01 | ⚠️ §4 说"DMP 引擎尚未接入主链"，但当天 136 号已完成 8-lane 整网集成 ⇒ **比 A 慢半步** |
| `docs/GestureFlow_静态动态统一硬件架构_2026-08-31.md` | 08-31 | ✅ **动态手势路线的权威文档**（见 §3） |
| `docs/GestureFlow-NPU_从零入门完全指南_2026-08-31.md` | 08-31 | ✅ 教学文档（64 KB，未逐行读完） |
| `docs/GestureFlow_18类学生模型硬件契合度与创新方向_2026-08-28.md` | 08-28 | ✅ 逐层 MAC/权重账目，与代码一致 |
| `docs/GestureFlow_算法与软硬件协同全景_2026-08-27.md` | 08-27 | ✅ |
| `docs/GestureFlow架构级突破路线_2026-08-26.md` | 08-26 | ✅ |
| `docs/权重驻留的架构真相_2026-08-26.md` | 08-26 | ✅ **架构边界的重要纠正**（32 KB SRAM vs ~200 KB 权重） |
| `README.md`（根） | 09-12 | ✅ 与实板一致 |
| `gesture_project/README.md` | 09-12 | ⚠️ **模型结构图有错，见 §2.2** |

### C · 历史 / 已过时（绝大部分是 2026-07-30 ~ 08-25 时代）

| 文档 | 时代 | 为什么过时 |
|---|---|---|
| `docs/qwen分析复核与后续路线_2026-08-01.md` | 08-01 | CoralNPU 源码复核；针对"RVV/VME 主线"，非当前 |
| `docs/MAC_VRF拓展与算法协同优先级_2026-08-02.md` | 08-02 | 针对 CoralNPU `MAC/VRF` 单元，当前自研 RTL 无此结构 |
| `docs/2026-08-04_ZYNQ7020板级验证与CoralNPU官方可行性评估.md` | 08-04 | RVV/CoralNPU 板级探索；**其"官方 Nexus 顶层不能直接烧 7020"的结论仍有效** |
| `docs/CoralNPU官方仓库源码分析_当前准确判断_2026-07-30.md` | 07-30 | 官方源码结构判断；**作为"CoralNPU 到底是什么"的背景仍有效** |
| `docs/CoralNPU与轻量NPU微架构协同优化要求_2026-08-21.md` | 08-21 | 协同要求；部分已落地 |
| `docs/FZ3A与CoralNPU适配评估_2026-08-09.md` | 08-09 | 平台选型，已放弃 |
| `docs/7020帧率优化完整方案与可行性评估_2026-08-21.md` | 08-21 | **性能数字已过时（25MHz/4.7FPS/6类）**，但 **§1.0 与 §1.4 的六条架构硬门禁仍然有效**，是项目价值观来源 |
| `docs/7020阶段_GestureFlow设计复盘与突破路线_2026-08-25.md` | 08-25 | 复盘；早于 DMP |
| `docs/板测流程复现与修复日志_2026-08-26.md` | 08-26 | 板测流程，部分被 ZCU104 取代 |
| `docs/手势识别算法选择与未来硬件协同方案_2026-07-30.md` | 07-30 | 算法选型，早于 18 类蒸馏 |
| `docs/静态手势数据集候选与主线判定_2026-08-14.md` | 08-14 | 数据集选型，早于 HaGRID-18 定稿 |
| `docs/数据集重选与产品任务定义_2026-08-14.md` | 08-14 | 同上 |
| `docs/环境配置与运行注意事项_2026-07-30.md` | 07-30 | 环境（**代理/Bazel 规则可能仍有参考价值**） |
| `docs/工程续接与文档规范_2026-07-30.md` | 07-30 | 规范；**其"续接规则/禁忌"仍有价值** |
| `docs/工程文件索引.md` | ~07-30 | **索引已过时**（指向 6 类/3×3 时代） |
| `docs/仓库共享版_活跃代码与文件说明.md` | ~07-30 | **"当前活跃"清单已过时**（仍写 3×3/landmark/6 类） |
| `docs/Bazel缓存与output_base规范.md` | ~08 | Bazel 规范，与当前主线无关 |
| `innovation_npu/README.md` | ~08-16 | **停在 v0**：写 `16×4 MAC`、`gf64`、activation-staging；与最终 **DMP 16×8 / 8-lane** 完全不符 |
| `reports/official_coralnpu_sim_validation_2026-07-30.md` | 07-30 | 官方模拟器实测记录（**方法仍可复用**） |
| `reports/coralnpu_fit_candidates_20260730_summary.md` | 07-30 | 候选排序，过时 |
| `reports/formal_static_candidates_hardware_summary.md` | 07-31 | 过时（早于 18 类） |
| `reports/*_hotspots.md`（2 份） | 07-31 | 过时（6 类模型） |
| `algorithms/README.md`、`algorithms/mobilenet_candidates/README.md`、`datasets/README.md`、`board_validation/README.md` | 07~08 | 目录说明，`datasets/README.md` 有"数据分层勿混写"的警告仍值得看 |
| `learning/RVV/RVV硬件学习指南.md` | ~08 | **RVV 学习资料**。项目已不走 RVV 主线，但作为"CoralNPU 到底是什么"的知识底仍是资产 |
| `qwen-analysis.md`（根） | 07-30 前 | 第三方分析原稿。**已被 `qwen分析复核与后续路线` 逐条复核并降级**，不得直接引用 |
| `innovation_npu/backup_original_2026-09-01/README.md` | 09-01 | 备份说明（303 行清单） |

---

## 2. 审阅中发现的**具体矛盾**（都有证据）

### 2.1 交接文档尾部"当前有效结论"是 08-02 快照（最严重）

见 §0.2。它的内容与编号章节的冲突是**整代际**的：

| 尾部章节（冻结于 08-02）说 | 编号章节（真实主线）说 |
|---|---|
| 静态最优 = RepVGG 图像分支 + landmark MLP，**94.62%** | 18 类 HaGRID 蒸馏学生，**98.88%** |
| 纯卷积保底线 = `static_cnn_regularized_3x3`，**79.24%** | 18 类全 4×4 学生网络 |
| 算法核心是 **3×3** + landmark + 融合 | 全 **4×4** + 1×1 head + GAP/FC，无 landmark |
| 动态路线 = landmark sequence + **GRU/TCN** | 逐帧复用空间骨干 + **时序 shift/summary/fusion**（零 MAC） |
| 硬件 = **空间卷积后端 + 稠密矩阵后端**（双后端） | 单一自研 GestureFlow-NPU（DMP 16×8） |
| VME 矩阵通路未打通，`tile move` 未坐实 | 已完全转向自研 RTL，与 CoralNPU VME 无关 |
| `7Z010` 已归档 | 早已推进到 7020 → ZCU104 |

### 2.2 `gesture_project/README.md` 的模型结构图**少画了一层**（已核实）

README 写的是：
```
conv0 4×4 3→16 → pool1 → conv2a 16→32 → conv2b 32→32 → pool2
              → conv3a 32→48 → conv3b 48→48 → pool3 → head 1×1 48→64 → GAP → FC
```
**缺了 `16→16` 那一层，且 pool1 的位置因此也不对。**

**证据（第一手：权重头文件）** `innovation_npu/board_7020/software/` 下实际存在：
```
gestureflow_dmp_full_layer.h        （conv0  3→16）
gestureflow_dmp_body2_layer.h       （body2  16→16）   ← README 漏掉的就是这个
gestureflow_dmp_conv2a_layer.h      （conv2a 16→32）
gestureflow_dmp_conv2b_layer.h      （conv2b 32→32）
gestureflow_dmp_conv3a_layer.h      （conv3a 32→48）
gestureflow_dmp_conv3b_layer.h      （conv3b 48→48）
gestureflow_dmp_head1x1_layer.h     （head   48→64）
gestureflow_real_maxpool2d.h / _pool2.h / _pool3.h
gestureflow_real_gap_fc.h
```
= **6 个 4×4 + 1 个 1×1 + 3 MaxPool + GAP/FC**，与 `GestureFlow_静态动态统一硬件架构`
和 `项目完整上下文` 的写法一致，与 README 不一致。

⇒ 正确链路（以代码为准）：
```
RGB 96×96×3
 → conv0  4×4 3→16
 → body2  4×4 16→16   + pool1  → 48×48×16
 → conv2a 4×4 16→32
 → conv2b 4×4 32→32   + pool2  → 24×24×32
 → conv3a 4×4 32→48
 → conv3b 4×4 48→48   + pool3  → 12×12×48
 → head   1×1 48→64            → 12×12×64
 → GAP(64) → FC(64→18) → argmax
```

### 2.3 `innovation_npu/README.md` 停在 v0

它描述的是 `16 输出 × 4 输入`（`gf64`）与 `gestureflow_activation_bank` /
`gestureflow_axil_microkernel` 的 25 MHz 实板基线（`263` cycles / 1.557 GMAC/s）。
**这与最终形态（DMP `16 输出 × 8 输入`、8-lane、80 MHz/100 MHz 整网）不是同一个设计。**

### 2.4 索引类文档全部过时

`工程文件索引.md`、`仓库共享版_活跃代码与文件说明.md` 都把"当前活跃"指向
`static_cnn_regularized_3x3_i96_e70_hagrid6_sample`（6 类、3×3）与 landmark 路线。
按这两份索引接手，会直接走错方向。

---

## 3. 对上一版审计的**更正**

我上一版审计的 A 部分（自我审计）**全部成立**，不撤回。
B 部分（项目再评估）需要**两处更正与一处加强**：

### 3.1 更正一：项目历史比我说得长得多，且有过一次**有意的**路线分叉

我说"项目是自研 RTL、与 CoralNPU 无代码继承"——这句本身没错，
但我漏掉了**它经历过什么**。真实分期（全部取自编号章节）：

| 时期 | 内容 |
|---|---|
| 2026-08-02 ~ 08-09 | **RVV / CoralNPU 探索期**：官方 worktree 仿真、`CoreMiniAxi` 板上执行 RISC-V 程序、lane1 VMACC、LSU→AXI→HP0→DDR 闭环。**这一段真的是"基于 Coral NPU"在做** |
| 08-09 ~ 08-17 | **转自研**：`RvvCoreMiniAxi` 416K LUT 不适合 7020；转向自研 GestureFlow-NPU；真实 TFLite 层逐个闭环 |
| 08-17 ~ 08-25 | HP0 DDR 接续、descriptor 主线、relay bank、pool 融合 |
| 08-25 ~ 09-01 | 80 MHz 提频（频率墙=布线拥塞）、**DMP 落地**、18 类模型 |
| 09-01 ~ 09-02 | DMP 8-lane 整网集成、**41.9 FPS 稳定代** |
| 09-10 ~ 09-12 | ZCU104 移植、PetaLinux、Linux 用户态 |

**关键**：`7020帧率优化完整方案_2026-08-21.md §1.0` **明确写着**
"本项目当前的 Zynq-7020 PL **不包含 CoralNPU 完整标量前端**……
任何把当前 7020 自研模块称为'CoralNPU 标量核心'或'官方 CoralNPU RVV'**均为错误表述**"。

⇒ 所以"申请书说基于 Coral NPU 二次开发、实际是自研 RTL"**不是遗漏，是一次有记录的、
有理由的路线决策**（官方 RVV 对 7020 太大）。这比"跑偏了"要轻得多 ——
但**口径仍需与导师对齐**，因为申请书是正式文件。

### 3.2 更正二：动态手势并非"零基础"，项目已有明确规划与 RTL 积木

我说"LSTM / 动态手势完全没做"——**"没上板"是对的，但"没做"是错的**。
`GestureFlow_静态动态统一硬件架构_2026-08-31.md` 已经给出：

- 动态模型结构（`algorithms/temporal_cnn/gesture_temporal_model.py`）：
  逐帧空间骨干（与静态**同类算子**）→ 逐帧 GAP → 96 维/帧 →
  `temporal shift`（零 MAC）+ `temporal_summary`(mean/max/delta) + `temporal_fusion 1×1(288→96)` + `FC(96→14)`
- **决策：时序积累默认放 PS**（数据仅 768 字节、算量约 3 万 MAC，比空间部分小 3~4 个数量级）
- 已落地 RTL：`gestureflow_temporal_accumulator.sv`（零 MAC 片上规约引擎，挂在 GAP 之后）
- 静态与动态**唯一区别在尾部**，空间骨干完全复用

⇒ **这正好是我建议的"选项 A"**，而且比我说的更成熟（已有模型定义 + 已有 RTL）。
**但要注意**：这套方案用的是 `shift + summary + fusion`，**不是 LSTM**。
申请书写的是"LSTM 专用处理子模块" ⇒ **这里也有一个口径需要对齐**。

### 3.3 加强：`≤5 ms` 的判断不变，但依据更硬

`ZCU104_综合根因与上板成果_2026-09-11.md` §6 给出 `WNS +2.751 ns @ 100 MHz`
（10 ns 周期还剩 2.751 ns）⇒ 理论 ≥137 MHz 仍可收敛。
与我上一版给的"提频到 137 MHz"一致。**结论不变**：
去 CPU 开销（≈18 ms）+ 提频 137 MHz（≈13.4 ms）后仍 > 5 ms，
单帧串行 + 16-lane 架构下达不到。

---

## 4. 结论：接手时该怎么读文档

1. **只把 `会话交接` 的编号章节当权威**（`## 147` 往下）。尾部 `## 当前有效结论`
   是 2026-08-02 快照，**不要读它来判断现状**。
2. **要一份准确的现状全景** → 读 `docs/项目完整上下文_Windows工作区版_2026-09-12.md`。
3. **要动手上板** → 读 `docs/ZCU104_上板操作卡_2026-09-12.md` + `board_zcu104/plnx/PITFALLS.md`。
4. **要理解算法↔硬件账目** → `GestureFlow_18类学生模型硬件契合度与创新方向_2026-08-28.md`。
5. **要理解 DMP 创新** → `GestureFlow_DMP双乘打包_质的飞跃_2026-09-01.md`。
6. **要理解动态手势路线** → `GestureFlow_静态动态统一硬件架构_2026-08-31.md`。
7. **要理解架构价值观（六条硬门禁）** → `7020帧率优化完整方案…_2026-08-21.md` §1.0/§1.4
   （**只看这两节**，性能数字已过时）。
8. **`工程文件索引.md` / `仓库共享版_活跃代码与文件说明.md` / `innovation_npu/README.md`
   目前不可用于判断"当前主线"** —— 它们停在 07-30 ~ 08-16。

### 建议的后续动作（需用户确认）

- 这四份过时入口文档（`工程文件索引.md`、`仓库共享版_活跃代码与文件说明.md`、
  `innovation_npu/README.md`、`gesture_project/README.md` 的模型图）
  **应在文件顶部加一个醒目的"本文已过时，当前主线见 …"横幅**，
  而不是删除（保留历史价值）。这属于文档卫生，成本极低，但能防止下一个人（或我）再走错。
- `会话交接` 尾部那三个非编号章节建议加同样的横幅，
  或直接改名为 `## 历史快照（2026-08-02，仅供追溯）`。

---

*本文为全量审阅记录。凡标 [实测]/[第一手] 的结论都可在仓库里复核；
凡属推断的都已注明。*
