SteveGuo1726/coralnpu-gesture/gesture_project/docs/项目完整上下文_Windows工作区版_2026-09-12.md

# coralnpu-gesture 项目完整上下文（Windows 工作区版）

> **本文用途**：把 Ubuntu 侧项目仓库的日志与关键文档通读后，在 Windows 工作区形成一份
> 自包含的上文。任何人（或 AI）只读这一份，就能理解这个项目在做什么、做到哪、怎么继续。
>
> **整理时间**：2026-09-12 凌晨
> **仓库**：<https://github.com/SteveGuo1726/coralnpu-gesture>（public，`main`）
> **Ubuntu 端**：`/home/steveguo/coralnpu-gesture`（61 GB，其中 60 GB 是 `.gitignore` 掉的构建产物；**git 只跟踪 1168 个文件**）
> **Windows 端**：`C:\Users\SteveGuo\Documents\coralnpu-gesture`（本文所在，已是同一仓库的克隆）
>
> **同步工具**：仓库根目录 `sync_repo.sh`（用法见 `bash sync_repo.sh` 无参数时的帮助）

---
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
