SteveGuo1726/coralnpu-gesture/gesture_project/docs/artifacts/zcu104_camera_96x96_settled_2026-09-12.png

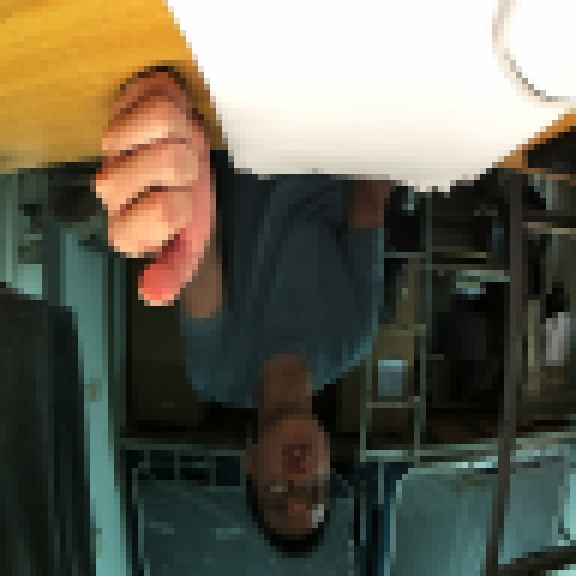
gesture_project/docs/artifacts/zcu104_camera_96x96_settled_2026-09-12.png
