SteveGuo1726/coralnpu-gesture/gesture_project/board_validation/README.md

# board_validation 目录说明

`2026-07-30` 起，之前围绕 `ZynqMini 7Z010` 的板级试验材料已经整体移出当前活跃树，归档到：

- `/home/steveguo/beifen/coralnpu-gesture/2026-07-30_route_cleanup/gesture_project/board_validation/zynqmini_7z010`

当前这个目录先只保留说明文件，避免后续继续把已经过时的 `7Z010` 妥协版路线误当成当前主线。

如果未来重新开展板级验证，应基于新的目标硬件与新的主线文档，在这里重新建立新的子目录与新的入口说明。
