SteveGuo1726/coralnpu-gesture/gesture_project/reports/2026-09-12_A2_crops_test200/predictions.csv

name | true | pred | p_max | margin | entropy | correct
call/000422c8-2e41-4611-9783-c6d219bea42e.jpg | call | call | 0.925781 | 0.917969 | 0.455874 | 1
call/01db912f-5da0-49ec-8d11-58dd6116a6c6.jpg | call | call | 0.941406 | 0.929688 | 0.412203 | 1
call/02ac9ce7-92ed-4175-bda6-ed68bac0e356.jpg | call | call | 0.972656 | 0.968750 | 0.113610 | 1
call/03bfd09a-4e43-4d75-b10b-e2dad3b35024.jpg | call | call | 0.953125 | 0.949219 | 0.413993 | 1
call/04e94fa5-74d9-4c06-b6fb-4f2b15f38353.jpg | call | call | 0.953125 | 0.949219 | 0.392332 | 1
call/0604cb20-202f-4807-ac62-dea04e4b3206.jpg | call | call | 0.652344 | 0.546875 | 1.509614 | 1
call/0755a81f-ae5f-45f3-912a-6584728ccab2.jpg | call | call | 0.964844 | 0.960938 | 0.294461 | 1
call/087d546e-6645-4f35-8754-0bb463f5d944.jpg | call | call | 0.957031 | 0.953125 | 0.366945 | 1
call/09e84d97-56b7-4661-aca3-dccc1831df3b.jpg | call | call | 0.957031 | 0.953125 | 0.301962 | 1
call/0b0ec7ca-5f42-4784-8389-c3dff7ae066a.jpg | call | call | 0.937500 | 0.933594 | 0.428739 | 1
call/0ca11393-145d-43e5-a3b1-f259d75e8b76.jpg | call | call | 0.945312 | 0.937500 | 0.437644 | 1
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
