SteveGuo1726/coralnpu-gesture/gesture_project/docs/板测流程复现与修复日志_2026-08-26.md

# 板测流程复现与修复日志 2026-08-26

## 1. 结论

本轮成功把完整烧板流程跑通一遍，`FINAL_RESULT = 0x600D600D`，各层 FNV 与 golden 完全一致。**发现并修复了一个会直接导致流程失败的端口错配：hw_server 实际跑在 `TCP:127.0.0.1:3121`，但发布脚本默认连 `3334`。**

## 2. 环境探测结果

- WSL2 Ubuntu 22.04，Windows 侧 Vivado/Vitis 2023.2。
- `hw_server.exe` 正在运行，命令行：

```text
E:/Xilinx/Vivado/2023.2/bin/unwrapped/win64.o/hw_server.exe -D -I20 -s TCP:127.0.0.1:3121
```

- 通过 `xsct.bat` 连接 `3121` 后，JTAG 目标正常：

```text
1  APU
   2  ARM Cortex-A9 MPCore #0 (Running)
   3  ARM Cortex-A9 MPCore #1 (Running)
4  xc7z020
```

- 最新产物：

```text
logs/gestureflow_wide80_postprocess_7020.bit   (08-25 23:22:40)
logs/gestureflow_wide80_postprocess_7020.xsa   (08-25 23:23:14)
vitis/axi_gpio_80cin_postprocess/Debug/...elf  (08-25 23:24:15)
```

## 3. 修复内容

`innovation_npu/board_7020/run_board_wide80_postprocess_from_wsl.sh` 原 cmd.exe 调用未设置 `GESTUREFLOW_HW_SERVER_URL`，导致 TCL 默认 `tcp:127.0.0.1:3334`。已改为显式传入：

```text
set GESTUREFLOW_HW_SERVER_URL=tcp:127.0.0.1:3121
```

同时新增 `innovation_npu/board_7020/board_status.sh` 和 `innovation_npu/board_7020/scripts/probe_hw_targets.tcl`，用于只读探测 hw_server 端口与 JTAG 目标，不烧板。

## 4. 本轮实测板测结果

```text
GESTUREFLOW_LAYER_CHAIN_HP0_FINAL_RESULT = 0x600D600D
GESTUREFLOW_LAYER_CHAIN_HP0_PROBE[122]   = 0x53C6484E   (head FNV)
GESTUREFLOW_LAYER_CHAIN_HP0_PROBE[124]   = 0xABBC5831   (GAP FNV)
GESTUREFLOW_LAYER_CHAIN_HP0_PROBE[125]   = 0xDDE32561   (FC FNV)
GESTUREFLOW_LAYER_CHAIN_HP0_FULL_NETWORK_BOARD_PASS
```

性能计数器（`PROBE[130..133]`，约 333.333 MHz global timer）：

| 项 | 十六进制 | 十进制 ticks | 估算 |
|---|---|---|---|
| 整帧 | 0x0B1EAA2E | 186,408,494 | 约 559 ms |
| 输入准备 | 0x00081C67 | 531,559 | 约 1.59 ms |
| 权重/量化装载 | 0x0244FDF3 | 38,095,859 | 约 114 ms |
| PL 周期总和 | 0x0043EA9F | 4,452,959 | 25 MHz 下约 178 ms |

> 注意：当前 bit 是 `wide80_postprocess` 完整证明模式（`GF_FAST_RELEASE=0`），不是发布快速路径，因此整帧比历史 `writer-burst` 快速路径更长。权重装载仍是每帧 AXI-Lite 重装（约 114 ms），与架构路线 B1 一致，尚未切换到权重驻留 + PL DMA。

## 5. 烧板流程固定命令

```bash
cd /home/steveguo/coralnpu-gesture/gesture_project/innovation_npu/board_7020
bash board_status.sh                          # 只读探测，不烧板
bash run_board_wide80_postprocess_from_wsl.sh  # 烧 bit + 下载 ELF + 轮询结果
```

后续若 hw_server 重启到非 3121 端口，只需改 `board_status.sh` 或 `run_board_wide80_postprocess_from_wsl.sh` 里的 `GESTUREFLOW_HW_SERVER_URL`，无需改 TCL。
