SteveGuo1726/coralnpu-gesture/gesture_project/models/hagrid_v1_500k_384p_targethand_student_4x4_rvv_distill_20260827/history.csv

epoch | accuracy | distill_loss | learning_rate | loss | supervised_loss | val_accuracy | val_distill_loss | val_loss | val_supervised_loss
0 | 0.4592832922935486 | 1.8336964845657349 | 0.00015999999595806003 | 1.8962130546569824 | 1.9298774003982544 | 0.6807926297187805 | 0.0 | 1.38566255569458 | 1.38566255569458
1 | 0.7988511323928833 | 1.1801685094833374 | 0.00031999999191612005 | 1.1313499212265015 | 1.105064034461975 | 0.8685199618339539 | 0.0 | 0.8745167255401611 | 0.8745167255401611
2 | 0.8913596272468567 | 0.8322421908378601 | 0.0004799999878741801 | 0.8365805745124817 | 0.8389140963554382 | 0.9308341145515442 | 0.0 | 0.6642193794250488 | 0.6642193794250488
3 | 0.9210152626037598 | 0.666606068611145 | 0.0006399999838322401 | 0.7163180112838745 | 0.7430843710899353 | 0.9478124380111694 | 0.0 | 0.5639907717704773 | 0.5639907717704773
4 | 0.9353049993515015 | 0.5724869966506958 | 0.0007999999797903001 | 0.6510007381439209 | 0.6932761073112488 | 0.9151084423065186 | 0.0 | 0.6451289057731628 | 0.6451289057731628
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
