SteveGuo1726/coralnpu-gesture/gesture_project/board_validation/zynq7020_coralnpu_official/current/rtl/rvv_accel_lane1/pa_fdsu_pack_single.v

/*Copyright 2020-2021 T-Head Semiconductor Co., Ltd.

Licensed under the Apache License, Version 2.0 (the "License");
you may not use this file except in compliance with the License.
You may obtain a copy of the License at

    http://www.apache.org/licenses/LICENSE-2.0

Unless required by applicable law or agreed to in writing, software
distributed under the License is distributed on an "AS IS" BASIS,
WITHOUT WARRANTIES OR CONDITIONS OF ANY KIND, either express or implied.
See the License for the specific language governing permissions and
limitations under the License.
*/

// &ModuleBeg; @23
module pa_fdsu_pack_single(
  fdsu_ex4_denorm_to_tiny_frac,
  fdsu_ex4_frac,
  fdsu_ex4_nx,
  fdsu_ex4_potnt_norm,
  fdsu_ex4_result_nor,
  fdsu_frbus_data,
  fdsu_frbus_fflags,
  fdsu_frbus_freg,
  fdsu_yy_expnt_rst,
  fdsu_yy_of,
  fdsu_yy_of_rm_lfn,
  fdsu_yy_potnt_of,
  fdsu_yy_potnt_uf,
  fdsu_yy_result_inf,
  fdsu_yy_result_lfn,
  fdsu_yy_result_sign,
  fdsu_yy_rslt_denorm,
  fdsu_yy_uf,
  fdsu_yy_wb_freg
);

// &Ports; @24
input           fdsu_ex4_denorm_to_tiny_frac; 
input   [25:0]  fdsu_ex4_frac;               
input           fdsu_ex4_nx;                 
input   [1 :0]  fdsu_ex4_potnt_norm;         
input           fdsu_ex4_result_nor;         
input   [9 :0]  fdsu_yy_expnt_rst;           
input           fdsu_yy_of;                  
input           fdsu_yy_of_rm_lfn;           
input           fdsu_yy_potnt_of;            
input           fdsu_yy_potnt_uf;            
input           fdsu_yy_result_inf;          
input           fdsu_yy_result_lfn;          
input           fdsu_yy_result_sign;         
input           fdsu_yy_rslt_denorm;         
input           fdsu_yy_uf;                  
input   [4 :0]  fdsu_yy_wb_freg;             
output  [31:0]  fdsu_frbus_data;             
output  [4 :0]  fdsu_frbus_fflags;           
output  [4 :0]  fdsu_frbus_freg;             

// &Regs; @25
reg     [22:0]  ex4_frac_23;                 
reg     [31:0]  ex4_result;                  
reg     [22:0]  ex4_single_denorm_frac;      
reg     [9 :0]  expnt_add_op1;               

// &Wires; @26
wire            ex4_cor_nx;                  
wire            ex4_cor_uf;                  
wire            ex4_denorm_potnt_norm;       
wire    [31:0]  ex4_denorm_result;           
wire    [9 :0]  ex4_expnt_rst;               
wire    [4 :0]  ex4_expt;                    
wire            ex4_final_rst_norm;          
wire    [25:0]  ex4_frac;                    
wire            ex4_of_plus;                 
wire            ex4_result_inf;              
wire            ex4_result_lfn;              
wire            ex4_rslt_denorm;             
wire    [31:0]  ex4_rst_inf;                 
wire    [31:0]  ex4_rst_lfn;                 
wire            ex4_rst_nor;                 
wire    [31:0]  ex4_rst_norm;                
wire            ex4_uf_plus;                 
wire            fdsu_ex4_denorm_to_tiny_frac; 
wire            fdsu_ex4_dz;                 
wire    [9 :0]  fdsu_ex4_expnt_rst;          
wire    [25:0]  fdsu_ex4_frac;               
wire            fdsu_ex4_nv;                 
wire            fdsu_ex4_nx;                 
wire            fdsu_ex4_of;                 
wire            fdsu_ex4_of_rst_lfn;         
wire    [1 :0]  fdsu_ex4_potnt_norm;         
wire            fdsu_ex4_potnt_of;           
wire            fdsu_ex4_potnt_uf;           
wire            fdsu_ex4_result_inf;         
wire            fdsu_ex4_result_lfn;         
wire            fdsu_ex4_result_nor;         
wire            fdsu_ex4_result_sign;        
wire            fdsu_ex4_rslt_denorm;        
wire            fdsu_ex4_uf;                 
wire    [31:0]  fdsu_frbus_data;             
wire    [4 :0]  fdsu_frbus_fflags;           
wire    [4 :0]  fdsu_frbus_freg;             
wire    [9 :0]  fdsu_yy_expnt_rst;           
wire            fdsu_yy_of;                  
wire            fdsu_yy_of_rm_lfn;           
wire            fdsu_yy_potnt_of;            
wire            fdsu_yy_potnt_uf;            
wire            fdsu_yy_result_inf;          
wire            fdsu_yy_result_lfn;          
wire            fdsu_yy_result_sign;         
wire            fdsu_yy_rslt_denorm;         
wire            fdsu_yy_uf;                  
wire    [4 :0]  fdsu_yy_wb_freg;             


assign fdsu_ex4_result_sign     = fdsu_yy_result_sign;
assign fdsu_ex4_of_rst_lfn      = fdsu_yy_of_rm_lfn;
assign fdsu_ex4_result_inf      = fdsu_yy_result_inf;
assign fdsu_ex4_result_lfn      = fdsu_yy_result_lfn;
assign fdsu_ex4_of              = fdsu_yy_of;
assign fdsu_ex4_uf              = fdsu_yy_uf;
assign fdsu_ex4_potnt_of        = fdsu_yy_potnt_of;
assign fdsu_ex4_potnt_uf        = fdsu_yy_potnt_uf;
assign fdsu_ex4_nv              = 1'b0;
assign fdsu_ex4_dz              = 1'b0;
assign fdsu_ex4_expnt_rst[9:0] = fdsu_yy_expnt_rst[9:0];
assign fdsu_ex4_rslt_denorm     = fdsu_yy_rslt_denorm;
//============================EX4 STAGE=====================
assign ex4_frac[25:0] = fdsu_ex4_frac[25:0];
//exponent adder
// &CombBeg; @43
always @( ex4_frac[25:24])
begin
casez(ex4_frac[25:24])
  2'b00   : expnt_add_op1[9:0] = 10'h1ff;  //the expnt sub 1
  2'b01   : expnt_add_op1[9:0] = 10'h0;    //the expnt stay the origi
  2'b1?   : expnt_add_op1[9:0] = 10'h1;    // the exptn add 1
  default : expnt_add_op1[9:0] = 10'b0;  
endcase
// &CombEnd; @50
end
assign ex4_expnt_rst[9:0] = fdsu_ex4_expnt_rst[9:0] + 
                             expnt_add_op1[9:0];

//==========================Result Pack=====================
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
