SteveGuo1726/coralnpu-gesture/gesture_project/board_validation/zynq7020_coralnpu_official/current/rtl/rvv_accel_lane1/rvv_lsu_axi_bridge_unit_stride_e32.sv

// PROJECT_LOCAL_MOD: LSU-to-AXI bridge for the accelerator-only lane1 wrapper.
// The implemented board configuration is VLEN=64, so this bridge supports
// unit-stride e32 transfers of one or two elements as a single AXI burst. It
// deliberately rejects wider transfers; a future VLEN=128 build must widen
// this bridge and be requalified on hardware rather than silently truncating.
`timescale 1ns / 1ps

module rvv_lsu_axi_bridge_unit_stride_e32 (
    input  wire         aclk,
    input  wire         aresetn,

    // Latched instruction context from the PS issue path.
    input  wire         ctx_valid,
    input  wire         ctx_is_store,
    input  wire         ctx_supported,
    input  wire [1:0]   ctx_elem_count,
    input  wire [31:0]  ctx_base_addr,

    // RVV LSU side from the core.
    input  wire         rvv2lsu_valid,
    input  wire         rvv2lsu_idx_valid,
    input  wire [4:0]   rvv2lsu_idx_addr,
    input  wire [127:0] rvv2lsu_idx_data,
    input  wire         rvv2lsu_vregfile_valid,
    input  wire [4:0]   rvv2lsu_vregfile_addr,
    input  wire [127:0] rvv2lsu_vregfile_data,
    input  wire         rvv2lsu_v0_valid,
    input  wire [15:0]  rvv2lsu_v0_data,
    output wire         rvv2lsu_ready,

    output reg          lsu2rvv_valid,
    output reg  [4:0]   lsu2rvv_addr,
    output reg  [127:0] lsu2rvv_data,
    output reg          lsu2rvv_last,
    input  wire         lsu2rvv_ready,
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
