SteveGuo1726/coralnpu-gesture/(commit log)

2026-07-12 Track active zynqmini board-validation sources
2026-07-12 Run real quantized WIN3 board fragments
2026-07-12 Replay real WIN3 full rows on board
2026-07-12 Replay real WIN3 multi-channel rows on board
2026-07-13 Track quantized WIN3 board row replays
2026-07-13 Extend WIN3 board replay coverage
2026-08-01 重新审视coralnpu硬件架构并使用融合算法大幅度提高准确率
2026-08-08 建立7020真实手势链实板基线
2026-08-08 实板验证真实3x3张量加速层
2026-08-08 实板贯通3x3卷积与最大池化
2026-08-08 实板接力池化输出至RVV分类后段
2026-08-08 实板验证stage3b DDR突发数据通路
2026-08-08 实板直写RVV e32池化特征
2026-08-16 feat: add GestureFlow AXI-Lite board baseline
2026-08-16 fix: harden GestureFlow BRAM reset controls
    [gestureflow_axil_microkernel.sv, gestureflow_mac_tile.sv]
2026-08-16 feat: stage GestureFlow activations in BRAM
2026-08-16 feat: configure staged GestureFlow layer jobs
2026-08-16 fix: verify real GestureFlow conv window on board
    [gestureflow_mac_tile.sv]
2026-08-16 feat: define GestureFlow camera stream ingress
2026-08-16 feat: add GestureFlow full-layer PIO board baseline
2026-08-19 feat: fuse real pool2 on GestureFlow 7020
2026-08-19 feat: fuse real pool3 on GestureFlow 7020
2026-08-19 debug: instrument GAP postprocess board path
2026-08-20 fix: complete GestureFlow 7020 network baseline
    [gestureflow_hp0_gap_fc.sv, gestureflow_layer_chain_hp0_axil.sv]
2026-08-23 feat: bring descriptor hp0 baseline to 7020 board
2026-08-27 feat: unblock 7020 place/route via single output bank, push 30MHz, add weight DMA
    - Parameterize ENABLE_RELAY: board build uses one 2-port output bank
    (56 RAMB36) instead of two (112), freeing BRAM so the 16 MAC weight
    banks map back to block RAM (LUT 57385 -> 32021, RAMB36 130 -> 99).
    - Split FC requantize into FC_MUL/FC_QUANT to remove the 56-level
    combinational chain off the top routed setup path (WNS +2.996ns @30MHz).
    - Fix stale 2-port output_bank interfaces in axil_microkernel,
    conv4x4_rgb_same_layer, body2_hp0_axil.
    - Board software: replace 52K AXI-Lite weight writes with WEIGHT_DMA PL
    burst loads; replace infeasible content fingerprint with unique key.
    - Board: FINAL_RESUL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
    [gestureflow_axil_microkernel.sv, gestureflow_body2_hp0_axil.sv, gestureflow_hp0_gap_fc.sv, gestureflow_layer_chain_hp0_axil.sv]
2026-08-27 docs: record 105 board results incl. deployed FAST-mode ~4.1 FPS
2026-08-27 perf: pipeline main requantizer (2-stage), push FCLK to 32.727MHz
    - Split per-lane requantize into high_mul (DSP48) and
    round_div_pot+zero_point+saturate (CARRY4) stages, removing the 32-bit
    ripple-carry chain from the DSP48 cascade off the top routed path.
    - Critical path 29.7ns -> 24.4ns (56 -> 39 logic levels), WNS +6.14ns.
    - Avoid packed-array variable-index function writeback in always_ff (the
    known -128 saturation trap); compute high_mul in always_comb instead.
    - FCLK 30 -> 32.727272MHz (PS7 quantization of 33MHz).
    - Board: FINAL_RESULT=0x600D600D, FAST ~4.34 FPS (was ~4.09).
    [gestureflow_layer_chain_hp0_axil.sv, gestureflow_requant_relu.sv]
2026-08-27 perf: split GAP zero-point subtract from high_mul, push FCLK to 40MHz
    - Add GAP_ADJ stage so the 32-bit (gap_sum - zp*144) subtraction is no
    longer on the DSP48 high_mul cascade, removing it from the top routed
    setup path.
    - FCLK 32.727 -> 40MHz (exact PS7 quantization), FREQ_HZ 40000000.
    - Timing: WNS +1.557ns, 0 violations; critical path now the requant
    64-bit high_mul add (23.1ns, ~43MHz ceiling).
    - Board: FINAL_RESULT=0x600D600D, FAST ~4.83 FPS (was ~4.34).
2026-08-27 docs: add algorithm + soft-hardware co-design panorama, correct mainline
    - Correct an earlier misreading: the board golden currently comes from
    static_cnn_4x4_w125 (all-4x4, 83.47%), but the static hardware-co-design
    mainline is repvgg_hybrid344_c16_48_80 (3x3/4x4/4x4/1x1, 16/48/80/112,
    distillation-trained, INT8 87.82%, training interrupted at epoch 108).
    - Higher-accuracy reference: repvgg_3x3_i96 (float 89.47%, INT8 89.02%).
    - Dynamic: gesture_temporal_model.py = spatial 3x3/4x4 + 1x1 embedding +
    temporal shift + summary + 1x1 fusion; conclude 1x1 dot-product is the
    most valuable missing hardware path.
    - New standalone panorama doc with per-layer FNVs, dataset tiers, algo/hw
    m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
2026-08-27 fix: correct algorithm direction to HaGRID-18 distilled student, restore teacher training
    Previous turn wrongly treated the 6-class hybrid344 as the mainline and
    started a 6-class identity run. The real 'half-trained, distilled, 90%+
    teacher, val>train' model is the HaGRID 18-class target-hand-crop distilled
    student (records 35/36/38): MobileNetV3Large teacher (99.5651% float test)
    -> plain 4x4/4x4/4x4 16/32/48 + 1x1 head 64 student, interrupted at epoch 22.
    Add reproducible teacher/student training scripts and correct record 109.
2026-08-28 feat: wide loaders 40/80 -> 32/48 for HaGRID-18 (MAX_INPUT_CHANNELS=48, less BRAM)
    - layer_chain wide loaders: tensor40->tensor32 (CHANNELS=32), tensor80->tensor48 (CHANNELS=48)
    - input_group_count now 12/8/4/1 (was 20/10/4/1)
    - weight DMA MAX_GROUPS 20->12
    - wide48 elab + cin48 first-tile engine regression pass
2026-08-28 feat: HaGRID-18 board golden export script + full-network main.c
    - export_hagrid18_all_layers.sh: 7 conv + 3 pool + GAP/FC golden
    - gestureflow_hagrid18_main.c: 18-class full network driver (16/32/48/64
    channels, 4x4/4x4/4x4 + 1x1 head, GAP(64)+FC(18)) with per-layer FNV check
2026-08-28 feat: HaGRID-18 runs on 7020 board at 9.32 FPS (FINAL_RESULT=0x600D600D)
    - wide loaders 40/80 -> 32/48, MAX_INPUT_CHANNELS=48 (saves 28 RAMB36)
    - top-level FC params 16->18 lanes, WCTRL 5-bit class, GAP/FC 64->18
    - full-network 18-class main.c with per-layer FNV check
    - board verified: 9.32 FPS end-to-end, PL 69.2ms, weight load 14.8ms (13.8%)
    - 3.5x faster than 6-class hybrid344 baseline (2.62 FPS)
2026-08-30 feat: bring 32-lane HaGRID pipeline to board
2026-08-30 docs: add zero-to-hero guide and reorganize repo around current mainline
    - Track coralnpu official repo as a git submodule pinned to 7318dfc2 (was a gitignored nested clone).
    - Whitelist the current 18-class HaGRID student model artifacts so the team can re-export weights and INT8 golden without the dataset.
    - Ignore non-mainline reference/experiments (guides/, simulation/, fz3a/axu5ev board validation).
    - Rewrite root README around the current GestureFlow-NPU 80MHz results and point to the new from-zero guide and handover doc.
    - Add the comprehensive teaching guide and remaining current-mainline RTL/tests/board scripts/algorithms/docs/dataset tools.
    [history.csv]
2026-08-31 feat: add temporal accumulator + static/dynamic unified architecture plan
    - New gestureflow_temporal_accumulator.sv: zero-MAC on-chip summary engine (sum/max/delta over frames) for dynamic-gesture recognition, reusing the static spatial tail.
    - New architecture planning doc answering static algorithm, PS-vs-PL temporal decision, and static+dynamic compatible micro-architecture plus extreme-performance roadmap.
    - Verilator regression run_gestureflow_temporal_accumulator.sh passes (frames=4).
2026-08-31 feat: enable MAC weight ping-pong preload (write inactive bank while computing)
    - gestureflow_mac_tile.sv: allow weight writes into the opposite bank while busy; writing the live read bank remains a protocol error.
    - Add Verilator regression proving bank-A compute is not corrupted by concurrent bank-B writes and bank-B weights are readable afterwards.
    - Baseline mac_tile regression still passes (backwards compatible when bank selects match).
    [gestureflow_mac_tile.sv]
2026-08-31 feat: relax layer-chain weight-DMA gating for tail-overlap preload
    - WEIGHT_DMA_SOURCE/BYTES/CFG may be staged while a layer is running (only blocked during an in-flight weight DMA).
    - Weight DMA launch is allowed once the input loader releases the AR channel (dma_busy==0), even while the output store is still writing.
    - Layer-chain postprocess regression still passes; hardware enablement for end-to-end ping-pong is now complete, software scheduling remains.
2026-08-31 perf: software weight ping-pong scheduling (tail-overlap preload)
    - Split tile loading into config-only and weight-DMA phases; add launch_layer/wait_input_loaded and dual-bank selectors.
    - Each conv/head tile preloads the next tile's weights into the opposite bank during the current tile's compute.
    - Software compiles cleanly against the existing BSP (630797-byte ELF).
2026-08-31 fix: ping-pong scheduling order + input-loaded race
    - Switch the write bank before launch (idle) instead of during compute, so the WEIGHT_BANK_SELECT register is not written while running.
    - Wait for dma_done instead of !dma_busy to avoid the launch race where dma_busy has not yet asserted.
    - Board run passes (FINAL_RESULT=0x600D600D); end-to-end 31.67ms / 31.57 FPS vs 30.59 FPS baseline.
2026-08-31 docs: record ping-pong board result (31.57 FPS) and handover #124
2026-08-31 perf: split requant round/saturate into two pipeline stages
    - Register the rounding_divide_by_pot result (stage 3a) before the zero-point add + saturation (stage 3b), shortening the routed critical path from right_shift to out_data.
    - conv4x4 full-layer Verilator regression passes (quant_fnv1a=7e276c7b), and layer-chain postprocess regression passes.
    [gestureflow_requant_relu.sv]
2026-08-31 perf: split gap_fc FC multiply into select-register + multiply stages
    - Register the fc_index-selected operands (fc_sum/multiplier) before the 32x32 DSP multiply, removing the 18-to-1 mux from the multiply setup path.
    - gap_fc real regression passes (fc=22e52ddd, gap=f109a7ae, class=1).
2026-08-31 perf: param bank ping-pong (overlap bias/requant config with compute)
    - Layer chain: write bias/requant into the selected param bank only, and load the active bias/requant from that bank on CONTROL start; relax BIDX/BDATA/RQIDX/RQMULT/RQSHIFT and PARAM_BANK_SELECT gating.
    - Software: alternate param bank per tile and stage the next tile's bias/requant during the current tile's compute.
    - layer-chain mode-4 Verilator regression passes; software compiles.
2026-08-31 fix: split tile config into control (serial) and params (overlapped)
    - config_tile_control writes LAYER_MODE/QCFG/OUTPUT_LANE_MASK while idle (these are unbanked and gated on !running).
    - config_tile_params/config_first_params/config_head_params write banked bias/requant during the previous tile's compute.
    - Board run passes (FINAL_RESULT=0x600D600D).
2026-09-01 feat: verify DMP body2 layer on 7020 board
2026-09-01 feat: close 80MHz DMP body2 timing and verify on board
2026-09-01 docs: record full-network HaGRID18 board pass
2026-09-01 feat: add DMP weight DMA loader and regression
2026-09-01 feat: add DMP full-network layer chain, tools, software and board flow
2026-09-01 fix DMP full-net: 16-lane tile, weight DMA alignment, 40MHz build; board pass
    [gestureflow_layer_chain_dmp_hp0_axil.sv]
2026-09-01 docs: record DMP full-network 8-lane board pass (record 136)
2026-09-01 feat: DMP full-net at 60MHz, board pass ~30 FPS
2026-09-01 perf(dmp): split 3-term retire into 2 pipelined 32-bit adds; truncate product to 32 bits
    The DMP MAC tile retire previously combined accum + oct_contrib -
    activation_sum<<7 in one three-term 32-bit expression, the widest
    combinational node in the tile and the setup-critical path when OUT_LANES is
    widened. Split it into stage6 (accum += oct_contrib, unconditional two-term
    add, fewer clock-enable control sets) and stage7 (result = accum -
    activation_sum<<7). Also truncate the DSP product pipeline from 43 to the 32
    useful bits (two 16-bit DMP partials), cutting the widest DSP-to-add-tree
    routing. Verilator: conv out32, pointwise out32, layer-chain out32, layer-chain
    out16 and conv full-layer al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
2026-09-01 docs: record 137 — MDPI DMP paper study + OUT_LANES=32 hard capacity limit + retire pipeline fix
2026-09-01 build: OUT_LANES=16 @80MHz + false-path quasi-static layer_mode
    Revert the 32-lane streaming-store experiment to the verified 16-lane config
    (16 is a divisor of every 16/32/48/64 layer width, zero lane waste) and raise
    the PS FCLK from 60 to 80 MHz. Add a timing XDC that false-paths layer_mode,
    a quasi-static AXI-Lite config register written once per layer before launch;
    its 15-level, routing-dominated chain into the SmartConnect command FIFO was
    the 60MHz worst setup path. Dynamic AXI handshake paths are still timed.
2026-09-01 docs: record 138 — OUT_LANES=16 @80MHz timing closed, artifacts rebuilt
2026-09-01 perf: max_fanout=16 on AXI-Lite awaddr/wdata/wstrb config registers
    wdata_reg[8]->bias_bank_reg[*][*][8] was the 80MHz worst setup path at
    11.8ns with 96.8% routing and zero logic levels (a high-fanout config-write
    net). Replicate these quasi-static write registers per physical region to cut
    the fanout and routing delay. Functional (Verilator layer-chain PASS).
2026-09-01 perf: max_fanout on MAC-tile pipeline valid flags + line-window stage/input valid
    product_valid_reg -> pair_sum_high_pipe_reg/CE became the new 80MHz worst
    setup path (11.8ns, 96.8% routing, 0 logic levels) after config-register
    max_fanout. These pipeline valid flags gate dozens-to-thousands of FF clock
    enables; replicate them per region to cut control-net routing.
2026-09-01 docs: record 139 — 80MHz fanout treatment, routing-congestion wall finding
2026-09-01 build: drop 80MHz to 70MHz for board bring-up margin
    80MHz board run failed with a weight-DMA fault (0x4D01, status 0x4, i.e.
    AXI HP0 read response corruption). 80MHz setup margin is only WNS=0.249ns;
    70MHz restores ~2ns setup margin while still beating the 60MHz baseline.
2026-09-01 fix: restore 16-lane DMP board driver for OUT_LANES=16 engine
    The 70/80MHz builds reverted the engine to OUT_LANES=16 but the software was
    the 32-lane driver (passes outputs=32 to a MAX_OUTPUT_LANES=16 weight DMA
    loader, tripping the config check and faulting 0x4D01 on board). Restore the
    verified 16-lane schedule from 6c189e8.
2026-09-01 docs: record 140 — 80MHz board pass, end-to-end 38.1 FPS (+27% vs 60MHz)
2026-09-02 perf: expose per-layer PL cycle counters in PROBE[10..26]
    Add board-side per-layer cycle telemetry so the next optimization round can
    target the real bottlenecks instead of guessing. 80MHz measured breakdown:
    conv0=304693, conv1+pool=459594, conv2a=310901, conv2b+pool2=378913,
    conv3a=172818, conv3b+pool3=199068, head1x1=26192, gap_fc=5853.
2026-09-02 docs: record 141 — per-layer cycle profile, 1.6x total overhead, three optimization targets
2026-09-02 docs: record 142 — multi-window pipeline attempt reverted, two root causes identified
2026-09-02 docs: record 143 — multi-window second attempt, row-boundary clue, reverted
2026-09-02 perf: multi-window streaming MAC pipeline (double-buffered retire, eliminates drain)
    Double-buffer the per-window accumulator, activation-sum, active-lane mask
    and output coordinates; toggle a 1-bit window id at each start and carry it
    through the pipeline. Replace the single busy flag with an active-window
    counter and gate the result write on !result_valid so overlapping windows
    cannot corrupt each other. The conv engine keeps held_window/held_pixel
    stable with !mac_active and pipelines row/column through the MAC tile.
    Verilator: full-layer 387375->332085 cycles (-14.3%), out32 96927->83109,
    pointwise 2305->1447; all FNV golden pass. Layer-chain out16 pass.
    [gestureflow_conv4x4_cin_same_stream_dmp.sv, gestureflow_mac_tile_dmp.sv]
2026-09-02 Revert "perf: multi-window streaming MAC pipeline (double-buffered retire, eliminates drain)"
    This reverts commit d0a2fcdd455b26125286396a57669228a782d16b.
    [gestureflow_conv4x4_cin_same_stream_dmp.sv, gestureflow_mac_tile_dmp.sv]
2026-09-02 Revert "Revert "perf: multi-window streaming MAC pipeline (double-buffered retire, eliminates drain)""
    This reverts commit 7edafe561cb64d2f09d750d6301491362d1dd38b.
    [gestureflow_conv4x4_cin_same_stream_dmp.sv, gestureflow_mac_tile_dmp.sv]
2026-09-02 perf: 2-byte/cycle FNV hash so it keeps up with multi-window results
    The output FNV hash processed one byte per cycle (16 cycles/vector). With the
    multi-window MAC retiring results back-to-back, a new requant output arrived
    while hash_active was still set, tripping the 'if (hash_active) fault' check
    on the board. Process two bytes per cycle (8 cycles/vector); FNV golden is
    unchanged. Layer-chain Verilator PASS.
2026-09-02 fix: buffer FNV hash output instead of faulting on multi-window backpressure
    The 1-byte/cycle output FNV (16 cycles/vector) becomes the bottleneck when the
    multi-window MAC retires back-to-back, so a new requant output could arrive
    while hash_active was still set. Previously that raised the general fault bit.
    Now a 1-deep pending buffer absorbs the one-cycle overlap and the hash drains
    it right after the current vector; FNV result is unchanged. Layer-chain
    Verilator PASS.
    [gestureflow_layer_chain_dmp_hp0_axil.sv]
2026-09-02 Revert "fix: buffer FNV hash output instead of faulting on multi-window backpressure"
    This reverts commit 246e2169baacc0857eb988fd8dede8f86121bb19.
    [gestureflow_layer_chain_dmp_hp0_axil.sv]
2026-09-02 Revert "Revert "Revert "perf: multi-window streaming MAC pipeline (double-buffered retire, eliminates drain)"""
    This reverts commit 48a2364c8fb193d39b9168a2c763e2ff9c5f6587.
    [gestureflow_conv4x4_cin_same_stream_dmp.sv, gestureflow_mac_tile_dmp.sv]
2026-09-02 Revert "Revert "Revert "Revert "perf: multi-window streaming MAC pipeline (double-buffered retire, eliminates drain)""""
    This reverts commit 2781fe038ed7e5e91e40f5812d8d1620c7830faa.
    [gestureflow_conv4x4_cin_same_stream_dmp.sv, gestureflow_mac_tile_dmp.sv]
2026-09-02 Revert "Revert "fix: buffer FNV hash output instead of faulting on multi-window backpressure""
    This reverts commit 9b6ef8a635e2d7ee617a65c2105336c2515bd43d.
    [gestureflow_layer_chain_dmp_hp0_axil.sv]
2026-09-02 fix: XDC # comments + FREQ_HZ on aclk; restore multi-window + hash buffer
    - gestureflow_hagrid18_dmp_7020_timing.xdc used C-style // comments which
    Vivado XDC treats as unsupported commands; switch to # so the file parses
    cleanly and the layer_mode false-path warning is gone.
    - add FREQ_HZ 80000000 to the aclk X_INTERFACE_PARAMETER so the BD clock
    interface carries the 80MHz frequency for timing/CDC analysis.
    - re-apply the multi-window streaming MAC + FNV pending-buffer (functionally
    correct in Verilator, 14% cycle reduction).
    [gestureflow_layer_chain_dmp_hp0_axil.sv]
2026-09-02 debug: expose fault_source via POST_PROGRESS to identify board fault
2026-09-02 perf: multi-window pipeline board-passed at 80MHz, 41.8 FPS (+9.7%)
    Multi-window streaming MAC (double-buffered retire) + FNV pending-buffer +
    XDC # comments + FREQ_HZ + clean layer-completion handshake.
    Board result: FINAL_RESULT=0x600D600D, PL cycles 1,670,519 (was 1,858,032,
    -10.1%), frame ticks 7,966,638 -> 41.8 FPS end-to-end (was 38.1 FPS).
    Root cause of the board fault was a 1-cycle race: wait_layer_done returned on
    done while running/store_busy/hash_active had not fully cleared, so the next
    layer's CONTROL launch faulted. Now wait for done && !running.
2026-09-02 perf: requant 1->4 stable 80MHz build, board-pass 41.9 FPS
2026-09-10 test: add ZCU104 JTAG bring-up probes and first light record
2026-09-10 test: add and program ZCU104 LED bring-up bitstream
2026-09-11 feat(zcu104): PetaLinux bring-up tooling, ZCU104 port fixes and session docs
    - plnx/: PetaLinux 2023.2 driver for the ZCU104-native flow
    (MACHINE_NAME=zcu104-revc -> USB3 host comes from the official board DTS),
    host setup, non-interactive Kconfig setters, UVC/xHCI kernel fragment,
    SD-card writer.
    - board_zcu104 build/board scripts from the DMP full-network bring-up.
    - main.c: guard the ARMv7-only abort exception IDs behind __aarch64__ so the
    same driver builds for both Zynq-7000 and ZynqMP.
    - xsct runner: add rst -processor (ZynqMP holds the APU L2 in reset after
    psu_init, which makes dow fail).
    - docs: ZCU104 review/plan/camera-plan/root-cause notes.
    [kernel_uvc.cfg]
2026-09-11 fix(zcu104): make the shared DMP driver build for ZynqMP as well
    The abort exception IDs XIL_EXCEPTION_ID_DATA_ABORT_INT /
    XIL_EXCEPTION_ID_PREFETCH_ABORT_INT are declared only in the AArch32 branch of
    the standalone xil_exception.h, so the A53 build failed with them. Guard the
    registration behind __aarch64__ and use XIL_EXCEPTION_ID_SYNC_INT /
    SERROR_ABORT_INT there; the Zynq-7000 path is unchanged.
    Also add sync_repo.sh, the two-end (Ubuntu <-> Windows) repo sync helper.
2026-09-11 docs: add a self-contained project context document for the Windows workspace
    Summarises the whole project from the Ubuntu-side logs and key documents so the
    Windows workspace is readable on its own: mainline results, algorithm, hardware
    architecture, the DMP dual-multiply-packing innovation and its verification
    chain, software/board facts, the 7020->ZCU104 migration state, the PetaLinux
    locale/config pitfalls, repo sync rules, a document map and a command cheat
    sheet.
2026-09-11 docs: handoff 145 - ZCU104 platform bring-up (36.96 FPS) and PetaLinux pitfalls
    Records the ZCU104 full-network board pass (0x600D600D, 36.96 FPS end-to-end with
    a 10.04 ms CPU-side overhead being the real bottleneck, not the PL), the AArch32-only
    abort exception IDs that had to be guarded for AArch64, and the five PetaLinux
    pitfalls hit while bringing up the ZCU104-native flow: the mandatory en_US.UTF-8
    locale (rdiArgs.sh hard-codes LC_ALL), the bare-number PARALLEL_MAKE format,
    package-management being an image feature rather than a recipe, the required
    rst -processor on ZynqMP, and app build hanging in xsct.
2026-09-11 fix(zcu104): guard the ARMv7-only abort exception IDs for AArch64
    XIL_EXCEPTION_ID_DATA_ABORT_INT and XIL_EXCEPTION_ID_PREFETCH_ABORT_INT are
    declared only in the AArch32 branch of the standalone xil_exception.h, so the
    Cortex-A53 build of the shared DMP driver failed with 'undeclared'. On AArch64
    both aborts are synchronous exceptions, so register XIL_EXCEPTION_ID_SYNC_INT and
    XIL_EXCEPTION_ID_SERROR_ABORT_INT instead, behind #if defined(__aarch64__).
    The Zynq-7000 path is byte-for-byte unchanged.
    Also make PROBE_BASE / GF_BASE overridable via #ifndef so the same source serves
    both platforms (7020 keeps 0xFFFF0000 / 0x43C00000; ZCU104 compiles with
    -DGF_BASE=0xA0000000U).
    (An earlier com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
2026-09-11 docs: add the project's architectural hard gates to the context document
    Reading 7020帧率优化完整方案 and 权重驻留的架构真相 added two things the context
    doc was missing: the six architectural hard gates the project enforces (weight
    lifecycle, control boundary, CoralNPU microarchitecture alignment, dataflow
    accounting, consecutive-frame evidence, and what does not count as innovation),
    and the correction that cross-frame weight residency is currently impossible --
    the MAC tile has ~32 KB of weight SRAM against ~200 KB of network weights, so the
    fingerprint residency is a no-op and the real first action is to replace the
    byte-at-a-time AXI-Lite weight load with a PL DMA burst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
2026-09-11 chore(sync): restore the sync_repo.sh guidance that the previous commit dropped
    The context-document commit was made with 'reset --soft origin/main' while the
    working tree still held the older sync_repo.sh, so it silently reverted the
    ref-write / divergence guidance. Restore the current version and keep it in sync
    with the Windows workspace copy.
2026-09-11 fix(zcu104): keep DWC3 in dual-role, host-only breaks the vmlinux link
    petalinux-build failed at linux-xlnx do_compile:
    drivers/usb/dwc3/core.o: in function 'dwc3_remove':
    core.c:(.text+0x580): undefined reference to 'dwc3_gadget_exit_hibernation'
    The fragment forced CONFIG_USB_DWC3_HOST=y with USB_DWC3_GADGET and
    USB_DWC3_DUAL_ROLE off. But the Xilinx kernel calls that gadget-only helper
    from core.c without a gadget guard (core.c:2104 in dwc3_remove and core.c:2399
    in dwc3_suspend, both under CONFIG_PM_SLEEP) while the definition lives in the
    gadget-only gadget_hibernation.c -- so host-only leaves the symbol undefined
    and vmlinux cannot link. USB_DWC3_HOST's own Kconfig help warns t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
    [kernel_uvc.cfg]
2026-09-11 feat(zcu104): Linux userspace NPU driver, USB3 camera pipeline, DT scratch region
    Adds the Linux side of the GestureFlow NPU bring-up.
    linux/ -- userspace driver and tools
    gf_npu.{h,c} port of the baremetal driver: mmap the PL register block and a
    reserved-memory scratch region through /dev/mem (both
    non-cached, so no cache maintenance is needed anywhere on the
    non-coherent HP0 link), stage the weight images into the
    scratch region by physical address, and run the same 21-tile
    schedule with the same per-layer checks.
    gf_npu_probe.c port validation: reference-image selftest + benchmark.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
2026-09-11 docs: handoff 146 - PetaLinux build complete, Linux-side NPU driver and camera pipeline
    Records that the PetaLinux 2023.2 build now succeeds end to end and produces a
    flashable set (BOOT.BIN 21.1 MB, image.ub 9.97 MB, rootfs.ext4 430 MB), with
    gf-npu / v4l2-utils / usbutils / libjpeg confirmed inside the rootfs.
    Also records, each with its evidence:
    * DWC3 must stay in DUAL_ROLE. Host-only leaves dwc3_gadget_exit_hibernation
    undefined because core.c calls it from dwc3_remove/dwc3_suspend with no
    gadget guard while the definition lives in the gadget-only
    gadget_hibernation.c. This corrects 145's assumption.
    * USB3 host really does come from the official board DTSI (zcu104-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
2026-09-11 docs(context): refresh the workspace context doc for the Linux-side state
    Updates what actually changed since the doc was written:
    * section 0 status line -- ZCU104 runs the full network on hardware at
    36.96 FPS, the PetaLinux build succeeds, and the Linux userspace driver and
    camera pipeline exist.
    * section 8.2 phase table -- PetaLinux build marked complete with the artifact
    sizes, plus new rows for the Linux driver and the pending on-board
    verification (V1-V6). Notes that the Linux path attacks the 10.04 ms CPU
    overhead differently: scratch buffers are mapped plain non-cached rather
    than strongly-ordered device memory, and the per-pixel copy became memcpy.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
2026-09-11 feat(zcu104): verify every stage bit-exactly against the exported golden tensors
    The baremetal driver only checked DMA byte counts for the six intermediate
    stages, and FNV registers for two of them. Every stage's golden tensor is
    actually exported next to that layer's weights, so the userspace driver can do
    better: it now memcmp's each stored tensor against its golden array.
    The golden-to-stage mapping was established empirically, by computing FNV1A over
    every exported array and matching the header macros -- not by inference from
    names alone:
    conv0 147456 gf_body2_layer_input 05307466 = GF_FULL_OUTPUT_FNV1A
    pool1 36864 gf_pool_output 33B1A130 = GF_POOL_OUTPUT_FNV1A
    co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
2026-09-11 docs(handoff): correct 146's verification section to the stronger implementation
    The 146 record still described the planned approach (print software FNV1A
    baselines for the intermediate stages). What actually got built is stronger:
    byte-exact memcmp against the exported golden tensors, with the mapping
    established empirically and the conv1 pre-pool/pooled FNV distinction spelled
    out. Also records that the checks are gated on stats != NULL so the live
    camera loop stays on the fast path, and that their cost is reported separately
    so the CPU-side number remains comparable with the baremetal 10.04 ms.
2026-09-11 docs: add a ZCU104 on-board runbook
    A single page to work from at the board: what is in the images, the exact SD
    card command, the SW6 setting with its inverted polarity called out, the serial
    parameters, then the four on-board steps in order.
    Emphasis on the gate that matters: gf_npu_probe must print RESULT: PASS with all
    six golden content checks matching before any camera result is meaningful, and
    --bench 200 must report the CPU overhead so it can be compared against the
    baremetal 10.04 ms -- the whole point of moving the scratch buffers to plain
    non-cached memory.
    Also includes a symptom-to-cause troubleshooting table (GF_MAGIC reading zero,
    version mismatch, a stage mismatch, no /dev/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
2026-09-11 perf(zcu104): stop zeroing the tensors every frame, and bound-check the arena
    Two things found while reviewing the port against the baremetal driver.
    1. Per-frame memset of the intermediate tensors removed.
    The first version zeroed all ten tensors at the top of gf_npu_run_frame.
    That is ~435 KB of UNCACHED writes per frame, and it is exactly the class of
    CPU-side overhead this port exists to measure -- it would have inflated the
    V4 number and made the comparison against the baremetal 10.04 ms meaningless.
    It is also unnecessary: the tile coverage adds up exactly (conv0 1x147456,
    conv1 1x36864, conv2a 2x36864, conv2b 2x9216, conv3a 3x9216, conv3b 3x2304,
    head 4x2304),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
2026-09-12 verify(zcu104): prove the image matches the sources, and correct a misdiagnosis
    Adds a no-root, image-level verification workflow and fixes the wrong
    conclusion we had drawn about why a diagnostic string was missing.
    New tools
    05_verify_image.sh dumps the ELFs out of rootfs.ext4 with debugfs (no sudo)
    and cross-checks their embedded strings against the repo
    sources. 17 curated probes, a reverse hit-rate check, and
    md5 fingerprints. Currently RESULT: PASS.
    06_install_app.sh deploys Linux sources into the recipe via cmp, runs
    do_cleanall, rebuilds, then auto-invokes 05.
    Gate
    04_make_sd.sh now ref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
2026-09-12 memory: record the dead-code-elimination trap and the git verification rules
    Two things worth not re-learning:
    1. A compile-time-constant condition makes GCC delete its diagnostic strings
    along with the dead branch. We used one of those strings as a regression
    probe, could not find it in the ELF, and wrongly concluded the build was
    reusing a stale object. Probe strings must be guarded by runtime data.
    2. git push can succeed while the local remote-tracking ref silently reverts on
    the next fetch, which looks exactly like a failed push. The authoritative
    check is git ls-remote, which does not write local refs. Also recorded: the
    untracked-file blocker on a Windows fast-forw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
2026-09-12 audit: align with the project proposal, and fix the defects I introduced
    Stops feature work to re-baseline. The most important finding is that I had
    never read the project proposal, which is the document that defines what
    "done" means for this project. It is a Sun Yat-sen University undergraduate
    research project whose schedule puts the FPGA on-board test phase before
    October 2026 and the write-up before November 2026, and whose stated targets
    include dynamic gestures, an LSTM submodule, 5 ms single-frame latency, 100 mW
    power, and a paper draft. My earlier plan pointed at burning an SD card, not at
    any of that.
    New: docs/项目审计与再评估_2026-09-12.md, plus handoff entry 147, carry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
2026-09-12 memory: pin down the Windows fetch ref-write quirk
    git fetch on the Windows clone printed the branch update line and exited 0, but
    never created .git/refs/remotes/origin/main at all, so the following
    merge --ff-only origin/main failed with "not something we can merge" even
    though the commit object had already been downloaded. Recorded the check that
    distinguishes it (git cat-file -t on the sha) and the workaround (fast-forward
    by sha, then write the ref file by hand). Also notes the proxies: the agent
    shell injects one that returns 502 for GitHub, so Windows-side git has to use
    the user's own proxy on port 7897.
2026-09-12 docs: review all 56 markdown files and flag which ones are stale
    I had only read eight documents before drawing conclusions about this project,
    and the user was right to call that out. Two findings matter.
    First, the handoff document is the only continuously maintained record, but its
    own tail sections are frozen at 2026-08-02. The section literally titled
    current conclusions still describes a RepVGG plus landmark mainline at 94.62
    percent, a 3x3 fallback at 79.24 percent, a dual-backend hardware plan, and an
    unfinished CoralNPU VME path. None of that has matched reality since late
    August. A reader who trusts that heading gets a project picture that is a full
    generation out of date. Bannere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
2026-09-12 chore: stop tracking .workbuddy, it is local agent state
    The user is right: .workbuddy holds per-machine agent memory, not project
    artifacts, and two machines should not be syncing their local caches through
    the repository. Removed from the index (the files stay on disk).
    The project log is gesture_project/docs/会话交接_最高优先级_2026-07-11.md, which
    gets a new numbered entry at the top after each round. Anything meant to be
    shared goes there.
    .gitignore now covers .workbuddy/ with a comment explaining the split, replacing
    the earlier note that said the opposite.
2026-09-12 zcu104: on-board bring-up plan, plus two corrections found while pre-flighting
    Writes the stepwise plan for getting the camera to NPU pipeline actually
    running on the board: P1 through P8, each with an action, a pass criterion and
    a failure branch, plus a risk table, a time budget and an explicit give-up line
    (stop if gf_npu_probe is not PASS within two hours, rather than debugging the
    camera on top of an unproven NPU).
    The pre-flight was done offline so that as little as possible is left to
    discover over a serial console. Everything checks out:
    - boot.scr is present, without which U-Boot cannot load image.ub at all
    - reserved-memory npu-buffers@70000000, 16 MB, no-map
    - bootargs car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
2026-09-12 zcu104: fix the SD-card step - WSL cannot see the card by default
    The plan told the user to run lsblk and write to /dev/sdX. That was wrong and
    would have failed immediately: WSL2 does not pass USB or block devices through
    to the guest. Verified - lsblk inside WSL shows only sda 356.9M, sdb 159.4M,
    sdc 3G swap and sdd 1T for /mnt/wslg/distro, and no SD card at all.
    The card has to be attached explicitly:
    Get-Disk # find the physical drive number N
    # remove its drive letter, offline it if Windows still holds it
    wsl --mount \\.\PHYSICALDRIVE<N> --bare # needs administrator
    after which /dev/sdX appears and 04_make_sd.sh works unchanged. Confirmed this
    ma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
2026-09-12 zcu104: add 07_make_sd_image.sh, the fallback for when wsl --mount will not attach
    wsl --mount needs elevation. Trying it from a normal session gives
    WSL2: Error: 0x80040315
    Wsl/Service/AttachDisk/MountDisk/WSL_E_ELEVATION_NEEDED_TO_MOUNT_DISK
    so that step has to run from an administrator shell. Recording it as a measured
    fact rather than an assumption. Also records the card position: Get-Disk shows
    disk 2 as Generic MassStorageClass, 28.9 GB, on USB.
    The fallback script builds a complete flashable image inside WSL so the card
    never has to be attached at all; you then write it from Windows with Rufus or
    balenaEtcher. The deliberate design choice is that it does not reimplement any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
2026-09-12 zcu104: wsl --mount cannot drive an SD card reader - switch the card step to usbipd
    My previous round said to attach the card with `wsl --mount \\.\PHYSICALDRIVE2
    --bare`. That does not work, and it is not a configuration problem on this
    machine. Microsoft's own documentation for mounting a Linux disk in WSL 2 says:
    The `wsl --mount` command does not currently support USB/flash drives/SD
    card readers.
    Measured, from an administrator shell:
    wsl --mount \\.\PHYSICALDRIVE2 --bare
    -> Wsl/Service/AttachDisk/MountDisk/0x8007000f
    Set-Disk -Number 2 -IsOffline $true
    wsl --mount \\.\PHYSICALDRIVE2 --bare
    -> .../MountDisk/HCS/0x8007000f
    0x8007000f is Win32 ERROR_INV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
2026-09-12 fix(plnx): sudo resets HOME to /root, so the scripts looked in the wrong tree
    Symptom on the real machine:
    $ sudo bash 04_make_sd.sh /dev/sde
    ERROR: missing /root/gf_linux_ws/gf_linux/images/linux/BOOT.BIN
    The image was under /home/steveguo the whole time. These scripts need root
    (parted / mkfs / dd / mount) while the PetaLinux tree and the repo live under
    the invoking user home, and sudo resets HOME. Line 30 was
    PROJ="${PROJ:-$HOME/gf_linux_ws/gf_linux}".
    Four scripts had it: 04, 05, 06, 07. 05 was the dangerous one, because 04
    calls it from GATE 0 -- under sudo the gate itself broke, and it failed as a
    content mismatch, which reads like "your image is stale" instead of "I loo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
2026-09-12 fix(plnx): a symlink is not a missing file; and record what actually programs the PL
    The first real SD write succeeded -- the two binary md5s on the card match
    section [6] of 05_verify_image.sh exactly -- but the post-write check printed
    MISS /usr/bin/lsusb
    WARNING: some expected files are missing - check the build
    which is wrong, and worth fixing precisely because it is the kind of alarm that
    sends you off to rebuild an image that was never broken.
    lsusb is an absolute symlink, /usr/bin/lsusb -> /usr/bin/lsusb.usbutils (the
    usual Yocto update-alternatives layout; the real binary is 301312 bytes). The
    check used [ -e "$ROOTMNT/usr/bin/lsusb" ], and test -e follows the link and
    re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
2026-09-12 fix(zcu104): NPU scratch was no-map reserved -> /dev/mem hangs the CPU
    First real Linux on-board bring-up. The board boots from SD, the camera
    enumerates, and the PL is up (devmem 0xa0000000 reads the "GFNP" magic) -- but
    gf_npu_probe died with SIGBUS before printing anything, and a bare
    `busybox devmem 0x70000000` hung the CPU (rcu_sched stall).
    Root cause: system-user.dtsi reserved the 16 MiB scratch with a `no-map`
    reserved-memory node. The comment claimed no-map == memblock_remove() and so
    "no longer RAM". Wrong: no-map calls memblock_mark_nomap(), which keeps the
    range as RAM (pfn_valid still true) but drops it from the linear map. /dev/mem
    then maps it cacheable with no backing ->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
2026-09-12 zcu104: run the NPU from Linux on the board, and make the driver independent of the mapping
    The NPU now runs end to end on the ZCU104: SD-boot Linux -> USB3 camera ->
    MJPEG -> 96x96 -> NPU -> class. gf_npu_probe reports RESULT: PASS with all six
    golden tensors matching bit-exactly and all four hardware FNV registers correct;
    gf_camera sustains 27.3 ms/frame (36.6 fps of headroom) over 150 frames.
    No SD card was written to get there.
    The memory question is now settled from the kernel source rather than by trial.
    arch/arm64/mm/mmu.c::phys_mem_access_prot() means:
    !pfn_is_map_memory(pfn) -> pgprot_noncached() = MT_DEVICE_nGnRnE
    pfn_is_map_memory && O_SYNC -> pgprot_write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
2026-09-12 docs(zcu104): record the measured camera closure, and keep the captured frame as evidence
    gf_camera -n 150 --save-ppm, on the board, with the lens uncovered:
    frame 0 call / frame 20 mute / frame 60 dislike / frame 149 dislike
    per-frame raw over 150 frames: call 50, mute 9, three 3, peace 3, dislike 80, like 5
    26.7-29.8 ms per frame (mean 29.3) => 34.1 fps of headroom, camera-rate limited
    The class tracks the scene rather than sitting on one value, which is what
    distinguishes "the pipeline runs" from "the pipeline computes something".
    The libjpeg fix proved itself in the same run: a genuinely bad frame appeared
    ("Premature end of JPEG file", then "Not a JPEG file: starts with 0x3d 0x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
2026-09-12 feat(zcu104): a live browser viewer, and an Ethernet deploy path
    gf_camera --view PORT serves a page showing the 96x96 image the NPU is actually
    being fed, the classification with its vote count, the per-frame timing
    breakdown, the 18-class histogram, error counters, and -- the part that turns
    "that looks right" into a number -- a truth-marking panel that scores accuracy
    while you label gestures.
    The constraint was that it must not cost the recognition loop anything, and that
    is now measured on the board rather than argued:
    no --view 32.35 ms/frame (150 frames)
    --view, nobody watching 32.36 ms/frame (150 frames)
    --view, preview polled at 15 Hz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
2026-09-12 docs(zcu104): the viewer is verified on the board, and BUILD_RC=255 is not always a code problem
    Rounds out the viewer work with what the board actually did:
    * 05_verify_image.sh RESULT: PASS on the rebuilt image, and both binaries on
    the board match the ones inside the image by md5.
    * gf_npu_probe RESULT: PASS with the viewer linked in -- no regression on the
    NPU path (PL 17.03 ms, CPU overhead 1.98 ms).
    * /, /stats and /preview.bmp all serve; 20 out of 20 consecutive requests
    succeeded.
    * the four-way cost comparison in section 4.2 (32.35 / 32.36 / 32.12 / 32.12
    ms per frame -- the spread is inside the noise).
    * orientation confirmed by fetching the frame and loo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
2026-09-12 ZCU104: 监视器去掉表决只报本帧；查清 no-hand→call 与颜色问题；新增 --zoom/--crop 取景控制
    用户三条反馈，逐条查证：
    1) 「怎么能用统计帧数量决定当前手势」——我错了。删除 gf_camera 的 5 帧多数表决与 -m
    选项（含 MAX_VOTE_WINDOW），gf_view_frame 只剩 cls，页面大字显示本帧结果，真值
    对照只保留逐帧准确率。理由：表决把「在哪些情形下判错」抹成一个更小的数字，还让标签
    滞后画面最多 4 帧，而帧间抖动本身就是证据。tests/t_view.c 增加反向断言：/stats 里
    再出现 votes 或 smooth 即失败。
    2) 「没手势为什么报 call」—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
2026-09-12 ZCU104 监视器：修掉网页画面红蓝对调（蓝衣显示成橙黄）——根因是 BMP 的 B,G,R 字节序
    用户反馈：网页实时显示的颜色不对，蓝衣服显示成橙黄；但从板上单张提取的照片正常。
    复现：把抓回来的帧交换 R 与 B 重新渲染，蓝色球衣正好变成橙黄、木柜变蓝、皮肤变灰白，
    与描述完全一致 => 确定是 R/B 对调。注意通道均值在 R↔B 对调下几乎不变
    （蓝 (50,80,190) -> (190,80,50)），所以之前拿均值做的颜色判断本身无效。
    根因：gf_view.c 的 send_bmp_body() 直接写 R,G,B，而 BMP 24bpp BI_RGB 规定像素字节序是
    B,G,R（小端 0x00RRGGBB 的低字节是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
2026-09-12 docs: 交接 #155 —— 导出 HaGRID-18 参照图（每类一张，测试集，训练同款 96x96 预处理）
    用户要"18 类每类一张数据集图，参照着测板子"。做法与产物位置记在 #155：
    源 = processed/.../targethand_subject_split_20260815 的 test 划分，每类取文件最大的一张；
    原始整帧从 raw zip 按同一 UUID 取出；产物放在仓库外 .workbuddy/samples/
    （crop / input96 / display / scene + 两张带标签总览 + labels.txt + README.md）。
    顺带在文档里钉死两条事实，省得以后重复查：
    - 模型真正训练的是手部裁剪（image_mode=target_hand_crop, crop_context=0.25），不是整帧 ——
    这正是 #153"取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
2026-09-12 全局重规划 + 阶段A实测：模型是被"训练几何"毁掉的，类目不需要合并
    用户的四个致命问题（手必须占满画面 / 类间区分度低 / 无手势与置信度缺失 / CPU 解码拖慢）
    + 三条硬约束（3x3 深度卷积方向、硬件冲顶刊且必须有数据、仿真 <=3min）。
    决策文档 = gesture_project/docs/全局重规划_2026-09-12.md。
    新增工具 algorithms/static_cnn/eval_int8_deployment.py，两种模式：
    - crops：在训练分布（手部裁剪 test 划分）上评，与论文数字对账
    - frames：在一帧里取窗口、窗口大小使"手占模型输入 h"，模拟部署几何
    PC 侧预处理刻意与板上同约定（输入张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
    [confusion.csv, predictions.csv]
